ncripted/DAMIEN/outputs/rover/Omni_UGV_Rev_E_power_layout/mechanics/README.md

# Rev E mechanical status

Rev_E_Bare_PCB.step is freshly exported from the saved Rev E board. The 100 mm outline and motor/mounting geometry are unchanged. This is a bare-board reference, not a complete robot assembly.

provisional_supports.scad remains editable preliminary fit geometry. It has not been qualified against measured motors, couplings, wheel rollers, battery or camera flex. Check clearance around new backside Q12/Q13 and the four-terminal R36 before using it. No final printable support set is released in this electrical-layout revision. Earlier board STEP exports are under history/.
