ncripted/DAMIEN/outputs/rover/Omni_UGV_Rev_D_power_audit/engineering/scripts/Rev_D_power/README.md

Native CAD is authoritative. These scripts record incremental editing/audit operations in the original workspace; many are non-idempotent and expect its work/outputs directories. Do not run them over the delivered design. Use root validate.ps1 to repeat native rule checks. calculate.py is the temperature nodal-model source; copy it to a scratch workspace before running. No transient simulation or physical bench results are included.
