ncripted/DAMIEN/outputs/rover/Omni_UGV_Rev_B_protection/.pcba-workflow/circuit-review.md

# Circuit review gate

BLOCKED for fabrication release. Step 1 is complete: presentation equivalence, ERC, DRC and parity passed.

The Rev B protection circuit exists in the native schematic/PCB; electrical, thermal and fault-response qualification is still open. See engineering/AUDIT.md and engineering/UNRESOLVED.md. No firmware temperature cutoff or hardware testing is claimed.
