ncripted/DAMIEN/outputs/rover/Omni_UGV_Rev_C_flex_camera/.pcba-workflow/circuit-review.md

# Circuit review — Rev C

Status: BLOCKED for fabrication. Native camera changes and configured checks are documented in engineering/CAMERA_REV_C.md. Exact supplied module/flex and mechanical geometry, camera sequencing/rail/thermal/timing qualification, prior power/protection issues and physical testing remain open.
