ncripted/DAMIEN/outputs/rover/Omni_UGV_Rev_C_flex_camera/engineering/CAMERA_REV_C.md

# Flex camera revision — 2026-11-06

Selected design target: **Arducam M0031, OV2640 Mini CCM, 24-pin parallel DVP flex interface**. No camera or parts were ordered. Do not substitute another 24-pin OV2640 module without checking every pin and supply.

## Electrical implementation

J3 is now a Hirose FH12-24S-0.5SH(55), 24-position, 0.5 mm pitch bottom-contact locking FPC connector. Cable contact orientation, stiffener thickness and the delivered M0031 revision must be checked against the connector drawing and physical sample before assembly. This is a selected connector, not proof that any generic flex fits it.

Added U8 TLV75513PDBVR (1.3 V core) and U9 TLV75528PDBVR (2.8 V analog), each with 2.2 uF nominal input and output capacitors. I/O remains on 3.3 V. R44/R45 provide 4.7k SCCB pullups previously supplied by the Waveshare carrier. Existing reset RC remains, PWDN stays low, and the eight data bits still use sensor Y9..Y2. Sensor Y1/Y0 and STROBE are unused. The old 18-pin carrier board is no longer connected to Rev C.

DBV regulator physical pins: IN1, GND2, EN3, NC4, OUT5. EN follows 3.3 V; NC4 is explicitly unconnected. Regulator input/output capacitor effective capacitance, camera current, sequencing, SCCB levels and thermal behavior still require qualification. A 50 mA illustrative core load dissipates (3.3-1.3)*0.05 = 0.10 W in U8; this is a budget example, not measured consumption. Each added load also enters the shared 3.3 V regulator budget.

## Placement and mechanics

Camera interface and power support occupy the upper-right sector, below the existing antenna copper keepout. The FPC connector replaces a much larger through-hole header. J5 moves outward to make connector/latch access possible. Converter and motor-driver support circuits are kept together; scattered placement of bypass capacitors or switching loops would make electrical behavior worse even if the board looked more evenly populated.

Keep the ribbon short, keep its path away from motor wiring and the antenna region, and provide a smooth strain-relief path. A printed bracket must carry the camera head; the flex and ZIF connector must not support it. The motor slots and the user-requested solid ESP32 perimeter are retained. Green soldermask does not identify spare copper or available mechanical space.

Bracket design is provisional until lens barrel, camera-head dimensions, flex length/bend limits, contact orientation, intended viewing angle and chassis attachment are measured. Existing universal camera-bracket source is a fit study and is not an approved M0031 bracket. No printable bracket or physical fit is claimed by this revision.

## Primary evidence

- [Arducam M0031 product](https://www.arducam.com/arducam-ov2640-camera-module-2mp-mini-ccm-compact-camera-modules-compatible-with-arduino_m0031esp32-esp8266-development-board-with-dvp-24-pin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)
- [Arducam 24-pin OV2640 pin table and rail discussion](https://www.arducam.com/blog/ov2640-vs-ov7670-detailed-comparisons-and-resources/)
- [TI TLV755P pin table, capacitor and operating requirements](https://www.ti.com/lit/ds/symlink/tlv755p.pdf)
- [Hirose exact connector/drawing](https://www.hirose.com/product/p/CL0586-0521-0-55)
- [Espressif camera driver](https://github.com/espressif/esp32-camera)

Native files are authoritative. Validation reports state actual counts and outstanding qualification; this is an unbuilt prototype revision, not fabrication approval. Rev B remains preserved as the previous routed revision.
