ncripted/DAMIEN/outputs/rover/Omni_UGV_Rev_D_power_audit/engineering/UNRESOLVED.md

# Rev D unresolved qualification and next work

The file-based power audit is implemented. Production/fabrication gate remains **BLOCKED**. No physical tests have been performed.

1. **Exact cell/harness:** validate PHB1S100020CJST limits, actual envelope, connector/polarity, contacts, wiring and pulse-duration ratings. Accepted 1S/1Ah/20C and charge/temperature assumptions are provisional. 4A continuous / 5A transient are harness design targets, not an established board rating.
2. **Emergency undervoltage:** U10 now removes operating loads around 3.1V. U7 still disconnects at its factory 2.6V backstop. A strict 3.0V absolute cell minimum is not fully enforced during prolonged storage/faults; confirm cell compatibility or design a reviewed higher-threshold pack disconnect. Verify cutoff/recovery/USB wake and off-state current on a cell simulator.
3. **Temperature:** verify U12's modeled window against the actual NTC curve, passive tolerances, open/short/startup behavior and measured bonded-cell temperature. TH1 and TH2 must be insulated, independently wired and strain relieved. Firmware still must handle TH2 faults/temperature.
4. **Power layout/sourcing:** prove Kelvin pickup at R36, return gradients, driver/regulator/charger/FET thermal paths, current-path/via ratings, effective capacitance and exact package/land overlays. U10's exact part is active but direct TI stock was unavailable at review; qualify procurement before freeze. Passive MPNs are not fully locked. Review/move inherited M2_A on In1.Cu. No new In1 signal tracks were added. Retain visibility of the inherited J1-specific 0.19mm hole-clearance exception pending fabricator acceptance.
5. **Transient and regen:** scope VMOTOR/VBAT/SYS_RAW/3.3V during stall, coast, reverse, USB insertion and protection cutoff. The charger does not limit regenerative battery charging; U7's charge-overcurrent trip is above the assumed cell charge limit. Establish stop mode/ramps and any energy clamp from measurements. Drivers may reach UVLO before the cell supervisor under low-cell/high-load conditions; normal firmware must stop earlier.
6. **Mechanical/RF/camera:** measure motor terminals, shafts, hubs, wheels, cell, camera flex/head and brackets. Recheck printed-support and protection-cover clearance around new components. Validate camera rails/sequencing/timing and FPC orientation. The copper antenna keepout is preserved; added perimeter FR-4 still requires RF testing. Existing CAD remains provisional.
7. **Firmware and Vita:** implement default-off arming, command timeout, ramps/limits, battery/driver/TH2 monitoring and fault latching; GPIO42 now feeds U14 as DRIVE_REQ_RAW. Verify Vita networking/decoding before choosing the camera protocol. No working firmware is delivered by this power-audit step.

See POWER_AUDIT.md for calculations, sources and the staged bench procedure. Next work: focused PCB power/return/sourcing review, then an authorized prototype and measured bring-up. No board order or publication is authorized.
