ncripted/DAMIEN/outputs/rover/Omni_UGV_Rev_E_power_layout/engineering/SOURCES.md

# Rev E primary sources

Reviewed 2026-11-07.

- [WSK2512 manufacturer land pattern and ratings](https://www.vishay.com/docs/30108/wsk2512.pdf)
- [BQ2980/BQ2982 primary protector](https://www.ti.com/lit/ds/symlink/bq2980.pdf)
- [TPS3840 supervisor](https://www.ti.com/lit/ds/symlink/tps3840.pdf)
- [TPS63802 regulator](https://www.ti.com/lit/ds/symlink/tps63802.pdf)
- [DMP2008UFG PFET](https://www.diodes.com/datasheet/download/DMP2008UFG.pdf)
- [TDK capacitor production listing](https://product.tdk.com/en/search/capacitor/ceramic/mlcc/info?part_no=C2012X5R1A226M125AB)

The TDK K-tolerance variant is NRND; the selected M-tolerance variant is listed Production. The K-variant characterization graph is not a guaranteed bias specification for the selected M part. No such guarantee is claimed.
