ncripted/DAMIEN/outputs/rover/Omni_UGV_Rev_A/preview/board-current.png

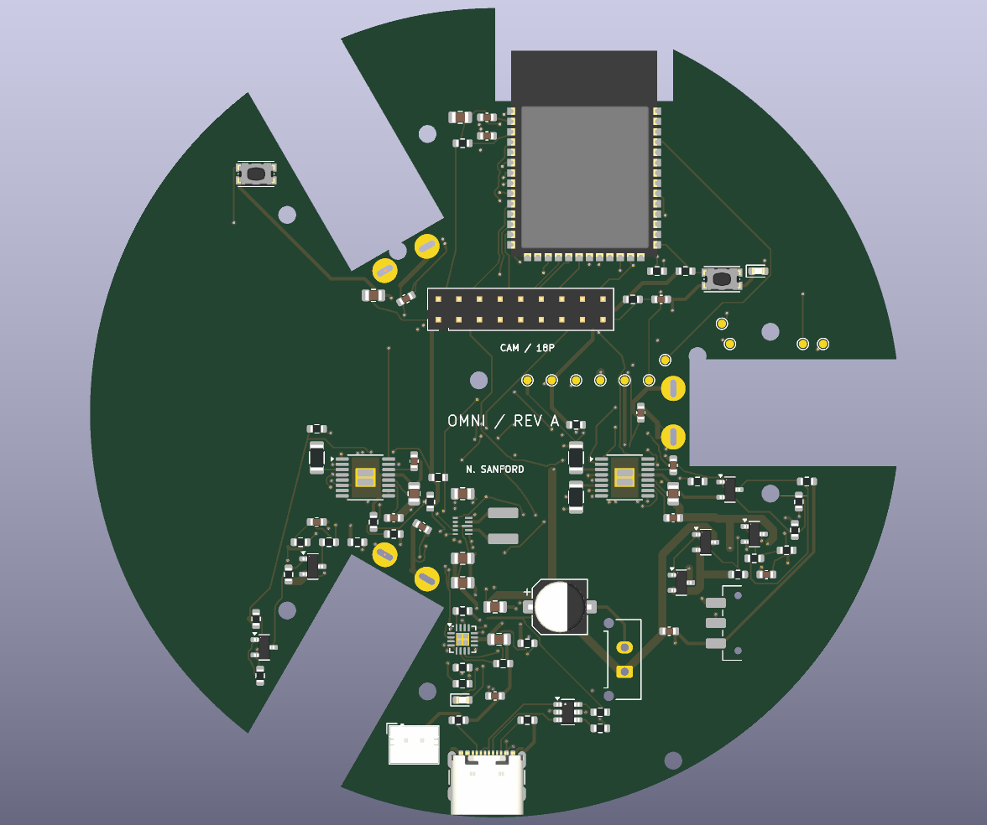
outputs/rover/Omni_UGV_Rev_A/preview/board-current.png
