ncripted/DAMIEN/outputs/rover/Omni_UGV_Rev_A/preview/mechanical-envelope-provisional.png

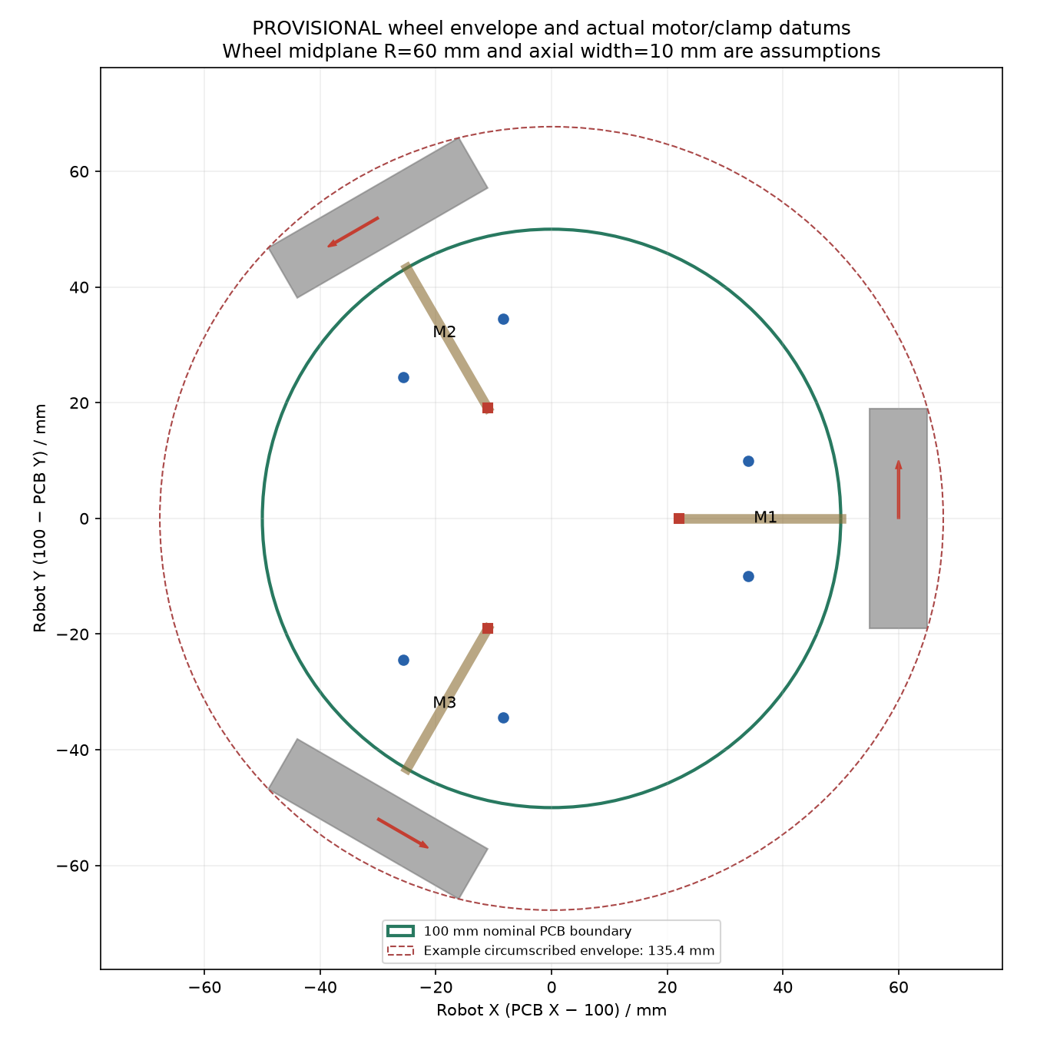
outputs/rover/Omni_UGV_Rev_A/preview/mechanical-envelope-provisional.png
