ncripted/DAMIEN/outputs/rover/Omni_UGV_Rev_A/preview/regulator-review.png

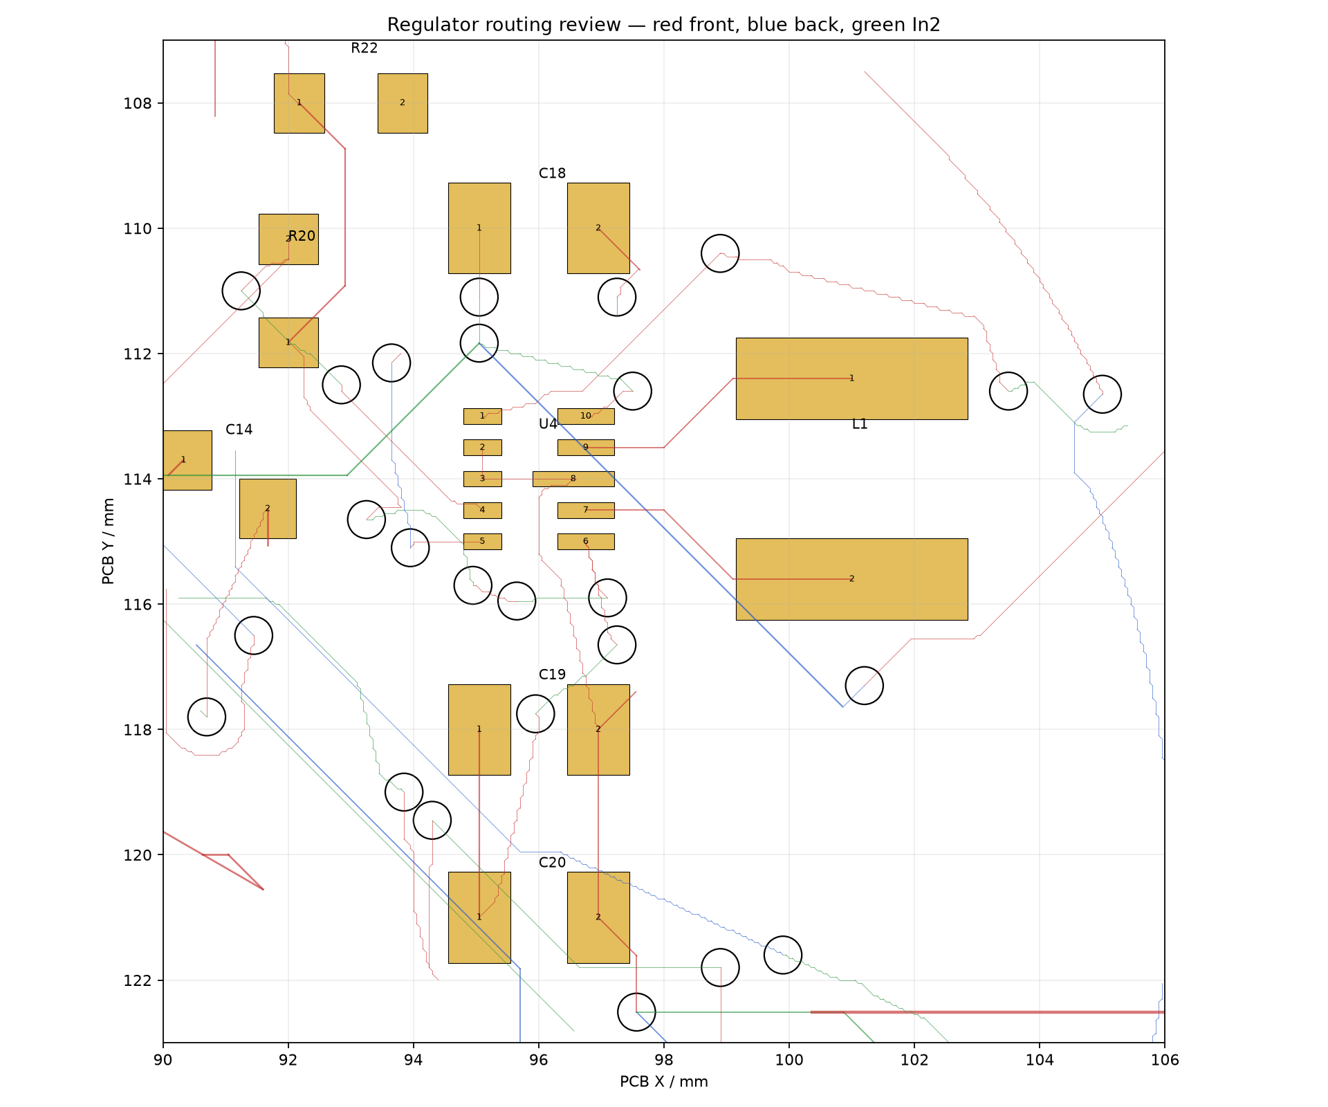
outputs/rover/Omni_UGV_Rev_A/preview/regulator-review.png
