ncripted/DAMIEN/outputs/rover/Omni_UGV_Rev_B_protection/preview/protection-bottom.png

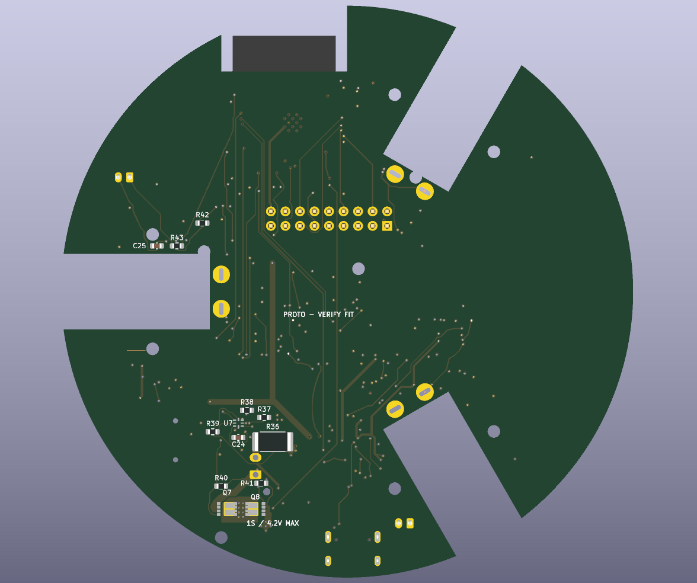
outputs/rover/Omni_UGV_Rev_B_protection/preview/protection-bottom.png
