ncripted/DAMIEN/outputs/rover/Omni_UGV_Rev_B_protection/preview/schematics/detail-drivers.png

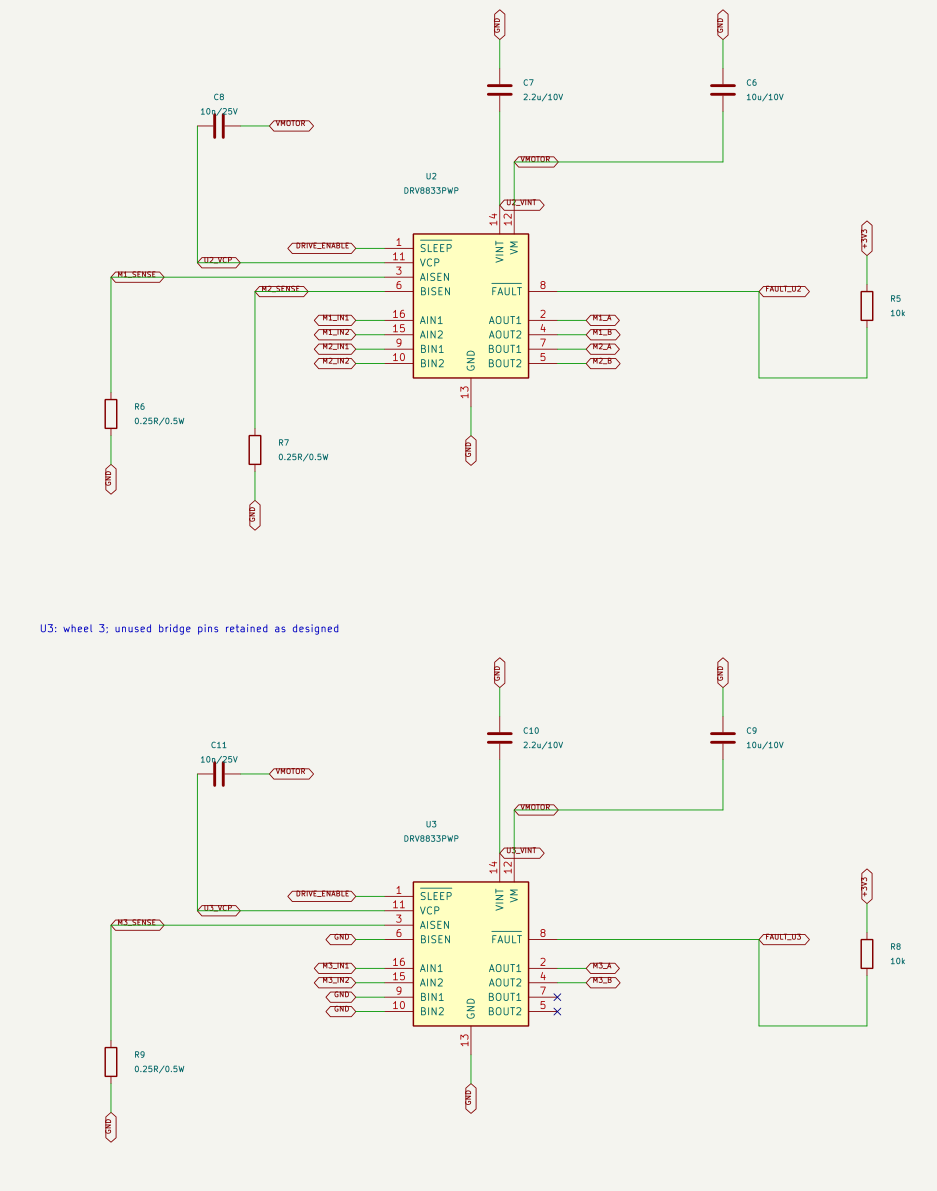
outputs/rover/Omni_UGV_Rev_B_protection/preview/schematics/detail-drivers.png
