ncripted/DAMIEN/outputs/rover/Omni_UGV_Rev_B_protection/preview/schematics/detail-interlock.png

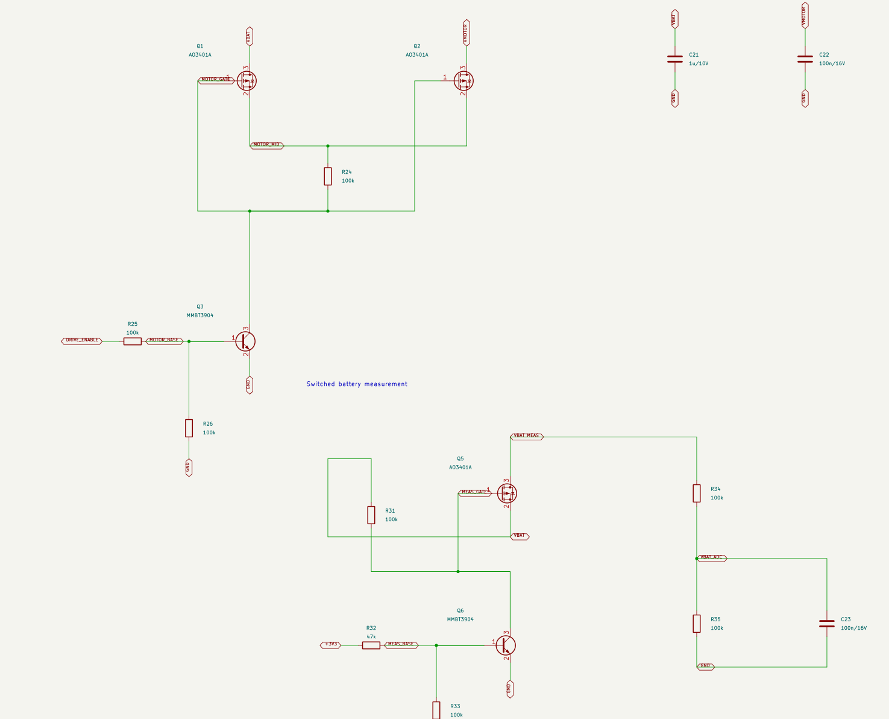
outputs/rover/Omni_UGV_Rev_B_protection/preview/schematics/detail-interlock.png
