ncripted/DAMIEN/outputs/rover/Omni_UGV_Rev_B_protection/preview/schematics/detail-usb-charge.png

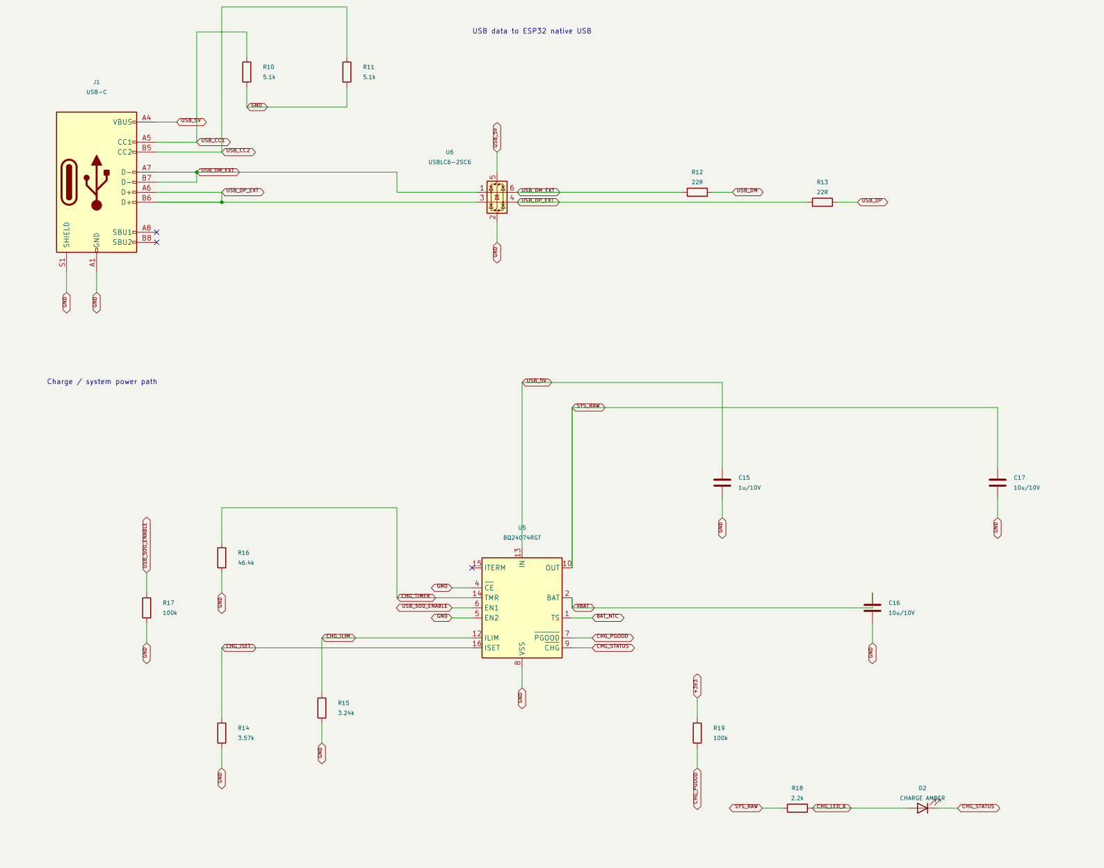
outputs/rover/Omni_UGV_Rev_B_protection/preview/schematics/detail-usb-charge.png
