ncripted/DAMIEN/outputs/rover/Omni_UGV_Rev_B_protection/preview/schematics/sheet-3.png

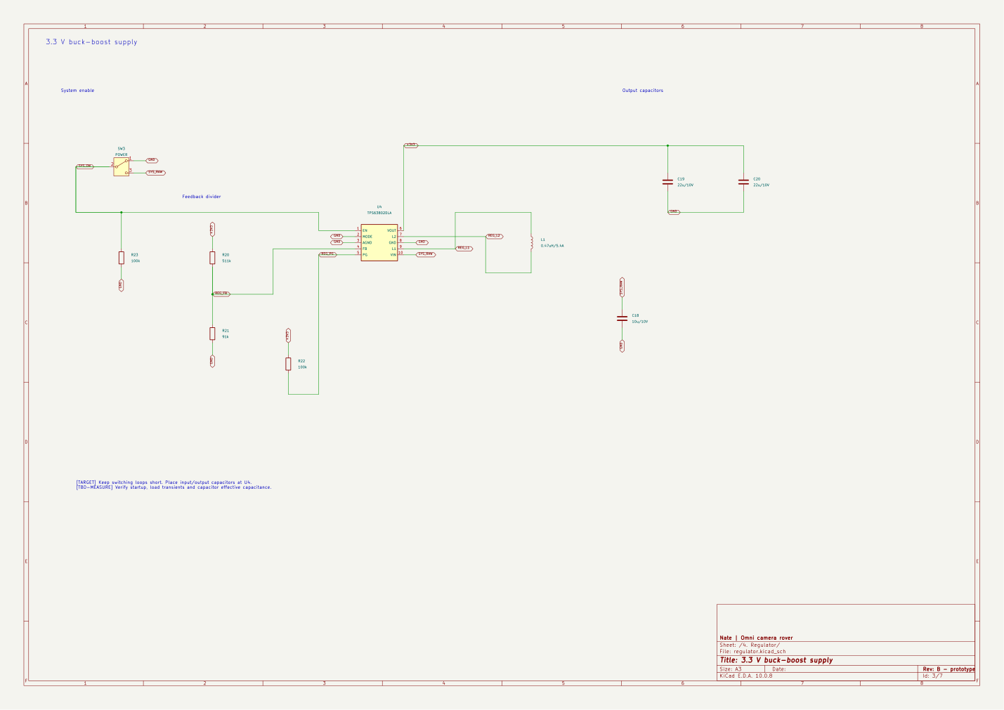
outputs/rover/Omni_UGV_Rev_B_protection/preview/schematics/sheet-3.png
