ncripted/DAMIEN/outputs/rover/Omni_UGV_Rev_B_protection/preview/solid-perimeter-top.png

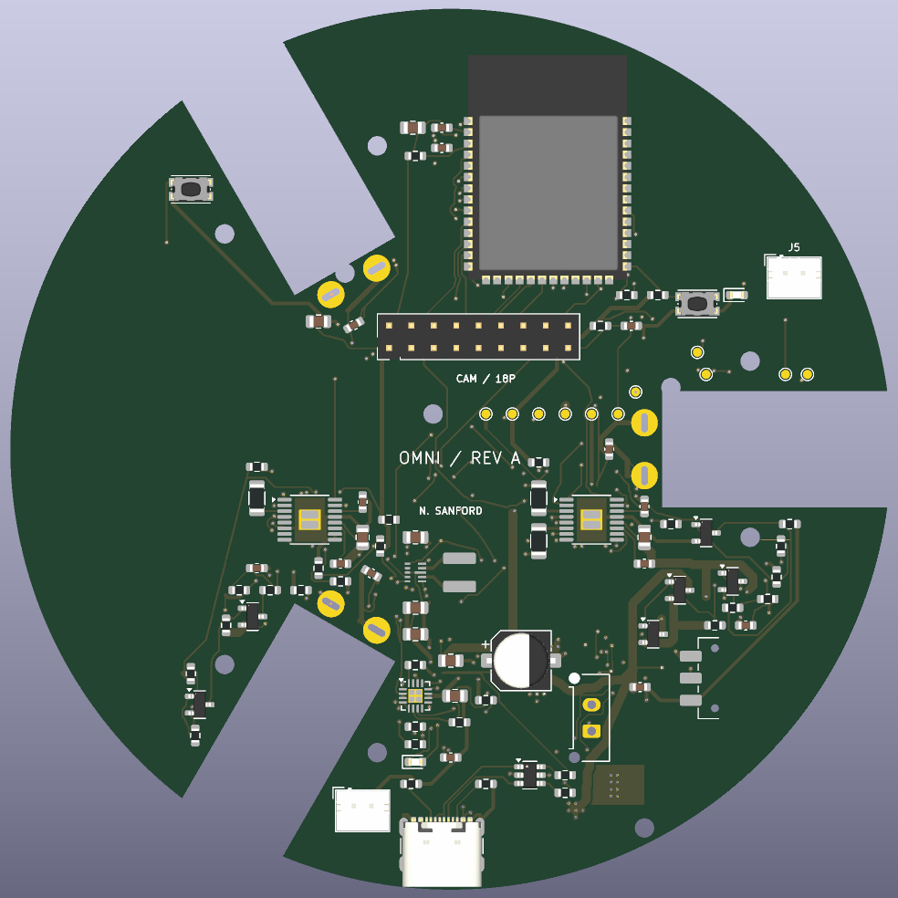
outputs/rover/Omni_UGV_Rev_B_protection/preview/solid-perimeter-top.png
