ncripted/DAMIEN/outputs/rover/Omni_UGV_Rev_C_flex_camera/preview/rev-c-bottom.png

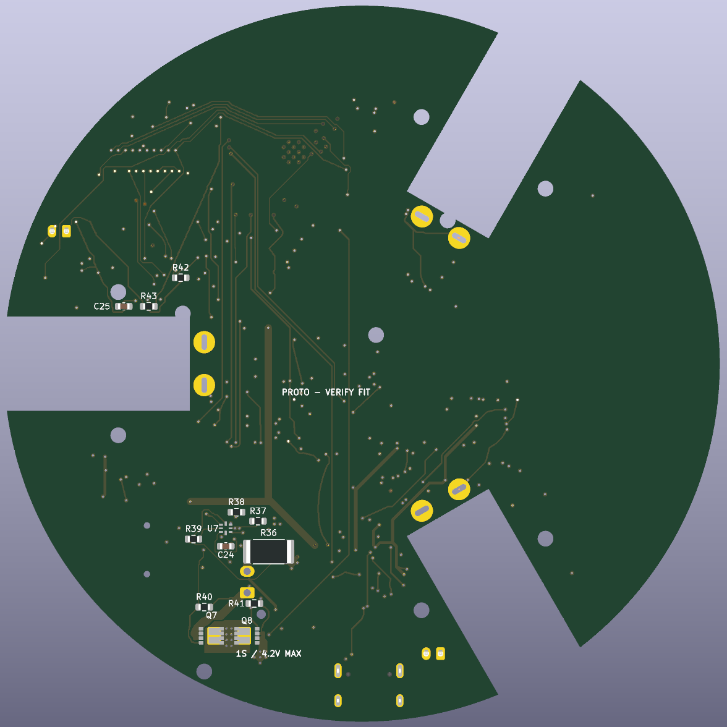
outputs/rover/Omni_UGV_Rev_C_flex_camera/preview/rev-c-bottom.png
