ncripted/DAMIEN/outputs/rover/Omni_UGV_Rev_C_flex_camera/preview/schematics/detail-camera-power.png

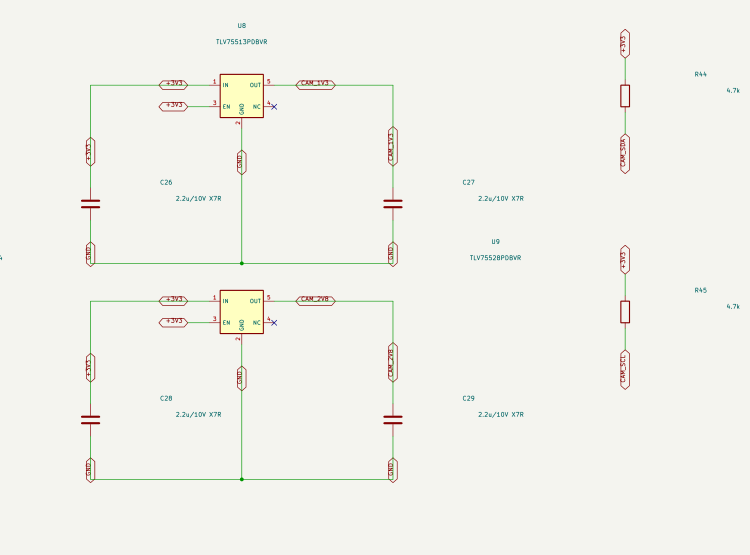
outputs/rover/Omni_UGV_Rev_C_flex_camera/preview/schematics/detail-camera-power.png
