ncripted/DAMIEN/outputs/rover/Omni_UGV_Rev_C_flex_camera/preview/schematics/sheet-2.png

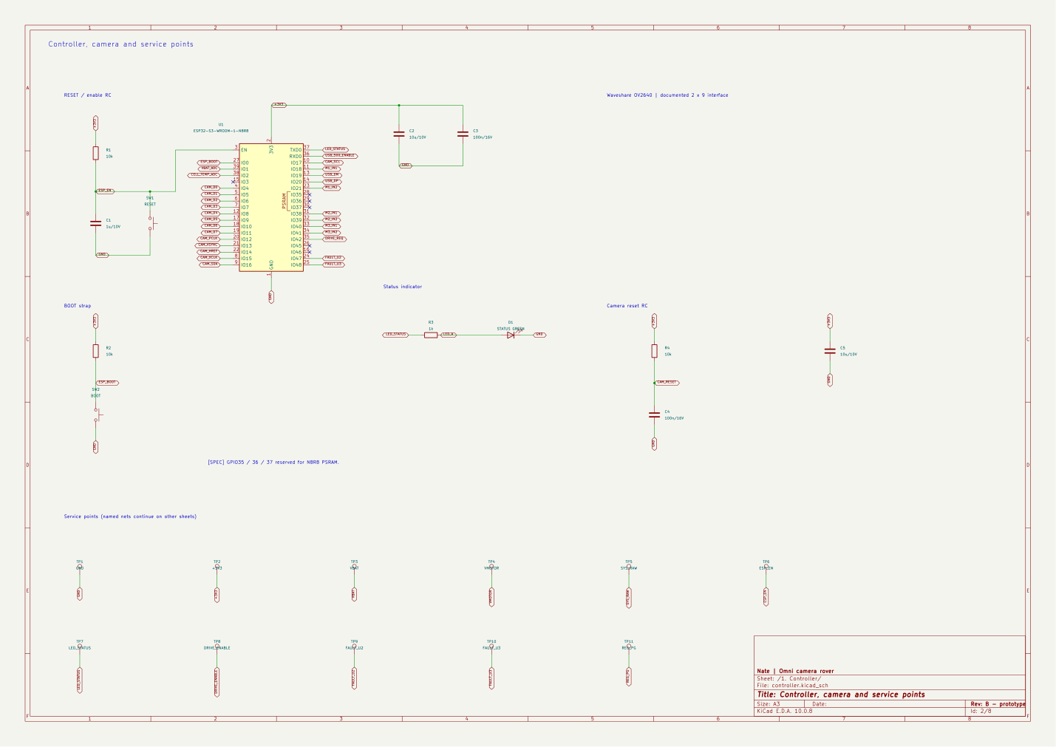
outputs/rover/Omni_UGV_Rev_C_flex_camera/preview/schematics/sheet-2.png
