ncripted/DAMIEN/outputs/rover/Omni_UGV_Rev_D_power_audit/preview/rev-d-top.png

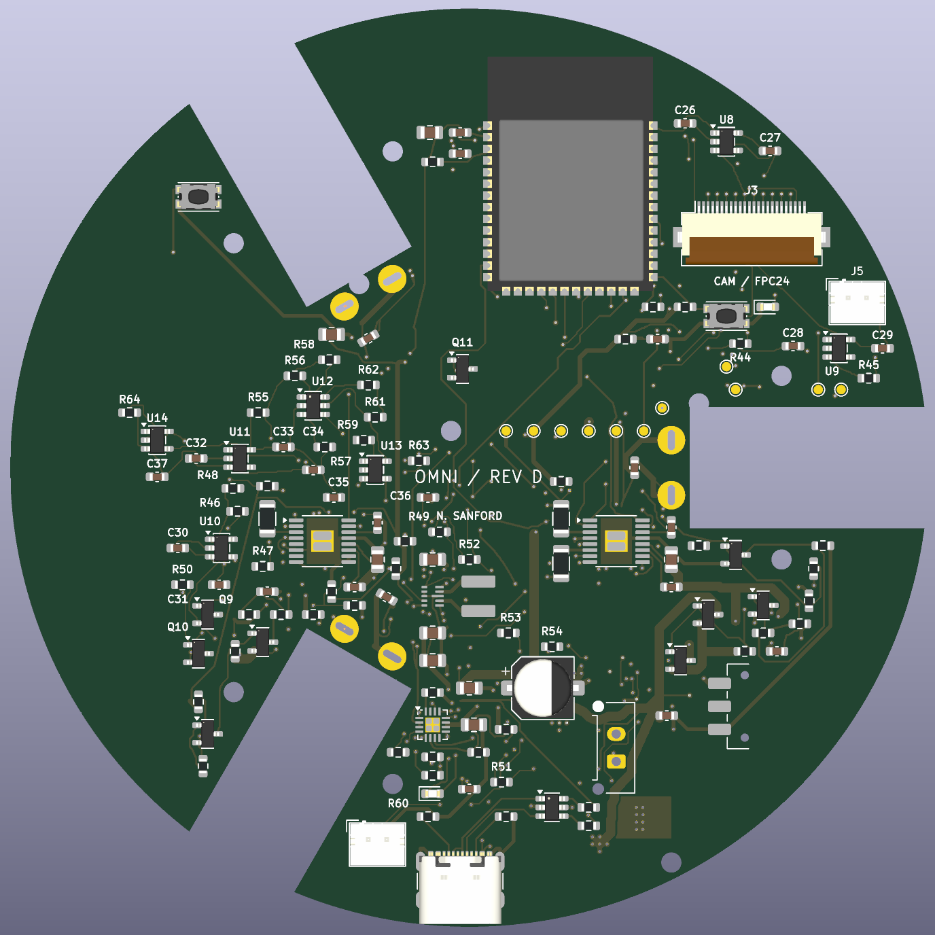
outputs/rover/Omni_UGV_Rev_D_power_audit/preview/rev-d-top.png
