ncripted/DAMIEN/outputs/rover/Omni_UGV_Rev_D_power_audit/preview/schematics/detail-charge-temperature.png

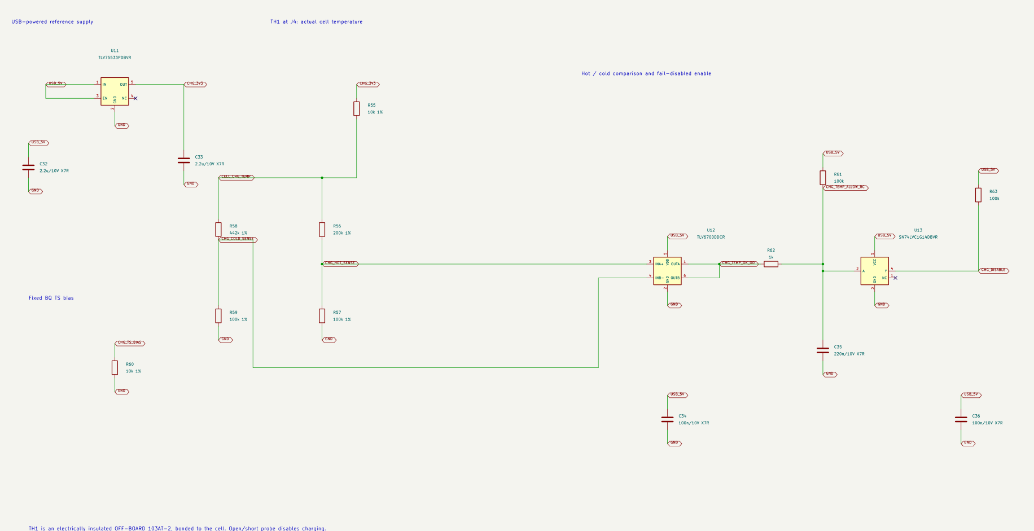
outputs/rover/Omni_UGV_Rev_D_power_audit/preview/schematics/detail-charge-temperature.png
