ncripted/DAMIEN/outputs/rover/Omni_UGV_Rev_D_power_audit/preview/schematics/detail-undervoltage.png

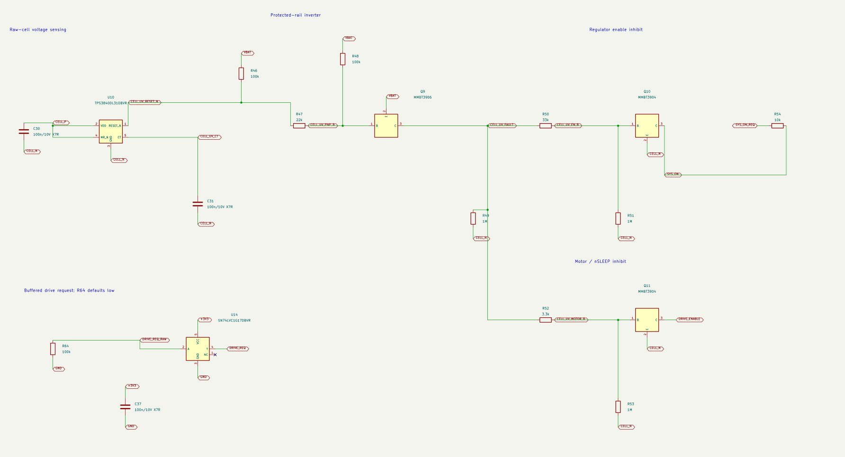
outputs/rover/Omni_UGV_Rev_D_power_audit/preview/schematics/detail-undervoltage.png
