ncripted/DAMIEN/outputs/rover/Omni_UGV_Rev_D_power_audit/preview/schematics/sheet-9.png

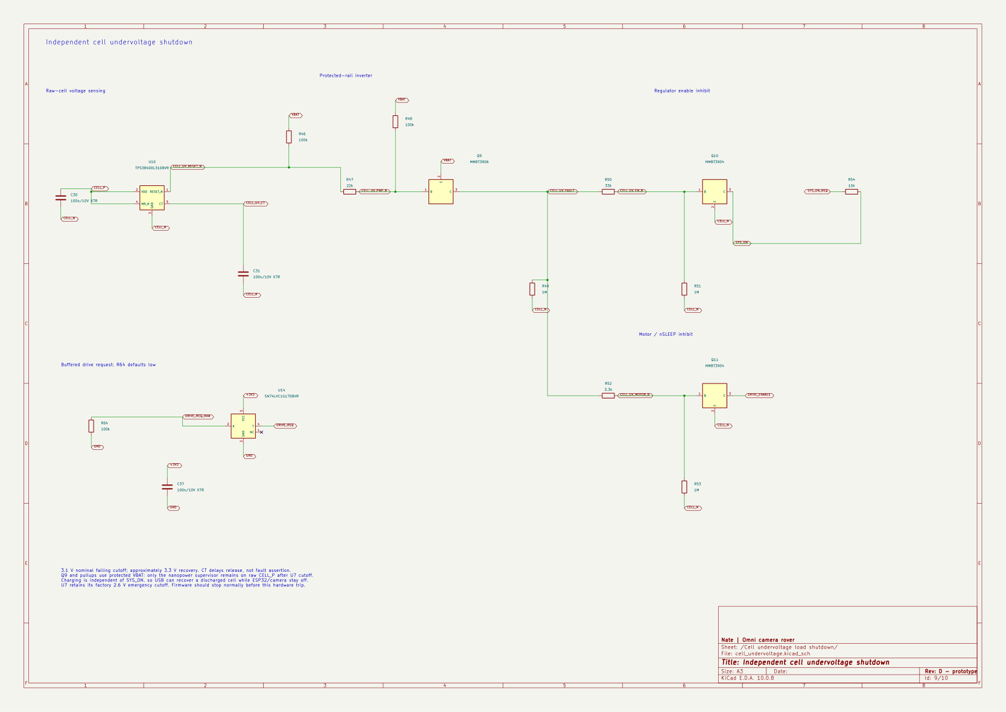
outputs/rover/Omni_UGV_Rev_D_power_audit/preview/schematics/sheet-9.png
