ncripted/DAMIEN/outputs/rover/Omni_UGV_Rev_E1_layout_candidate/board-bottom.png

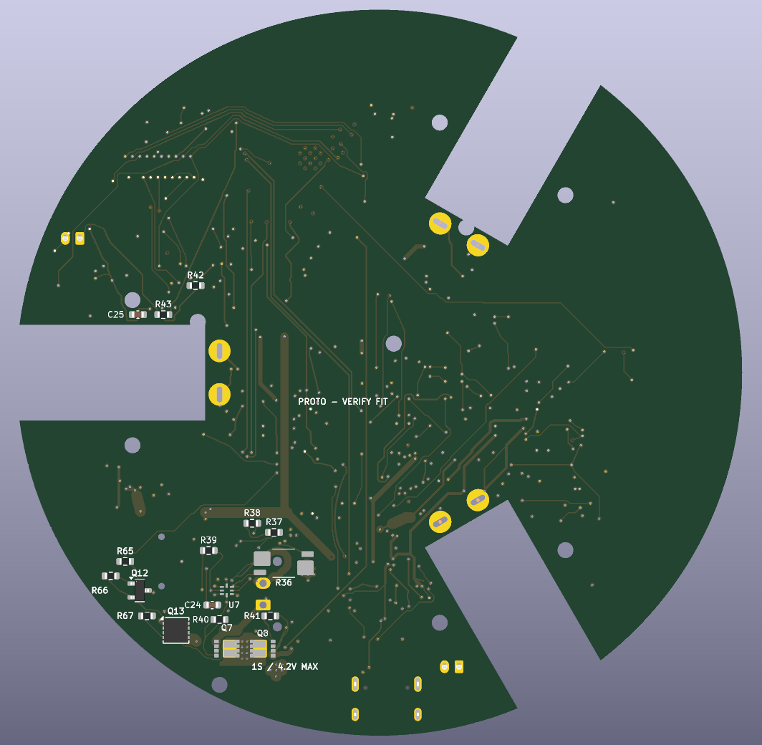
outputs/rover/Omni_UGV_Rev_E1_layout_candidate/board-bottom.png
