ncripted/DAMIEN/outputs/rover/Omni_UGV_Rev_E_power_layout/preview/board-bottom.png

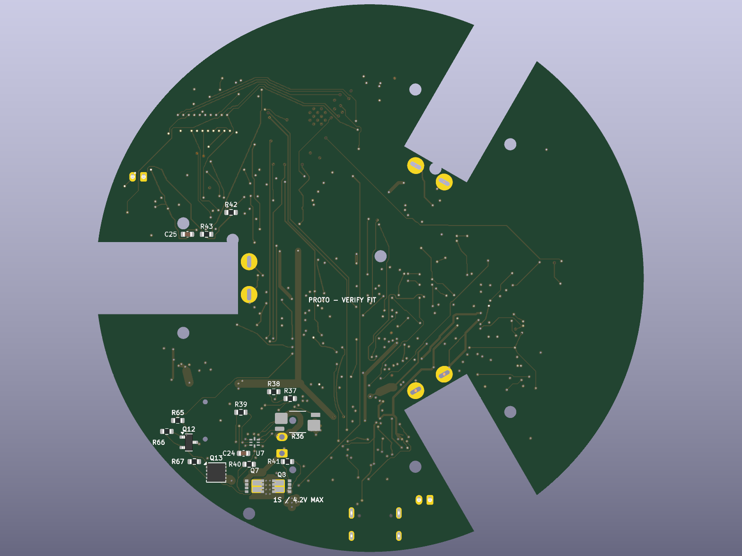
outputs/rover/Omni_UGV_Rev_E_power_layout/preview/board-bottom.png
