ncripted/DAMIEN/outputs/rover/Omni_UGV_Rev_E_power_layout/preview/copper-layer-overview.png

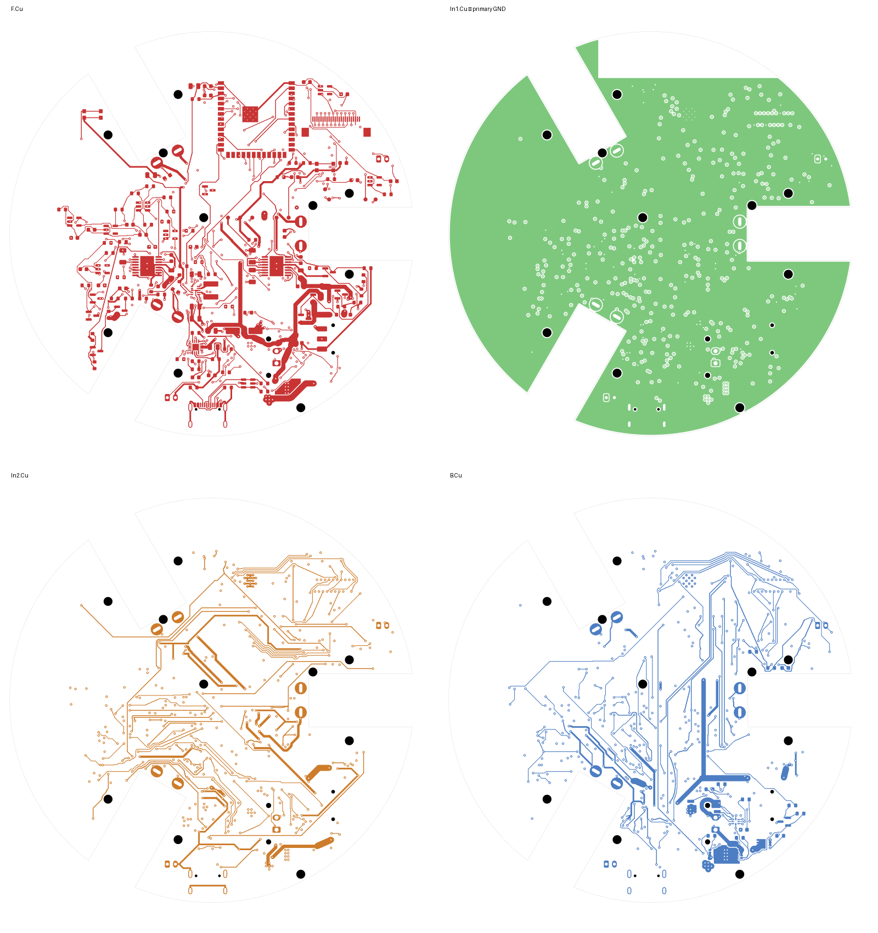
outputs/rover/Omni_UGV_Rev_E_power_layout/preview/copper-layer-overview.png
