ncripted/DAMIEN/outputs/rover/Omni_UGV_Rev_E_power_layout/preview/layers/copper-1.png

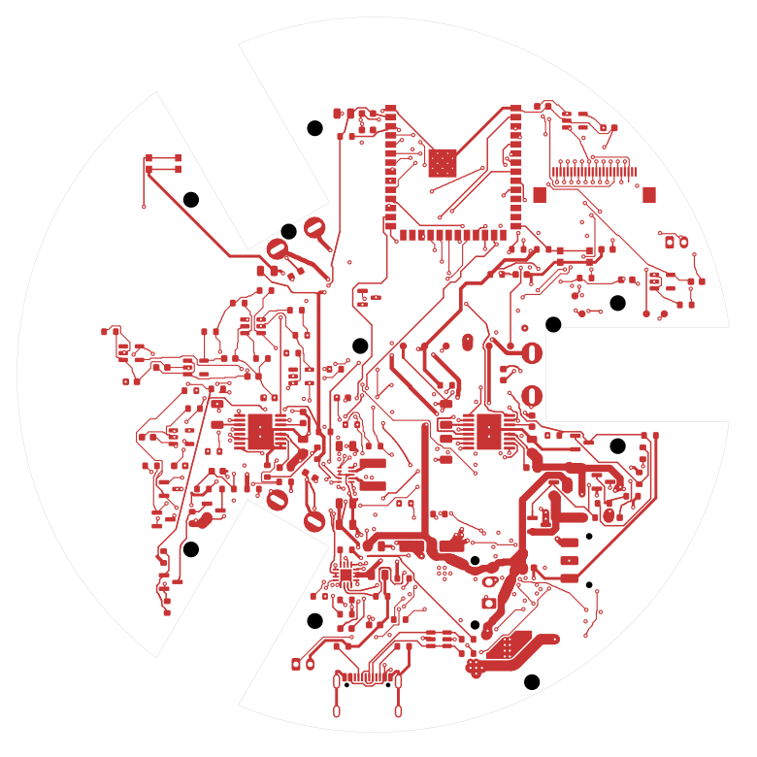
outputs/rover/Omni_UGV_Rev_E_power_layout/preview/layers/copper-1.png
