ncripted/DAMIEN/outputs/rover/Omni_UGV_Rev_E_power_layout/preview/layers/copper-3.png

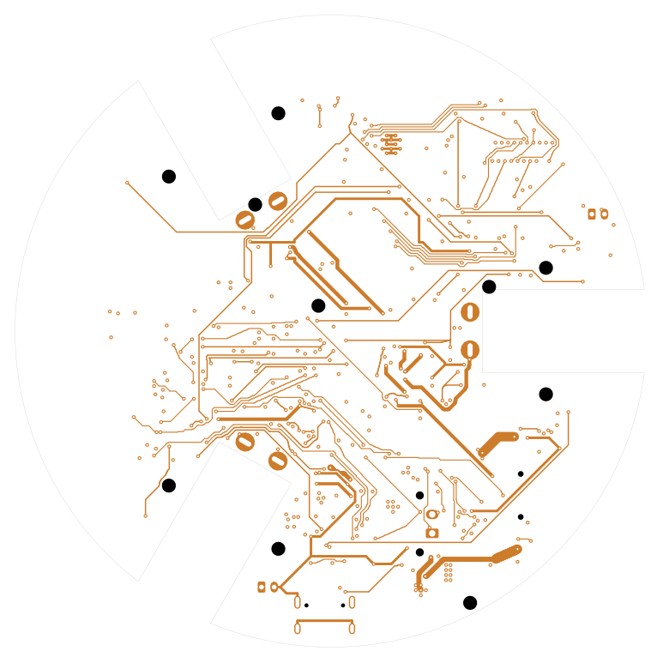
outputs/rover/Omni_UGV_Rev_E_power_layout/preview/layers/copper-3.png
