ncripted/DAMIEN/outputs/rover/Omni_UGV_Rev_E_power_layout/preview/schematics/sheet-10.png

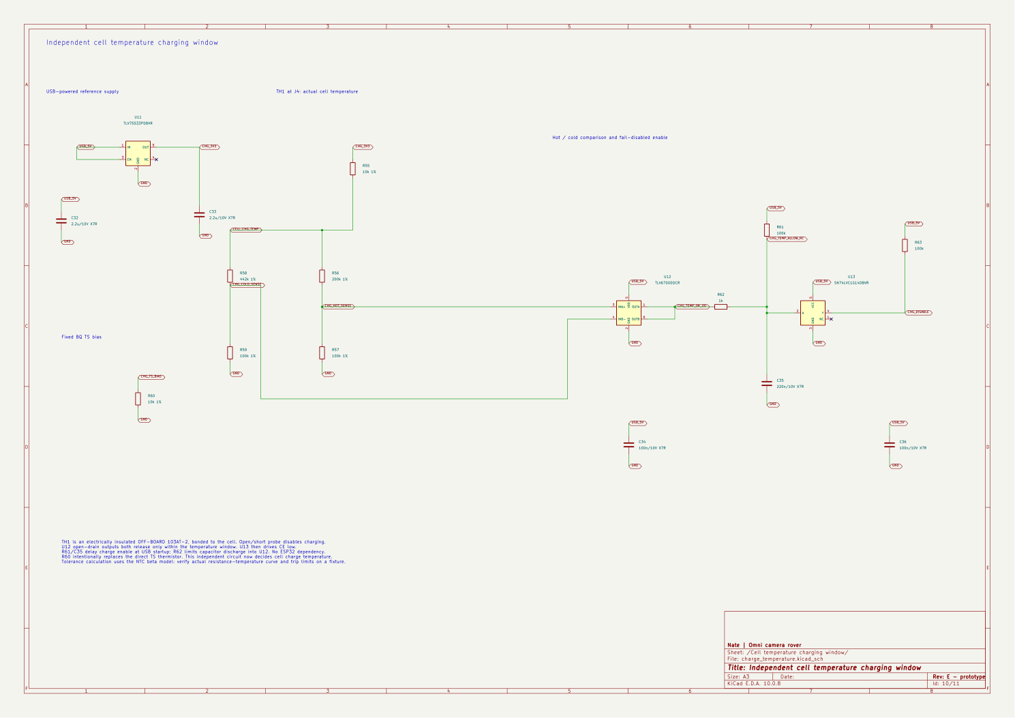
outputs/rover/Omni_UGV_Rev_E_power_layout/preview/schematics/sheet-10.png
