ncripted/DAMIEN/outputs/rover/Omni_UGV_Rev_E_power_layout/preview/schematics/sheet-11.png

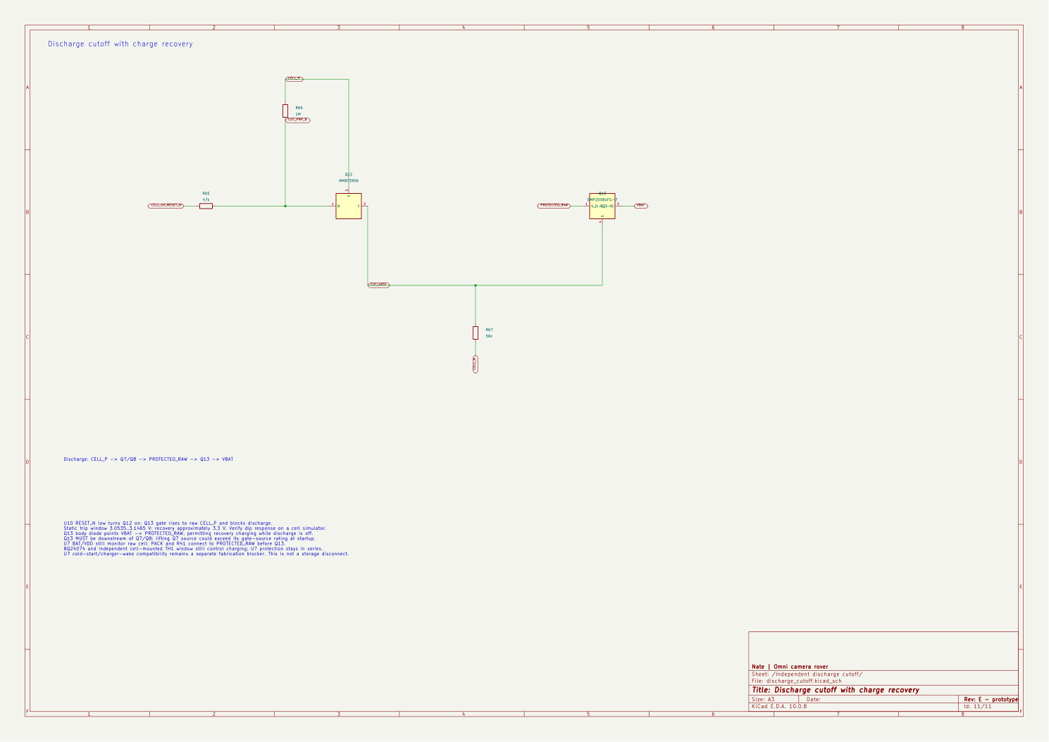
outputs/rover/Omni_UGV_Rev_E_power_layout/preview/schematics/sheet-11.png
