ncripted/DAMIEN/outputs/rover/Omni_UGV_Rev_F_integration/board-bottom.png

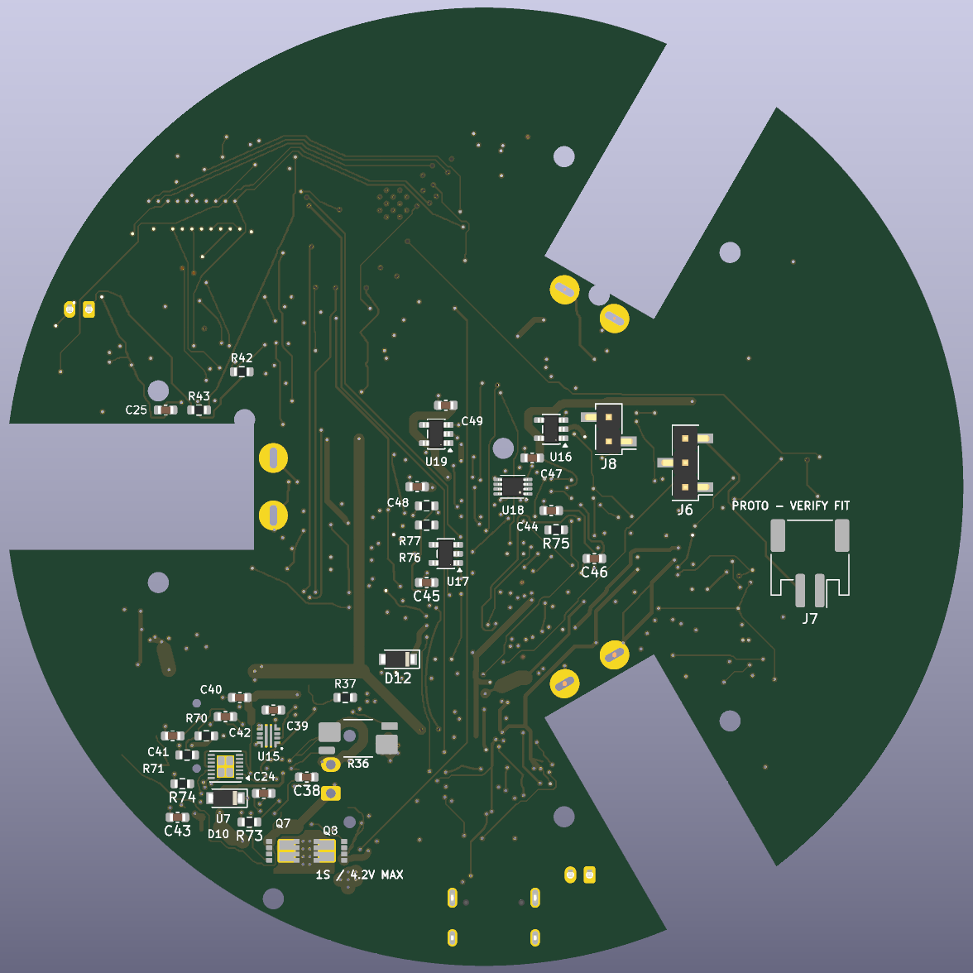
outputs/rover/Omni_UGV_Rev_F_integration/board-bottom.png
