ncripted/DAMIEN/outputs/rover/Omni_UGV_Rev_F_left_candidate/board-bottom.png

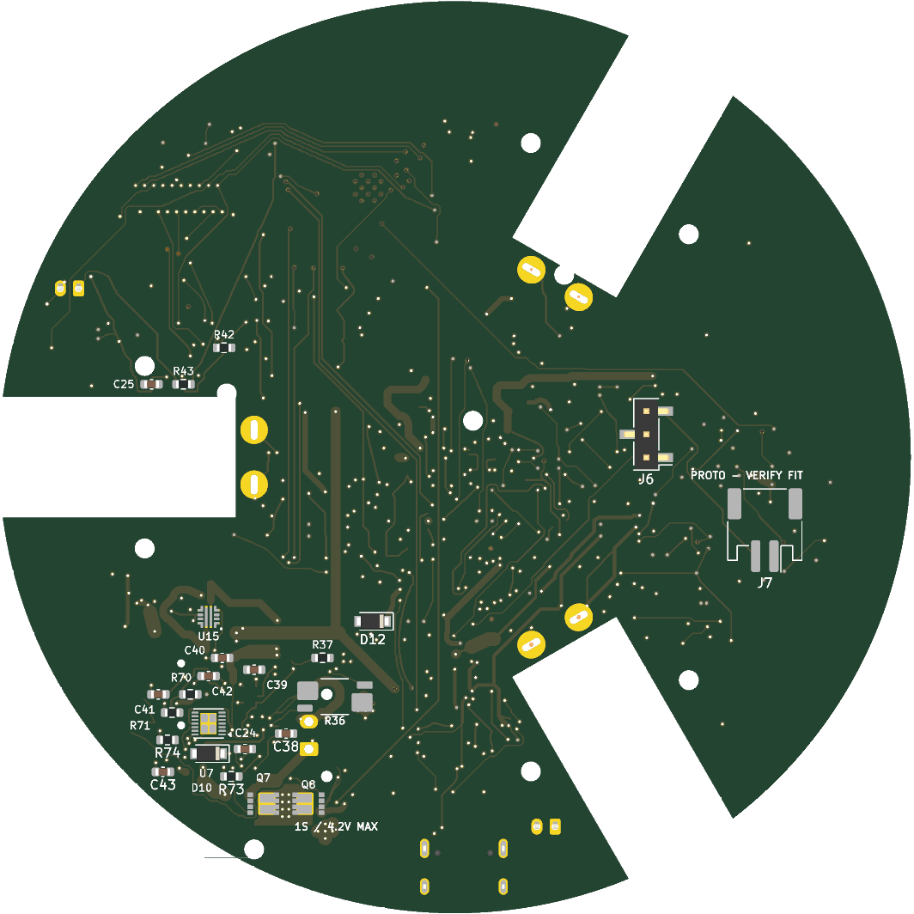
outputs/rover/Omni_UGV_Rev_F_left_candidate/board-bottom.png
