ncripted/DAMIEN/outputs/rover/Omni_UGV_Rev_F_left_candidate/board-top.png

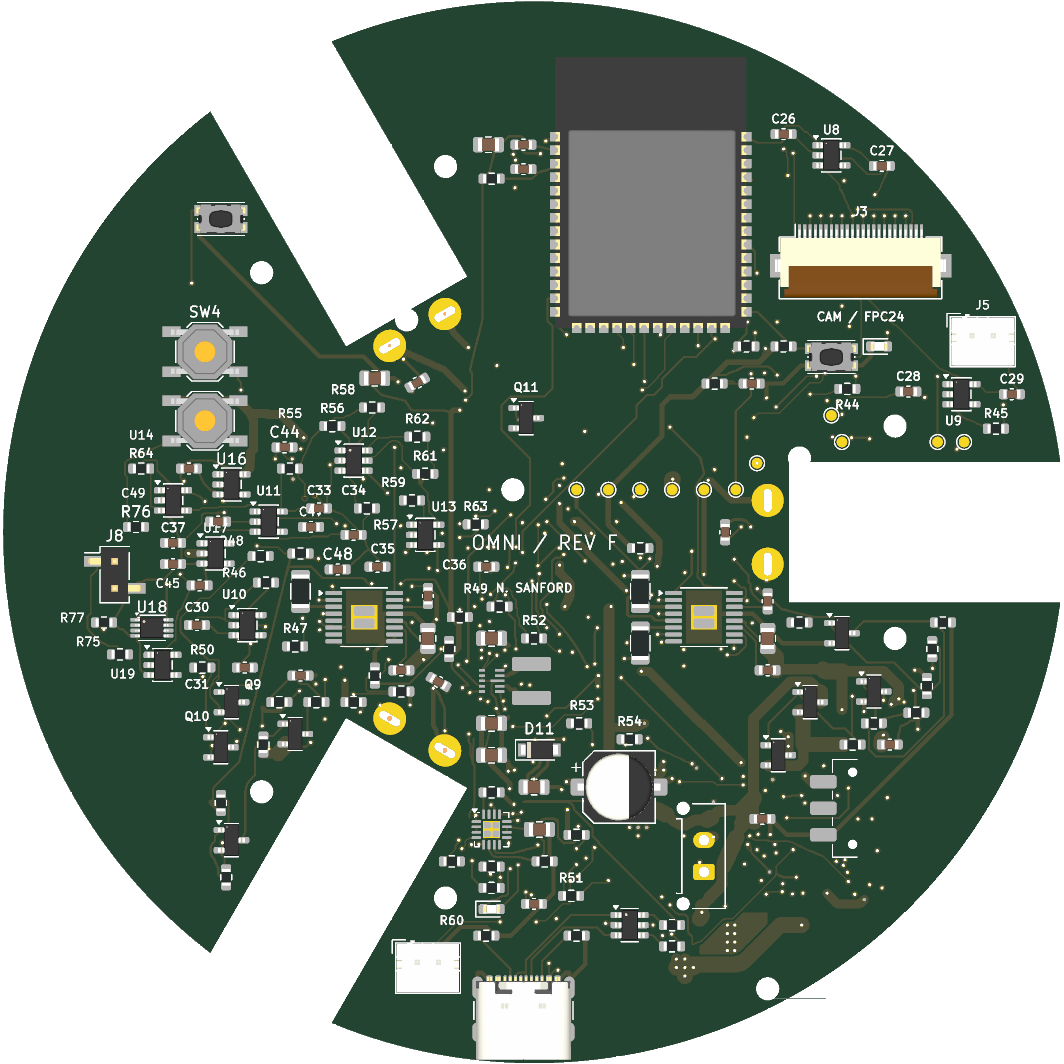
outputs/rover/Omni_UGV_Rev_F_left_candidate/board-top.png
