ncripted/DAMIEN/outputs/rover/Omni_UGV_Rev_F_protection_draft/Protection_Draft.png

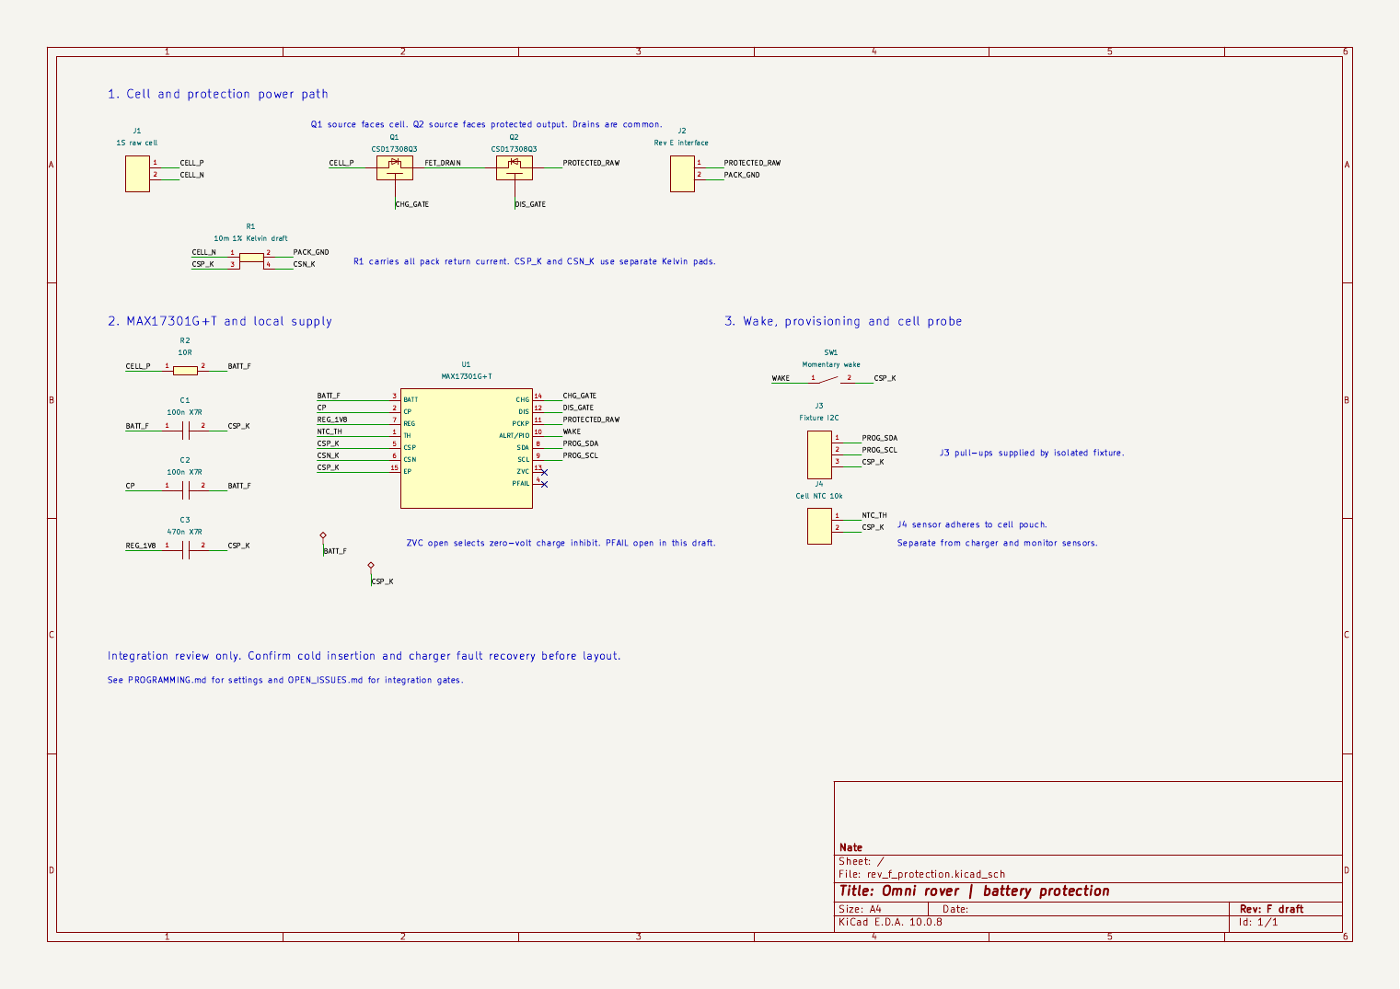
outputs/rover/Omni_UGV_Rev_F_protection_draft/Protection_Draft.png
