ncripted/DAMIEN/outputs/rover/Omni_UGV_Rev_F_protection_draft/USB_Power_Path.png

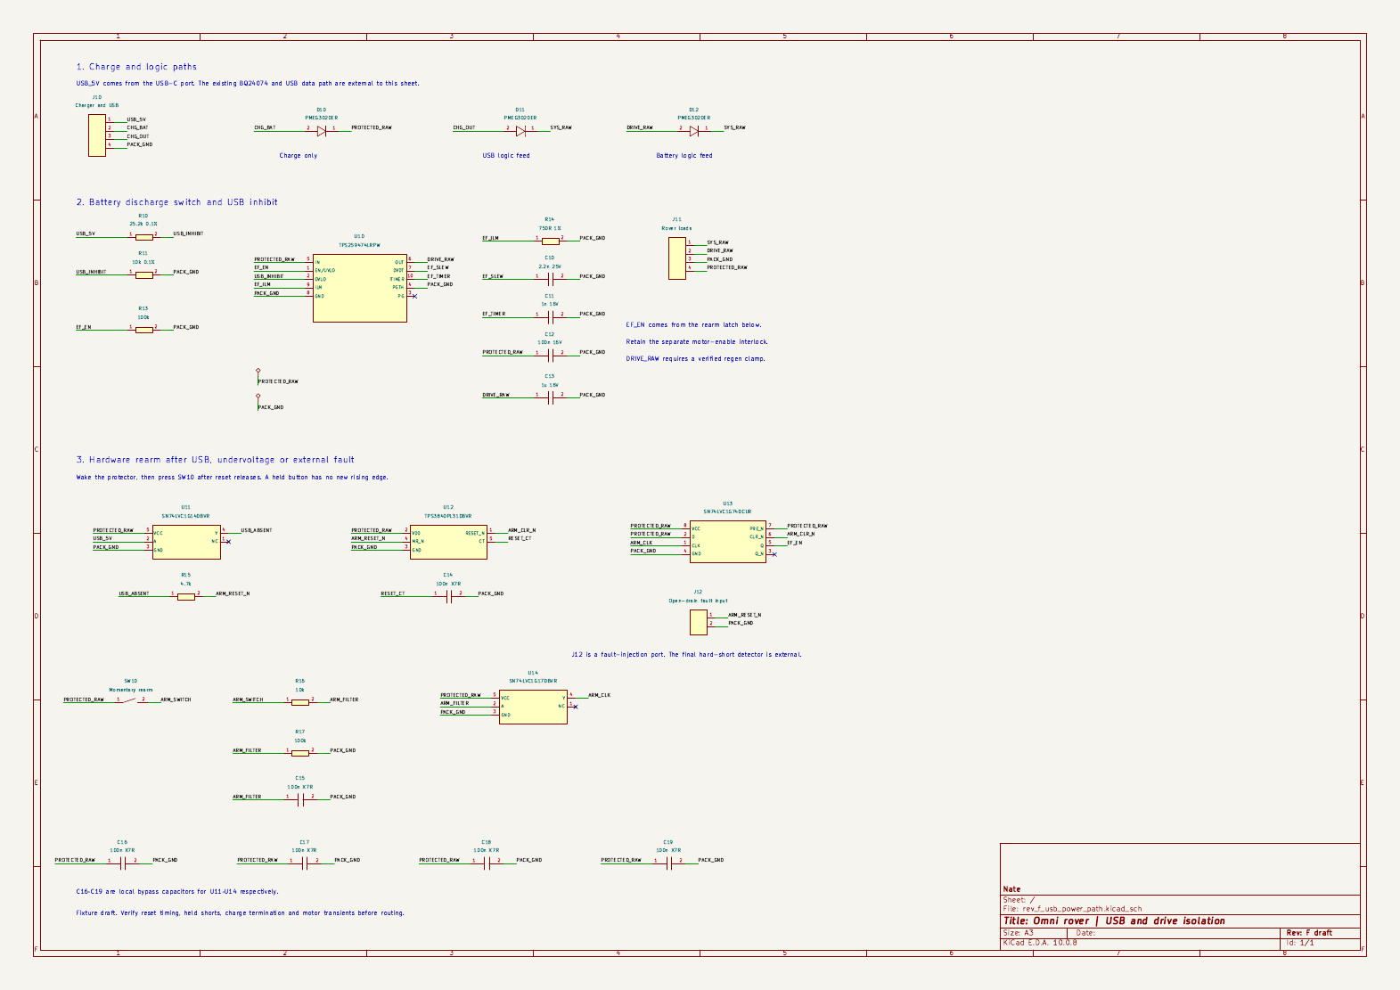
outputs/rover/Omni_UGV_Rev_F_protection_draft/USB_Power_Path.png
