ncripted/DAMIEN/work/humanize/new6.png

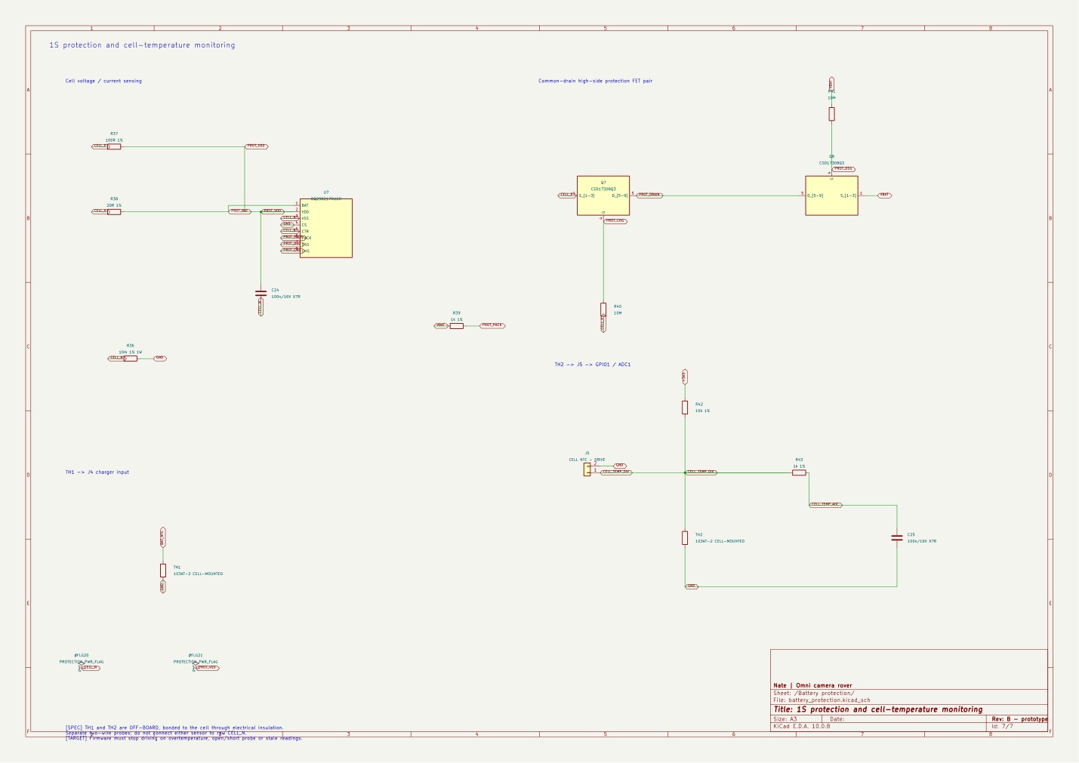
work/humanize/new6.png
