ncripted/DAMIEN/work/humanize/page0.png

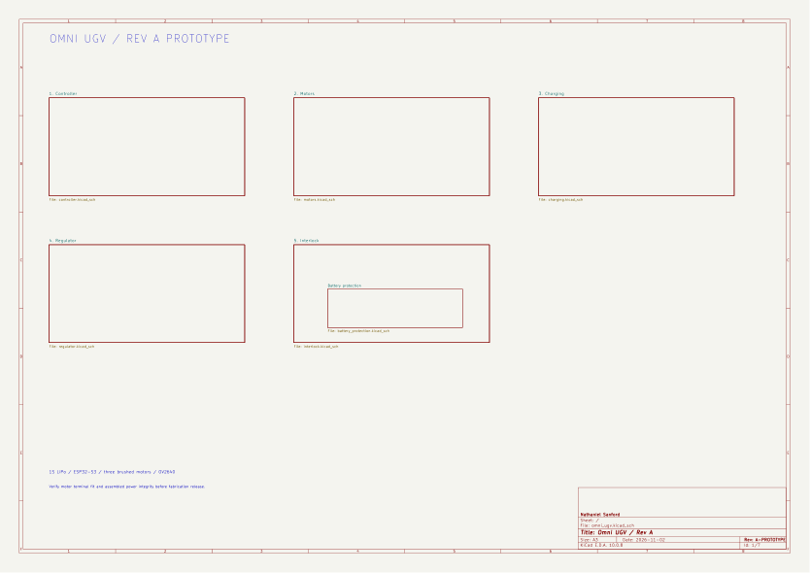
work/humanize/page0.png
