ncripted/DAMIEN/work/humanize/page1.png

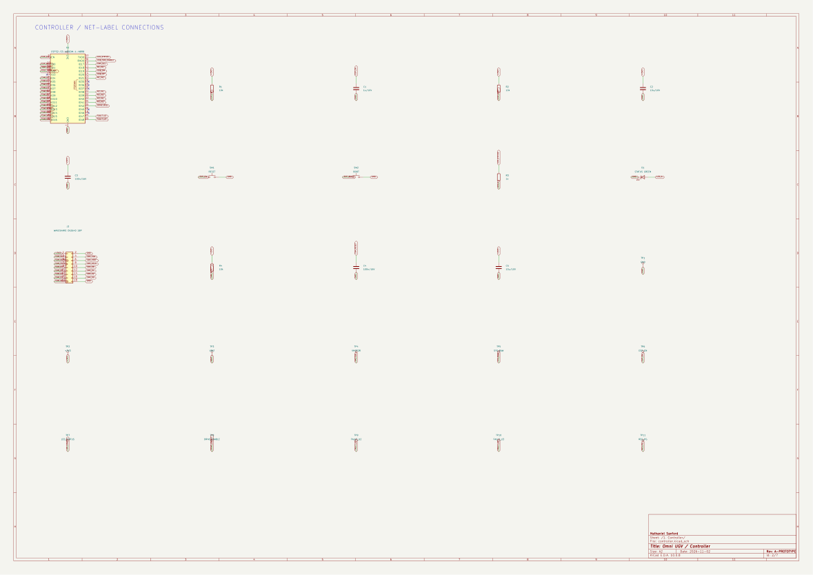
work/humanize/page1.png
