ncripted/DAMIEN/work/humanize/page2.png

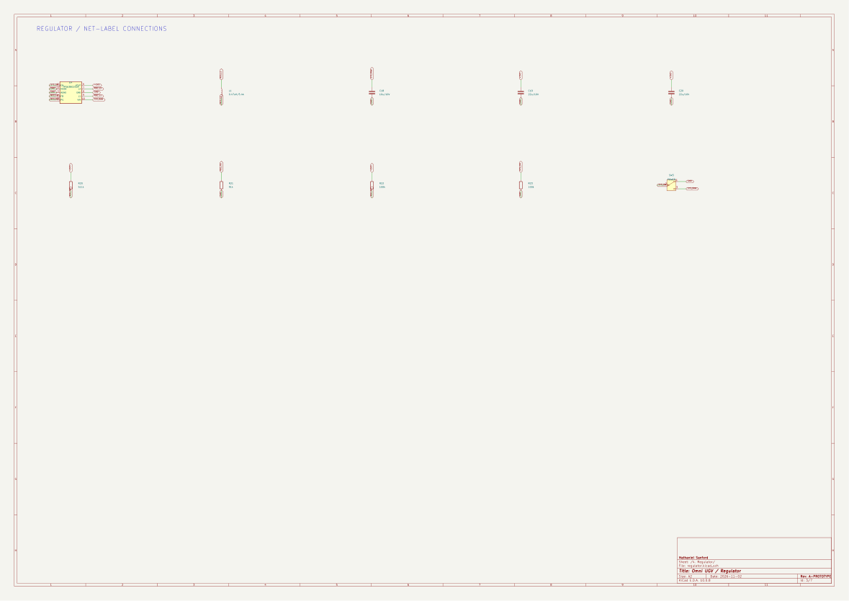
work/humanize/page2.png
