ncripted/DAMIEN/work/humanize/page3.png

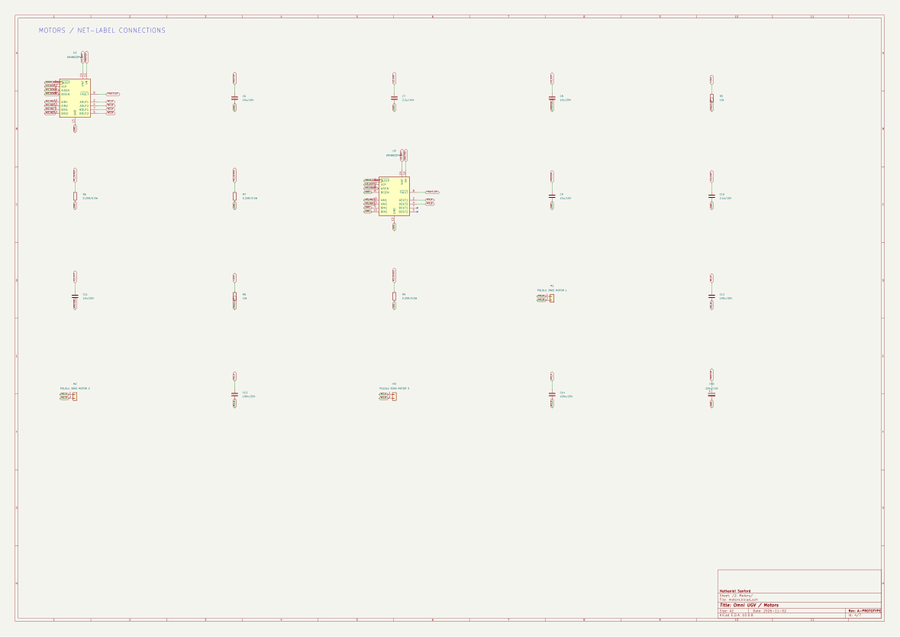
work/humanize/page3.png
