ncripted/DAMIEN/work/humanize/page4.png

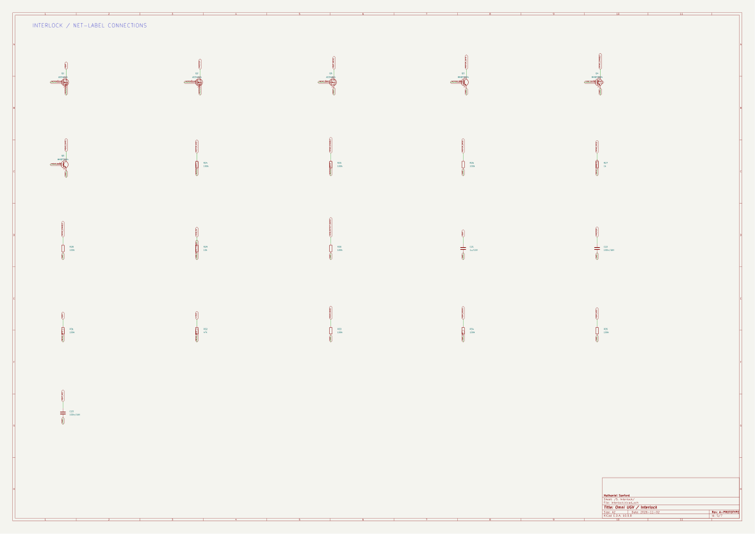
work/humanize/page4.png
