ncripted/DAMIEN/work/humanize/page5.png

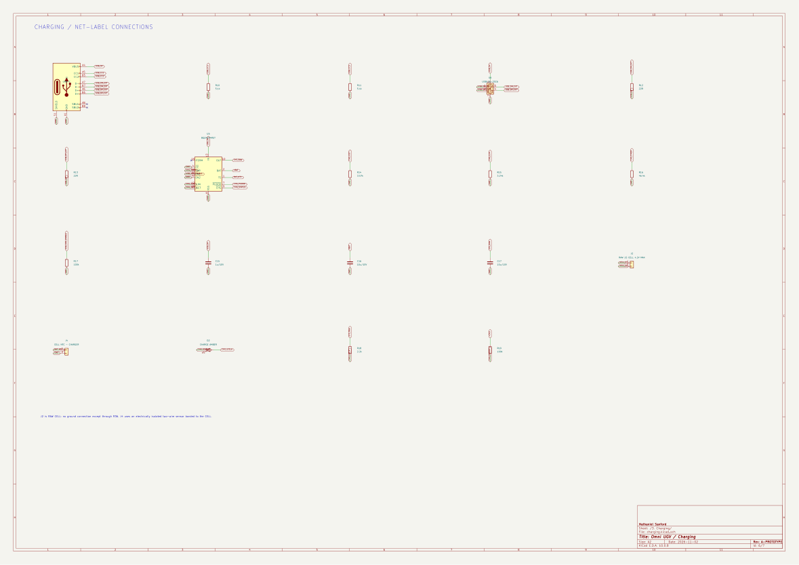
work/humanize/page5.png
