ncripted/DAMIEN/work/humanize/page6.png

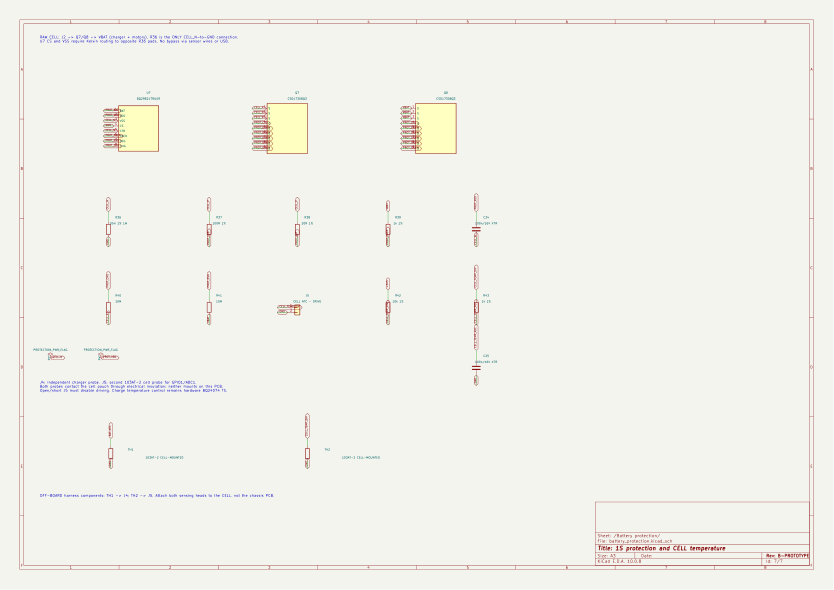
work/humanize/page6.png
