ncripted/DAMIEN/work/power-rev-d/page-8.png

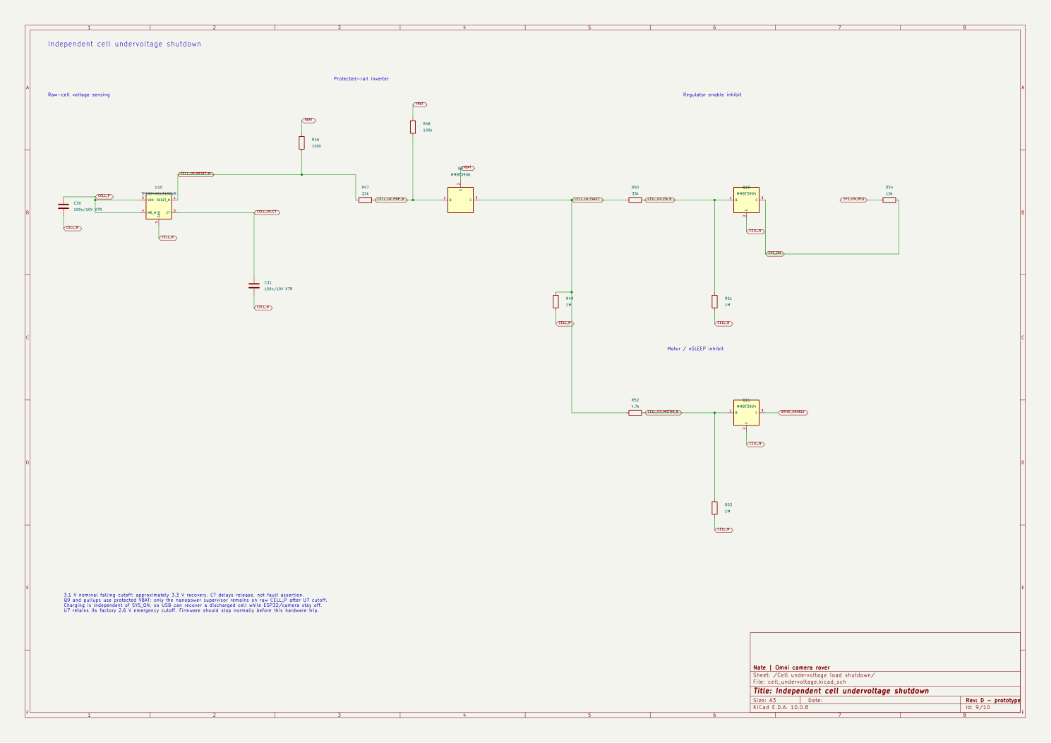
work/power-rev-d/page-8.png
