ncripted/DAMIEN/work/protection/ads33.png

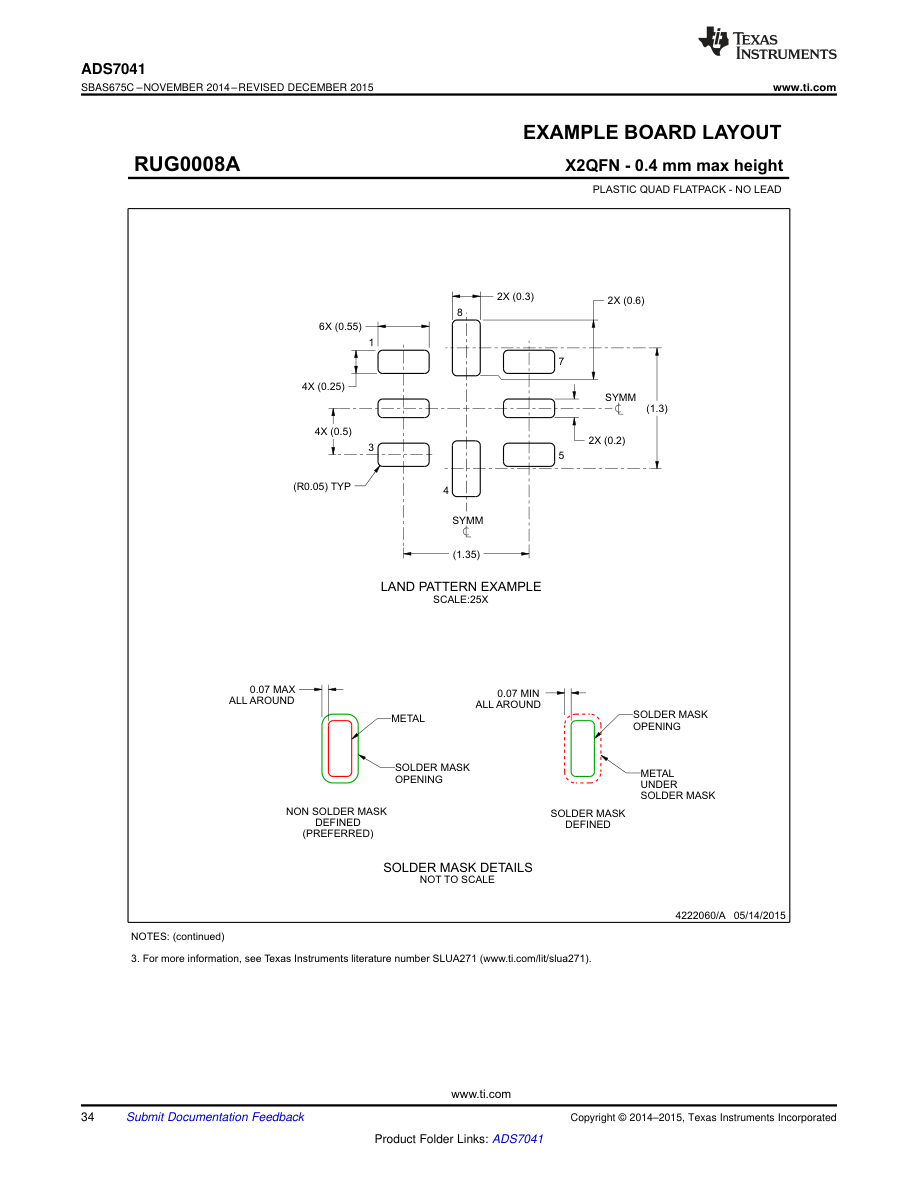
work/protection/ads33.png
