ncripted/DAMIEN/work/protection/ads40.png

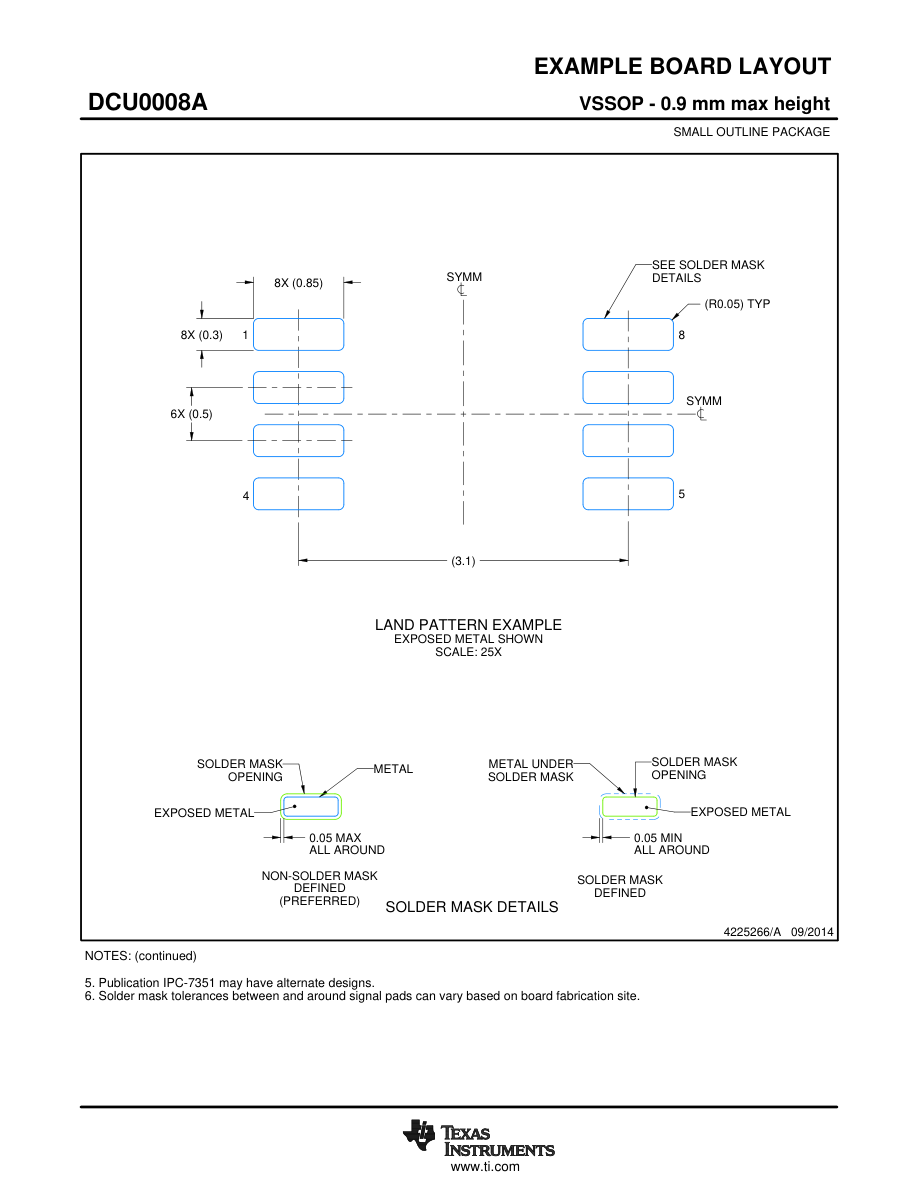
work/protection/ads40.png
