ncripted/DAMIEN/work/protection/bq2980.png

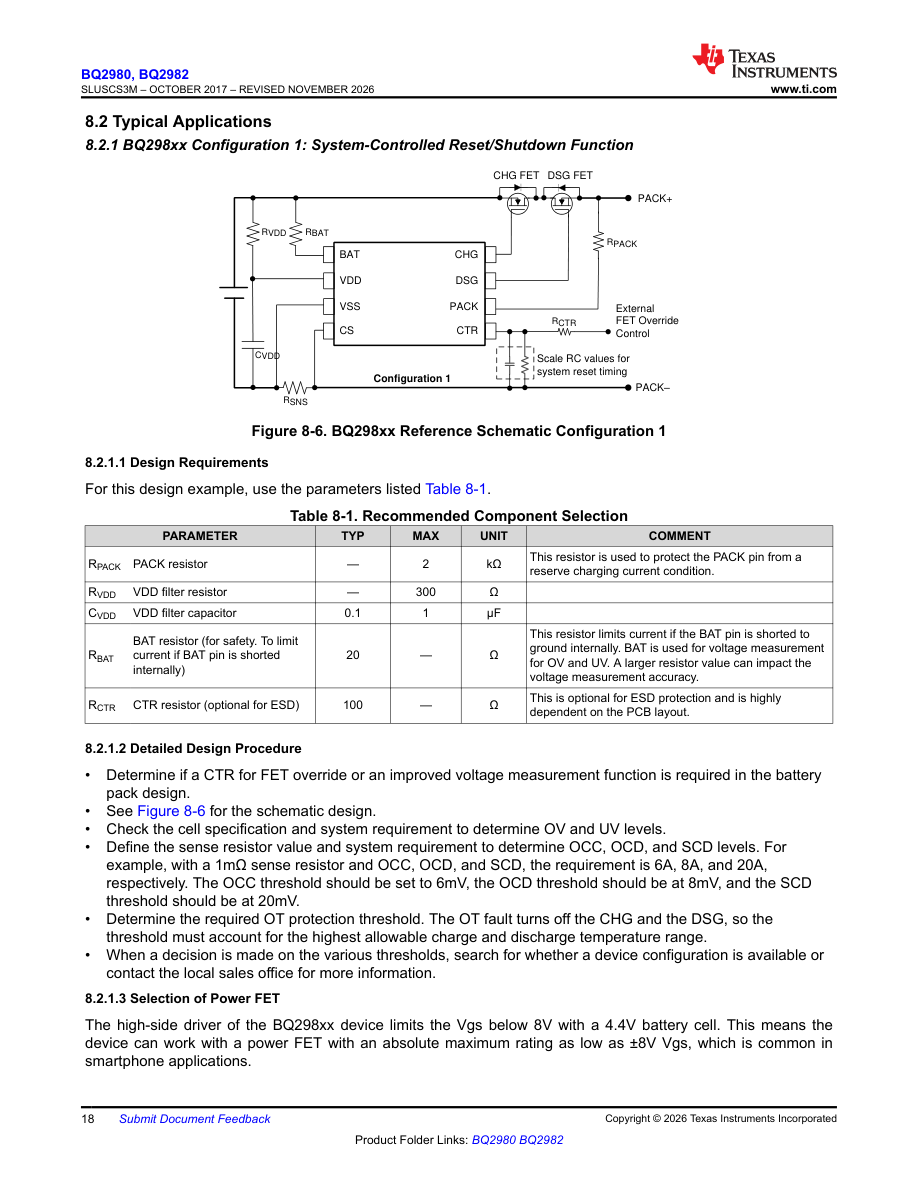
work/protection/bq2980.png
