ncripted/DAMIEN/work/protection/csd17577q3a.png

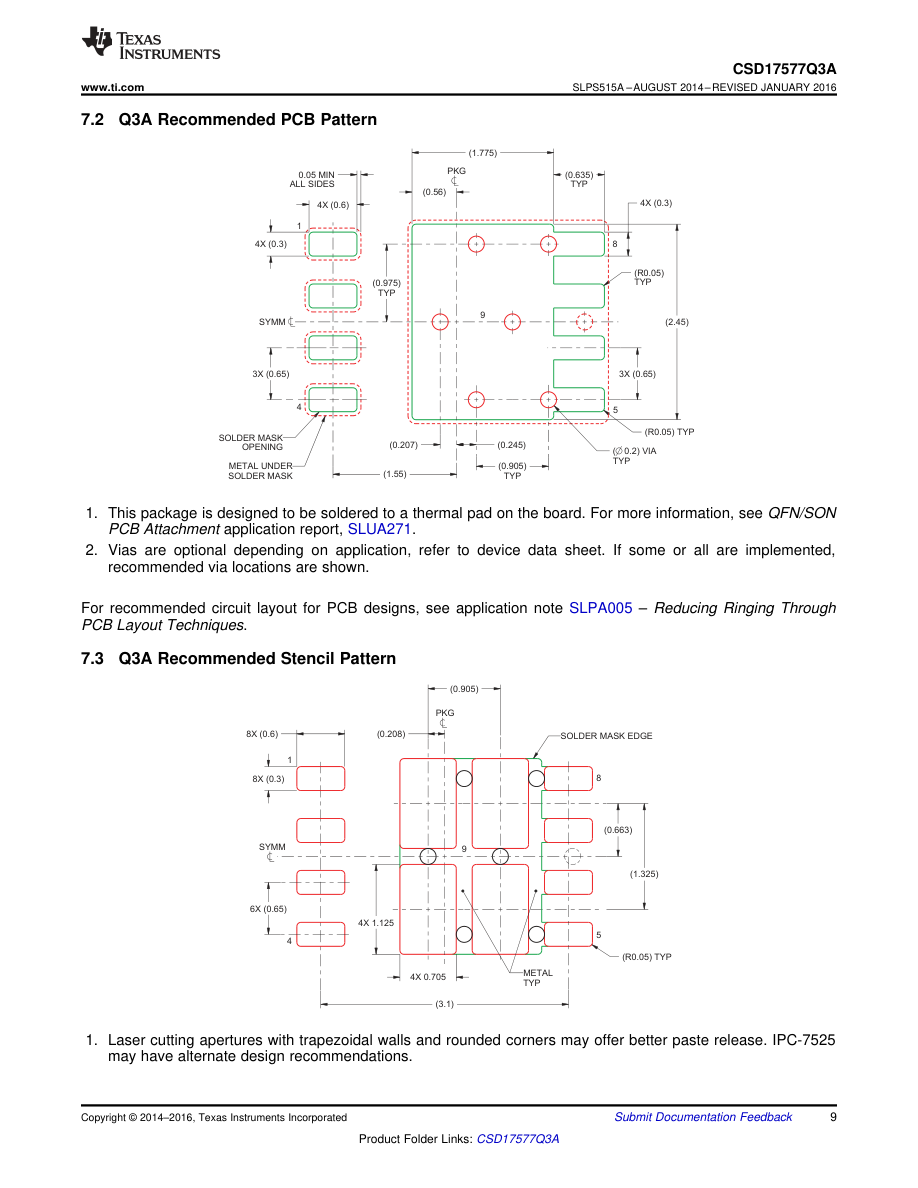
work/protection/csd17577q3a.png
