ncripted/DAMIEN/work/protection/fet-final-land.png

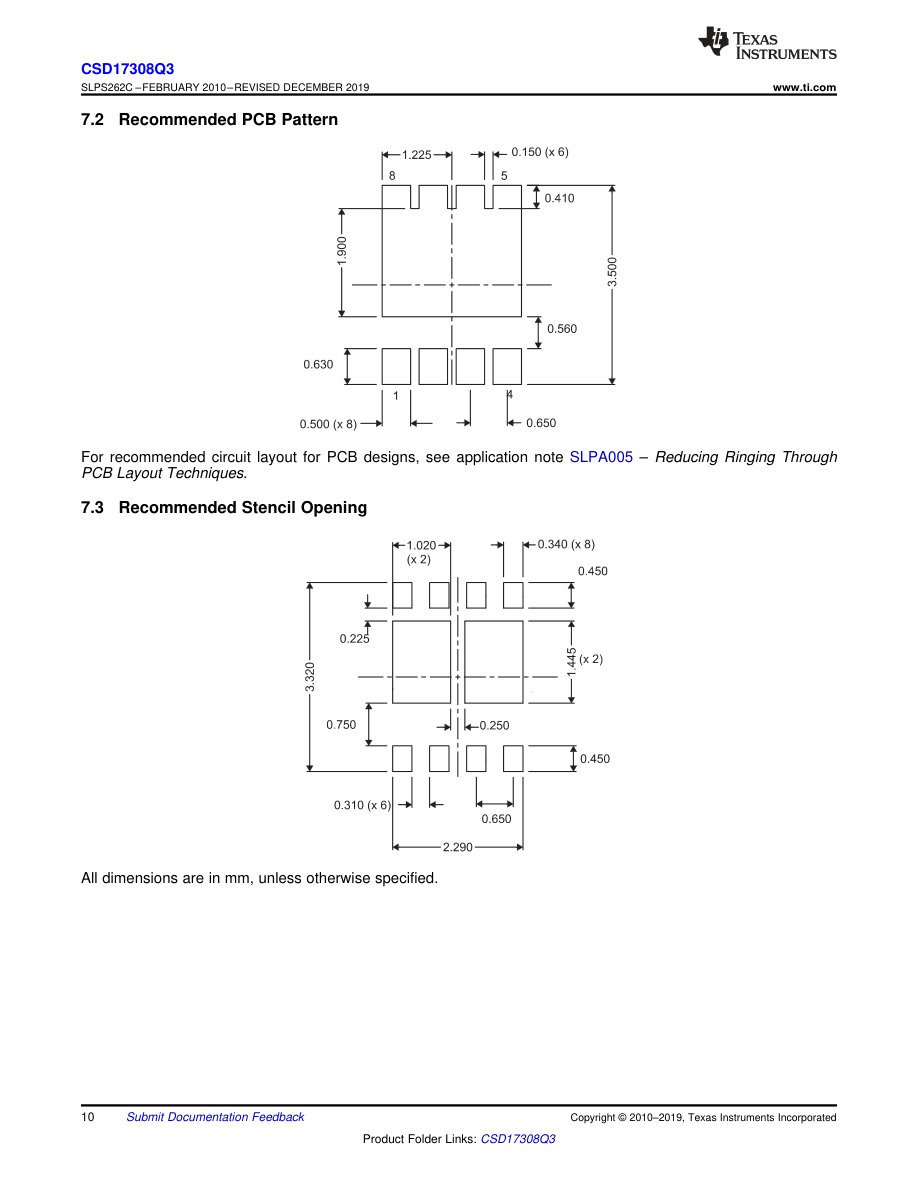
work/protection/fet-final-land.png
