ncripted/DAMIEN/work/protection/fet-package.png

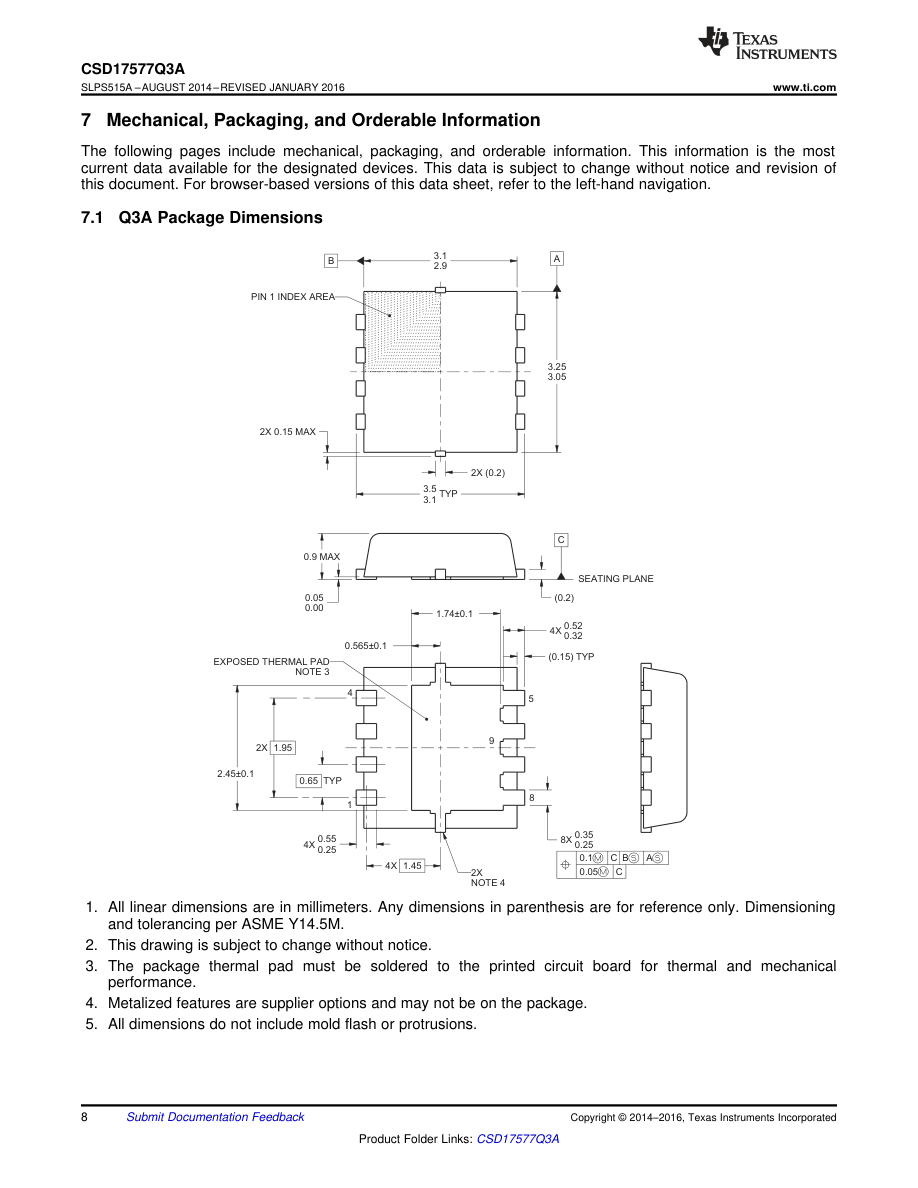
work/protection/fet-package.png
