ncripted/DAMIEN/work/protection/fet-top.png

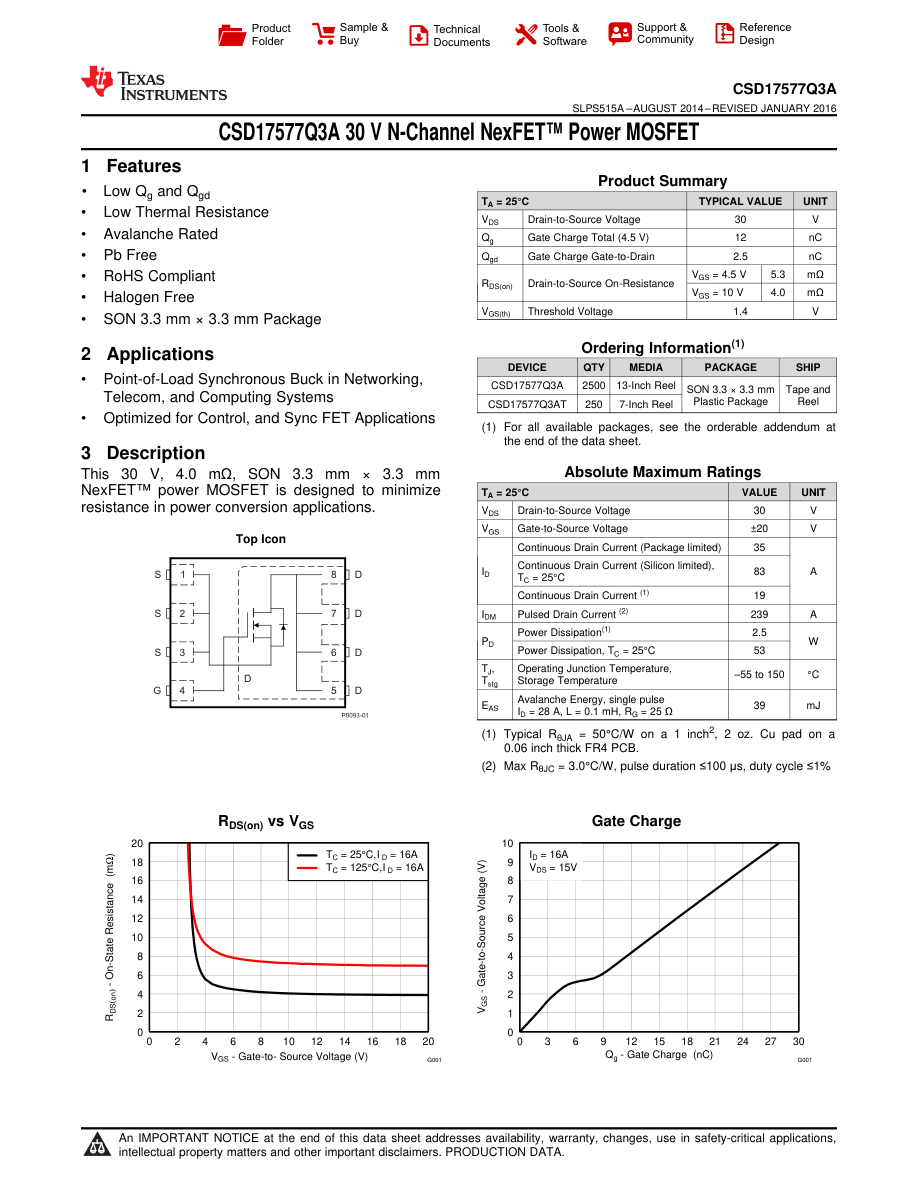
work/protection/fet-top.png
