ncripted/DAMIEN/work/protection/ground.png

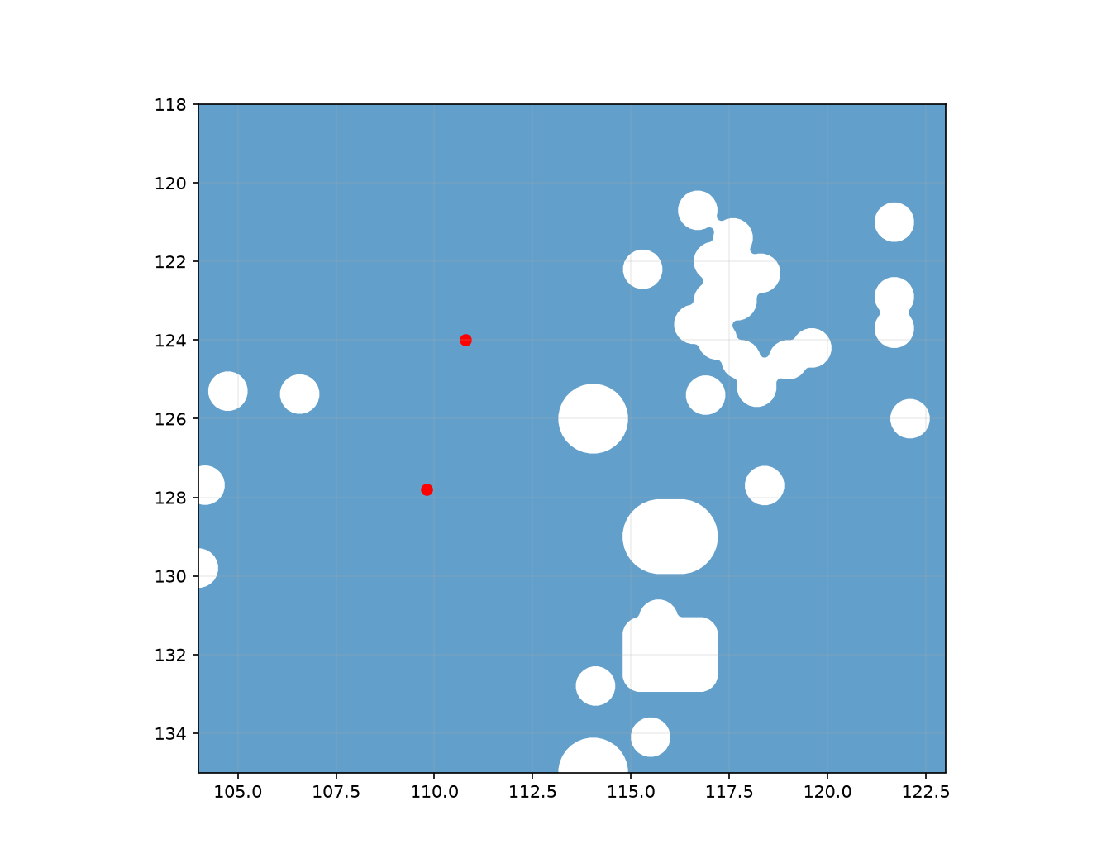
work/protection/ground.png
