ncripted/DAMIEN/work/protection/layout.png

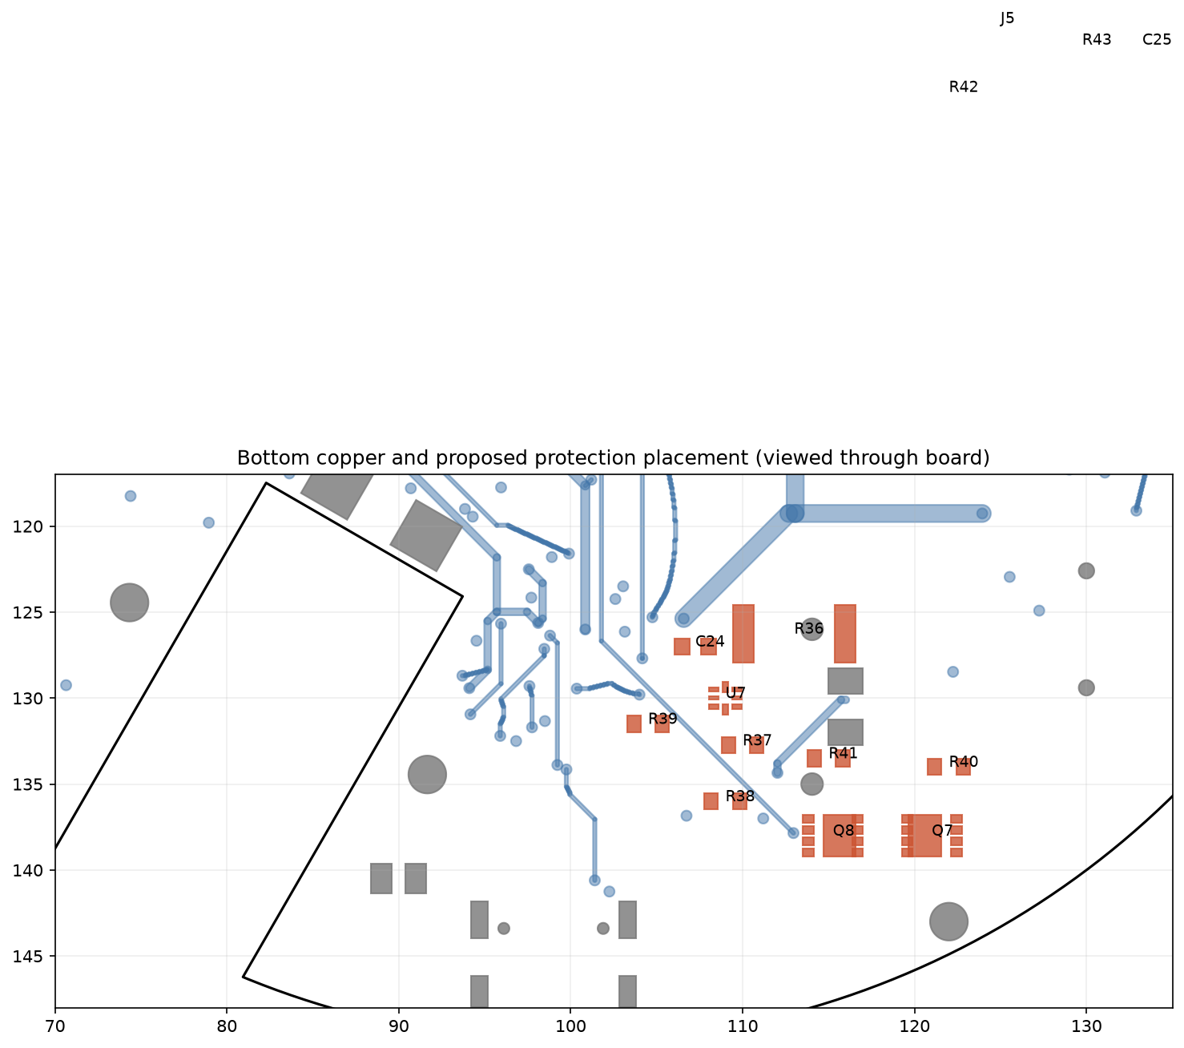
work/protection/layout.png
