ncripted/DAMIEN/work/protection/rug0.png

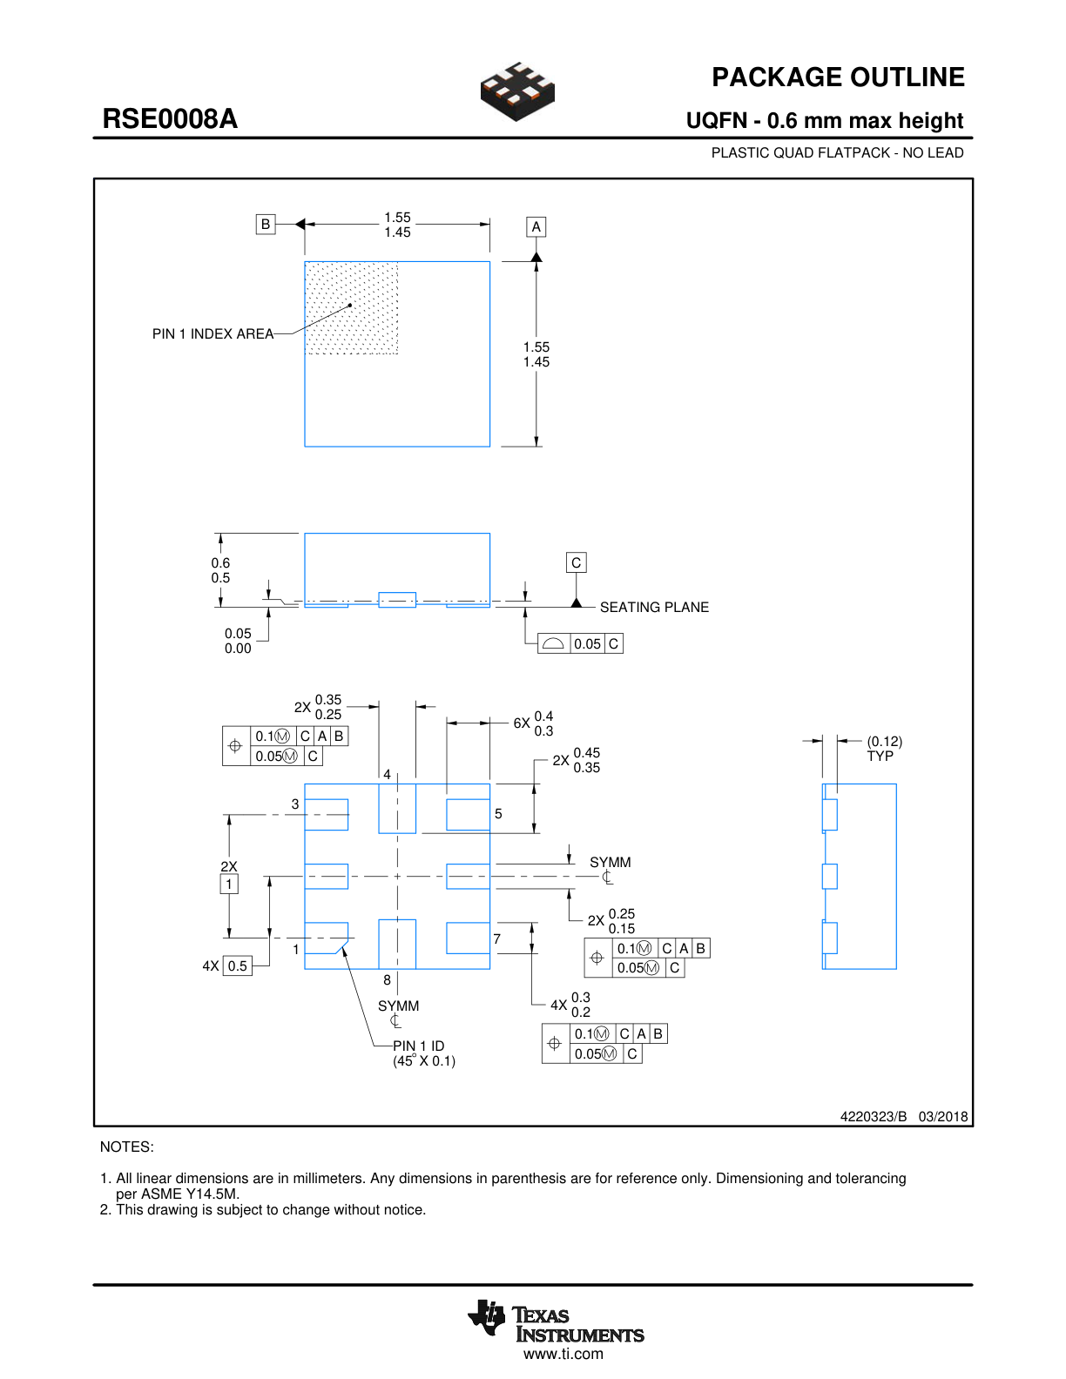
work/protection/rug0.png
