ncripted/DAMIEN/work/protection/rug1.png

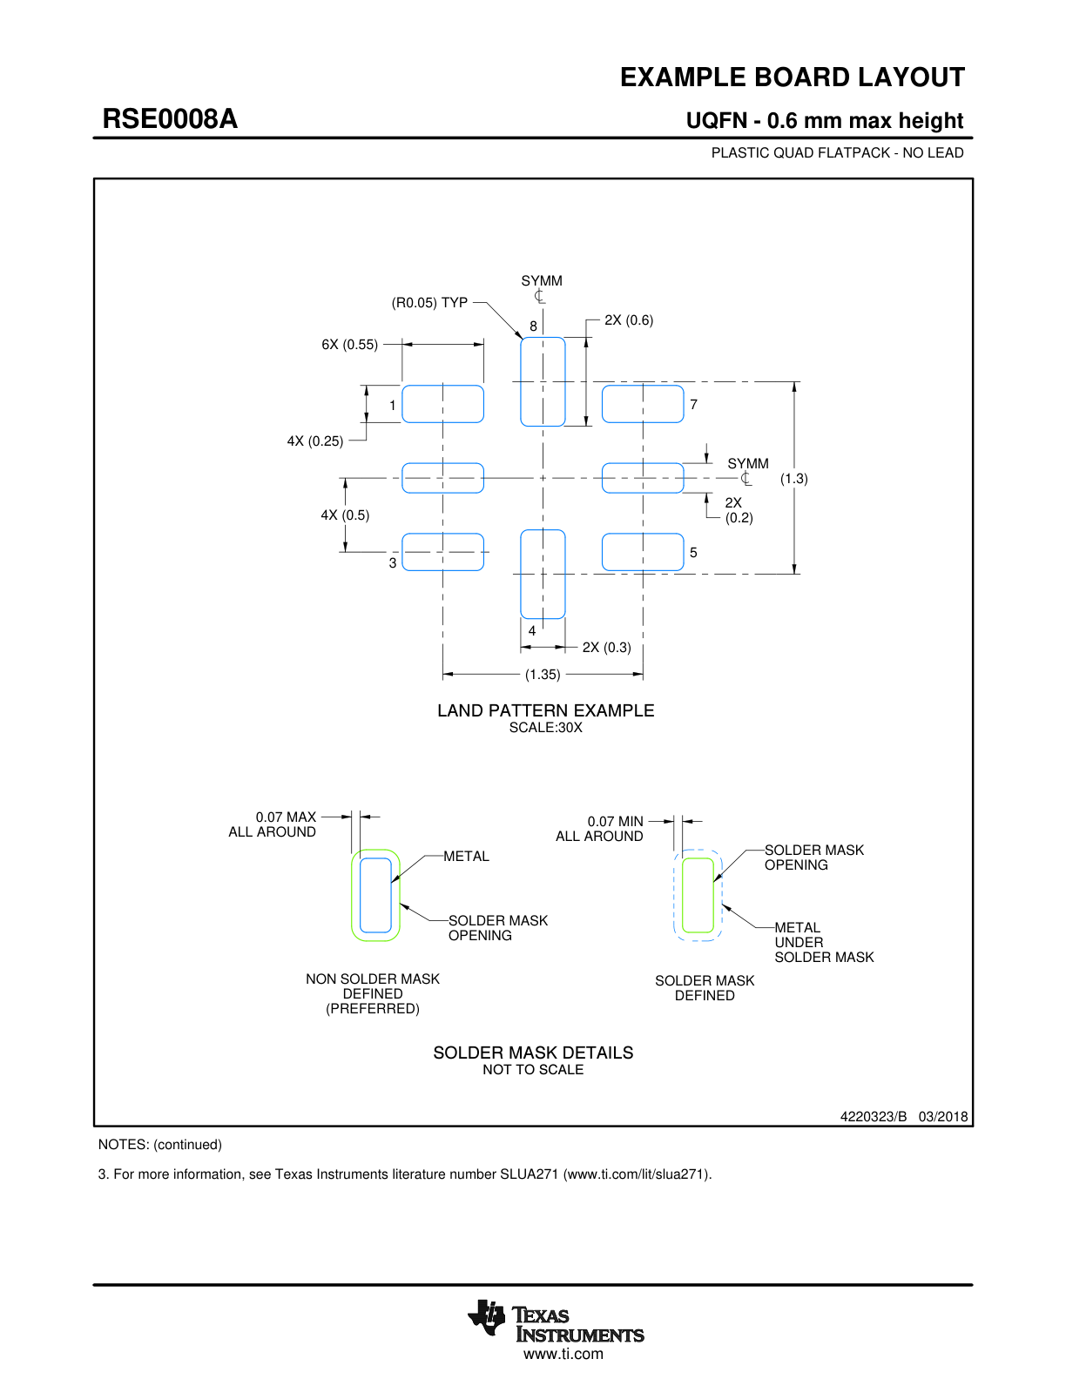
work/protection/rug1.png
