ncripted/DAMIEN/work/protection/rug2.png

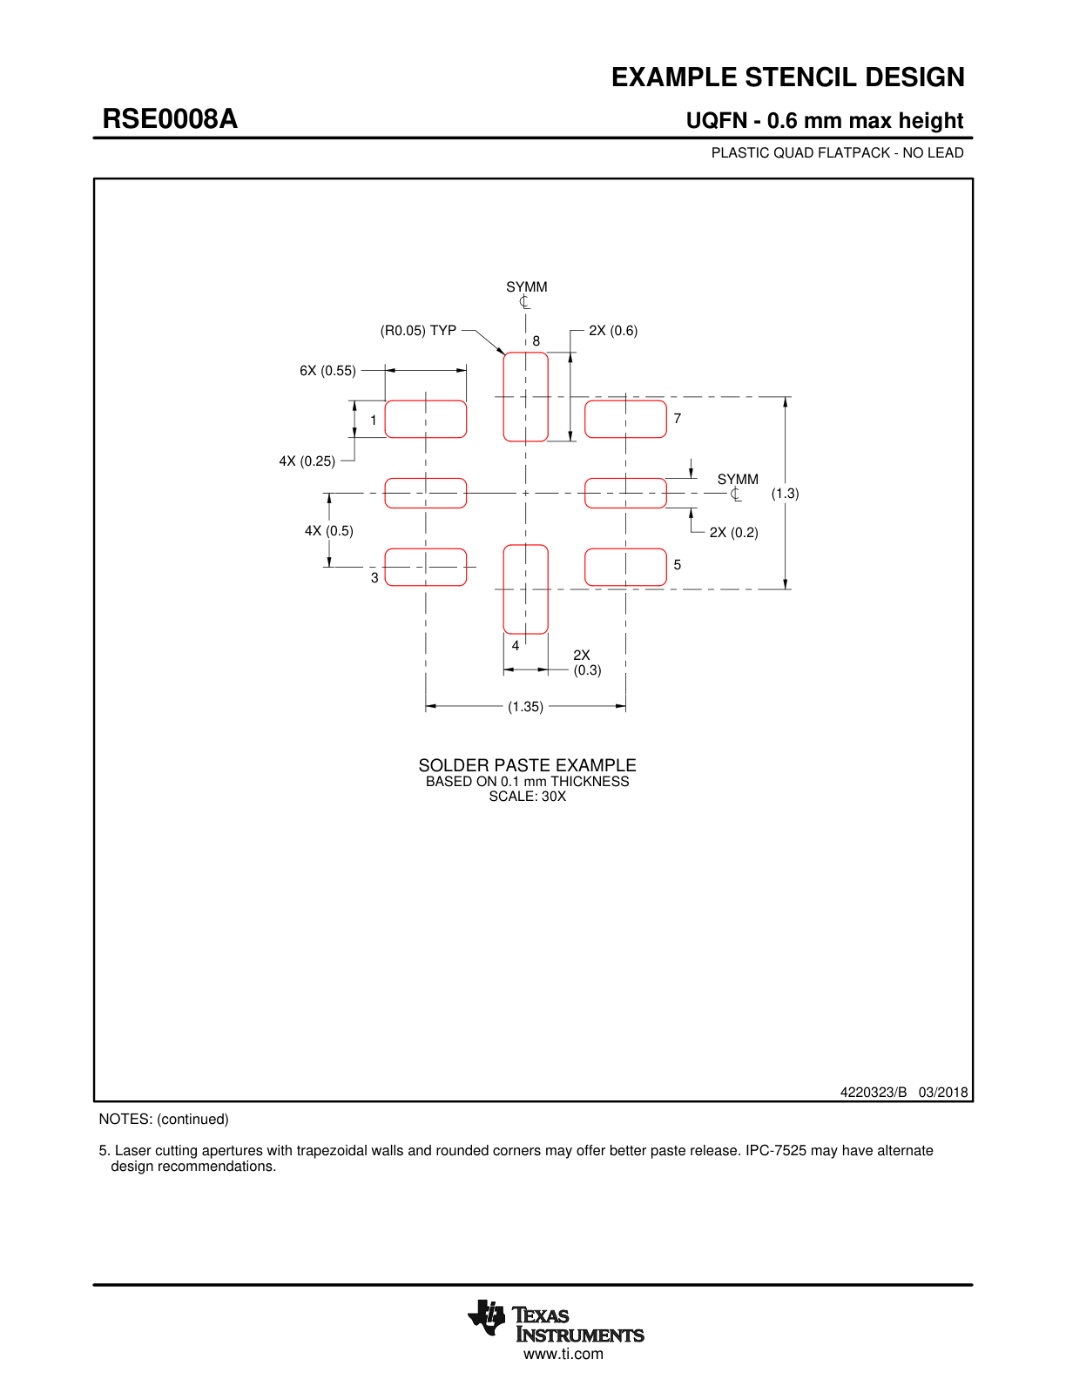
work/protection/rug2.png
