ncripted/DAMIEN/work/protection/rug3.png

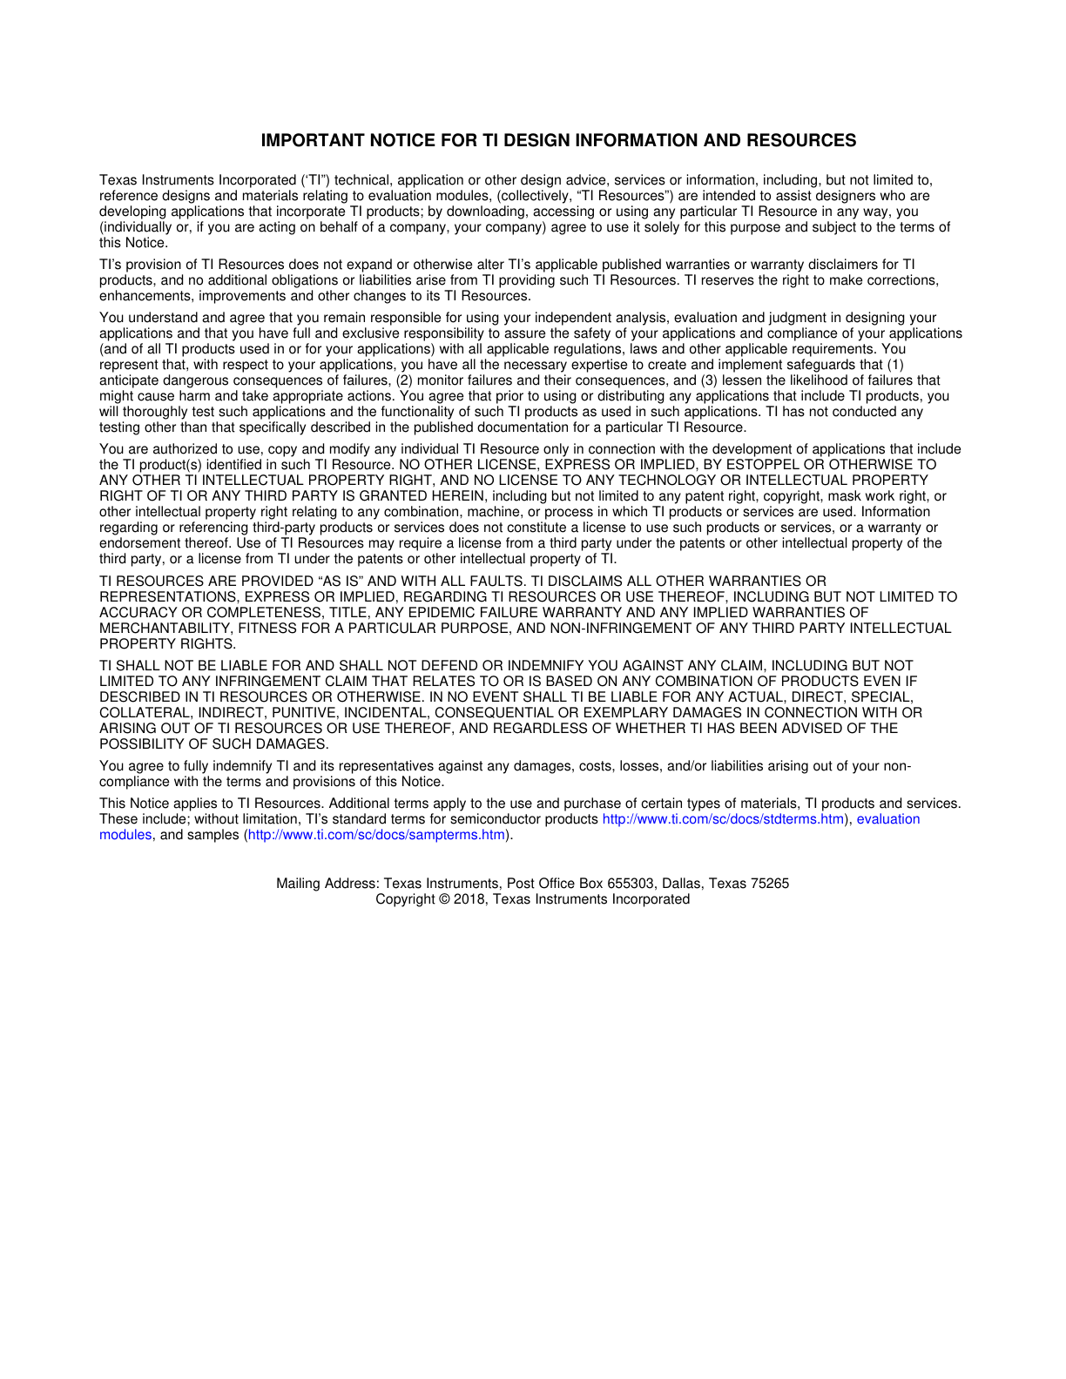
work/protection/rug3.png
