ncripted/DAMIEN/work/protection/rug-land.png

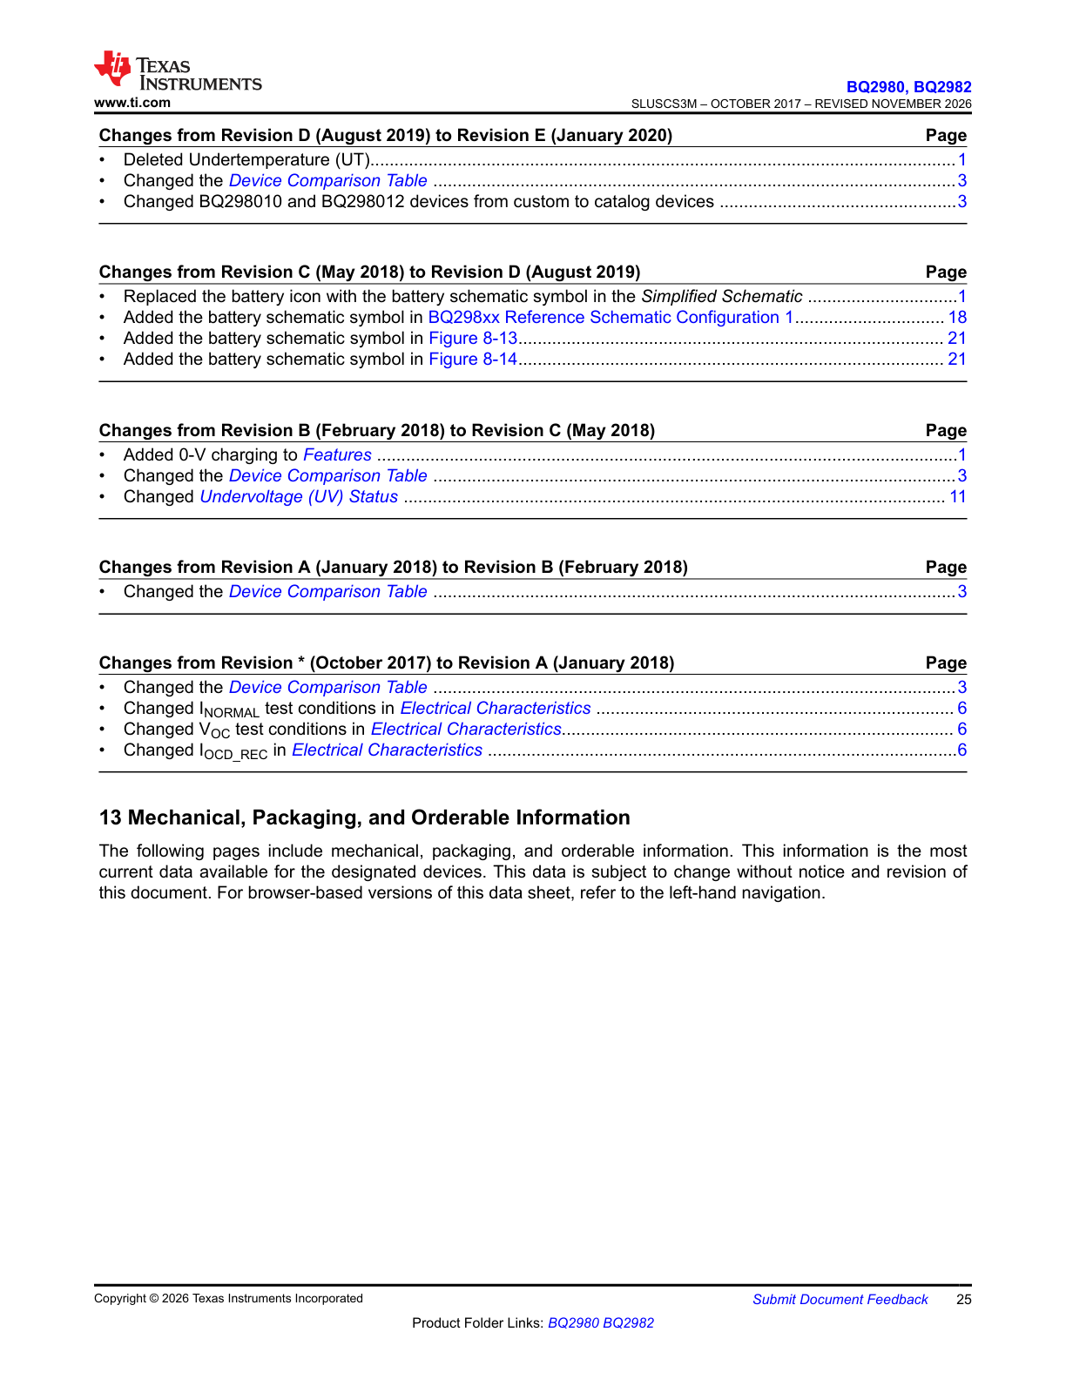
work/protection/rug-land.png
