ncripted/DAMIEN/work/protection/rug.png

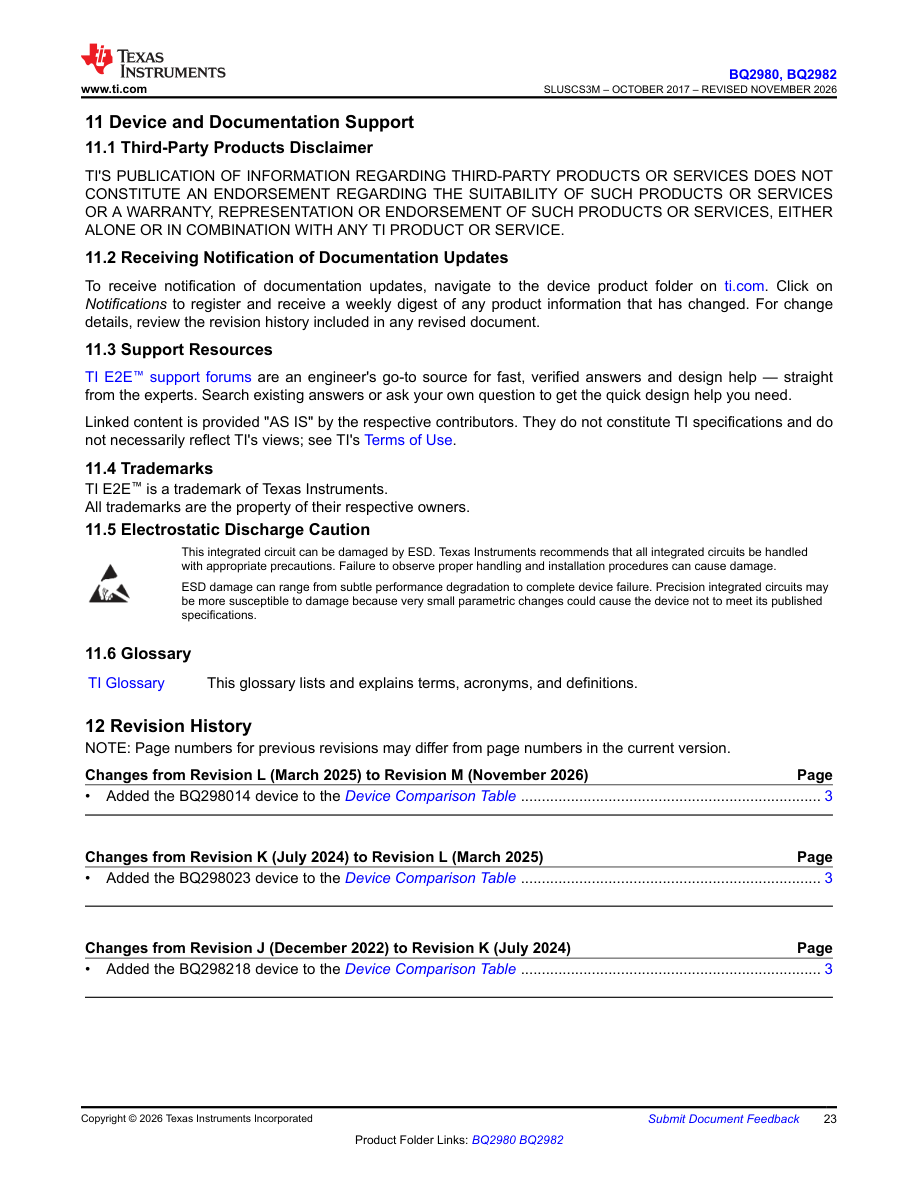
work/protection/rug.png
