ncripted/DAMIEN/work/protection/schematic.png

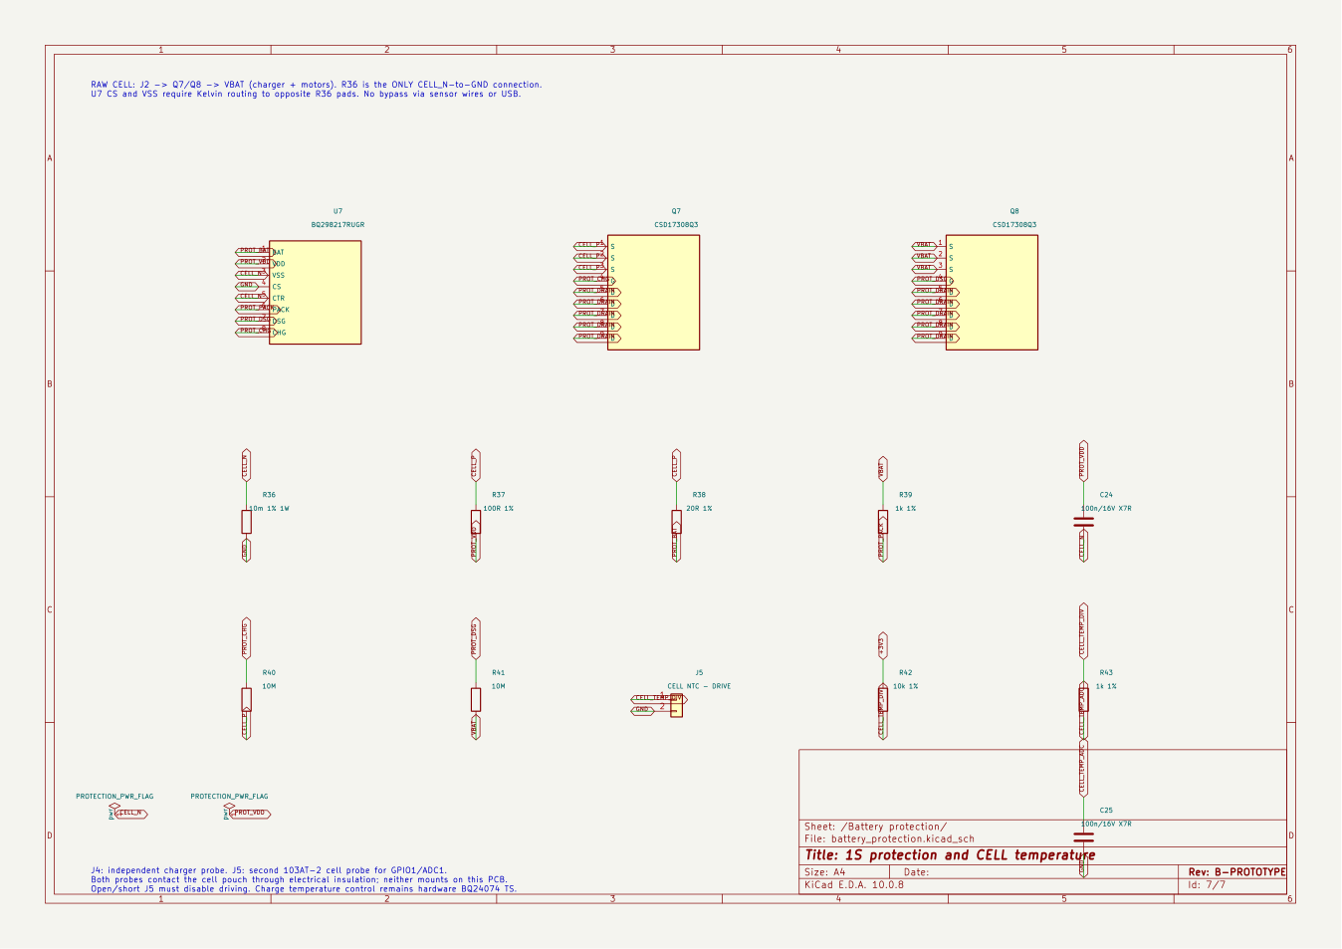
work/protection/schematic.png
