ncripted/DAMIEN/work/rev-e/copper-0.png

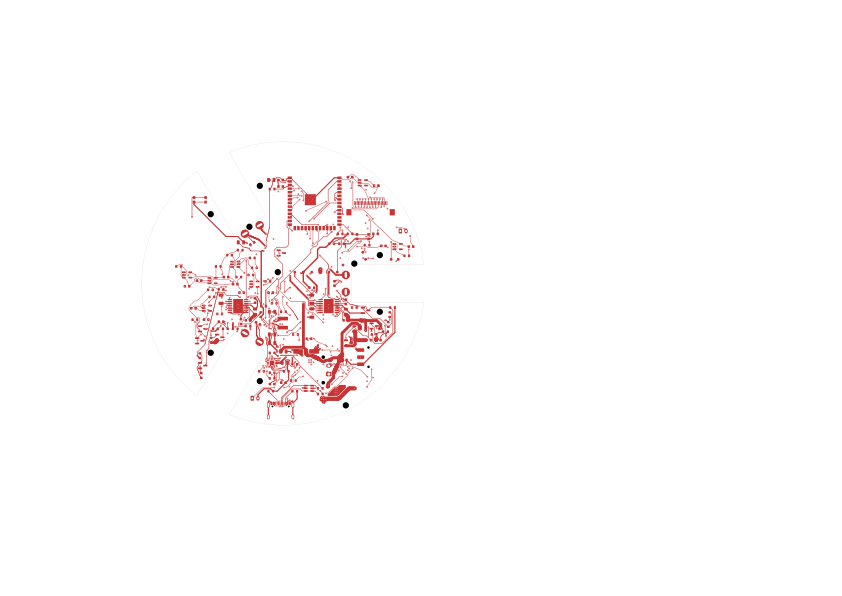
work/rev-e/copper-0.png
