ncripted/DAMIEN/work/rev-e/gate-fanout.png

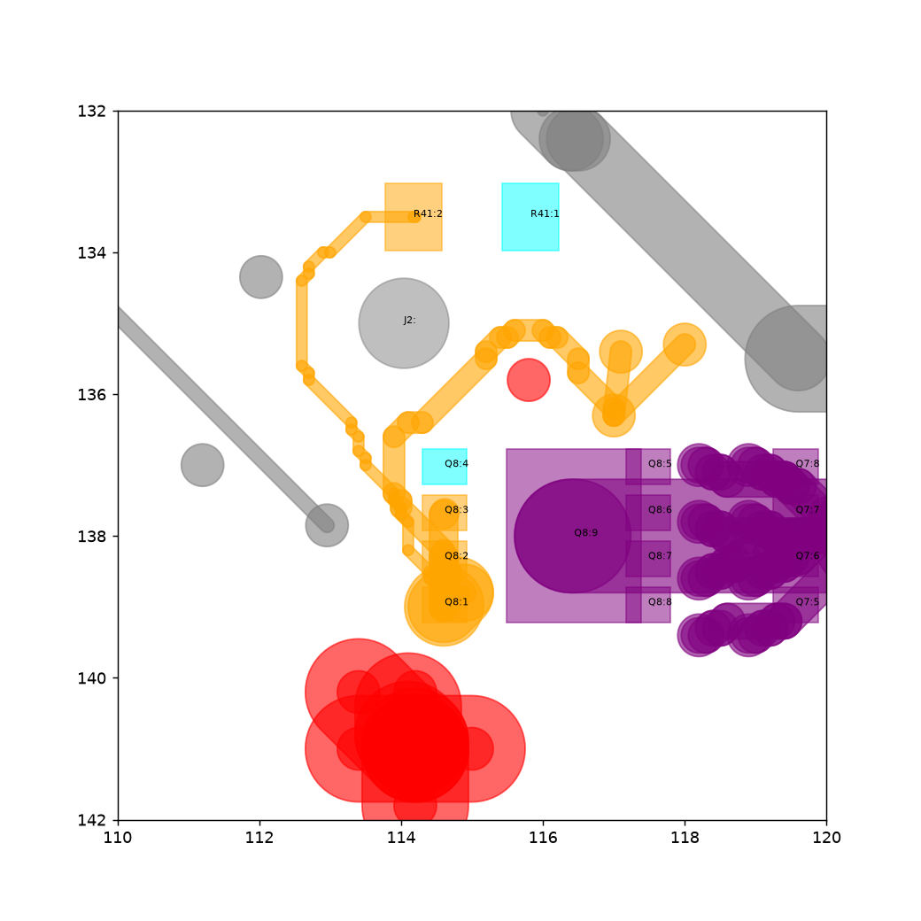
work/rev-e/gate-fanout.png
