ncripted/DAMIEN/work/rev-e/local.png

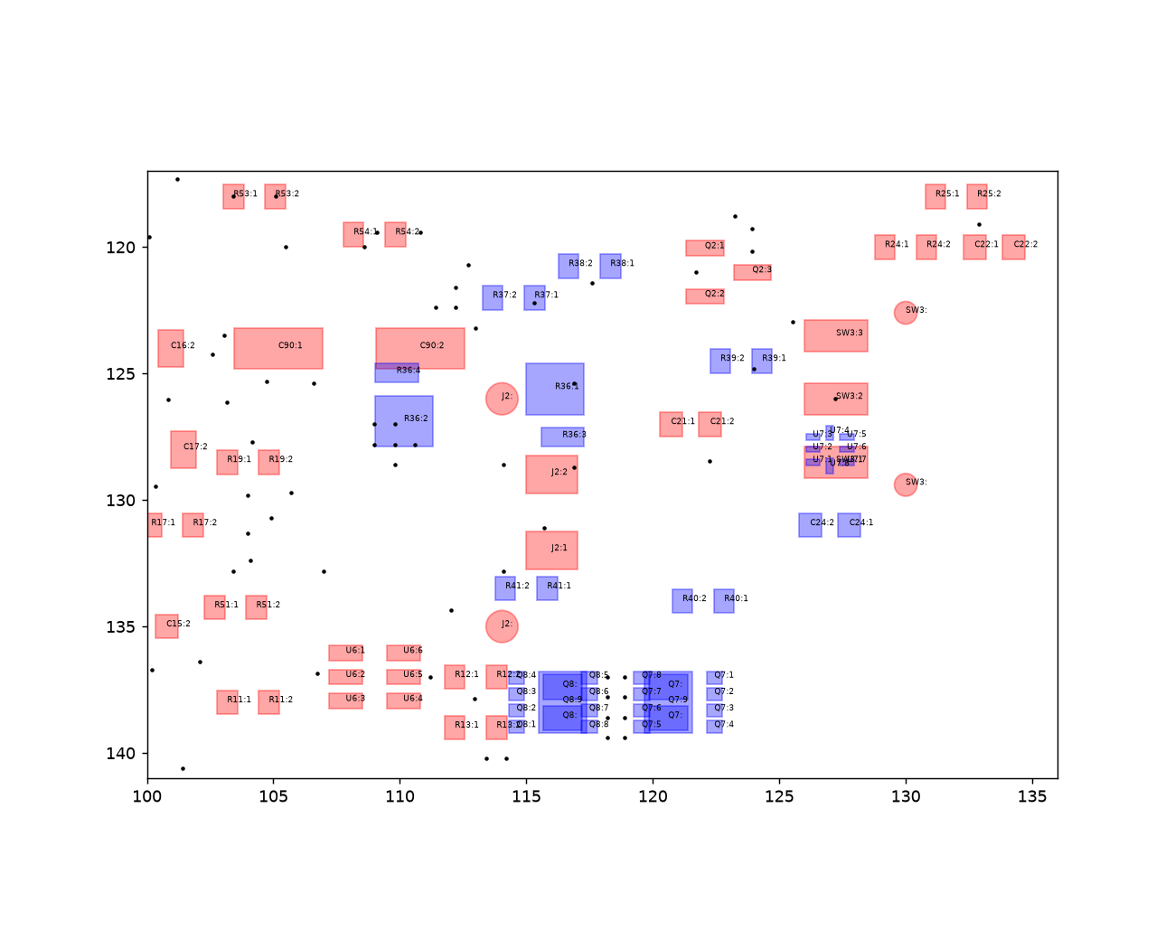
work/rev-e/local.png
