ncripted/DAMIEN/work/rev-e/sch-page-0.png

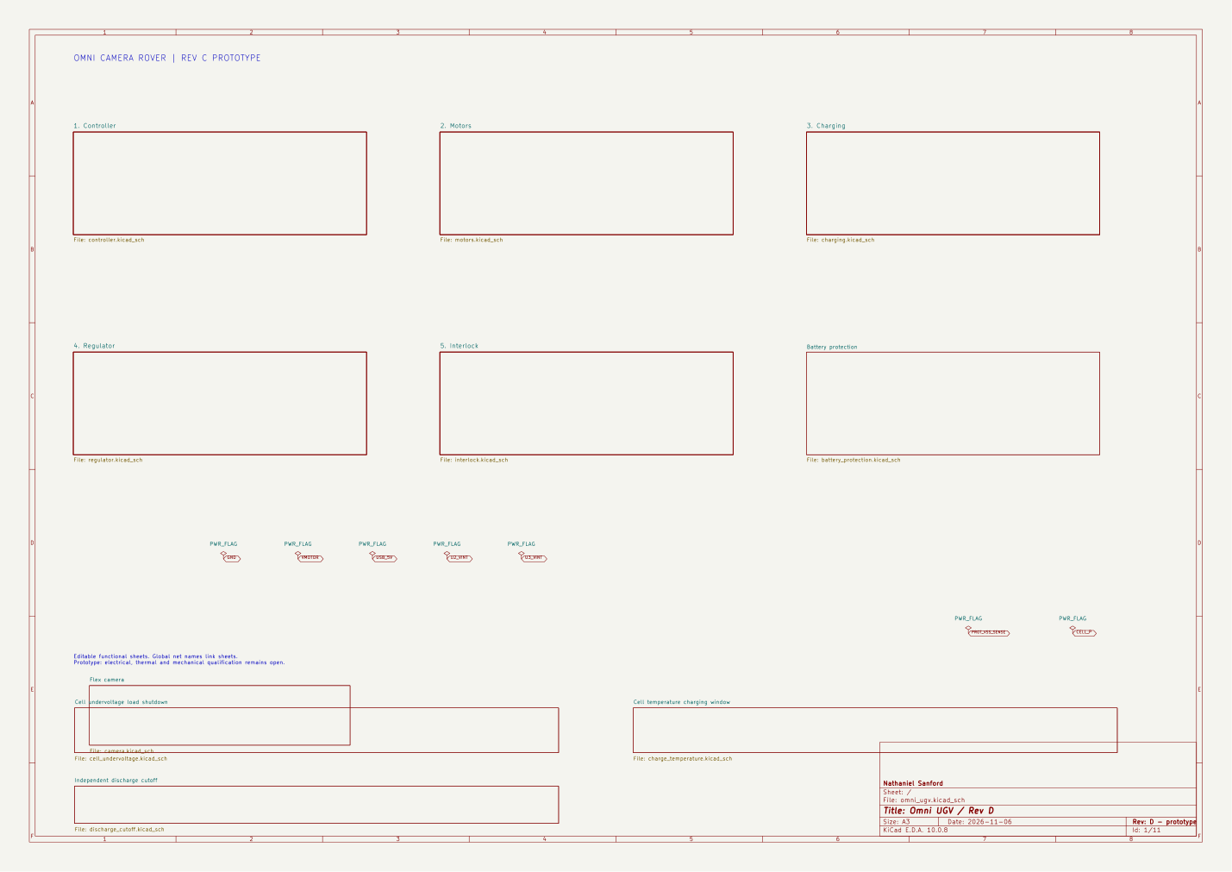
work/rev-e/sch-page-0.png
