ncripted/DAMIEN/work/rev-e/sources/wsk2512-dimensions.png

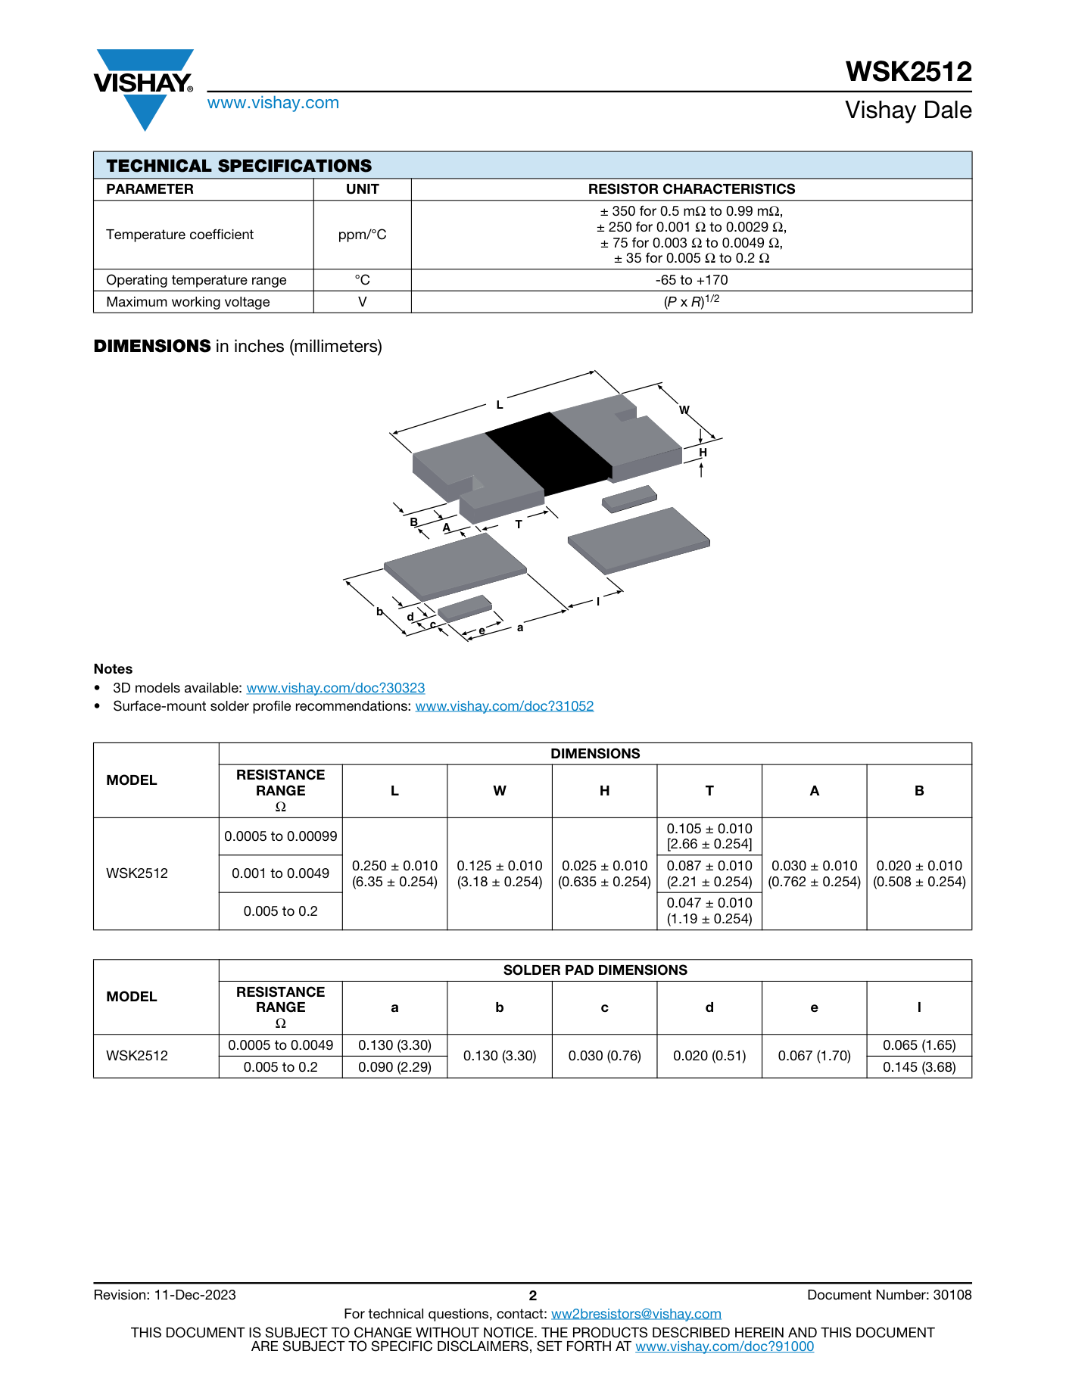
work/rev-e/sources/wsk2512-dimensions.png
