ncripted/DAMIEN/work/battery-assumptions/BOM.csv

Reference | Value | MPN | Footprint | Notes
U1 | ESP32-S3-WROOM-1-N8R8 | ESP32-S3-WROOM-1-N8R8 | UGV:RF_Module__ESP32-S3-WROOM-1
R1 | 10k |  | UGV:Resistor_SMD__R_0603_1608Metric
C1 | 1u/10V |  | UGV:Capacitor_SMD__C_0603_1608Metric
R2 | 10k |  | UGV:Resistor_SMD__R_0603_1608Metric
C2 | 10u/10V |  | UGV:Capacitor_SMD__C_0805_2012Metric
C3 | 100n/16V |  | UGV:Capacitor_SMD__C_0603_1608Metric
SW1 | RESET | KMR221GLFS | UGV:Button_Switch_SMD__SW_Push_1P1T_NO_CK_KMR2
SW2 | BOOT | KMR221GLFS | UGV:Button_Switch_SMD__SW_Push_1P1T_NO_CK_KMR2
R3 | 1k |  | UGV:Resistor_SMD__R_0603_1608Metric
D1 | STATUS GREEN | 0603 green LED | UGV:LED_SMD__LED_0603_1608Metric
J3 | WAVESHARE OV2640 18P | 2x9 2.54mm male header | UGV:Connector_PinHeader_2.54mm__PinHeader_2x09_P2.54mm_Vertical | Use short cable to camera; pins 17 RESET high, 18 PWDN low; Waveshare board includes regulators and SCCB pullups
R4 | 10k |  | UGV:Resistor_SMD__R_0603_1608Metric
C4 | 100n/16V |  | UGV:Capacitor_SMD__C_0603_1608Metric
C5 | 10u/10V |  | UGV:Capacitor_SMD__C_0805_2012Metric
U2 | DRV8833PWP | DRV8833PWPR | UGV:Package_SO__HTSSOP-16-1EP_4.4x5mm_P0.65mm_EP3.4x5mm_Mask2.46x2.31mm
C6 | 10u/10V |  | UGV:Capacitor_SMD__C_0805_2012Metric
C7 | 2.2u/10V |  | UGV:Capacitor_SMD__C_0603_1608Metric
C8 | 10n/25V |  | UGV:Capacitor_SMD__C_0603_1608Metric
R5 | 10k |  | UGV:Resistor_SMD__R_0603_1608Metric
R6 | 0.25R/0.5W |  | UGV:Resistor_SMD__R_1206_3216Metric
R7 | 0.25R/0.5W |  | UGV:Resistor_SMD__R_1206_3216Metric
U3 | DRV8833PWP | DRV8833PWPR | UGV:Package_SO__HTSSOP-16-1EP_4.4x5mm_P0.65mm_EP3.4x5mm_Mask2.46x2.31mm
C9 | 10u/10V |  | UGV:Capacitor_SMD__C_0805_2012Metric
C10 | 2.2u/10V |  | UGV:Capacitor_SMD__C_0603_1608Metric
C11 | 10n/25V |  | UGV:Capacitor_SMD__C_0603_1608Metric
R8 | 10k |  | UGV:Resistor_SMD__R_0603_1608Metric
R9 | 0.25R/0.5W |  | UGV:Resistor_SMD__R_1206_3216Metric
M1 | POLOLU 3065 MOTOR 1 | Pololu 3065 | UGV:Pololu_HPCB_Solder | Terminal slots require physical fit check; use separate printed clamps
C12 | 100n/25V |  | UGV:Capacitor_SMD__C_0603_1608Metric
M2 | POLOLU 3065 MOTOR 2 | Pololu 3065 | UGV:Pololu_HPCB_Solder | Terminal slots require physical fit check; use separate printed clamps
C13 | 100n/25V |  | UGV:Capacitor_SMD__C_0603_1608Metric
M3 | POLOLU 3065 MOTOR 3 | Pololu 3065 | UGV:Pololu_HPCB_Solder | Terminal slots require physical fit check; use separate printed clamps
C14 | 100n/25V |  | UGV:Capacitor_SMD__C_0603_1608Metric
C90 | 220u/10V | Panasonic EEEFT1A221AP | UGV:CP_Elec_6.3x5.8_HandAssembly | 6.3mm diameter, 5.8mm high; oversized hand-assembly lands; approved 220-470uF bulk range; check actual PWM ripple
J1 | USB-C | GCT USB4105-GF-A | UGV:Connector_USB__USB_C_Receptacle_GCT_USB4105-xx-A_16P_TopMnt_Horizontal
R10 | 5.1k |  | UGV:Resistor_SMD__R_0603_1608Metric
R11 | 5.1k |  | UGV:Resistor_SMD__R_0603_1608Metric
U6 | USBLC6-2SC6 | USBLC6-2SC6 | UGV:Package_TO_SOT_SMD__SOT-23-6
R12 | 22R |  | UGV:Resistor_SMD__R_0603_1608Metric
R13 | 22R |  | UGV:Resistor_SMD__R_0603_1608Metric
U5 | BQ24074RGT | BQ24074RGTR | UGV:Package_DFN_QFN__VQFN-16-1EP_3x3mm_P0.5mm_EP1.6x1.6mm
R14 | 3.57k |  | UGV:Resistor_SMD__R_0603_1608Metric
R15 | 3.24k |  | UGV:Resistor_SMD__R_0603_1608Metric
R16 | 46.4k |  | UGV:Resistor_SMD__R_0603_1608Metric
R17 | 100k |  | UGV:Resistor_SMD__R_0603_1608Metric
C15 | 1u/10V |  | UGV:Capacitor_SMD__C_0603_1608Metric
C16 | 10u/10V |  | UGV:Capacitor_SMD__C_0805_2012Metric
C17 | 10u/10V |  | UGV:Capacitor_SMD__C_0805_2012Metric
J2 | RAW 1S CELL 4.2V MAX | Molex 43650-0215 | UGV:Connector_Molex__Molex_Micro-Fit_3.0_43650-0215_1x02_P3.00mm_Vertical | Raw cell input, pin1 positive; protection now onboard. Cell itself must support >=4A continuous / >=5A peak. No CELL_N-to-GND bypass.
J4 | CELL NTC - CHARGER | JST B2B-PH-K-S | UGV:Connector_JST__JST_PH_B2B-PH-K_1x02_P2.00mm_Vertical | Independent 103AT-2 probe bonded to cell; both leads isolated from cell terminals. Pin1 TS, pin2 system GND. Do not share with J5.
D2 | CHARGE AMBER |  | UGV:LED_SMD__LED_0603_1608Metric
R18 | 2.2k |  | UGV:Resistor_SMD__R_0603_1608Metric
R19 | 100k |  | UGV:Resistor_SMD__R_0603_1608Metric
U4 | TPS63802DLA | TPS63802DLAR | UGV:TPS63802_DLA0010A
L1 | 0.47uH/5.4A | Coilcraft XFL4015-471MEC | UGV:L_XFL4015
C18 | 10u/10V |  | UGV:Capacitor_SMD__C_0805_2012Metric
C19 | 22u/10V |  | UGV:Capacitor_SMD__C_0805_2012Metric
C20 | 22u/10V |  | UGV:Capacitor_SMD__C_0805_2012Metric
R20 | 511k |  | UGV:Resistor_SMD__R_0603_1608Metric
R21 | 91k |  | UGV:Resistor_SMD__R_0603_1608Metric
R22 | 100k |  | UGV:Resistor_SMD__R_0603_1608Metric
R23 | 100k |  | UGV:Resistor_SMD__R_0603_1608Metric
SW3 | POWER | C&K JS102011SAQN | UGV:Button_Switch_SMD__SW_SPDT_CK_JS102011SAQN
Q1 | AO3401A | AO3401A | UGV:Package_TO_SOT_SMD__SOT-23
Q2 | AO3401A | AO3401A | UGV:Package_TO_SOT_SMD__SOT-23
Q5 | AO3401A | AO3401A | UGV:Package_TO_SOT_SMD__SOT-23
Q3 | MMBT3904 | MMBT3904 | UGV:Package_TO_SOT_SMD__SOT-23
Q4 | MMBT3904 | MMBT3904 | UGV:Package_TO_SOT_SMD__SOT-23
Q6 | MMBT3904 | MMBT3904 | UGV:Package_TO_SOT_SMD__SOT-23
R24 | 100k |  | UGV:Resistor_SMD__R_0603_1608Metric
R25 | 100k |  | UGV:Resistor_SMD__R_0603_1608Metric
R26 | 100k |  | UGV:Resistor_SMD__R_0603_1608Metric
R27 | 1k |  | UGV:Resistor_SMD__R_0603_1608Metric
R28 | 100k |  | UGV:Resistor_SMD__R_0603_1608Metric
R29 | 10k |  | UGV:Resistor_SMD__R_0603_1608Metric
R30 | 100k |  | UGV:Resistor_SMD__R_0603_1608Metric
C21 | 1u/10V |  | UGV:Capacitor_SMD__C_0603_1608Metric
C22 | 100n/16V |  | UGV:Capacitor_SMD__C_0603_1608Metric
R31 | 100k |  | UGV:Resistor_SMD__R_0603_1608Metric
R32 | 47k |  | UGV:Resistor_SMD__R_0603_1608Metric
R33 | 100k |  | UGV:Resistor_SMD__R_0603_1608Metric
R34 | 100k |  | UGV:Resistor_SMD__R_0603_1608Metric
R35 | 100k |  | UGV:Resistor_SMD__R_0603_1608Metric
C23 | 100n/16V |  | UGV:Capacitor_SMD__C_0603_1608Metric
TP1 | GND |  | UGV:TestPoint__TestPoint_Pad_D1.0mm
TP2 | +3V3 |  | UGV:TestPoint__TestPoint_Pad_D1.0mm
TP3 | VBAT |  | UGV:TestPoint__TestPoint_Pad_D1.0mm
TP4 | VMOTOR |  | UGV:TestPoint__TestPoint_Pad_D1.0mm
TP5 | SYS_RAW |  | UGV:TestPoint__TestPoint_Pad_D1.0mm
TP6 | ESP_EN |  | UGV:TestPoint__TestPoint_Pad_D1.0mm
TP7 | LED_STATUS |  | UGV:TestPoint__TestPoint_Pad_D1.0mm | GPIO43 status LED test point; UART0 TX no longer exposed. Programming remains native USB.
TP8 | DRIVE_ENABLE |  | UGV:TestPoint__TestPoint_Pad_D1.0mm
TP9 | FAULT_U2 |  | UGV:TestPoint__TestPoint_Pad_D1.0mm
TP10 | FAULT_U3 |  | UGV:TestPoint__TestPoint_Pad_D1.0mm
TP11 | REG_PG |  | UGV:TestPoint__TestPoint_Pad_D1.0mm
U7 | BQ298217RUGR | BQ298217RUGR | UGV:BQ298217_RUG0008A | 4.25V OV / 2.6V UV / 60mV OCD; exact suffix required; zero-volt charging disabled
Q7 | CSD17308Q3 | CSD17308Q3 | UGV:CSD17308Q3_TI | 30V NFET; common-drain pair; source pins1-3 gate4 drain5-9
Q8 | CSD17308Q3 | CSD17308Q3 | UGV:CSD17308Q3_TI | 30V NFET; common-drain pair; source pins1-3 gate4 drain5-9
R36 | 10m 1% 1W | WSL2512R0100FEA | UGV:Resistor_SMD__R_2512_6332Metric | Current shunt, Kelvin sense endpoints. Nominal6A OCD; do not substitute resistance.
R37 | 100R 1% |  | UGV:Resistor_SMD__R_0603_1608Metric
R38 | 20R 1% |  | UGV:Resistor_SMD__R_0603_1608Metric
R39 | 1k 1% |  | UGV:Resistor_SMD__R_0603_1608Metric
C24 | 100n/16V X7R |  | UGV:Capacitor_SMD__C_0603_1608Metric
R40 | 10M |  | UGV:Resistor_SMD__R_0603_1608Metric | Gate discharge path; <1uA loading at normal gate drive
R41 | 10M |  | UGV:Resistor_SMD__R_0603_1608Metric
J5 | CELL NTC - DRIVE | B2B-PH-K-S | UGV:Connector_JST__JST_PH_B2B-PH-K_1x02_P2.00mm_Vertical | Second electrically isolated103AT-2 probe bonded to same cell; not shared with J4
R42 | 10k 1% |  | UGV:Resistor_SMD__R_0603_1608Metric
R43 | 1k 1% |  | UGV:Resistor_SMD__R_0603_1608Metric
C25 | 100n/16V X7R |  | UGV:Capacitor_SMD__C_0603_1608Metric
TH1 | 10k NTC 1% B25/85=3435K | 103AT-2 | OFFBOARD | Cell-bonded charger probe -> J4; separate insulated two-wire harness; strain relief; never attach to PCB as temperature proxy
TH2 | 10k NTC 1% B25/85=3435K | 103AT-2 | OFFBOARD | Cell-bonded drive monitoring probe -> J5; separate insulated two-wire harness; strain relief; never attach to PCB as temperature proxy
