ncripted/DAMIEN/outputs/rover/Omni_UGV_Rev_A/PCB_chassis_fit.step

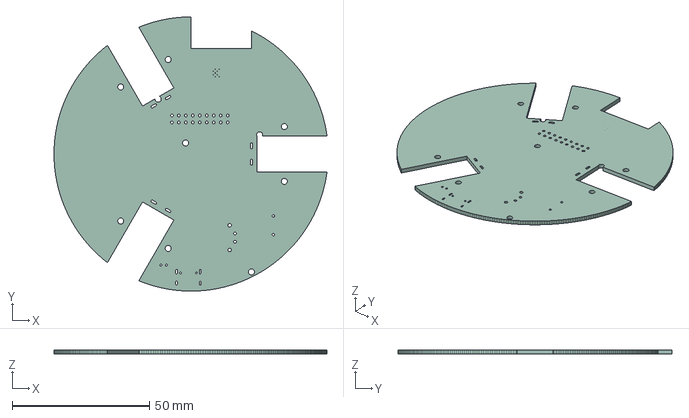
[picture p84: CAD file, 2026-11-09]
outputs/rover/Omni_UGV_Rev_A/PCB_chassis_fit.step
99.6 x 100.0 x 1.51 mm
