ncripted/DAMIEN/(list of files, cad)

Other CAD files:
outputs/rover/Omni_UGV_Rev_C_flex_camera/mechanics/Rev_C_board_only.step
outputs/rover/Omni_UGV_Rev_C_flex_camera_review/Omni_UGV_Rev_C_flex_camera/mechanics/Rev_C_board_only.step
outputs/rover/Omni_UGV_Rev_D_power_audit/mechanics/history/Rev_C_board_only.step
outputs/rover/Omni_UGV_Rev_D_power_audit/mechanics/Rev_D_board_only.step
outputs/rover/Omni_UGV_Rev_E_power_layout/mechanics/history/Rev_C_board_only.step
outputs/rover/Omni_UGV_Rev_E_power_layout/mechanics/history/Rev_D/Rev_D_board_only.step
outputs/rover/Omni_UGV_Rev_E_power_layout/mechanics/Rev_E_Bare_PCB.step
outputs/rover/Omni_UGV_Rev_B_protection/mechanics/provisional_supports.scad
outputs/rover/Omni_UGV_Rev_C_flex_camera/mechanics/provisional_supports.scad
outputs/rover/Omni_UGV_Rev_D_power_audit/mechanics/provisional_supports.scad
outputs/rover/Omni_UGV_Rev_E_power_layout/mechanics/provisional_supports.scad
outputs/rover/Omni_UGV_Rev_C_flex_camera_review/Omni_UGV_Rev_C_flex_camera/mechanics/provisional_supports.scad
