ncripted/DAMIEN/outputs/rover/Omni_UGV_Rev_F_power_rebuild/START_HERE.md

# Rev F power routing rebuild checkpoint

Open omni_ugv.kicad_pro. Fabrication remains on hold.

Cleared copper on nine selected eFuse control and battery protection nets. Seven of those nets had existing copper, totaling 221 removed route objects. Rebuilt both battery-protector FET gate connections and two BATT_F links. The BATT_F branch at U7 and the current-sense link remain open. The eFuse power-pad escapes were retained. A trial of nearby control component placement found no clear short connection in the tested positions.

KiCad reports 19 open connections, 7 dangling-track warnings, zero other board-rule errors, and zero schematic parity issues. The previous left-side candidate is retained separately. See drc.json for remaining endpoints. The next placement must reserve side exits for the eFuse controls and space for the protector sense and bypass routes before routing the rest of the power copper.
