ncripted/DAMIEN/outputs/rover/Omni_UGV_Rev_D_power_audit/engineering/STEP_1_REVIEW.md

# Current power audit

See POWER_AUDIT.md, POWER_CALCULATIONS.json and validation/current. The earlier schematic-organization step report is preserved at history/Rev_C/STEP_1_REVIEW.md. Current design-side changes are implemented; fabrication remains blocked by UNRESOLVED.md.
