ncripted/DAMIEN/work/protection/route-failure.png

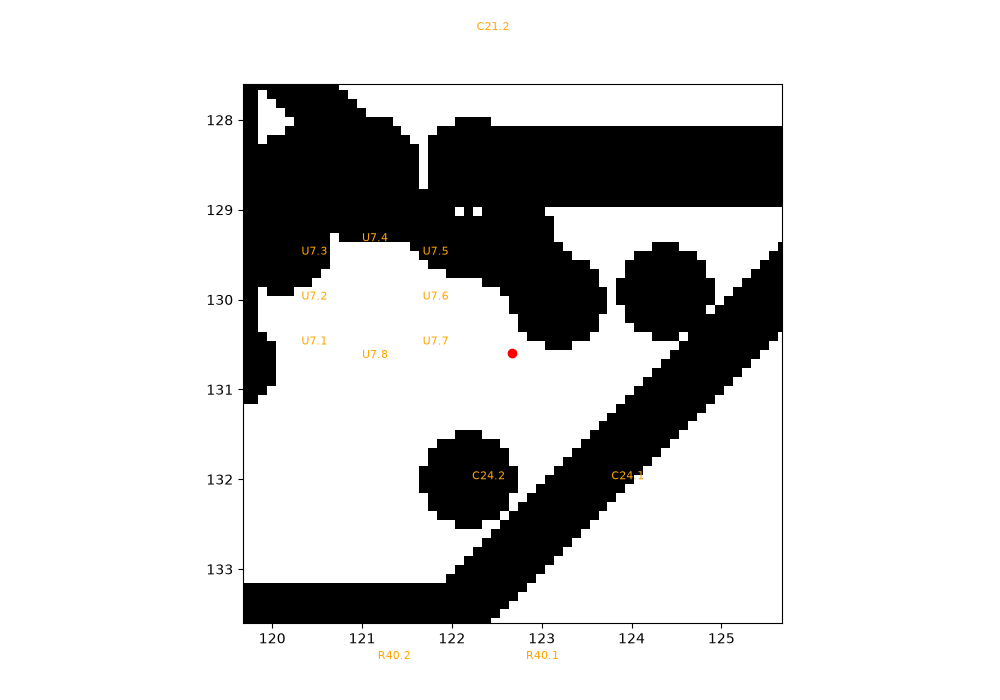
work/protection/route-failure.png
