ncripted/DAMIEN/work/humanize/label_test.pdf

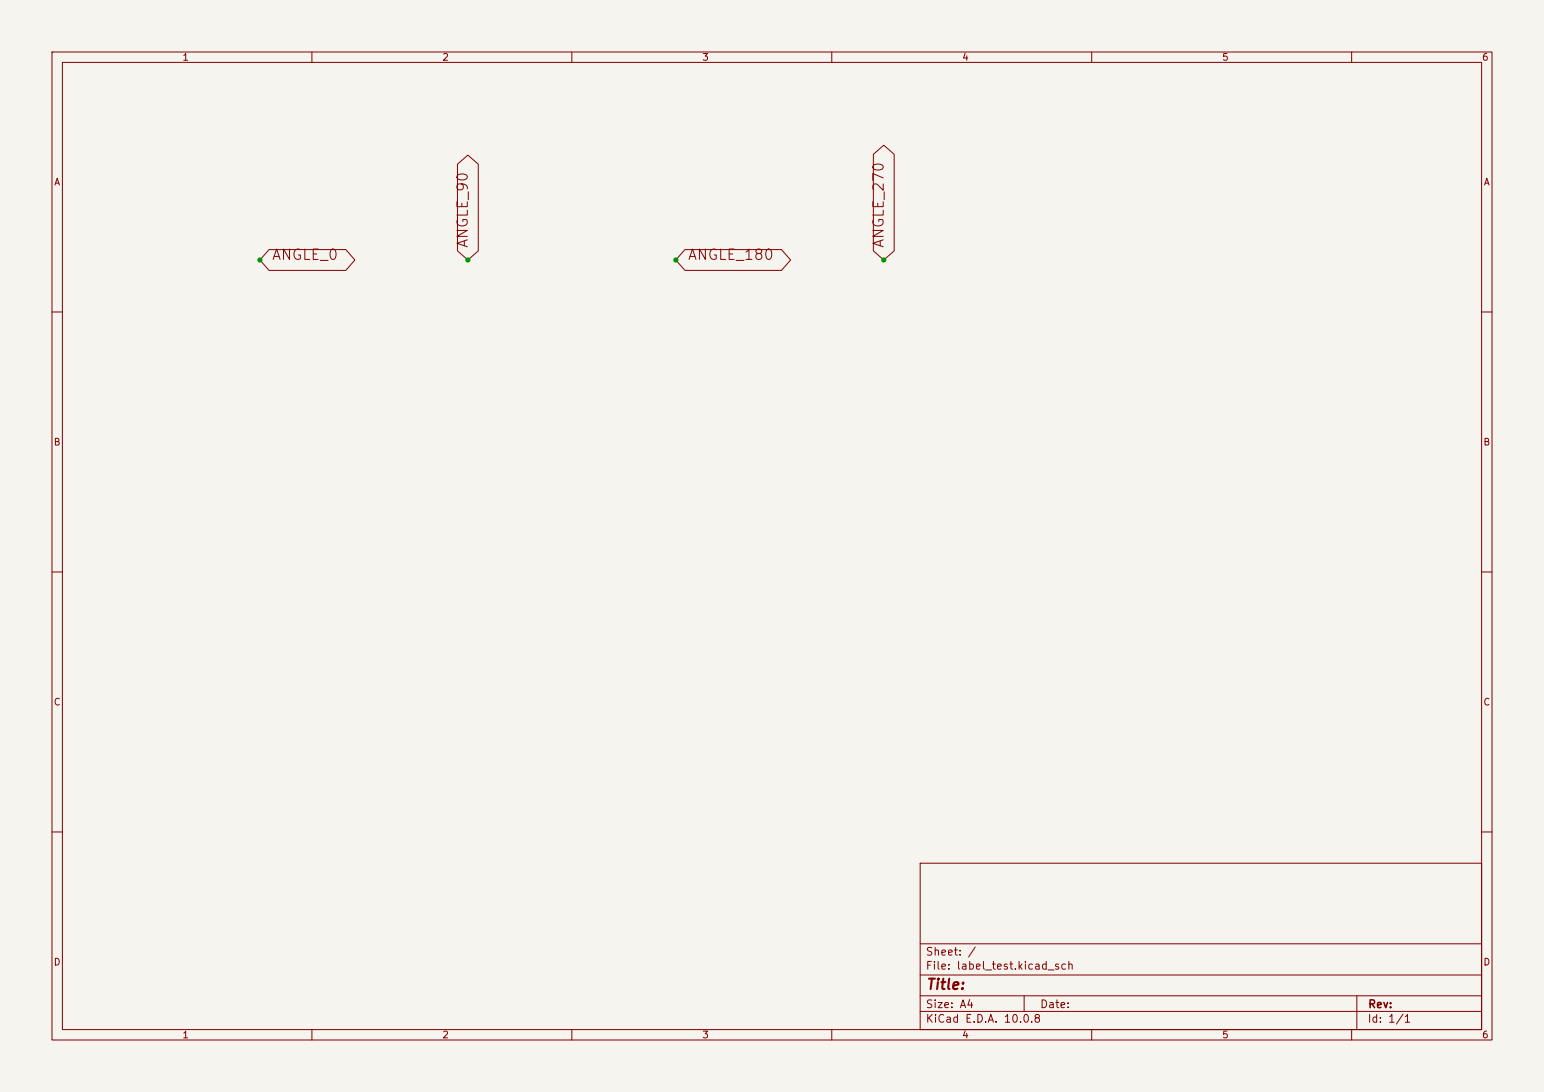
[picture p86: page 1]

Size: A4 | Rev:
KiCad E.D.A. 10.0.8 | Id: 1/1
