ncripted/DAMIEN/work/protection/schematic.pdf

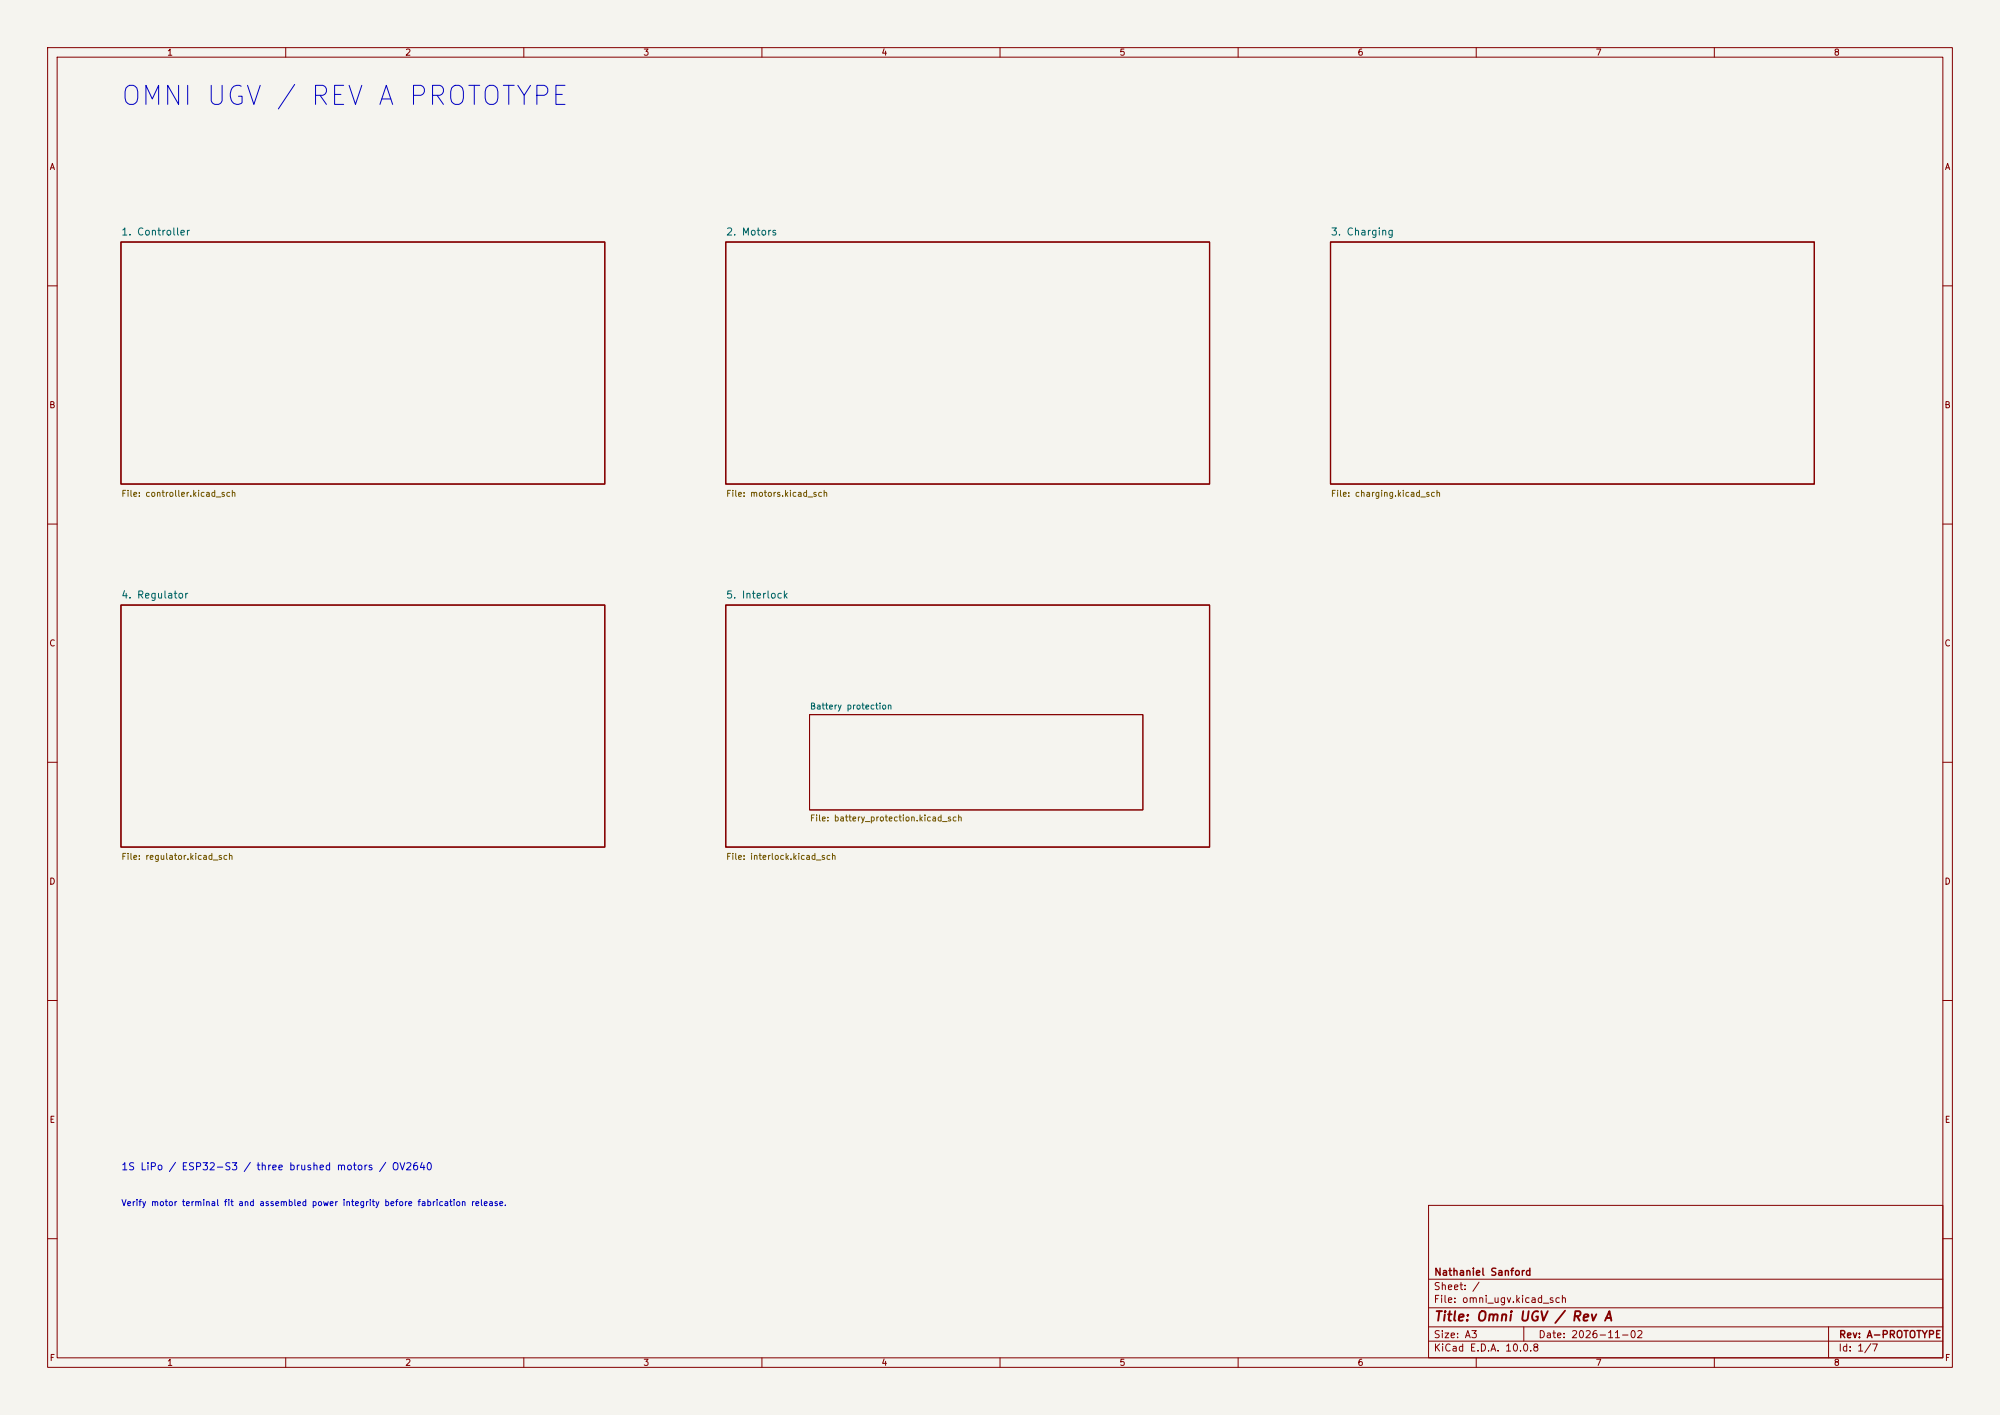
[picture p87: page 1]

Verify motor terminal fit and assembled power integrity before fabrication release. OMNI UGV / REV A PROTOTYPE

File: interlock.kicad_sch Battery protection

1S LiPo / ESP32-S3 / three brushed motors / OV2640

Nathaniel Sanford
Sheet: /
File: omni_ugv.kicad_sch
Title: Omni UGV / Rev A

Size: A3 | Rev: A-PROTOTYPE | F Date: 2026-11-02
KiCad E.D.A. 10.0.8 | Id: 1/7

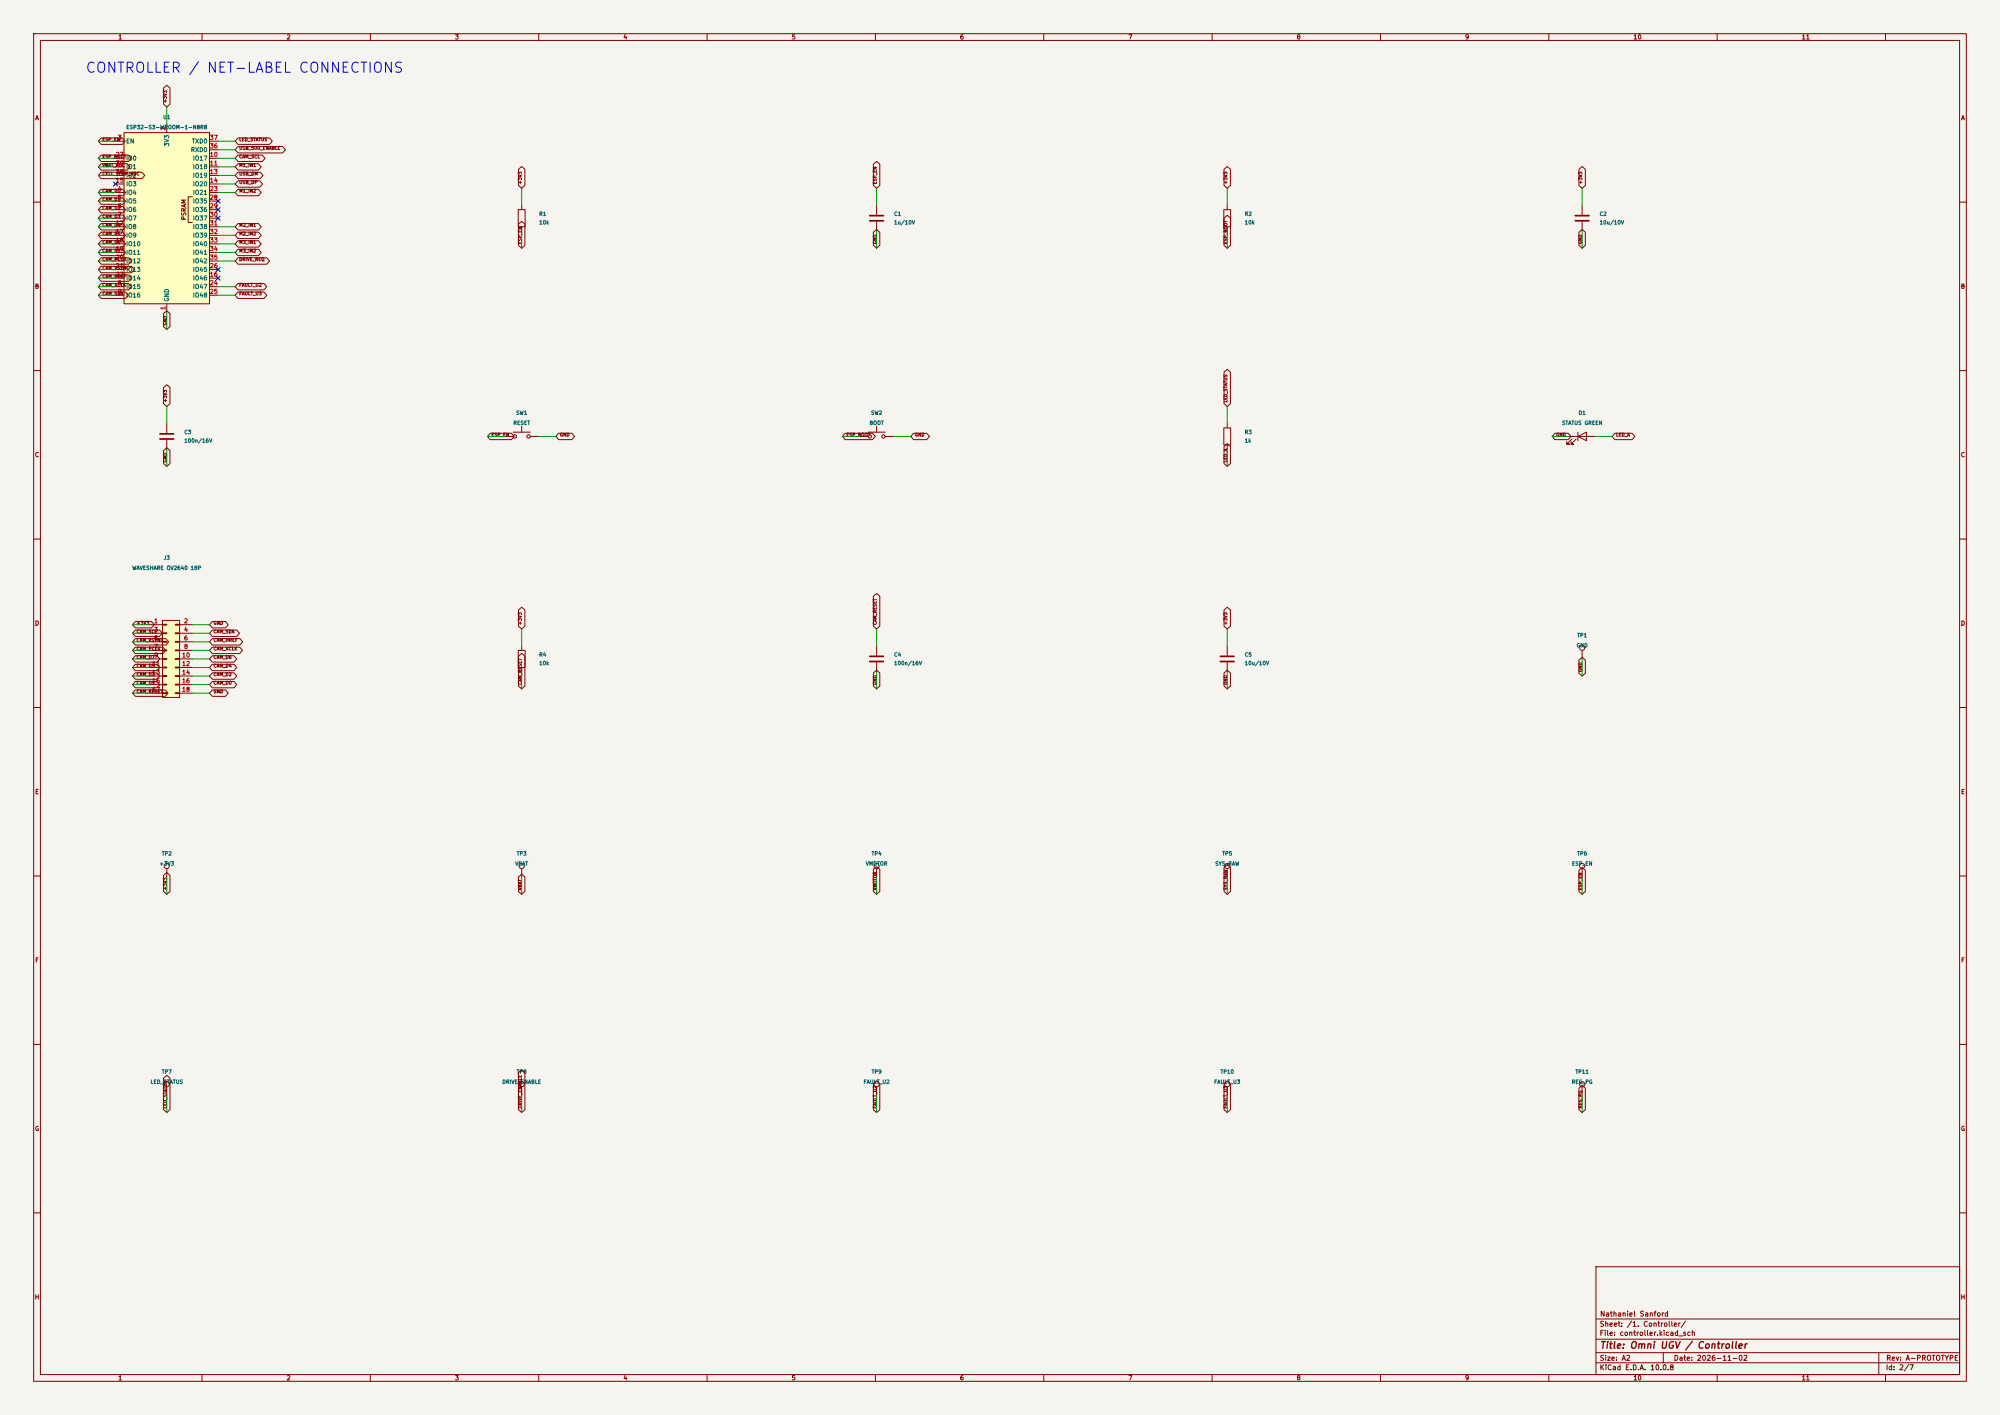
[picture p88: page 2]

CAM_SDA CAM_HREF CAM_PCLK +3V3 CONTROLLER / NET-LABEL CONNECTIONS

Nathaniel Sanford
Sheet: /1. Controller/
File: controller.kicad_sch
Title: Omni UGV / Controller

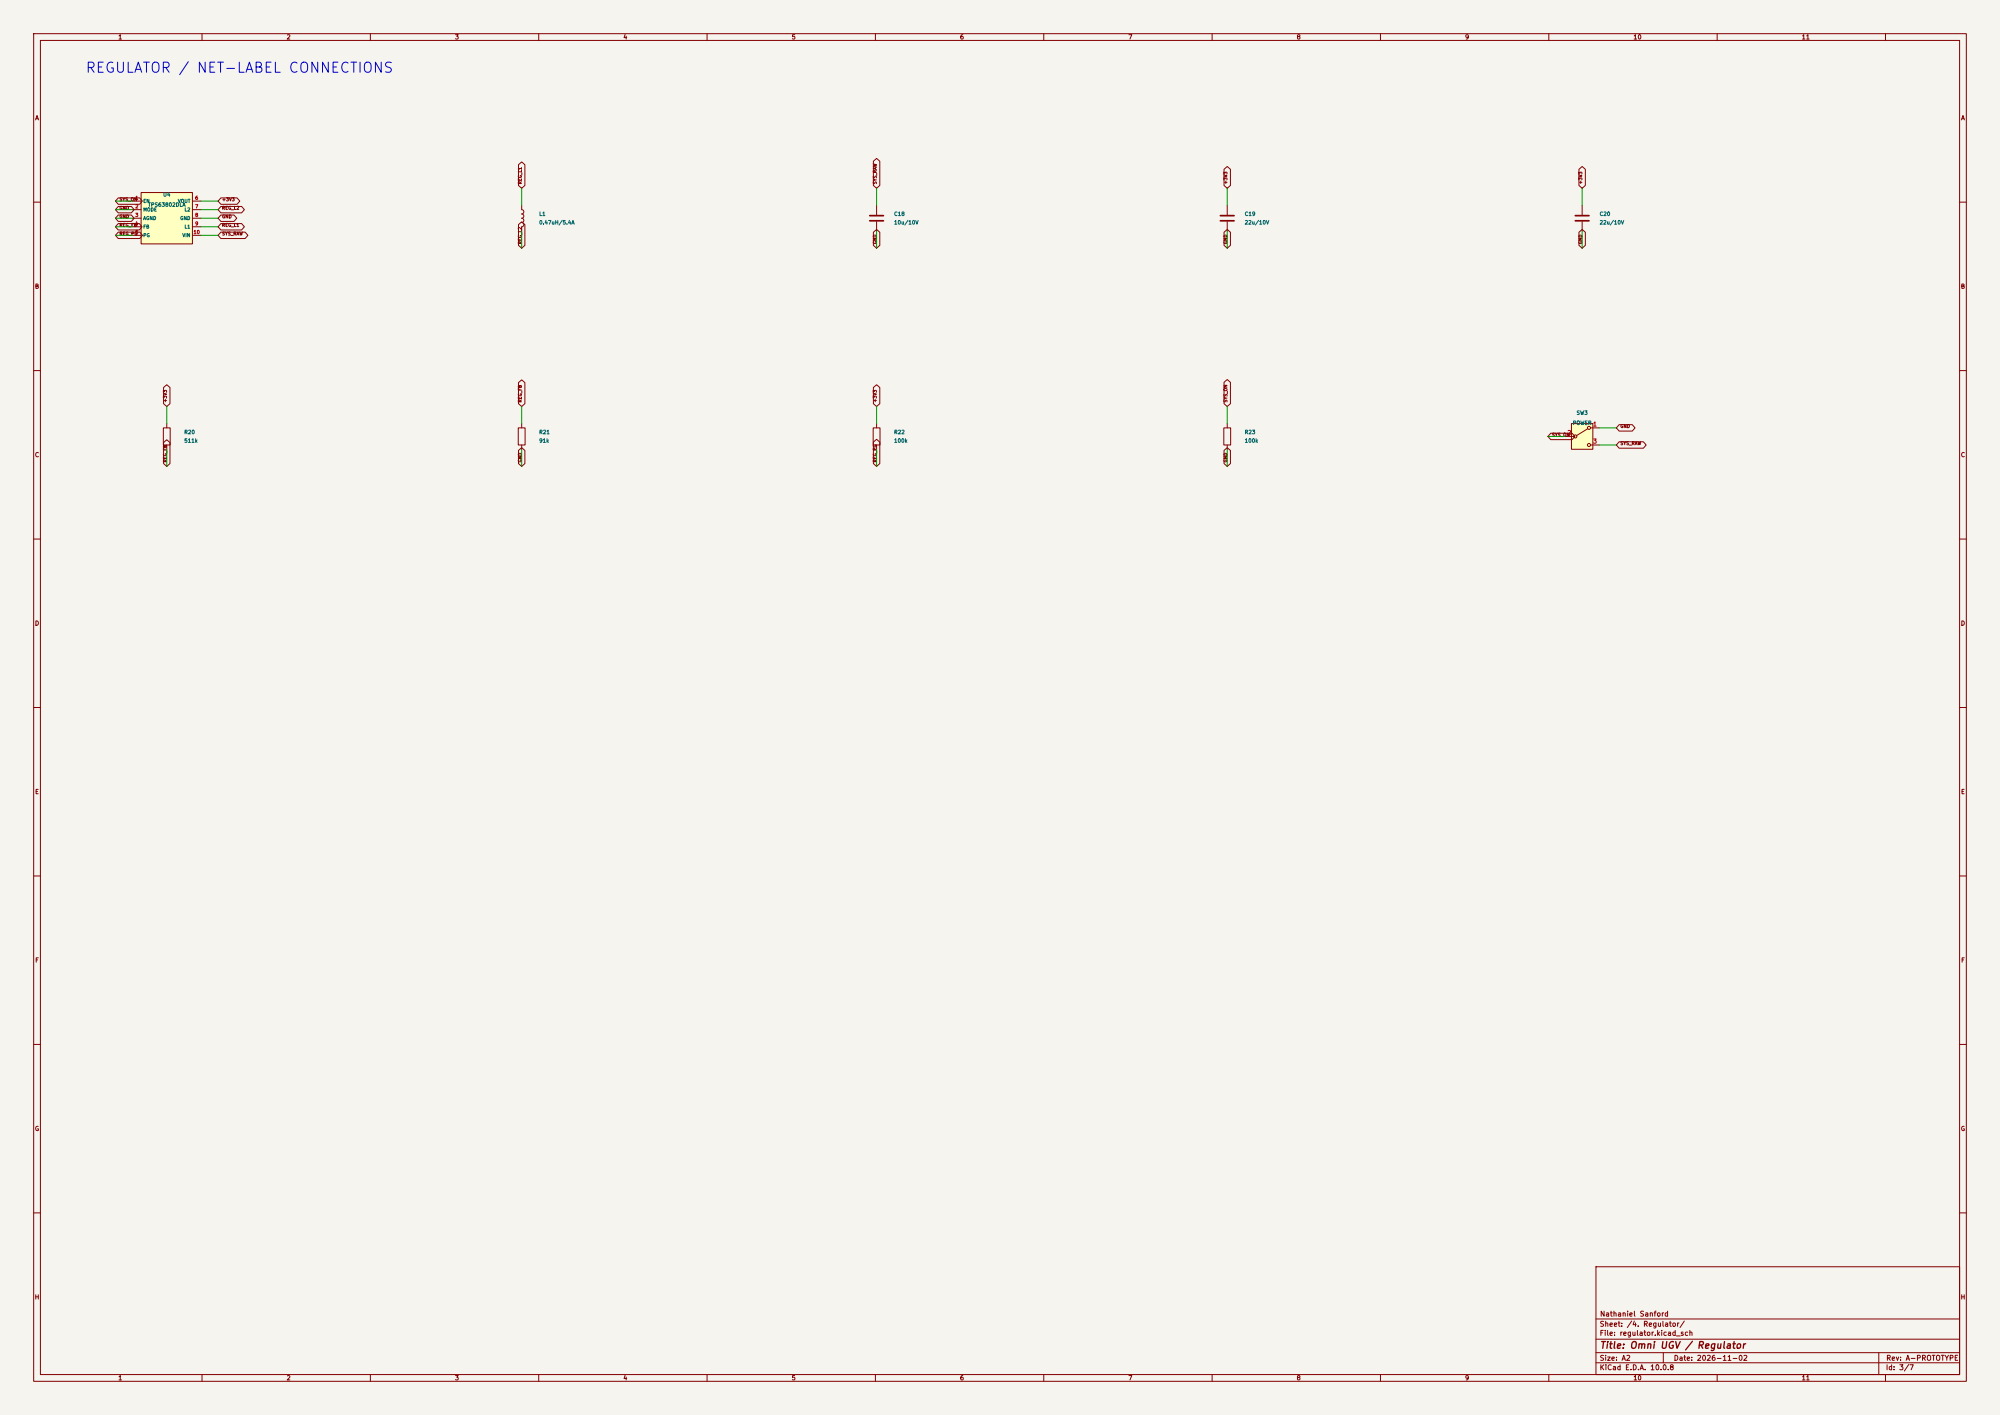
[picture p89: page 3]

REGULATOR / NET-LABEL CONNECTIONS

Sheet: /4. Regulator/
File: regulator.kicad_sch
Title: Omni UGV / Regulator

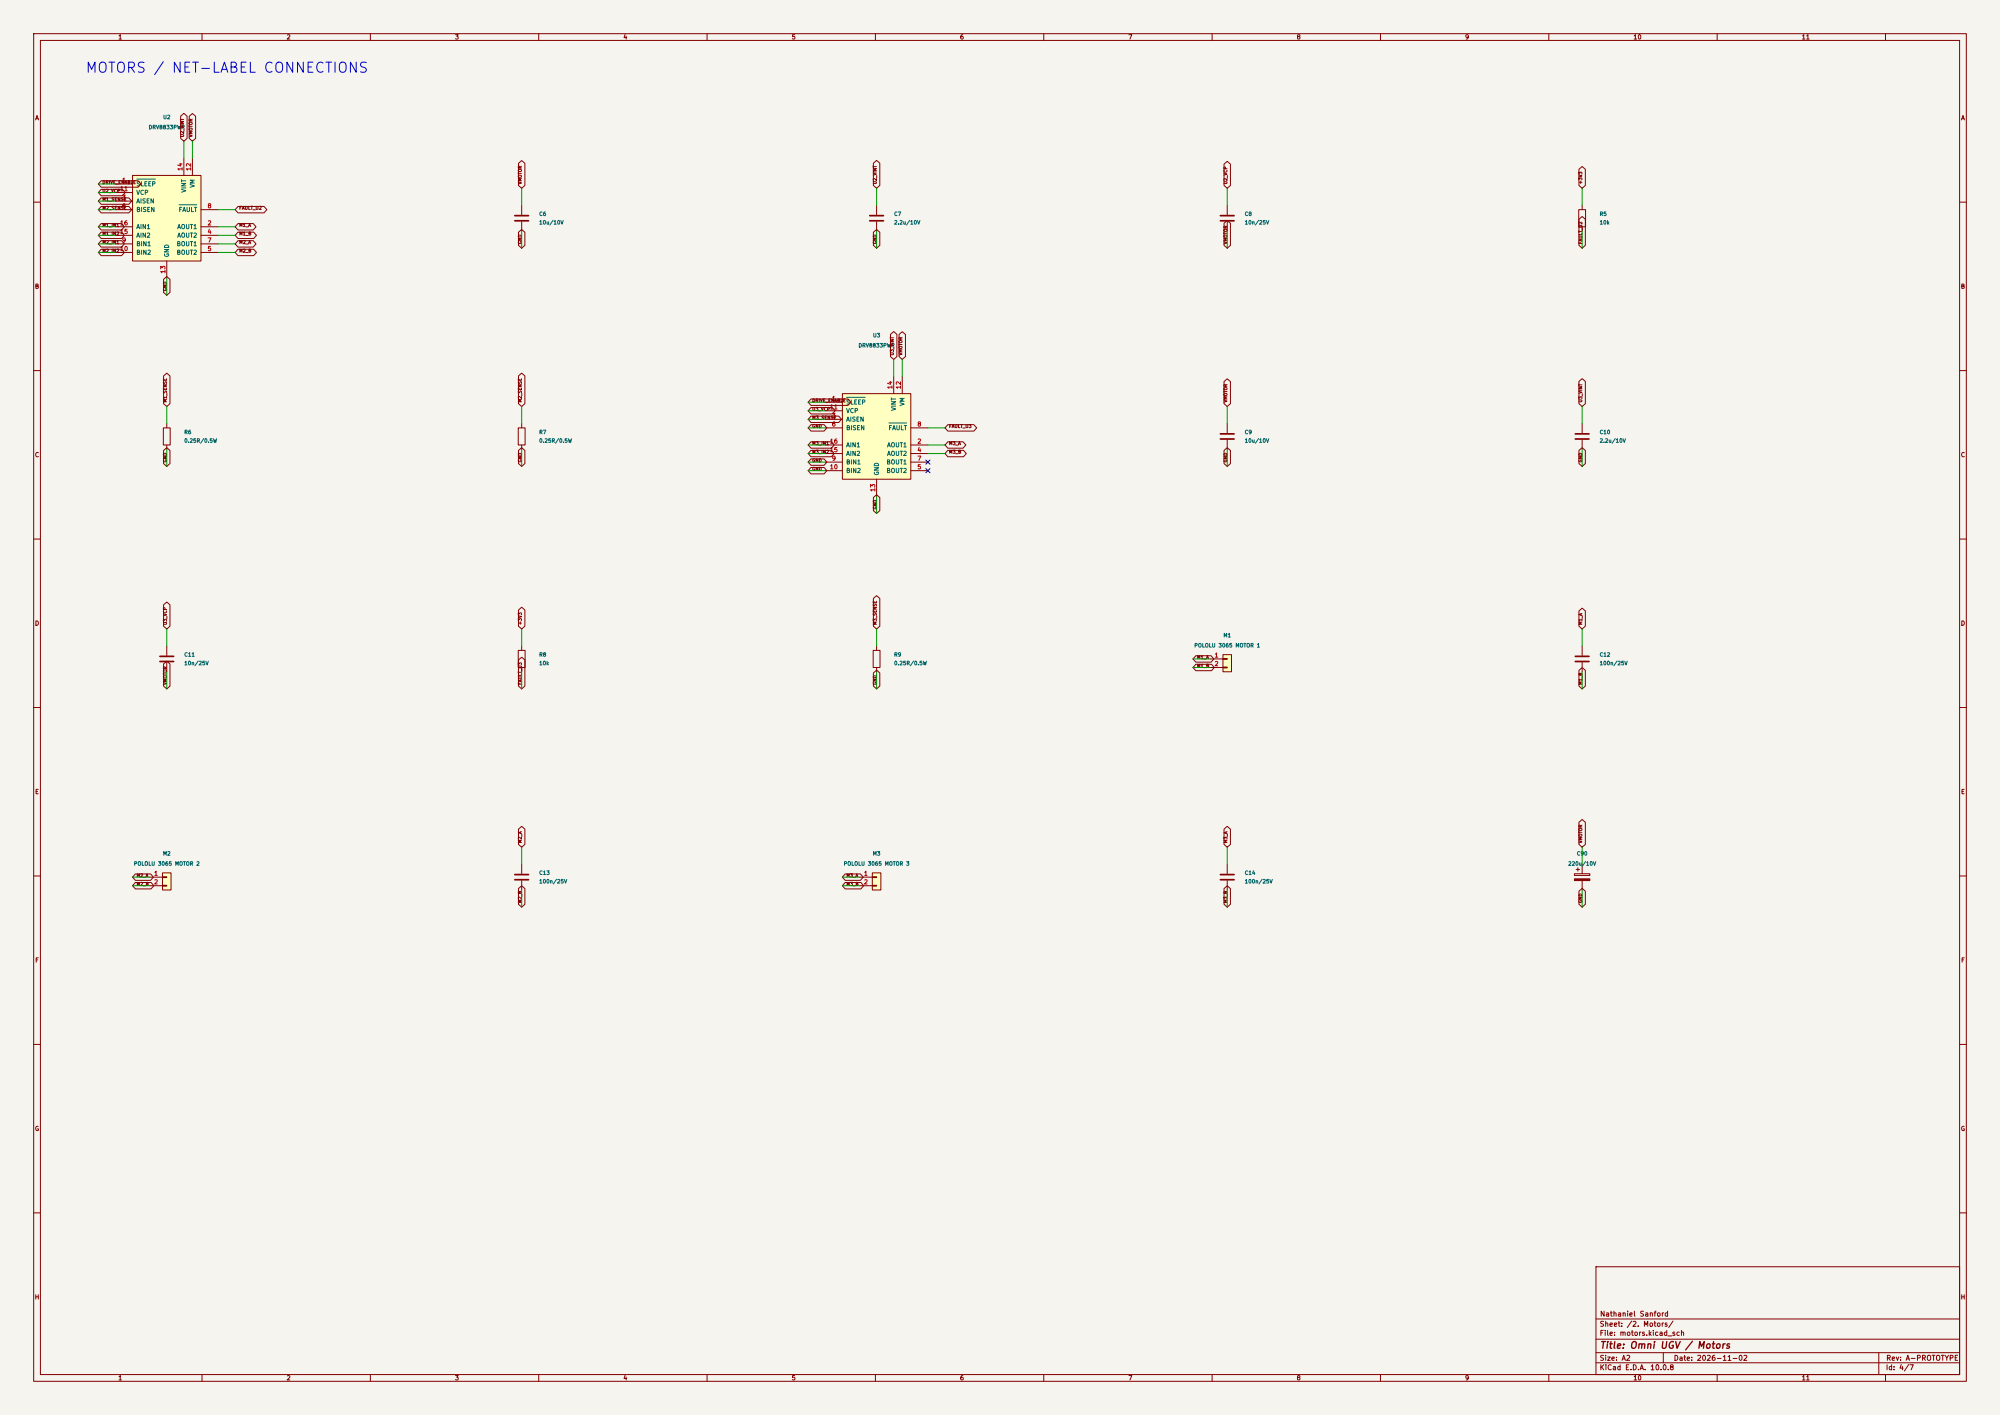
[picture p90: page 4]

MOTORS / NET-LABEL CONNECTIONS

Sheet: /2. Motors/
File: motors.kicad_sch
Title: Omni UGV / Motors

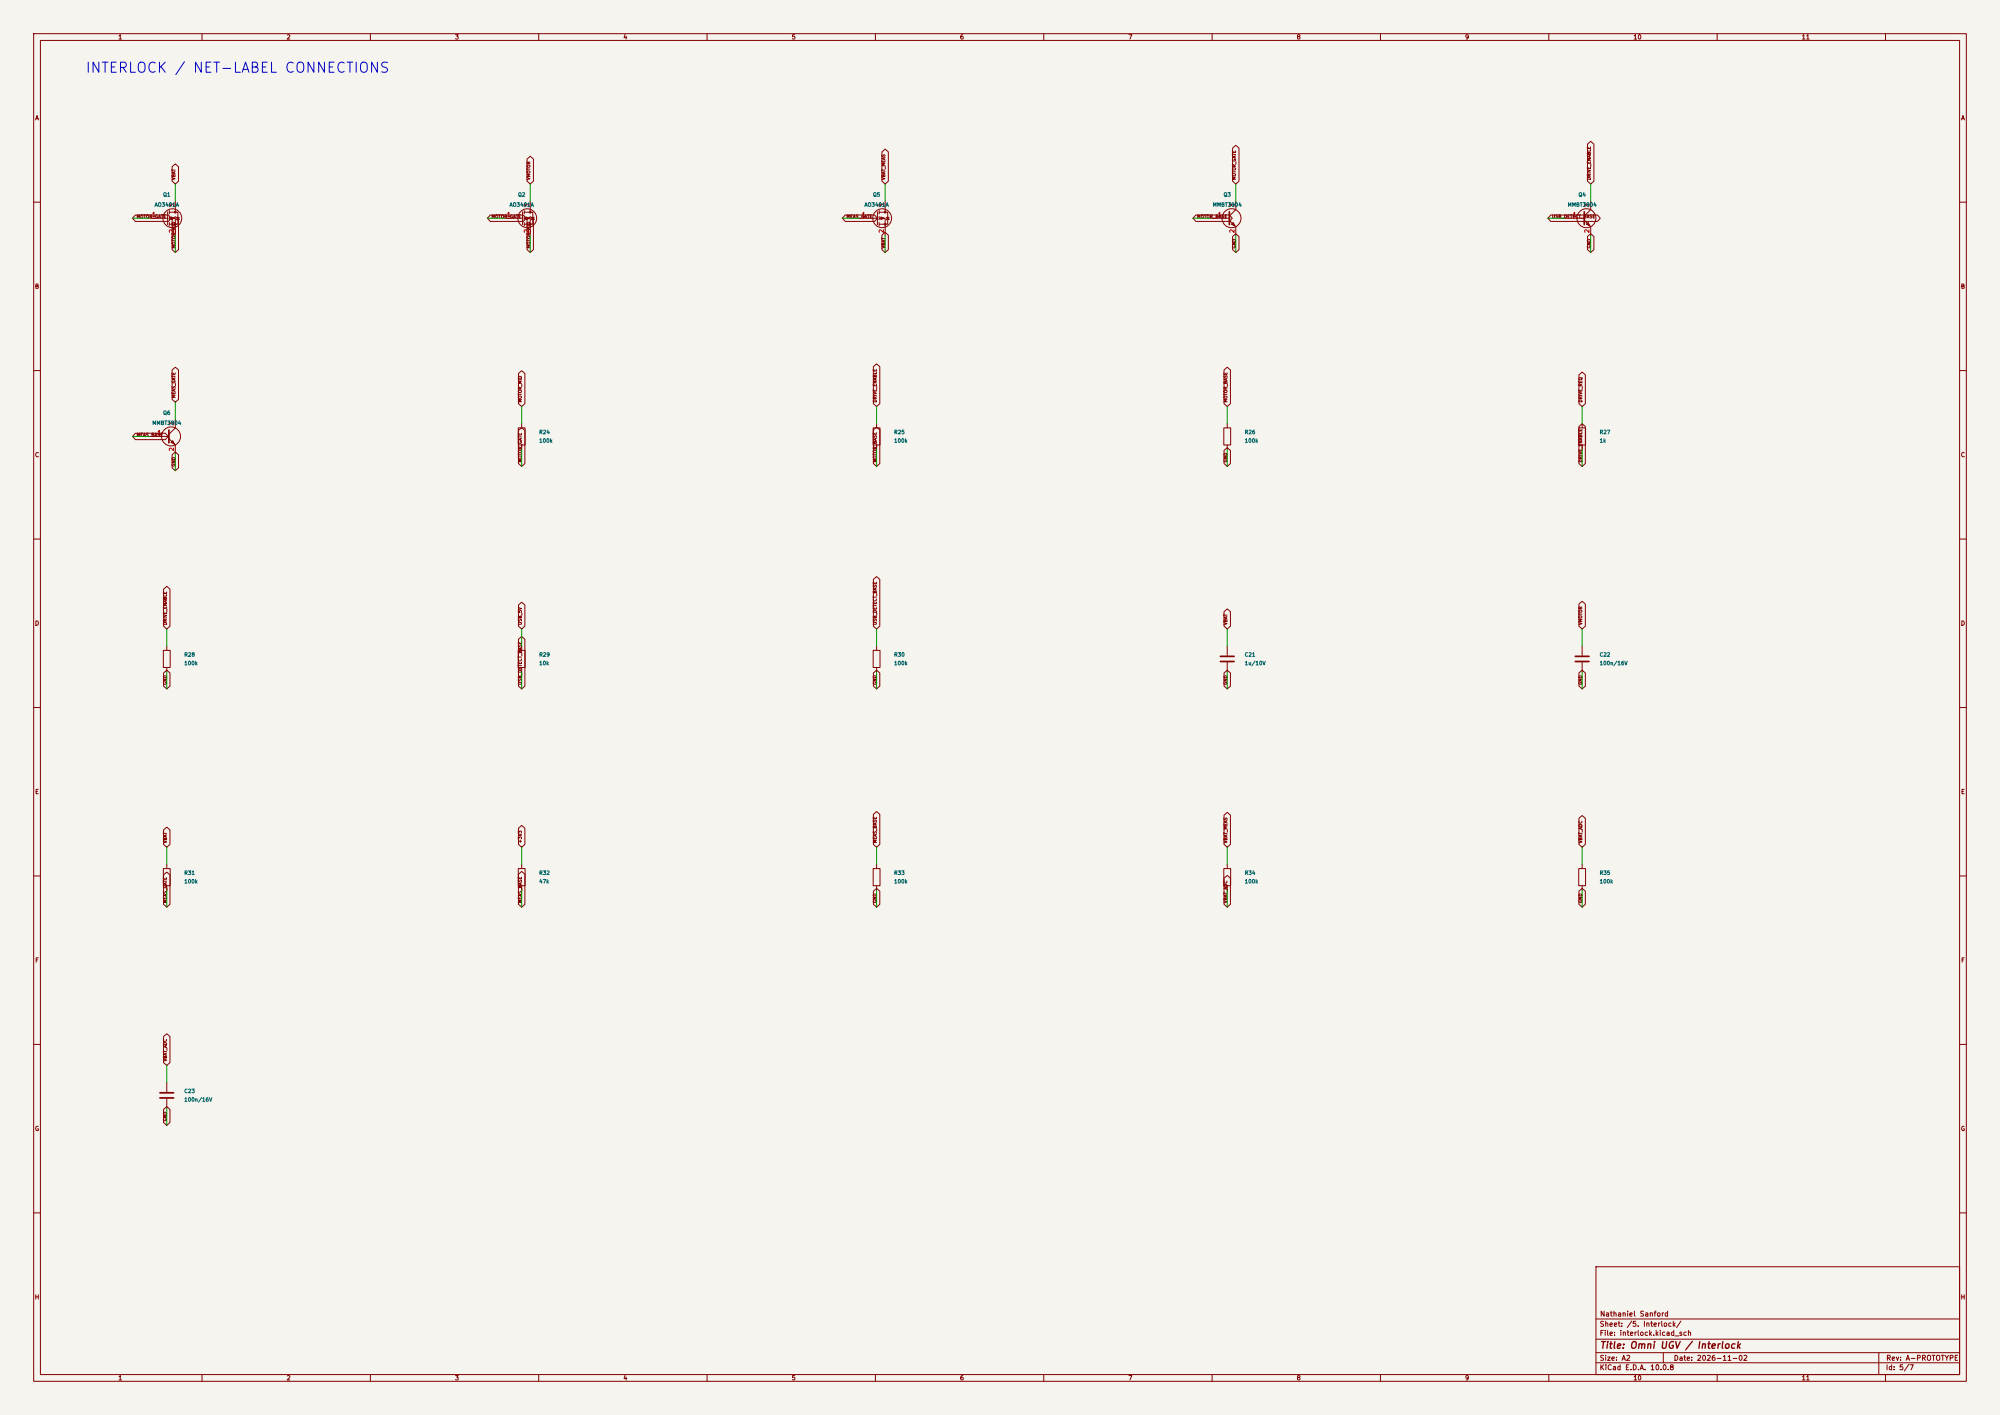
[picture p91: page 5]

INTERLOCK / NET-LABEL CONNECTIONS

Sheet: /5. Interlock/
File: interlock.kicad_sch
Title: Omni UGV / Interlock

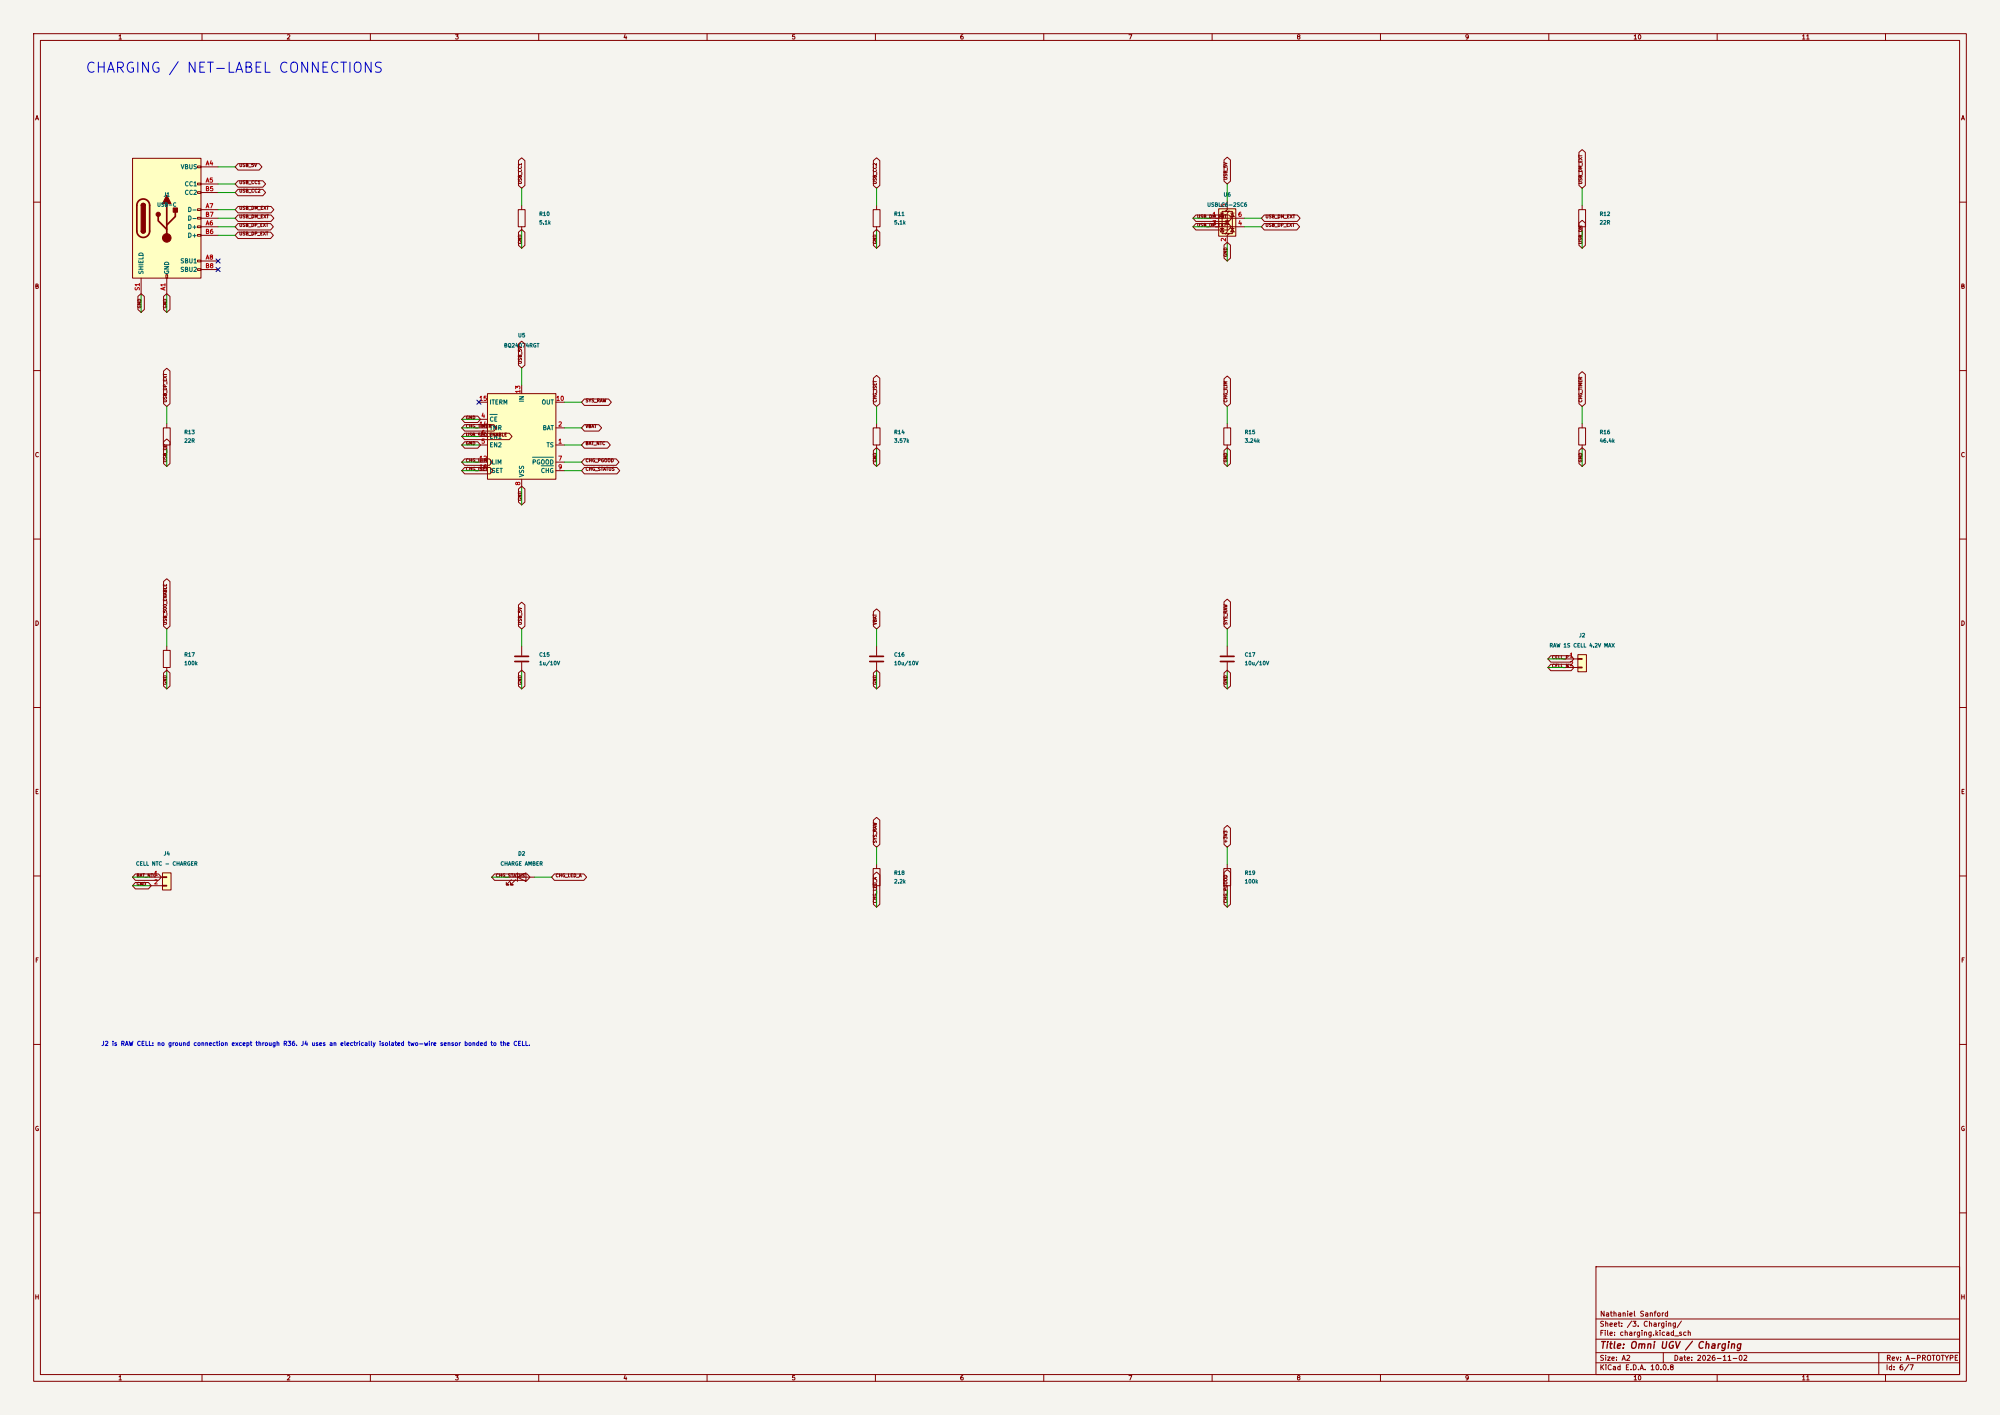
[picture p92: page 6]

CHARGING / NET-LABEL CONNECTIONS

J2 is RAW CELL: no ground connection except through R36. J4 uses an electrically isolated two-wire sensor bonded to the CELL.

Sheet: /3. Charging/
File: charging.kicad_sch
Title: Omni UGV / Charging

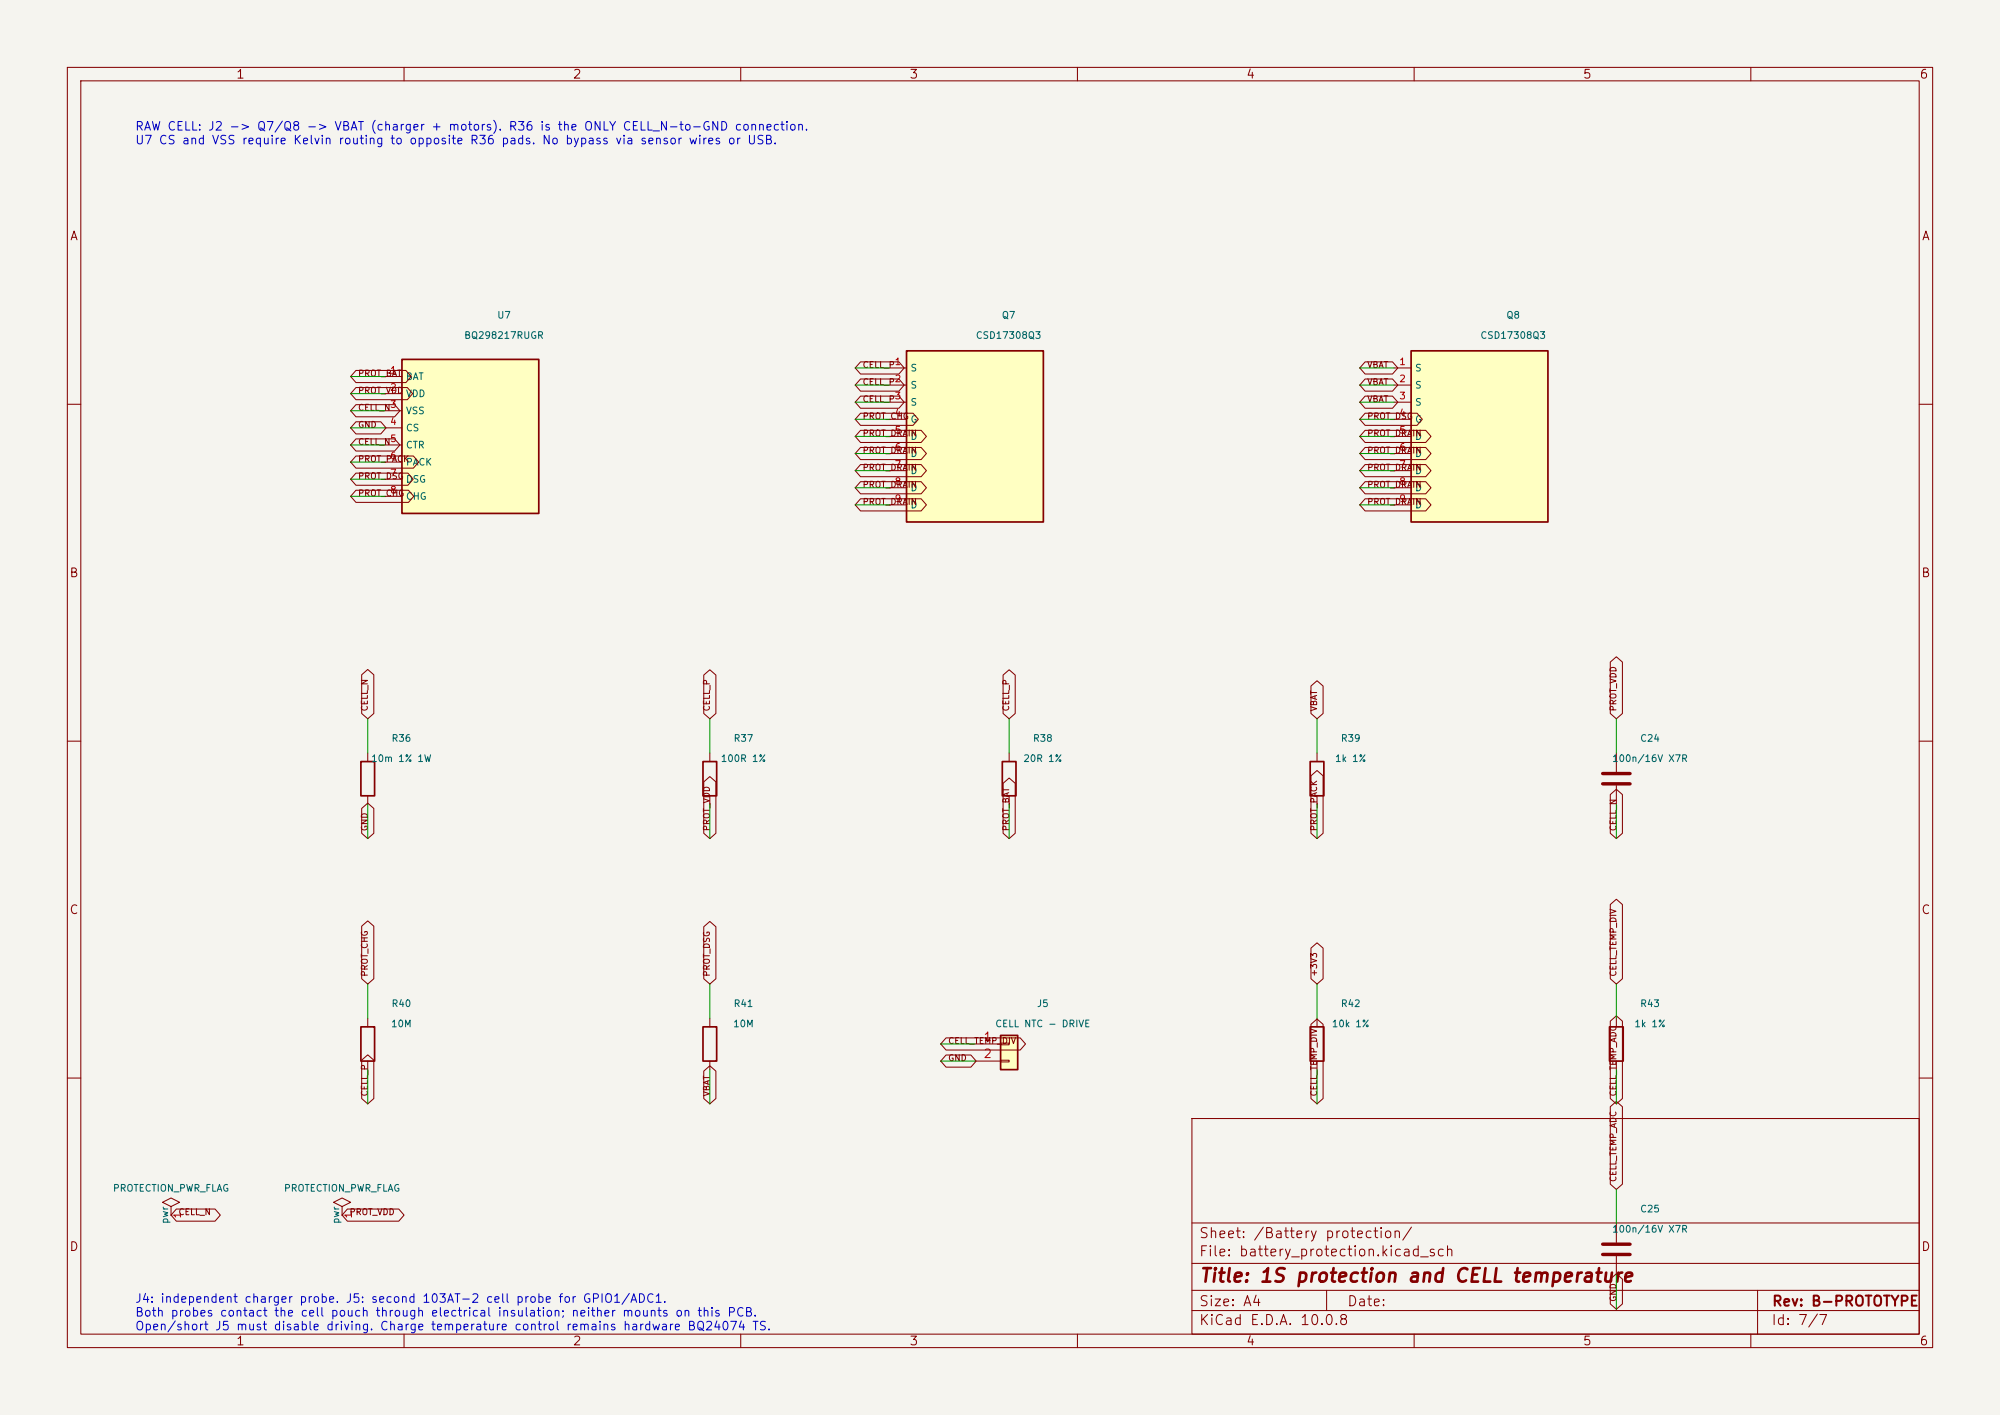
[picture p93: page 7]

RAW CELL: J2 -> Q7/Q8 -> VBAT (charger + motors). R36 is the ONLY CELL_N-to-GND connection. U7 CS and VSS require Kelvin routing to opposite R36 pads. No bypass via sensor wires or USB.

Title: 1S protection and CELL temperature

J4: independent charger probe. J5: second 103AT-2 cell probe for GPIO1/ADC1. Both probes contact the cell pouch through electrical insulation; neither mounts on this PCB. Open/short J5 must disable driving. Charge temperature control remains hardware BQ24074 TS.

Size: A4 | Rev: B-PROTOTYPE
