ncripted/DAMIEN/work/rev-e/check-schematic.pdf

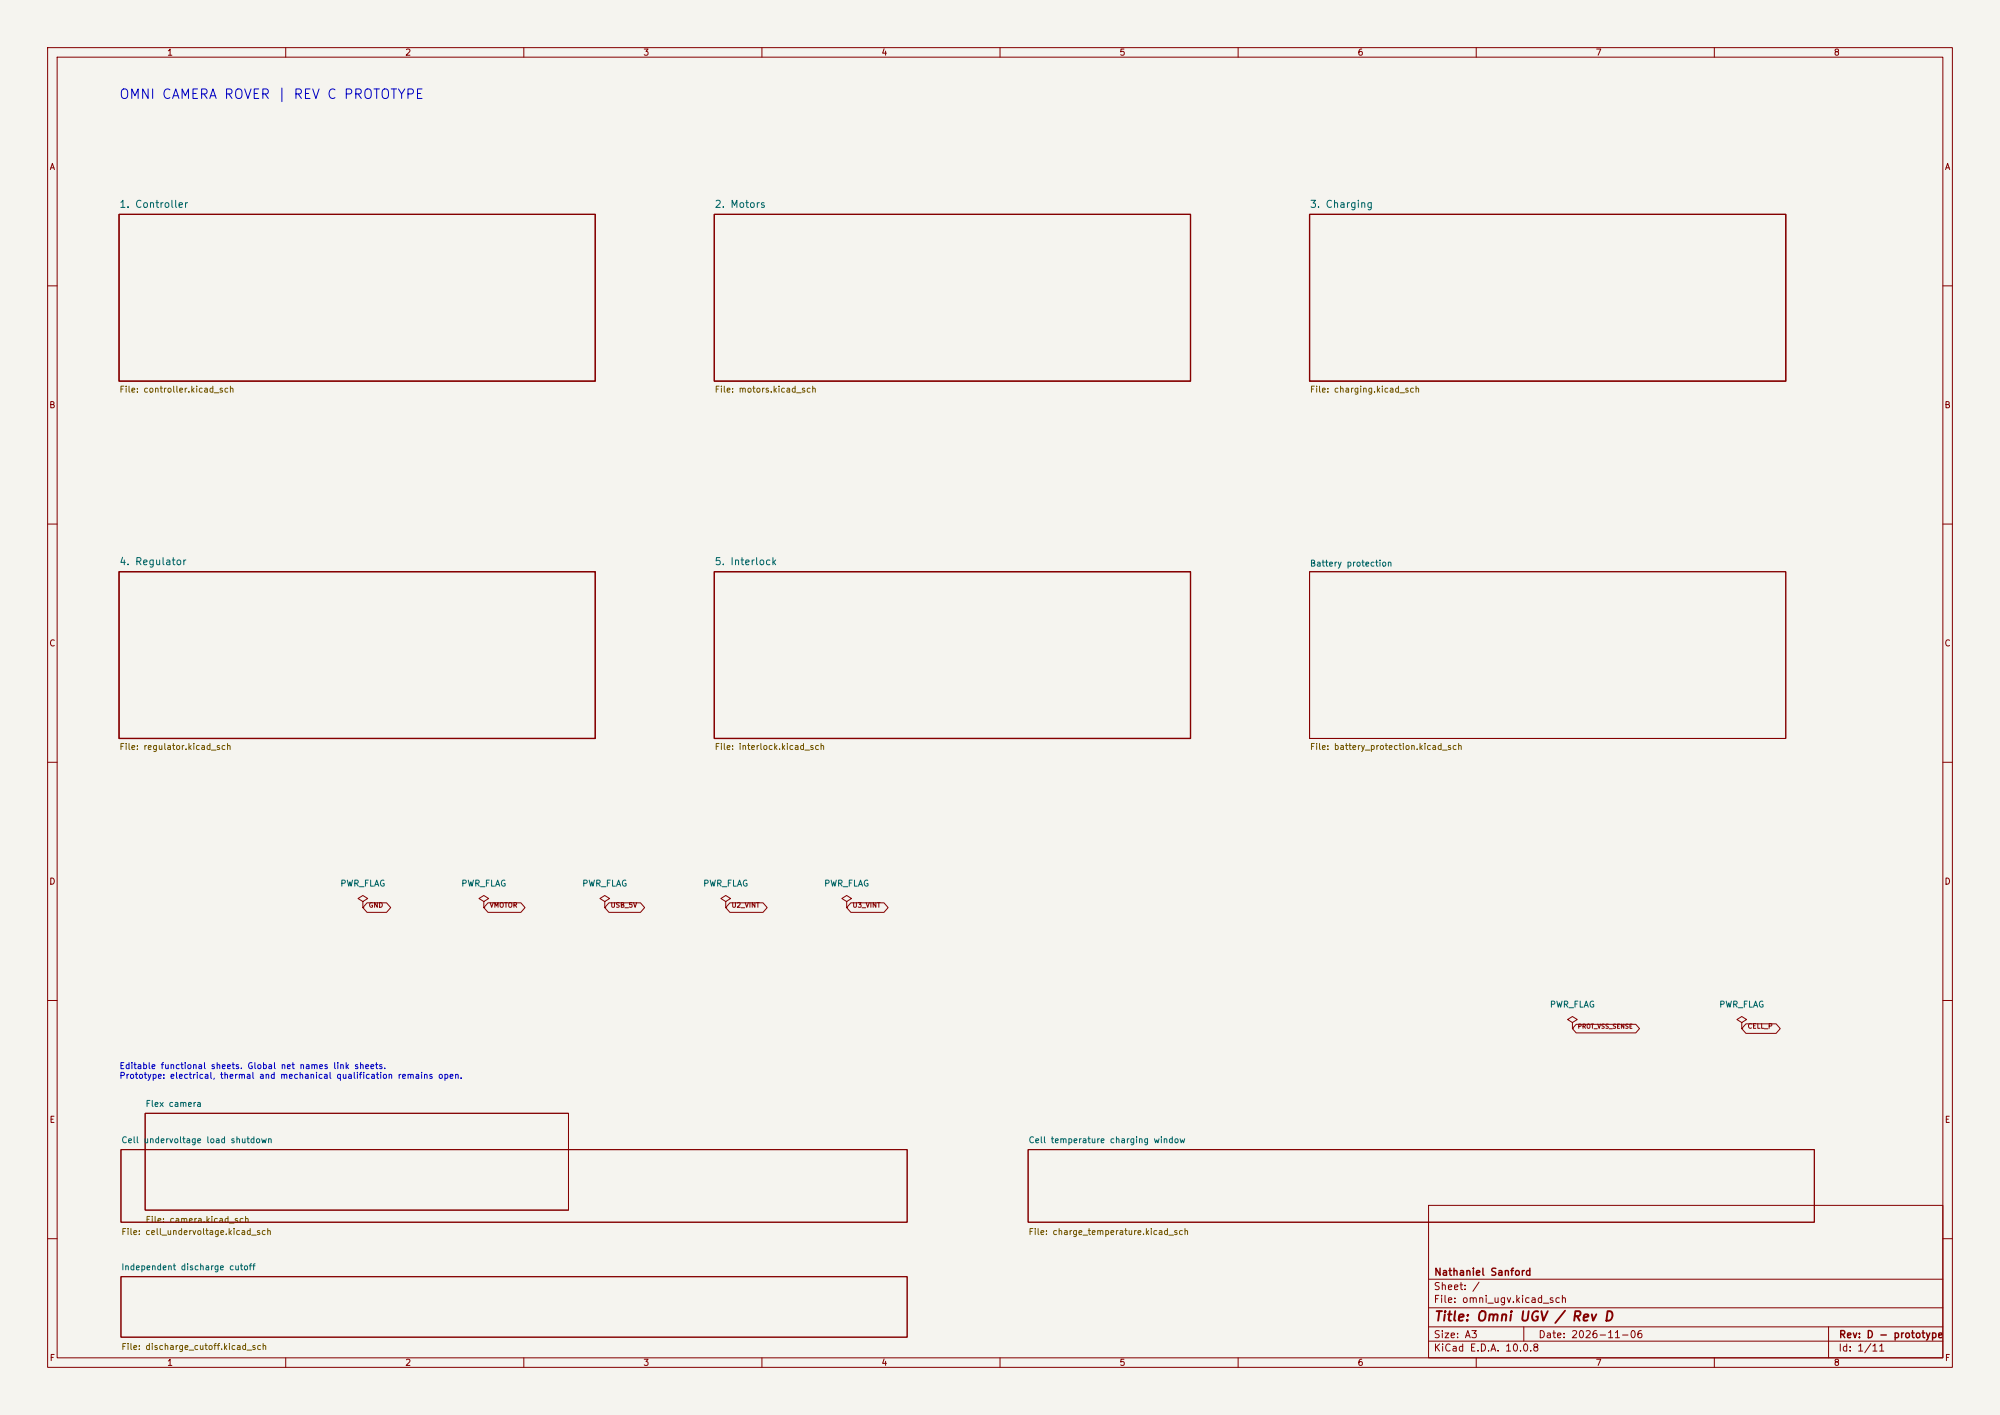
[picture p94: page 1]

OMNI CAMERA ROVER | REV C PROTOTYPE

File: battery_protection.kicad_sch Cell temperature charging window

Editable functional sheets. Global net names link sheets. Prototype: electrical, thermal and mechanical qualification remains open.

Independent discharge cutoff File: discharge_cutoff.kicad_sch

Nathaniel Sanford
Sheet: /
File: omni_ugv.kicad_sch
Title: Omni UGV / Rev D

Size: A3 | Rev: D - prototype | F Date: 2026-11-06
KiCad E.D.A. 10.0.8 | Id: 1/11

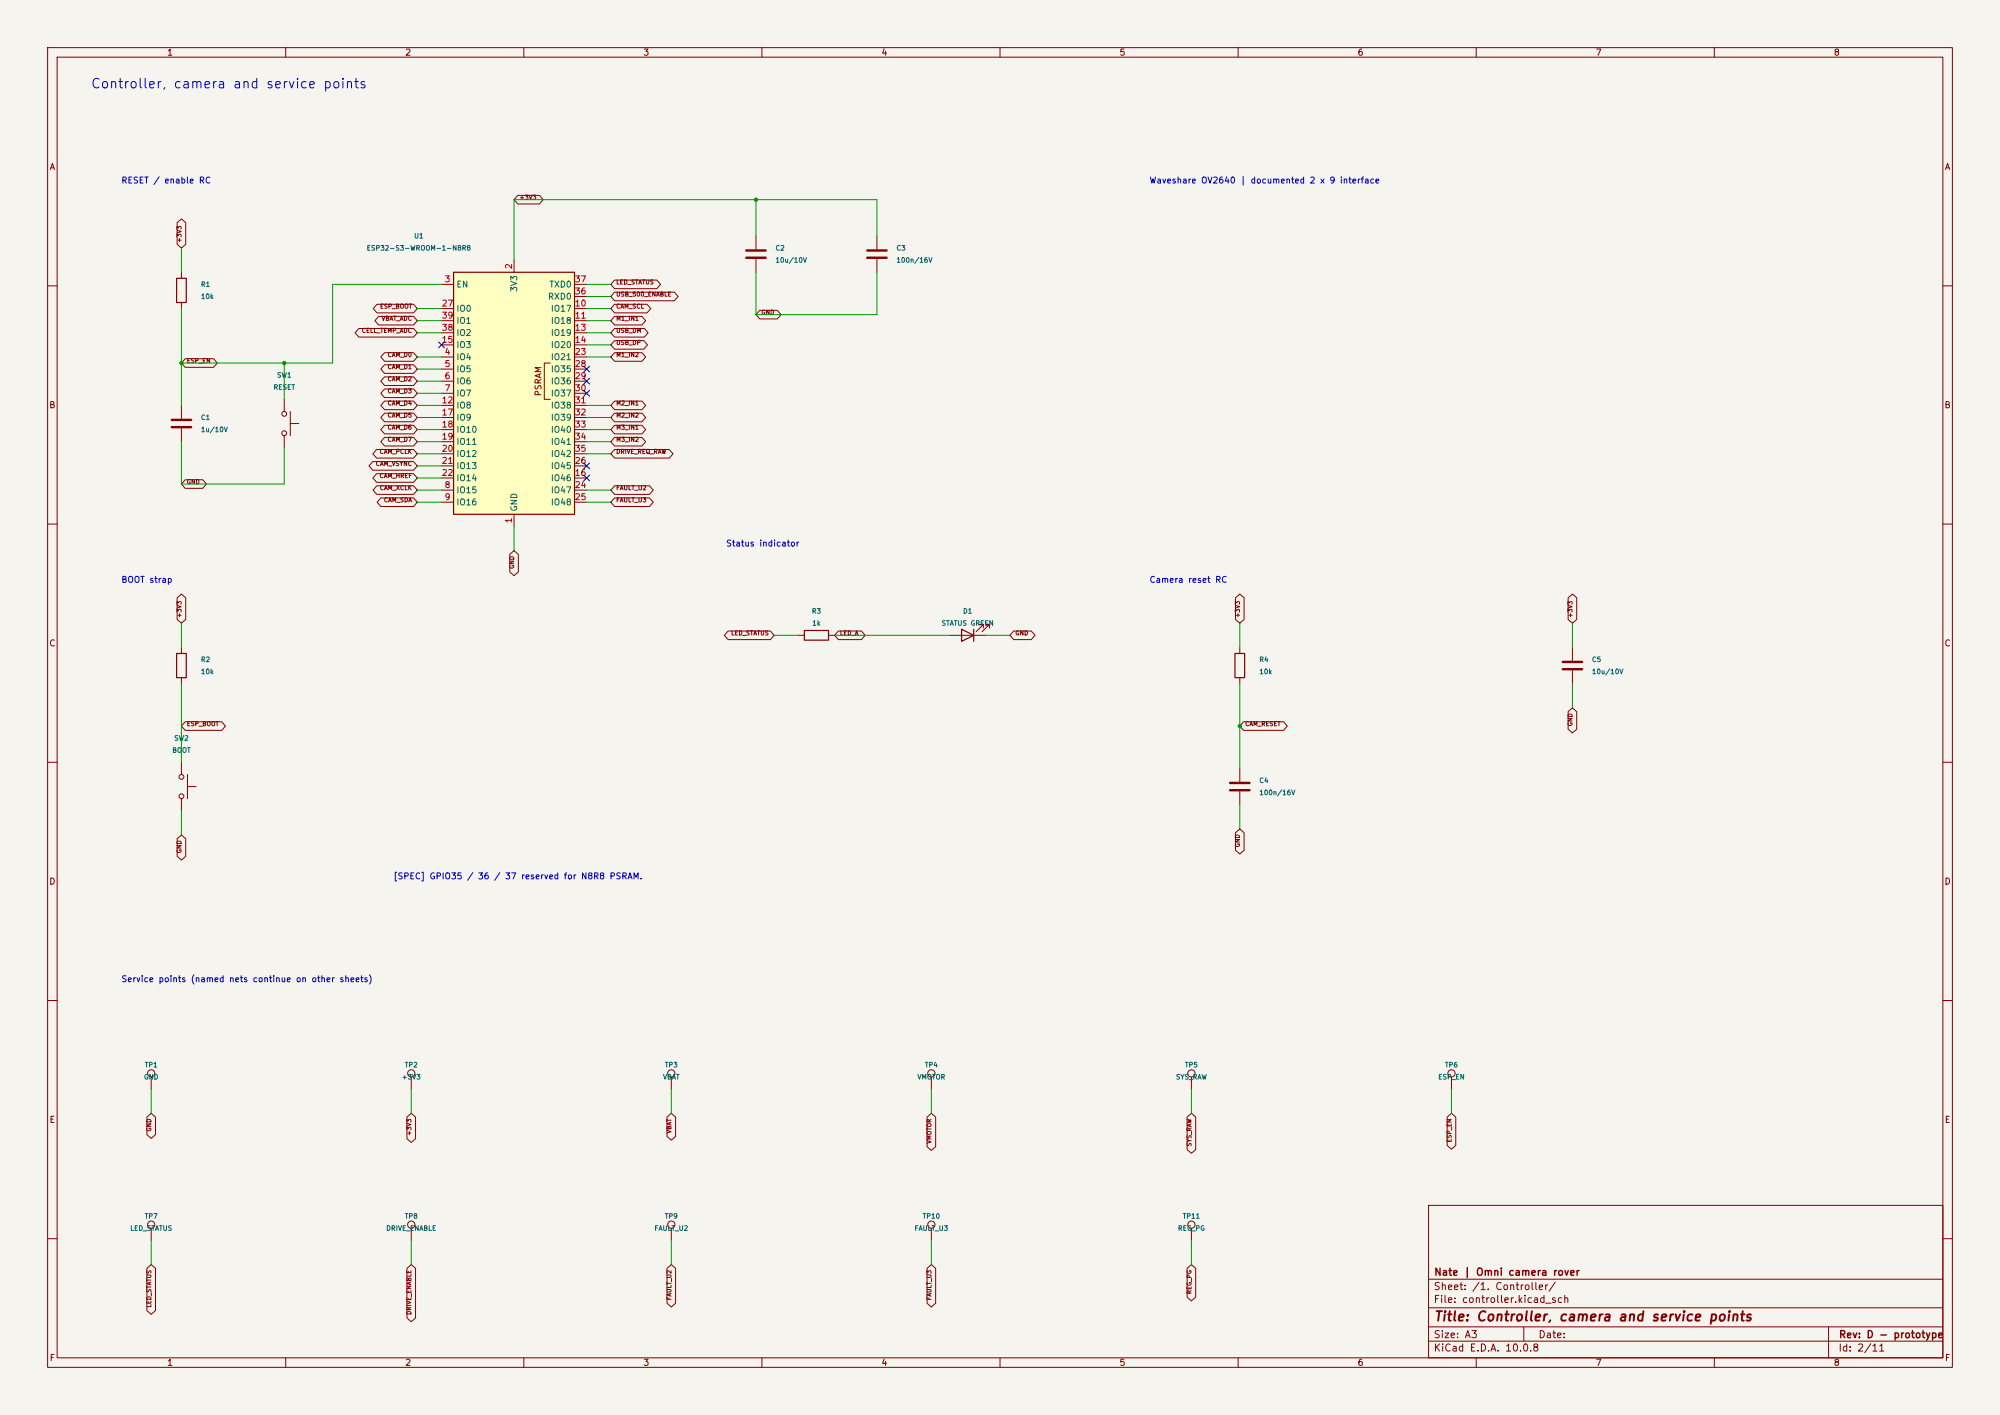
[picture p95: page 2]

[SPEC] GPIO35 / 36 / 37 reserved for N8R8 PSRAM.

Service points (named nets continue on other sheets)

Nate | Omni camera rover
Sheet: /1. Controller/
File: controller.kicad_sch
Title: Controller, camera and service points

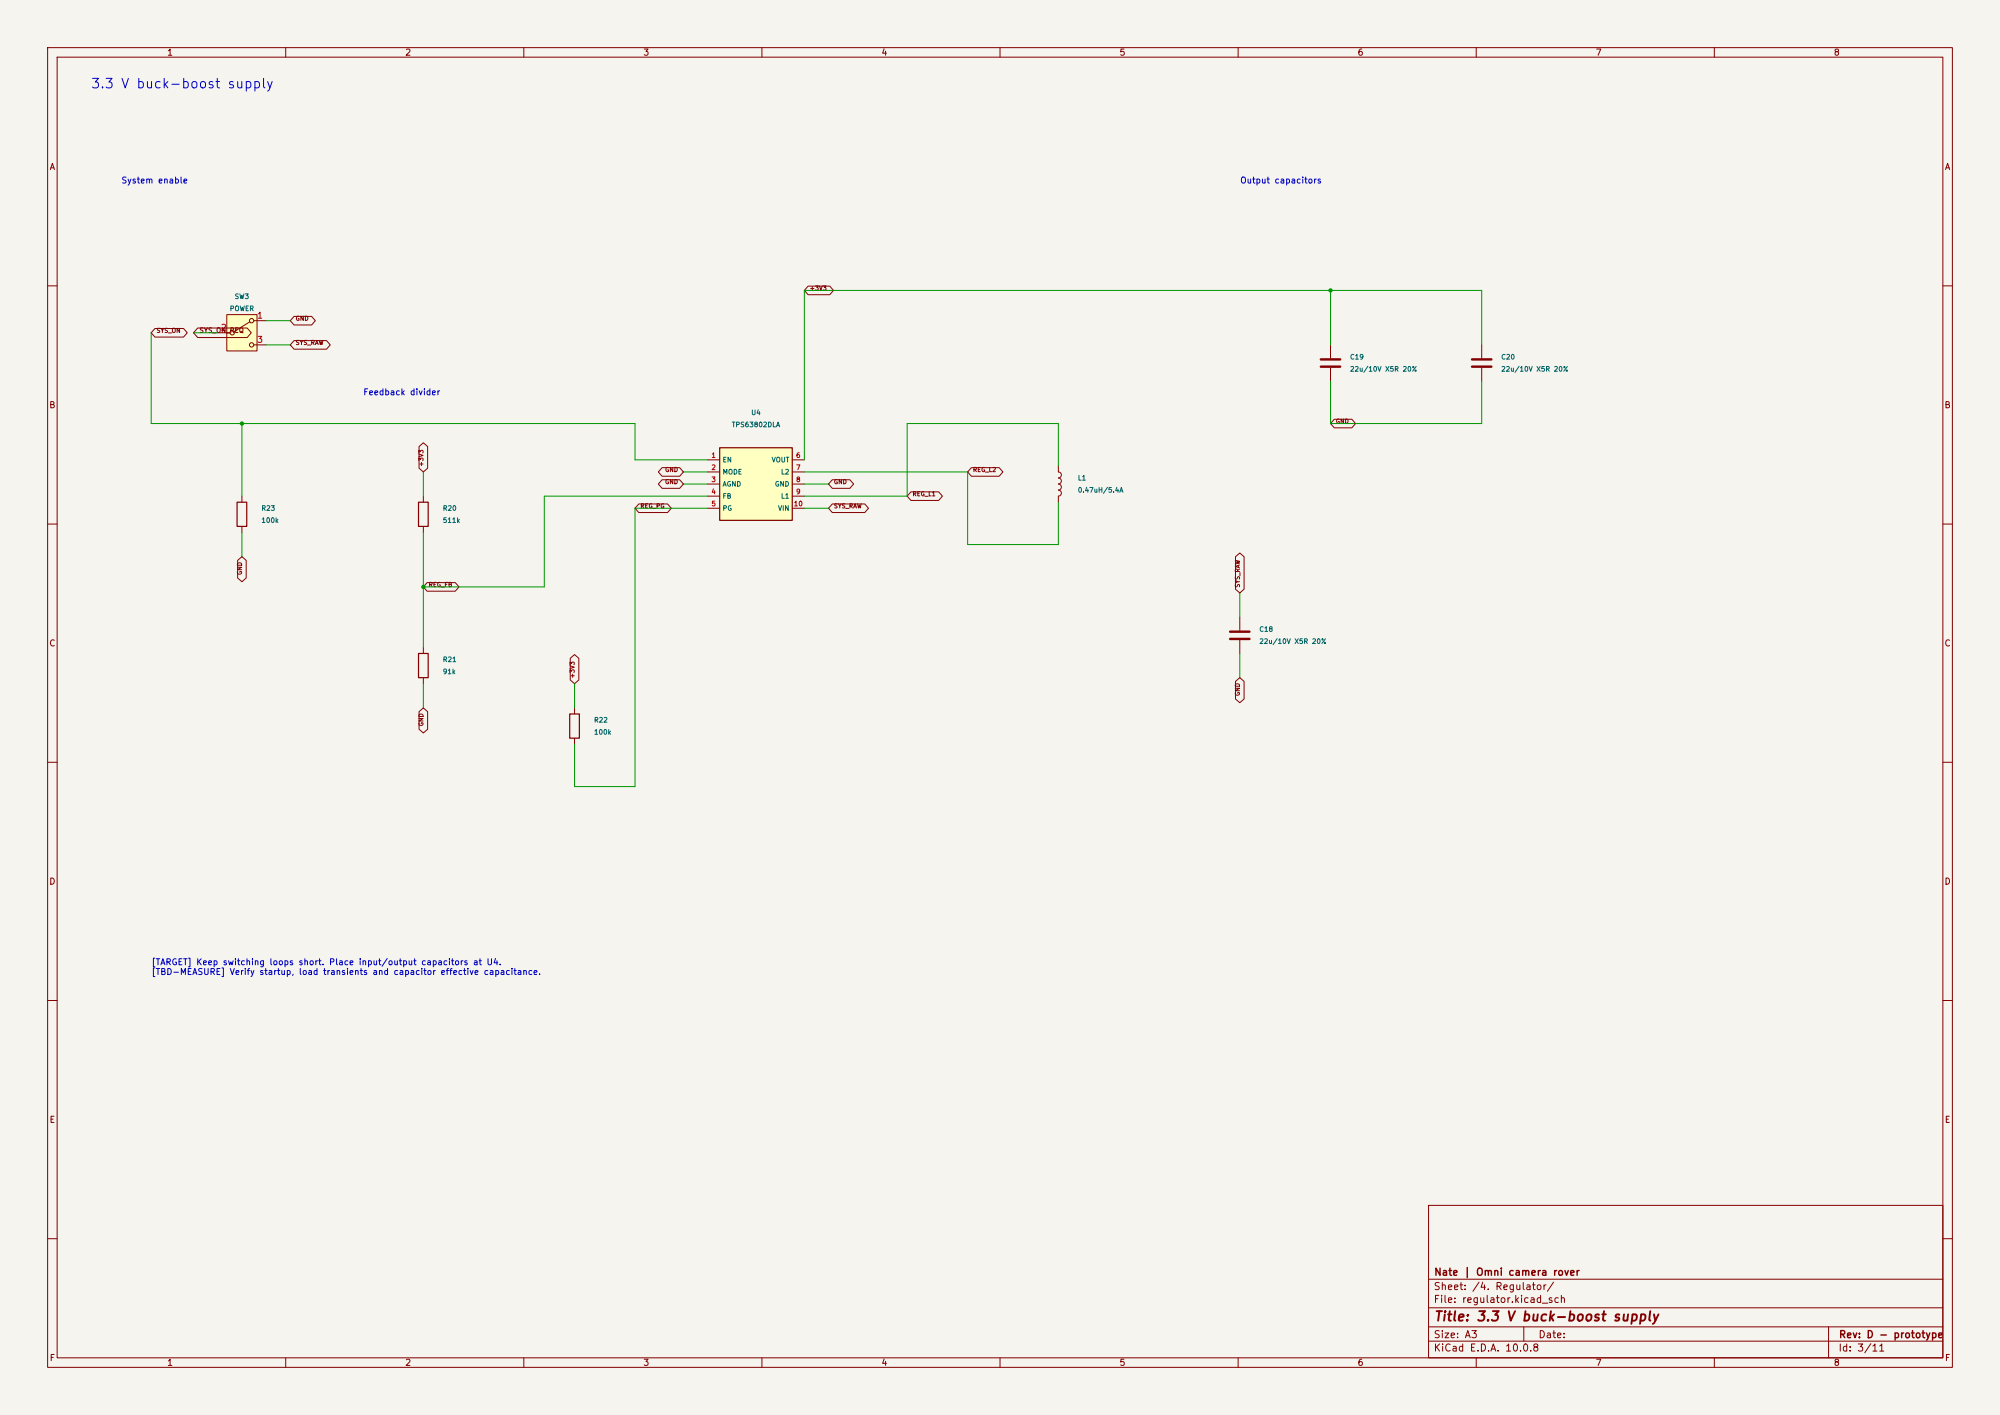
[picture p96: page 3]

[TARGET] Keep switching loops short. Place input/output capacitors at U4. [TBD-MEASURE] Verify startup, load transients and capacitor effective capacitance.

Nate | Omni camera rover
Sheet: /4. Regulator/
File: regulator.kicad_sch
Title: 3.3 V buck-boost supply

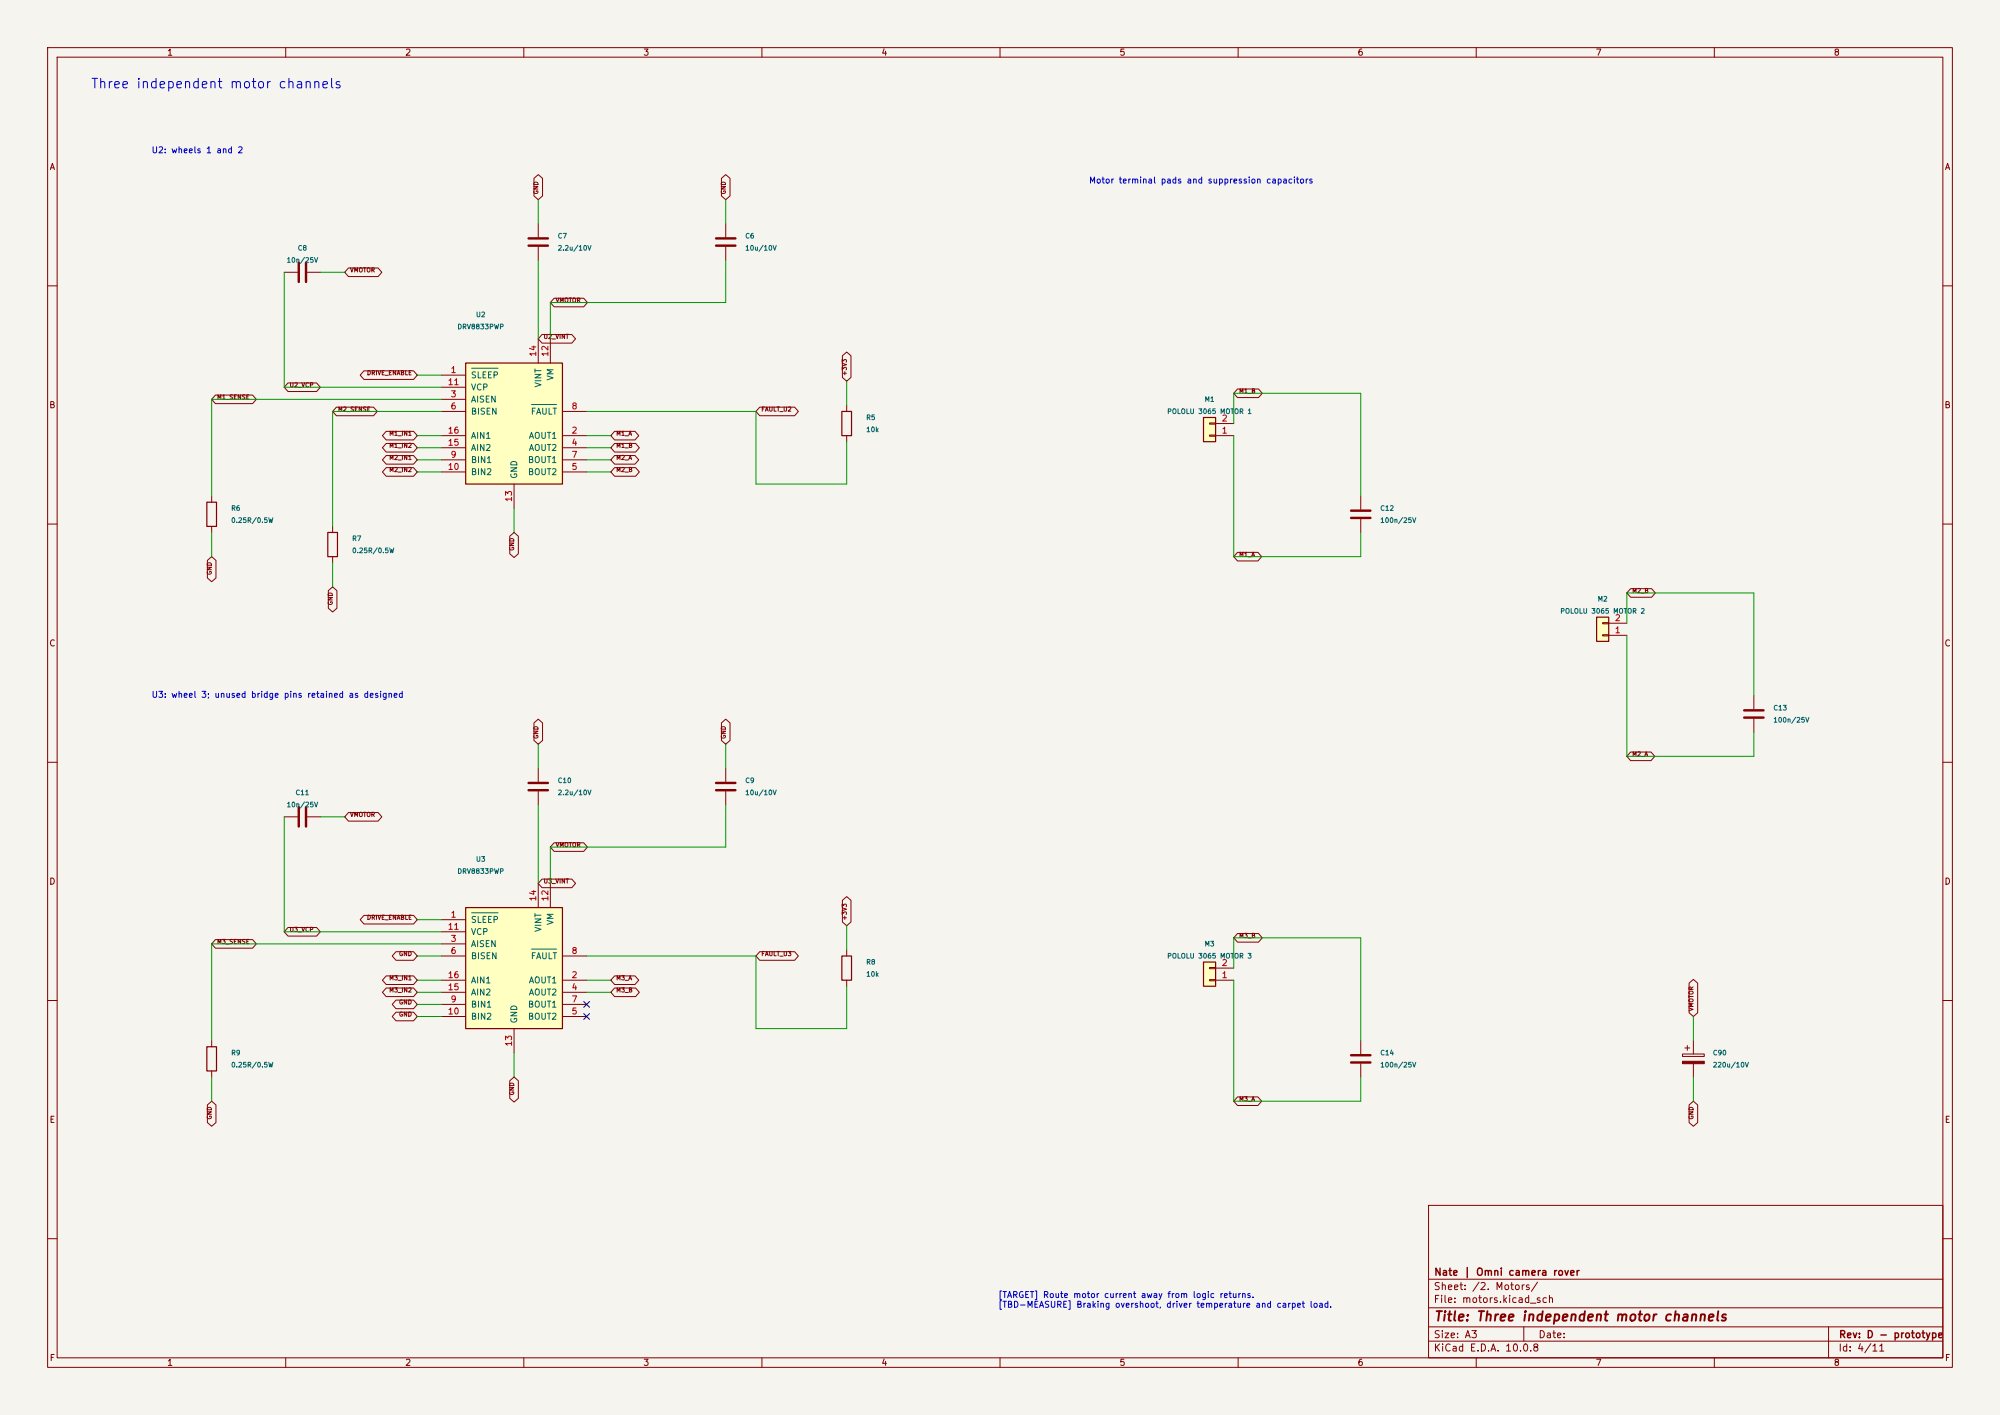
[picture p97: page 4]

Three independent motor channels
M2_IN1 M3_SENSE GND

Motor terminal pads and suppression capacitors U3: wheel 3; unused bridge pins retained as designed

Nate | Omni camera rover
Sheet: /2. Motors/
File: motors.kicad_sch
Title: Three independent motor channels

[TARGET] Route motor current away from logic returns. [TBD-MEASURE] Braking overshoot, driver temperature and carpet load.

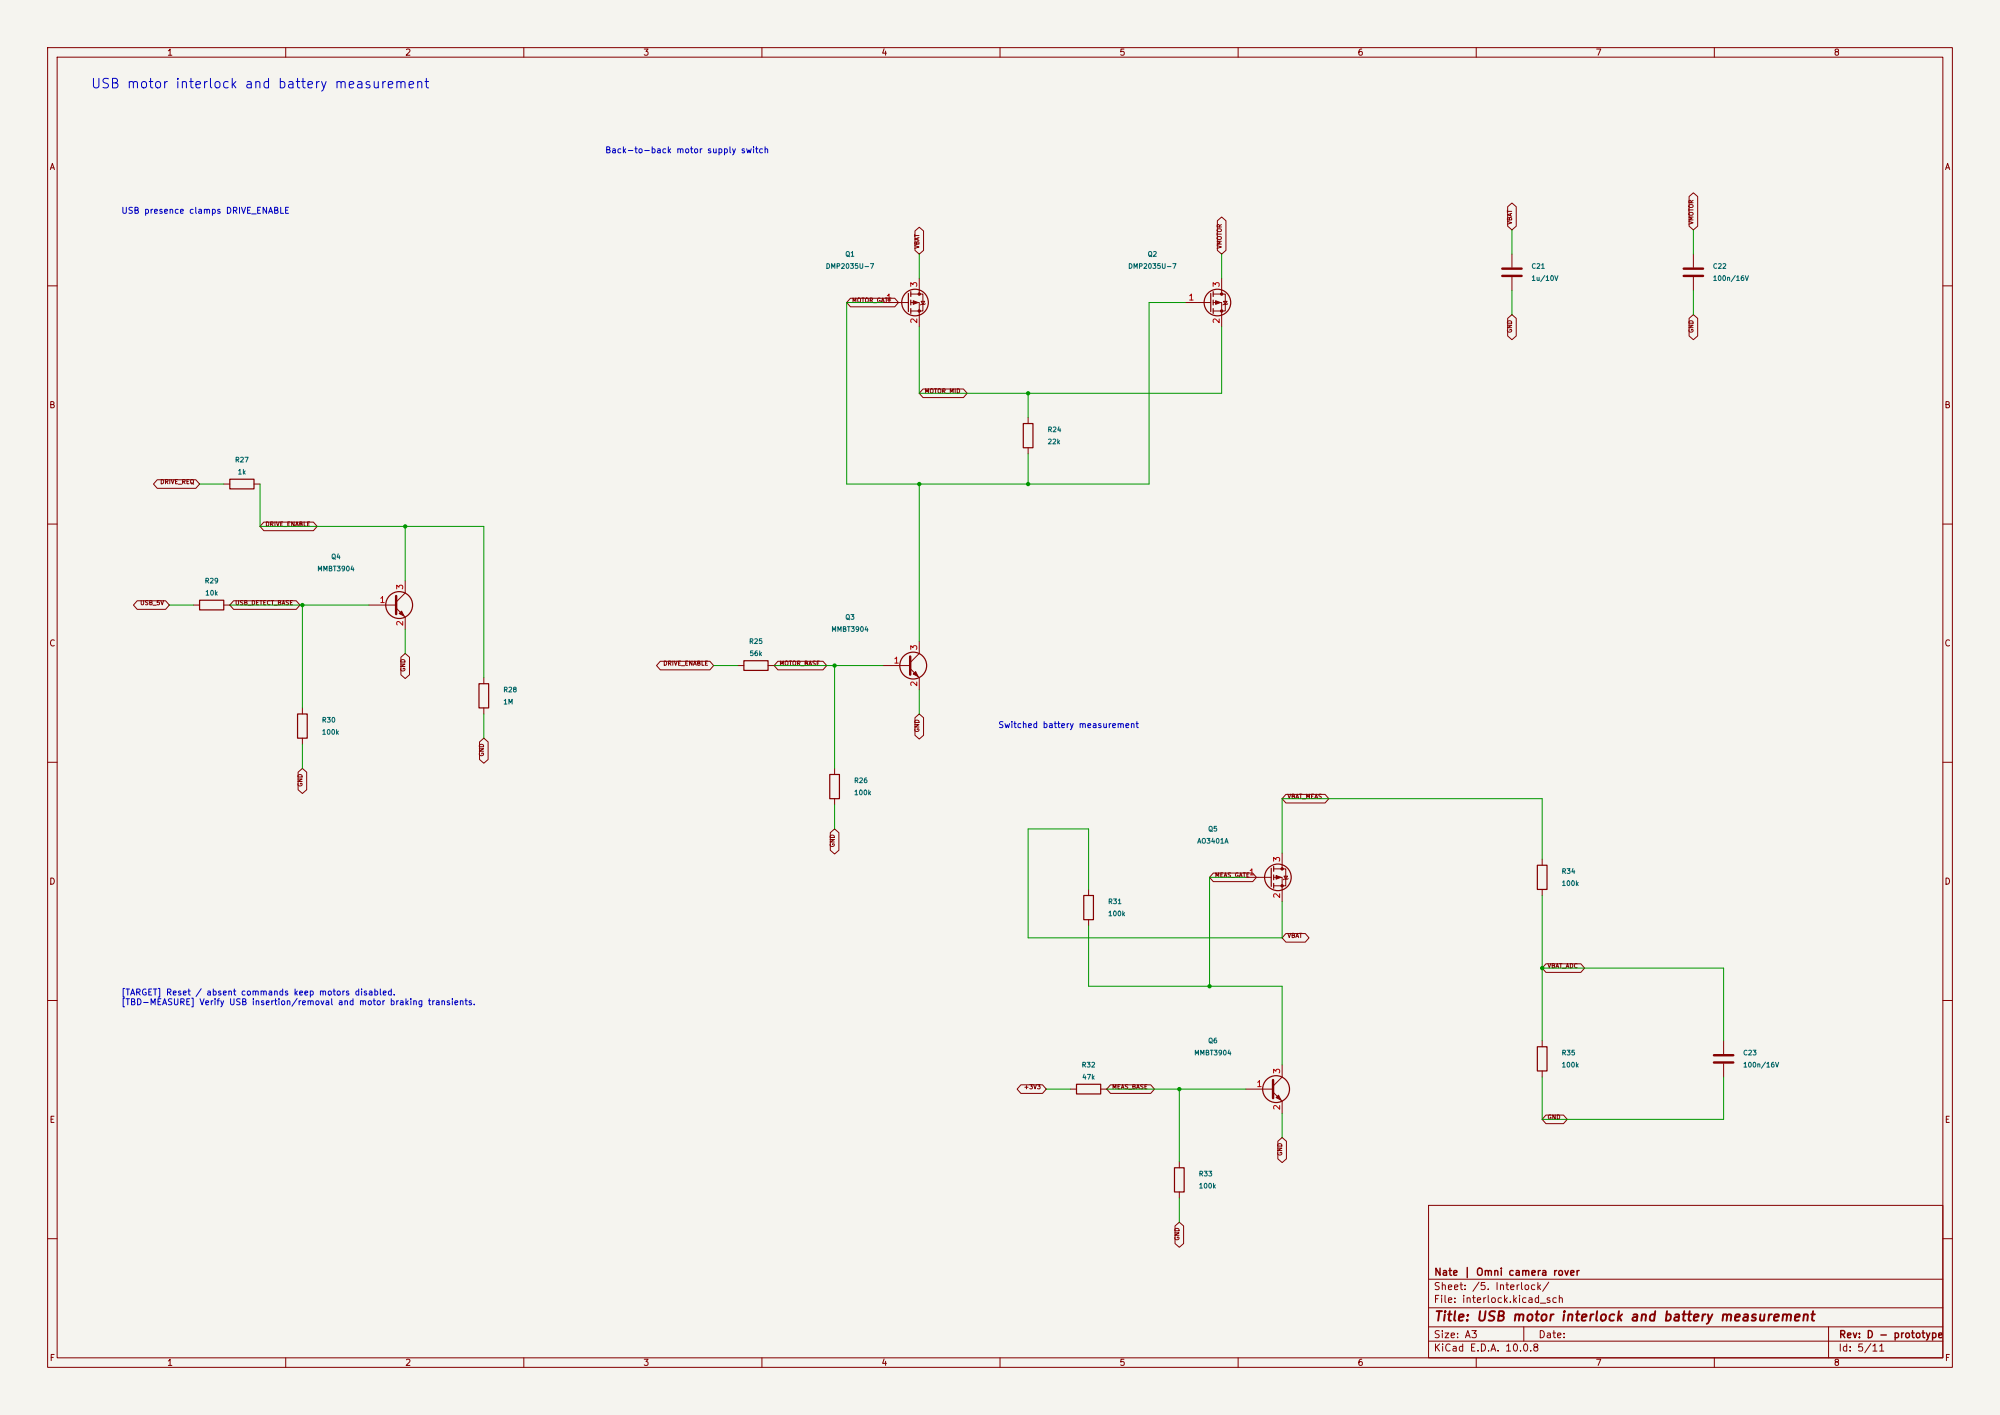
[picture p98: page 5]

[TARGET] Reset / absent commands keep motors disabled. [TBD-MEASURE] Verify USB insertion/removal and motor braking transients.

Nate | Omni camera rover
Sheet: /5. Interlock/
File: interlock.kicad_sch
Title: USB motor interlock and battery measurement

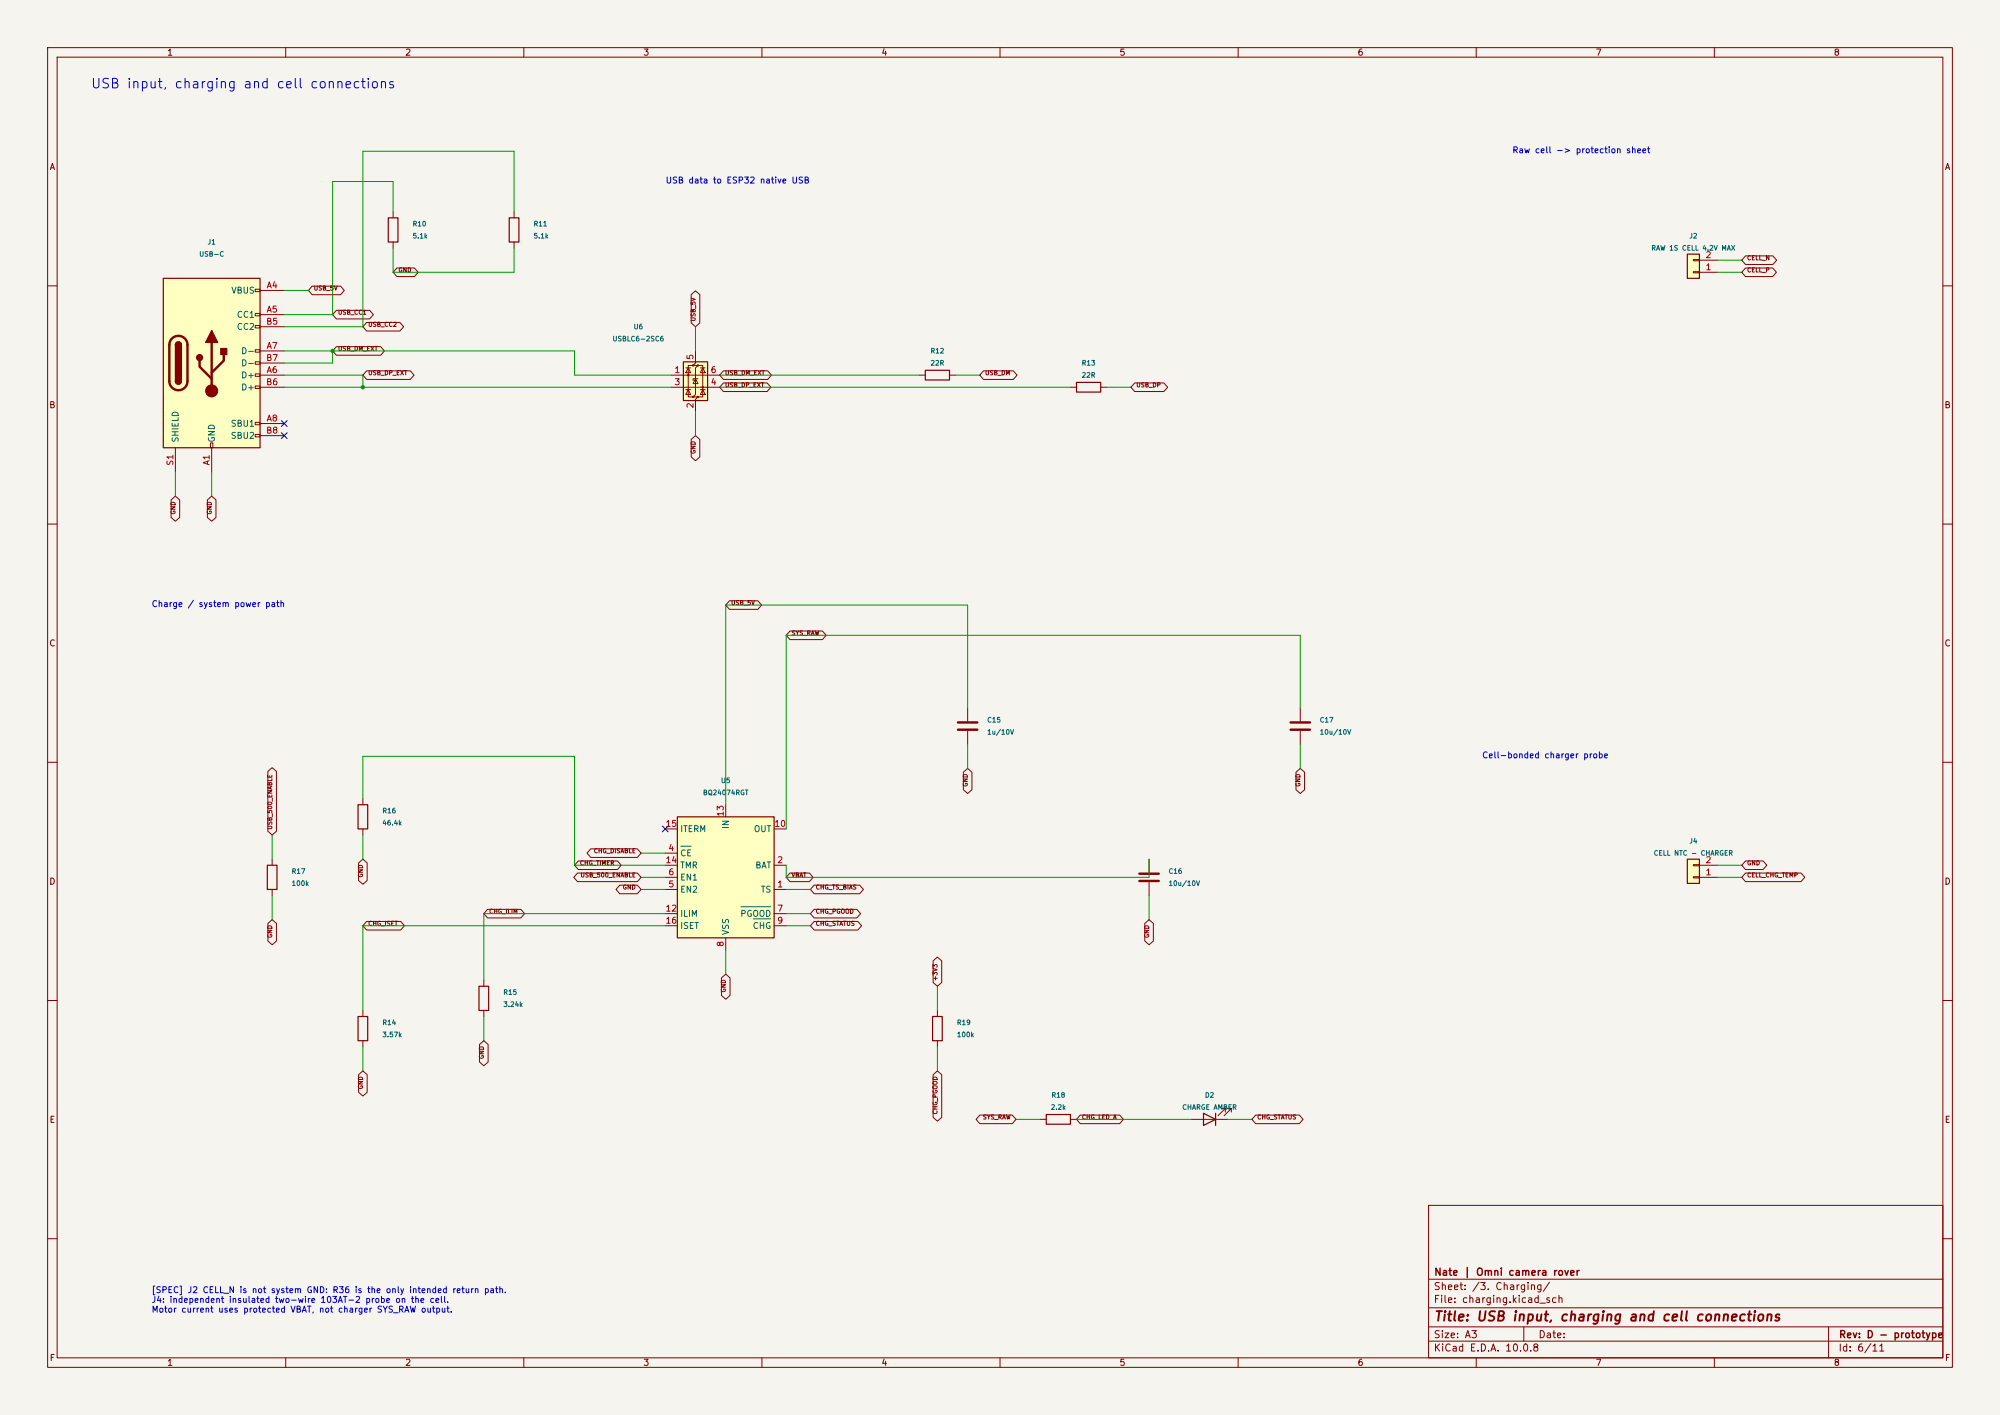
[picture p99: page 6]

USB_DM_EXT USB_DM_EXT USB input, charging and cell connections

Raw cell -> protection sheet Cell-bonded charger probe

USB data to ESP32 native USB

Charge / system power path

Nate | Omni camera rover R18

Sheet: /3. Charging/
File: charging.kicad_sch
Title: USB input, charging and cell connections

[SPEC] J2 CELL_N is not system GND: R36 is the only intended return path. J4: independent insulated two-wire 103AT-2 probe on the cell. Motor current uses protected VBAT, not charger SYS_RAW output.

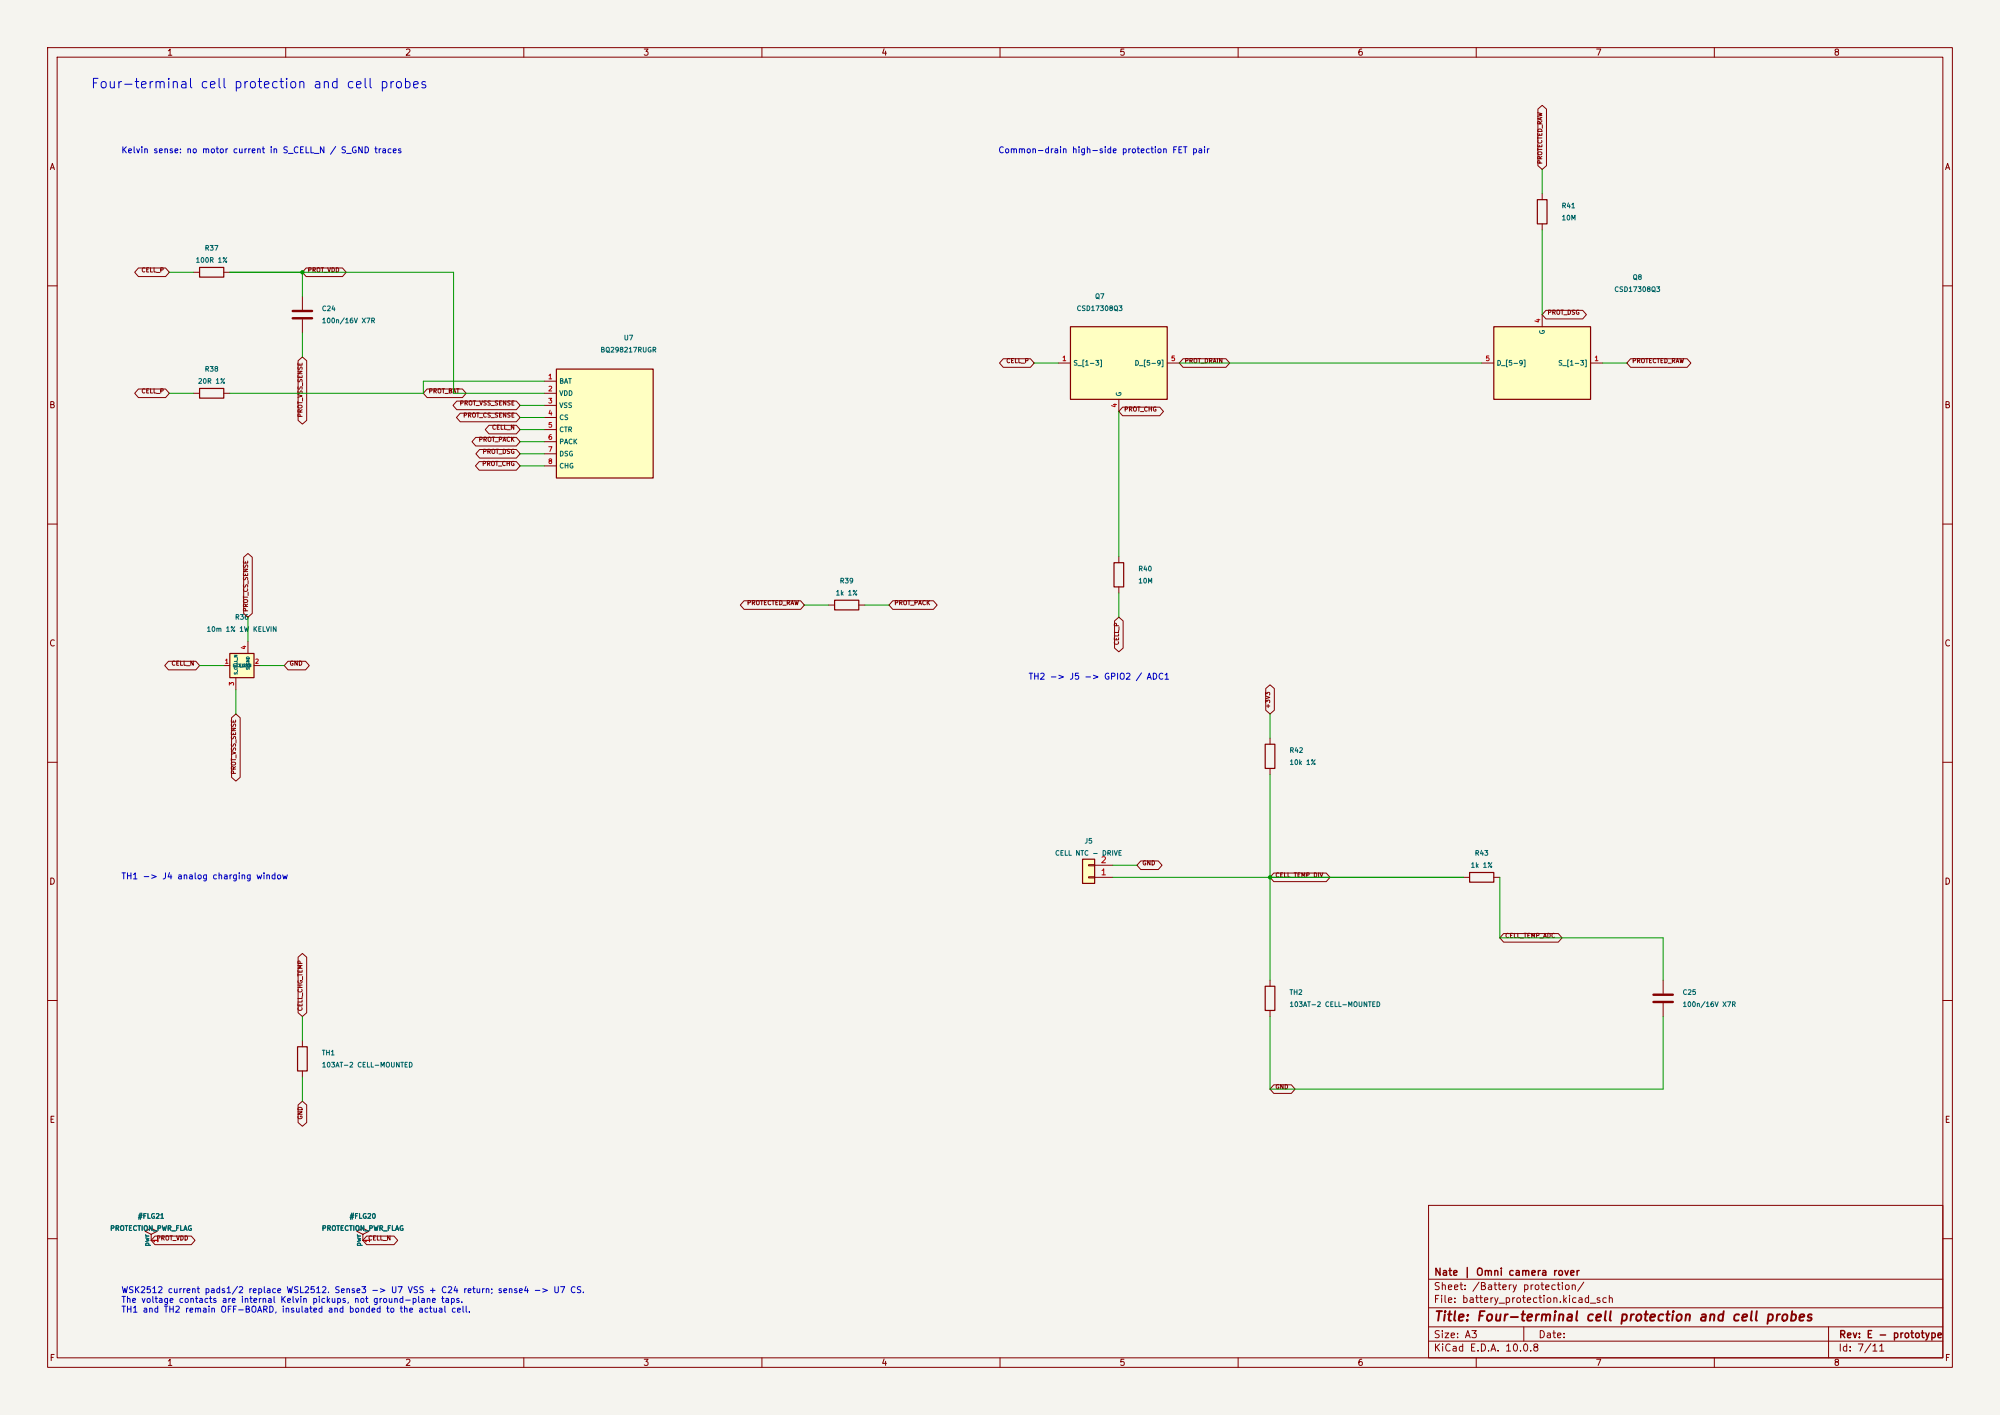
[picture p100: page 7]

Four-terminal cell protection and cell probes

Nate | Omni camera rover
Sheet: /Battery protection/
File: battery_protection.kicad_sch
Title: Four-terminal cell protection and cell probes

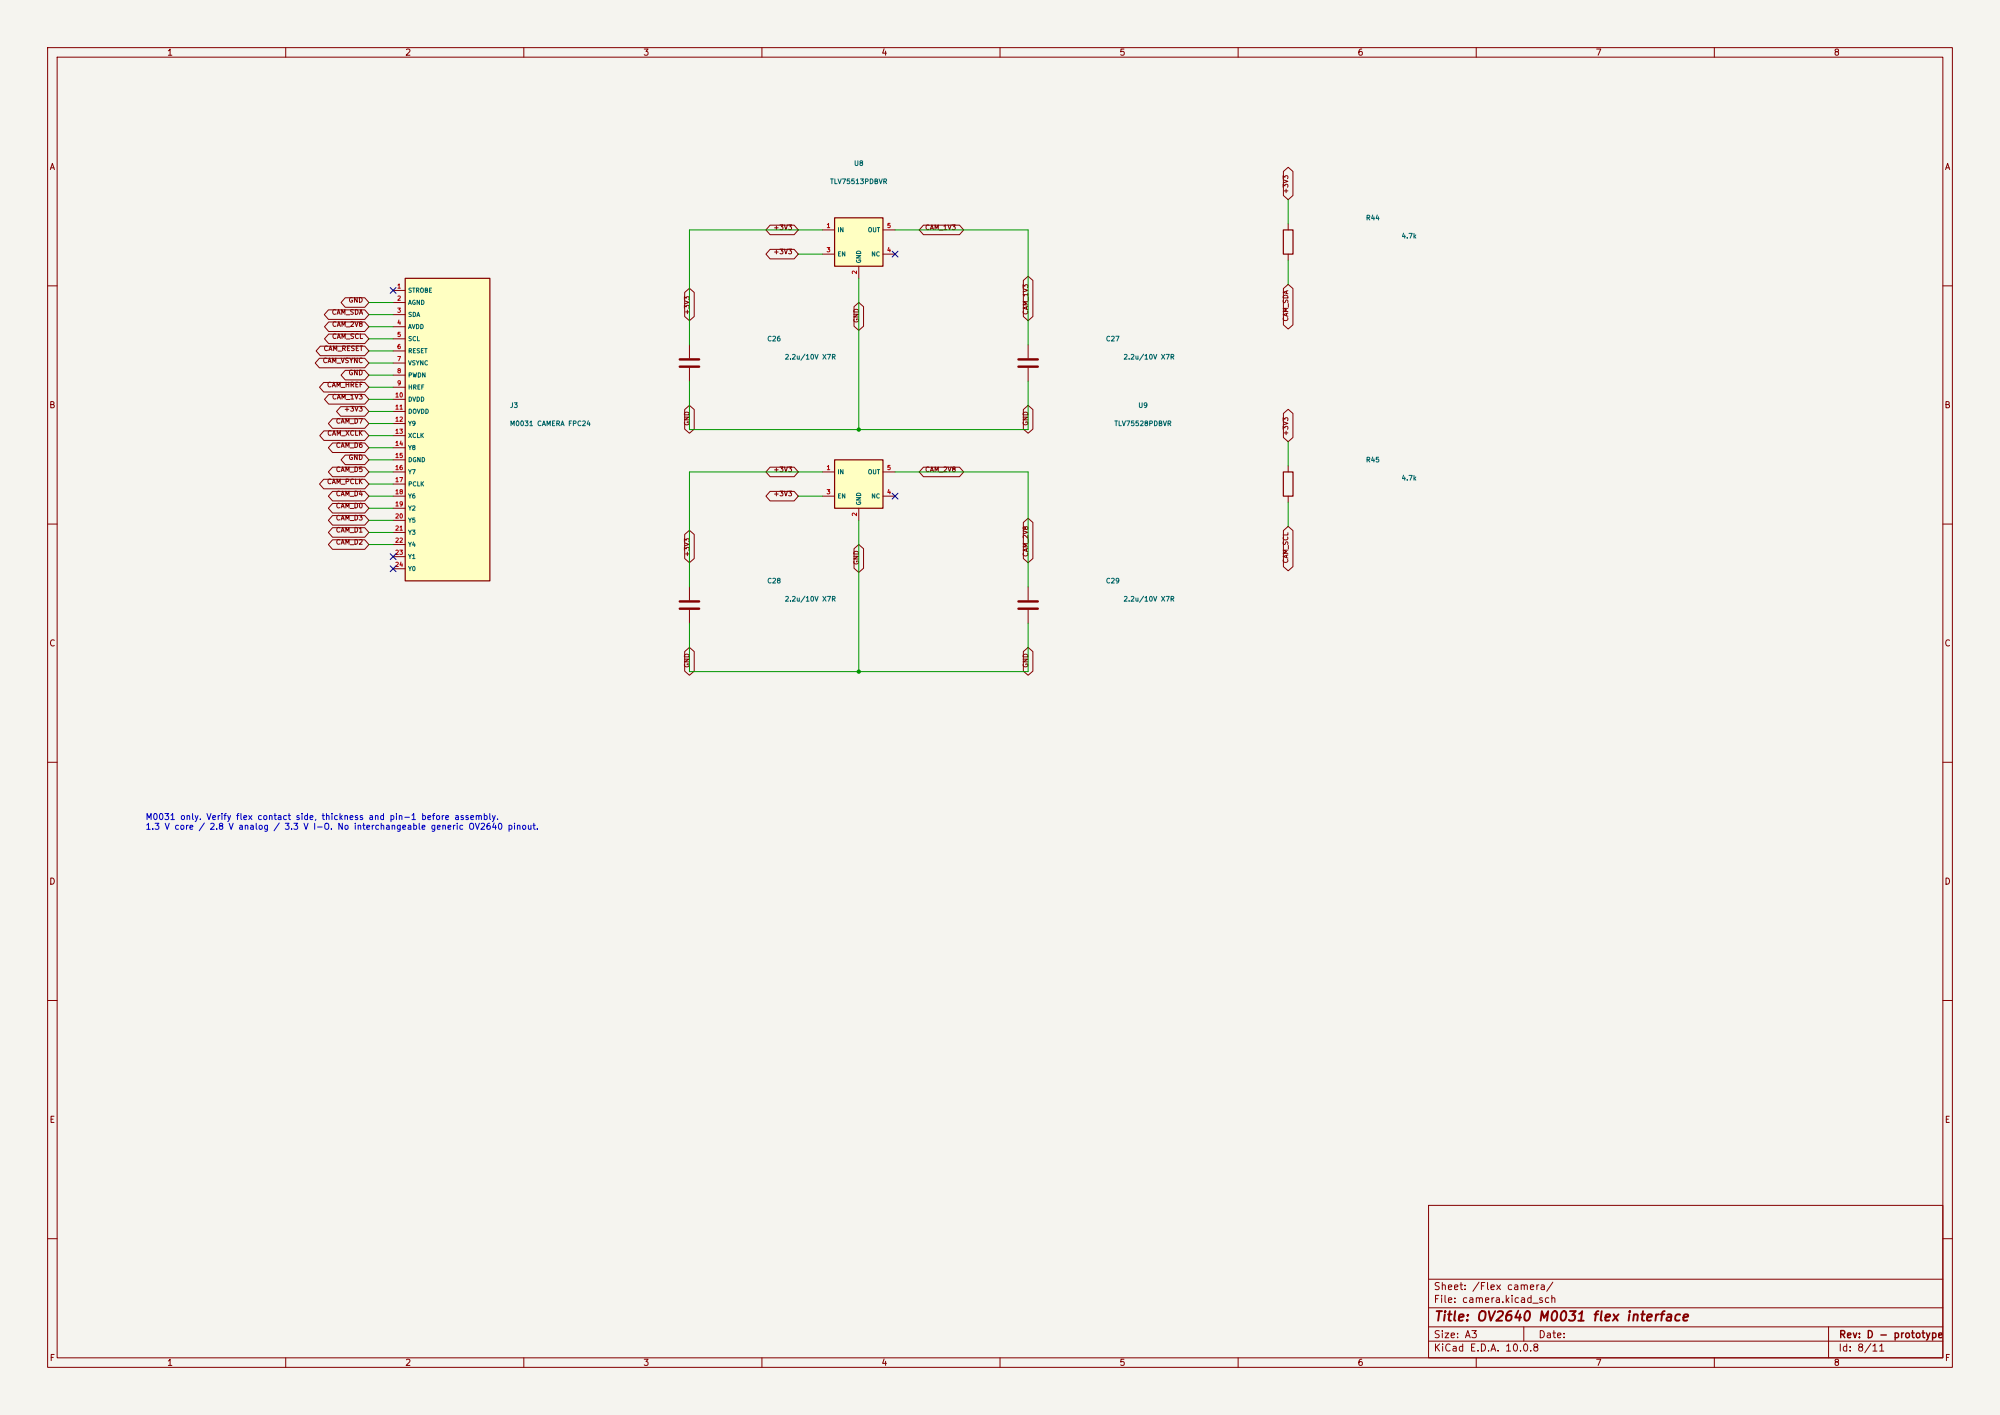
[picture p101: page 8]

CAM_HREF CAM_1V3 M0031 only. Verify flex contact side, thickness and pin-1 before assembly. 1.3 V core / 2.8 V analog / 3.3 V I-O. No interchangeable generic OV2640 pinout.

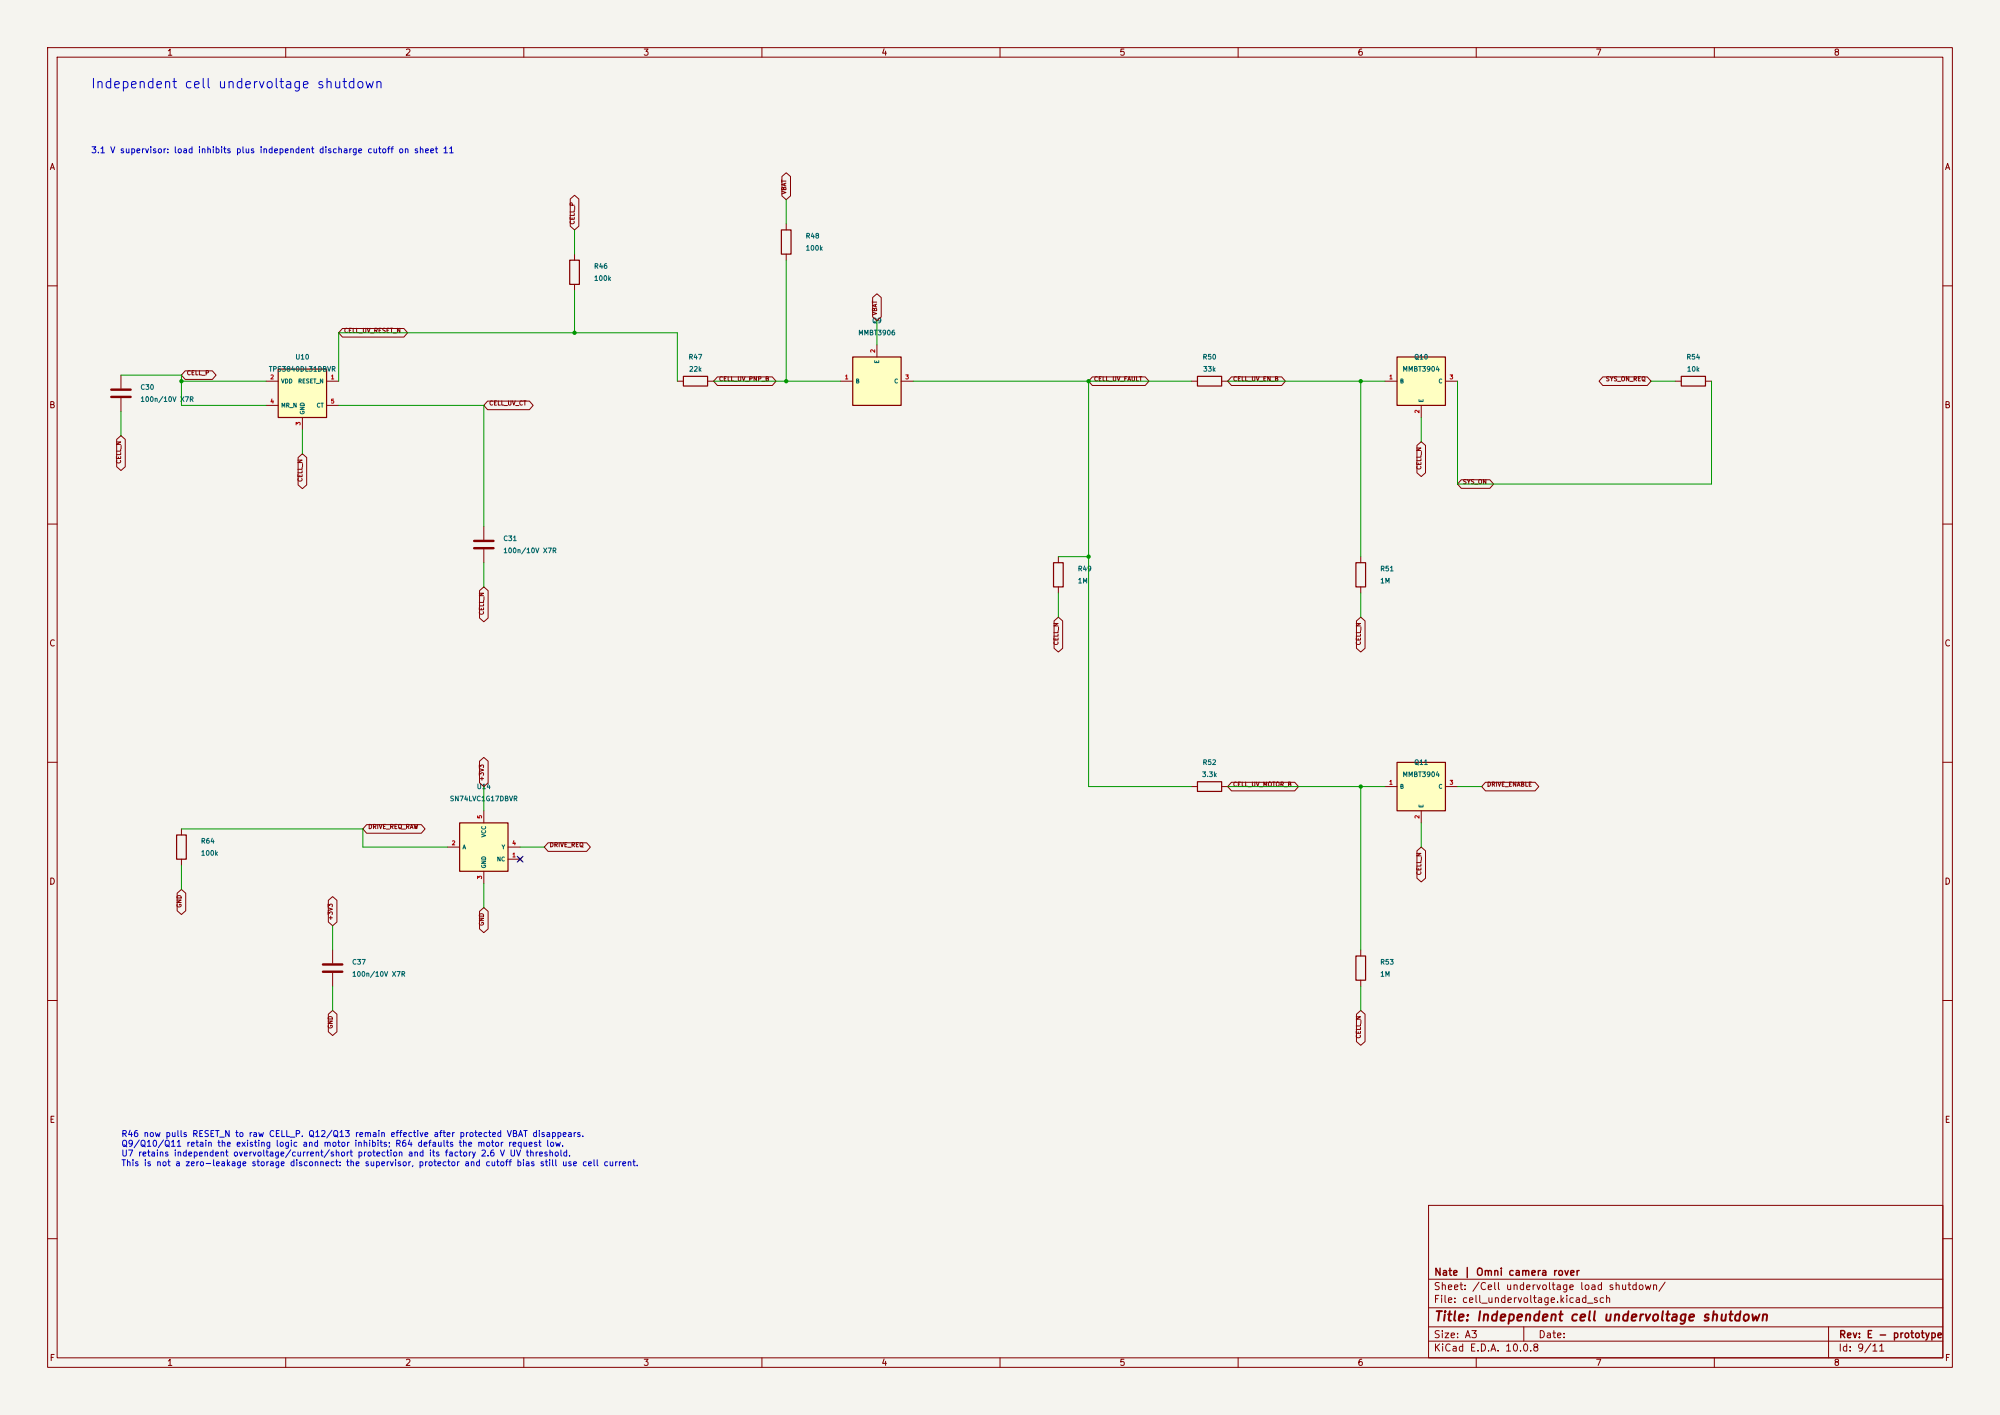
[picture p102: page 9]

Independent cell undervoltage shutdown

3.1 V supervisor: load inhibits plus independent discharge cutoff on sheet 11

R46 now pulls RESET_N to raw CELL_P. Q12/Q13 remain effective after protected VBAT disappears.
Q9/Q10/Q11 retain the existing logic and motor inhibits; R64 defaults the motor request low. U7 retains independent overvoltage/current/short protection and its factory 2.6 V UV threshold. This is not a zero-leakage storage disconnect: the supervisor, protector and cutoff bias still use cell current.

Nate | Omni camera rover
Sheet: /Cell undervoltage load shutdown/
File: cell_undervoltage.kicad_sch
Title: Independent cell undervoltage shutdown

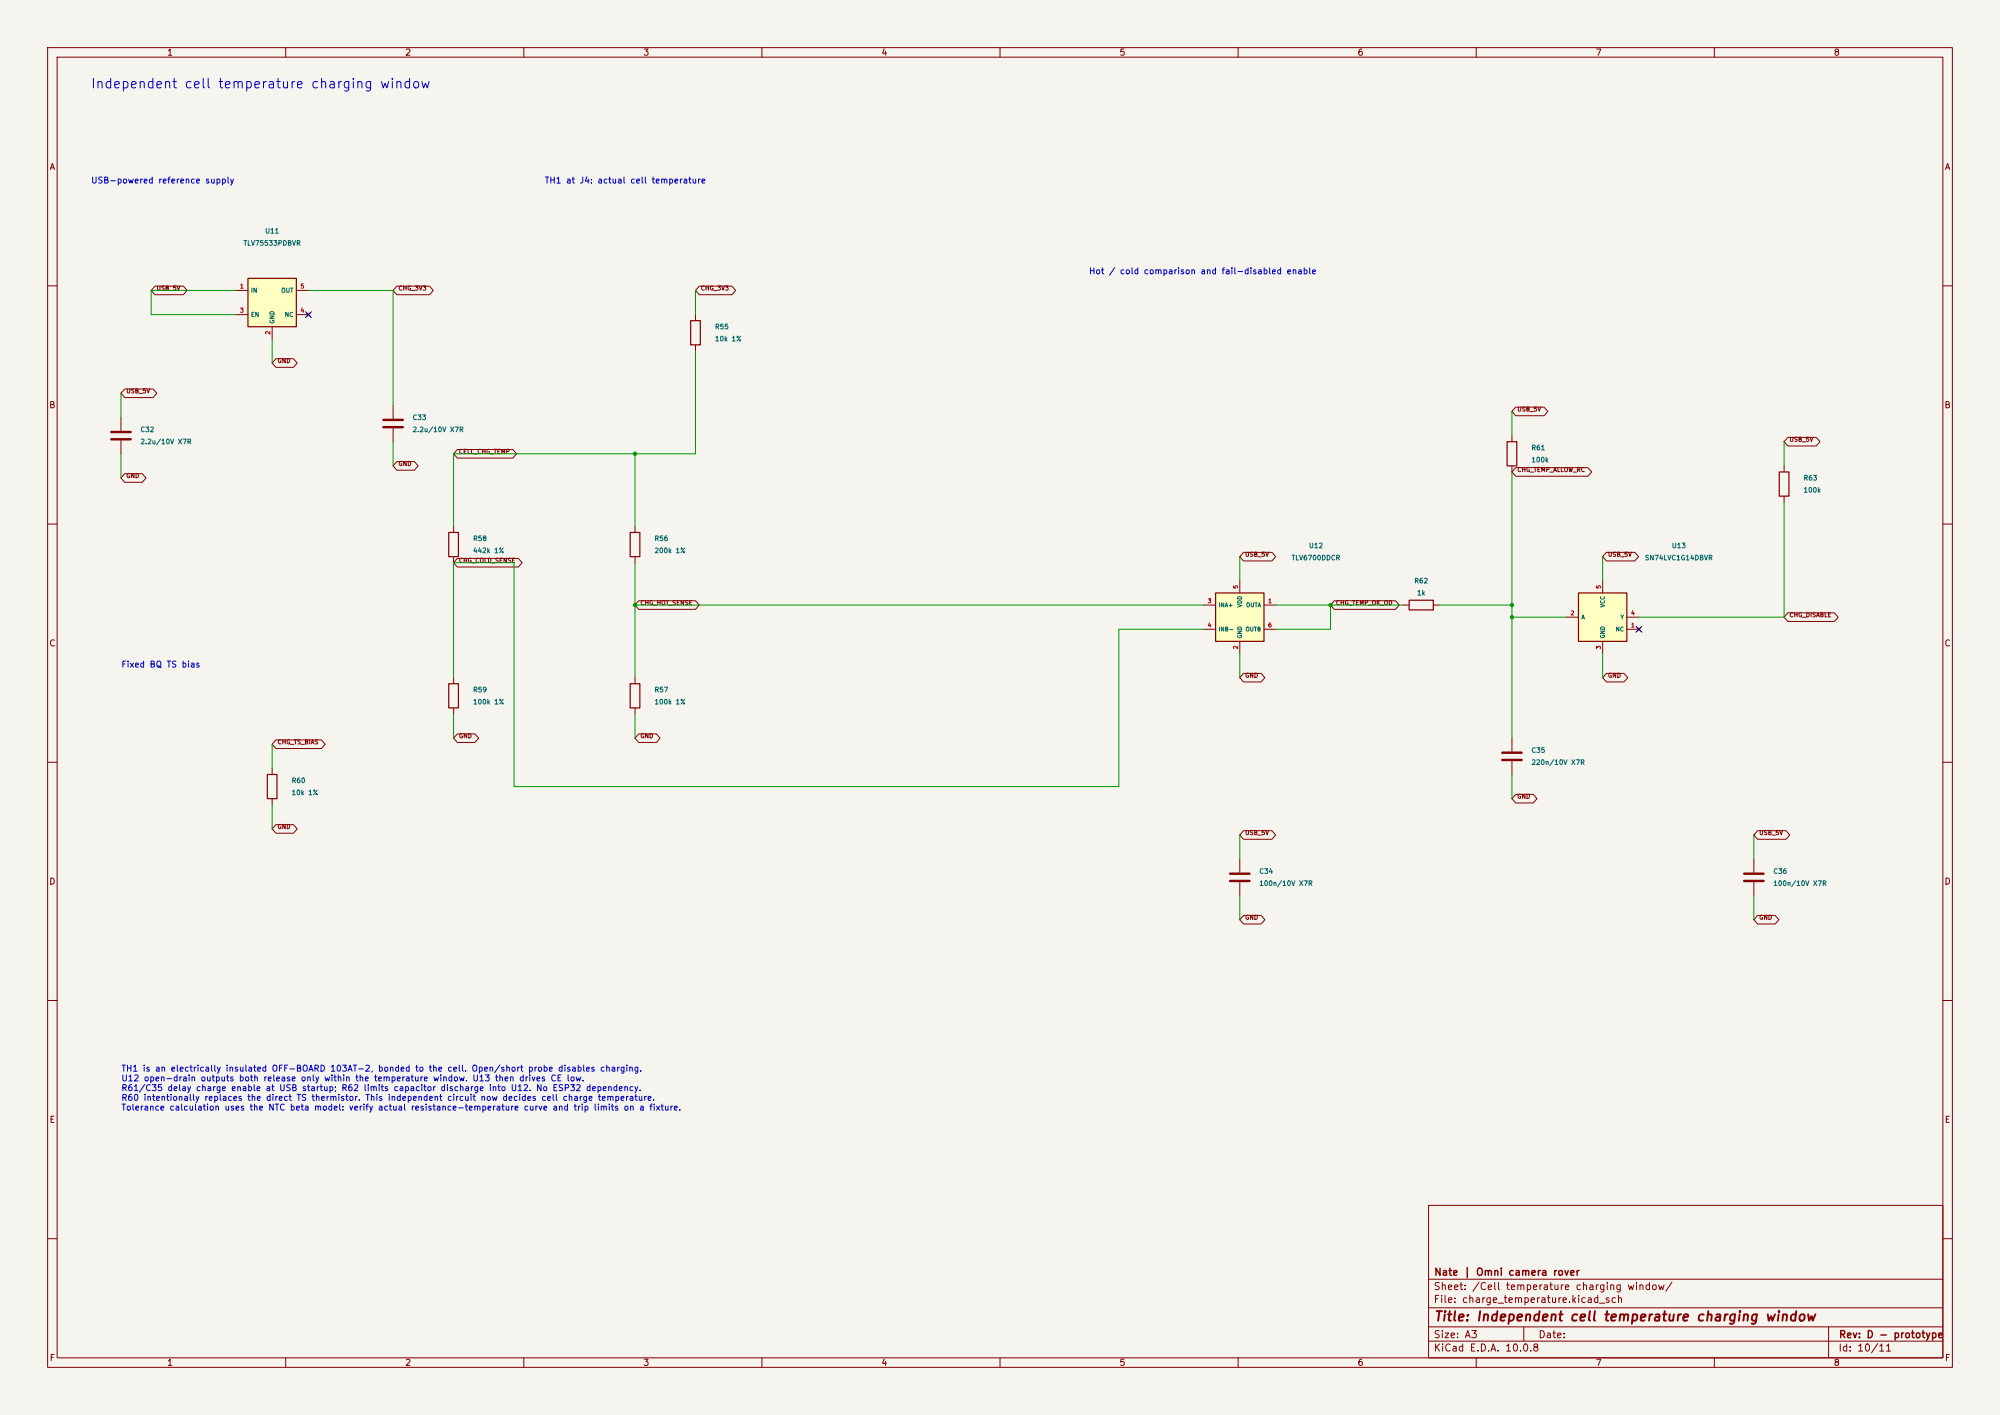
[picture p103: page 10]

Independent cell temperature charging window
USB-powered reference supply Fixed BQ TS bias

TH1 at J4: actual cell temperature

TH1 is an electrically insulated OFF-BOARD 103AT-2, bonded to the cell. Open/short probe disables charging. U12 open-drain outputs both release only within the temperature window. U13 then drives CE low. R61/C35 delay charge enable at USB startup; R62 limits capacitor discharge into U12. No ESP32 dependency. R60 intentionally replaces the direct TS thermistor. This independent circuit now decides cell charge temperature. Tolerance calculation uses the NTC beta model: verify actual resistance-temperature curve and trip limits on a fixture.

Nate | Omni camera rover
Sheet: /Cell temperature charging window/
File: charge_temperature.kicad_sch
Title: Independent cell temperature charging window

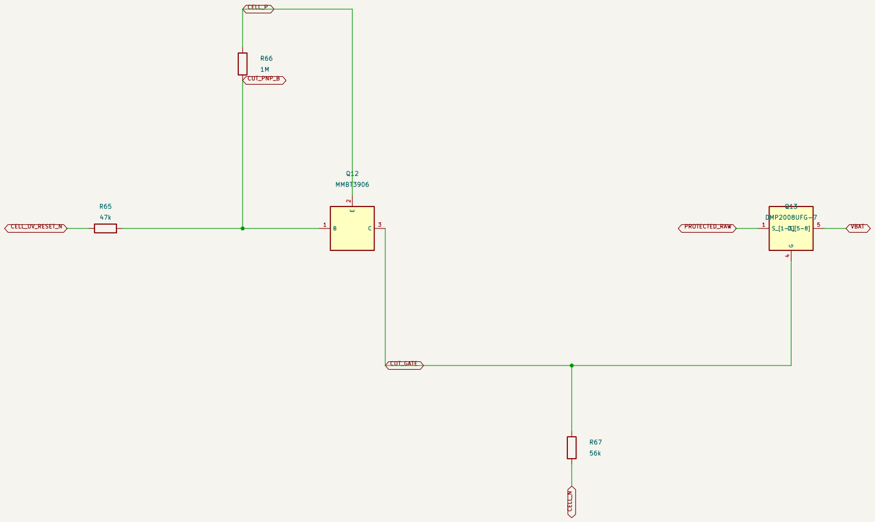
[picture p104: figure]
3 Q12 MMBT3906; 4 D_[5-8] 5 Q13 DMP2008UFG-7; PROTECTED_RAW CELL_N; CUT_PNP_B; CELL_P

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
Size: A3 | Rev: E - prototype

## Title: Discharge cutoff with charge recovery

### File: discharge_cutoff.kicad_sch

### Sheet: /Independent discharge cutoff/

### Nate | Omni camera rover

CUT_GATE CELL_UV_RESET_N | VBAT Discharge cutoff with charge recovery

Discharge: CELL_P -> Q7/Q8 -> PROTECTED_RAW -> Q13 -> VBAT U10 RESET_N low turns Q12 on; Q13 gate rises to raw CELL_P and blocks discharge. Static trip window 3.0535..3.1465 V; recovery approximately 3.3 V. Verify dip response on a cell simulator. Q13 body diode points VBAT -> PROTECTED_RAW, permitting recovery charging while discharge is off. Q13 MUST be downstream of Q7/Q8: lifting Q7 source could exceed its gate-source rating at startup. U7 BAT/VDD still monitor raw cell; PACK and R41 connect to PROTECTED_RAW before Q13. BQ24074 and independent cell-mounted TH1 window still control charging; U7 protection stays in series. U7 cold-start/charger-wake compatibility remains a separate fabrication blocker. This is not a storage disconnect.
