ncripted/DAMIEN/outputs/rover/Omni_UGV_Rev_A/Schematic.pdf

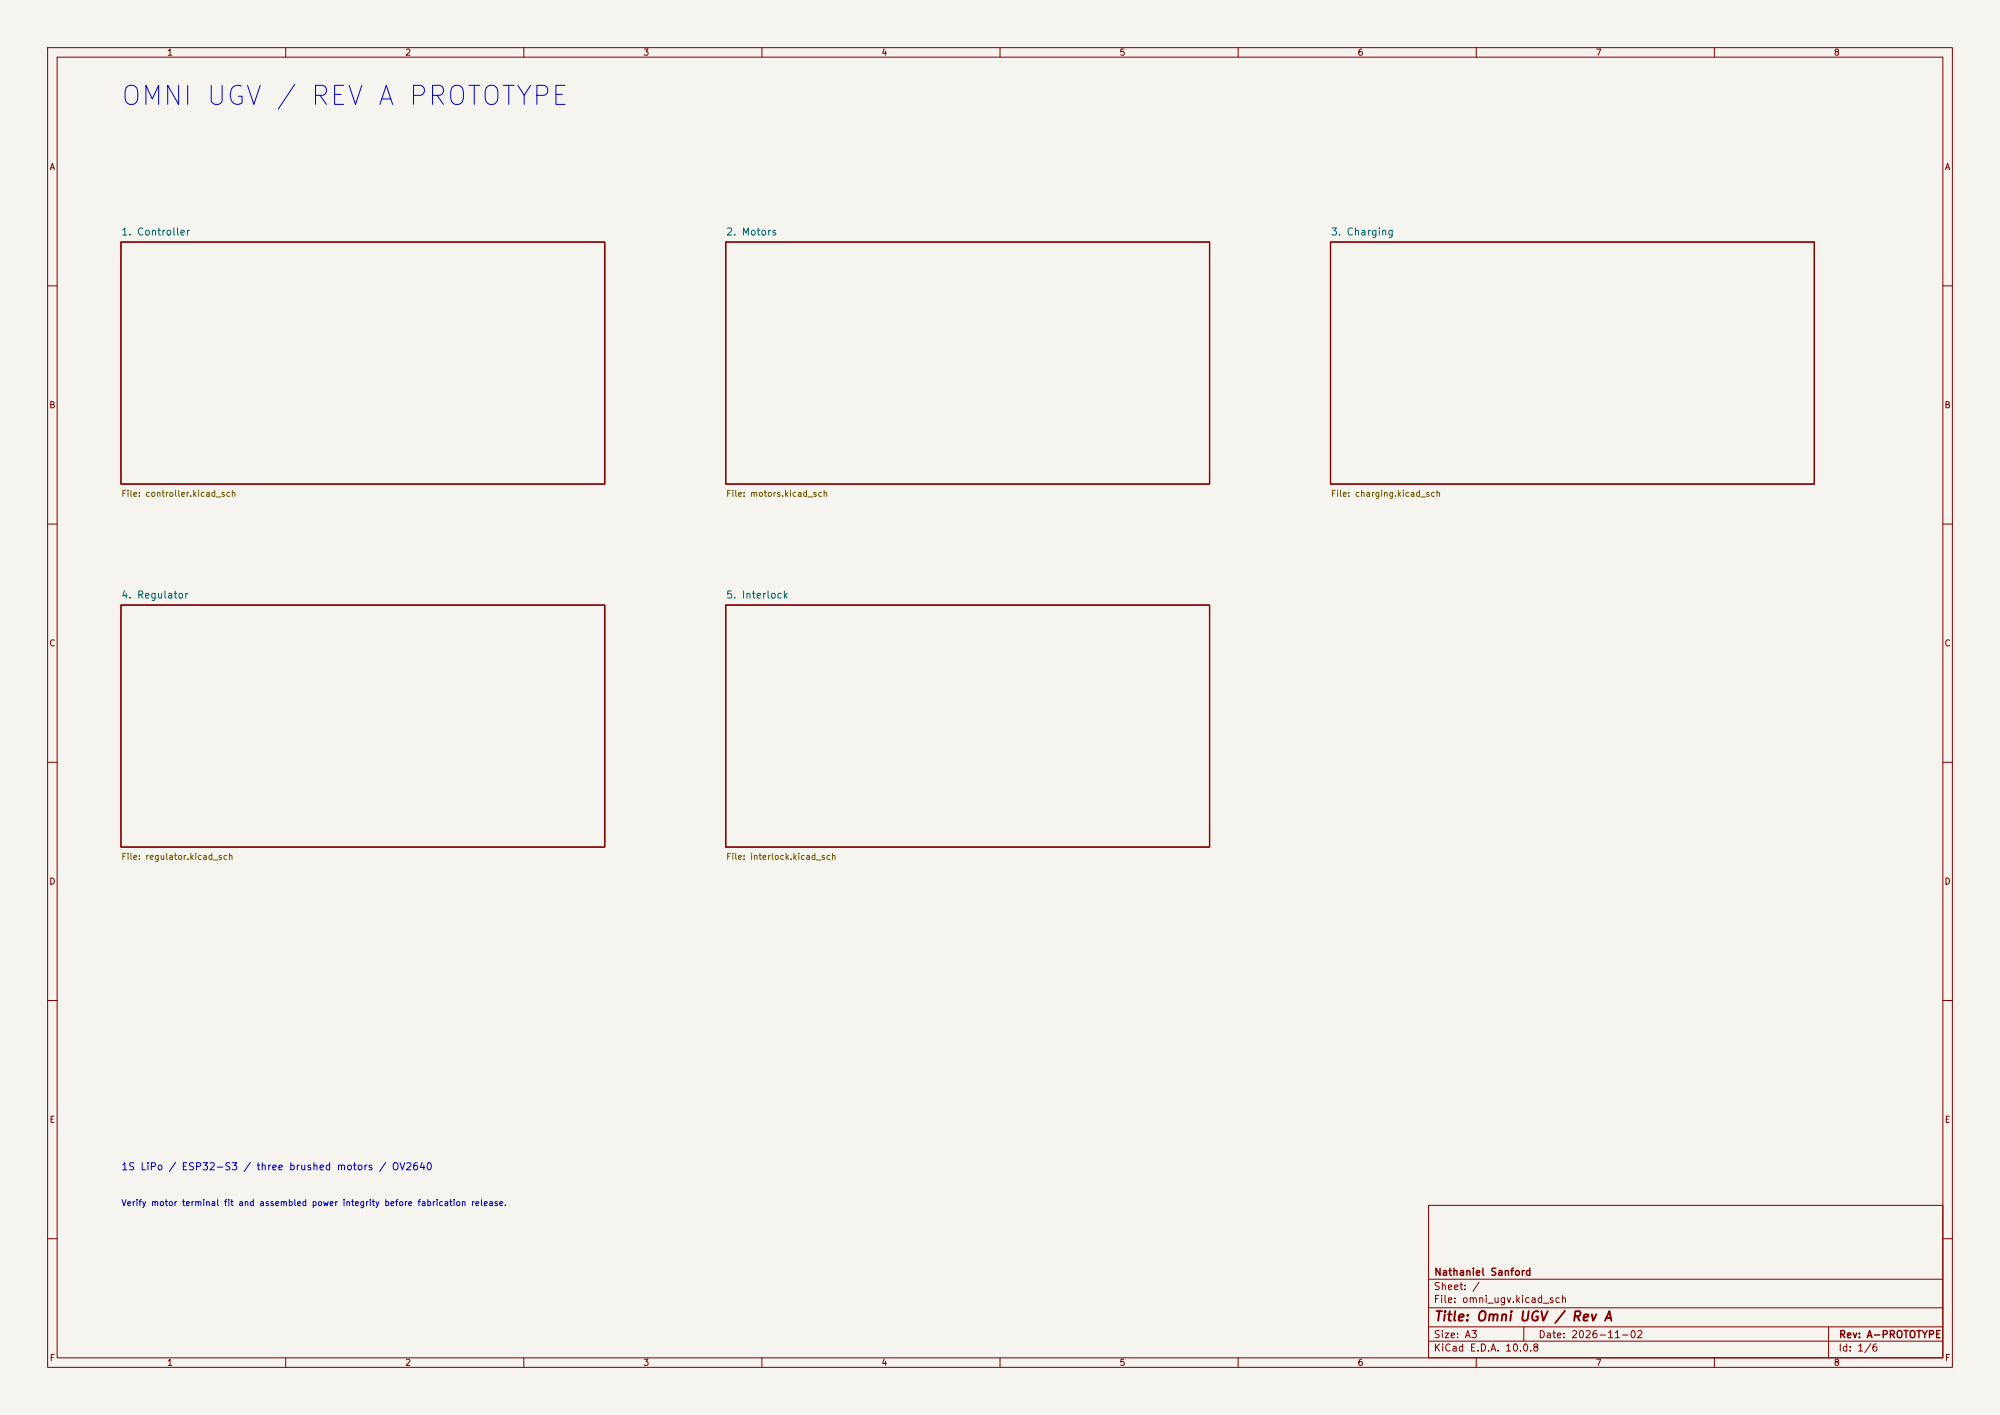
[picture p113: page 1]

Verify motor terminal fit and assembled power integrity before fabrication release. OMNI UGV / REV A PROTOTYPE

1S LiPo / ESP32-S3 / three brushed motors / OV2640

Nathaniel Sanford
Sheet: /
File: omni_ugv.kicad_sch
Title: Omni UGV / Rev A

Size: A3 | Rev: A-PROTOTYPE | F Date: 2026-11-02
KiCad E.D.A. 10.0.8 | Id: 1/6

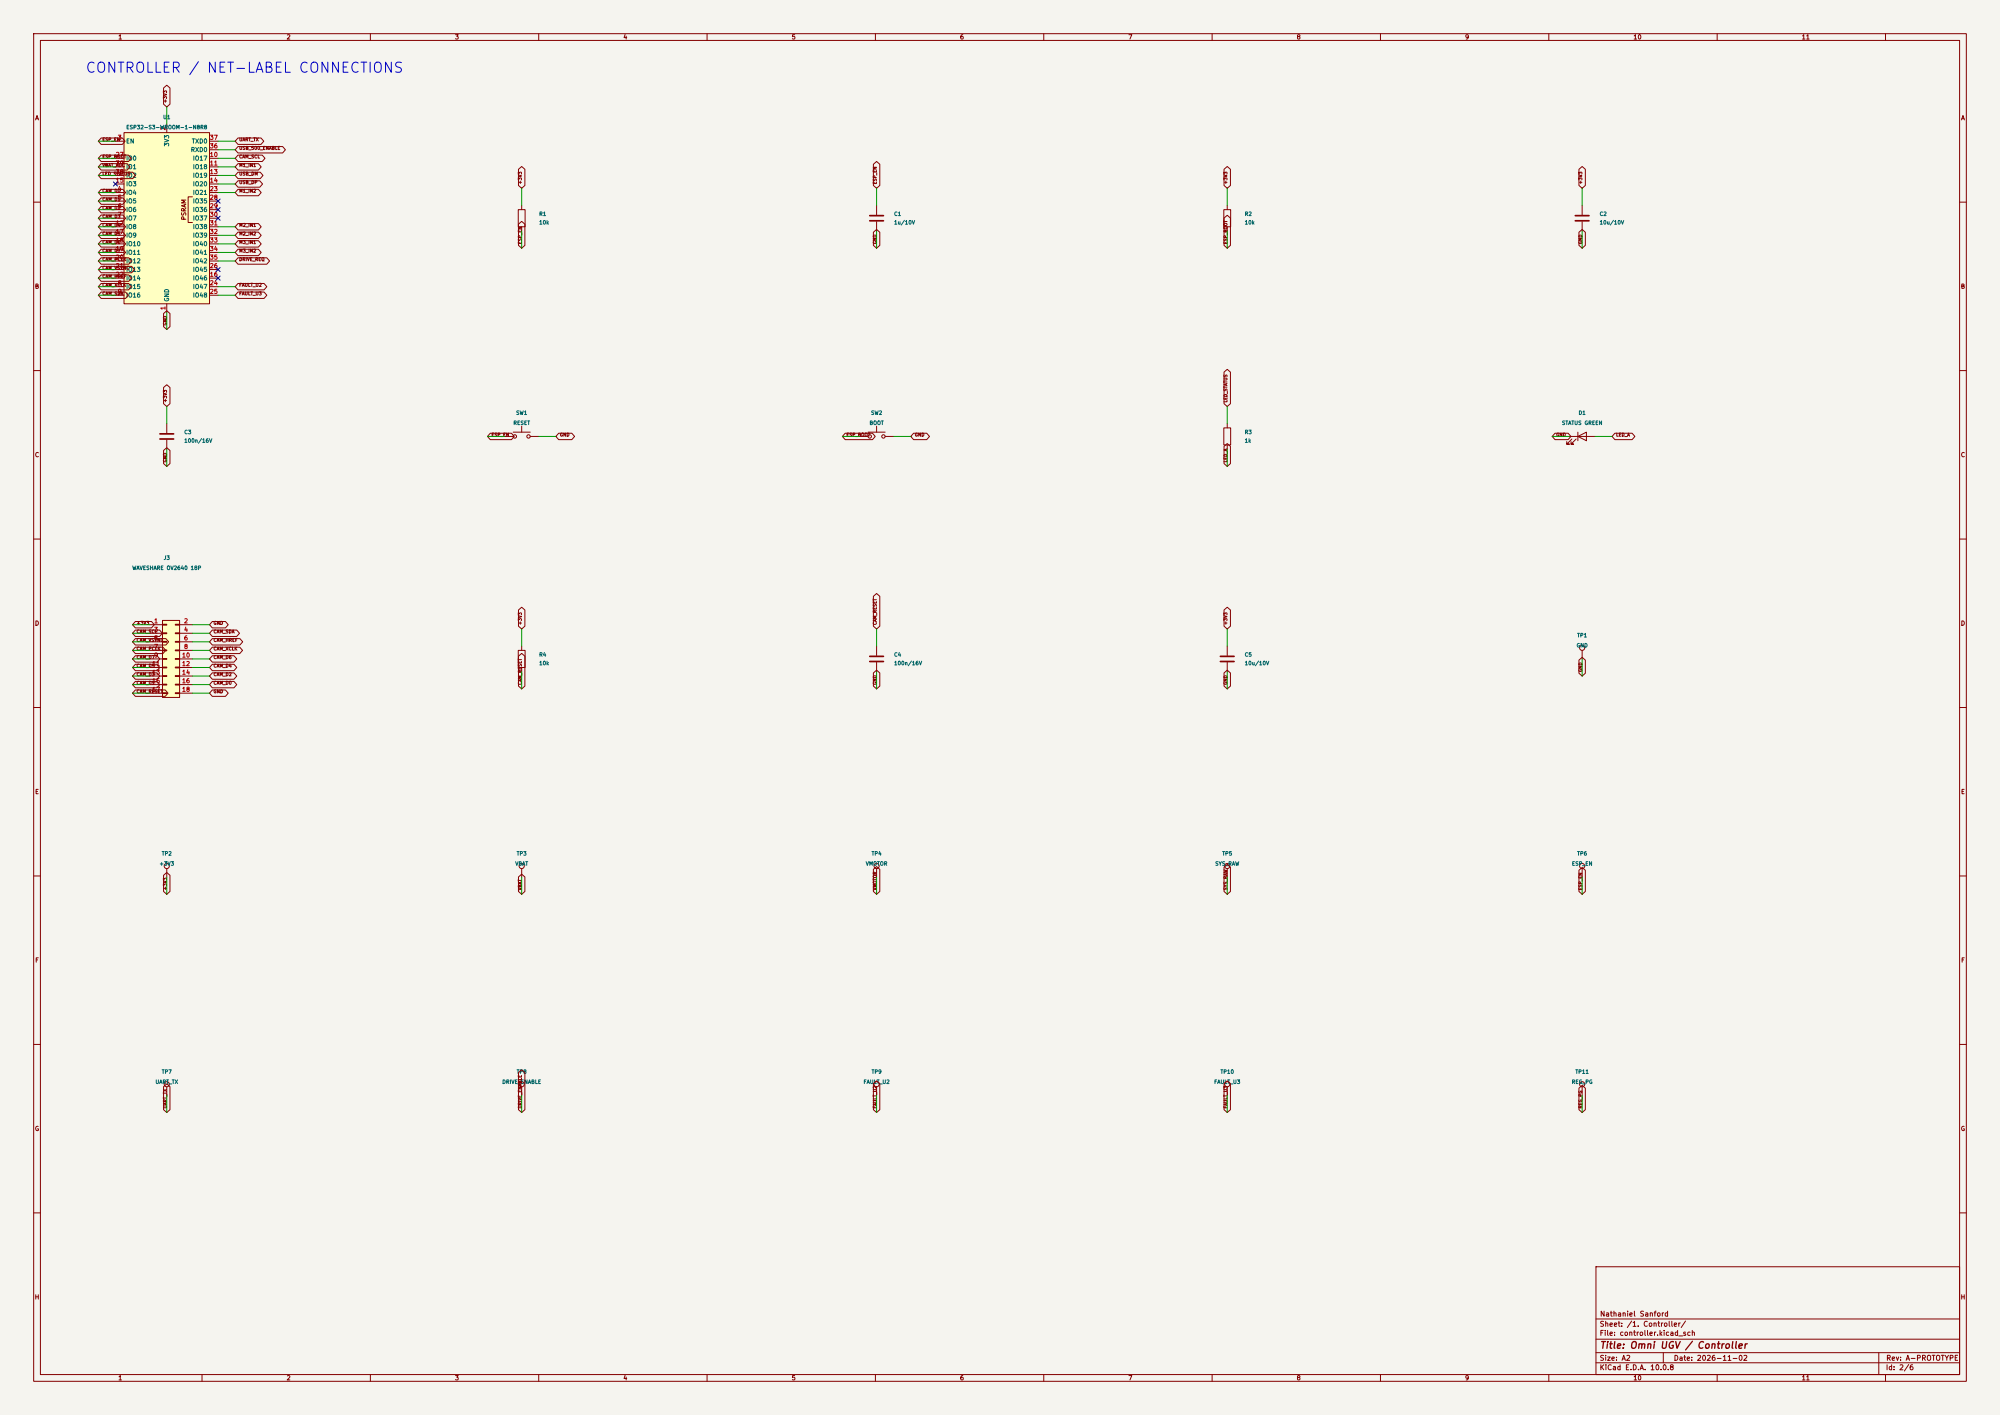
[picture p114: page 2]

CAM_SDA CAM_HREF CAM_PCLK +3V3 CONTROLLER / NET-LABEL CONNECTIONS

Nathaniel Sanford
Sheet: /1. Controller/
File: controller.kicad_sch
Title: Omni UGV / Controller

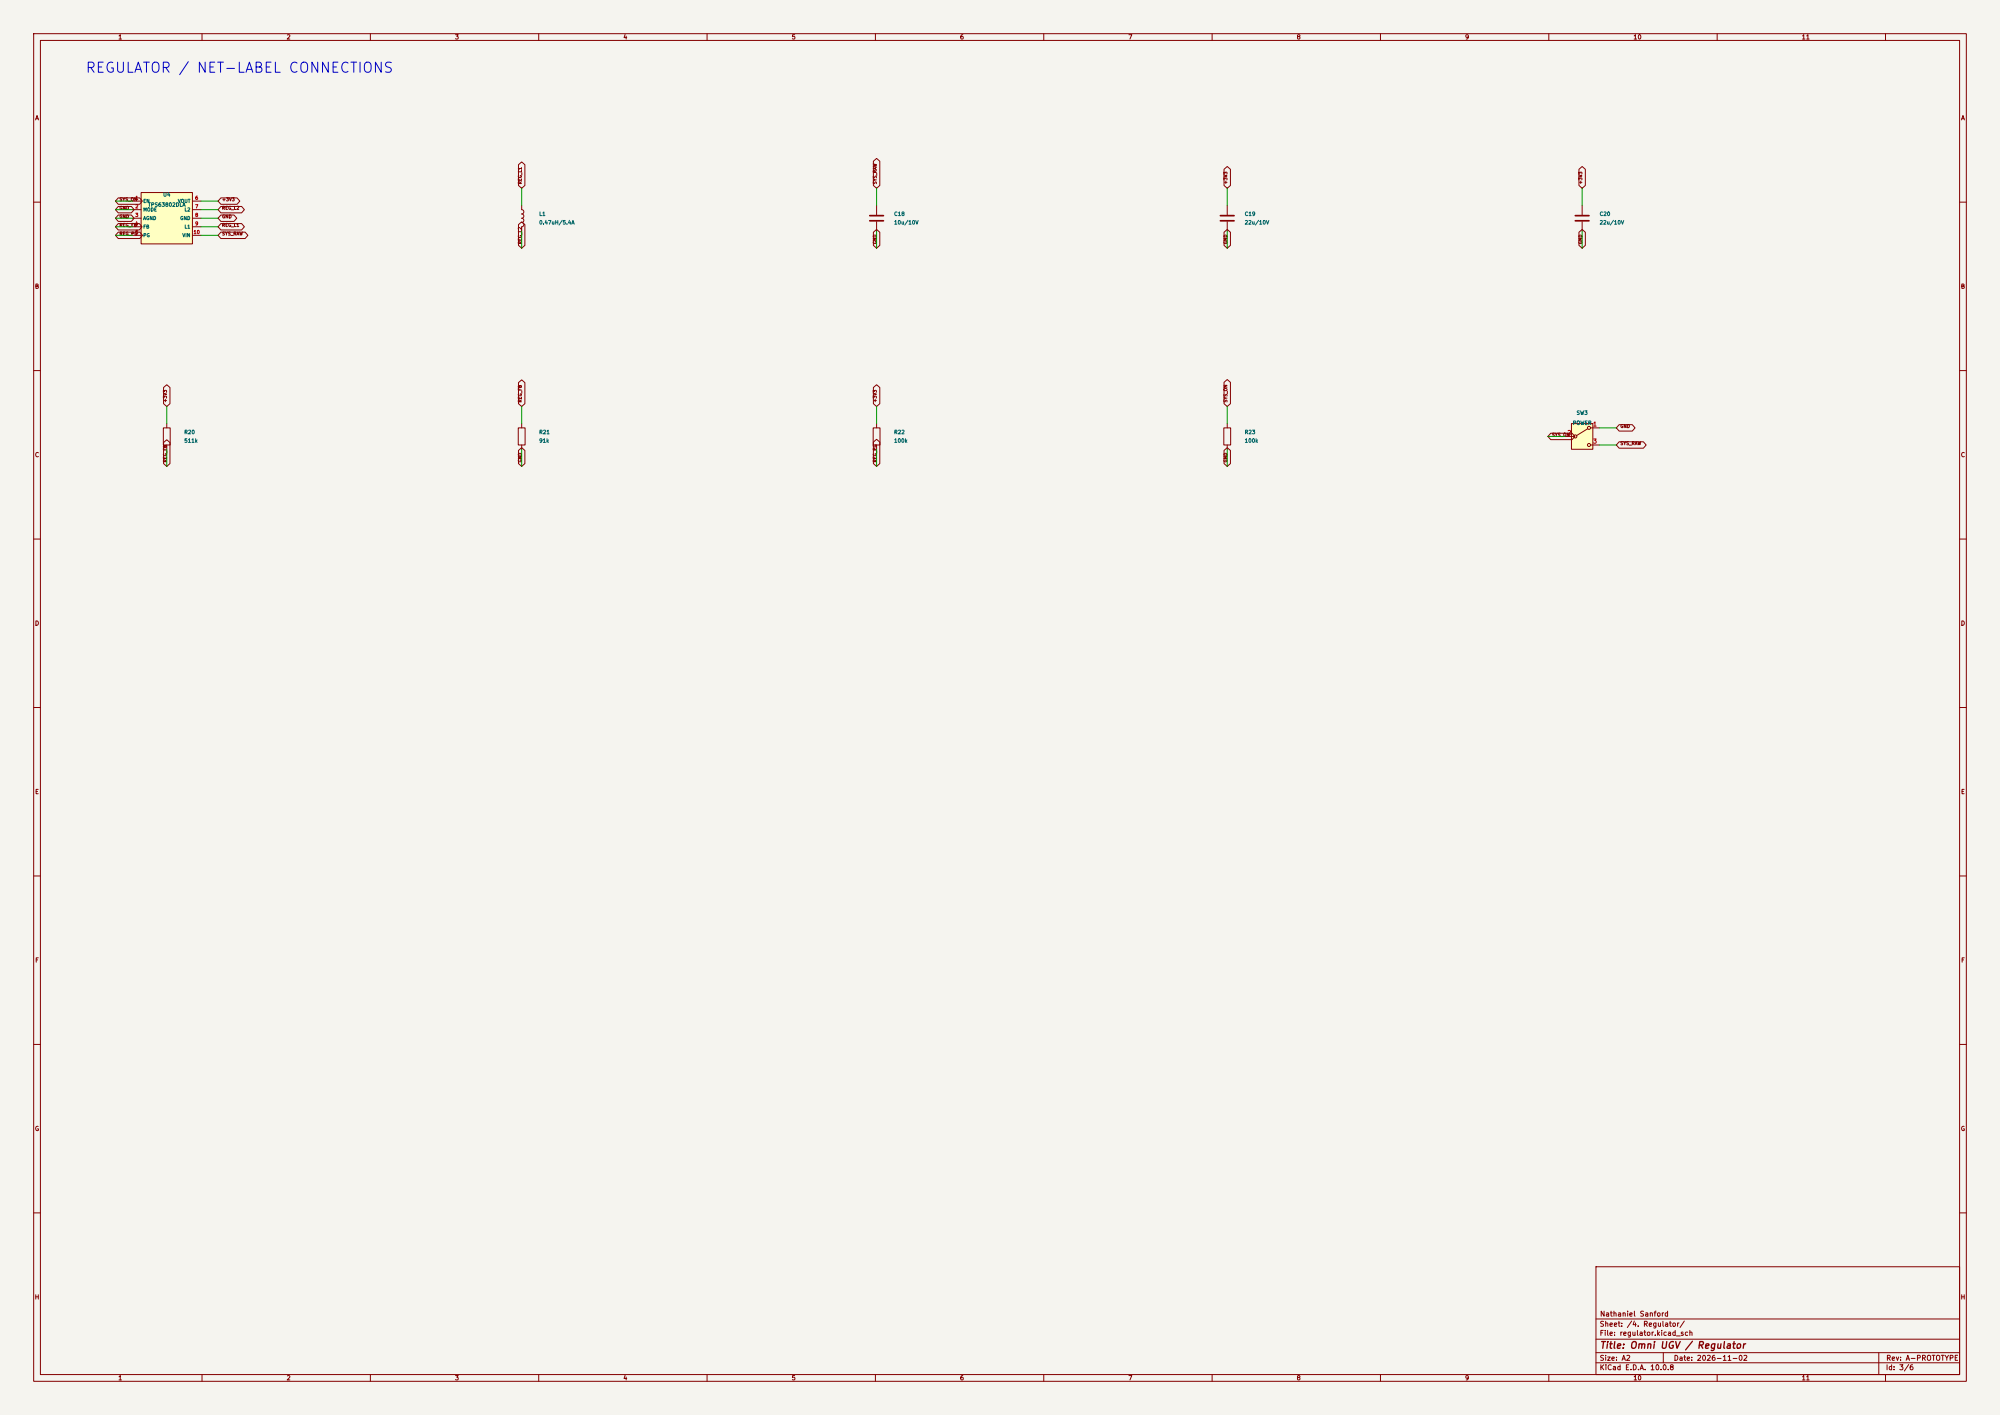
[picture p115: page 3]

REGULATOR / NET-LABEL CONNECTIONS

Sheet: /4. Regulator/
File: regulator.kicad_sch
Title: Omni UGV / Regulator

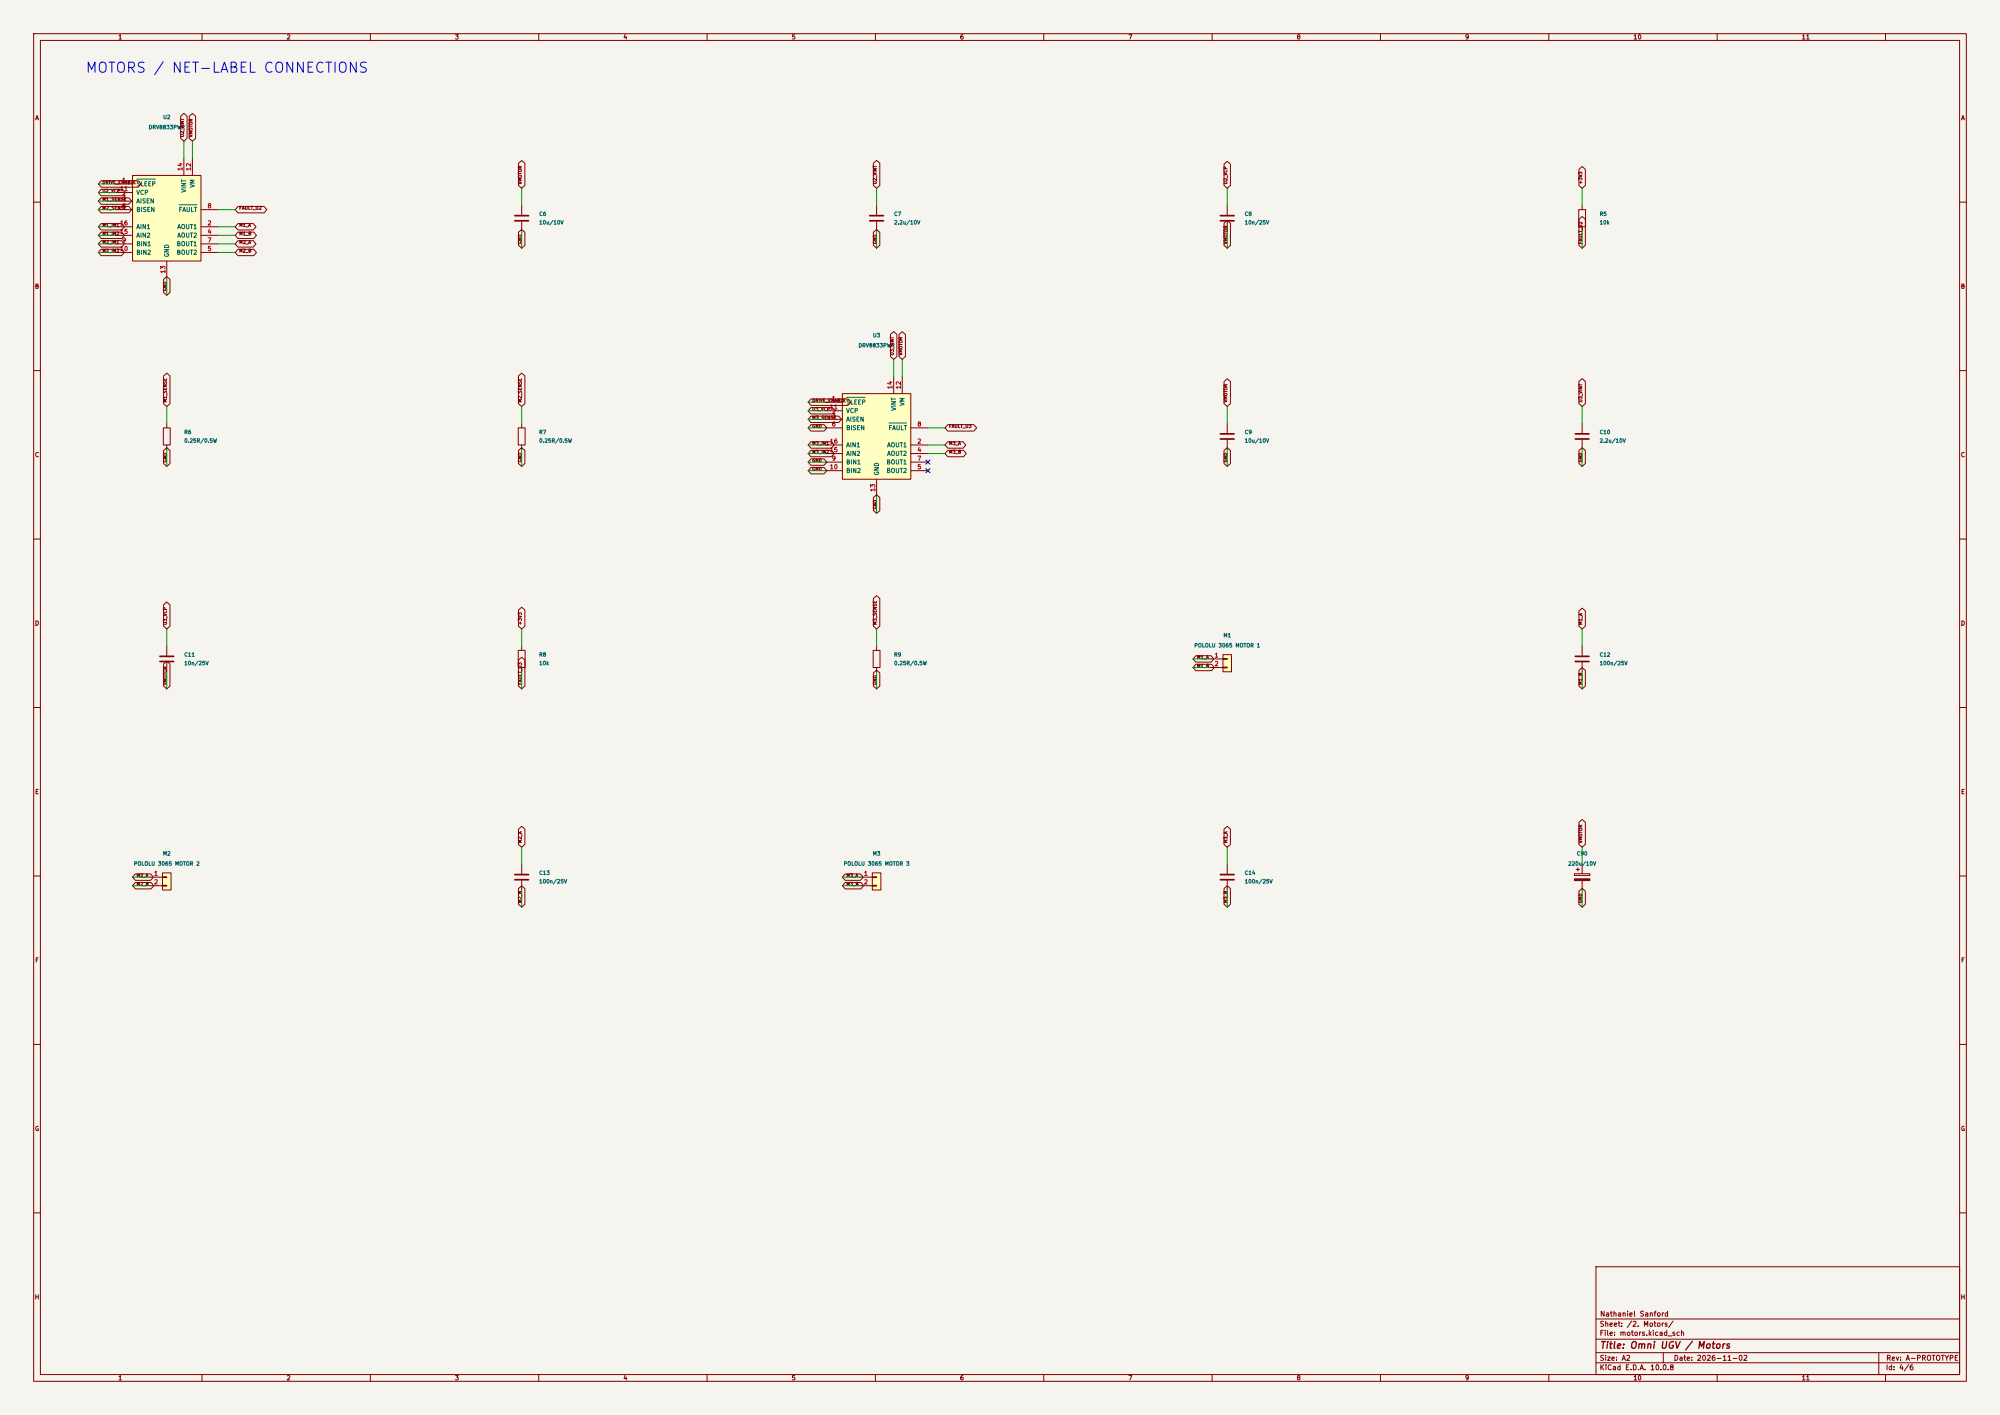
[picture p116: page 4]

MOTORS / NET-LABEL CONNECTIONS

Sheet: /2. Motors/
File: motors.kicad_sch
Title: Omni UGV / Motors

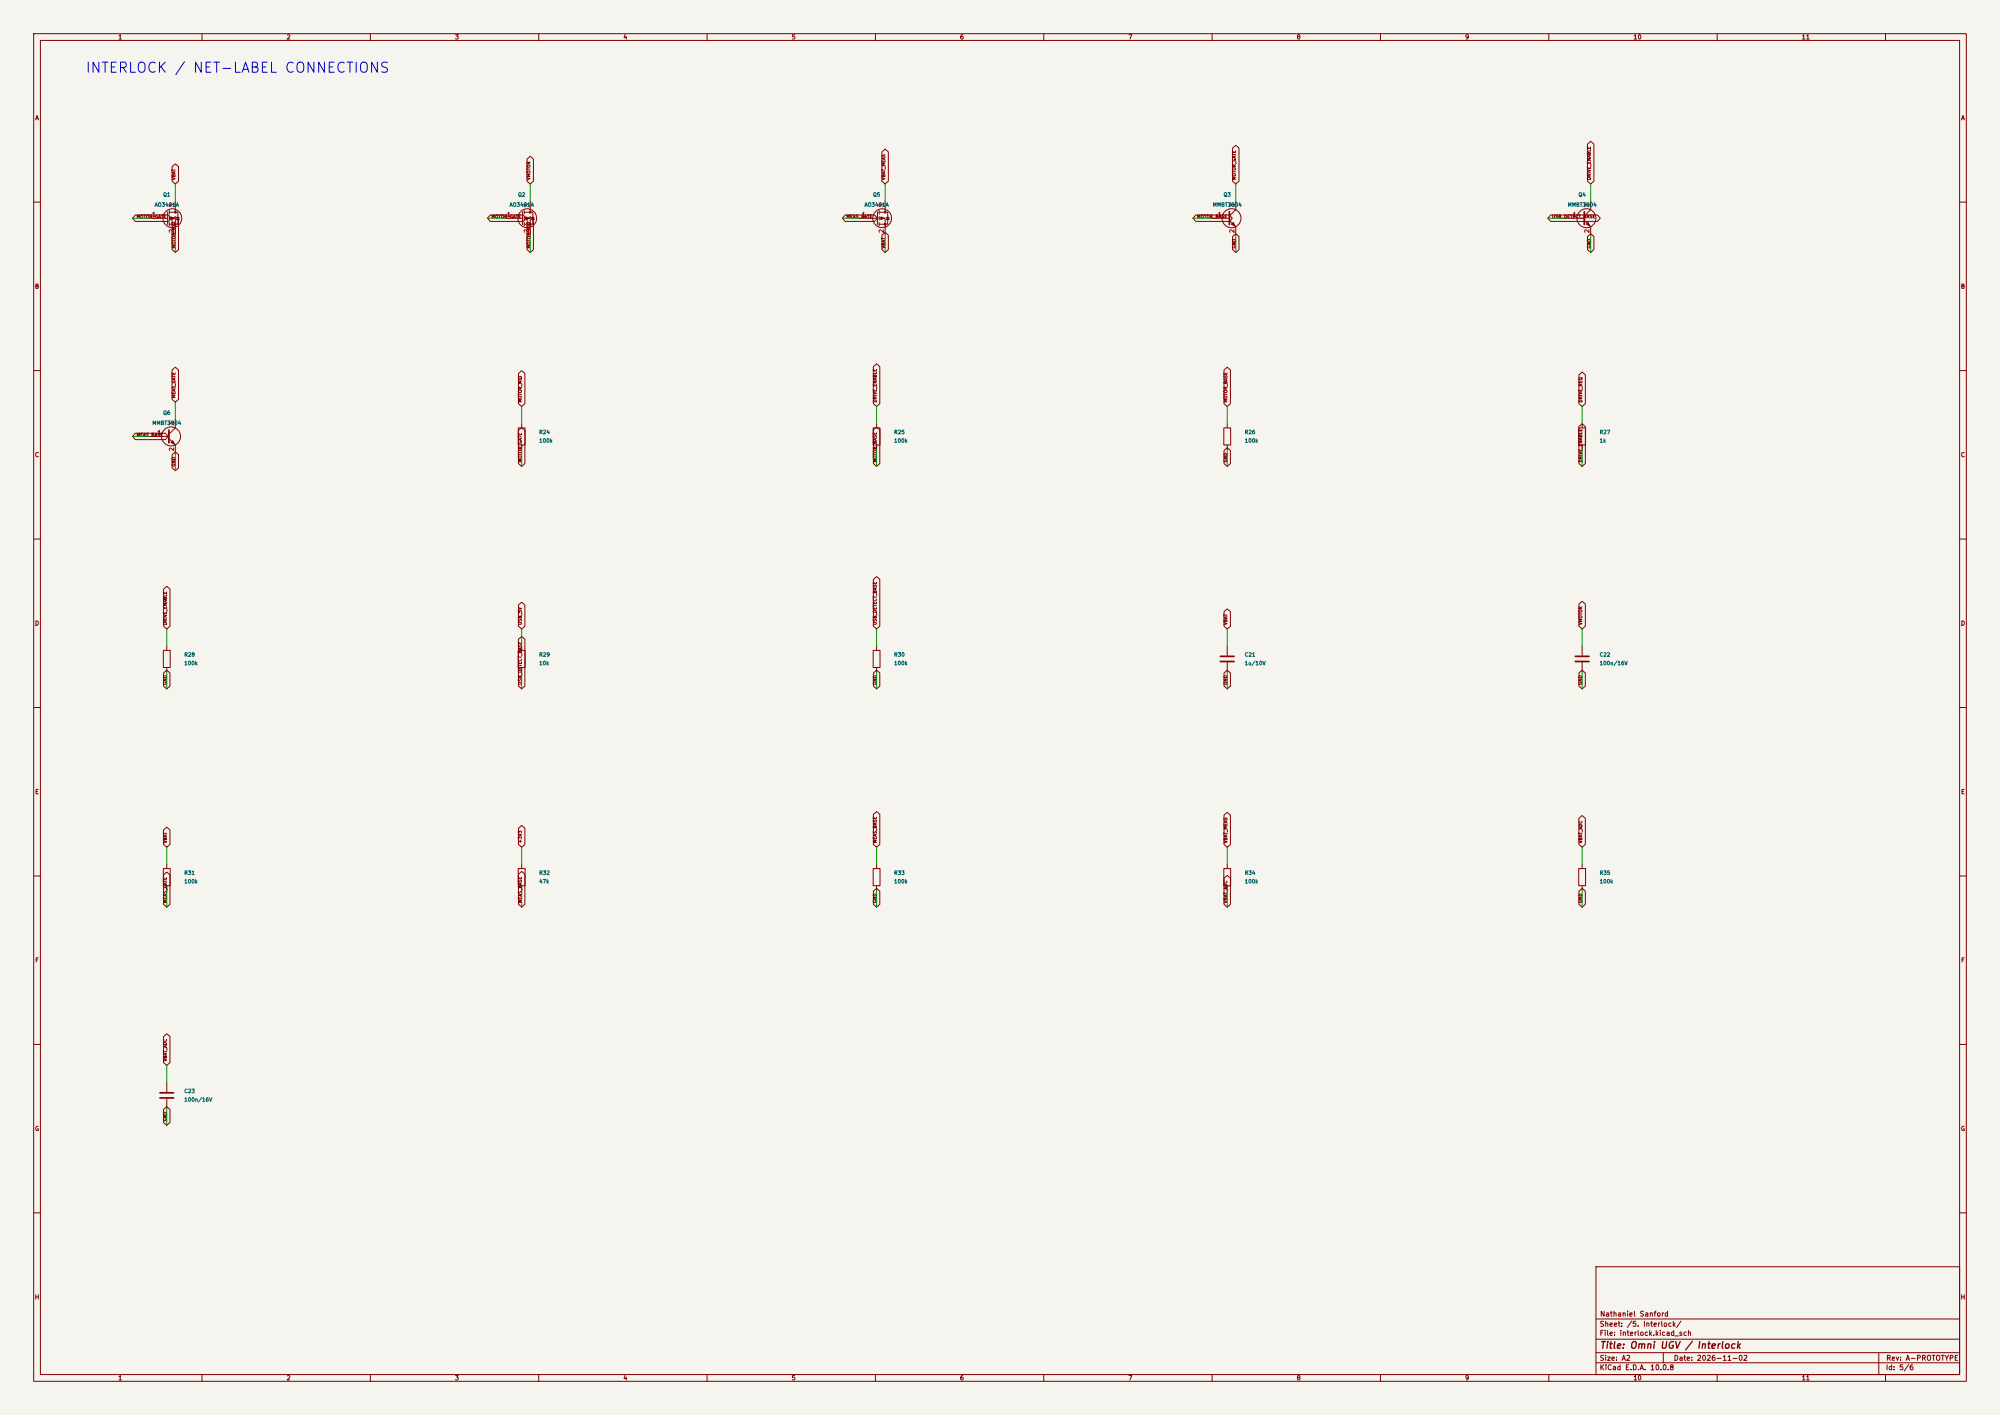
[picture p117: page 5]

INTERLOCK / NET-LABEL CONNECTIONS

Sheet: /5. Interlock/
File: interlock.kicad_sch
Title: Omni UGV / Interlock

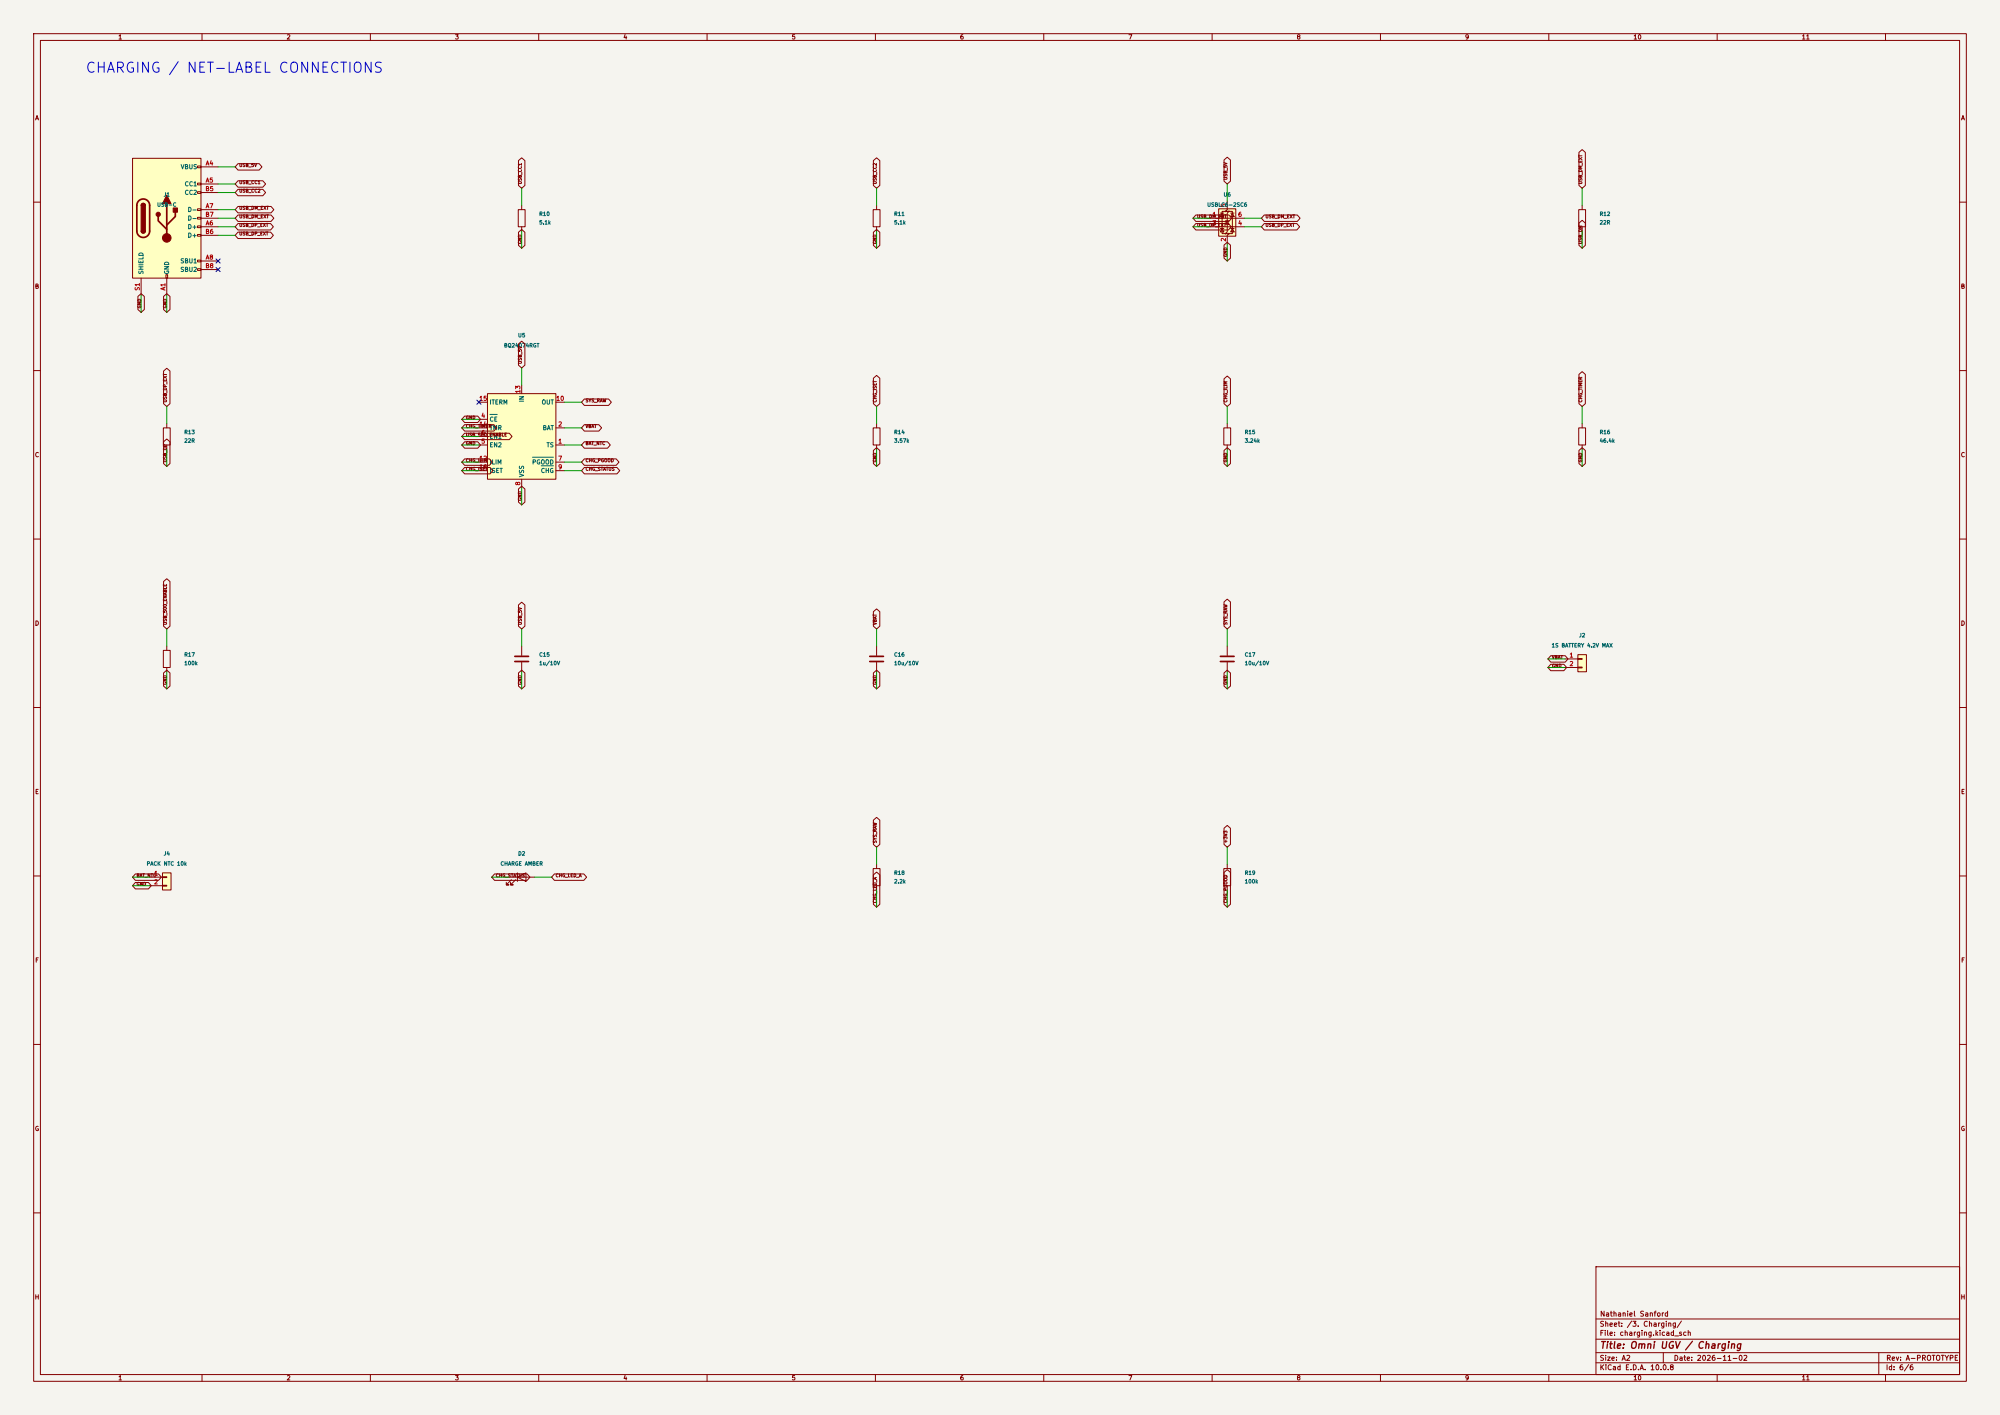
[picture p118: page 6]

CHG_PGOOD CHARGING / NET-LABEL CONNECTIONS

Sheet: /3. Charging/
File: charging.kicad_sch
Title: Omni UGV / Charging
