ncripted/DAMIEN/outputs/rover/Omni_UGV_Rev_B_protection/Schematic.pdf

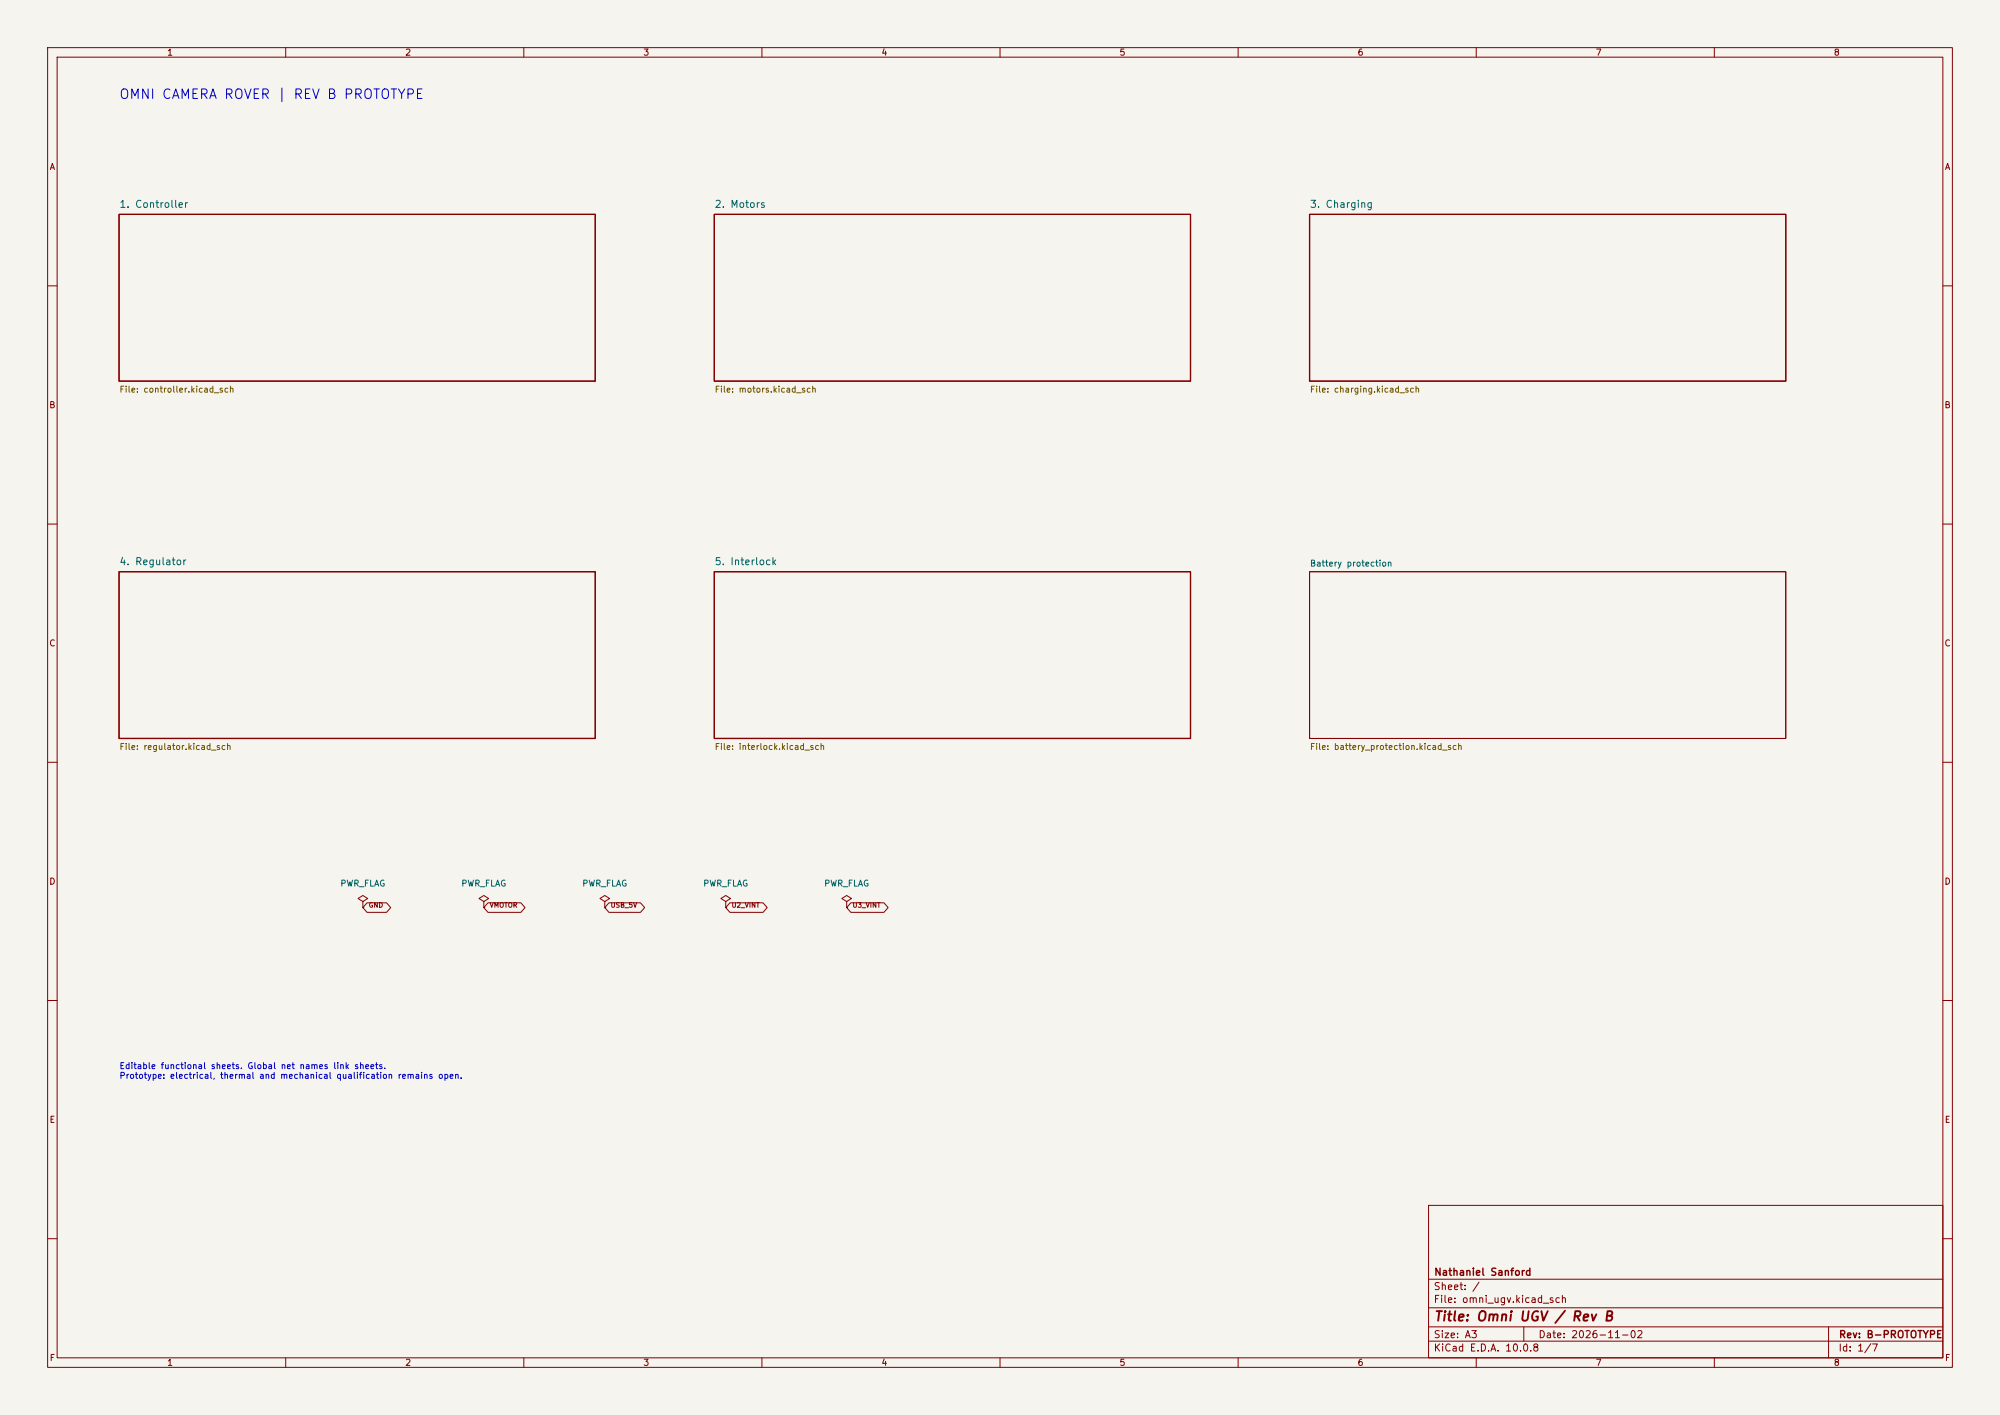
[picture p119: page 1]

OMNI CAMERA ROVER | REV B PROTOTYPE

Nathaniel Sanford
Sheet: /
File: omni_ugv.kicad_sch
Title: Omni UGV / Rev B

Size: A3 | Rev: B-PROTOTYPE | F Date: 2026-11-02
KiCad E.D.A. 10.0.8 | Id: 1/7

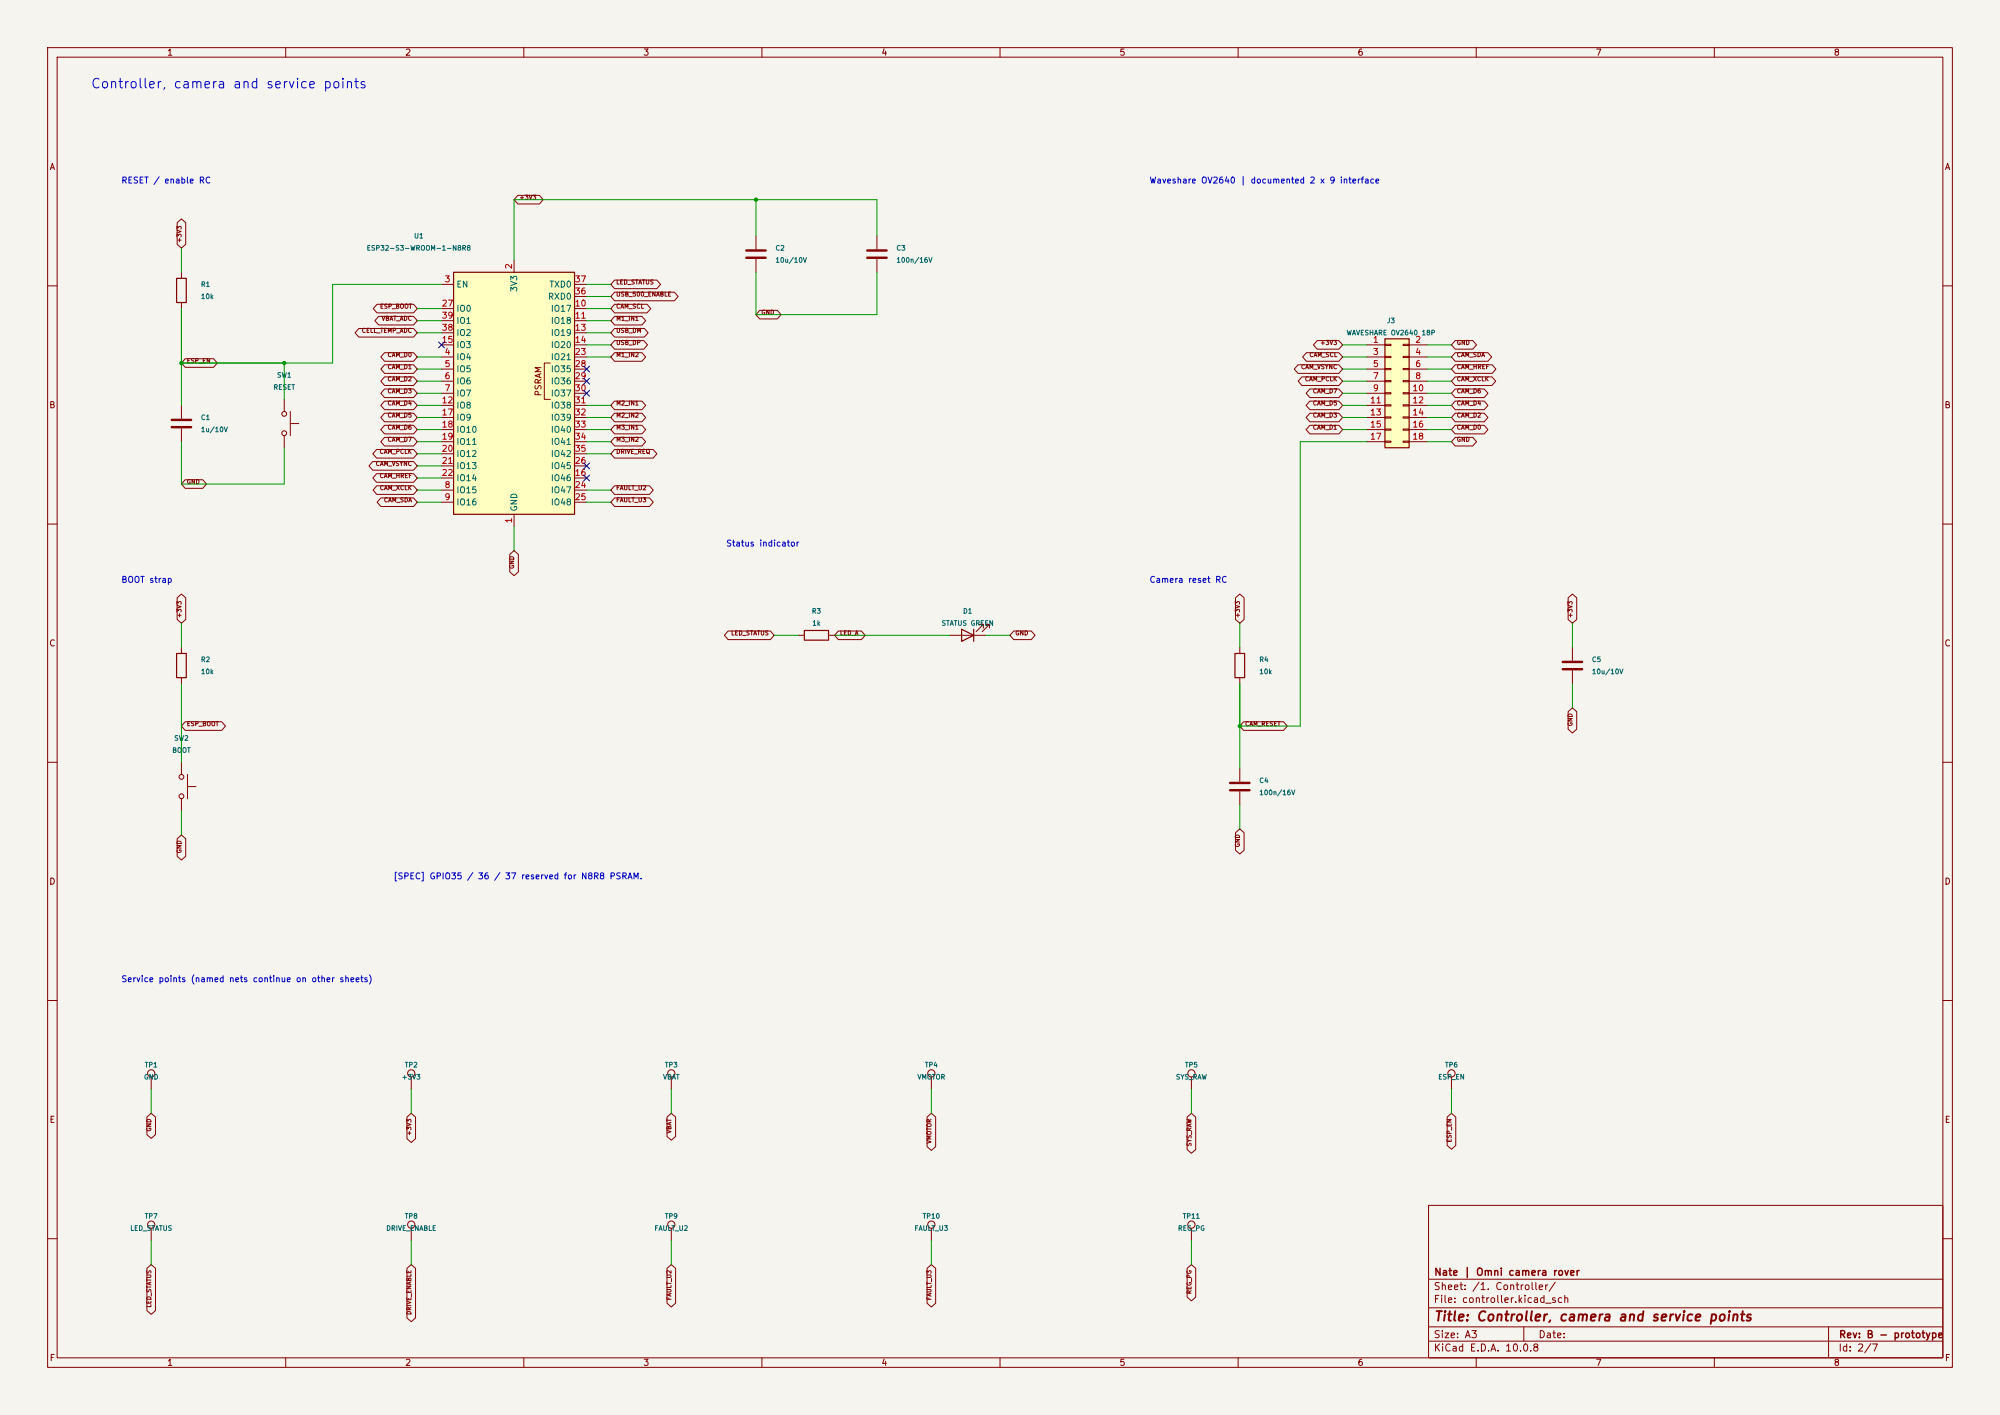
[picture p120: page 2]

Controller, camera and service points

[SPEC] GPIO35 / 36 / 37 reserved for N8R8 PSRAM.

Service points (named nets continue on other sheets)

Nate | Omni camera rover
Sheet: /1. Controller/
File: controller.kicad_sch
Title: Controller, camera and service points

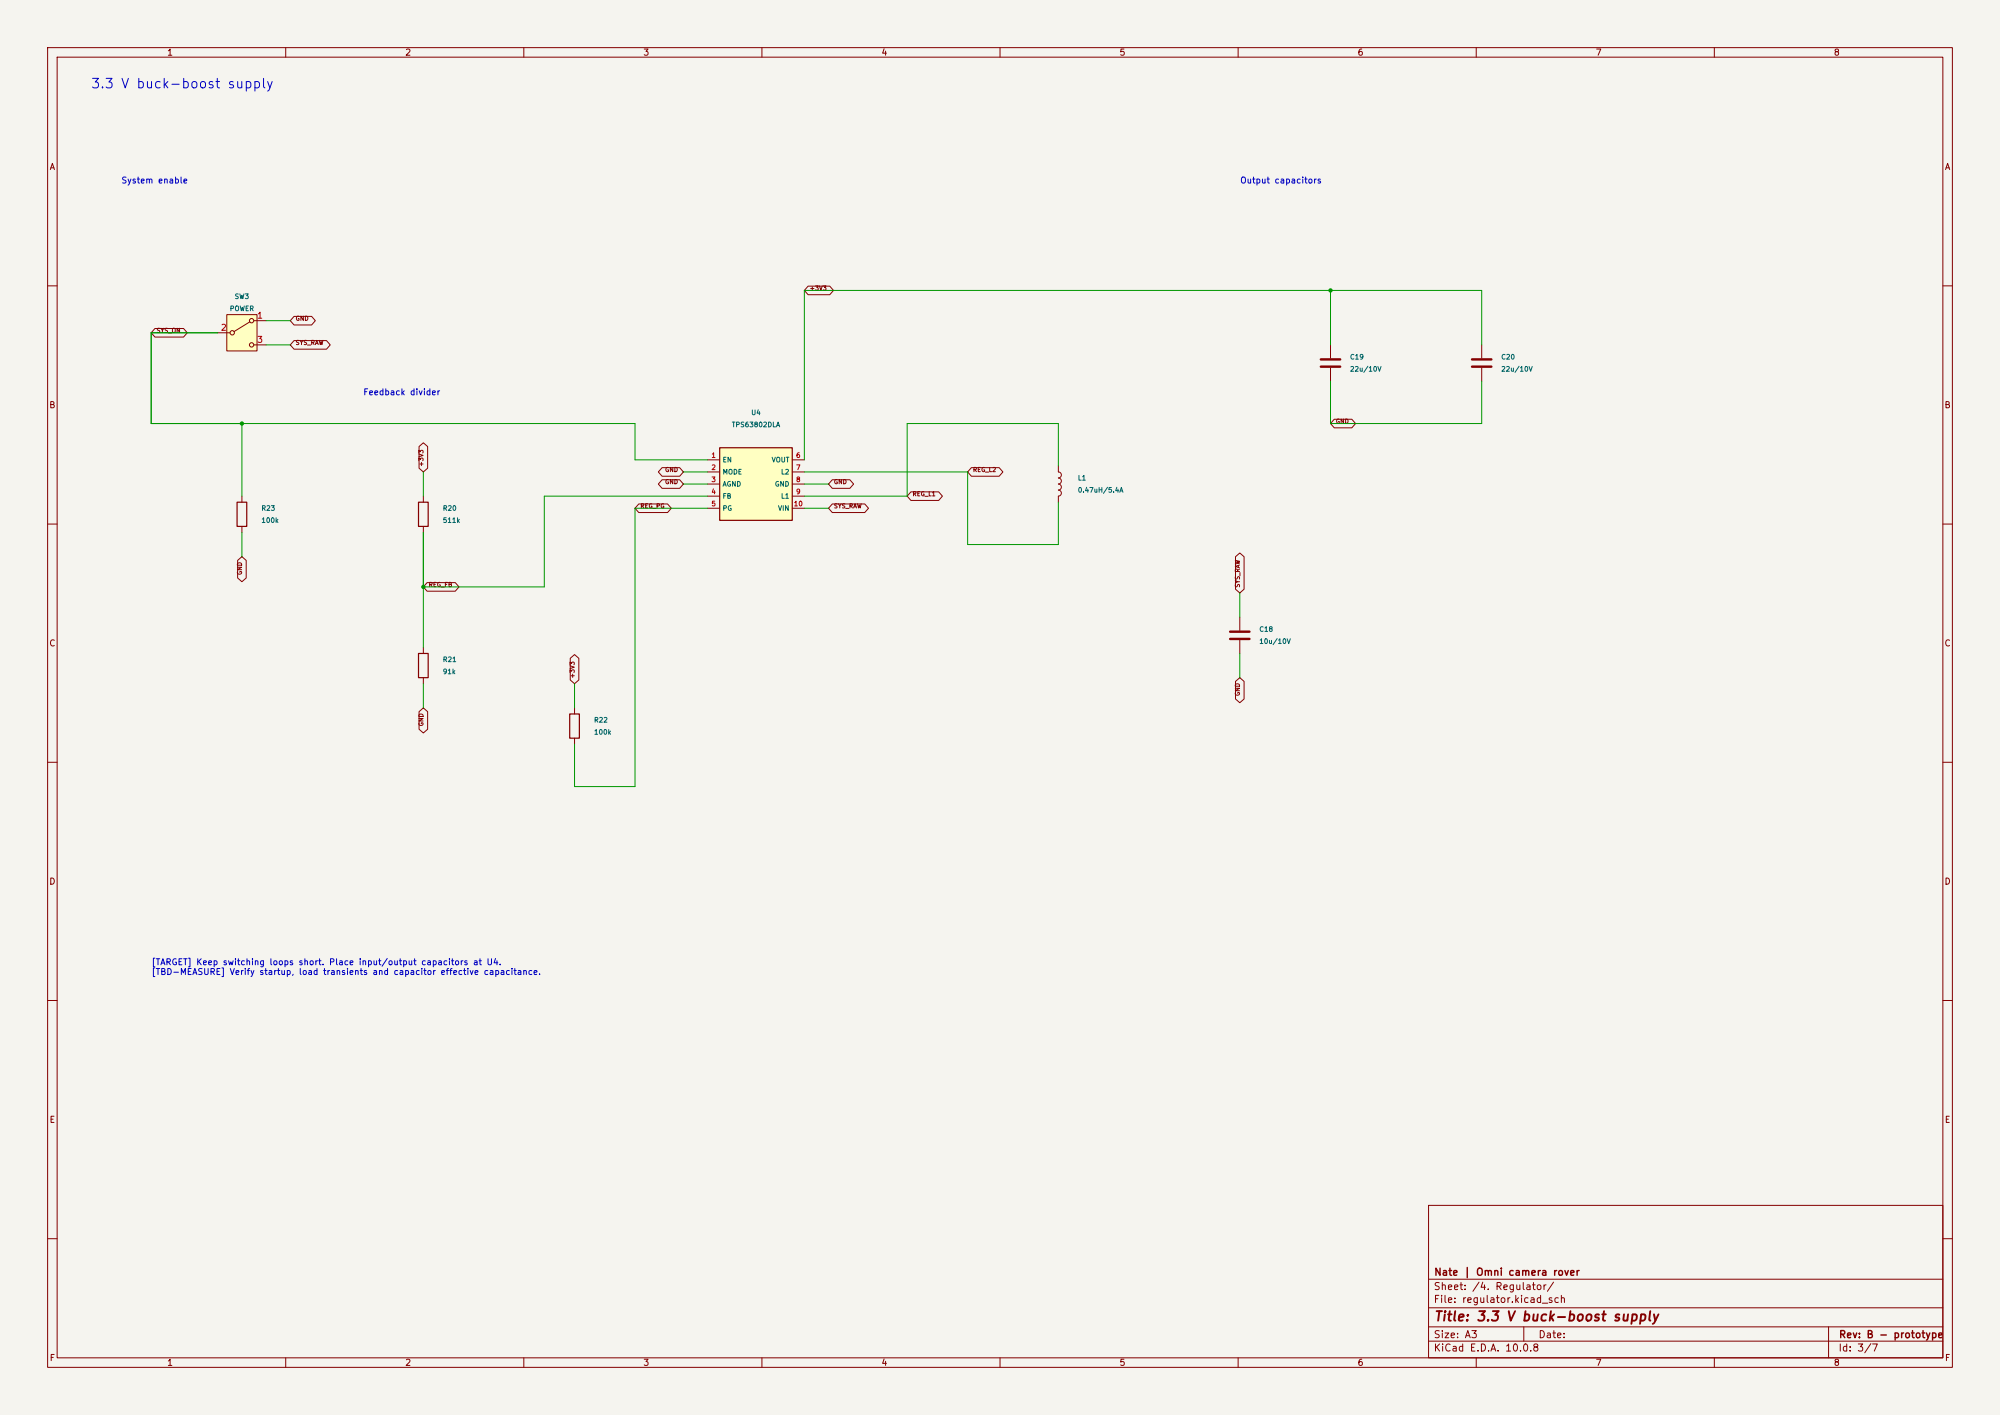
[picture p121: page 3]

[TARGET] Keep switching loops short. Place input/output capacitors at U4. [TBD-MEASURE] Verify startup, load transients and capacitor effective capacitance.

Nate | Omni camera rover
Sheet: /4. Regulator/
File: regulator.kicad_sch
Title: 3.3 V buck-boost supply

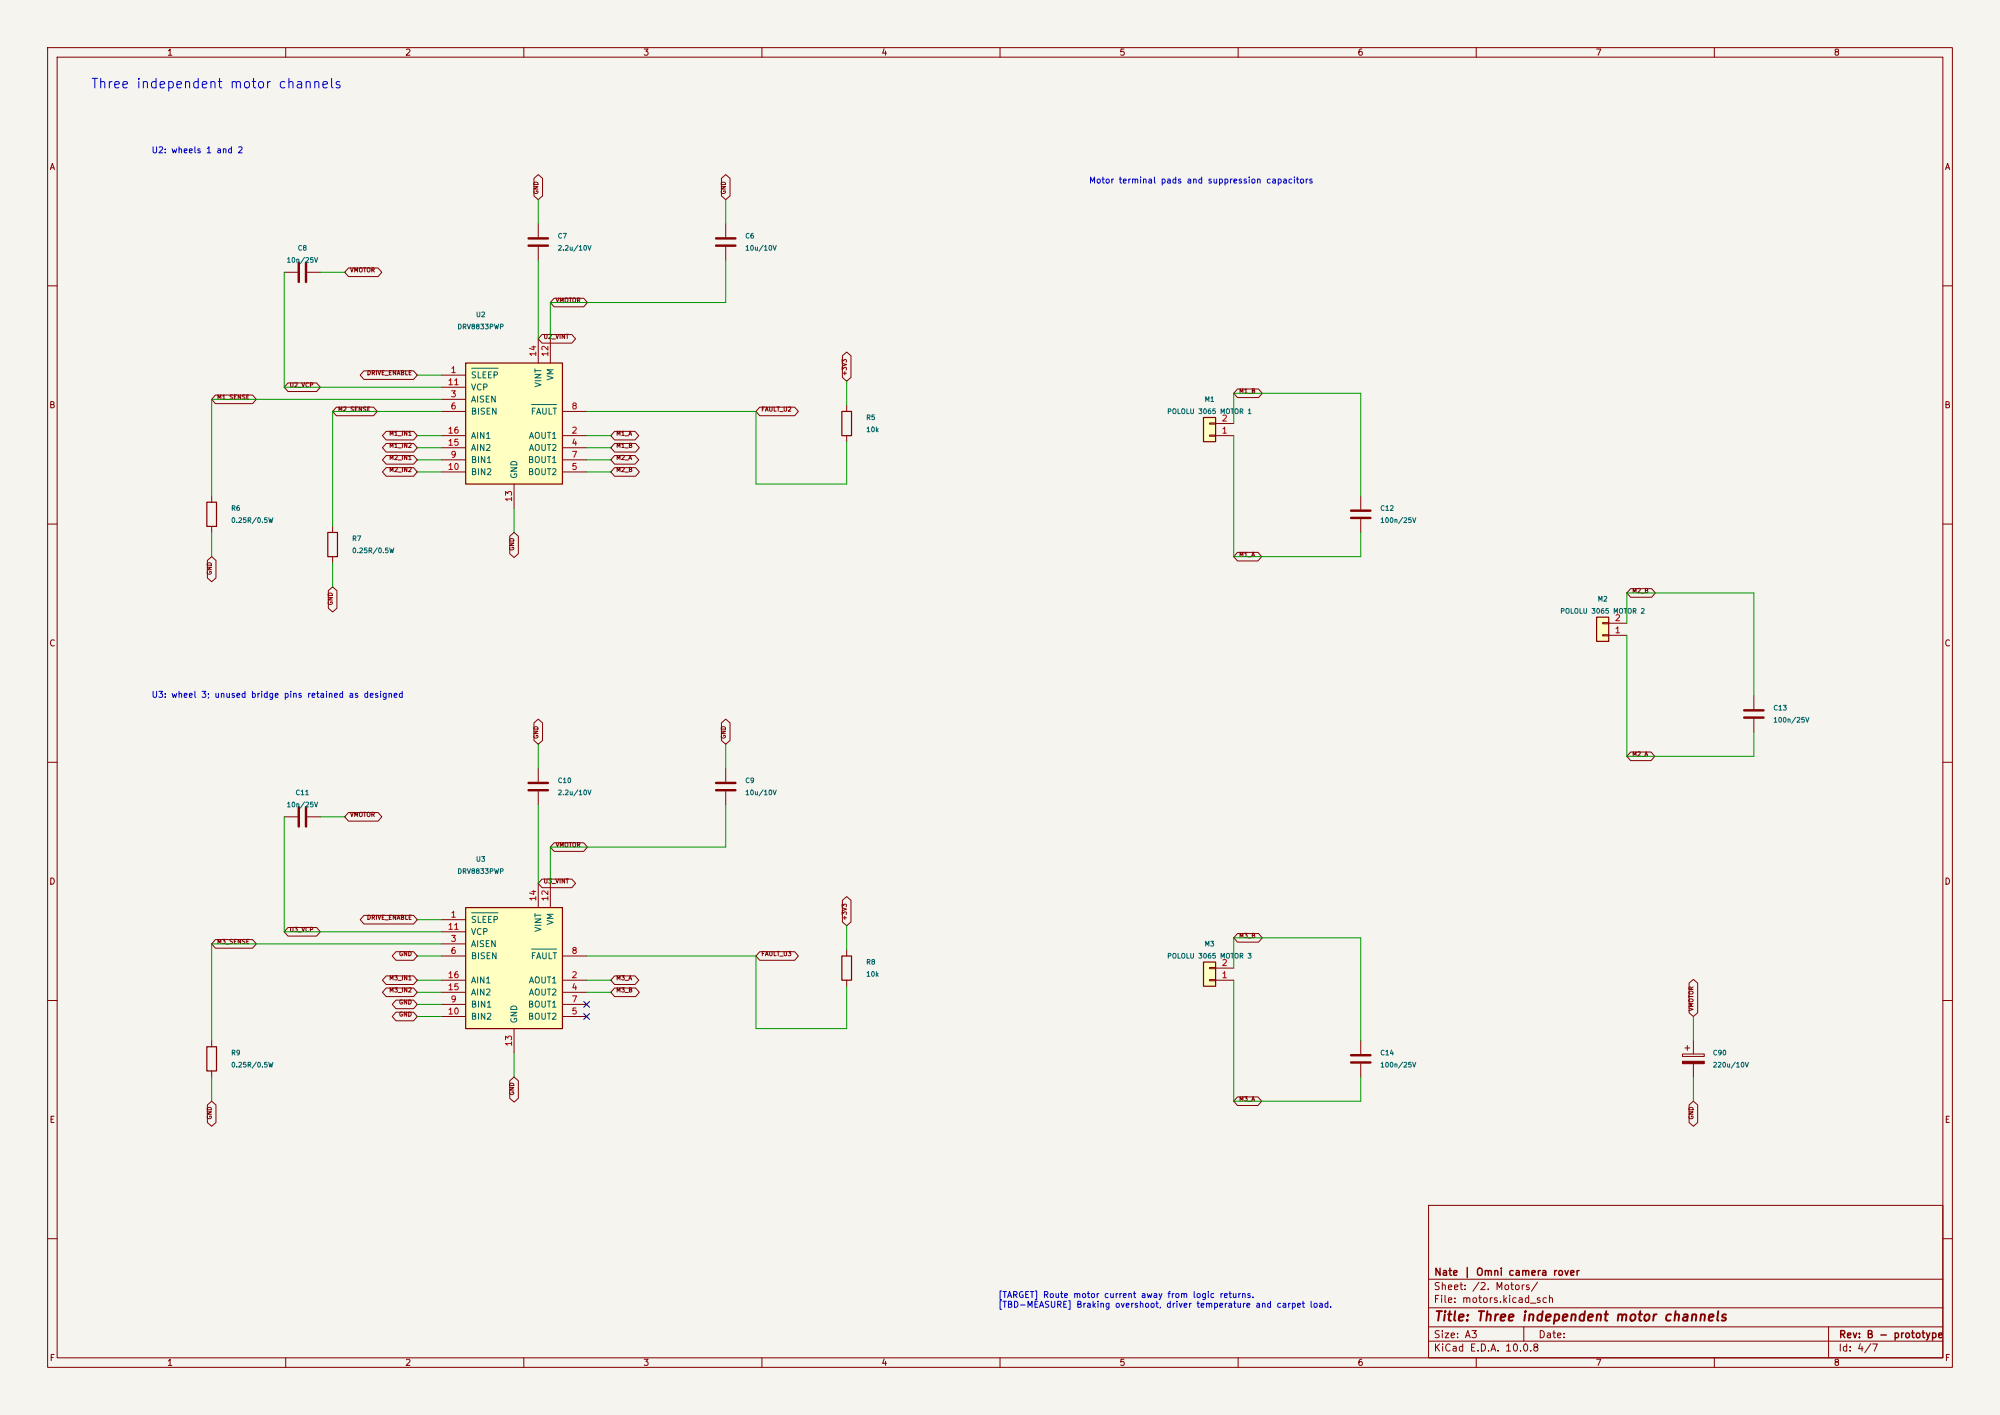
[picture p122: page 4]

Three independent motor channels
U2: wheels 1 and 2 U3: wheel 3; unused bridge pins retained as designed

Nate | Omni camera rover R8

Sheet: /2. Motors/
File: motors.kicad_sch
Title: Three independent motor channels

[TARGET] Route motor current away from logic returns. [TBD-MEASURE] Braking overshoot, driver temperature and carpet load.

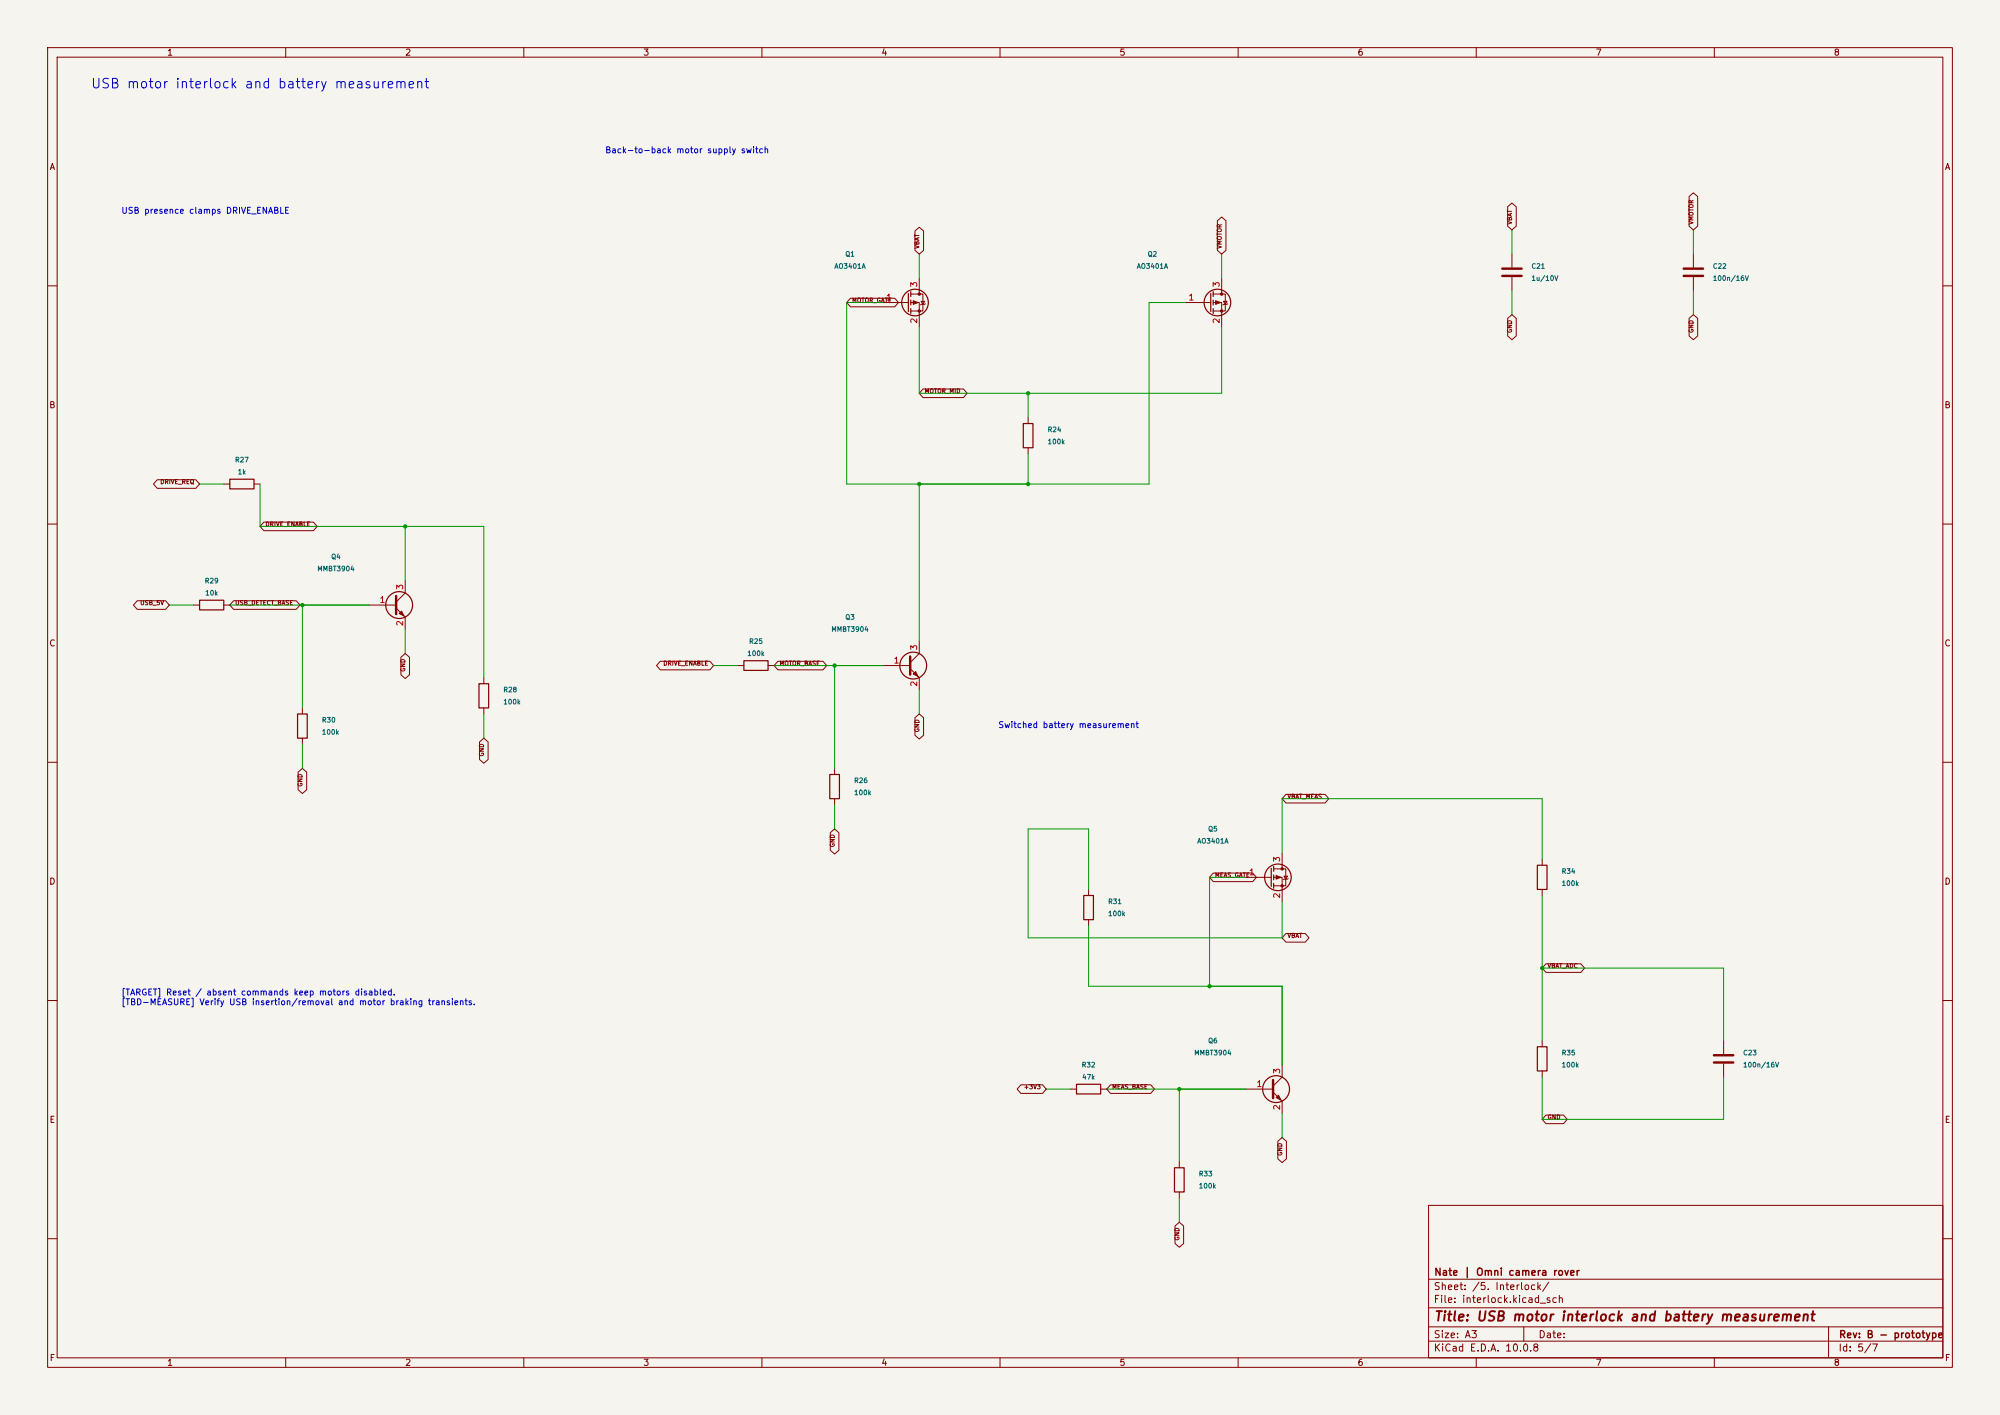
[picture p123: page 5]

Back-to-back motor supply switch
VBAT_ADC VMOTOR

[TARGET] Reset / absent commands keep motors disabled. [TBD-MEASURE] Verify USB insertion/removal and motor braking transients.

Nate | Omni camera rover R32

Sheet: /5. Interlock/
File: interlock.kicad_sch
Title: USB motor interlock and battery measurement

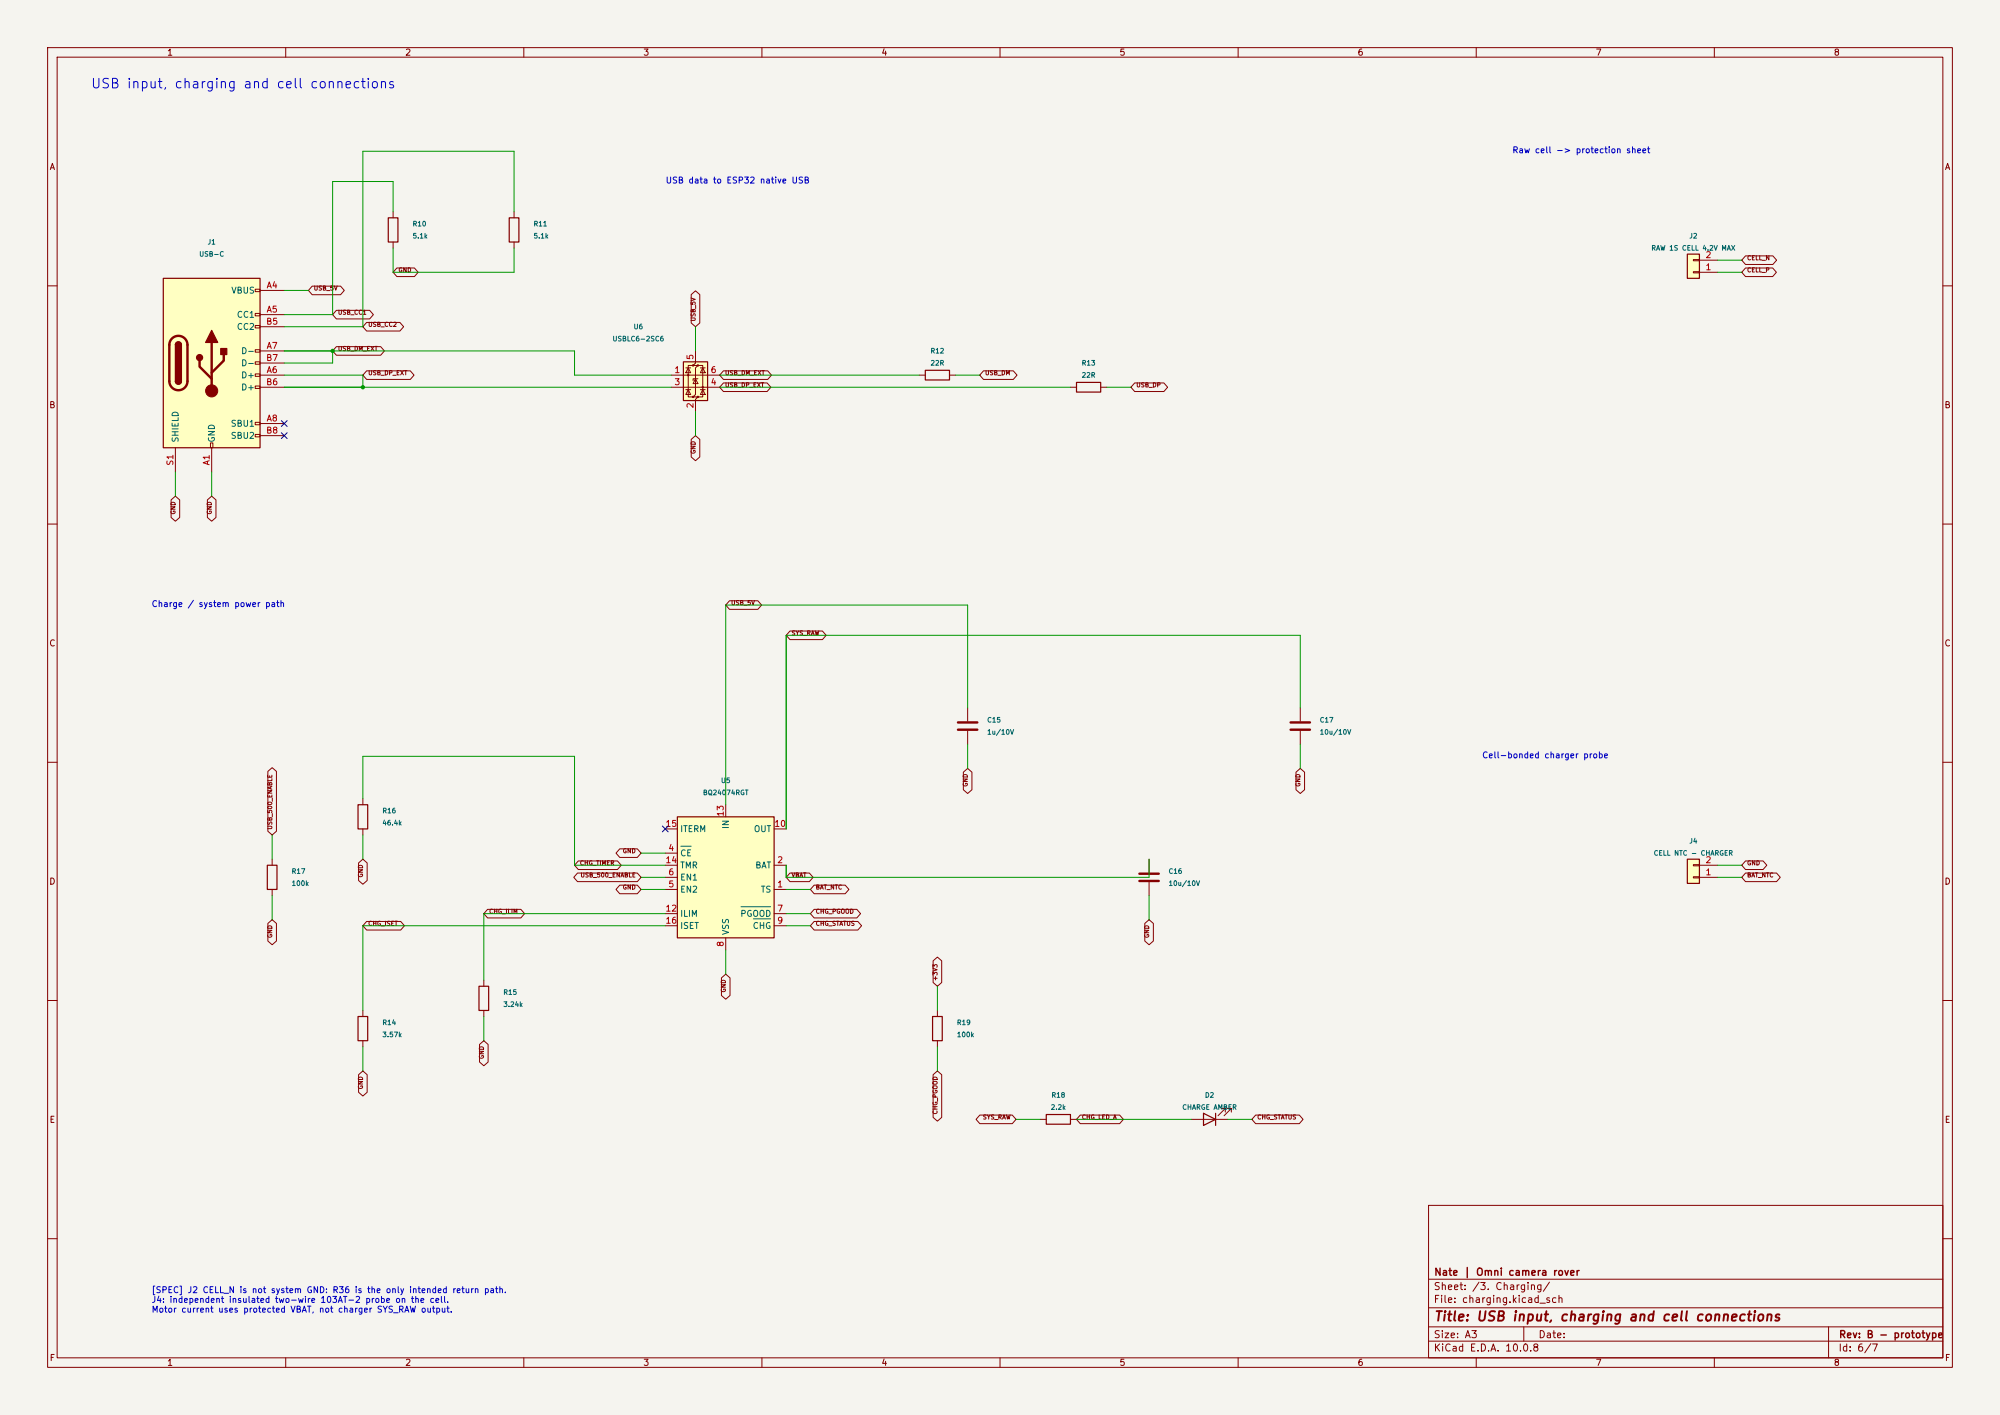
[picture p124: page 6]

Raw cell -> protection sheet USB input, charging and cell connections
GND
100k GND A1

USB data to ESP32 native USB

Charge / system power path

Cell-bonded charger probe

Nate | Omni camera rover
Sheet: /3. Charging/
File: charging.kicad_sch
Title: USB input, charging and cell connections

[SPEC] J2 CELL_N is not system GND: R36 is the only intended return path. J4: independent insulated two-wire 103AT-2 probe on the cell. Motor current uses protected VBAT, not charger SYS_RAW output.

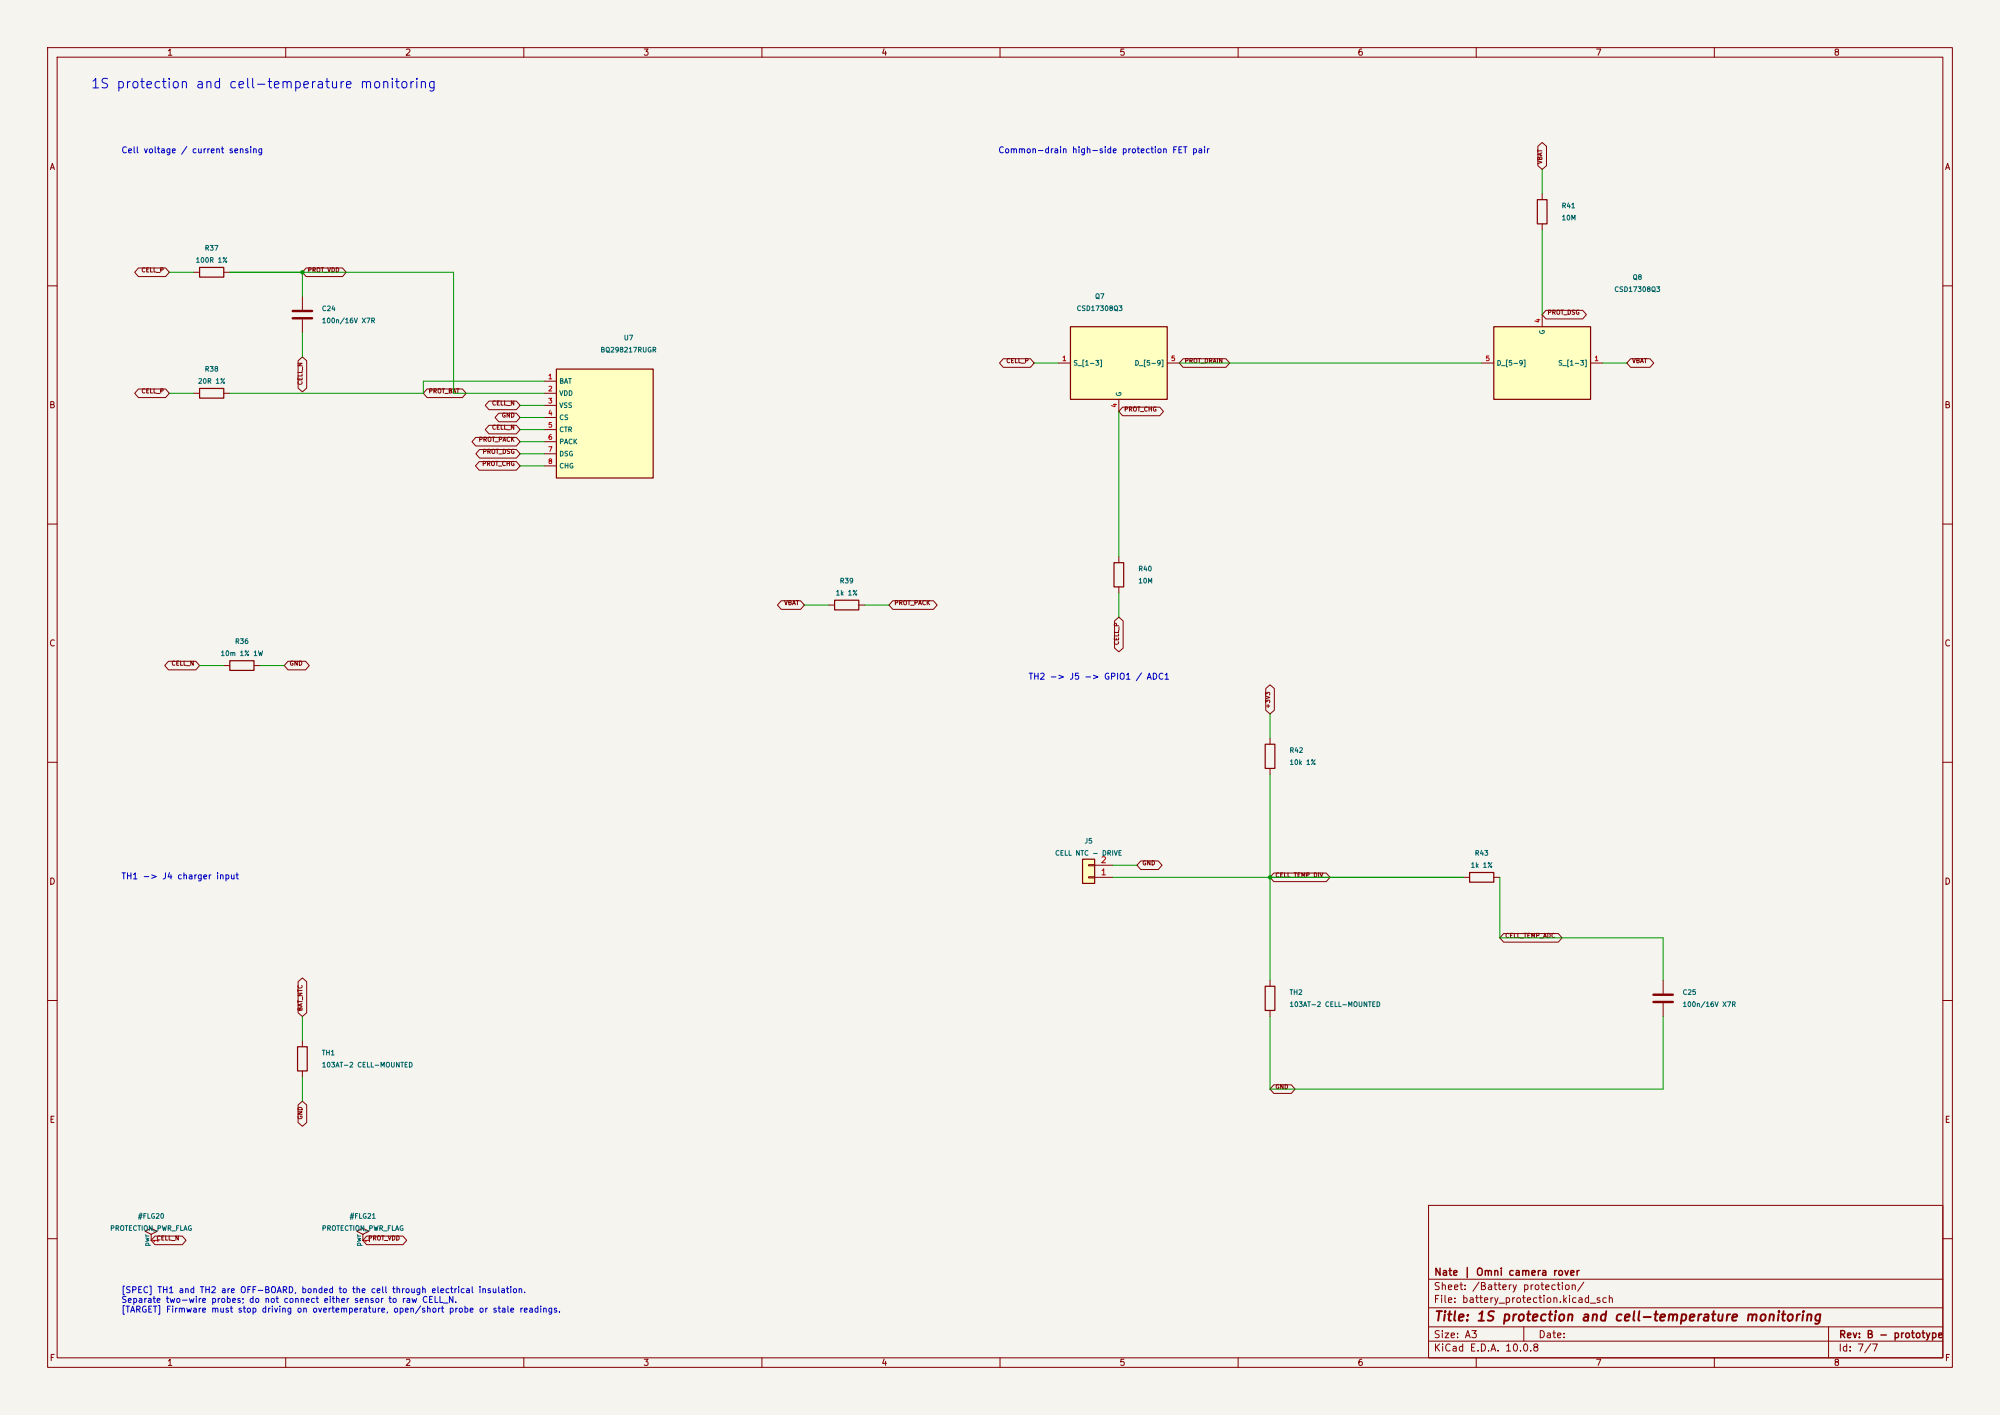
[picture p125: page 7]

CELL_N 1S protection and cell-temperature monitoring

Cell voltage / current sensing

Common-drain high-side protection FET pair

Sheet: /Battery protection/
File: battery_protection.kicad_sch
Title: 1S protection and cell-temperature monitoring

[SPEC] TH1 and TH2 are OFF-BOARD, bonded to the cell through electrical insulation. Separate two-wire probes; do not connect either sensor to raw CELL_N. [TARGET] Firmware must stop driving on overtemperature, open/short probe or stale readings.
