ncripted/DAMIEN/outputs/rover/Omni_UGV_Rev_C_flex_camera/Schematic.pdf

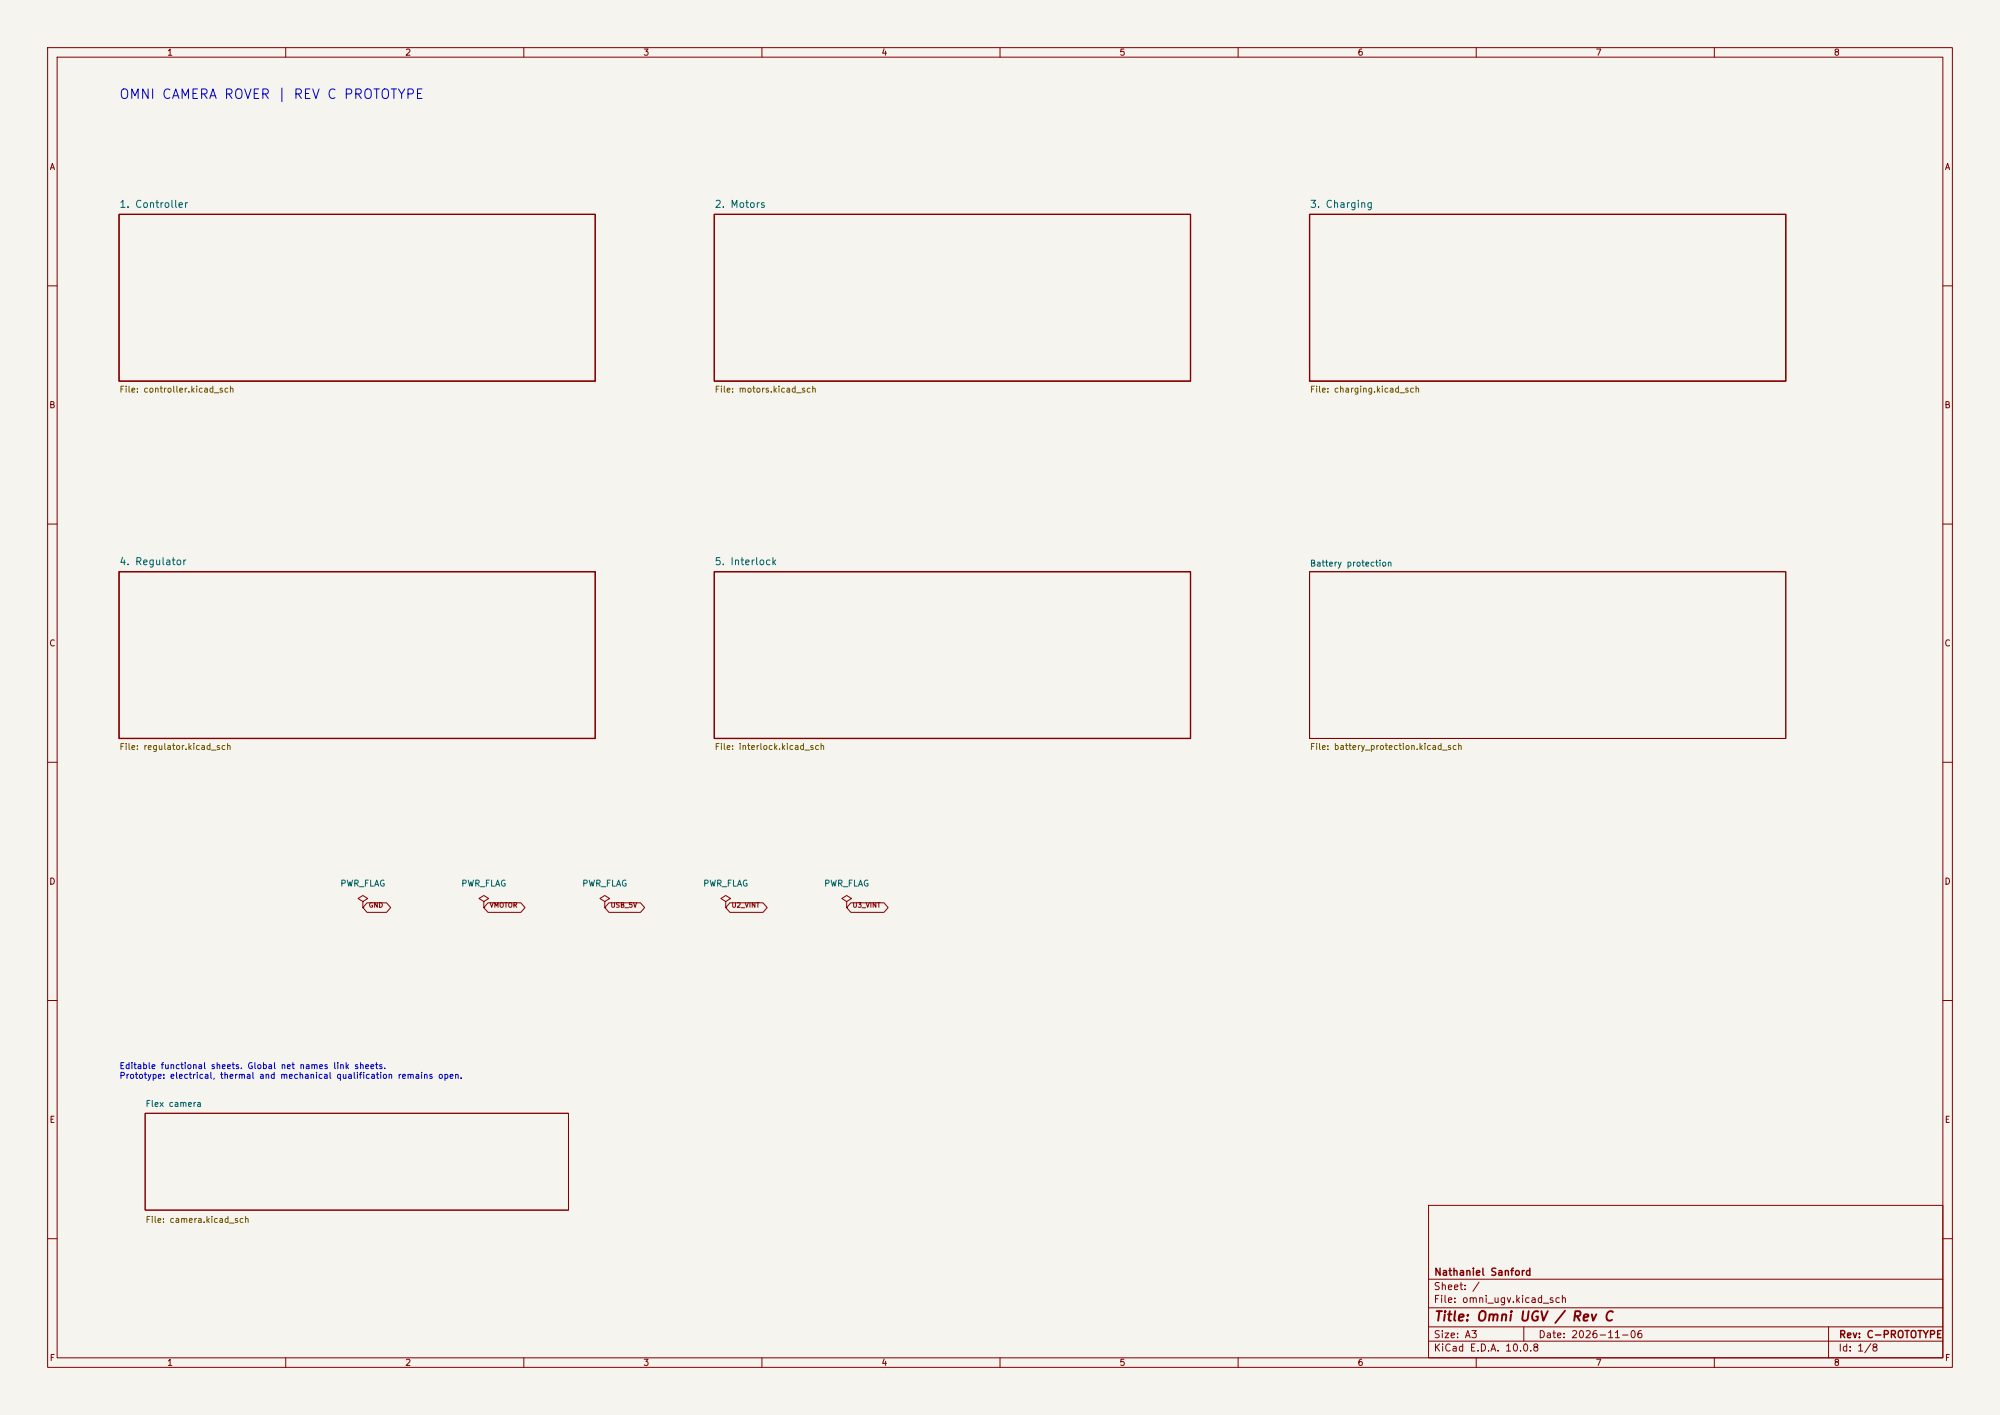
[picture p126: page 1]

OMNI CAMERA ROVER | REV C PROTOTYPE

Editable functional sheets. Global net names link sheets. Prototype: electrical, thermal and mechanical qualification remains open.

Nathaniel Sanford
Sheet: /
File: omni_ugv.kicad_sch
Title: Omni UGV / Rev C

Size: A3 | Rev: C-PROTOTYPE | F Date: 2026-11-06
KiCad E.D.A. 10.0.8 | Id: 1/8

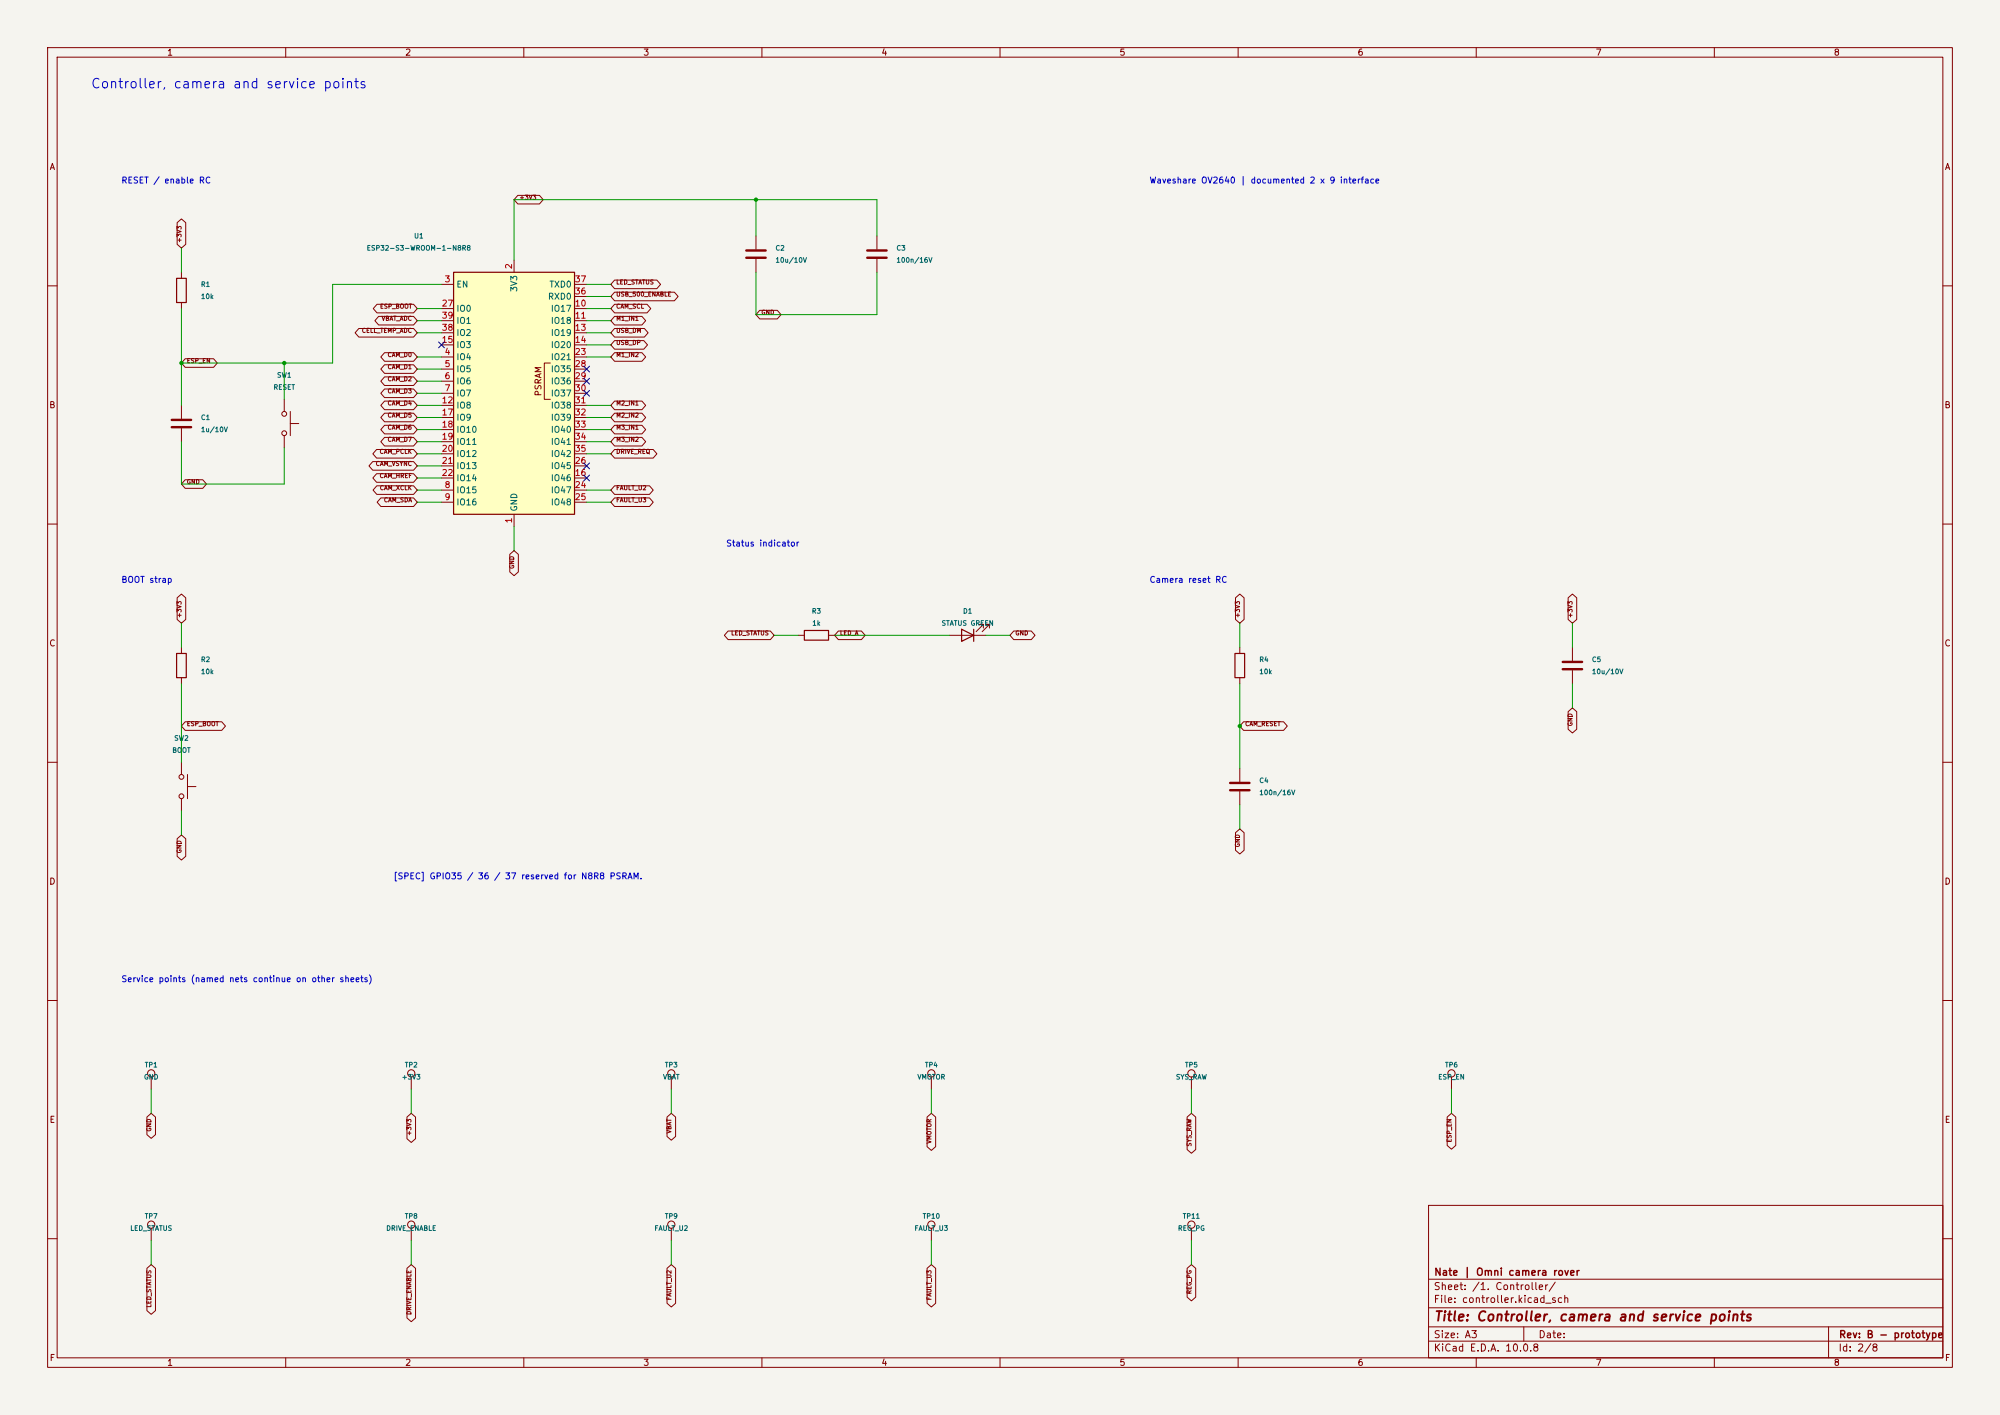
[picture p127: page 2]

[SPEC] GPIO35 / 36 / 37 reserved for N8R8 PSRAM.

Service points (named nets continue on other sheets)

Nate | Omni camera rover
Sheet: /1. Controller/
File: controller.kicad_sch
Title: Controller, camera and service points

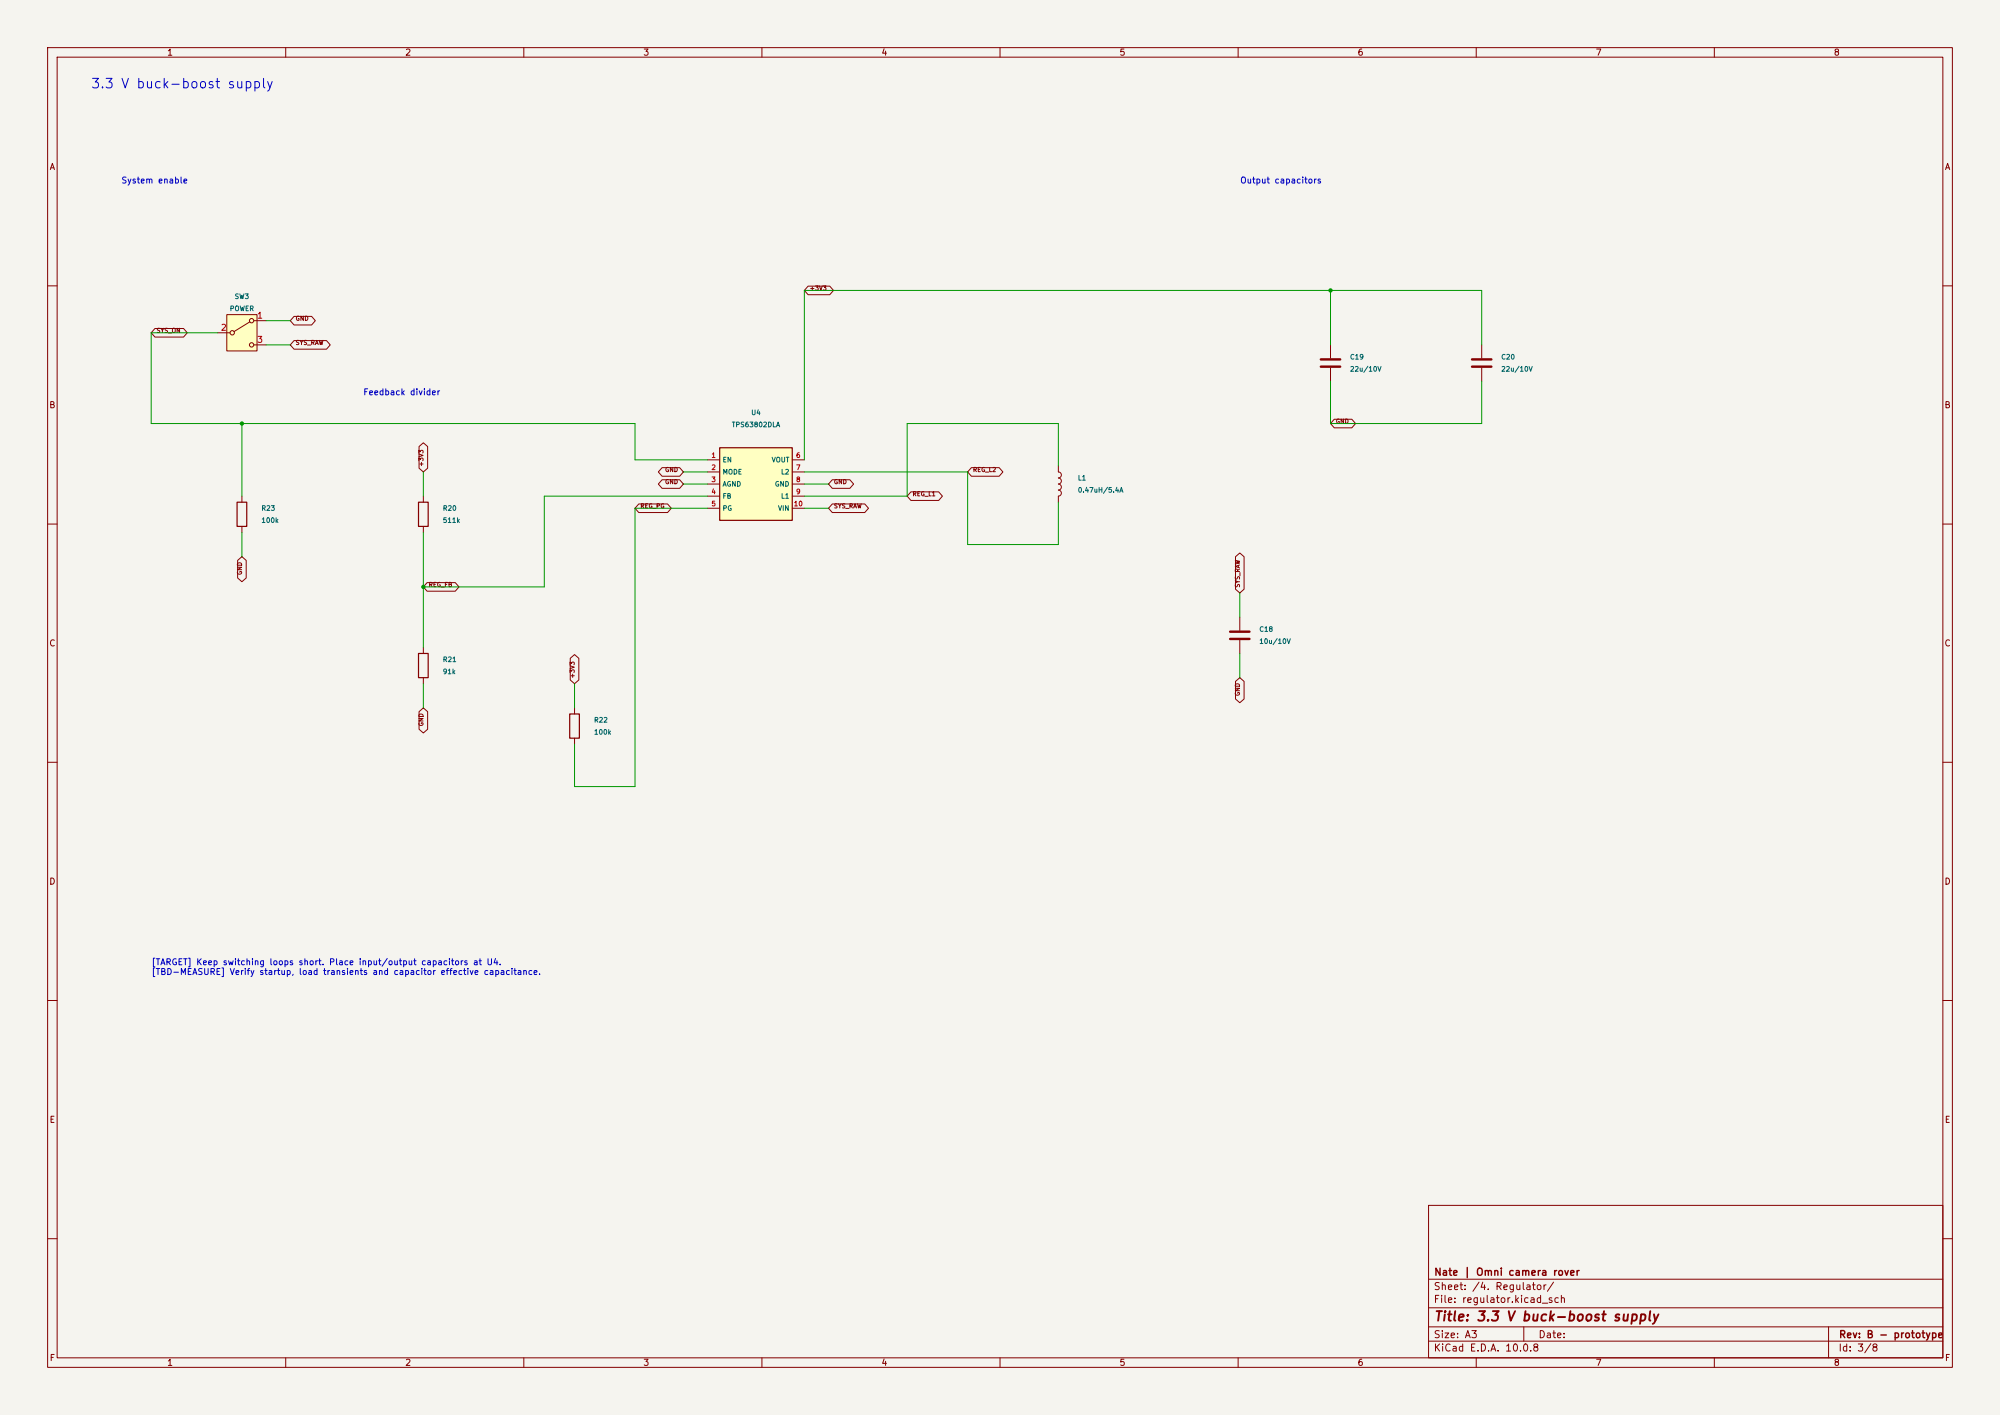
[picture p128: page 3]

[TARGET] Keep switching loops short. Place input/output capacitors at U4. [TBD-MEASURE] Verify startup, load transients and capacitor effective capacitance.

Nate | Omni camera rover
Sheet: /4. Regulator/
File: regulator.kicad_sch
Title: 3.3 V buck-boost supply

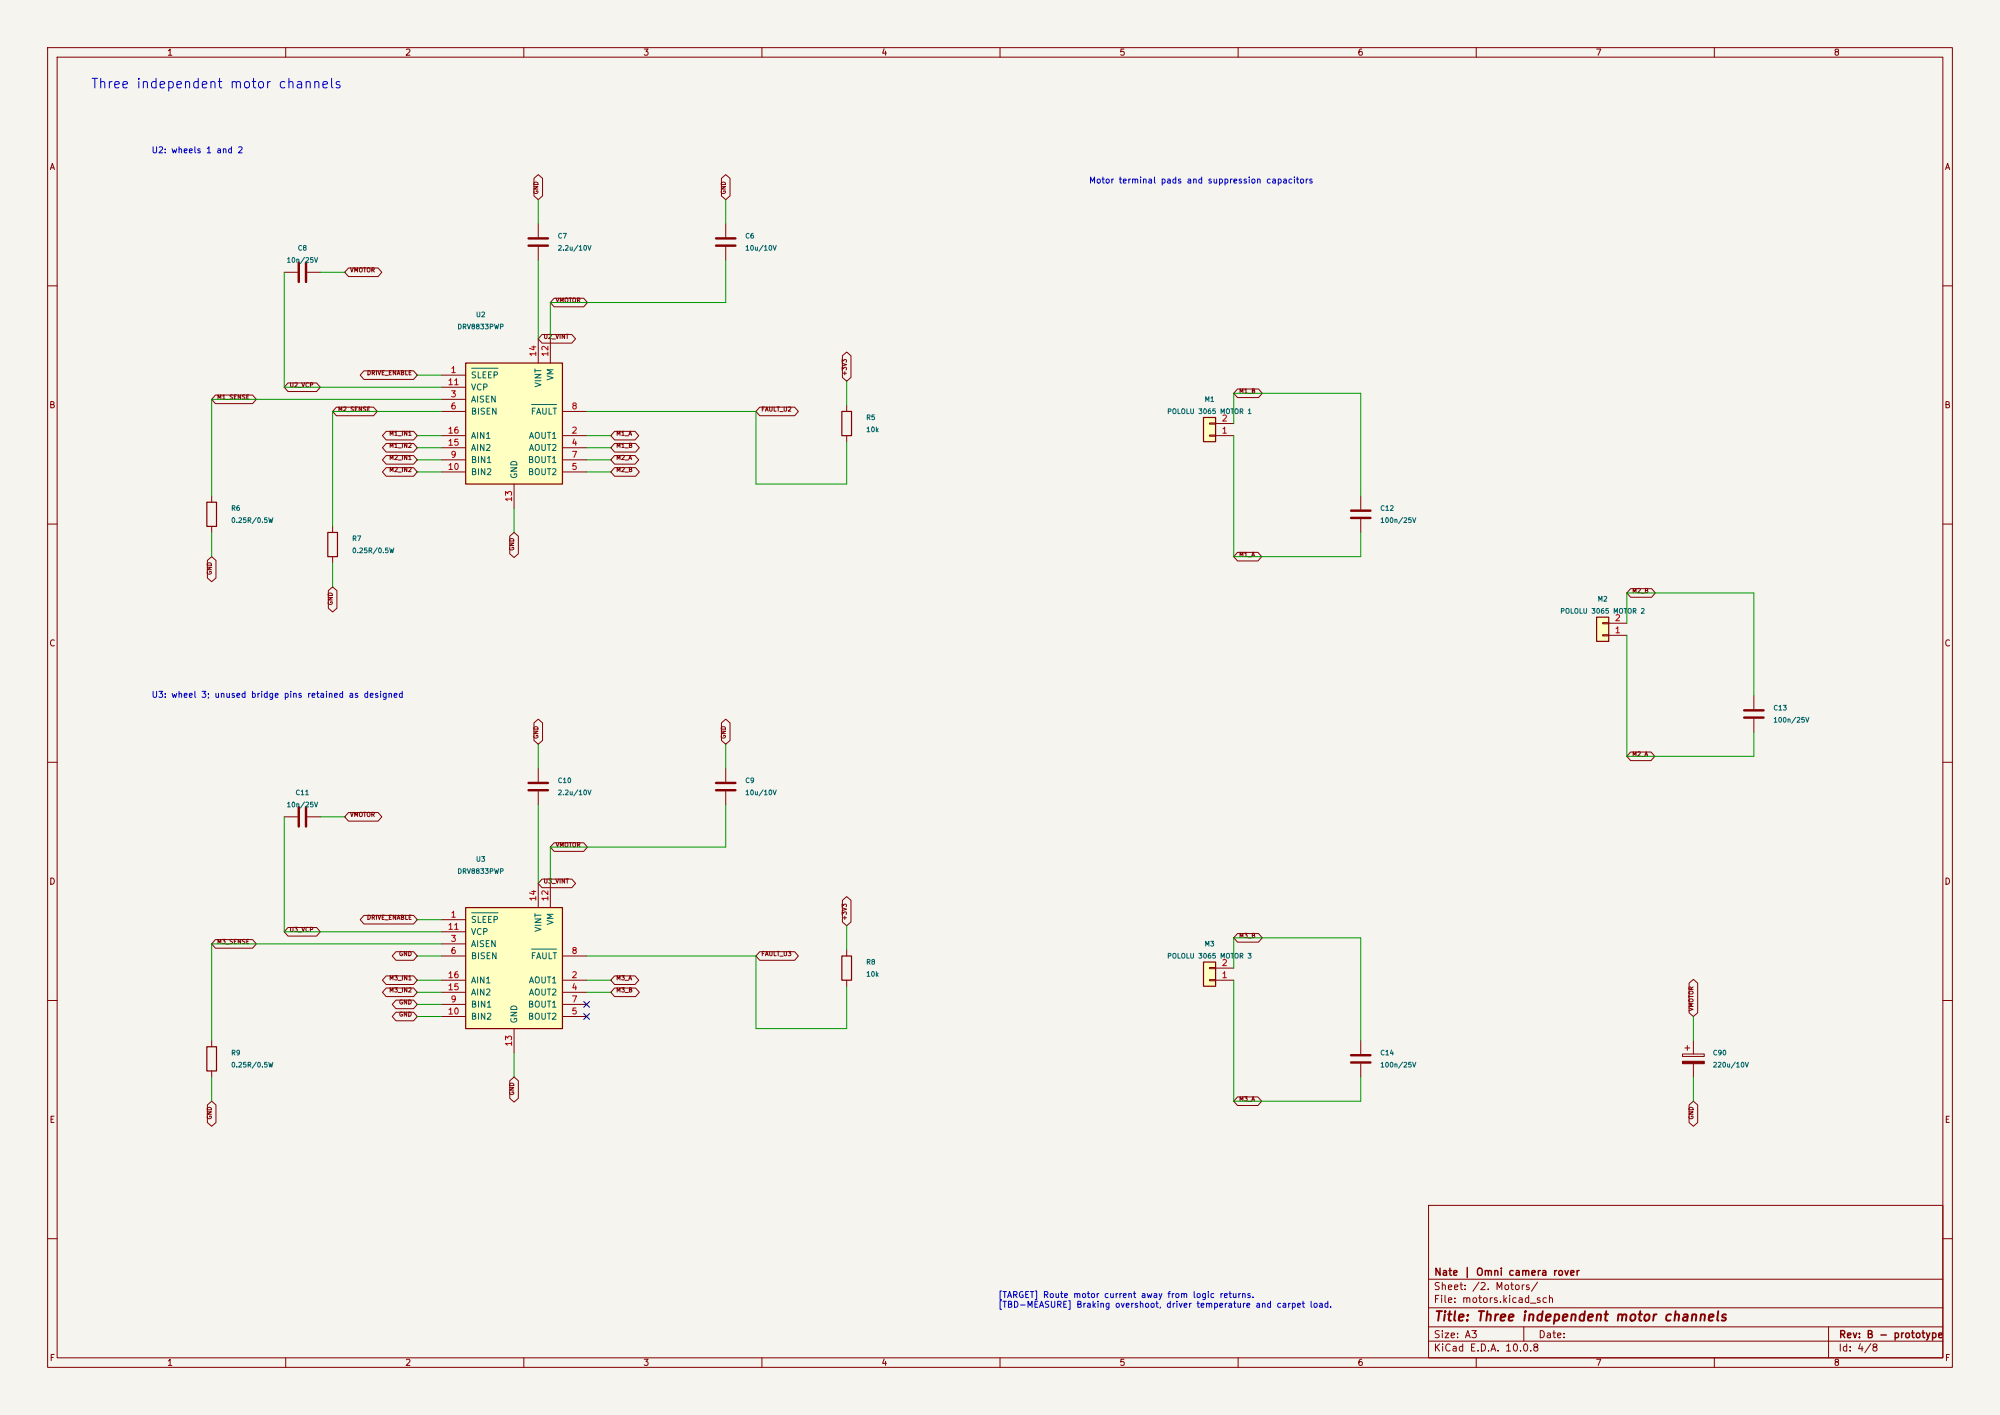
[picture p129: page 4]

Three independent motor channels
M2_IN1 M3_SENSE GND

Motor terminal pads and suppression capacitors U3: wheel 3; unused bridge pins retained as designed

Nate | Omni camera rover
Sheet: /2. Motors/
File: motors.kicad_sch
Title: Three independent motor channels

[TARGET] Route motor current away from logic returns. [TBD-MEASURE] Braking overshoot, driver temperature and carpet load.

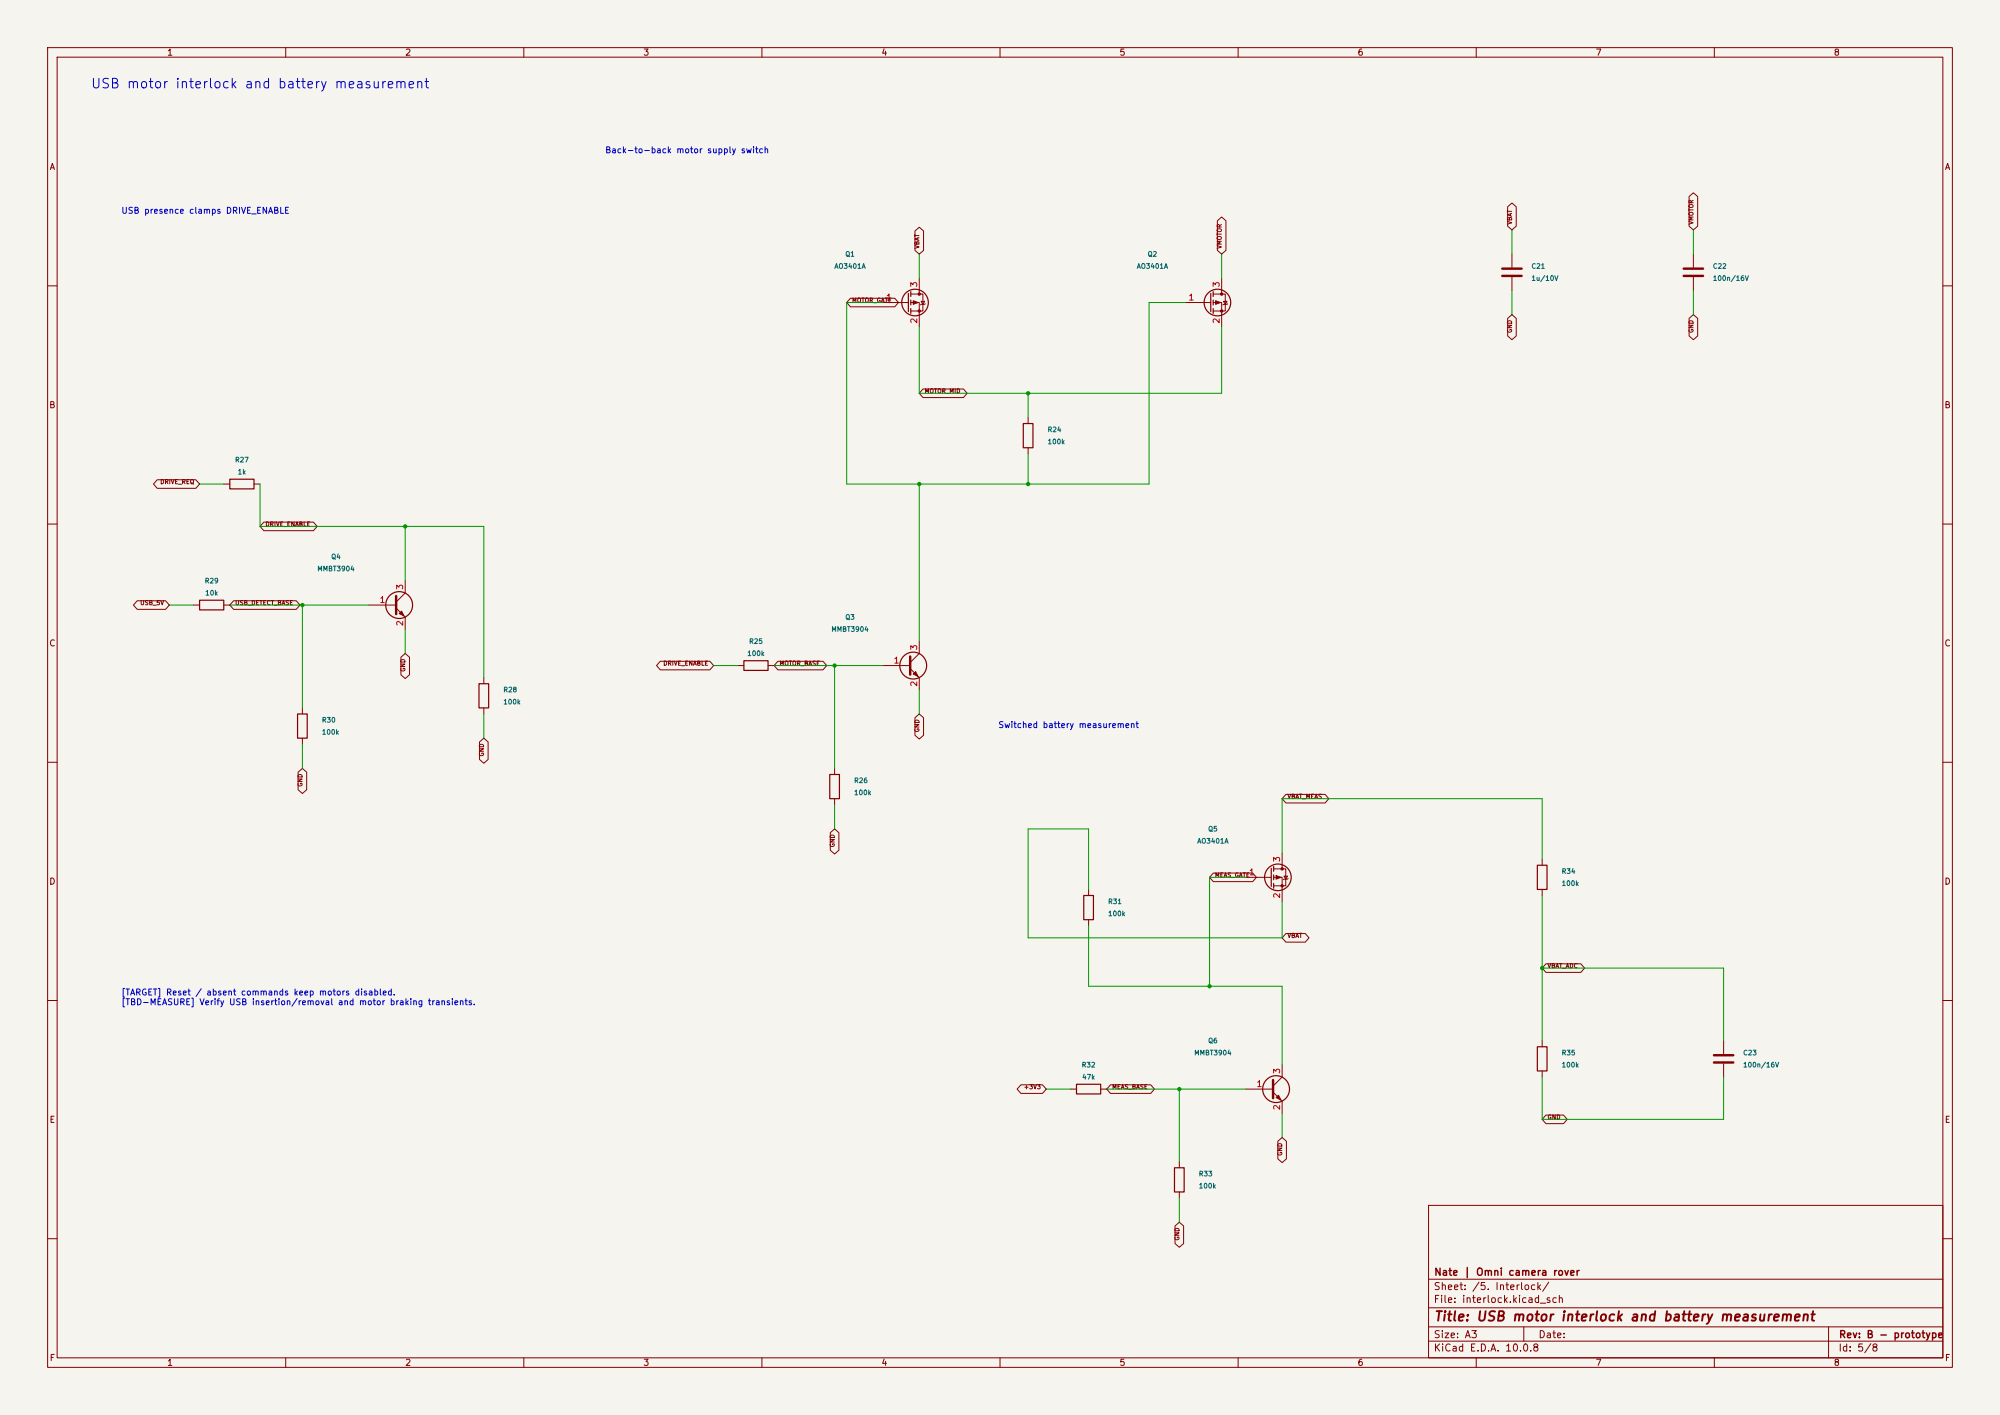
[picture p130: page 5]

[TARGET] Reset / absent commands keep motors disabled. [TBD-MEASURE] Verify USB insertion/removal and motor braking transients.

Nate | Omni camera rover
Sheet: /5. Interlock/
File: interlock.kicad_sch
Title: USB motor interlock and battery measurement

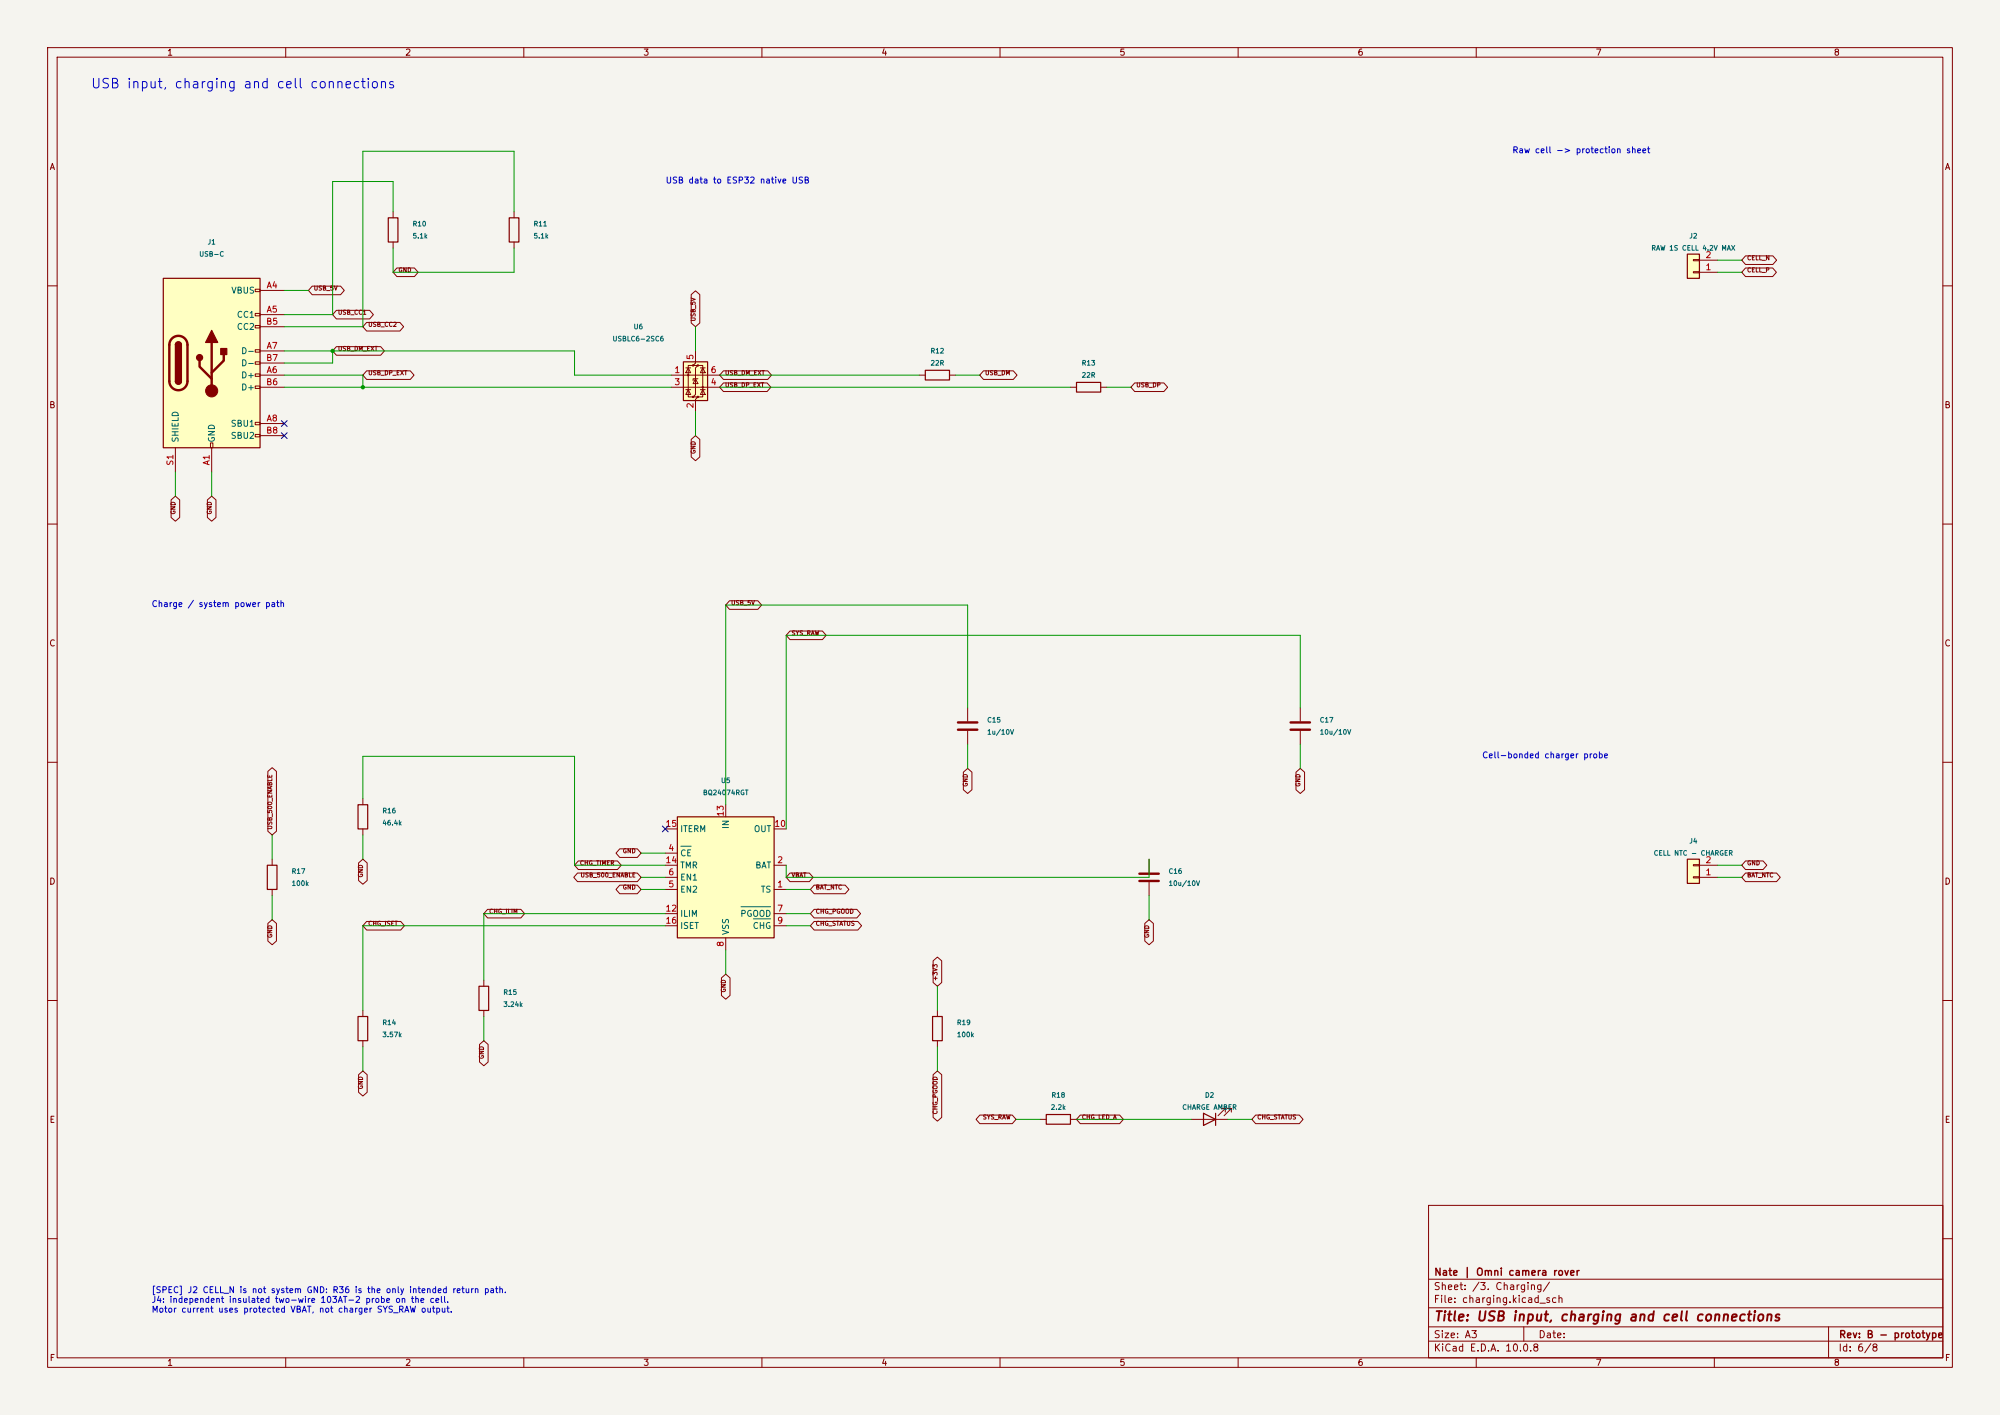
[picture p131: page 6]

USB_DM_EXT USB_DM_EXT USB input, charging and cell connections

Raw cell -> protection sheet Cell-bonded charger probe

USB data to ESP32 native USB

Charge / system power path

Nate | Omni camera rover R18

Sheet: /3. Charging/
File: charging.kicad_sch
Title: USB input, charging and cell connections

[SPEC] J2 CELL_N is not system GND: R36 is the only intended return path. J4: independent insulated two-wire 103AT-2 probe on the cell. Motor current uses protected VBAT, not charger SYS_RAW output.

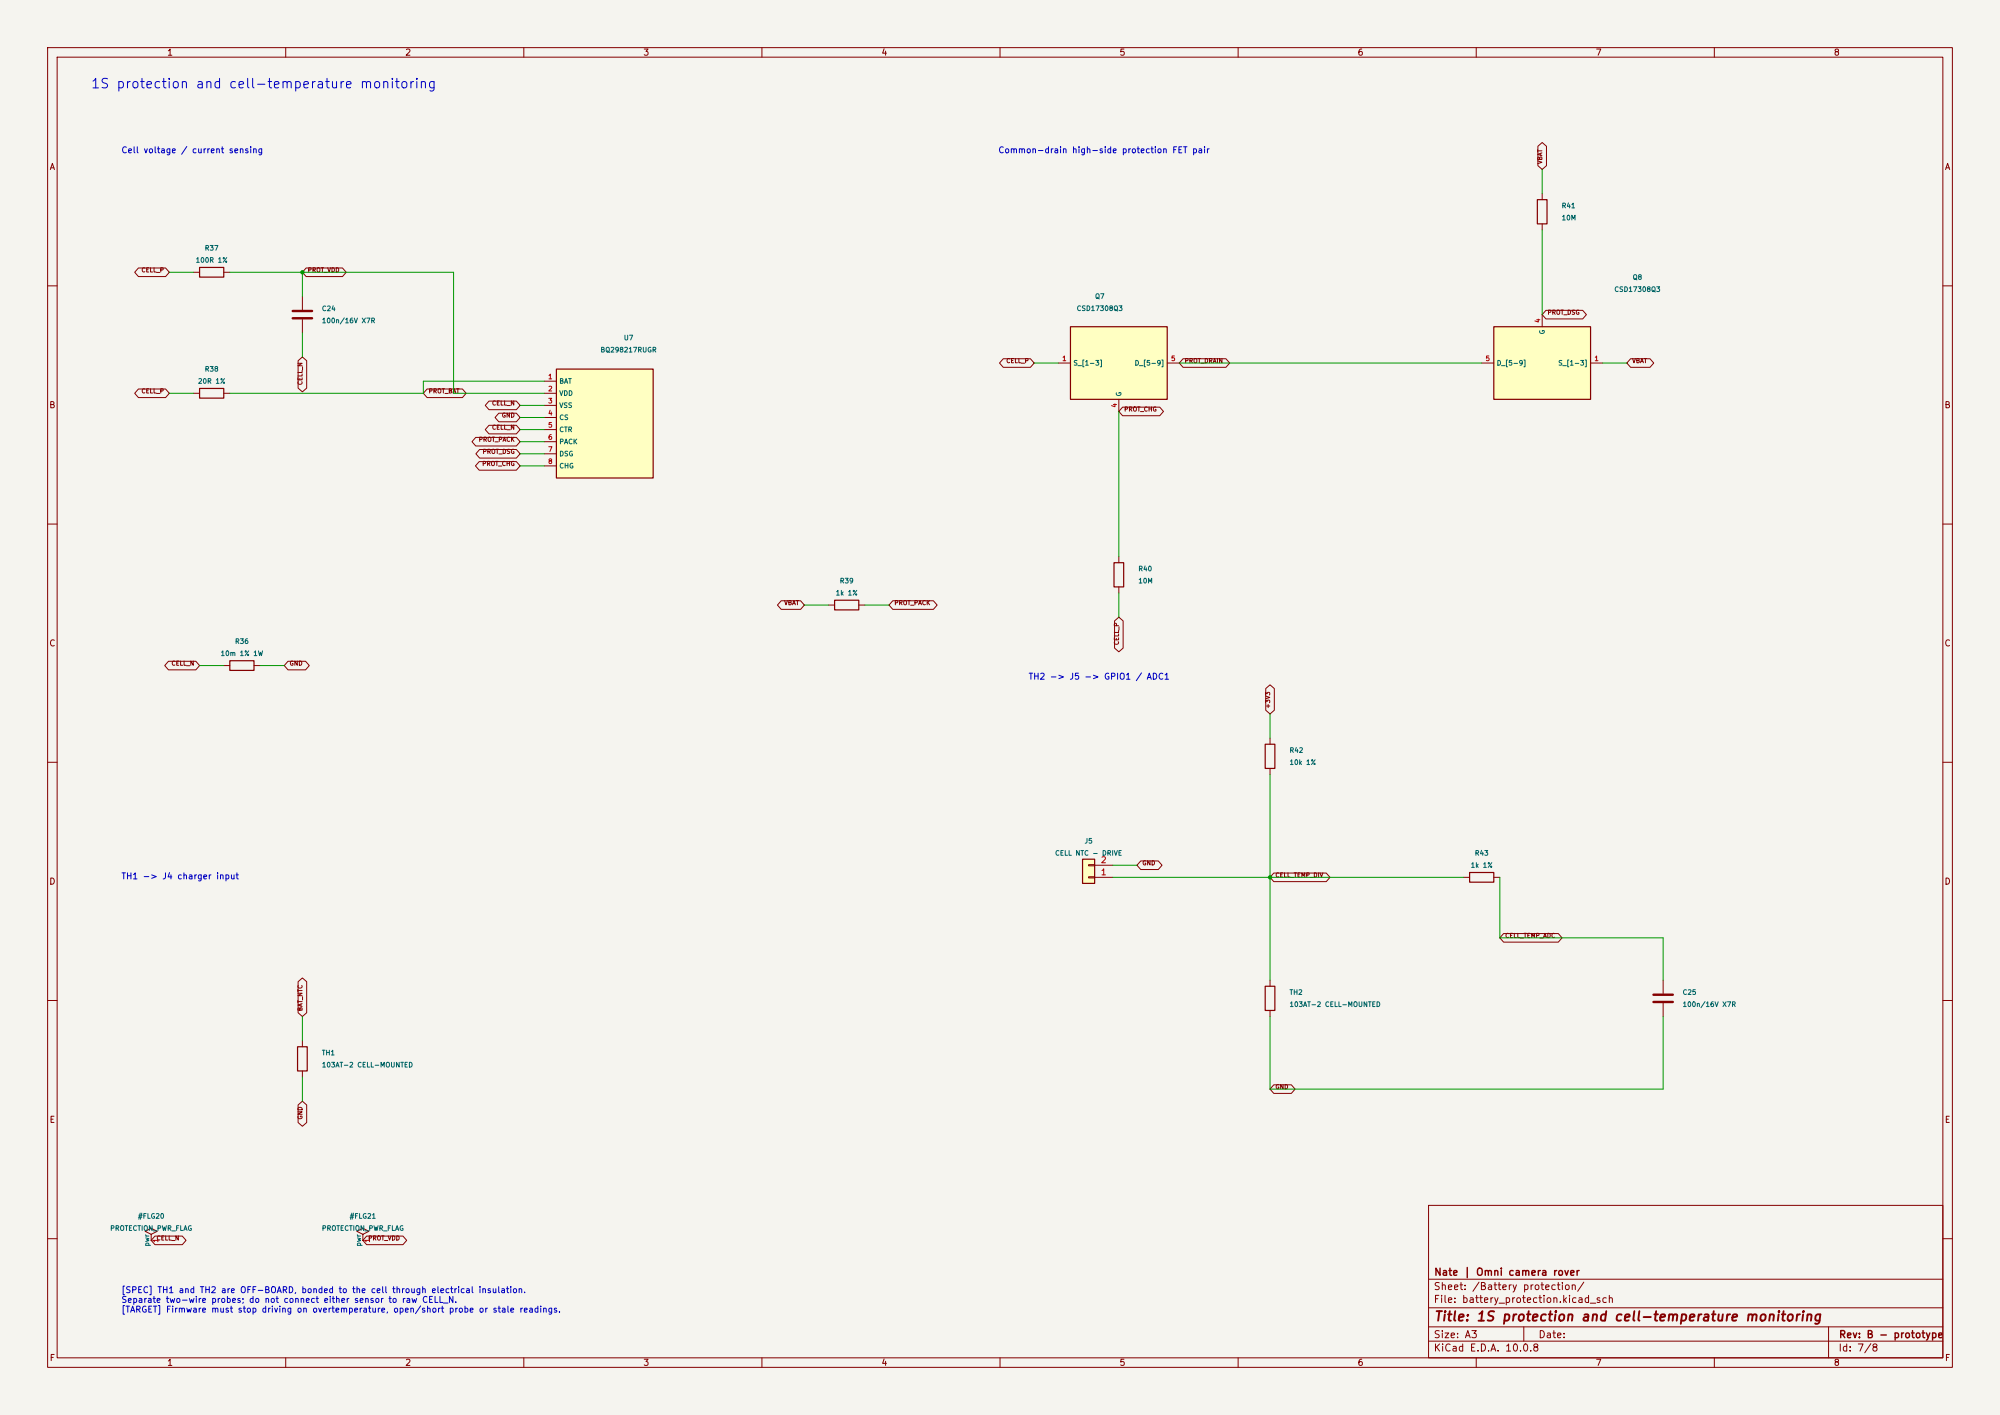
[picture p132: page 7]

1S protection and cell-temperature monitoring
PROT_DSG GND BAT_NTC

Nate | Omni camera rover
Sheet: /Battery protection/
File: battery_protection.kicad_sch
Title: 1S protection and cell-temperature monitoring

[SPEC] TH1 and TH2 are OFF-BOARD, bonded to the cell through electrical insulation. Separate two-wire probes; do not connect either sensor to raw CELL_N. [TARGET] Firmware must stop driving on overtemperature, open/short probe or stale readings.

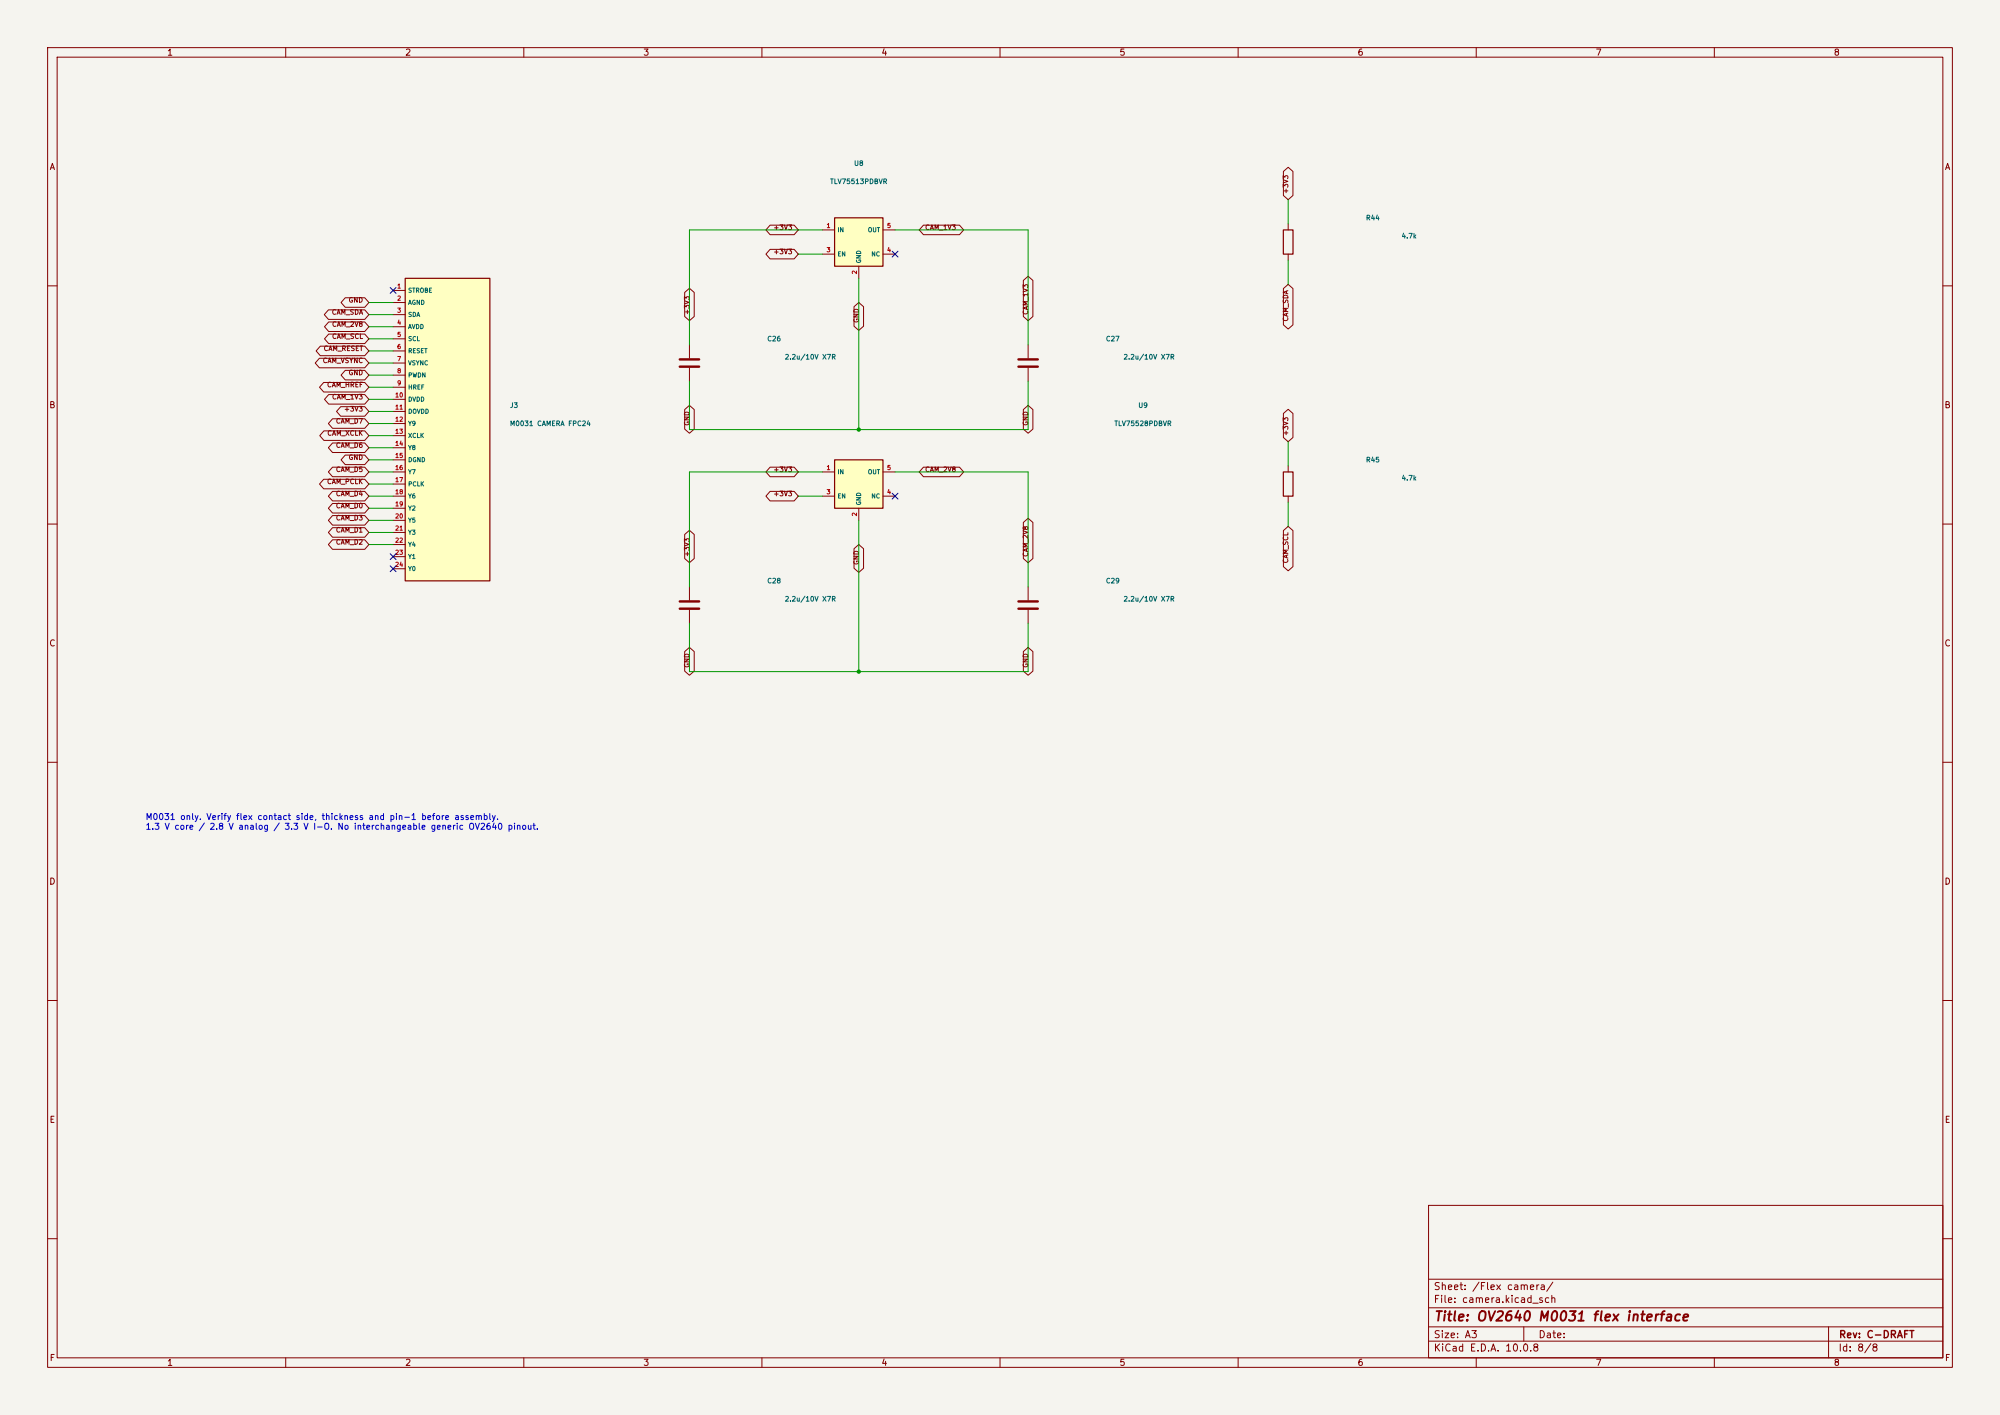
[picture p133: page 8]

CAM_HREF CAM_1V3 M0031 only. Verify flex contact side, thickness and pin-1 before assembly. 1.3 V core / 2.8 V analog / 3.3 V I-O. No interchangeable generic OV2640 pinout.
