ncripted/DAMIEN/outputs/rover/Omni_UGV_Rev_D_power_audit/Schematic.pdf

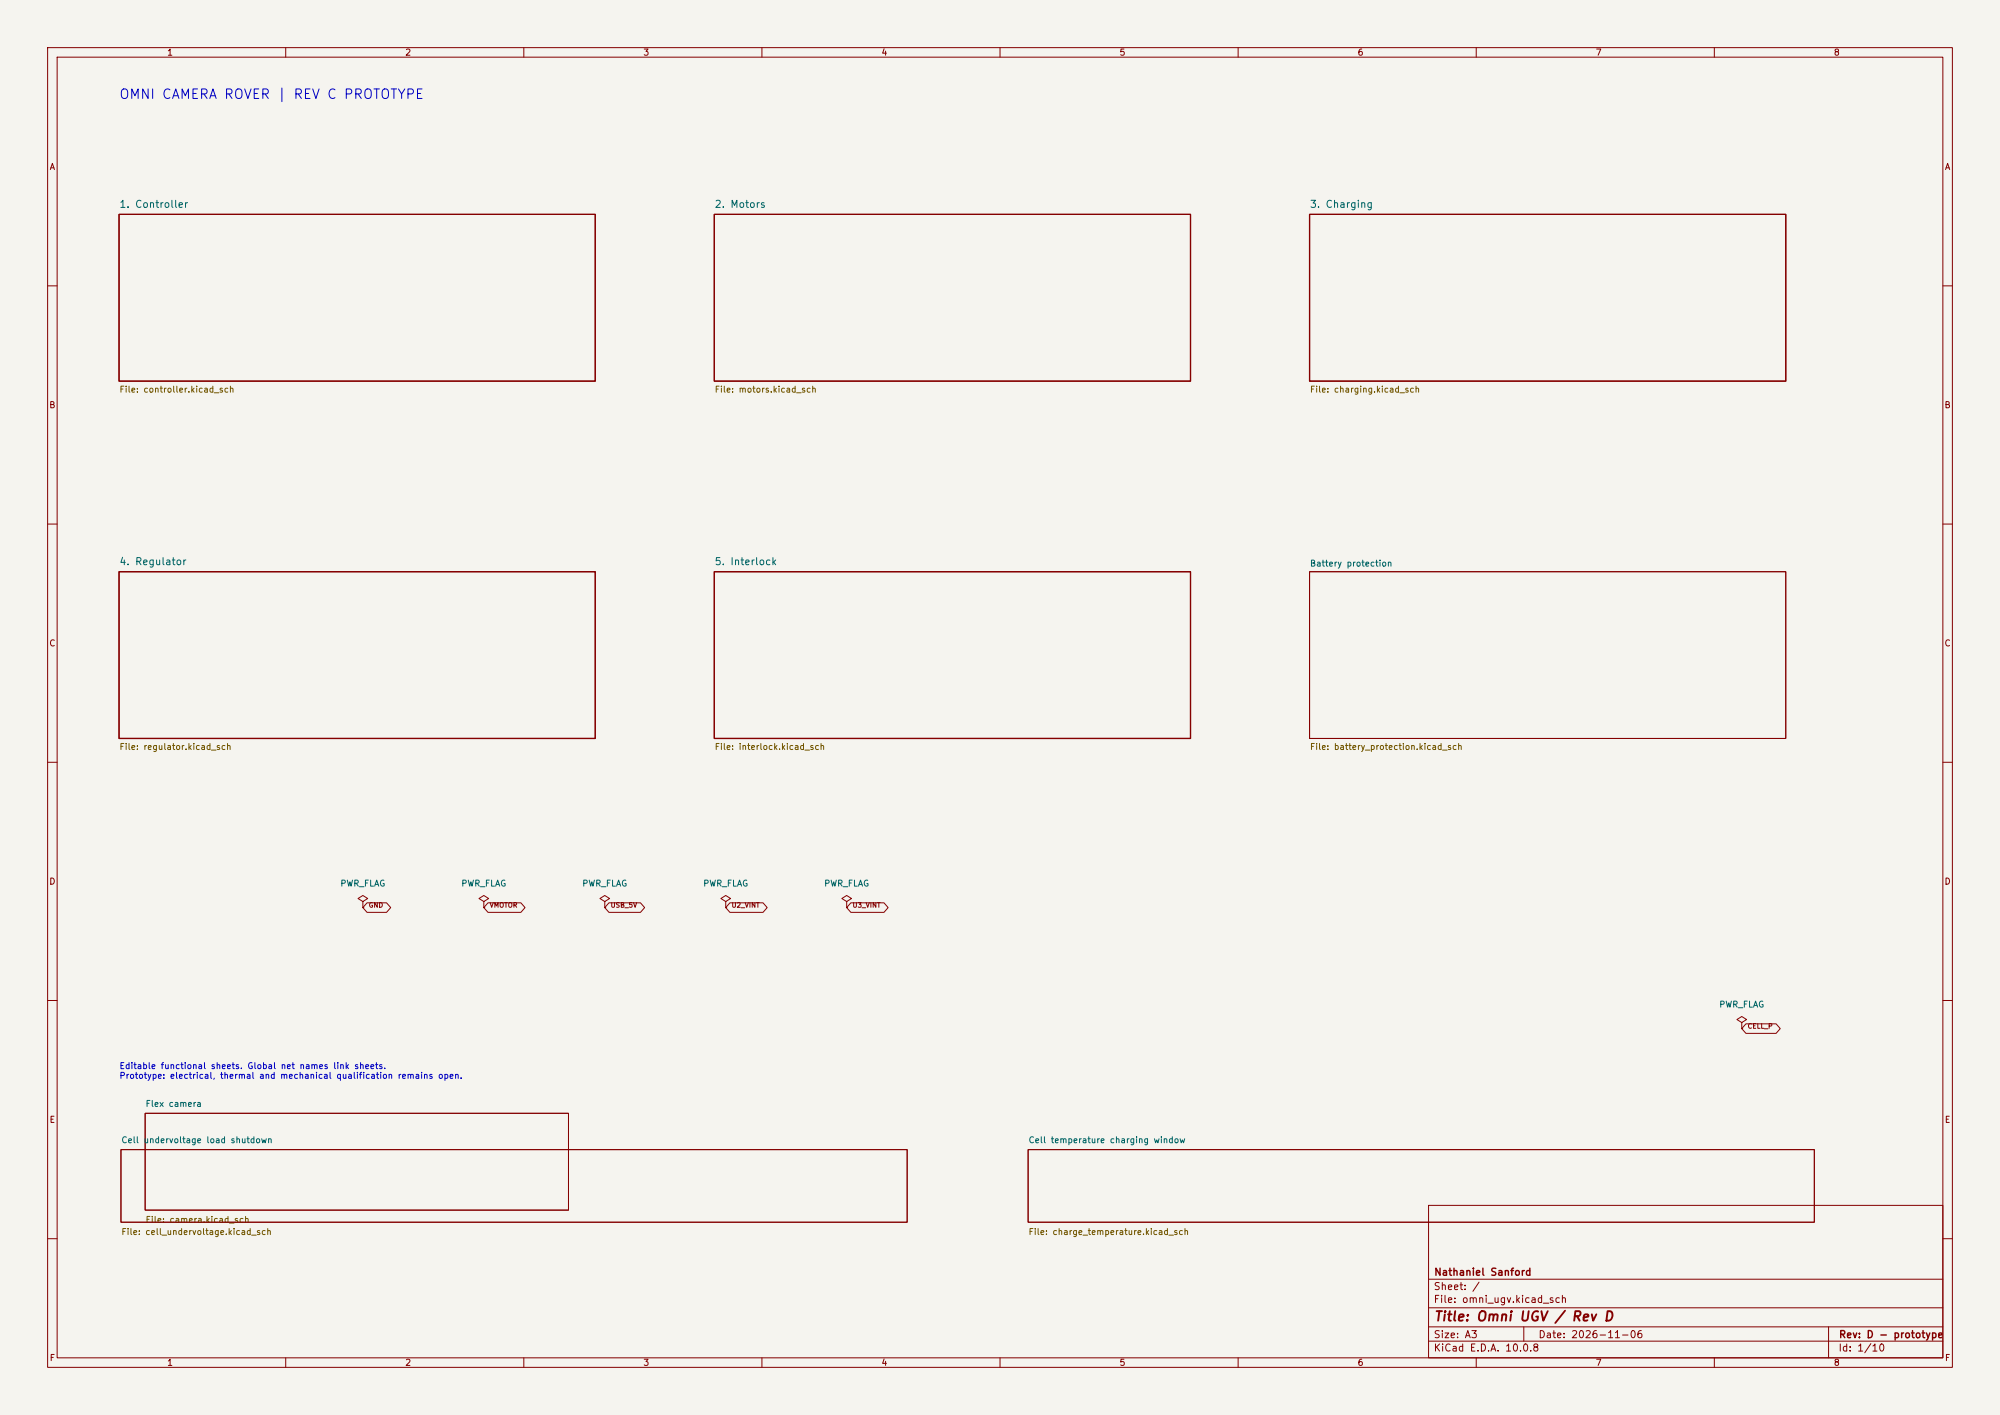
[picture p134: page 1]

OMNI CAMERA ROVER | REV C PROTOTYPE

File: battery_protection.kicad_sch Cell temperature charging window

Editable functional sheets. Global net names link sheets. Prototype: electrical, thermal and mechanical qualification remains open.

Nathaniel Sanford
Sheet: /
File: omni_ugv.kicad_sch
Title: Omni UGV / Rev D

Size: A3 | Rev: D - prototype | F Date: 2026-11-06
KiCad E.D.A. 10.0.8 | Id: 1/10

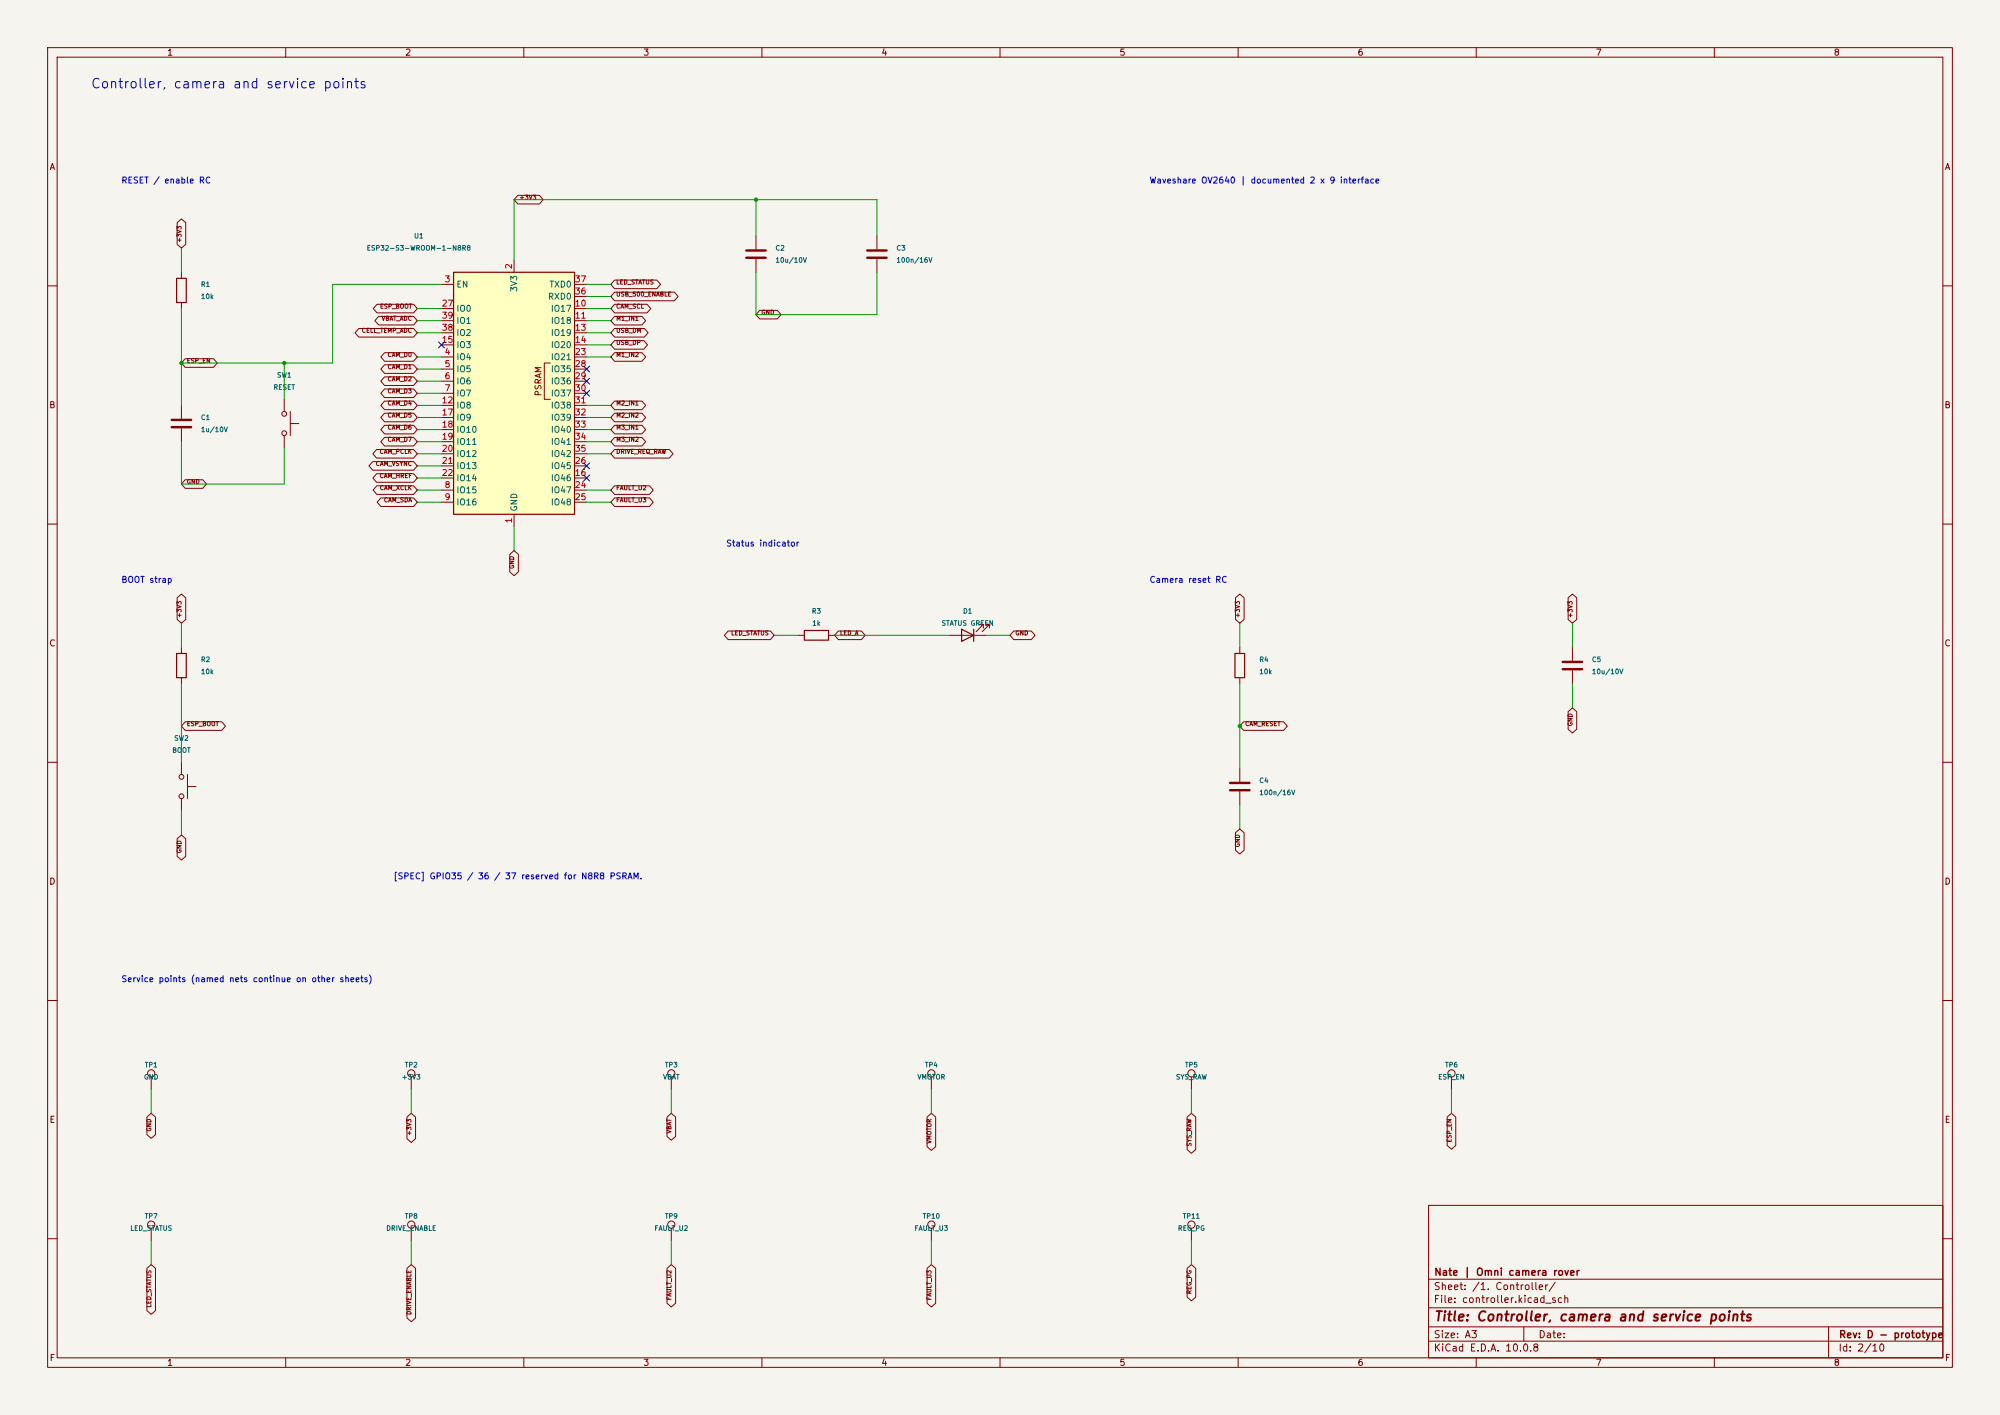
[picture p135: page 2]

[SPEC] GPIO35 / 36 / 37 reserved for N8R8 PSRAM.

Service points (named nets continue on other sheets)

Nate | Omni camera rover
Sheet: /1. Controller/
File: controller.kicad_sch
Title: Controller, camera and service points

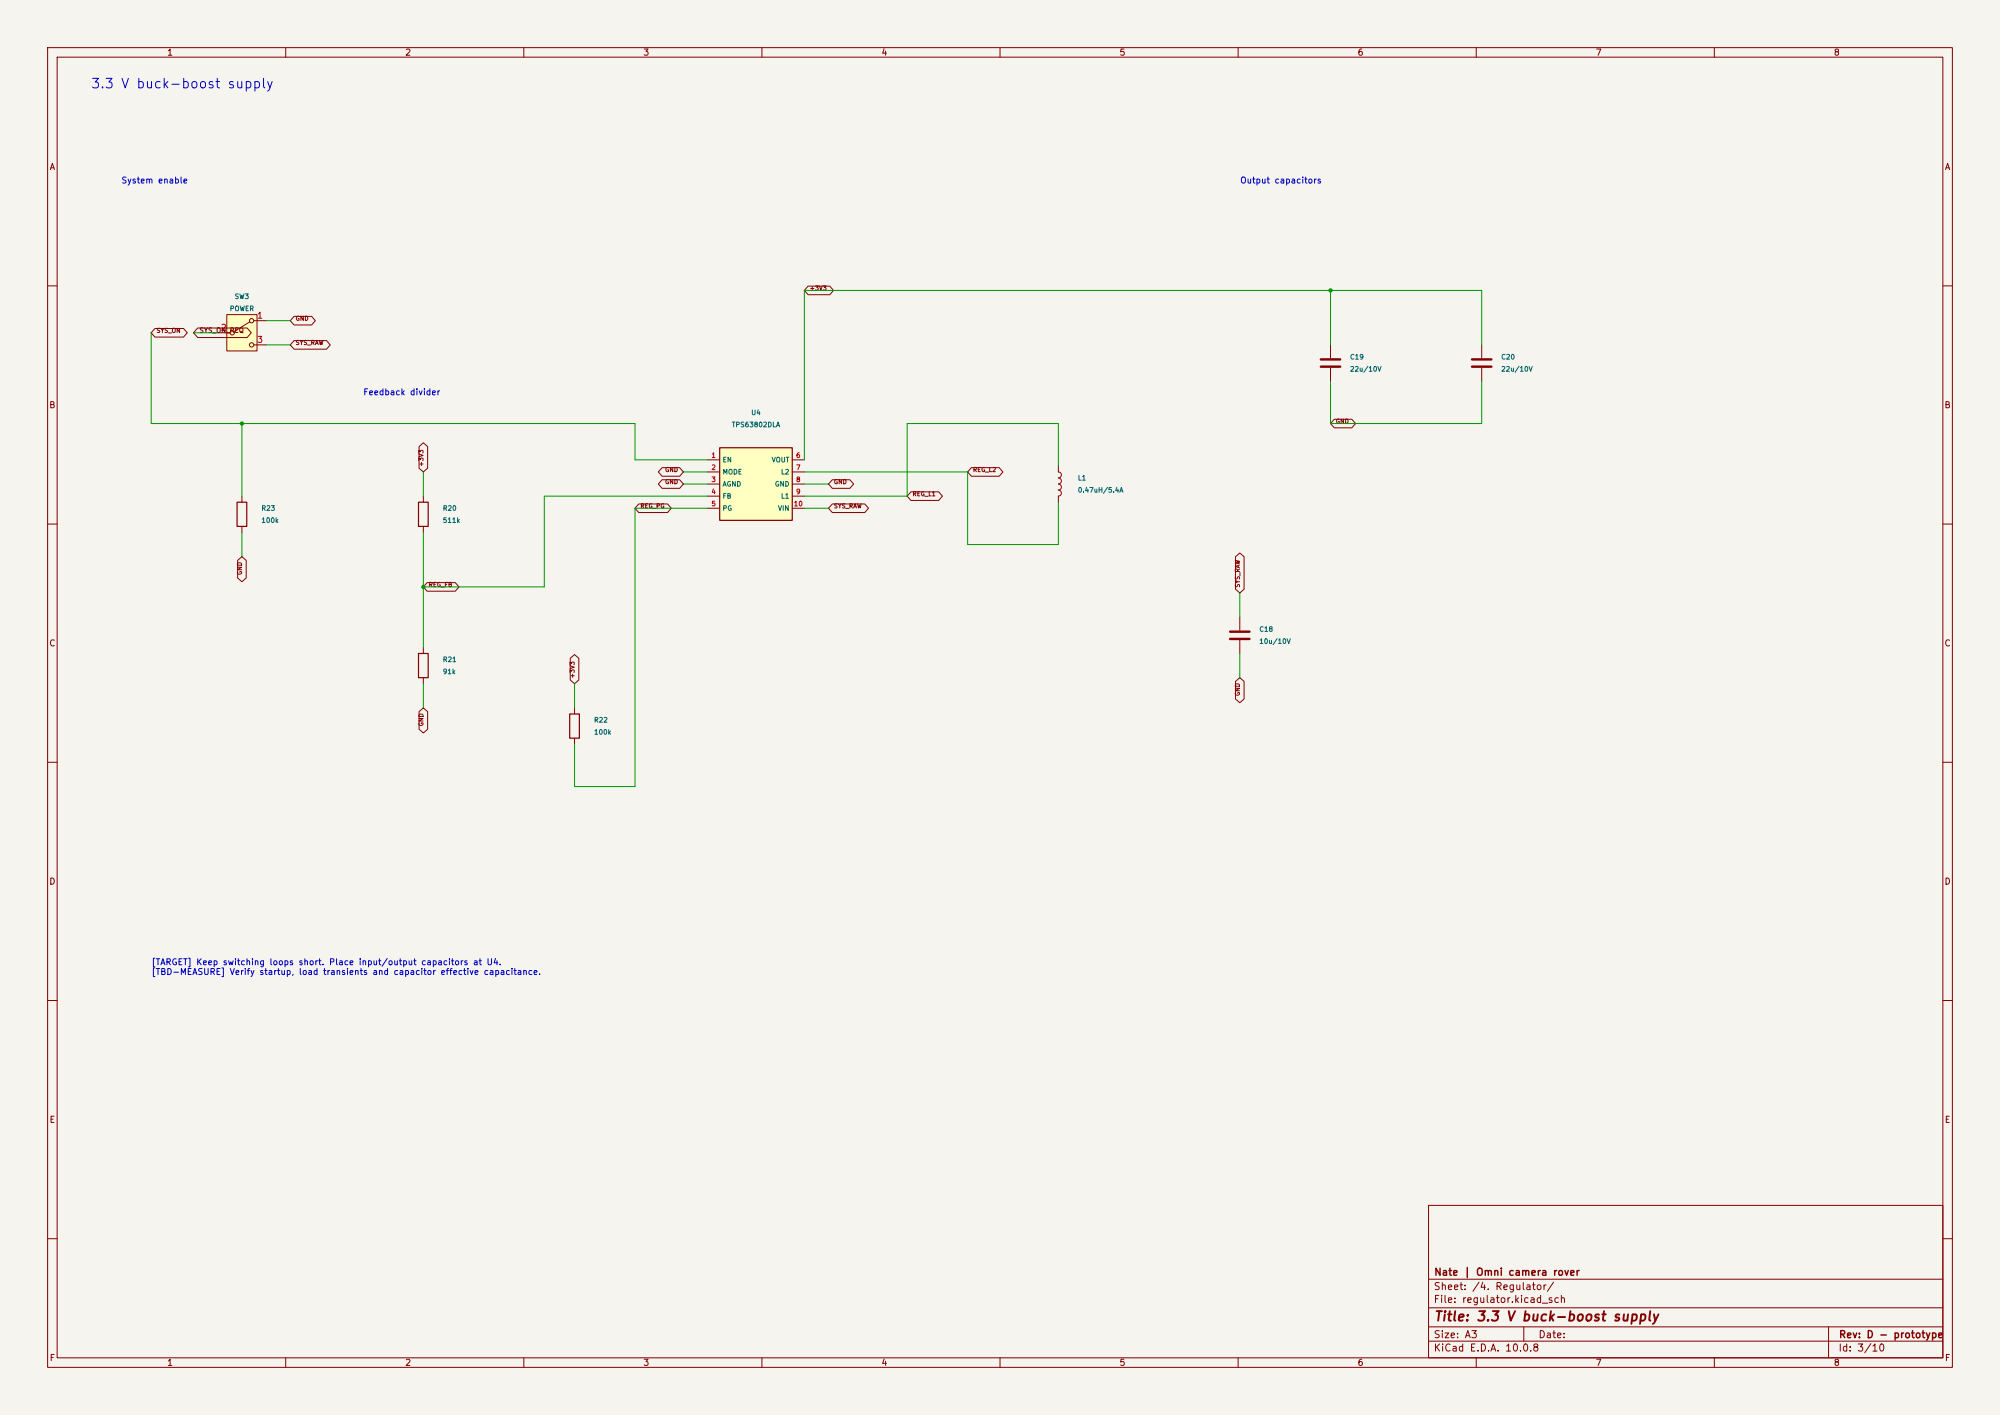
[picture p136: page 3]

[TARGET] Keep switching loops short. Place input/output capacitors at U4. [TBD-MEASURE] Verify startup, load transients and capacitor effective capacitance.

Nate | Omni camera rover
Sheet: /4. Regulator/
File: regulator.kicad_sch
Title: 3.3 V buck-boost supply

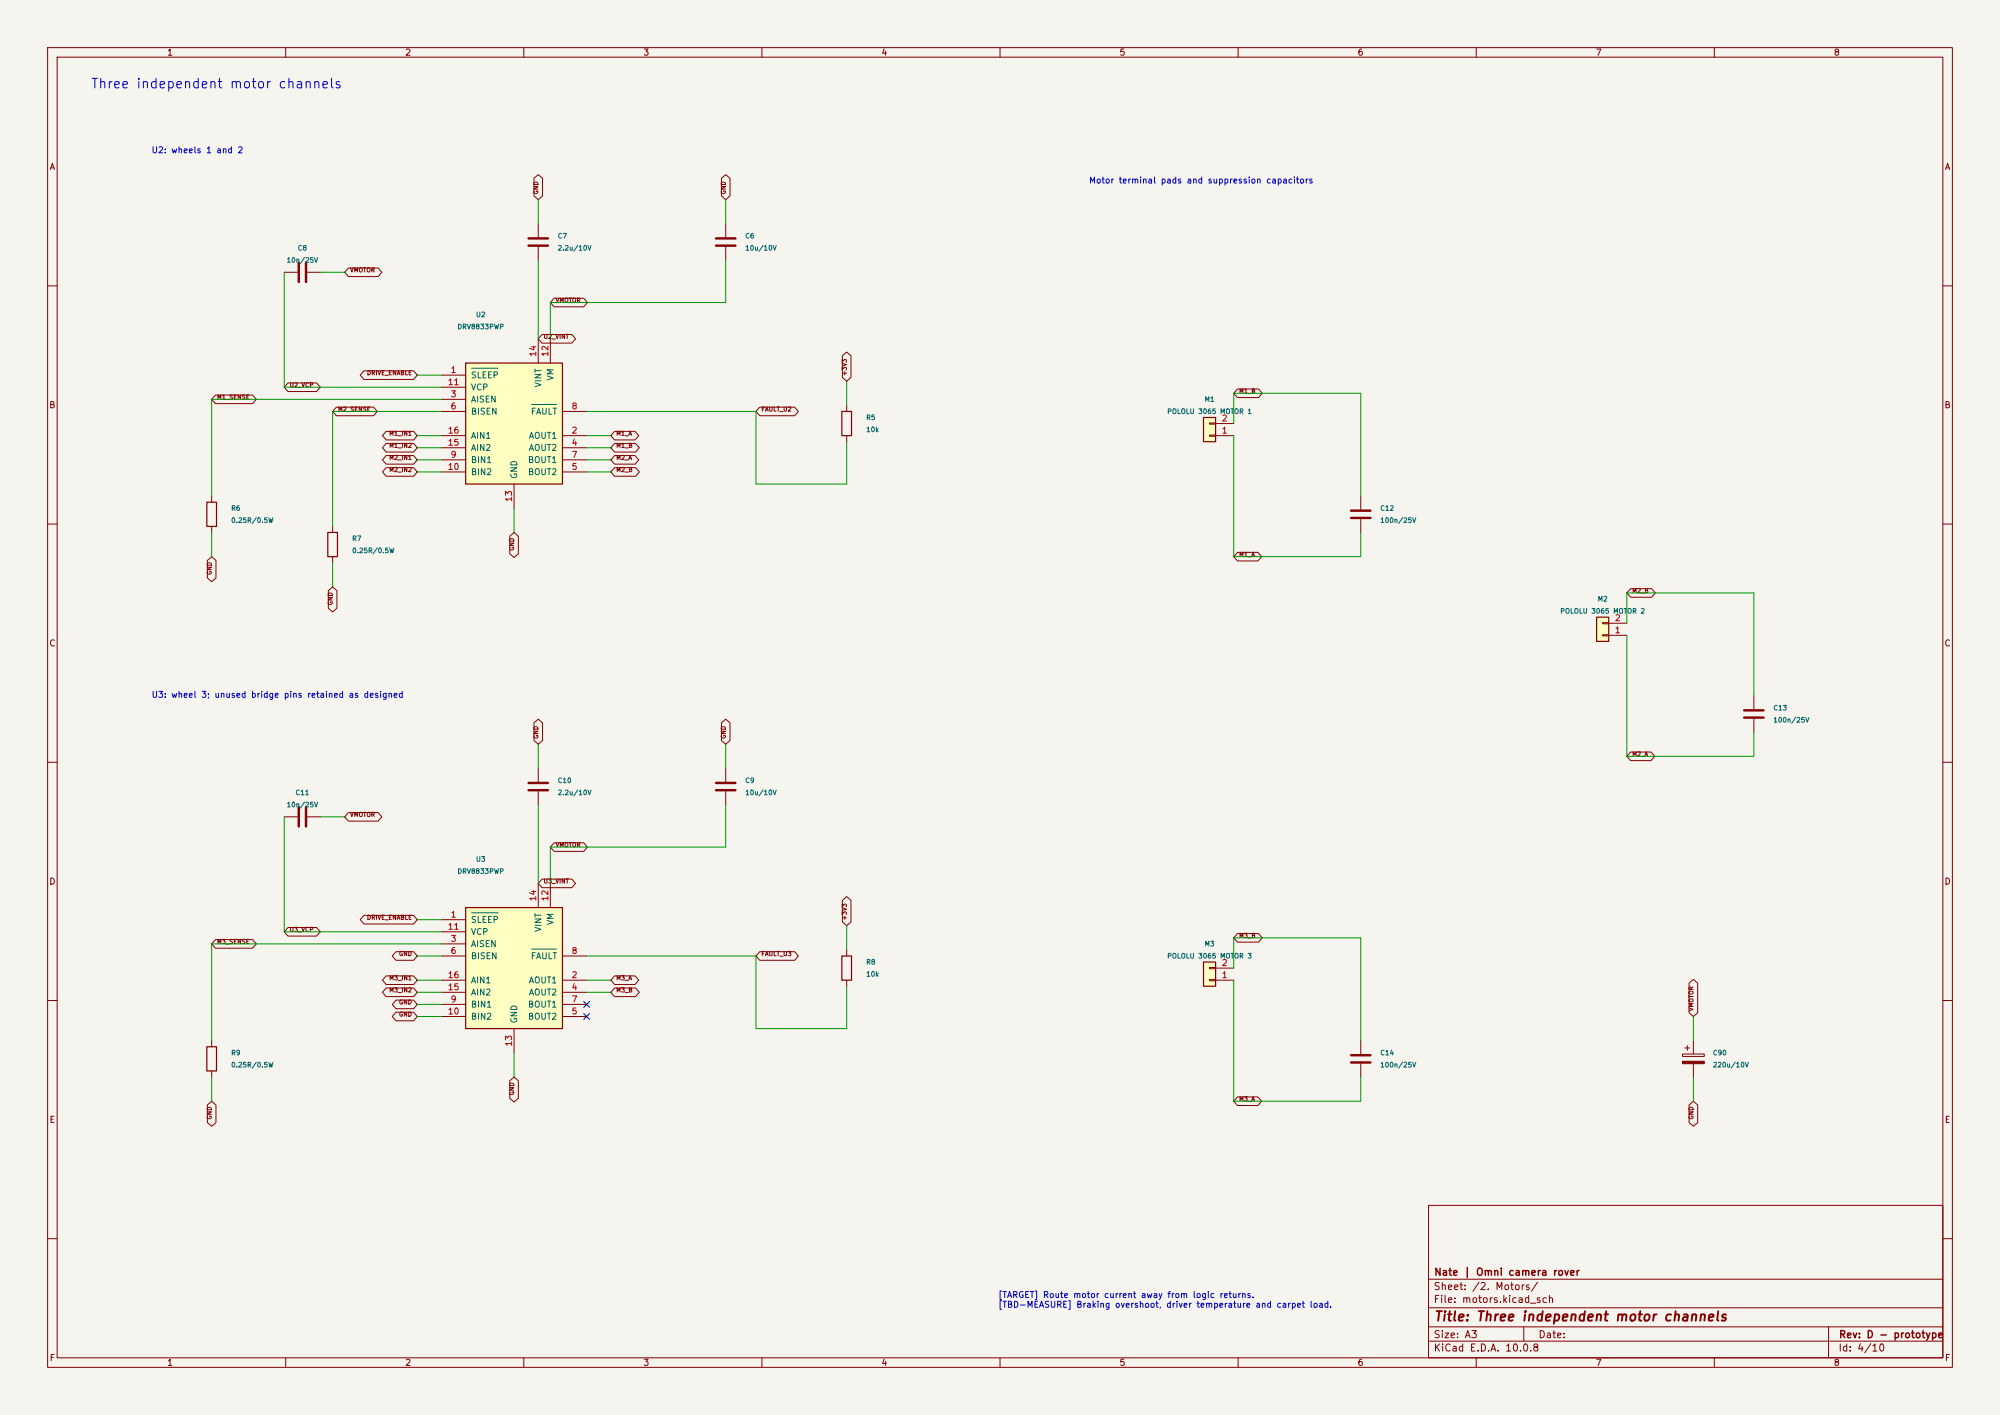
[picture p137: page 4]

Three independent motor channels
M2_IN1 M3_SENSE GND

Motor terminal pads and suppression capacitors U3: wheel 3; unused bridge pins retained as designed

Nate | Omni camera rover
Sheet: /2. Motors/
File: motors.kicad_sch
Title: Three independent motor channels

[TARGET] Route motor current away from logic returns. [TBD-MEASURE] Braking overshoot, driver temperature and carpet load.

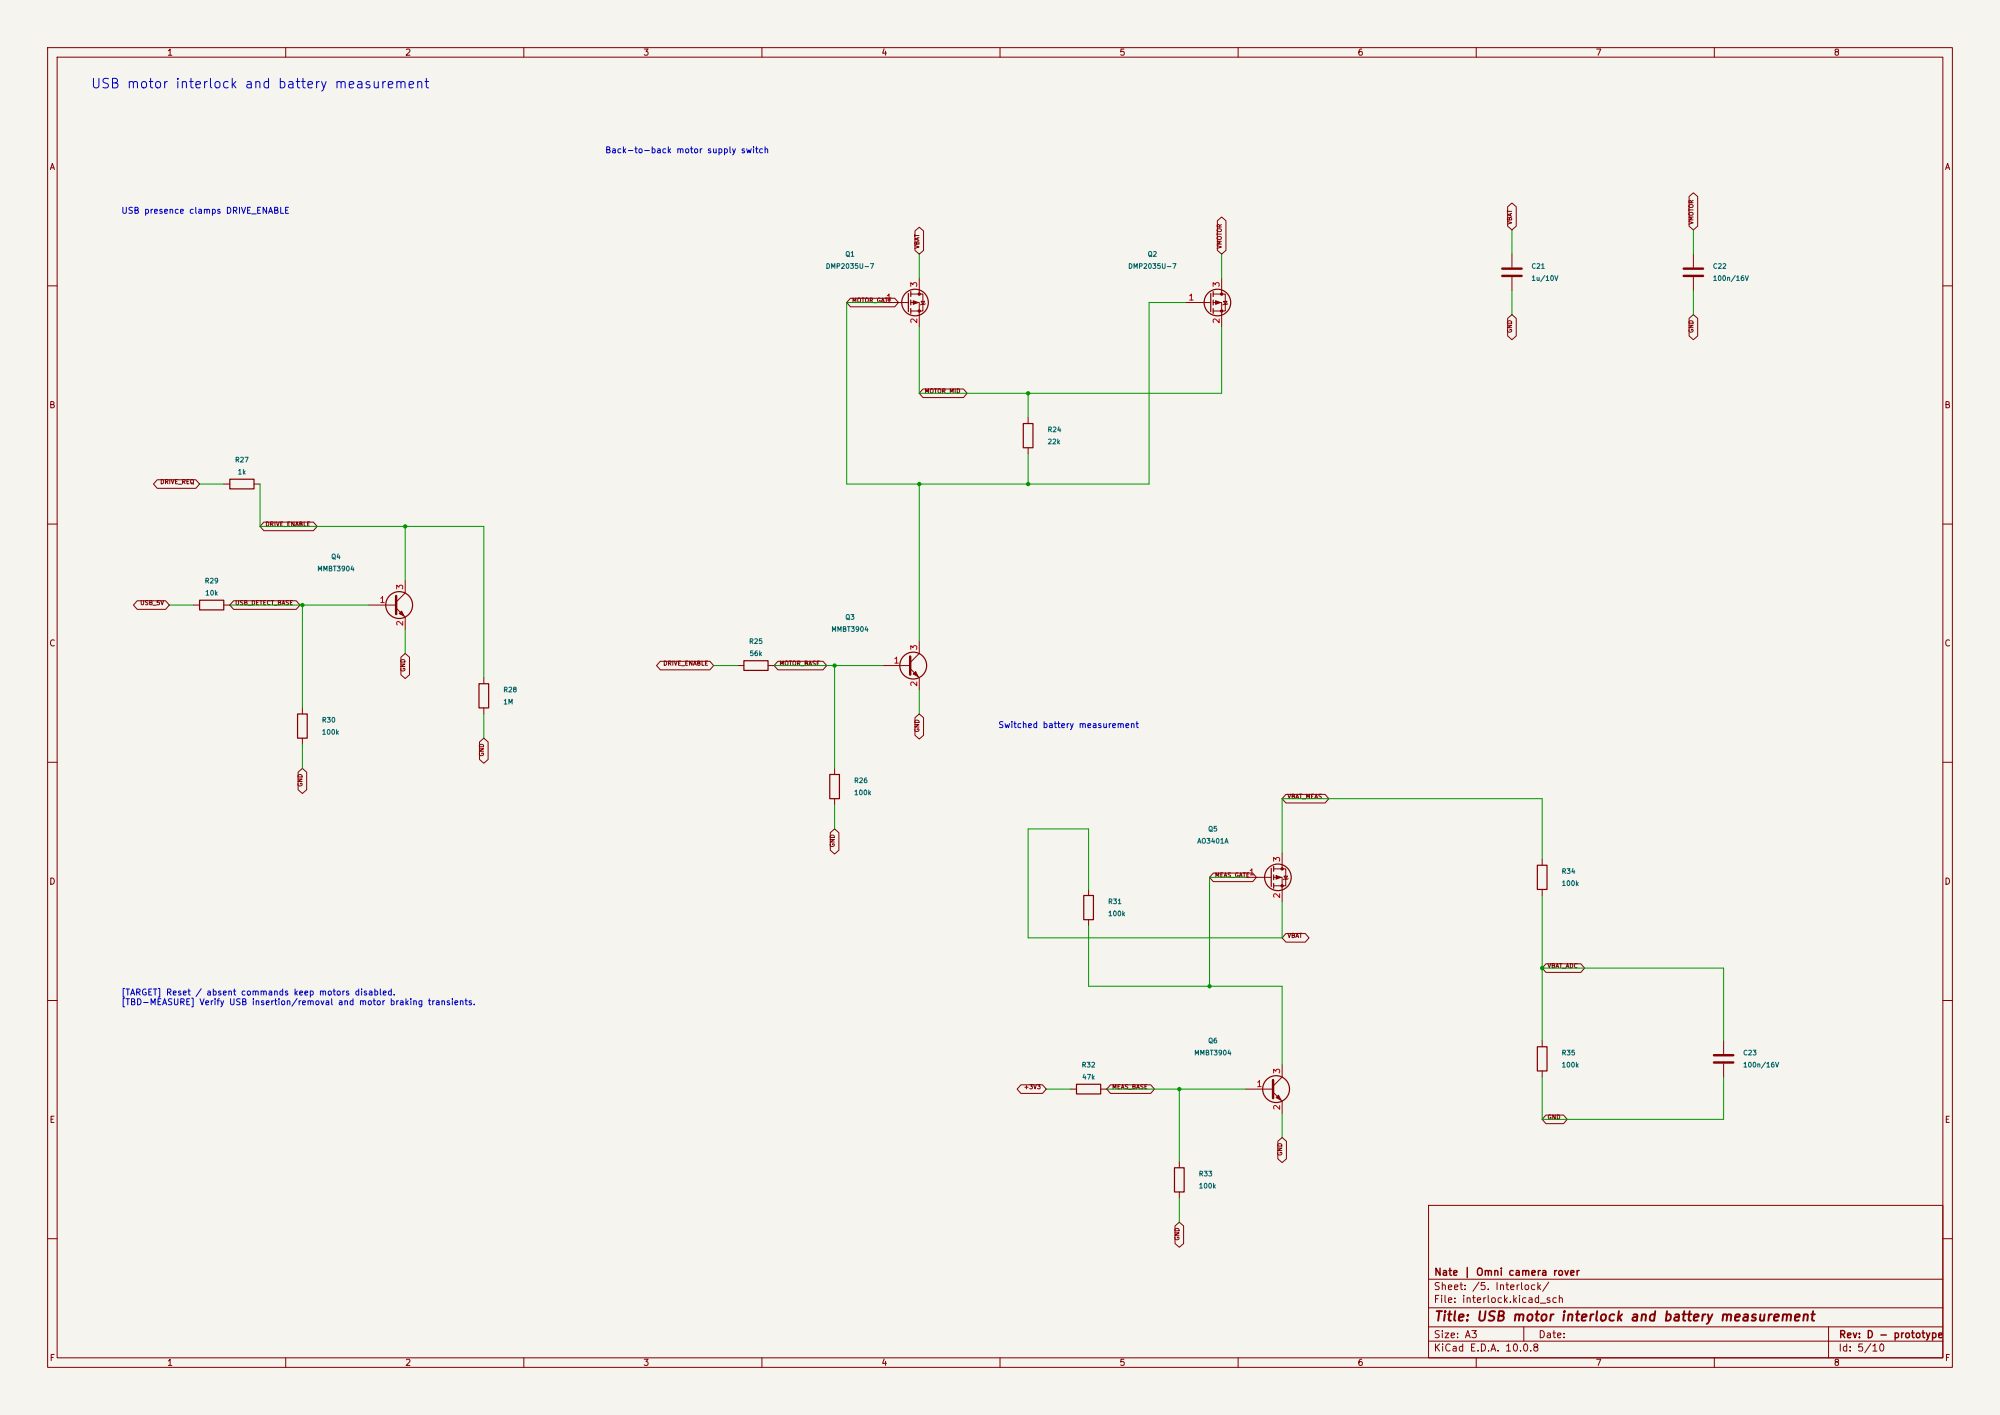
[picture p138: page 5]

[TARGET] Reset / absent commands keep motors disabled. [TBD-MEASURE] Verify USB insertion/removal and motor braking transients.

Nate | Omni camera rover
Sheet: /5. Interlock/
File: interlock.kicad_sch
Title: USB motor interlock and battery measurement

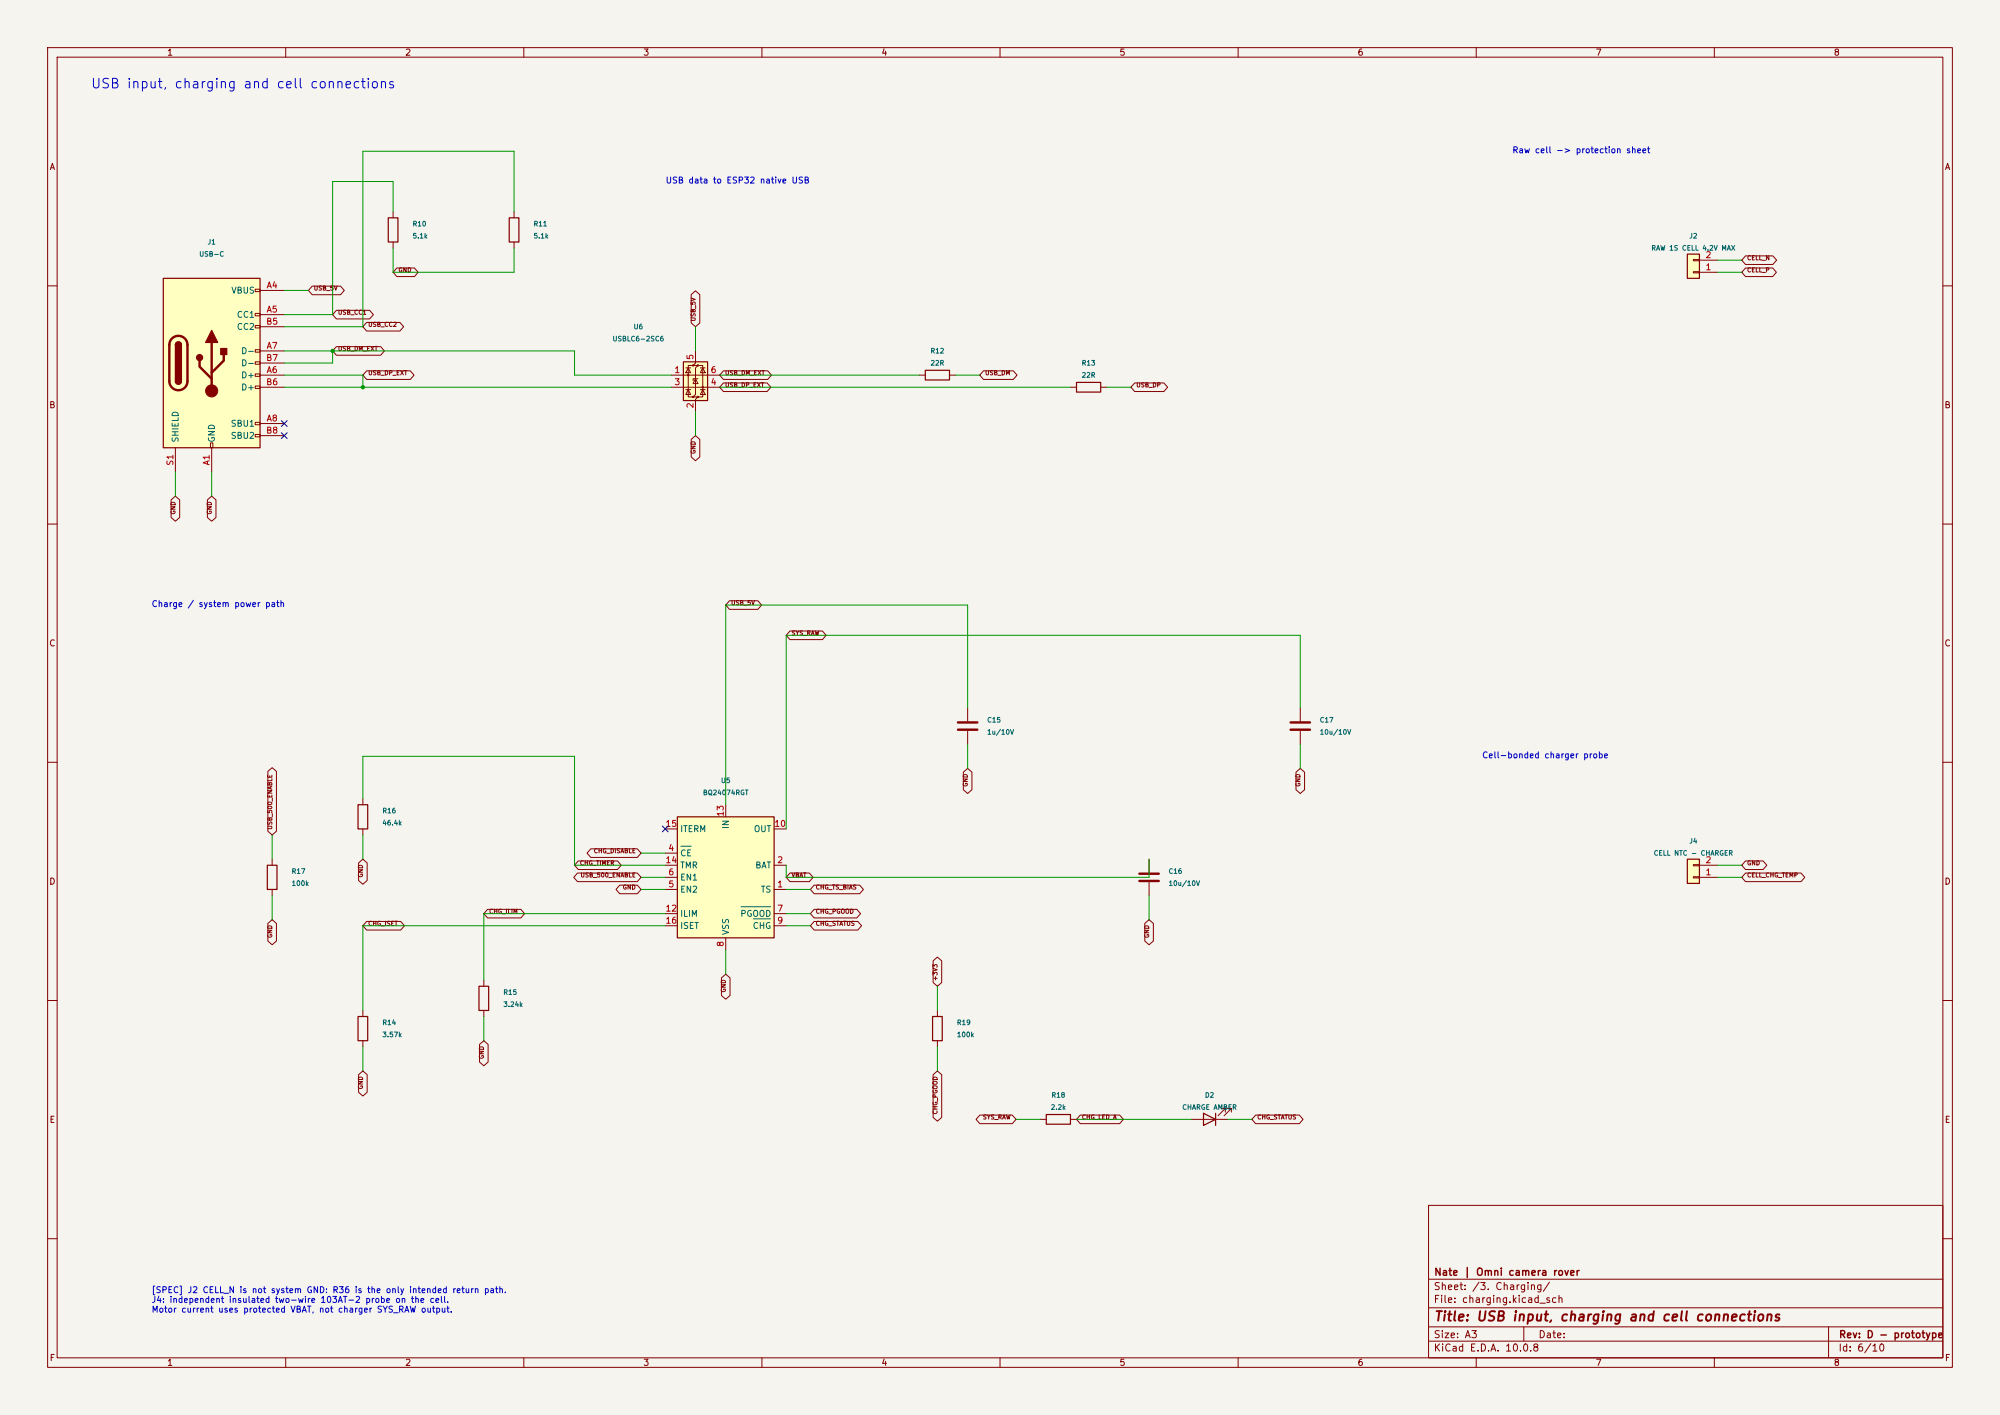
[picture p139: page 6]

USB_DM_EXT USB_DM_EXT USB input, charging and cell connections

Raw cell -> protection sheet Cell-bonded charger probe

USB data to ESP32 native USB

Charge / system power path

Nate | Omni camera rover R18

Sheet: /3. Charging/
File: charging.kicad_sch
Title: USB input, charging and cell connections

[SPEC] J2 CELL_N is not system GND: R36 is the only intended return path. J4: independent insulated two-wire 103AT-2 probe on the cell. Motor current uses protected VBAT, not charger SYS_RAW output.

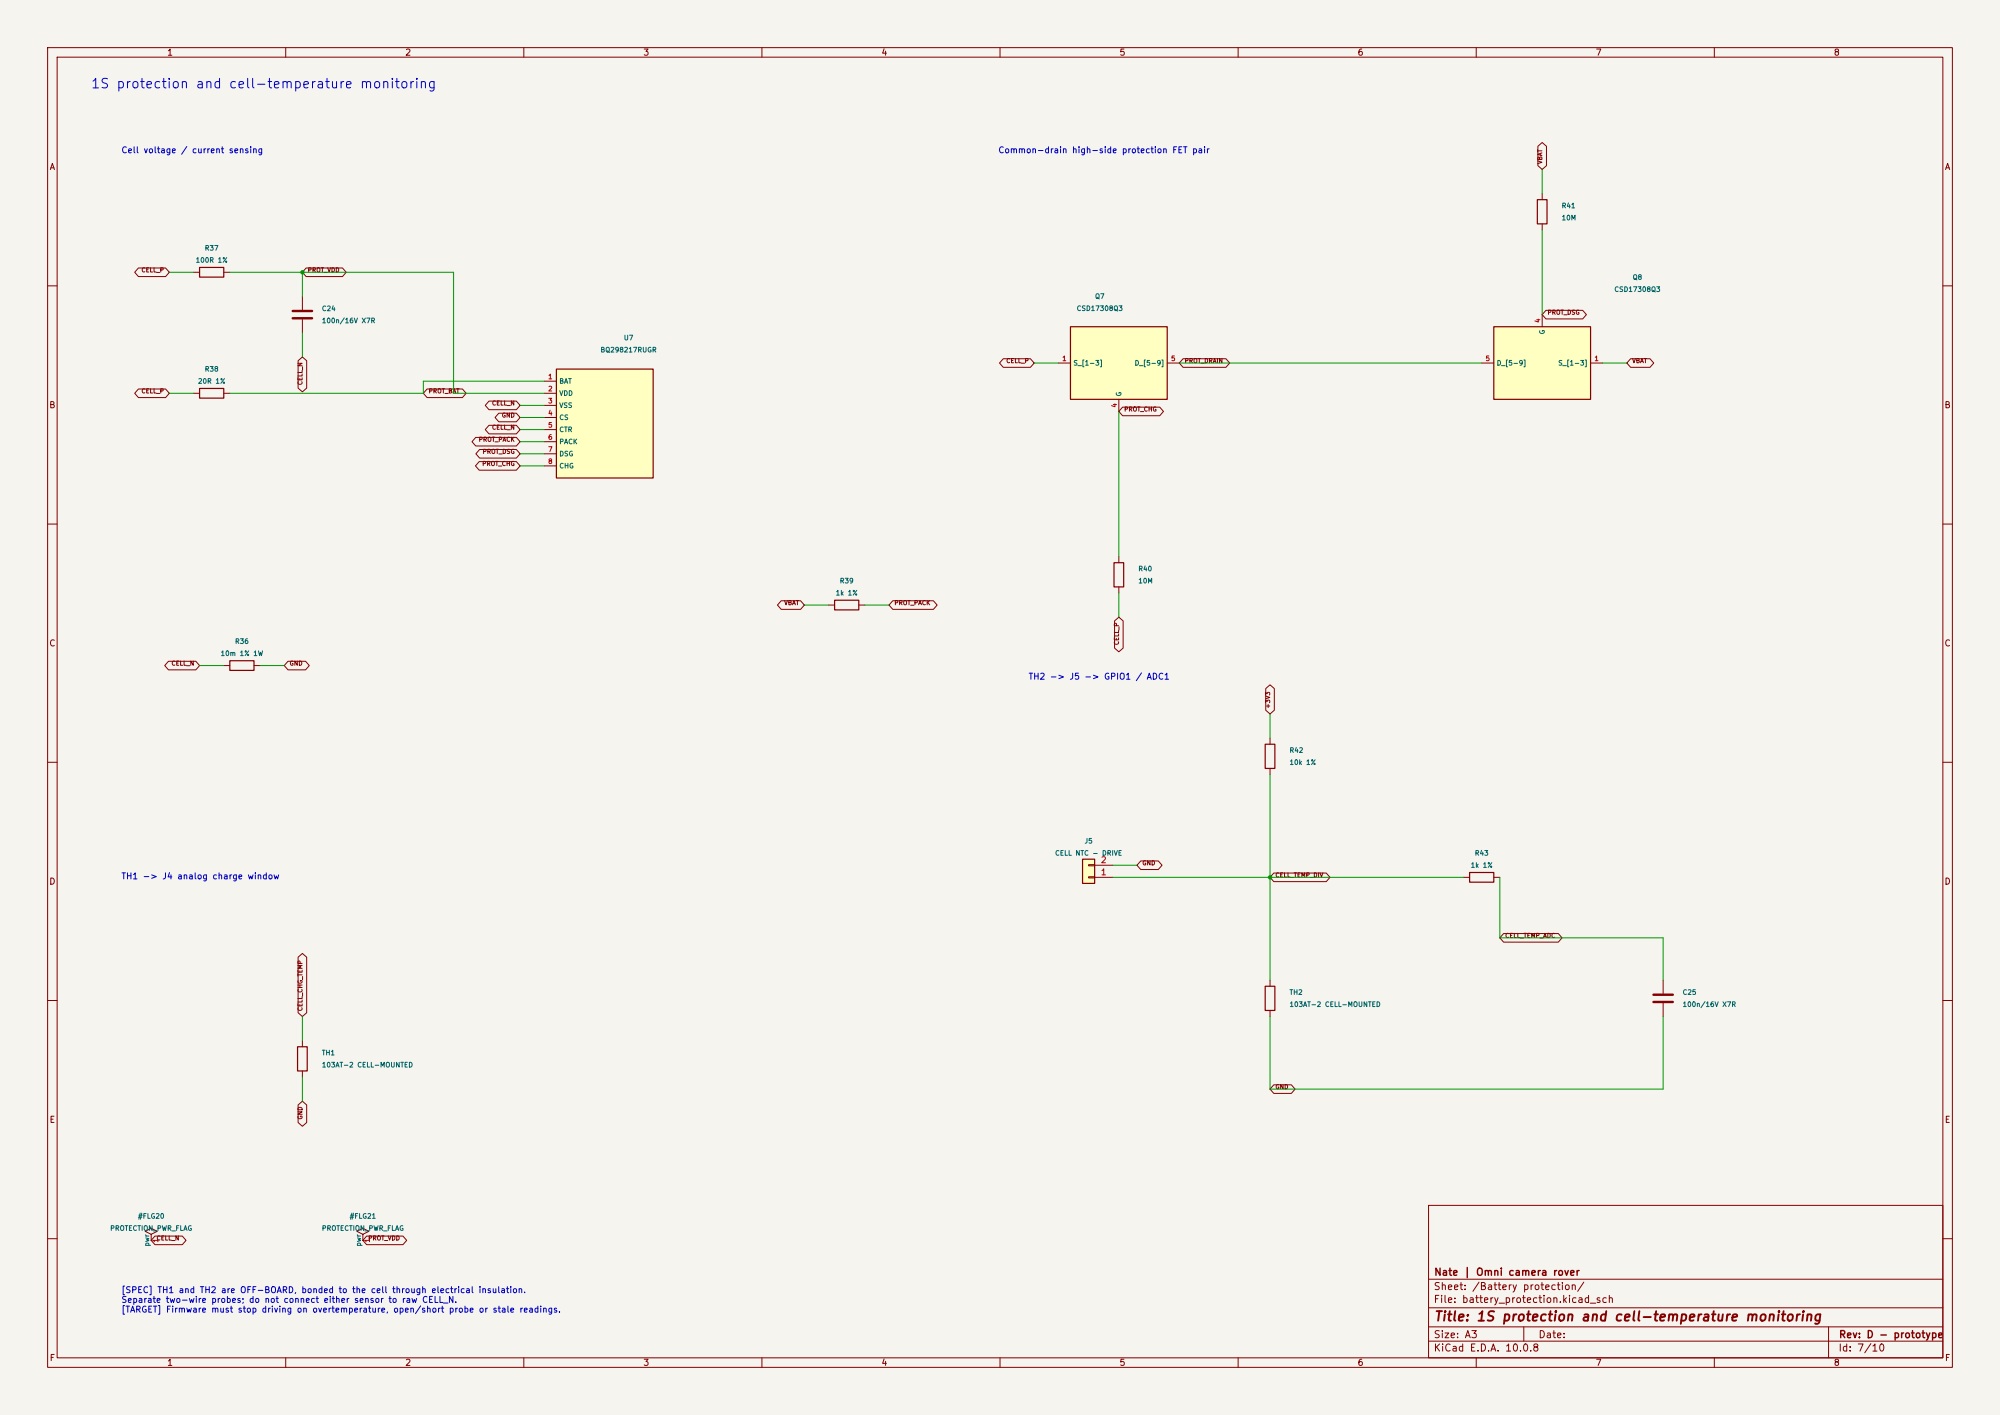
[picture p140: page 7]

1S protection and cell-temperature monitoring
PROT_DSG GND CELL_CHG_TEMP

GND TH1 -> J4 analog charge window

Nate | Omni camera rover
Sheet: /Battery protection/
File: battery_protection.kicad_sch
Title: 1S protection and cell-temperature monitoring

[SPEC] TH1 and TH2 are OFF-BOARD, bonded to the cell through electrical insulation. Separate two-wire probes; do not connect either sensor to raw CELL_N. [TARGET] Firmware must stop driving on overtemperature, open/short probe or stale readings.

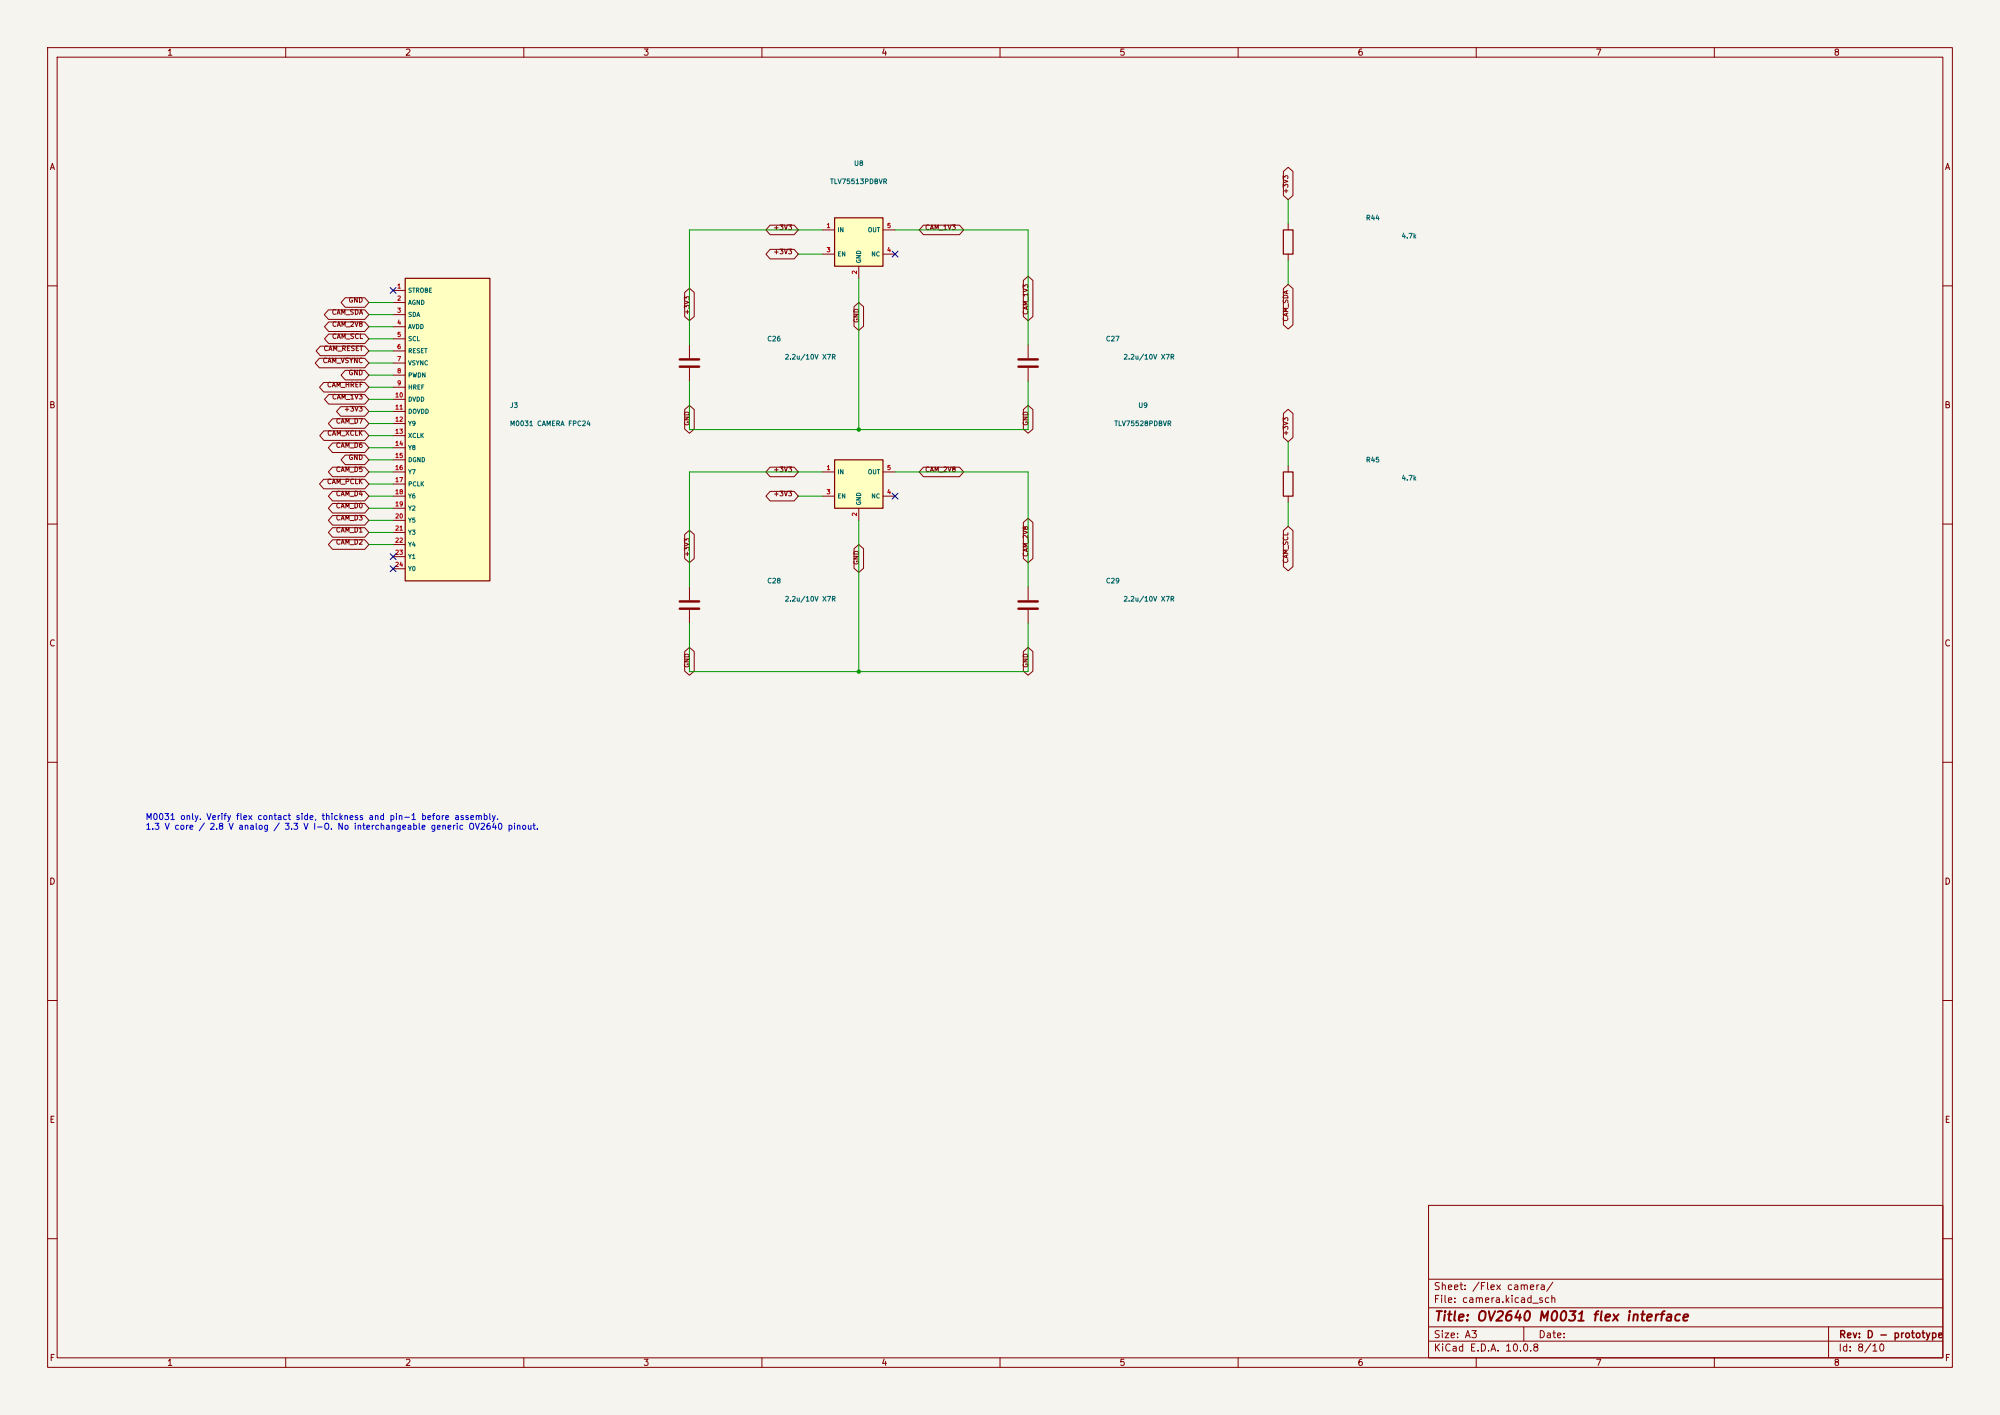
[picture p141: page 8]

CAM_HREF CAM_1V3 M0031 only. Verify flex contact side, thickness and pin-1 before assembly. 1.3 V core / 2.8 V analog / 3.3 V I-O. No interchangeable generic OV2640 pinout.

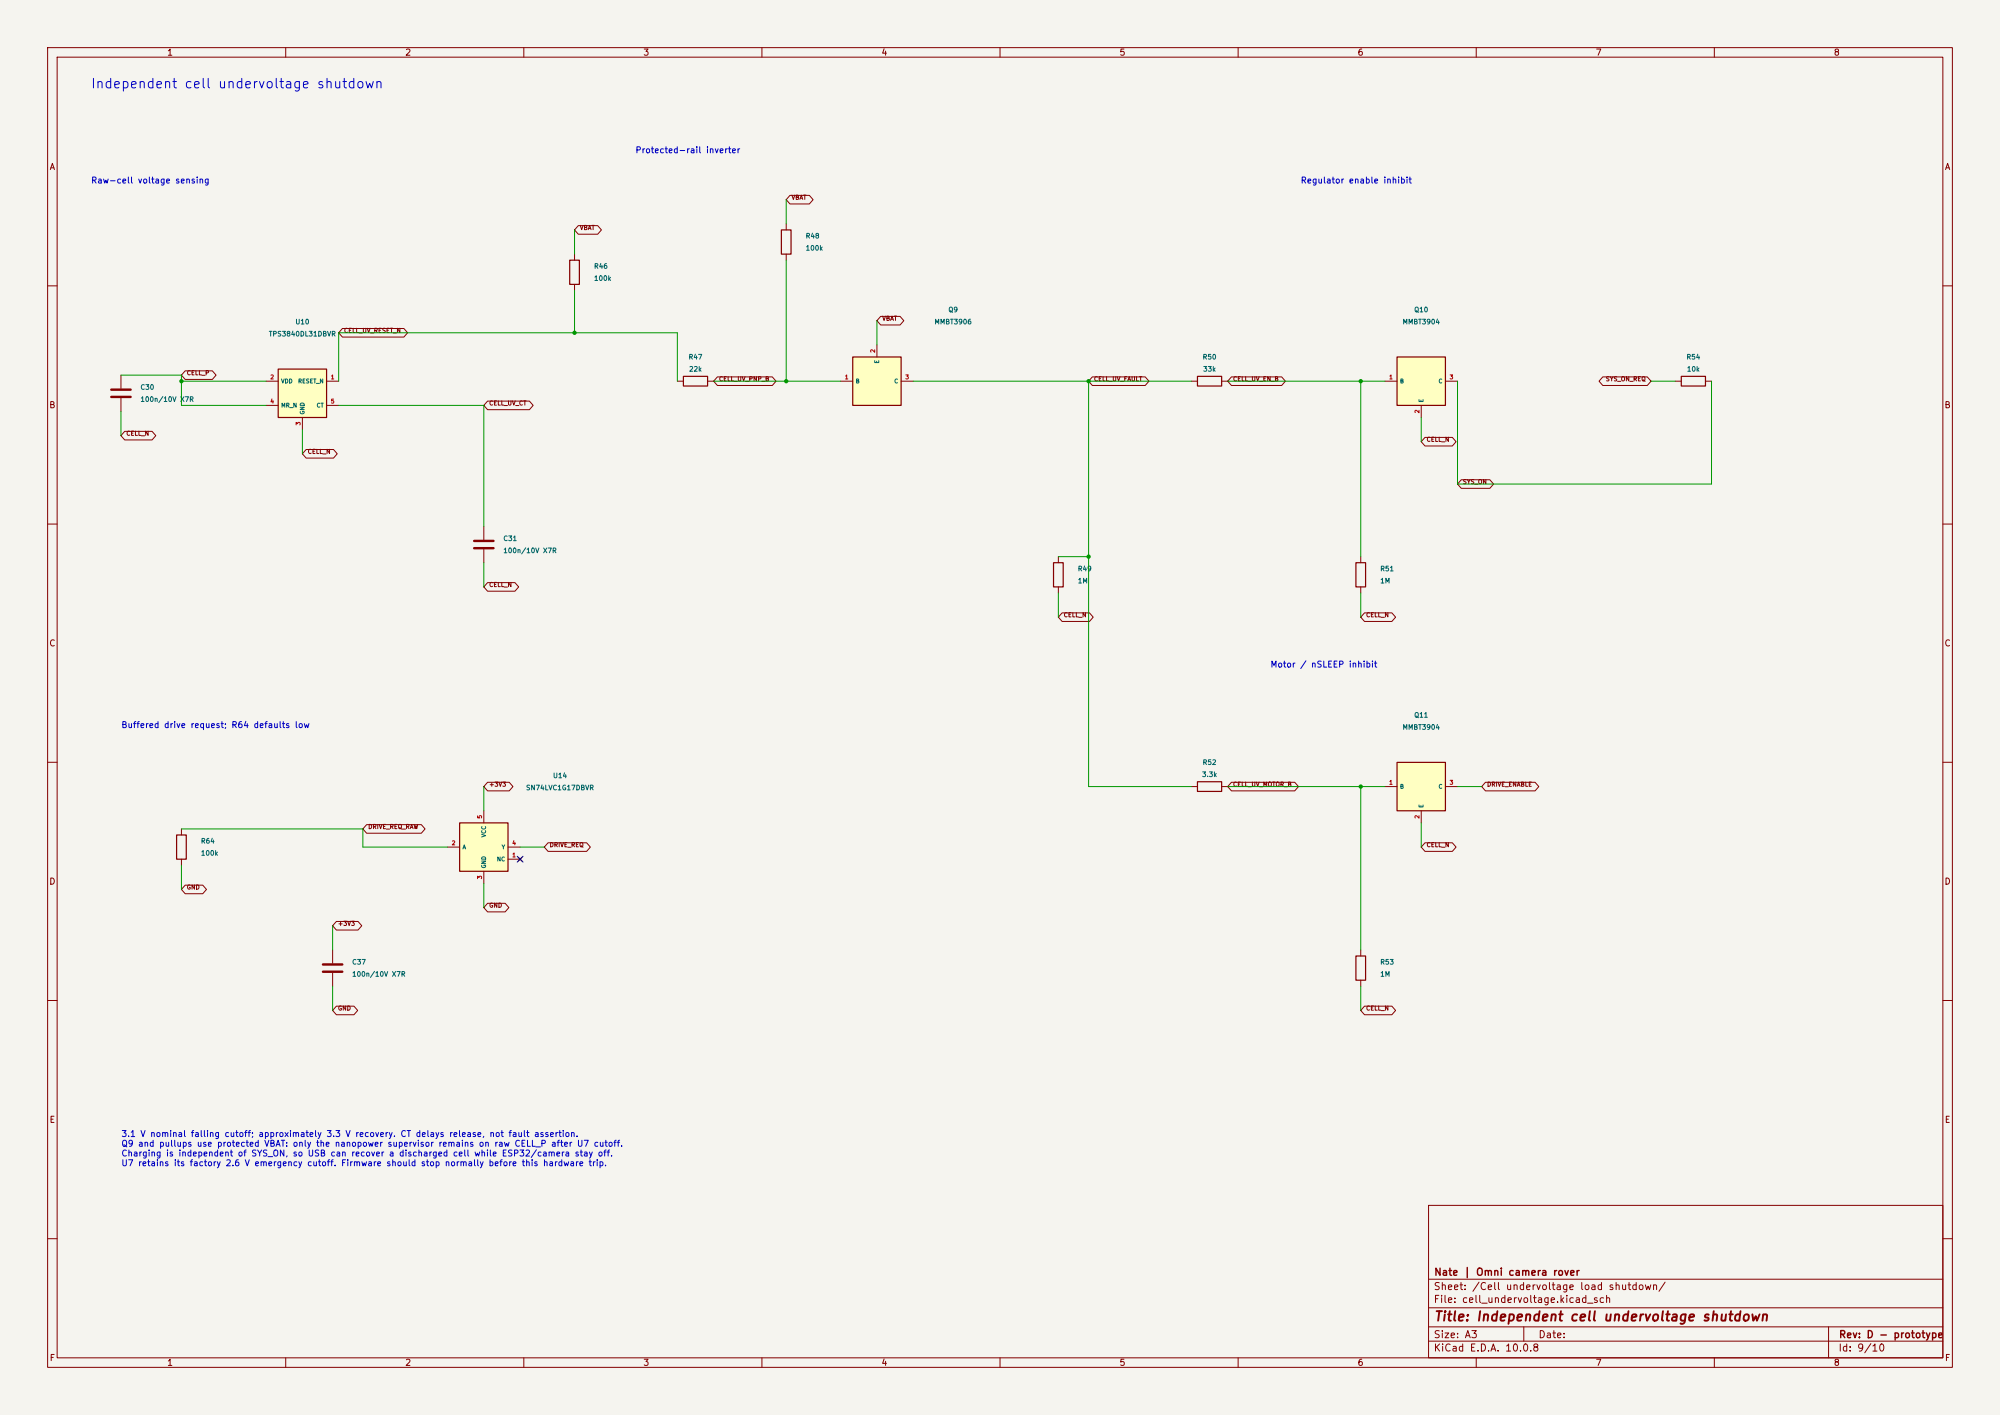
[picture p142: page 9]

Independent cell undervoltage shutdown
Raw-cell voltage sensing Buffered drive request; R64 defaults low

Regulator enable inhibit Motor / nSLEEP inhibit

3.1 V nominal falling cutoff; approximately 3.3 V recovery. CT delays release, not fault assertion. Q9 and pullups use protected VBAT: only the nanopower supervisor remains on raw CELL_P after U7 cutoff. Charging is independent of SYS_ON, so USB can recover a discharged cell while ESP32/camera stay off. U7 retains its factory 2.6 V emergency cutoff. Firmware should stop normally before this hardware trip.

Nate | Omni camera rover
Sheet: /Cell undervoltage load shutdown/
File: cell_undervoltage.kicad_sch
Title: Independent cell undervoltage shutdown

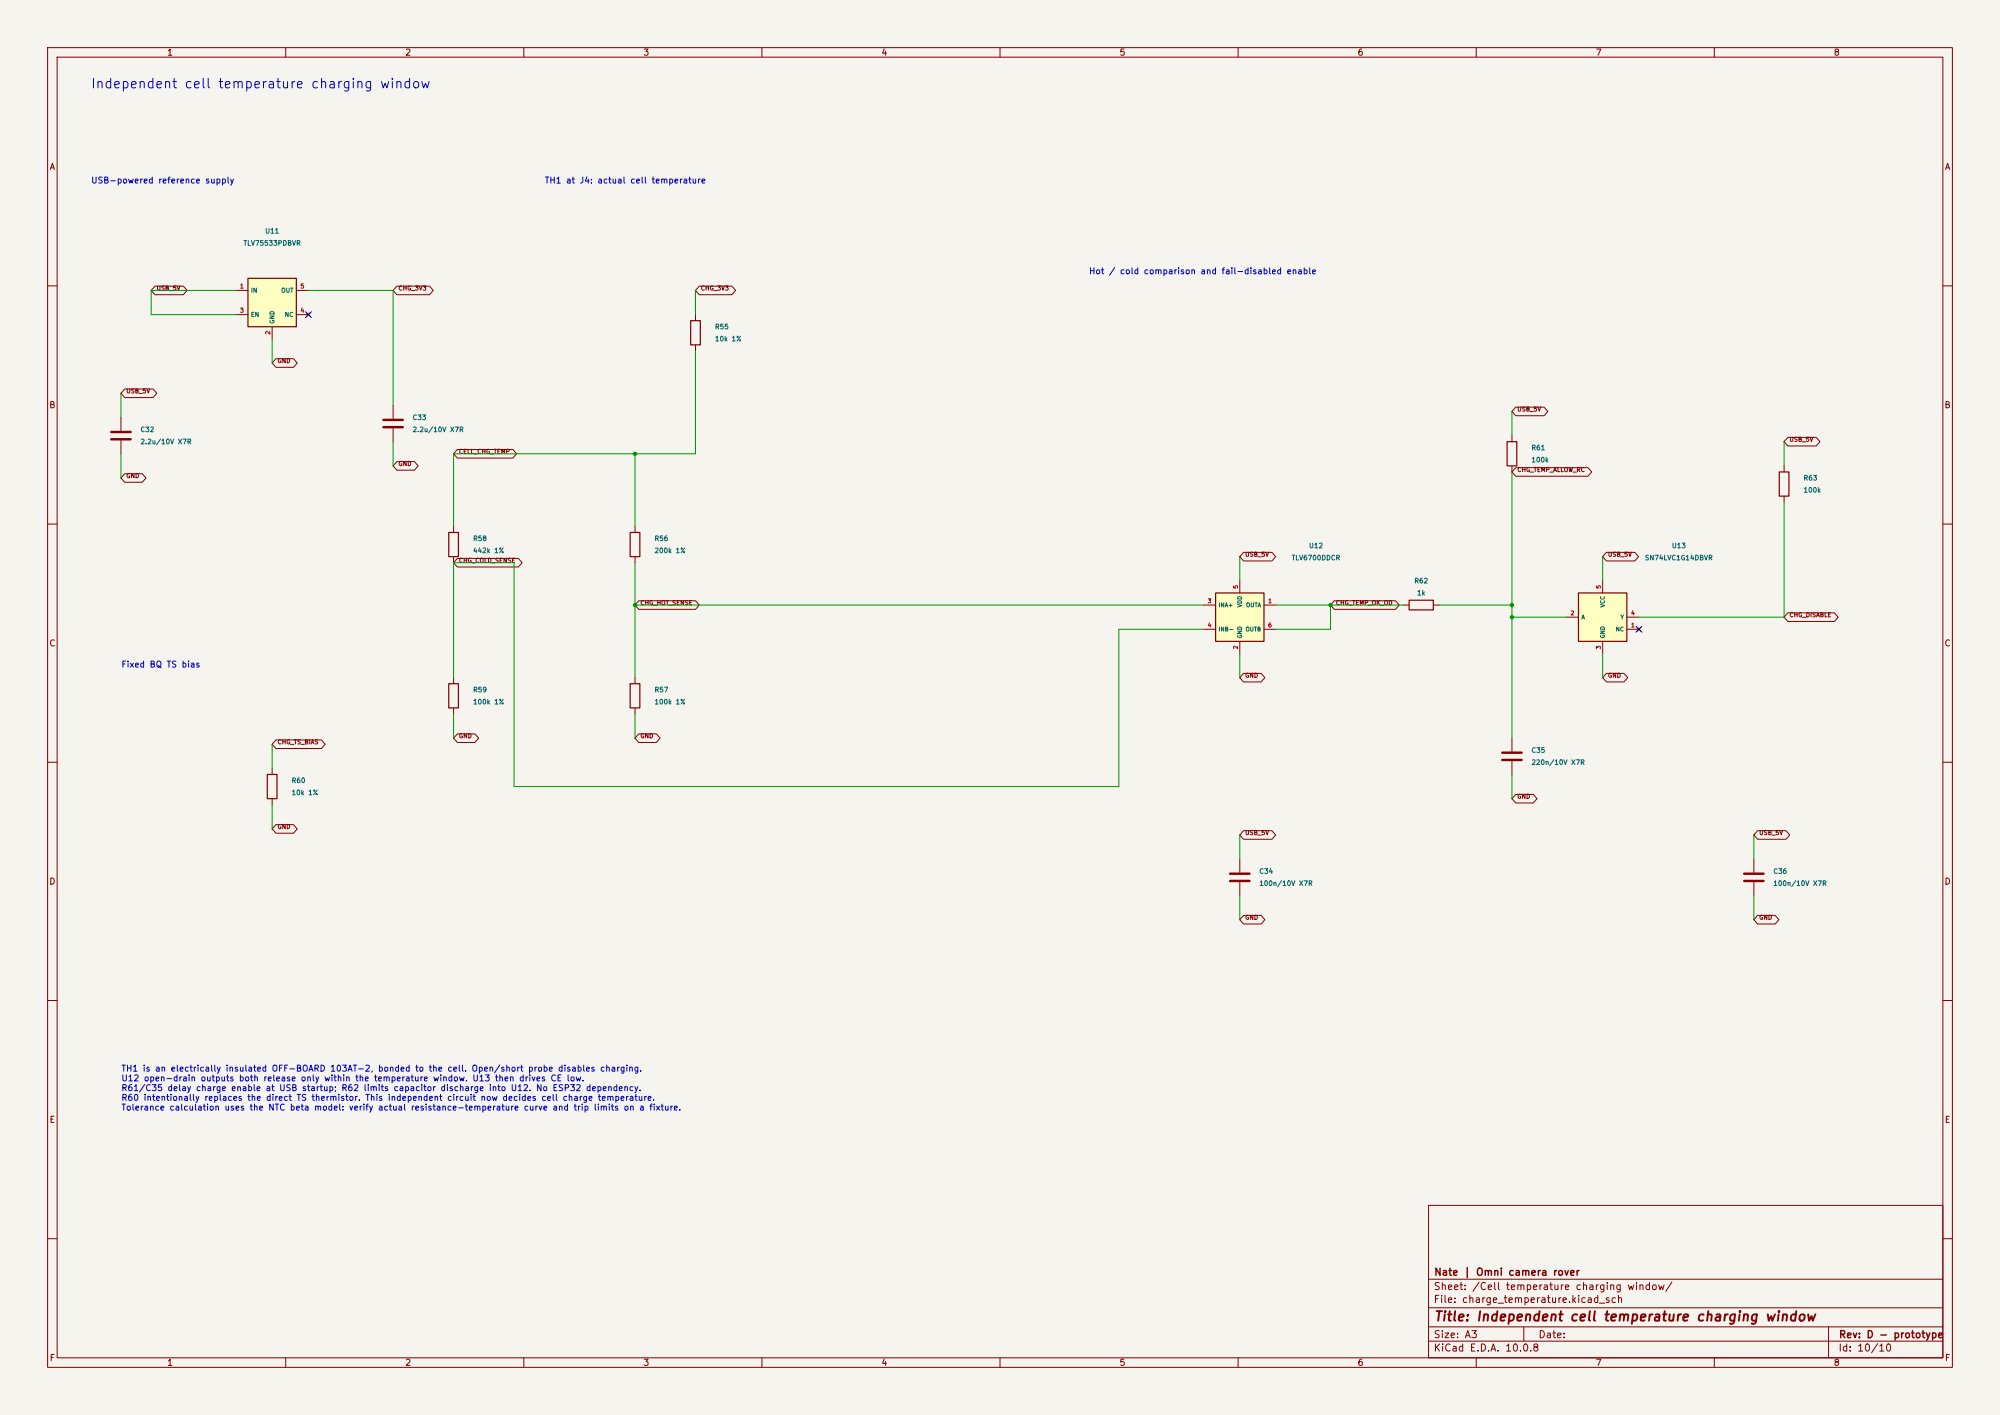
[picture p143: page 10]

Independent cell temperature charging window
USB-powered reference supply Fixed BQ TS bias

TH1 at J4: actual cell temperature

TH1 is an electrically insulated OFF-BOARD 103AT-2, bonded to the cell. Open/short probe disables charging. U12 open-drain outputs both release only within the temperature window. U13 then drives CE low. R61/C35 delay charge enable at USB startup; R62 limits capacitor discharge into U12. No ESP32 dependency. R60 intentionally replaces the direct TS thermistor. This independent circuit now decides cell charge temperature. Tolerance calculation uses the NTC beta model: verify actual resistance-temperature curve and trip limits on a fixture.

Nate | Omni camera rover
Sheet: /Cell temperature charging window/
File: charge_temperature.kicad_sch
Title: Independent cell temperature charging window
