ncripted/DAMIEN/outputs/rover/Omni_UGV_Rev_F_integration/Schematic.pdf

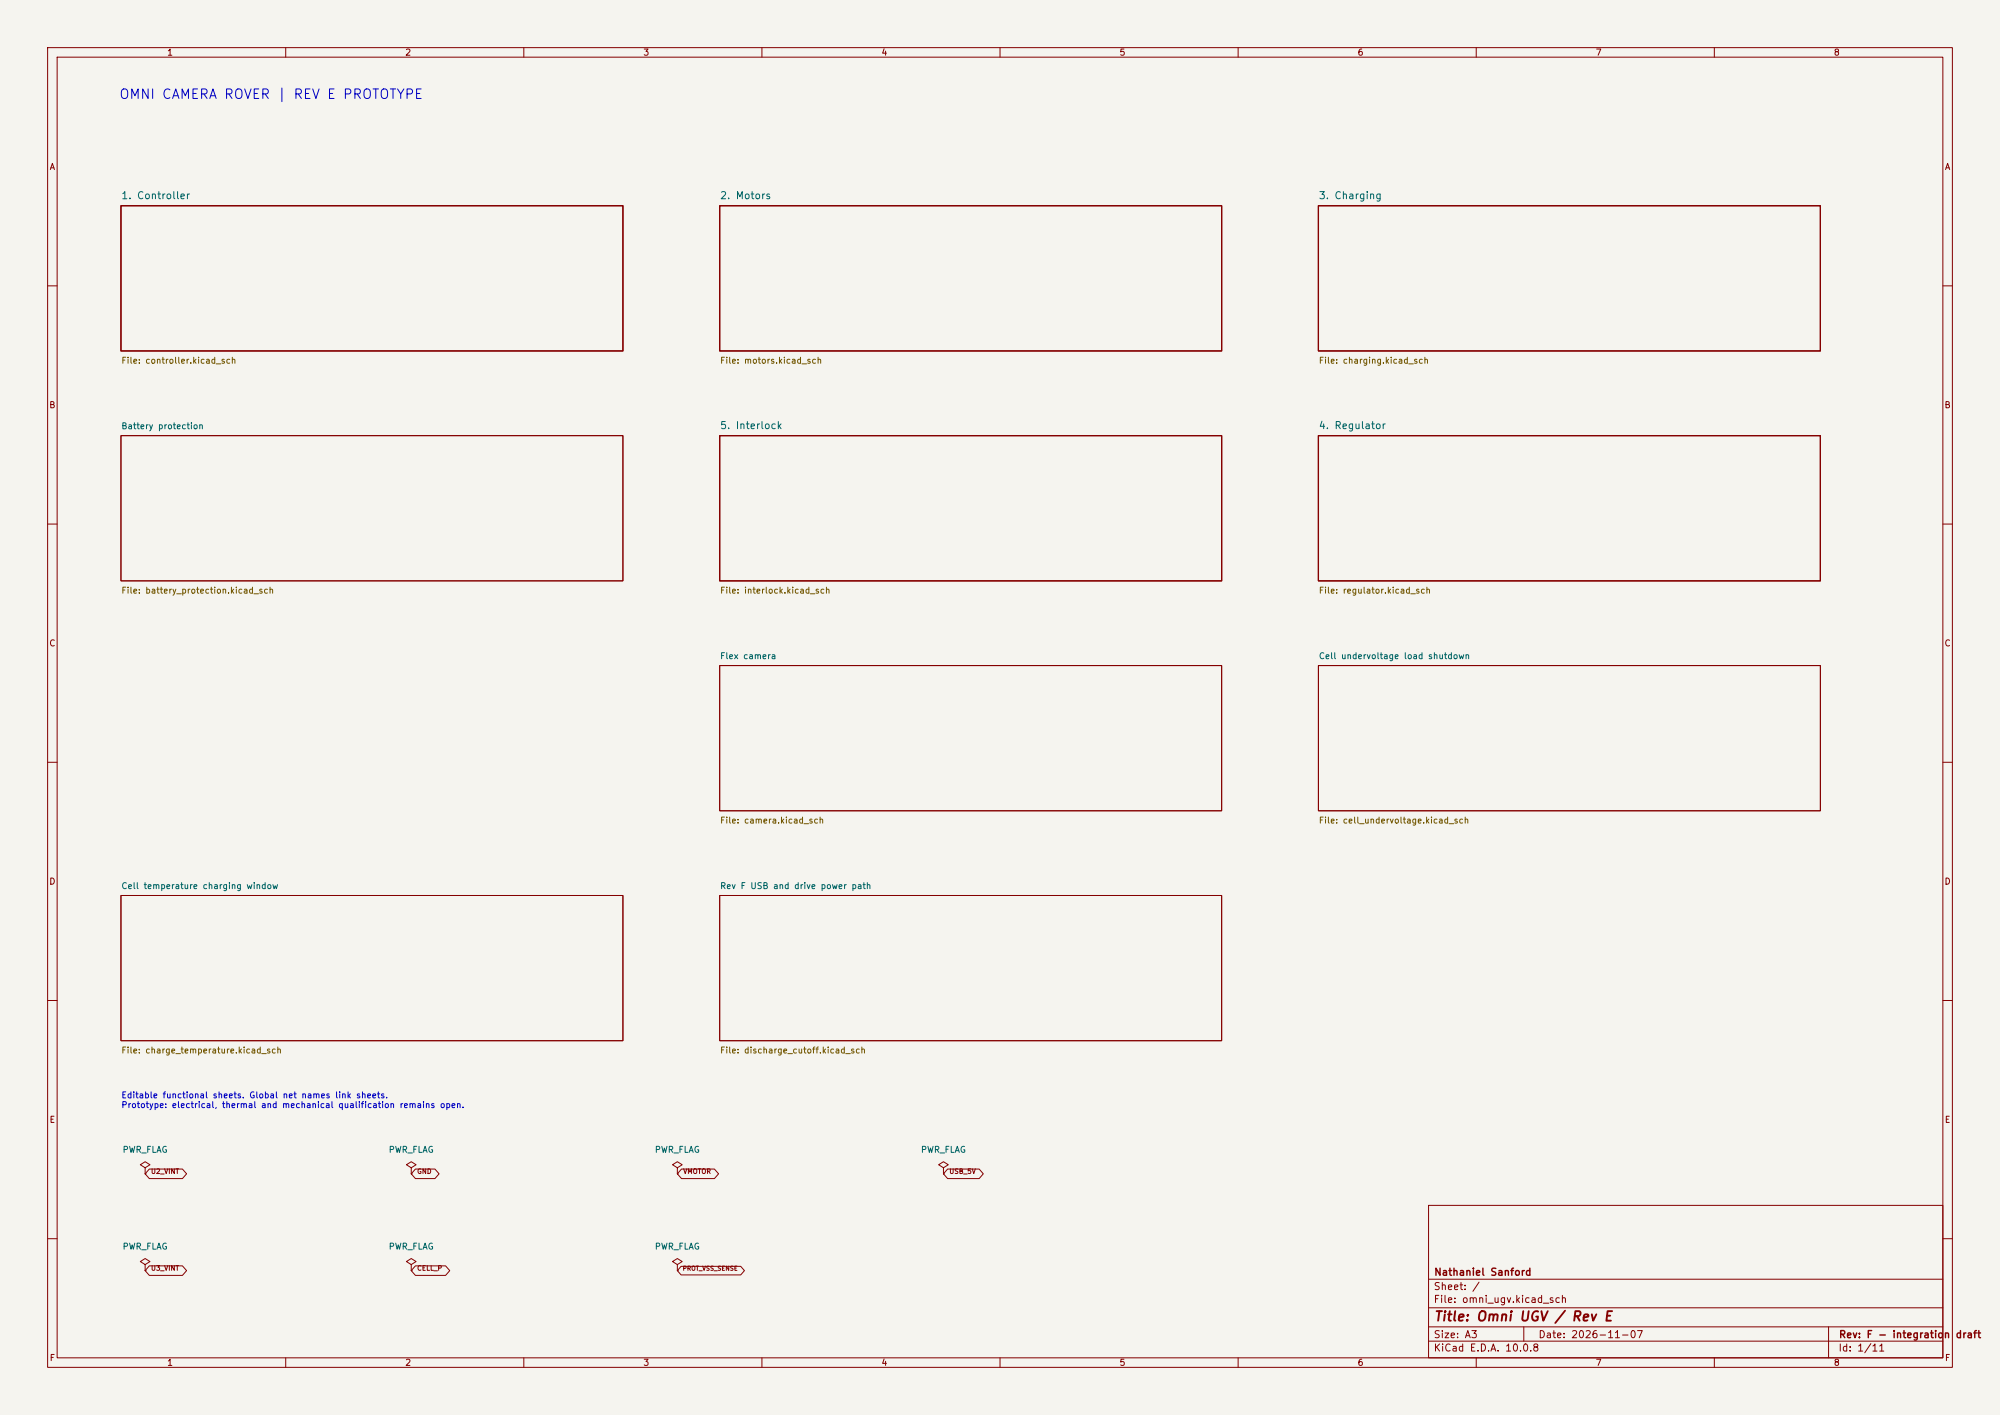
[picture p144: page 1]

1. Controller File: controller.kicad_sch Battery protection

OMNI CAMERA ROVER | REV E PROTOTYPE

Cell temperature charging window

Nathaniel Sanford
Sheet: /
File: omni_ugv.kicad_sch
Title: Omni UGV / Rev E

F Date: 2026-11-07

KiCad E.D.A. 10.0.8 | Id: 1/11


[SPEC] GPIO35 / 36 / 37 reserved for N8R8 PSRAM.

Service points (named nets continue on other sheets)

Nate | Omni camera rover
Sheet: /1. Controller/
File: controller.kicad_sch
Title: Controller, camera and service points


[TARGET] Keep switching loops short. Place input/output capacitors at U4. [TBD-MEASURE] Verify startup, load transients and capacitor effective capacitance.

Nate | Omni camera rover
Sheet: /4. Regulator/
File: regulator.kicad_sch
Title: 3.3 V buck-boost supply


Three independent motor channels
M2_IN1 M3_SENSE GND

Motor terminal pads and suppression capacitors U3: wheel 3; unused bridge pins retained as designed

Nate | Omni camera rover
Sheet: /2. Motors/
File: motors.kicad_sch
Title: Three independent motor channels

[TARGET] Route motor current away from logic returns. [TBD-MEASURE] Braking overshoot, driver temperature and carpet load.


[TARGET] Reset / absent commands keep motors disabled. [TBD-MEASURE] Verify USB insertion/removal and motor braking transients.

Nate | Omni camera rover
Sheet: /5. Interlock/
File: interlock.kicad_sch
Title: USB motor interlock and battery measurement

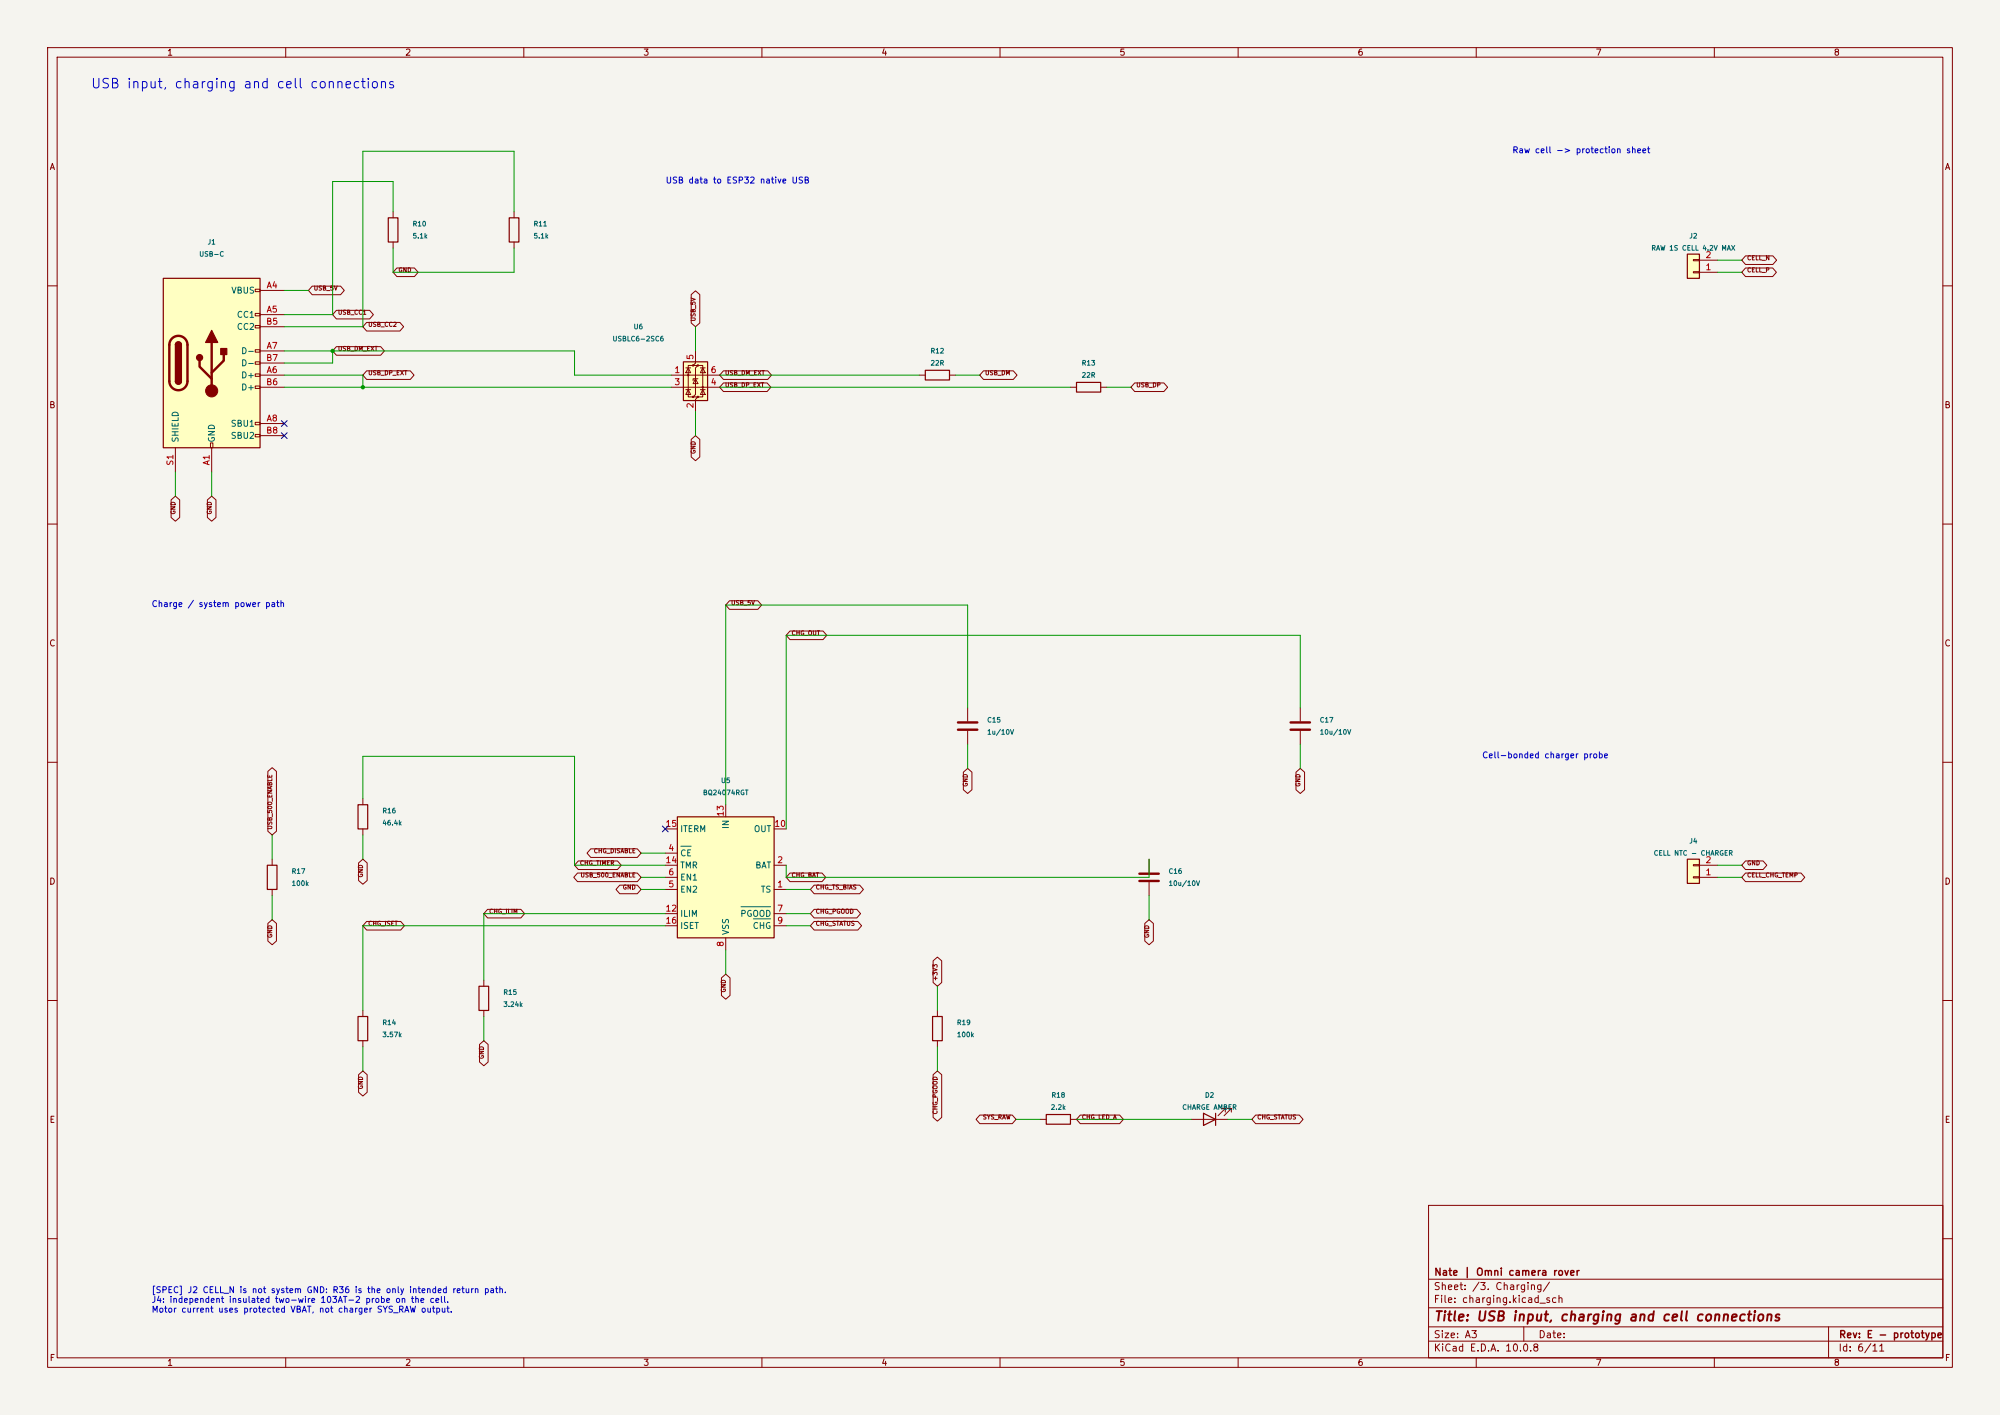
[picture p145: page 6]

USB_DM_EXT USB_DM_EXT USB input, charging and cell connections

Raw cell -> protection sheet Cell-bonded charger probe

USB data to ESP32 native USB

Charge / system power path

Nate | Omni camera rover R18

Sheet: /3. Charging/
File: charging.kicad_sch
Title: USB input, charging and cell connections

[SPEC] J2 CELL_N is not system GND: R36 is the only intended return path. J4: independent insulated two-wire 103AT-2 probe on the cell. Motor current uses protected VBAT, not charger SYS_RAW output.

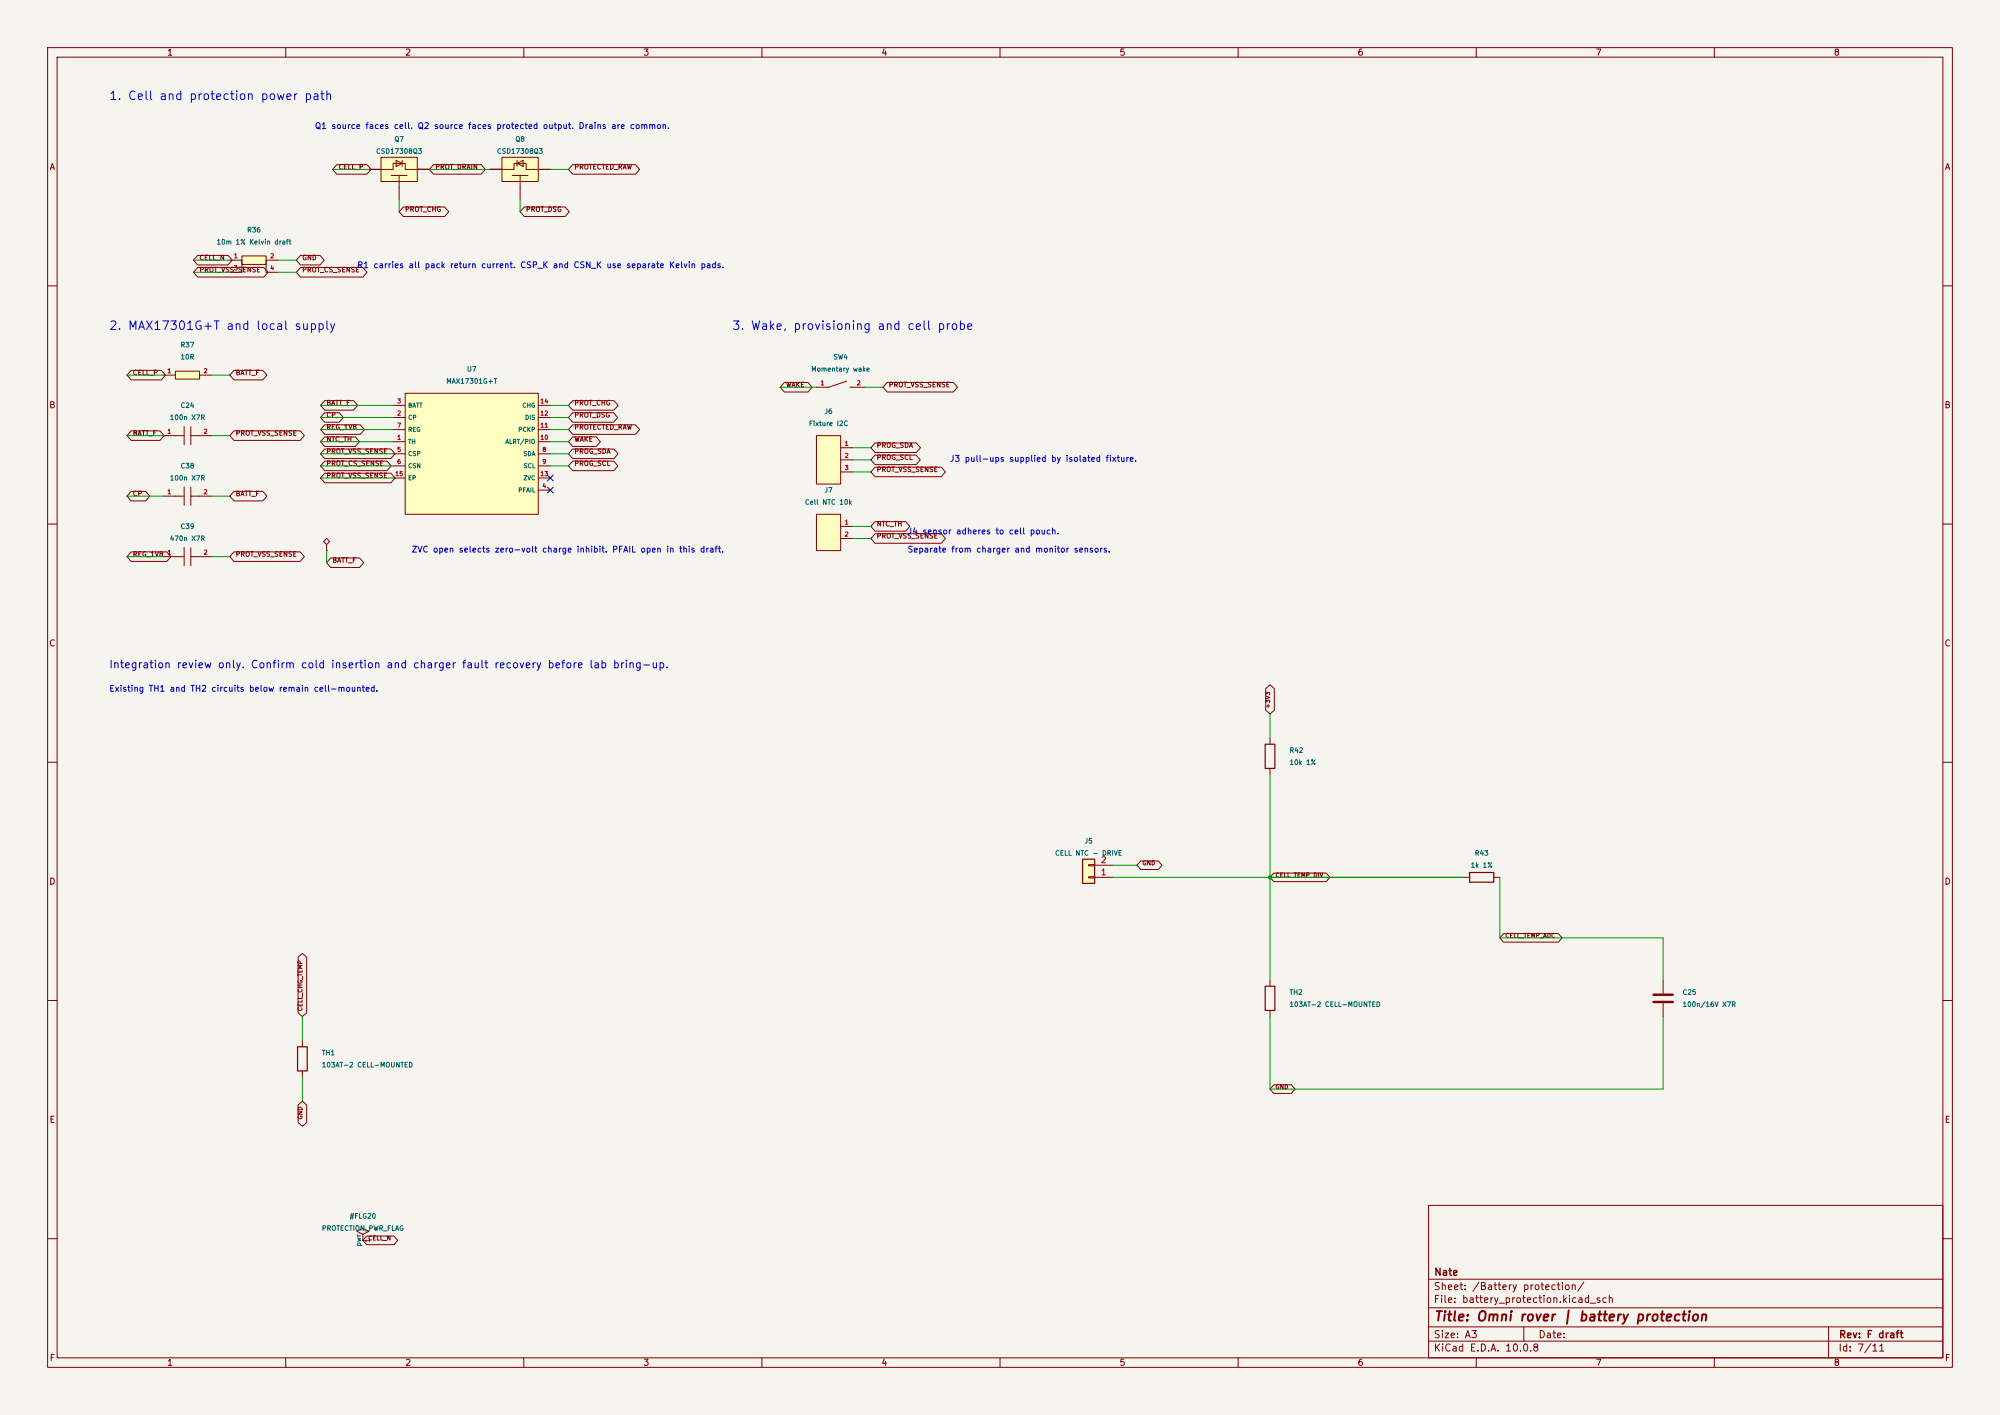
[picture p146: page 7]

1. Cell and protection power path
Fixture I2C Q8 CSD17308Q3 pwr 1 #FLG20 PROTECTION_PWR_FLAG

R1 carries all pack return current. CSP_K and CSN_K use separate Kelvin pads.

J4 sensor adheres to cell pouch. J3 pull-ups supplied by isolated fixture. 3. Wake, provisioning and cell probe

Integration review only. Confirm cold insertion and charger fault recovery before lab bring-up.

Existing TH1 and TH2 circuits below remain cell-mounted.

Nate
Sheet: /Battery protection/
File: battery_protection.kicad_sch
Title: Omni rover | battery protection


CAM_HREF CAM_1V3 M0031 only. Verify flex contact side, thickness and pin-1 before assembly. 1.3 V core / 2.8 V analog / 3.3 V I-O. No interchangeable generic OV2640 pinout.


Independent cell undervoltage shutdown

3.1 V supervisor: load inhibits plus independent discharge cutoff on sheet 11

R46 now pulls RESET_N to raw CELL_P. Q12/Q13 remain effective after protected VBAT disappears.
Q9/Q10/Q11 retain the existing logic and motor inhibits; R64 defaults the motor request low. U7 retains independent overvoltage/current/short protection and its factory 2.6 V UV threshold. This is not a zero-leakage storage disconnect: the supervisor, protector and cutoff bias still use cell current.

Nate | Omni camera rover
Sheet: /Cell undervoltage load shutdown/
File: cell_undervoltage.kicad_sch
Title: Independent cell undervoltage shutdown


Independent cell temperature charging window
USB-powered reference supply Fixed BQ TS bias

TH1 at J4: actual cell temperature

TH1 is an electrically insulated OFF-BOARD 103AT-2, bonded to the cell. Open/short probe disables charging. U12 open-drain outputs both release only within the temperature window. U13 then drives CE low. R61/C35 delay charge enable at USB startup; R62 limits capacitor discharge into U12. No ESP32 dependency. R60 intentionally replaces the direct TS thermistor. This independent circuit now decides cell charge temperature. Tolerance calculation uses the NTC beta model: verify actual resistance-temperature curve and trip limits on a fixture.

Nate | Omni camera rover
Sheet: /Cell temperature charging window/
File: charge_temperature.kicad_sch
Title: Independent cell temperature charging window

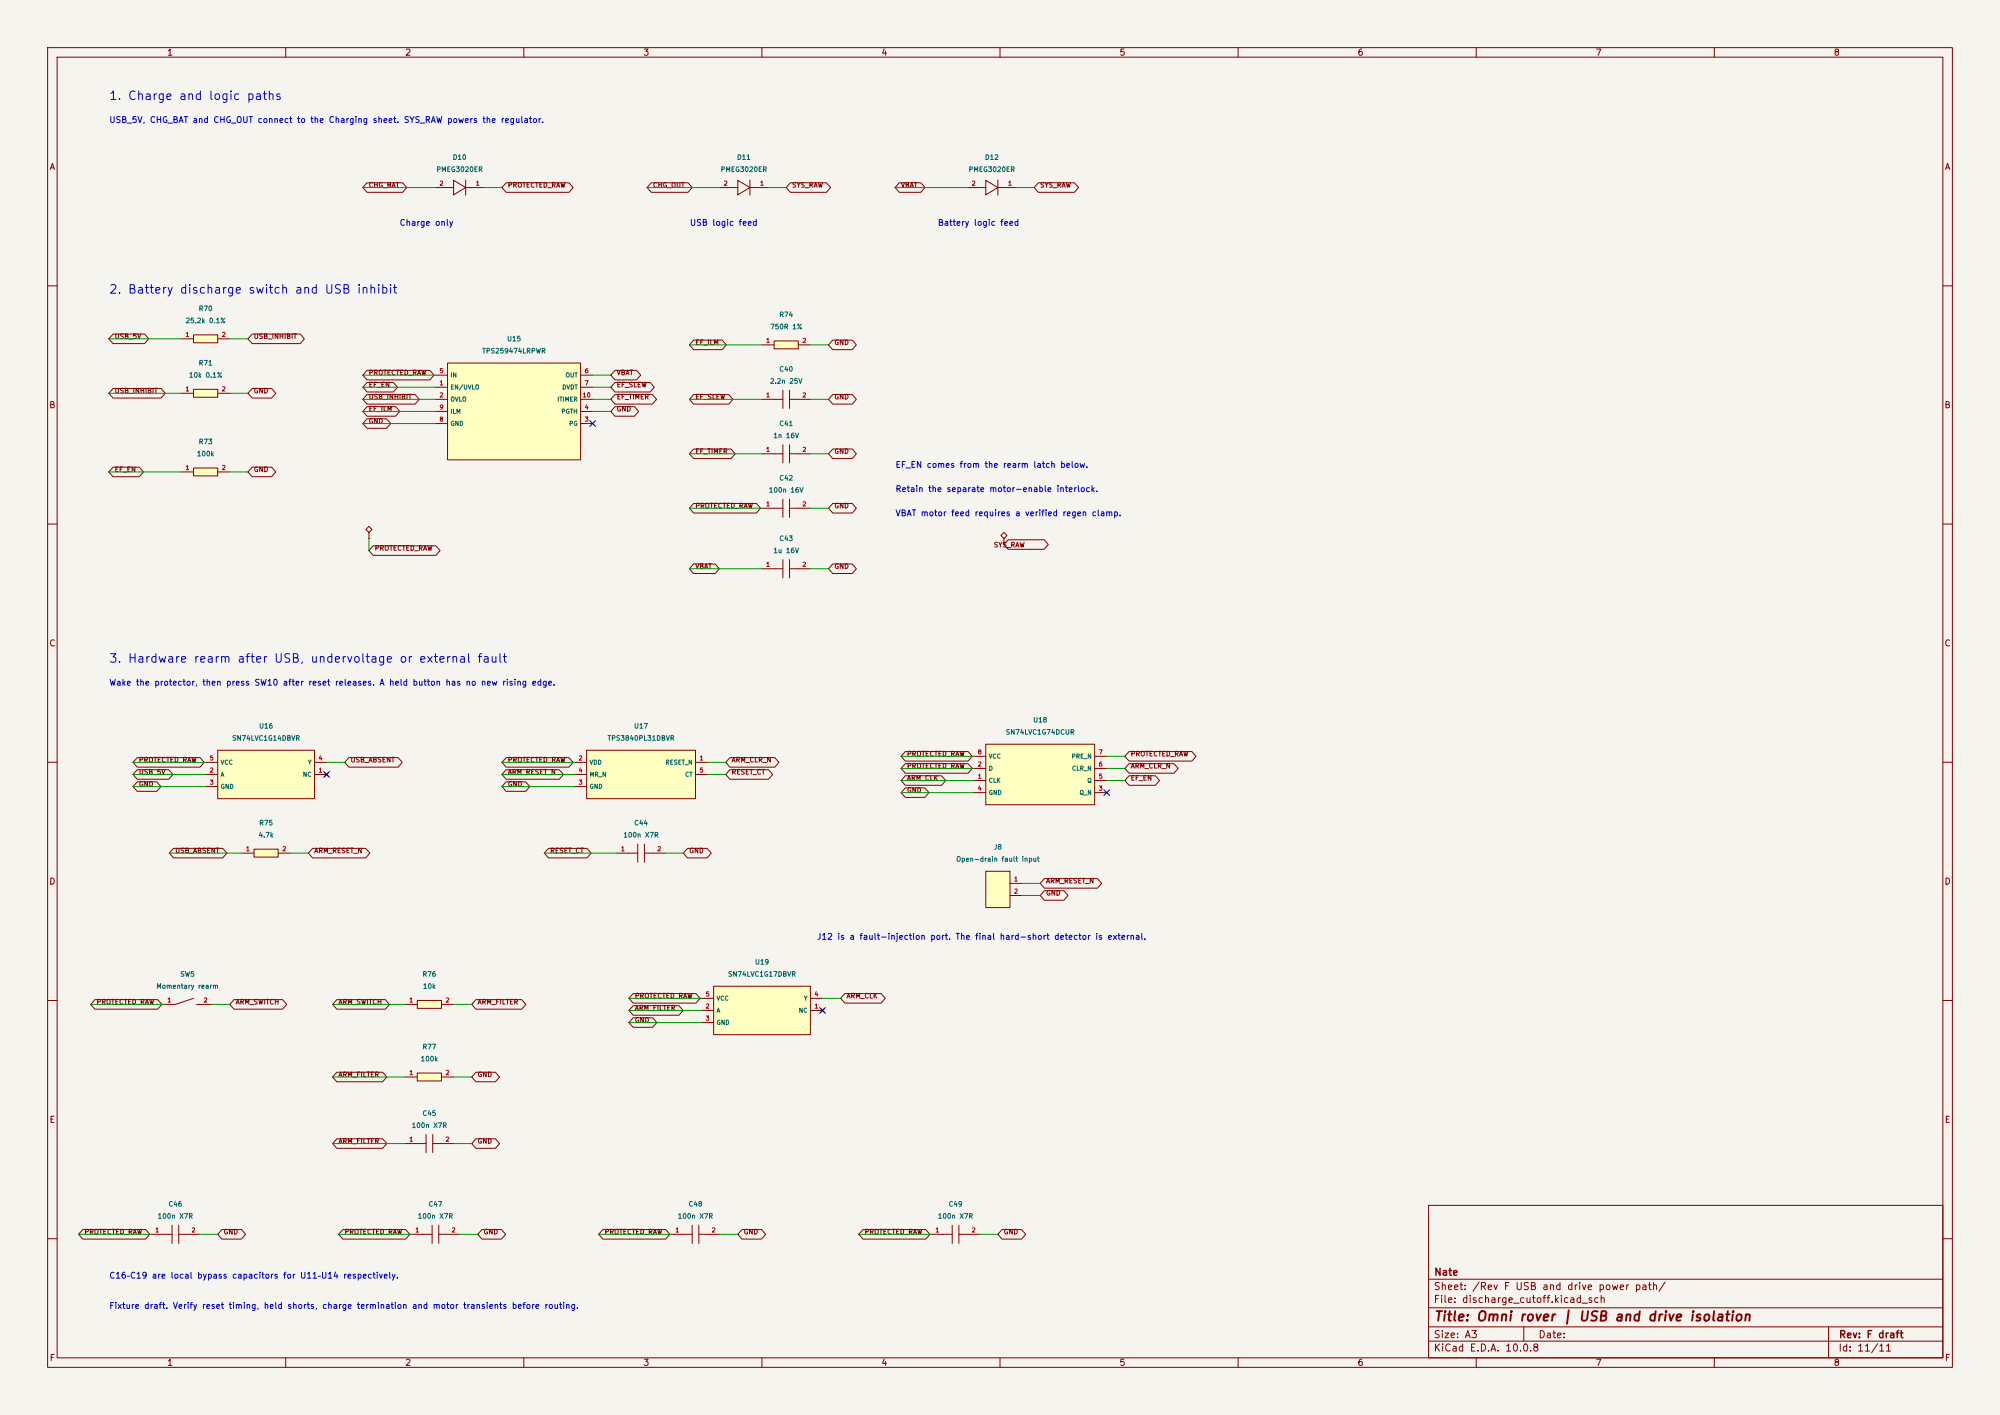
[picture p147: page 11]

EF_EN comes from the rearm latch below. 1. Charge and logic paths

VBAT motor feed requires a verified regen clamp.

3. Hardware rearm after USB, undervoltage or external fault

J8 Open-drain fault input

J12 is a fault-injection port. The final hard-short detector is external.

Nate
Sheet: /Rev F USB and drive power path/
File: discharge_cutoff.kicad_sch
Title: Omni rover | USB and drive isolation

C16–C19 are local bypass capacitors for U11–U14 respectively.

Fixture draft. Verify reset timing, held shorts, charge termination and motor transients before routing.
