ncripted/DAMIEN/outputs/rover/Omni_UGV_Rev_D_power_audit/preview/schematic-contact-sheets.pdf

# File: interlock.kicad_sch 2. Motors

# IO42 35 RXD0 36 TXD0 37

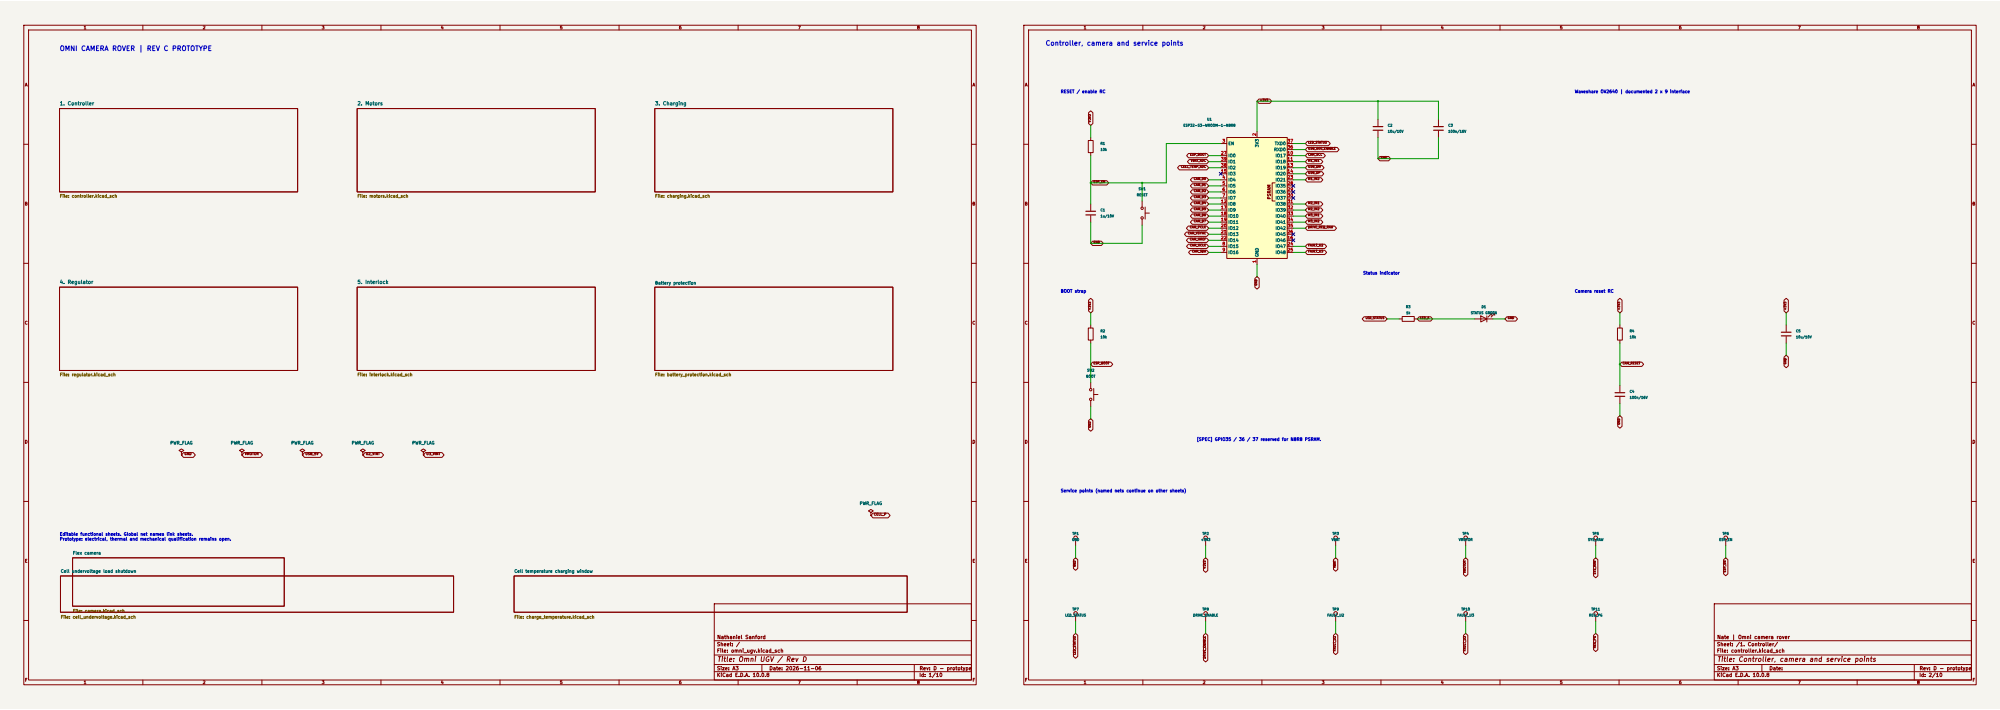
[picture p148: page 1]

File: battery_protection.kicad_sch Cell temperature charging window

[SPEC] GPIO35 / 36 / 37 reserved for N8R8 PSRAM.

Service points (named nets continue on other sheets)

Editable functional sheets. Global net names link sheets. Prototype: electrical, thermal and mechanical qualification remains open.

File: camera.kicad_sch Cell undervoltage load shutdown

Nate | Omni camera rover
Sheet: /1. Controller/
File: controller.kicad_sch
Title: Controller, camera and service points

100k 1

## 3.3 V buck-boost supply

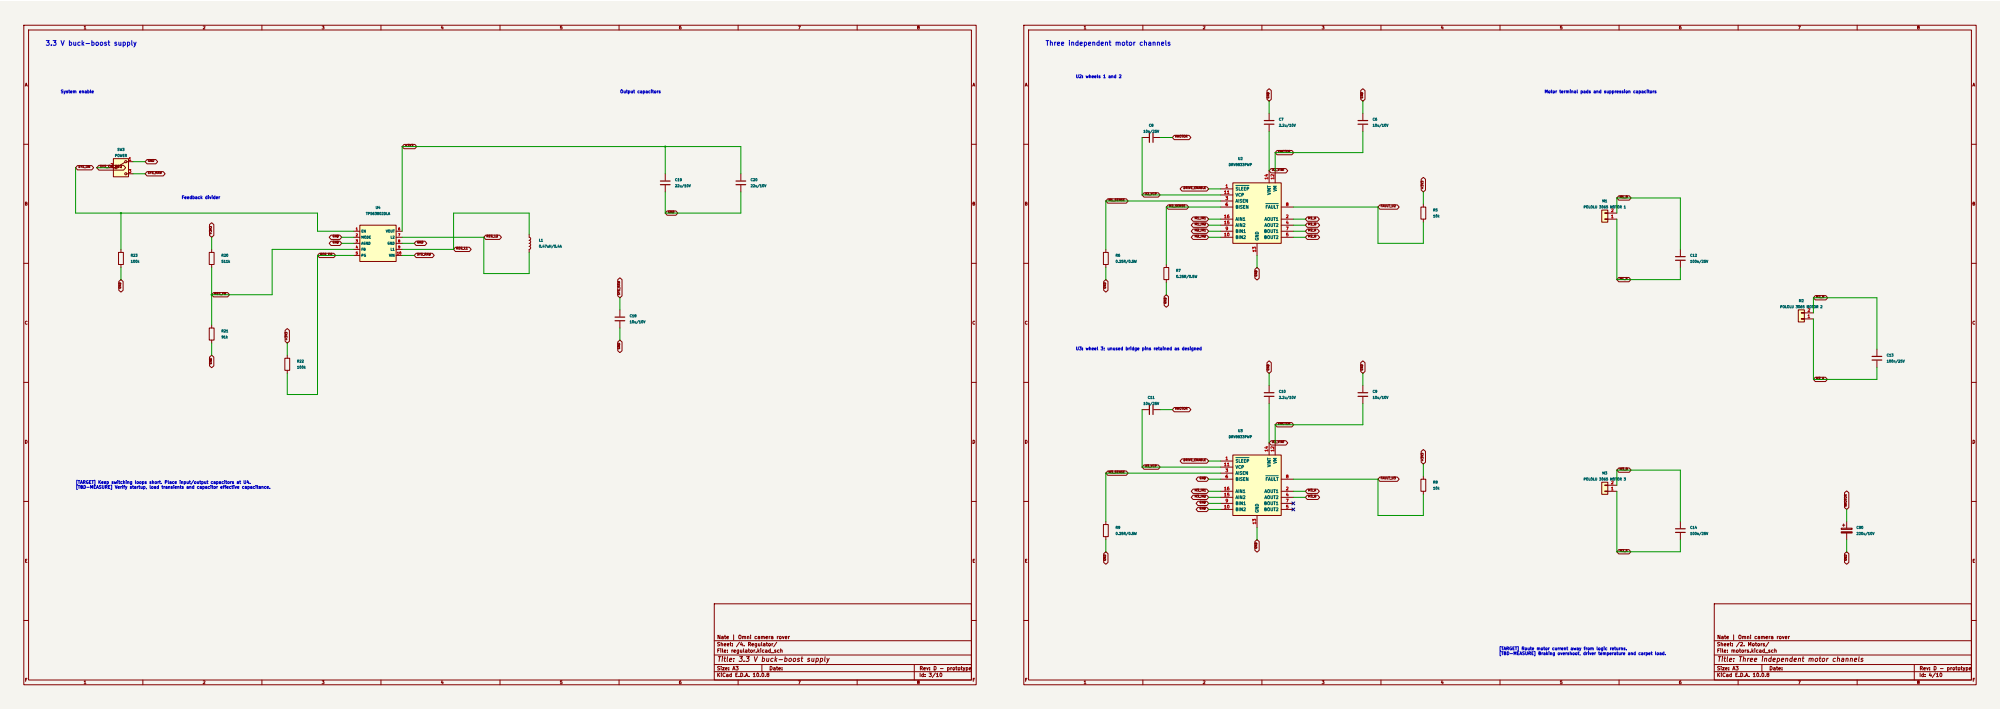
[picture p149: page 2]

Three independent motor channels

Nate | Omni camera rover R21

[TARGET] Keep switching loops short. Place input/output capacitors at U4. [TBD-MEASURE] Verify startup, load transients and capacitor effective capacitance.

Sheet: /4. Regulator/
File: regulator.kicad_sch
Title: 3.3 V buck-boost supply

[TARGET] Route motor current away from logic returns. [TBD-MEASURE] Braking overshoot, driver temperature and carpet load.

Sheet: /2. Motors/
File: motors.kicad_sch
Title: Three independent motor channels

100k 1

1u/10V 1

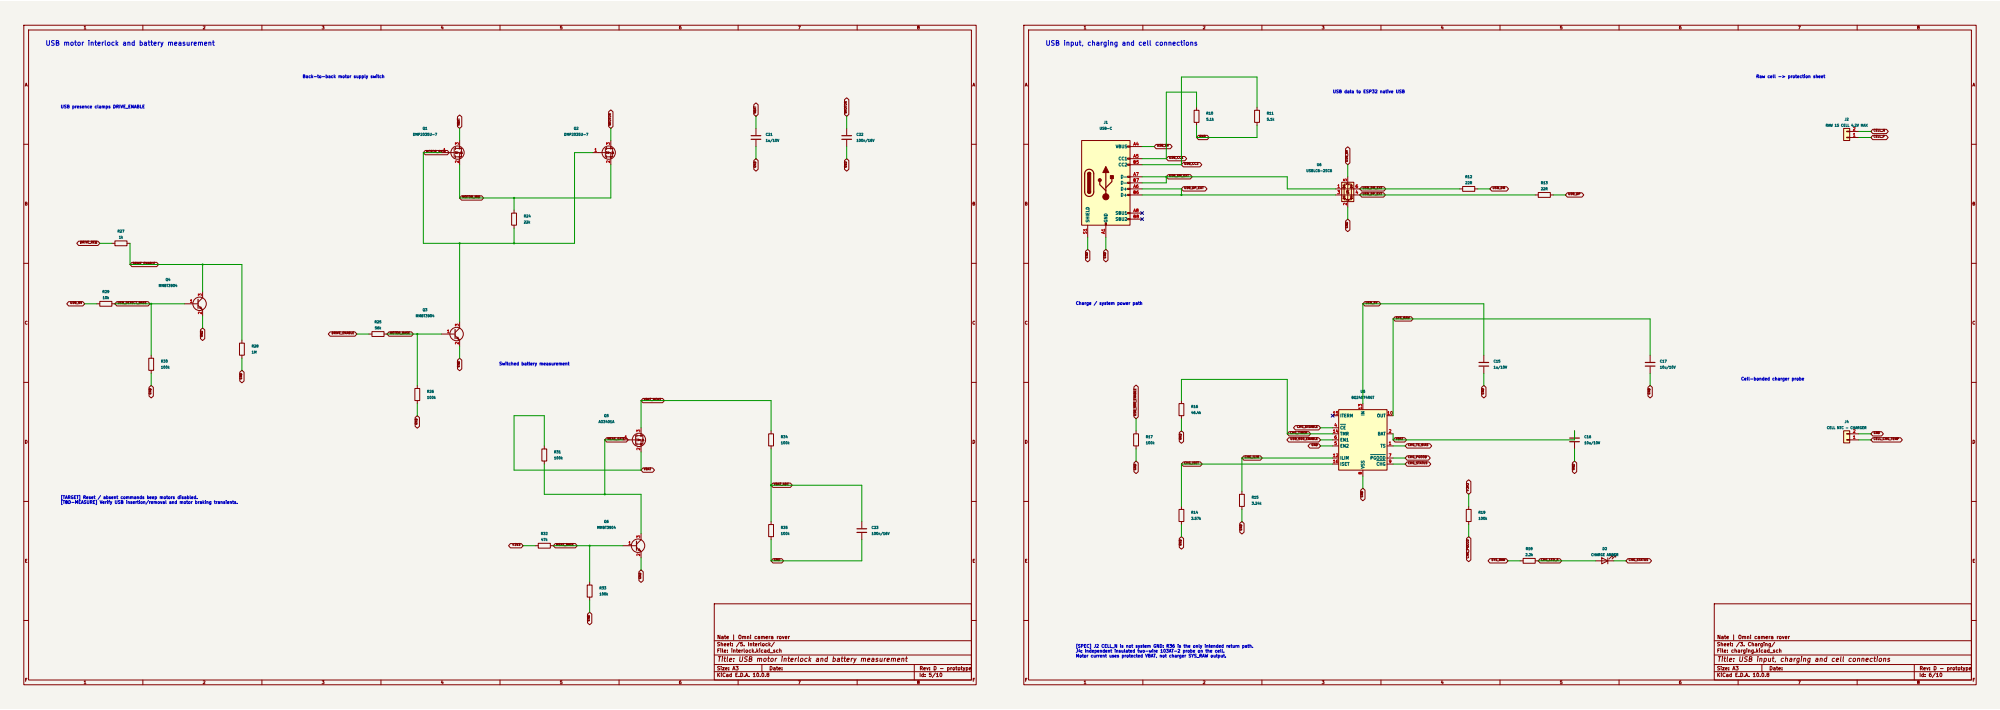
[picture p150: page 3]

VBAT_MEAS
Nate | Omni camera rover R34

Nate | Omni camera rover R18

Sheet: /5. Interlock/
File: interlock.kicad_sch
Title: USB motor interlock and battery measurement

[SPEC] J2 CELL_N is not system GND: R36 is the only intended return path. J4: independent insulated two-wire 103AT-2 probe on the cell. Motor current uses protected VBAT, not charger SYS_RAW output.

Sheet: /3. Charging/
File: charging.kicad_sch
Title: USB input, charging and cell connections

## 1S protection and cell-temperature monitoring

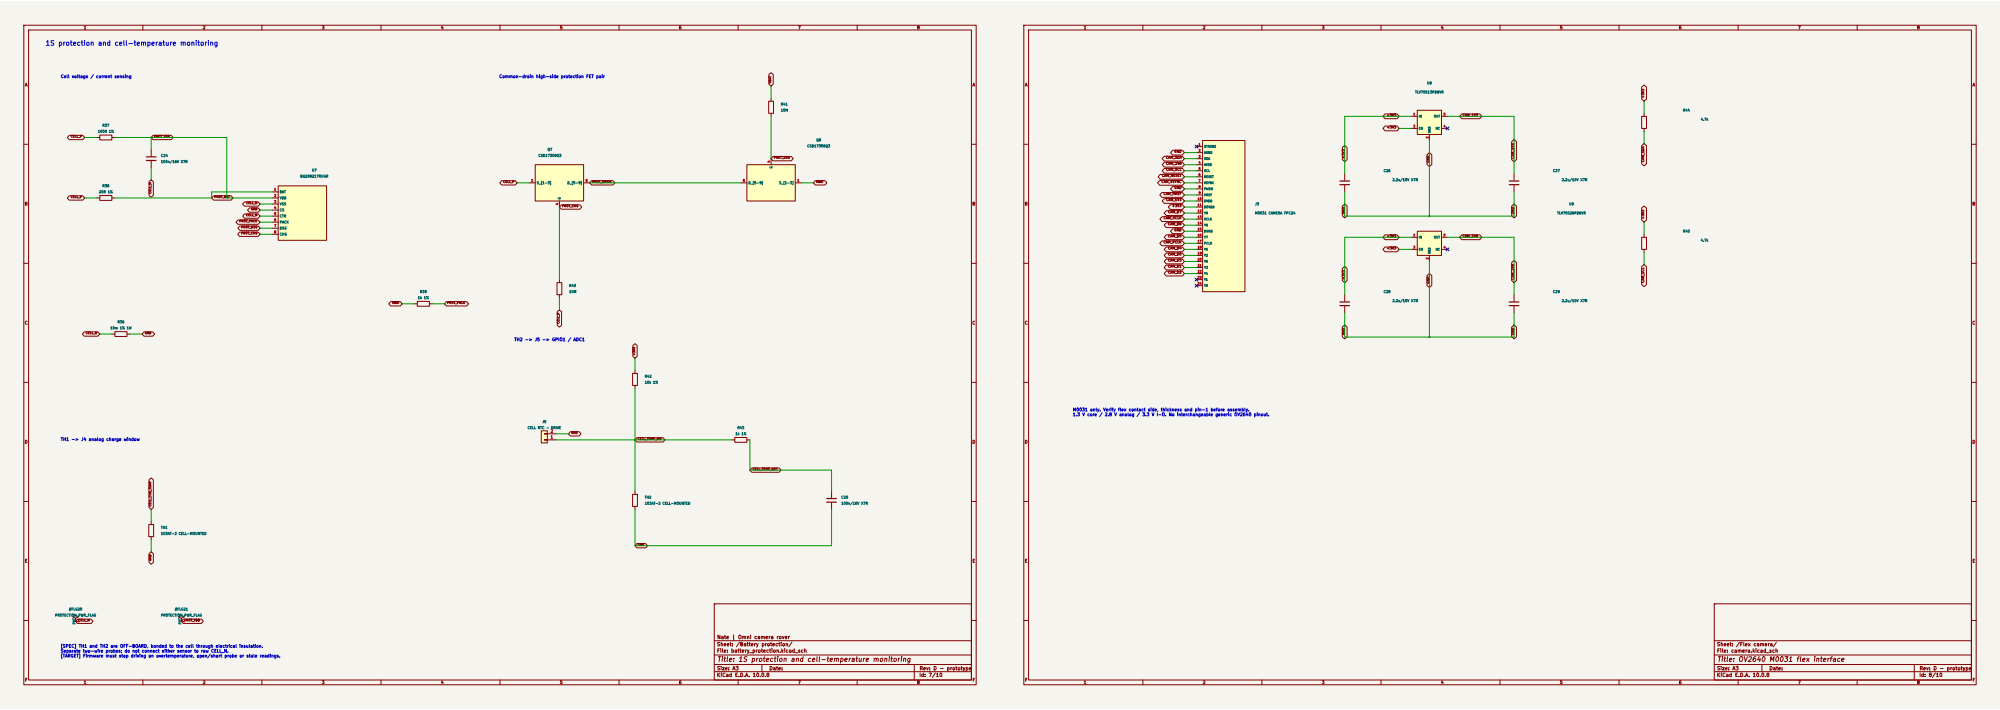
[picture p151: page 4]

VSYNC 7 PWDN 8 HREF 9 DVDD 10 DOVDD 11
CAM_D1 +3V3 CAM_D7 CAM_XCLK

CAM_HREF CAM_1V3 M0031 only. Verify flex contact side, thickness and pin-1 before assembly. 1.3 V core / 2.8 V analog / 3.3 V I-O. No interchangeable generic OV2640 pinout.

Nate | Omni camera rover R36

GND TH1 -> J4 analog charge window

Sheet: /Battery protection/
File: battery_protection.kicad_sch
Title: 1S protection and cell-temperature monitoring

## CELL_UV_MOTOR_B Independent cell undervoltage shutdown

# Raw-cell voltage sensing Buffered drive request; R64 defaults low

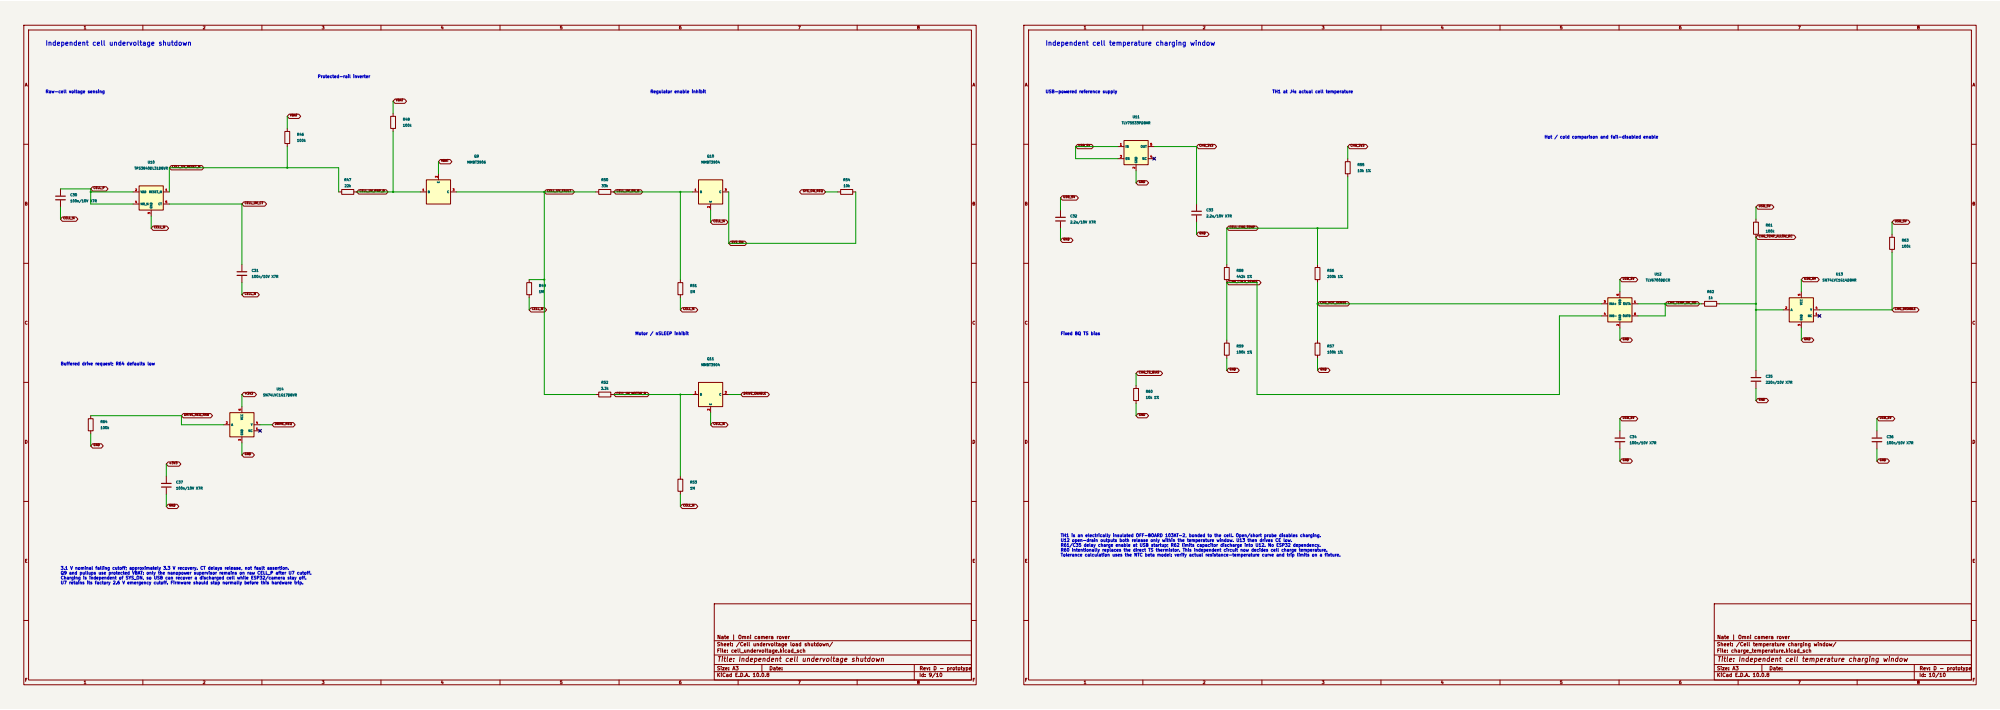
[picture p152: page 5]

Independent cell temperature charging window

Protected-rail inverter 3.1 V nominal falling cutoff; approximately 3.3 V recovery. CT delays release, not fault assertion. Q9 and pullups use protected VBAT: only the nanopower supervisor remains on raw CELL_P after U7 cutoff. Charging is independent of SYS_ON, so USB can recover a discharged cell while ESP32/camera stay off. U7 retains its factory 2.6 V emergency cutoff. Firmware should stop normally before this hardware trip.

TH1 is an electrically insulated OFF-BOARD 103AT-2, bonded to the cell. Open/short probe disables charging. U12 open-drain outputs both release only within the temperature window. U13 then drives CE low. R61/C35 delay charge enable at USB startup; R62 limits capacitor discharge into U12. No ESP32 dependency. R60 intentionally replaces the direct TS thermistor. This independent circuit now decides cell charge temperature. Tolerance calculation uses the NTC beta model: verify actual resistance-temperature curve and trip limits on a fixture. USB-powered reference supply Fixed BQ TS bias

TH1 at J4: actual cell temperature

Nate | Omni camera rover C34

Nate | Omni camera rover
Sheet: /Cell undervoltage load shutdown/
File: cell_undervoltage.kicad_sch
Title: Independent cell undervoltage shutdown

Sheet: /Cell temperature charging window/
File: charge_temperature.kicad_sch
Title: Independent cell temperature charging window
