ncripted/DAMIEN/work/humanize/single.pdf

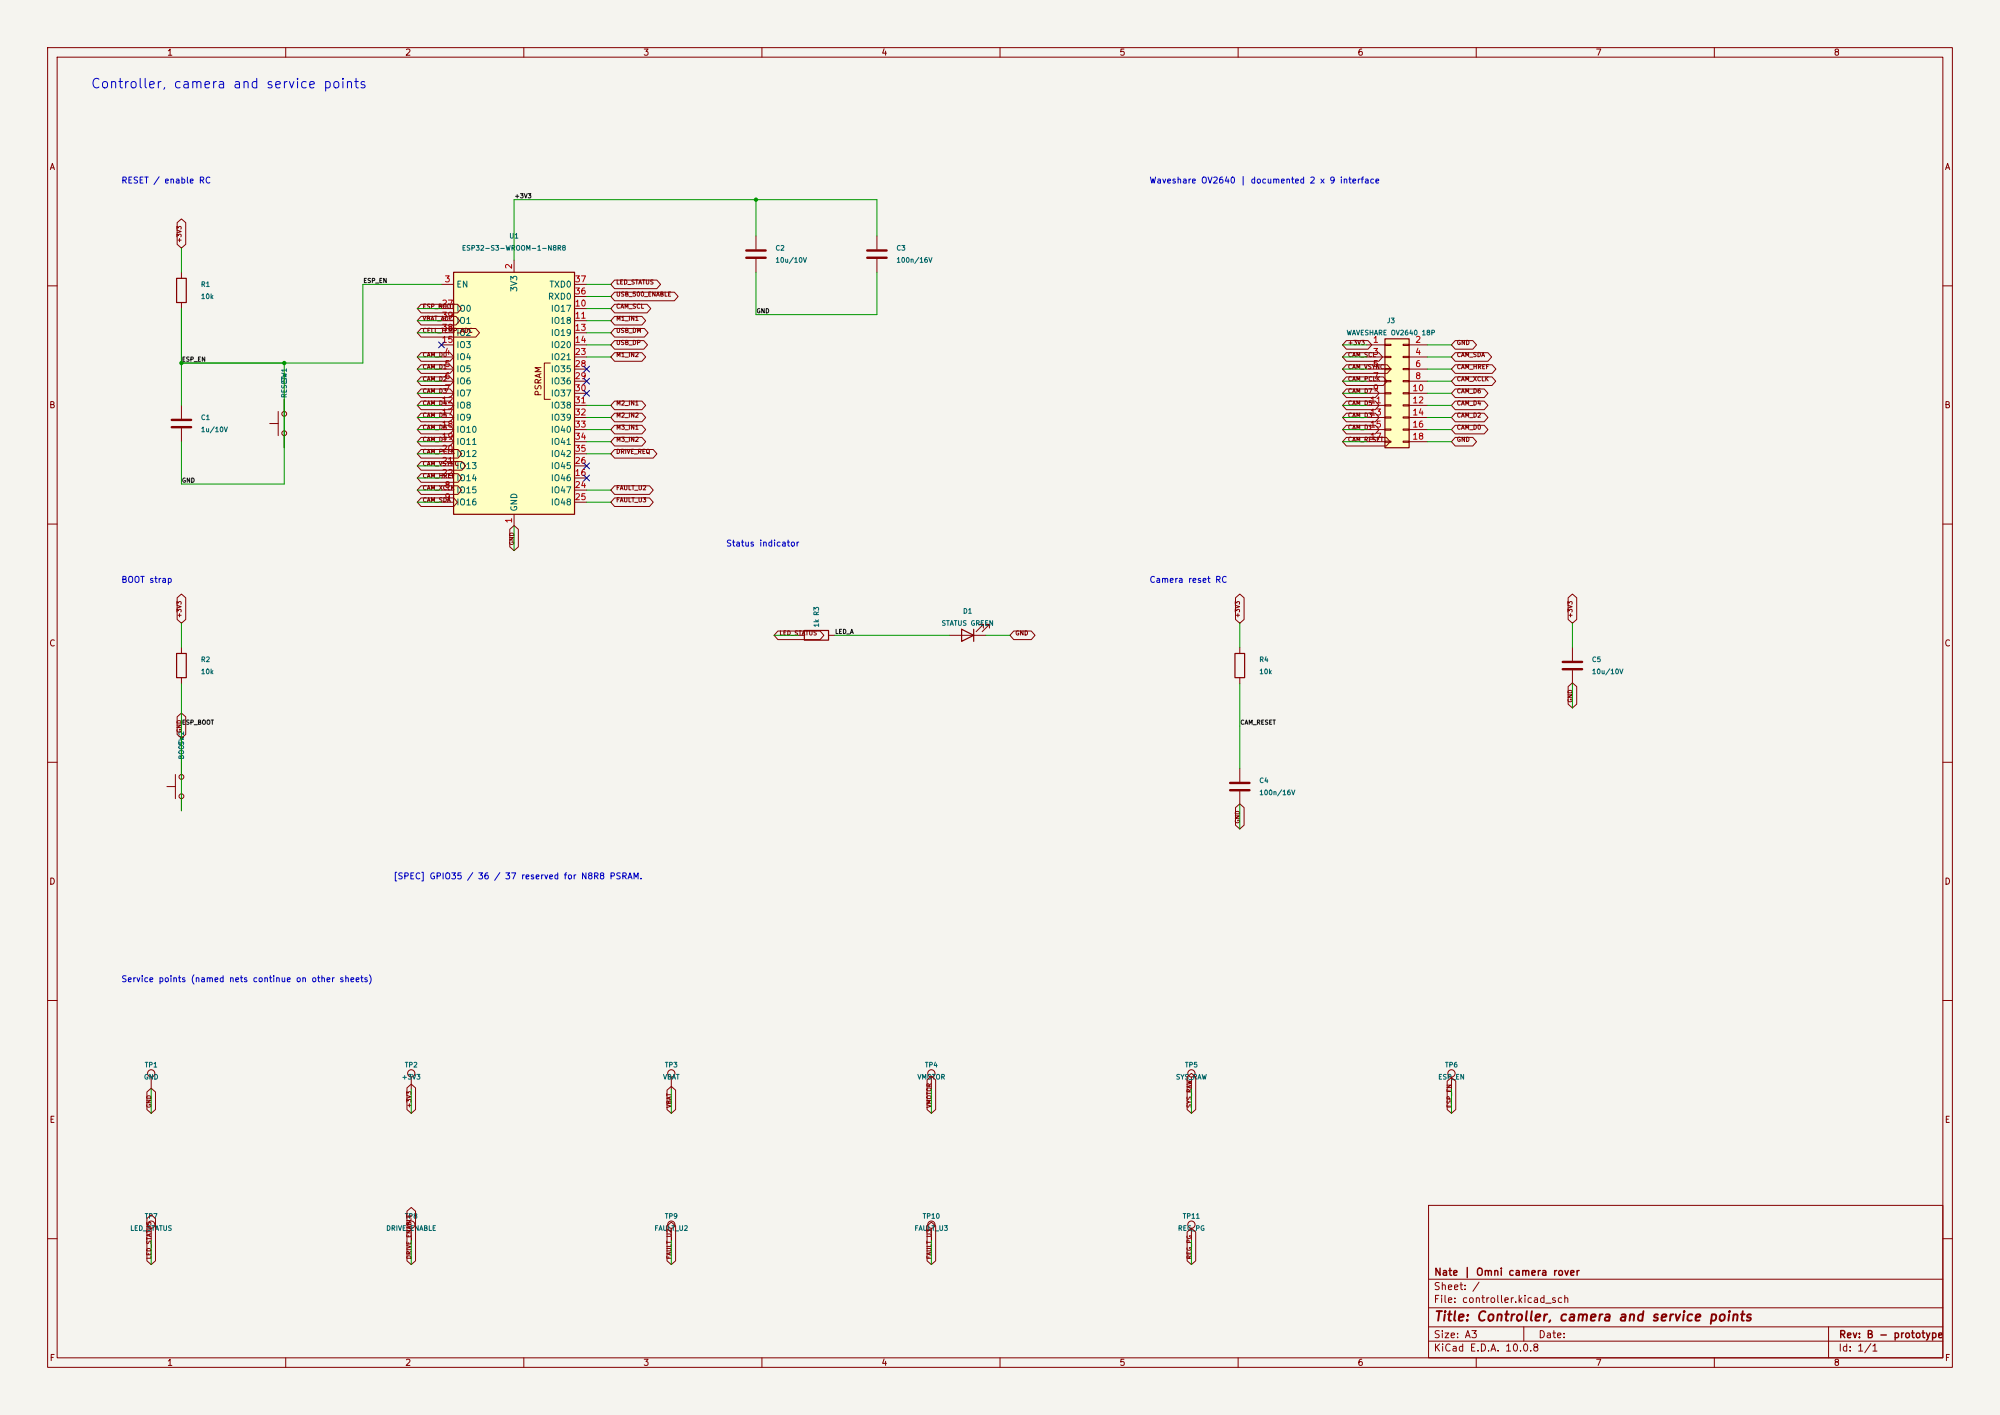
[picture p160: page 1]

Waveshare OV2640 | documented 2 x 9 interface Controller, camera and service points

Service points (named nets continue on other sheets)

Nate | Omni camera rover
Sheet: /
File: controller.kicad_sch
Title: Controller, camera and service points

Size: A3 | Rev: B - prototype | F Date:
KiCad E.D.A. 10.0.8 | Id: 1/1
