ncripted/DAMIEN/outputs/rover/Omni_UGV_Rev_F_protection_draft/Protection_Draft.pdf

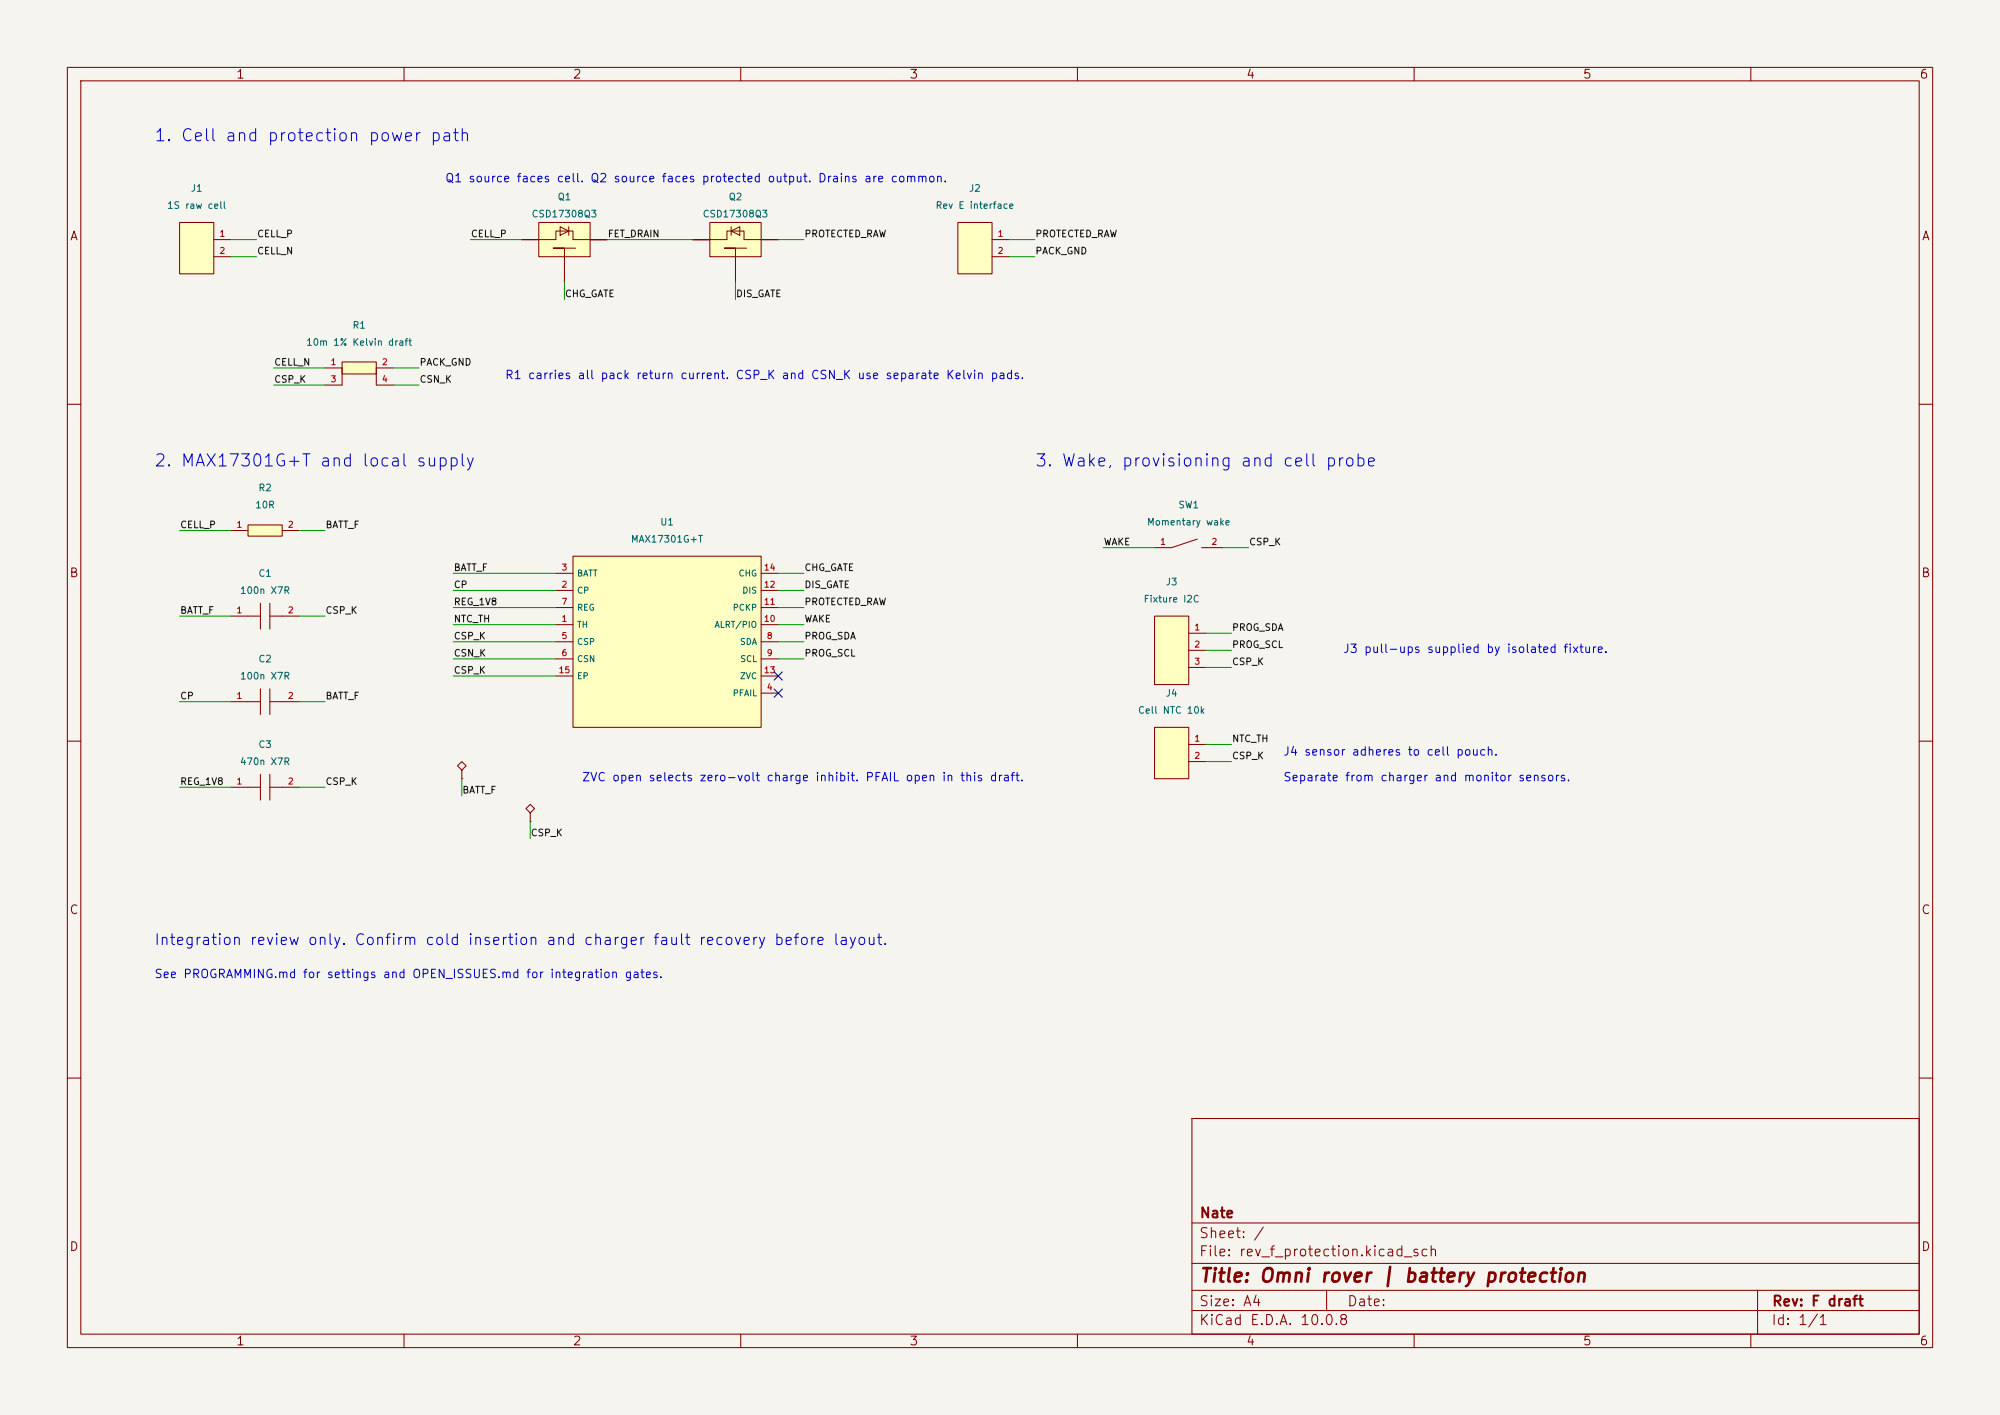
[picture p161: page 1]

1. Cell and protection power path

Separate from charger and monitor sensors. Q1 source faces cell. Q2 source faces protected output. Drains are common.

J4 sensor adheres to cell pouch. ZVC open selects zero-volt charge inhibit. PFAIL open in this draft. See PROGRAMMING.md for settings and OPEN_ISSUES.md for integration gates.

Nate
Sheet: /
File: rev_f_protection.kicad_sch
Title: Omni rover | battery protection

Size: A4 | Rev: F draft
KiCad E.D.A. 10.0.8 | Id: 1/1
