ncripted/DAMIEN/outputs/rover/Omni_UGV_Rev_F_protection_draft/USB_Power_Path.pdf

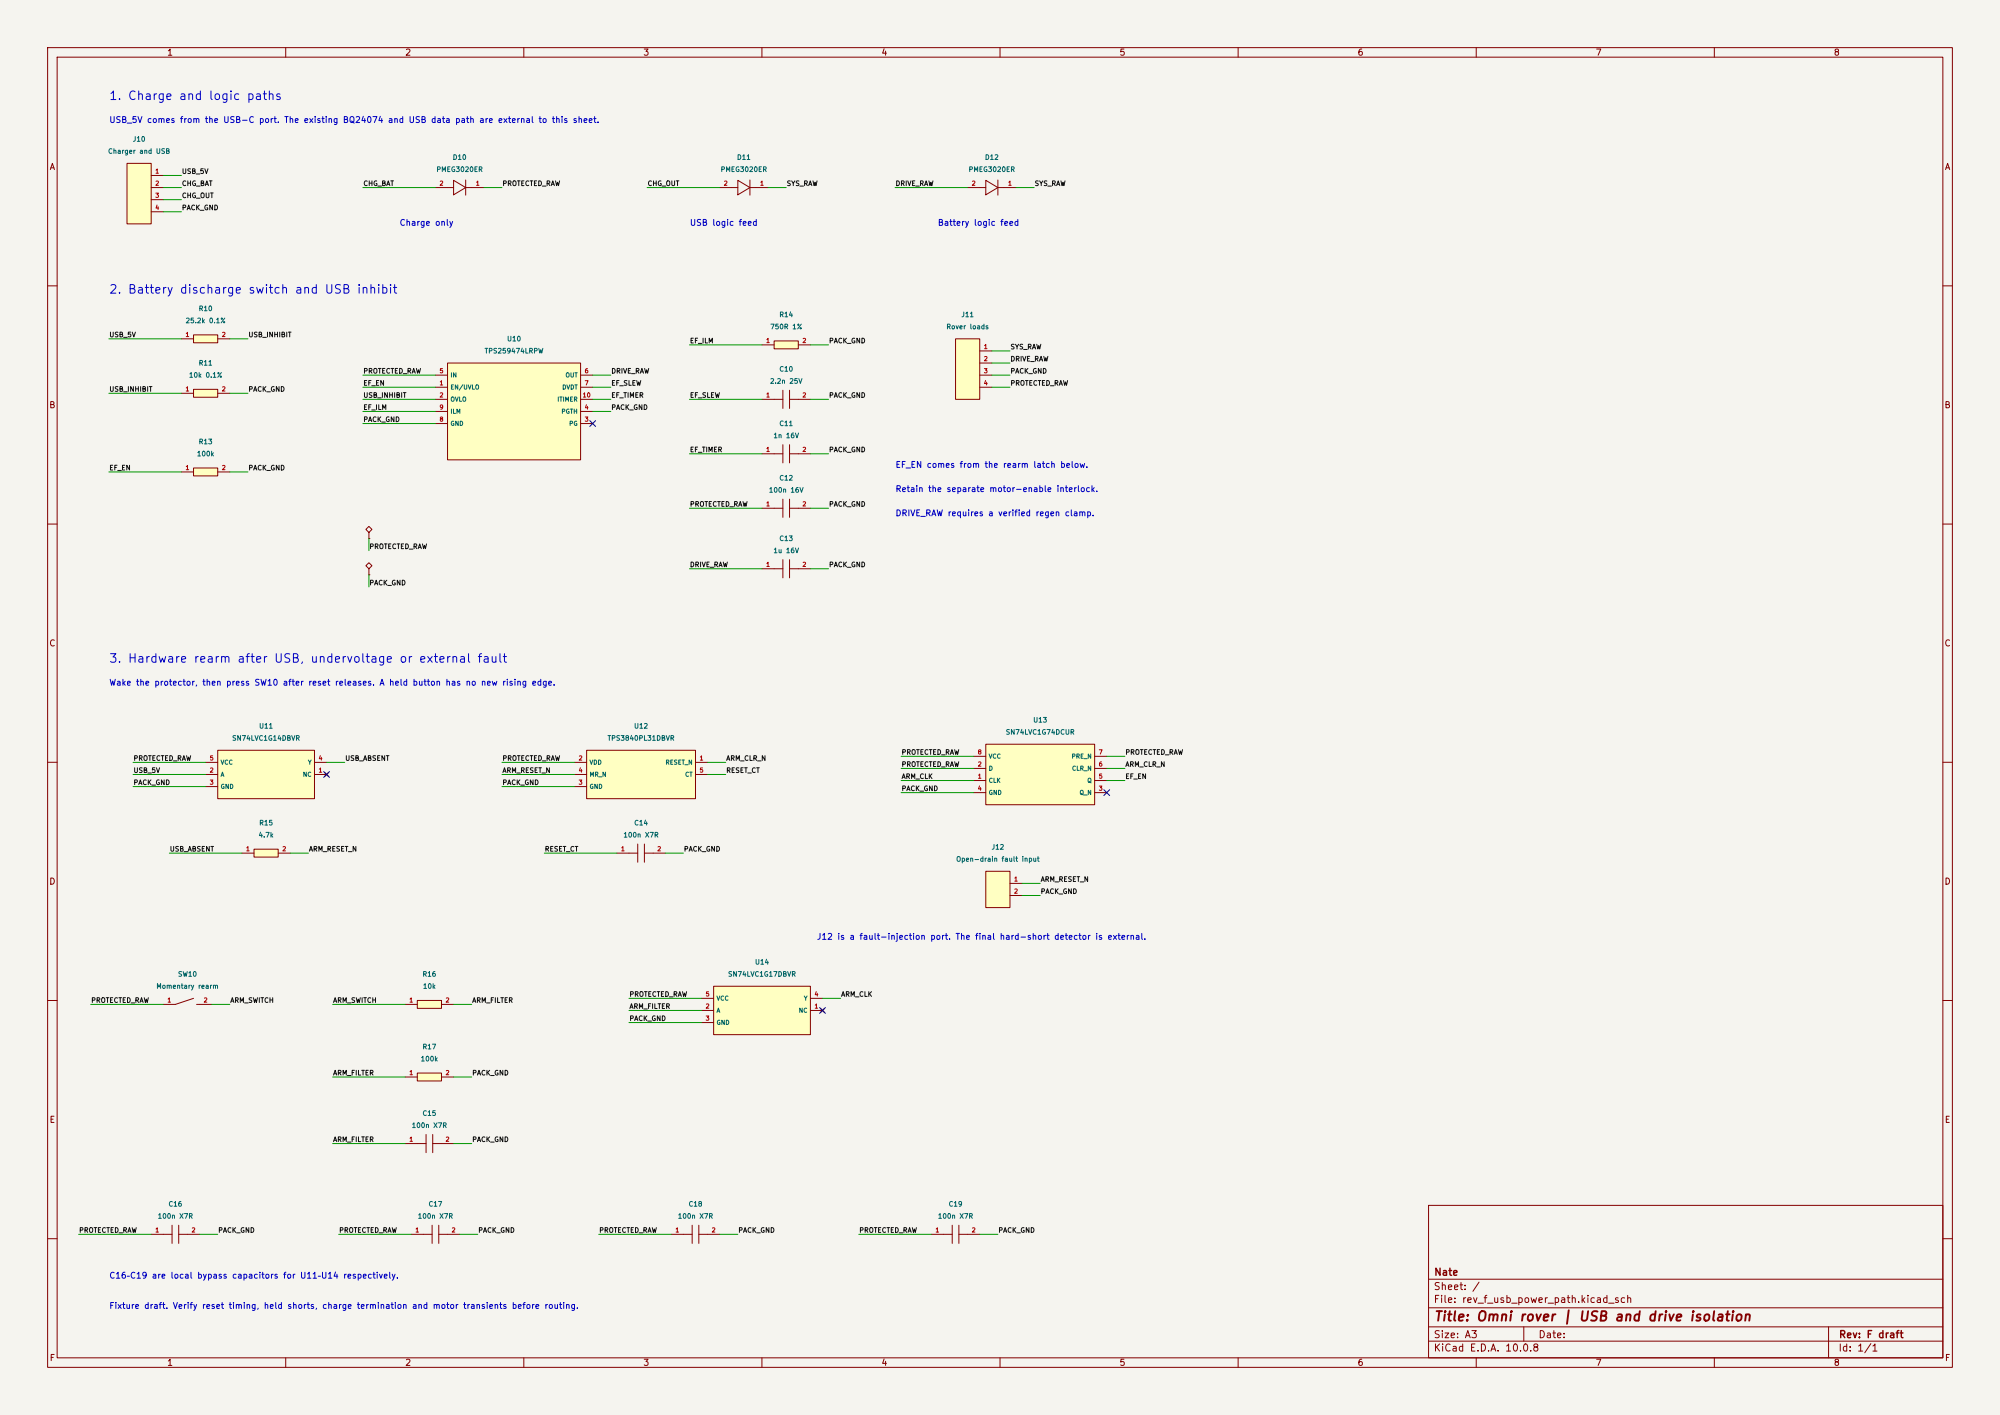
[picture p162: page 1]

1. Charge and logic paths

EF_EN 2. Battery discharge switch and USB inhibit

J12 Open-drain fault input ARM_SWITCH

Nate
Sheet: /
File: rev_f_usb_power_path.kicad_sch
Title: Omni rover | USB and drive isolation

Fixture draft. Verify reset timing, held shorts, charge termination and motor transients before routing. C16–C19 are local bypass capacitors for U11–U14 respectively.

Size: A3 | Rev: F draft | F Date:
KiCad E.D.A. 10.0.8 | Id: 1/1
