ncripted/DAMIEN/outputs/rover/Omni_UGV_Rev_E_power_layout/preview/layers/copper-layers.pdf

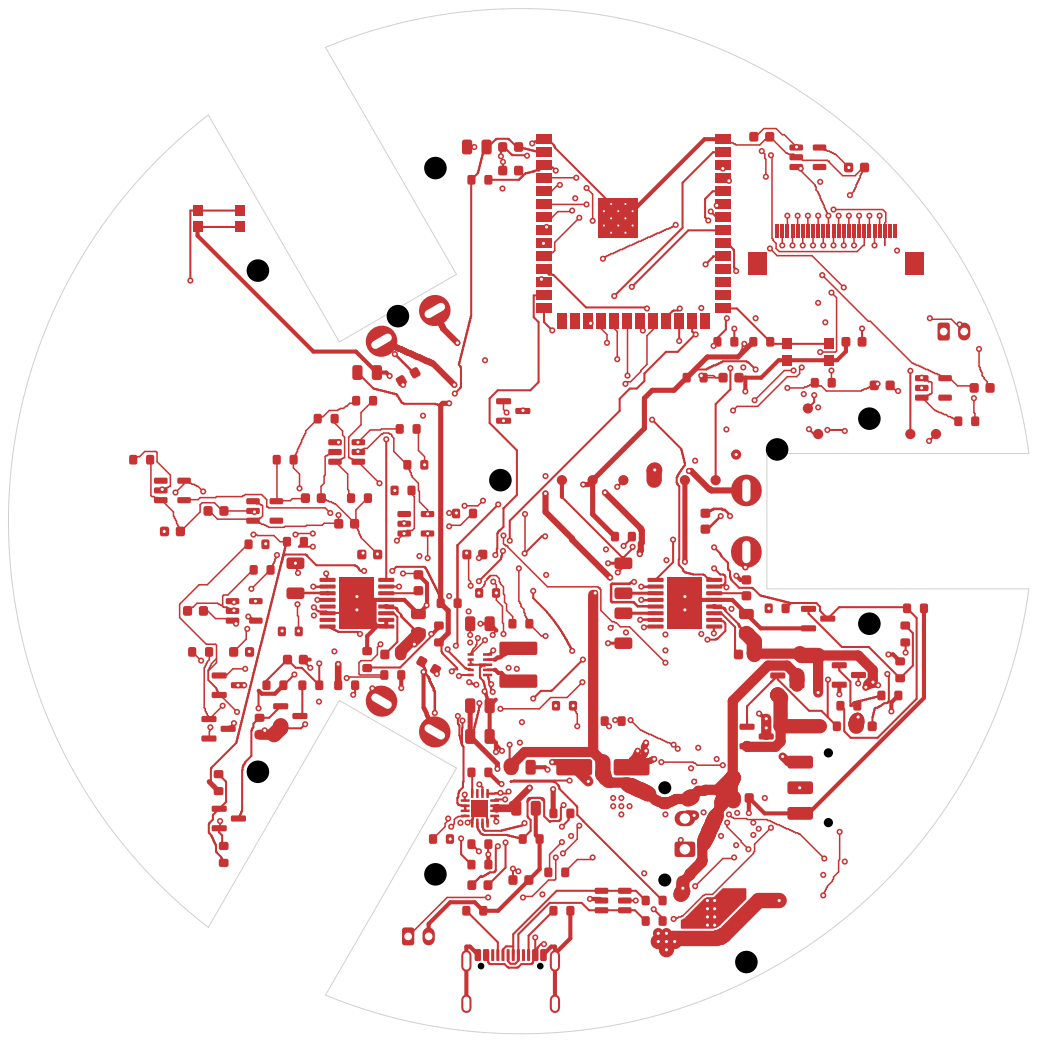
[picture p163: page 1]

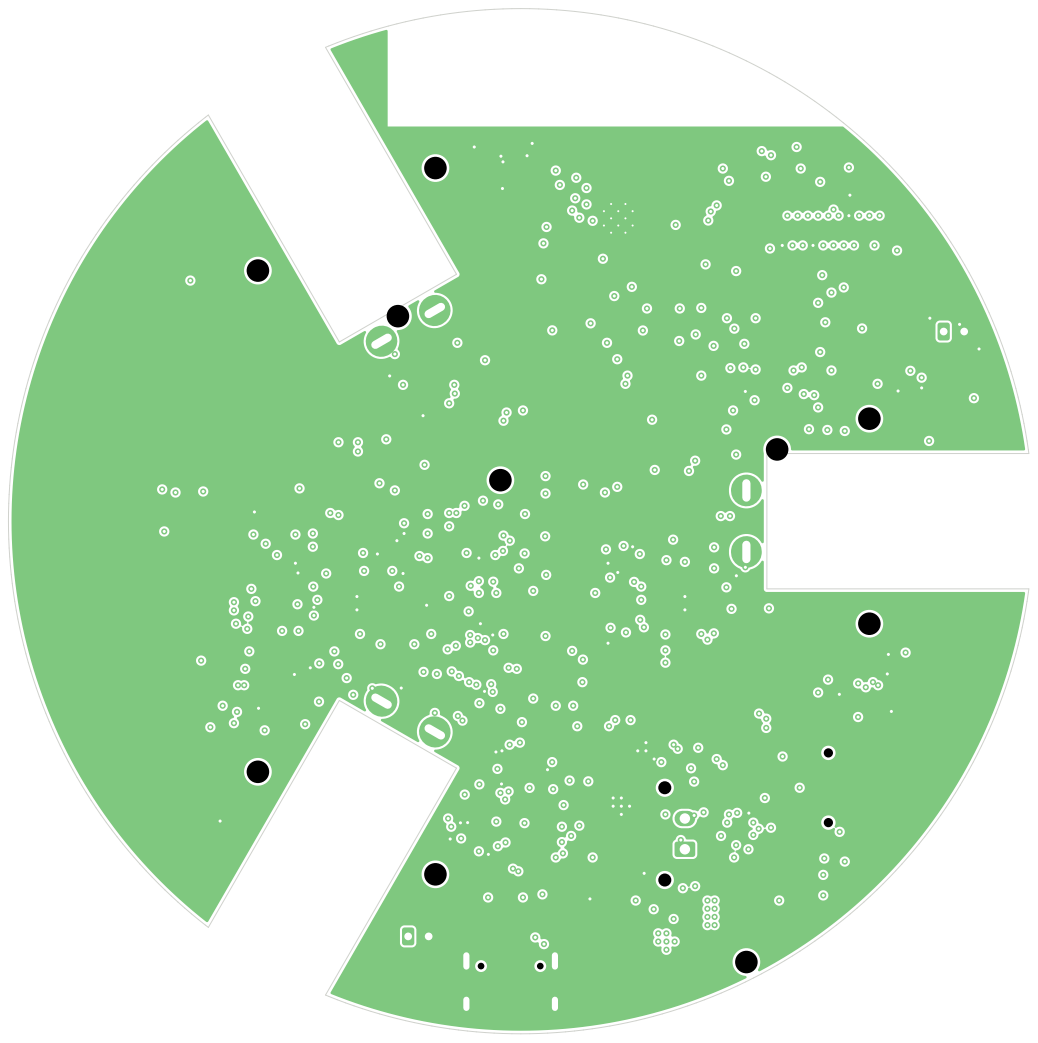
[picture p164: page 2]

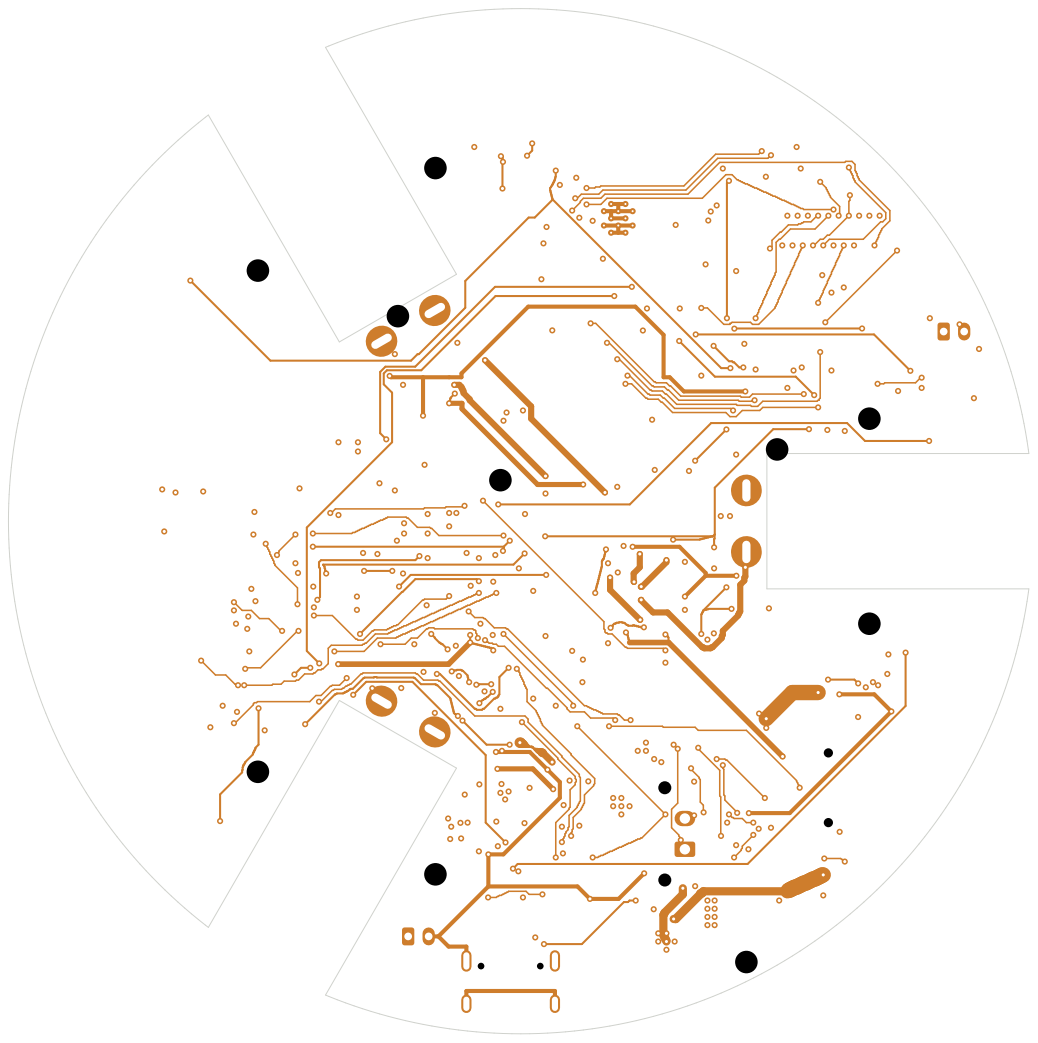
[picture p165: page 3]

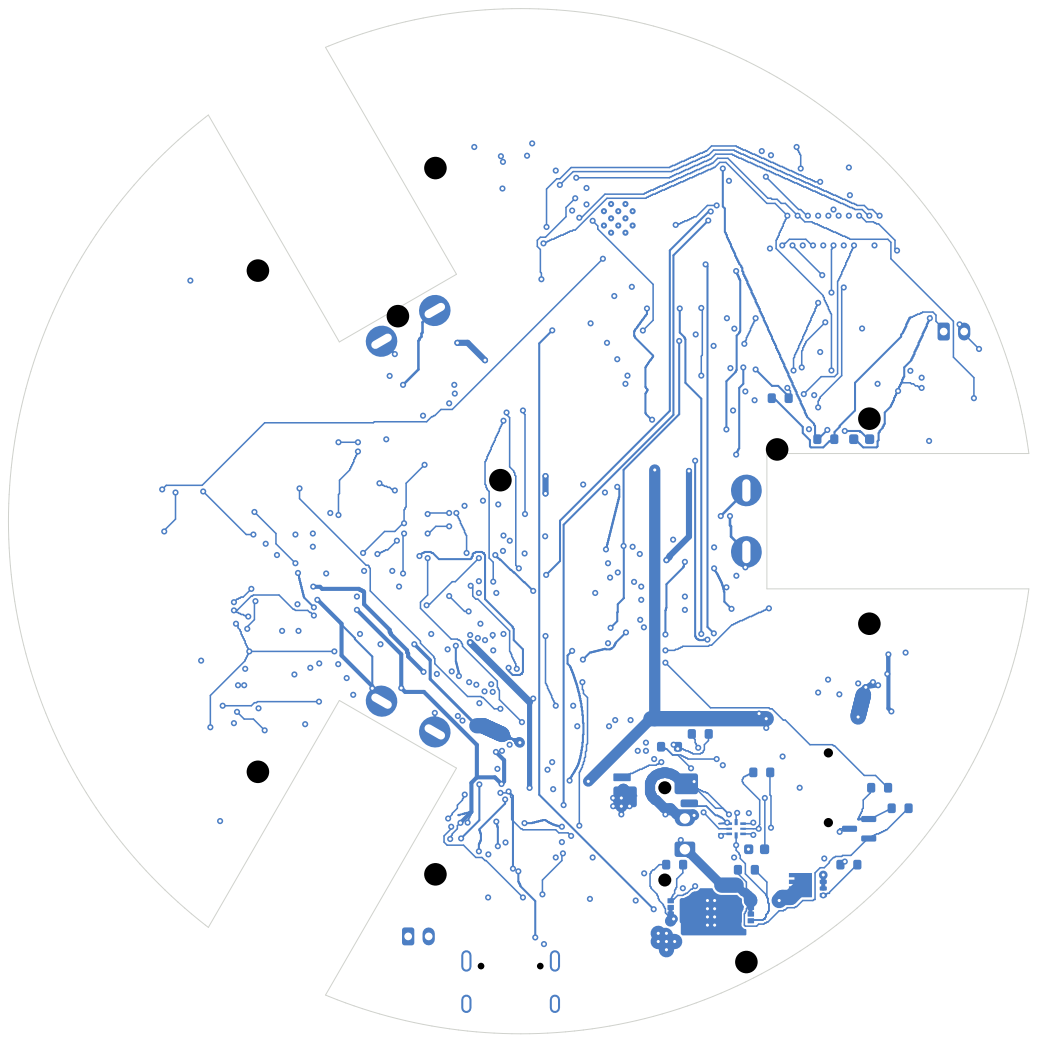
[picture p166: page 4]
