ncripted/DAMIEN/(list of files, drawings)

Other design files:
outputs/rover/Omni_UGV_Rev_B_protection/.pcba-workflow/schematic-visual-audit.json
outputs/rover/Omni_UGV_Rev_C_flex_camera/.pcba-workflow/schematic-visual-audit.json
outputs/rover/Omni_UGV_Rev_C_flex_camera_review/Omni_UGV_Rev_C_flex_camera/.pcba-workflow/schematic-visual-audit.json
outputs/rover/Omni_UGV_Rev_D_power_audit/.pcba-workflow/schematic-visual-audit.json
