ncripted/DAMIEN/outputs/rover/Omni_UGV_Rev_E1_layout_candidate/omni_ugv.kicad_pcb

## KiCad design outputs/rover/Omni_UGV_Rev_E1_layout_candidate/omni_ugv.kicad_pcb (2026-11-09)

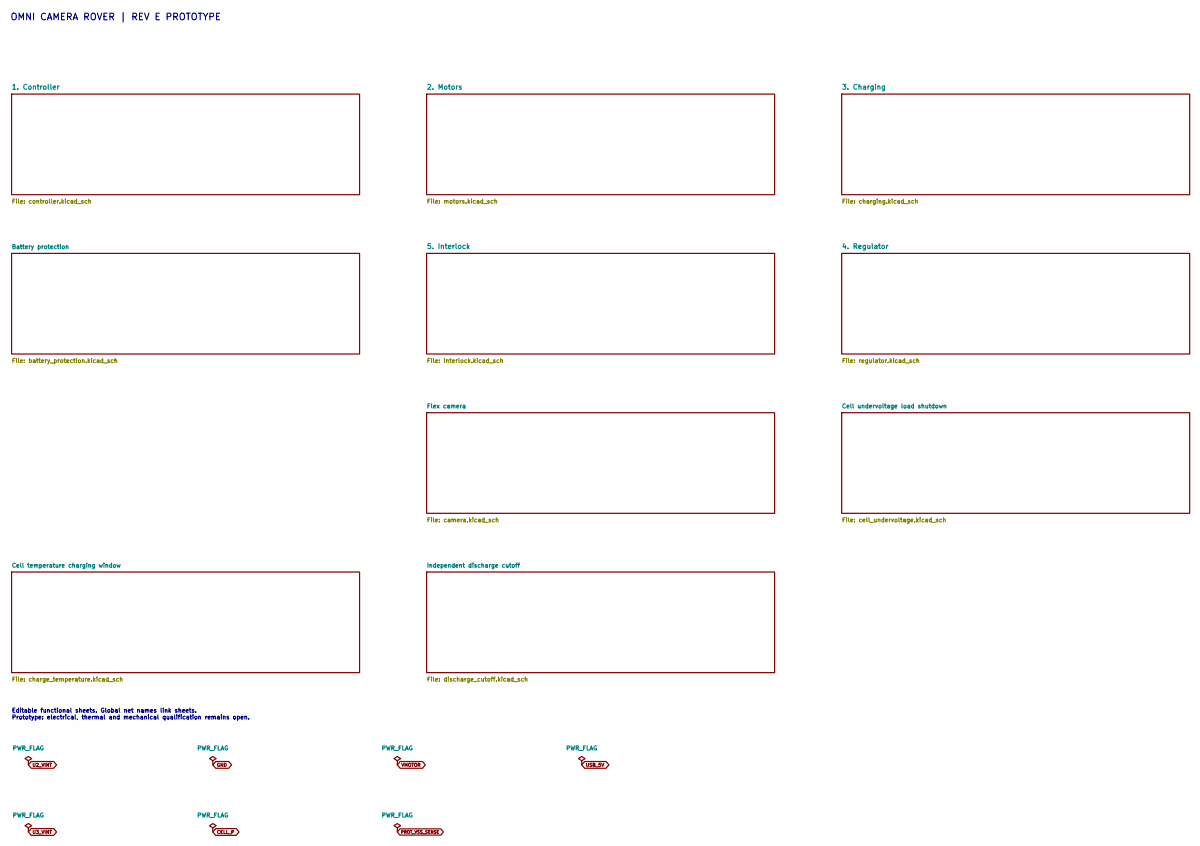
[picture p167: schematic omni_ugv.kicad_sch, Omni UGV / Rev E]

Notes on the sheet:
OMNI CAMERA ROVER | REV E PROTOTYPE
Editable functional sheets. Global net names link sheets. Prototype: electrical, thermal and mechanical qualification remains open.

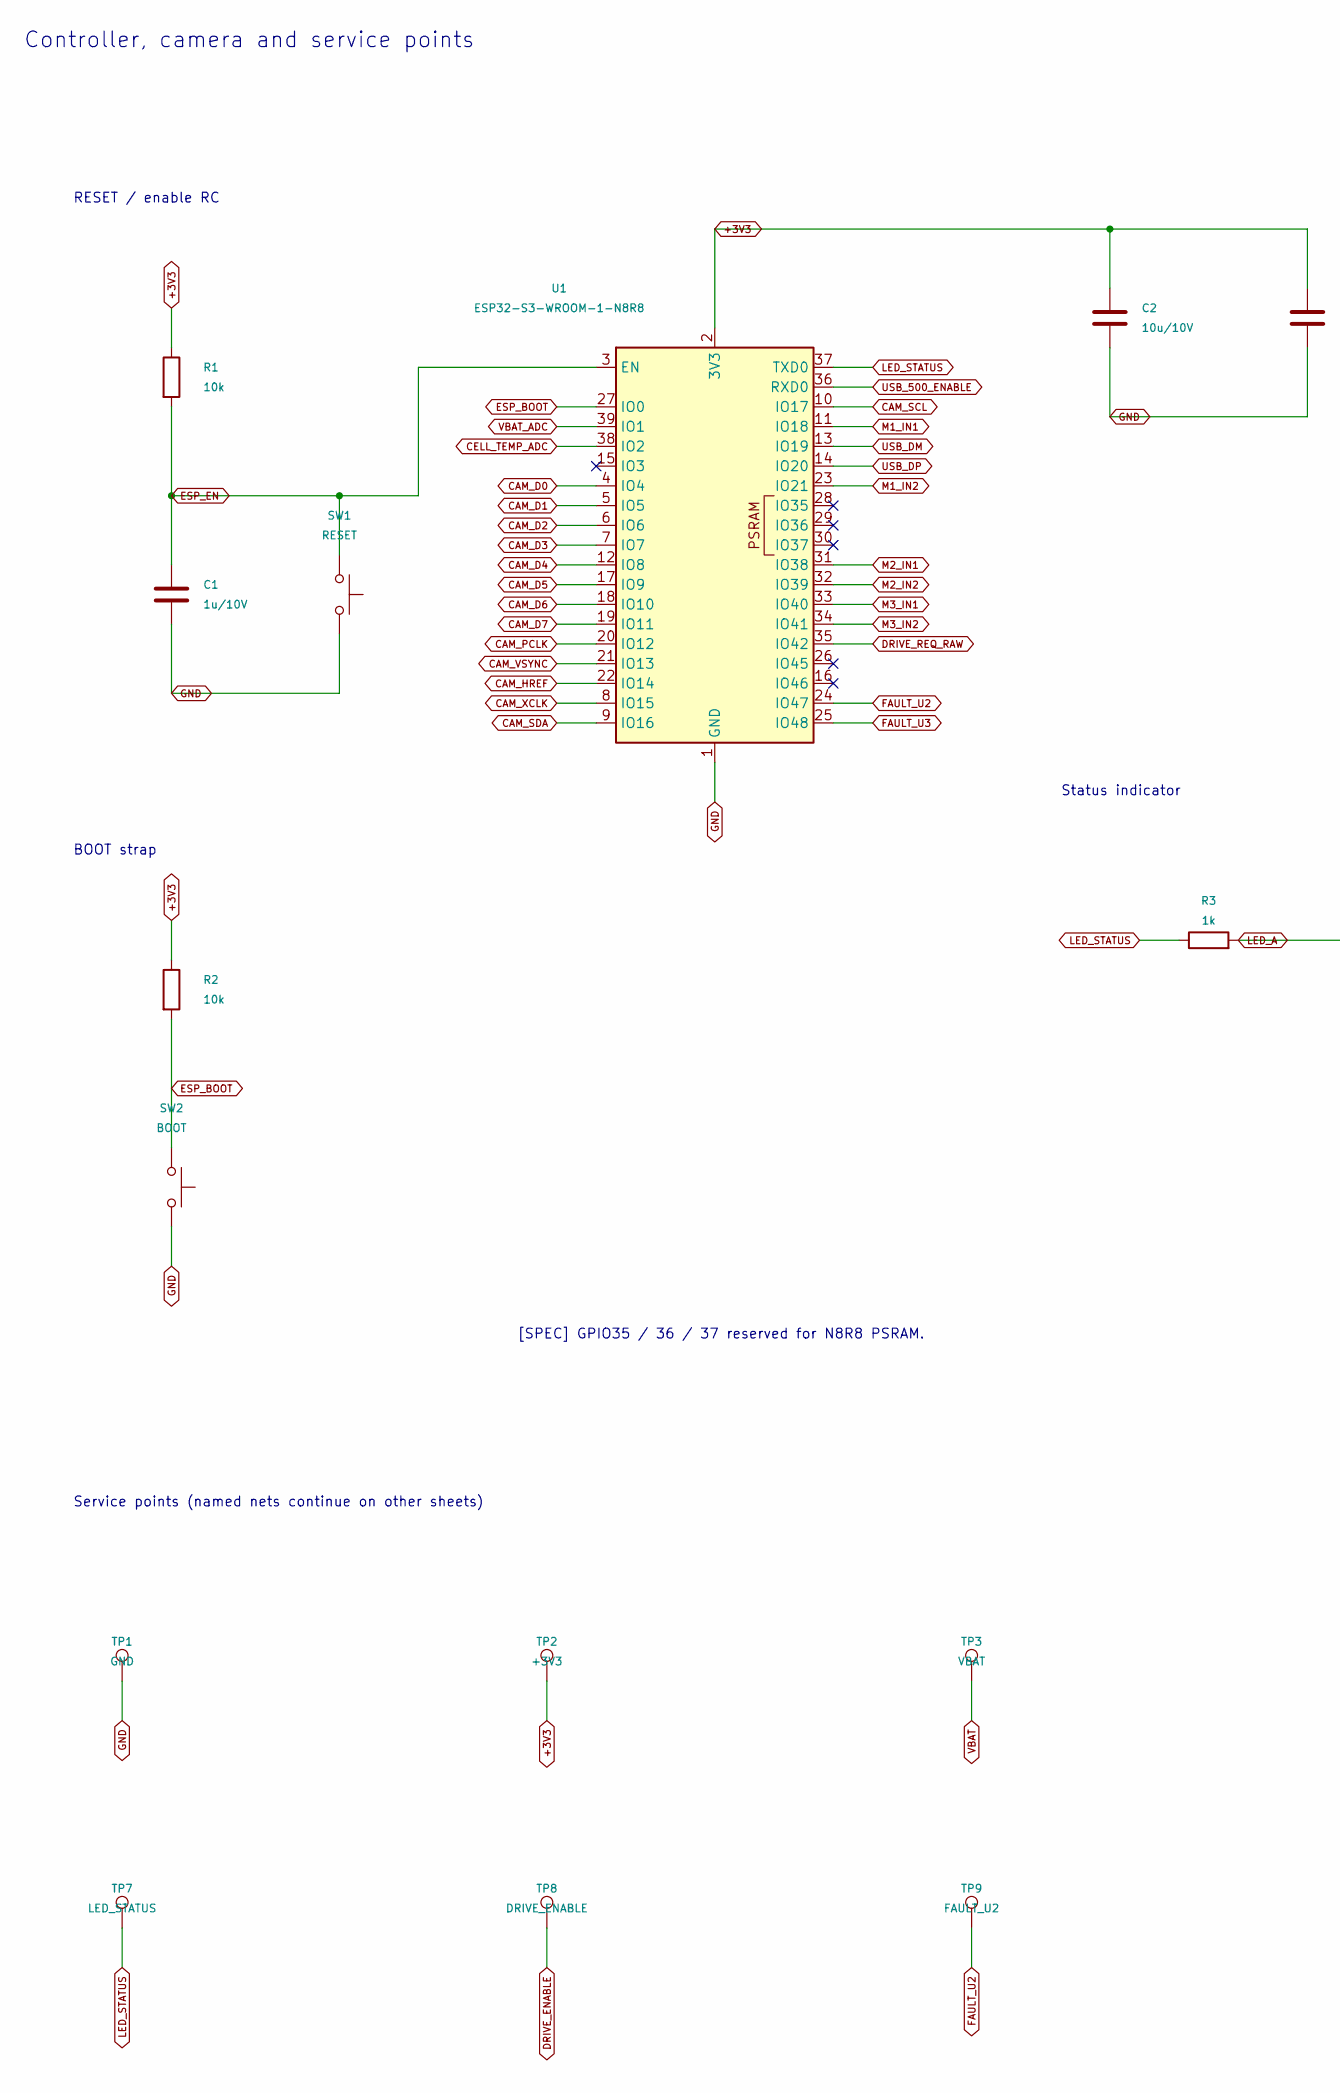
[picture p168: schematic controller.kicad_sch, Controller, camera and service points, part in row 1, column 1]

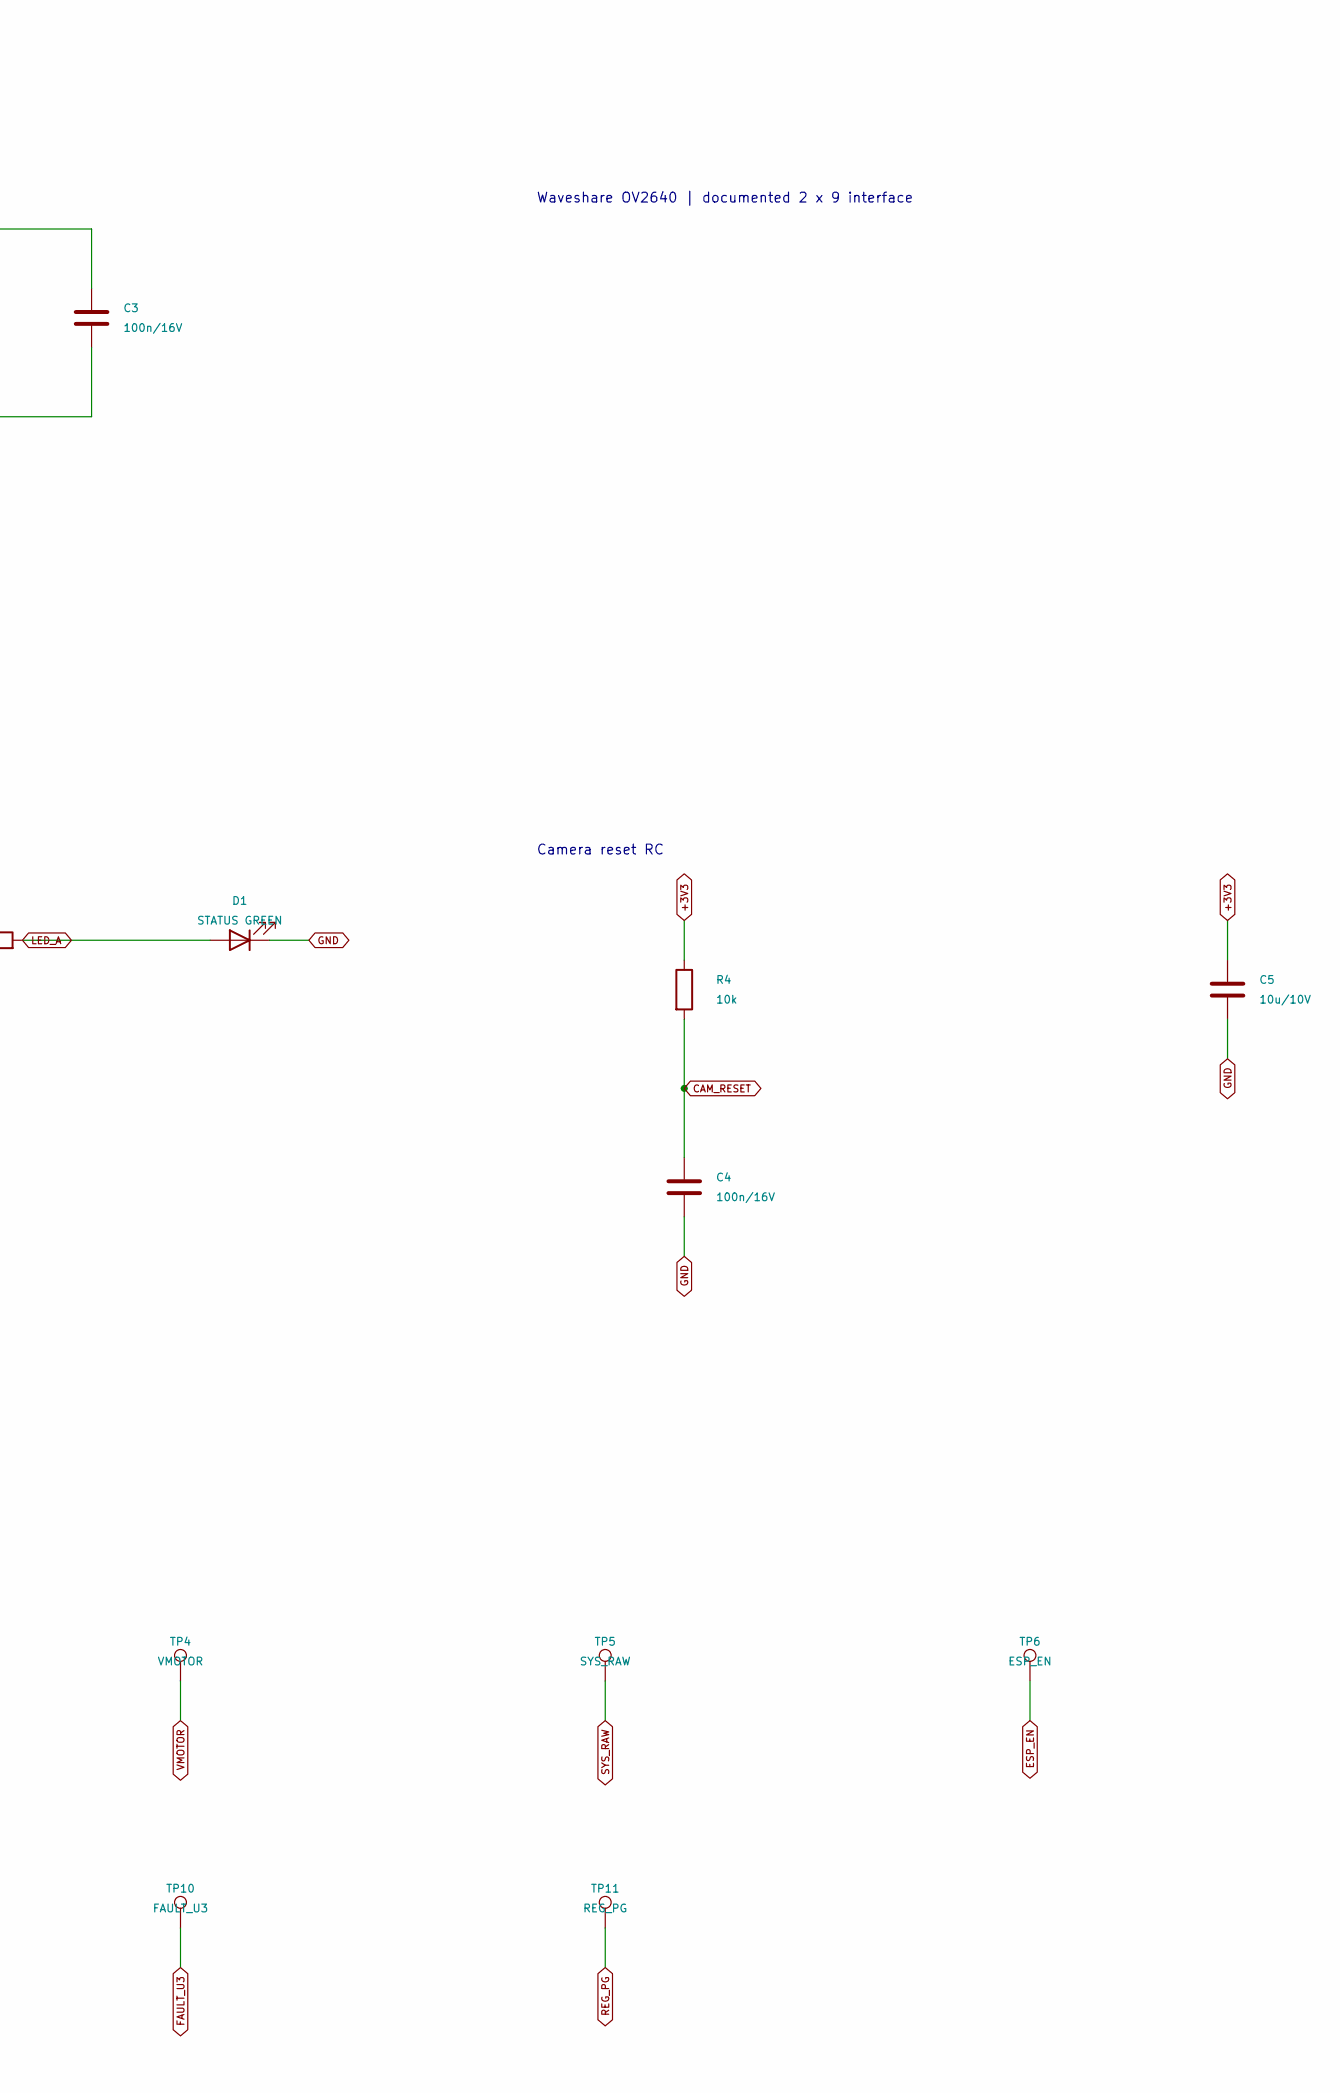
[picture p169: schematic controller.kicad_sch, Controller, camera and service points, part in row 1, column 2]

Parts:
C1: 1u/10V; Capacitor_SMD__C_0603_1608Metric
C2, C5: 10u/10V; Capacitor_SMD__C_0805_2012Metric
C3, C4: 100n/16V; Capacitor_SMD__C_0603_1608Metric
D1: STATUS GREEN; LED_SMD__LED_0603_1608Metric
R1, R2, R4: 10k; Resistor_SMD__R_0603_1608Metric
R3: 1k; Resistor_SMD__R_0603_1608Metric
SW1: RESET; Button_Switch_SMD__SW_Push_1P1T_NO_CK_KMR2
SW2: BOOT; Button_Switch_SMD__SW_Push_1P1T_NO_CK_KMR2
TP1: GND; TestPoint__TestPoint_Pad_D1.0mm
TP2: +3V3; TestPoint__TestPoint_Pad_D1.0mm
TP3: VBAT; TestPoint__TestPoint_Pad_D1.0mm
TP4: VMOTOR; TestPoint__TestPoint_Pad_D1.0mm
TP5: SYS_RAW; TestPoint__TestPoint_Pad_D1.0mm
TP6: ESP_EN; TestPoint__TestPoint_Pad_D1.0mm
TP7: LED_STATUS; TestPoint__TestPoint_Pad_D1.0mm
TP8: DRIVE_ENABLE; TestPoint__TestPoint_Pad_D1.0mm
TP9: FAULT_U2; TestPoint__TestPoint_Pad_D1.0mm
TP10: FAULT_U3; TestPoint__TestPoint_Pad_D1.0mm
TP11: REG_PG; TestPoint__TestPoint_Pad_D1.0mm
U1: ESP32-S3-WROOM-1-N8R8; RF_Module__ESP32-S3-WROOM-1

Connections:
+3V3: C2.1, C3.1, C5.1, R1.1, R2.1, R4.1, TP2.1, U1.2 (3V3); also elsewhere on the board
CAM_D0: U1.4 (IO4); also elsewhere on the board
CAM_D1: U1.5 (IO5); also elsewhere on the board
CAM_D2: U1.6 (IO6); also elsewhere on the board
CAM_D3: U1.7 (IO7); also elsewhere on the board
CAM_D4: U1.12 (IO8); also elsewhere on the board
CAM_D5: U1.17 (IO9); also elsewhere on the board
CAM_D6: U1.18 (IO10); also elsewhere on the board
CAM_D7: U1.19 (IO11); also elsewhere on the board
CAM_HREF: U1.22 (IO14); also elsewhere on the board
CAM_PCLK: U1.20 (IO12); also elsewhere on the board
CAM_RESET: C4.1, R4.2; also elsewhere on the board
CAM_SCL: U1.10 (IO17); also elsewhere on the board
CAM_SDA: U1.9 (IO16); also elsewhere on the board
CAM_VSYNC: U1.21 (IO13); also elsewhere on the board
CAM_XCLK: U1.8 (IO15); also elsewhere on the board
CELL_TEMP_ADC: U1.38 (IO2); also elsewhere on the board
DRIVE_ENABLE: TP8.1; also elsewhere on the board
DRIVE_REQ_RAW: U1.35 (IO42); also elsewhere on the board
ESP_BOOT: R2.2, SW2.1, U1.27 (IO0)
ESP_EN: C1.1, R1.2, SW1.1, TP6.1, U1.3 (EN)
FAULT_U2: TP9.1, U1.24 (IO47); also elsewhere on the board
FAULT_U3: TP10.1, U1.25 (IO48); also elsewhere on the board
GND: C1.2, C2.2, C3.2, C4.2, C5.2, D1.1 (K), SW1.2, SW2.2, TP1.1, U1.1 (GND), U1.40 (GND), U1.41 (GND); also elsewhere on the board
LED_A: D1.2 (A), R3.2
LED_STATUS: R3.1, TP7.1, U1.37 (TXD0)
M1_IN1: U1.11 (IO18); also elsewhere on the board
M1_IN2: U1.23 (IO21); also elsewhere on the board
M2_IN1: U1.31 (IO38); also elsewhere on the board
M2_IN2: U1.32 (IO39); also elsewhere on the board
M3_IN1: U1.33 (IO40); also elsewhere on the board
M3_IN2: U1.34 (IO41); also elsewhere on the board
REG_PG: TP11.1; also elsewhere on the board
SYS_RAW: TP5.1; also elsewhere on the board
USB_500_ENABLE: U1.36 (RXD0); also elsewhere on the board
USB_DM: U1.13 (IO19); also elsewhere on the board
USB_DP: U1.14 (IO20); also elsewhere on the board
VBAT: TP3.1; also elsewhere on the board
VBAT_ADC: U1.39 (IO1); also elsewhere on the board
VMOTOR: TP4.1; also elsewhere on the board

Notes on the sheet:
BOOT strap
Controller, camera and service points
Waveshare OV2640 | documented 2 x 9 interface
[SPEC] GPIO35 / 36 / 37 reserved for N8R8 PSRAM.
Status indicator
Camera reset RC
Service points (named nets continue on other sheets)
RESET / enable RC

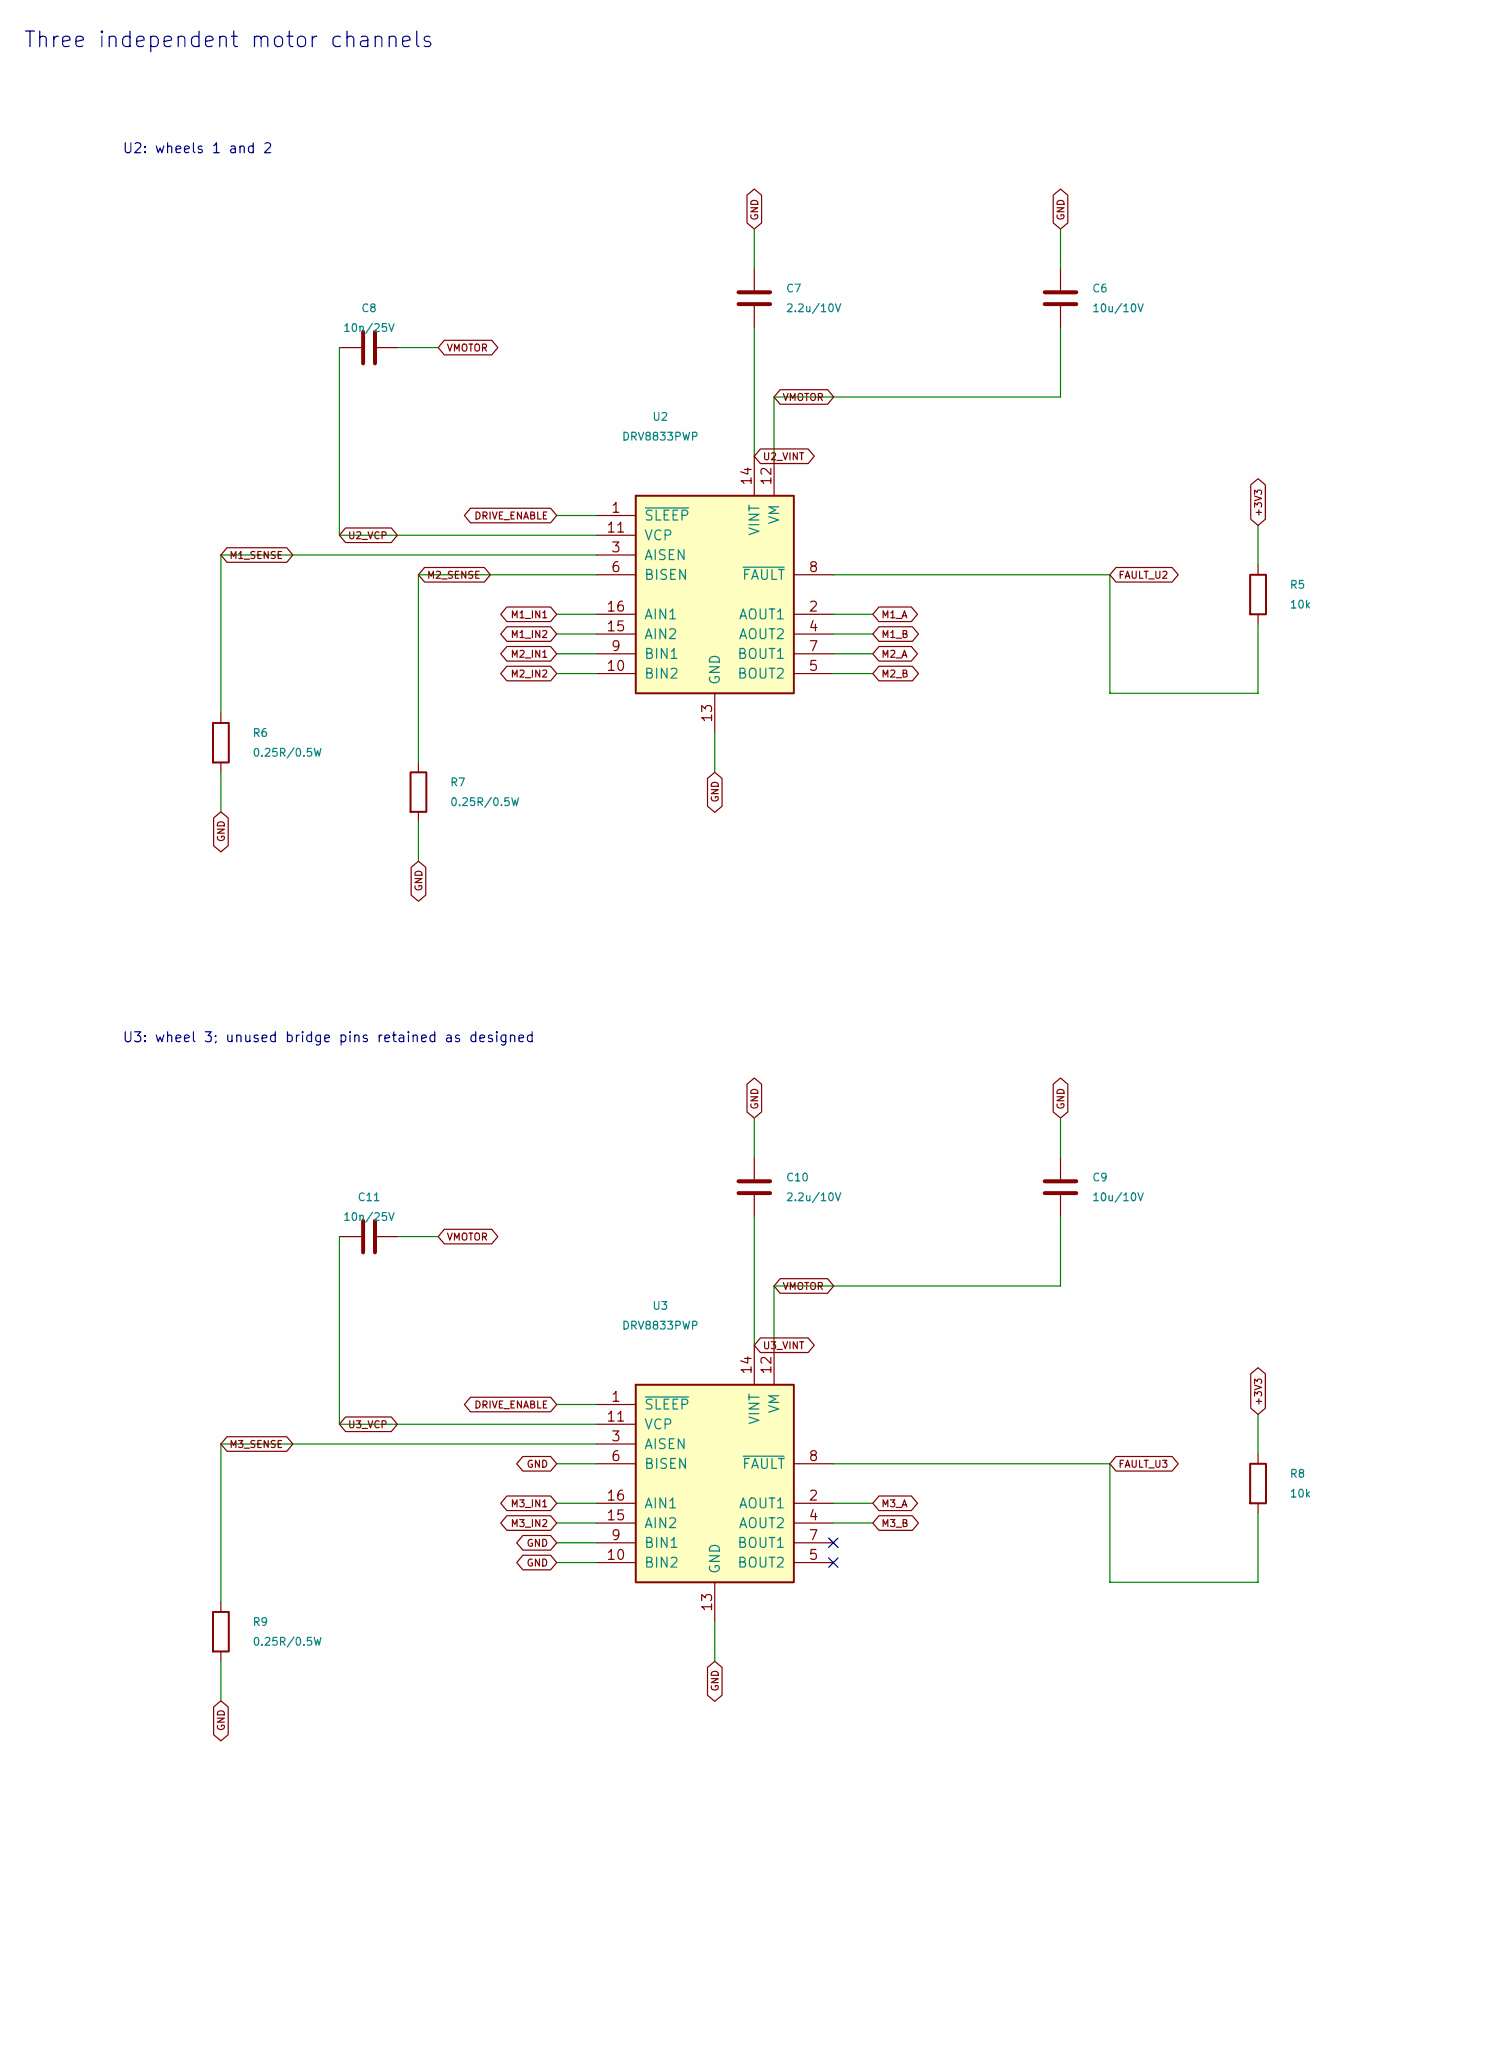
[picture p170: schematic motors.kicad_sch, Three independent motor channels, part in row 1, column 1]

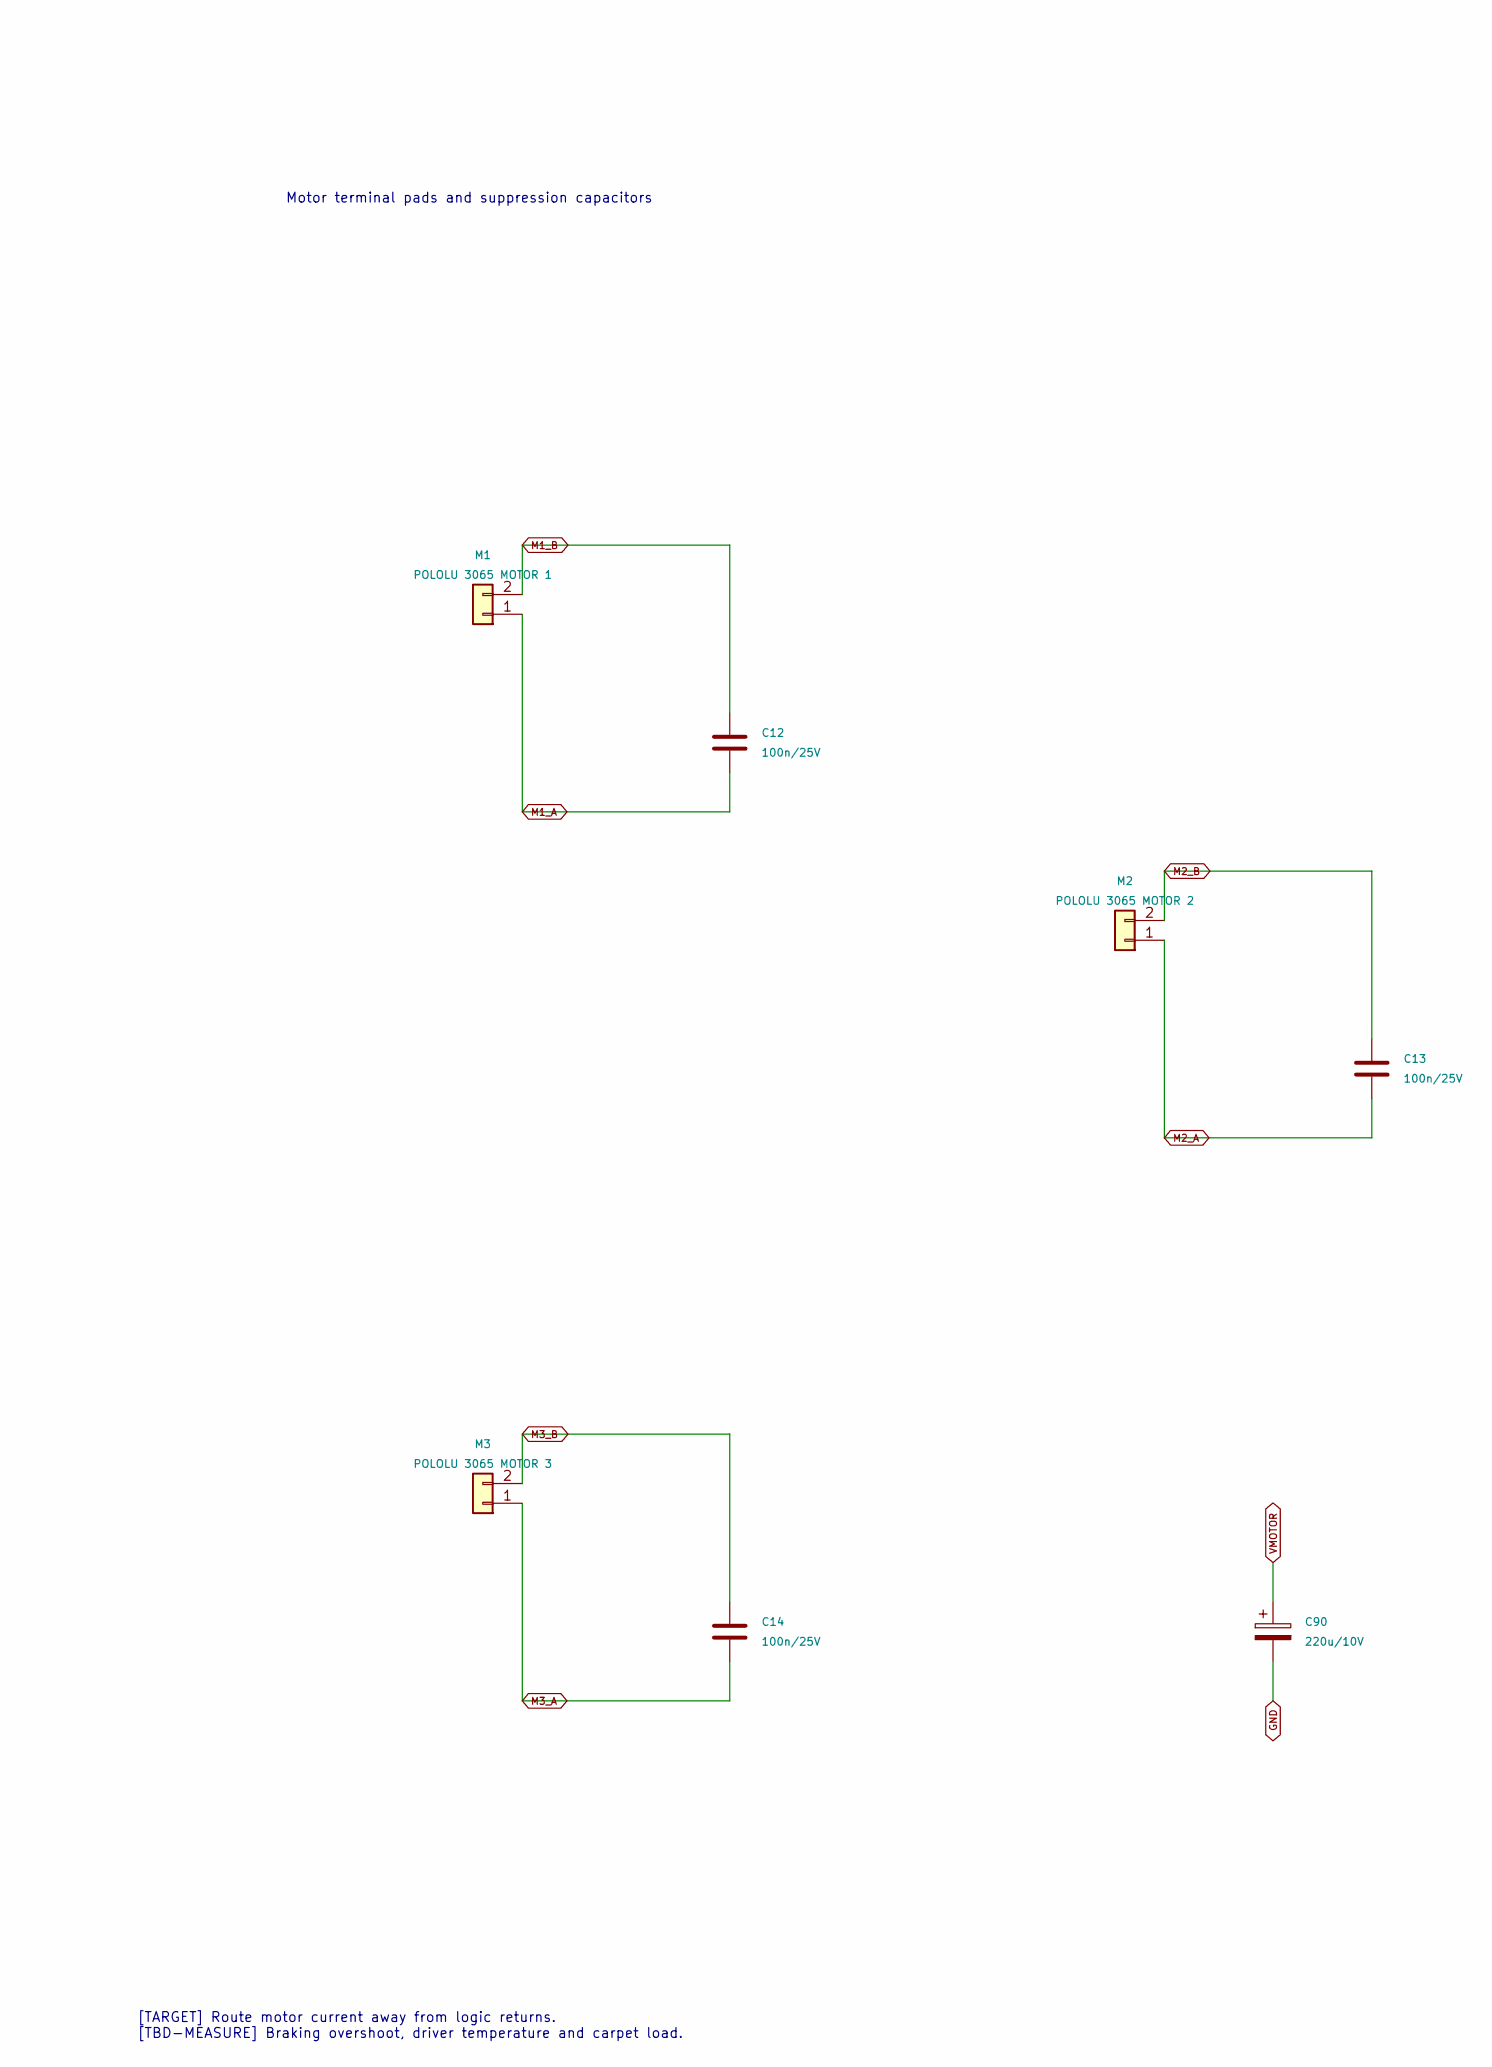
[picture p171: schematic motors.kicad_sch, Three independent motor channels, part in row 1, column 2]

Parts:
C6, C9: 10u/10V; Capacitor_SMD__C_0805_2012Metric
C7, C10: 2.2u/10V; Capacitor_SMD__C_0603_1608Metric
C8, C11: 10n/25V; Capacitor_SMD__C_0603_1608Metric
C12, C13, C14: 100n/25V; Capacitor_SMD__C_0603_1608Metric
C90: 220u/10V; CP_Elec_6.3x5.8_HandAssembly
M1: POLOLU 3065 MOTOR 1; Pololu_HPCB_Solder
M2: POLOLU 3065 MOTOR 2; Pololu_HPCB_Solder
M3: POLOLU 3065 MOTOR 3; Pololu_HPCB_Solder
R5, R8: 10k; Resistor_SMD__R_0603_1608Metric
R6, R7, R9: 0.25R/0.5W; Resistor_SMD__R_1206_3216Metric
U2, U3: DRV8833PWP; Package_SO__HTSSOP-16-1EP_4.4x5mm_P0.65mm_EP3.4x5mm_Mask2.4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

Connections:
+3V3: R5.1, R8.1; also elsewhere on the board
DRIVE_ENABLE: U2.1 (~SLEEP), U3.1 (~SLEEP); also elsewhere on the board
FAULT_U2: R5.2, U2.8 (~FAULT); also elsewhere on the board
FAULT_U3: R8.2, U3.8 (~FAULT); also elsewhere on the board
GND: C6.2, C7.2, C9.2, C10.2, C90.2, R6.2, R7.2, R9.2, U2.13 (GND), U2.17 (GND), U3.6 (BISEN), U3.9 (BIN1), U3.10 (BIN2), U3.13 (GND), U3.17 (GND); also elsewhere on the board
M1_A: C12.1, M1.1, U2.2 (AOUT1)
M1_B: C12.2, M1.2, U2.4 (AOUT2)
M1_IN1: U2.16 (AIN1); also elsewhere on the board
M1_IN2: U2.15 (AIN2); also elsewhere on the board
M1_SENSE: R6.1, U2.3 (AISEN)
M2_A: C13.1, M2.1, U2.7 (BOUT1)
M2_B: C13.2, M2.2, U2.5 (BOUT2)
M2_IN1: U2.9 (BIN1); also elsewhere on the board
M2_IN2: U2.10 (BIN2); also elsewhere on the board
M2_SENSE: R7.1, U2.6 (BISEN)
M3_A: C14.1, M3.1, U3.2 (AOUT1)
M3_B: C14.2, M3.2, U3.4 (AOUT2)
M3_IN1: U3.16 (AIN1); also elsewhere on the board
M3_IN2: U3.15 (AIN2); also elsewhere on the board
M3_SENSE: R9.1, U3.3 (AISEN)
U2_VCP: C8.1, U2.11 (VCP)
U2_VINT: C7.1, U2.14 (VINT)
U3_VCP: C11.1, U3.11 (VCP)
U3_VINT: C10.1, U3.14 (VINT)
VMOTOR: C6.1, C8.2, C9.1, C11.2, C90.1, U2.12 (VM), U3.12 (VM); also elsewhere on the board

Notes on the sheet:
U2: wheels 1 and 2
[TARGET] Route motor current away from logic returns. [TBD-MEASURE] Braking overshoot, driver temperature and carpet load.
U3: wheel 3; unused bridge pins retained as designed
Motor terminal pads and suppression capacitors
Three independent motor channels
