ncripted/DAMIEN/outputs/rover/Omni_UGV_Rev_E1_layout_candidate/omni_ugv.kicad_pcb

## KiCad design outputs/rover/Omni_UGV_Rev_E1_layout_candidate/omni_ugv.kicad_pcb (continued)

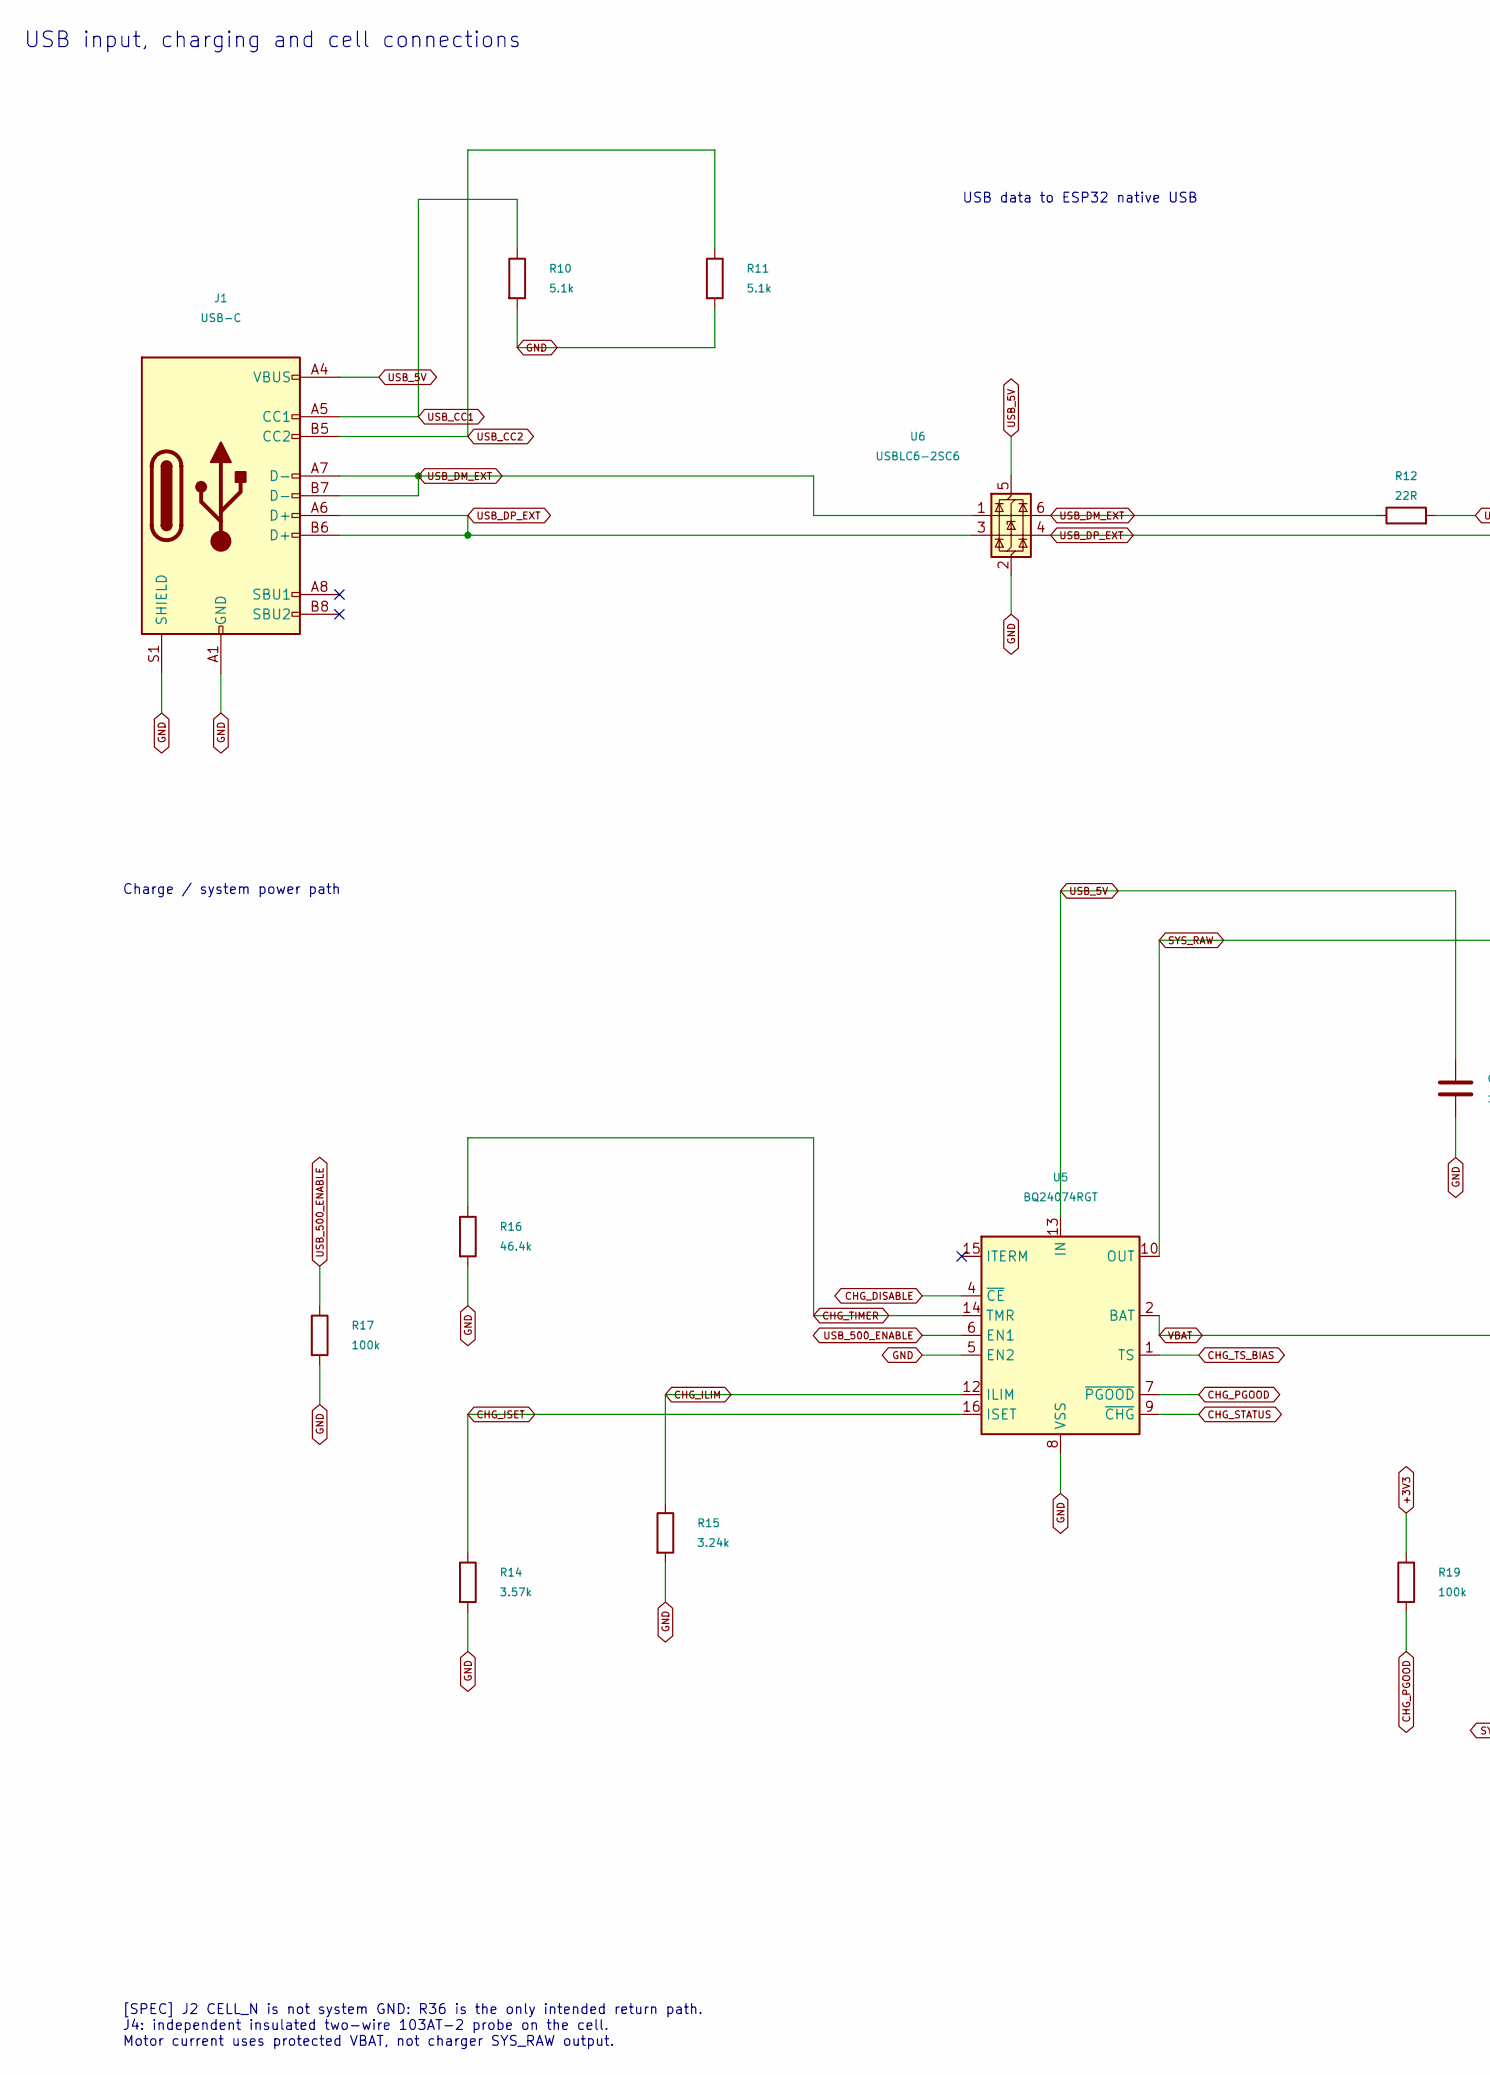
[picture p172: schematic charging.kicad_sch, USB input, charging and cell connections, part in row 1, column 1]

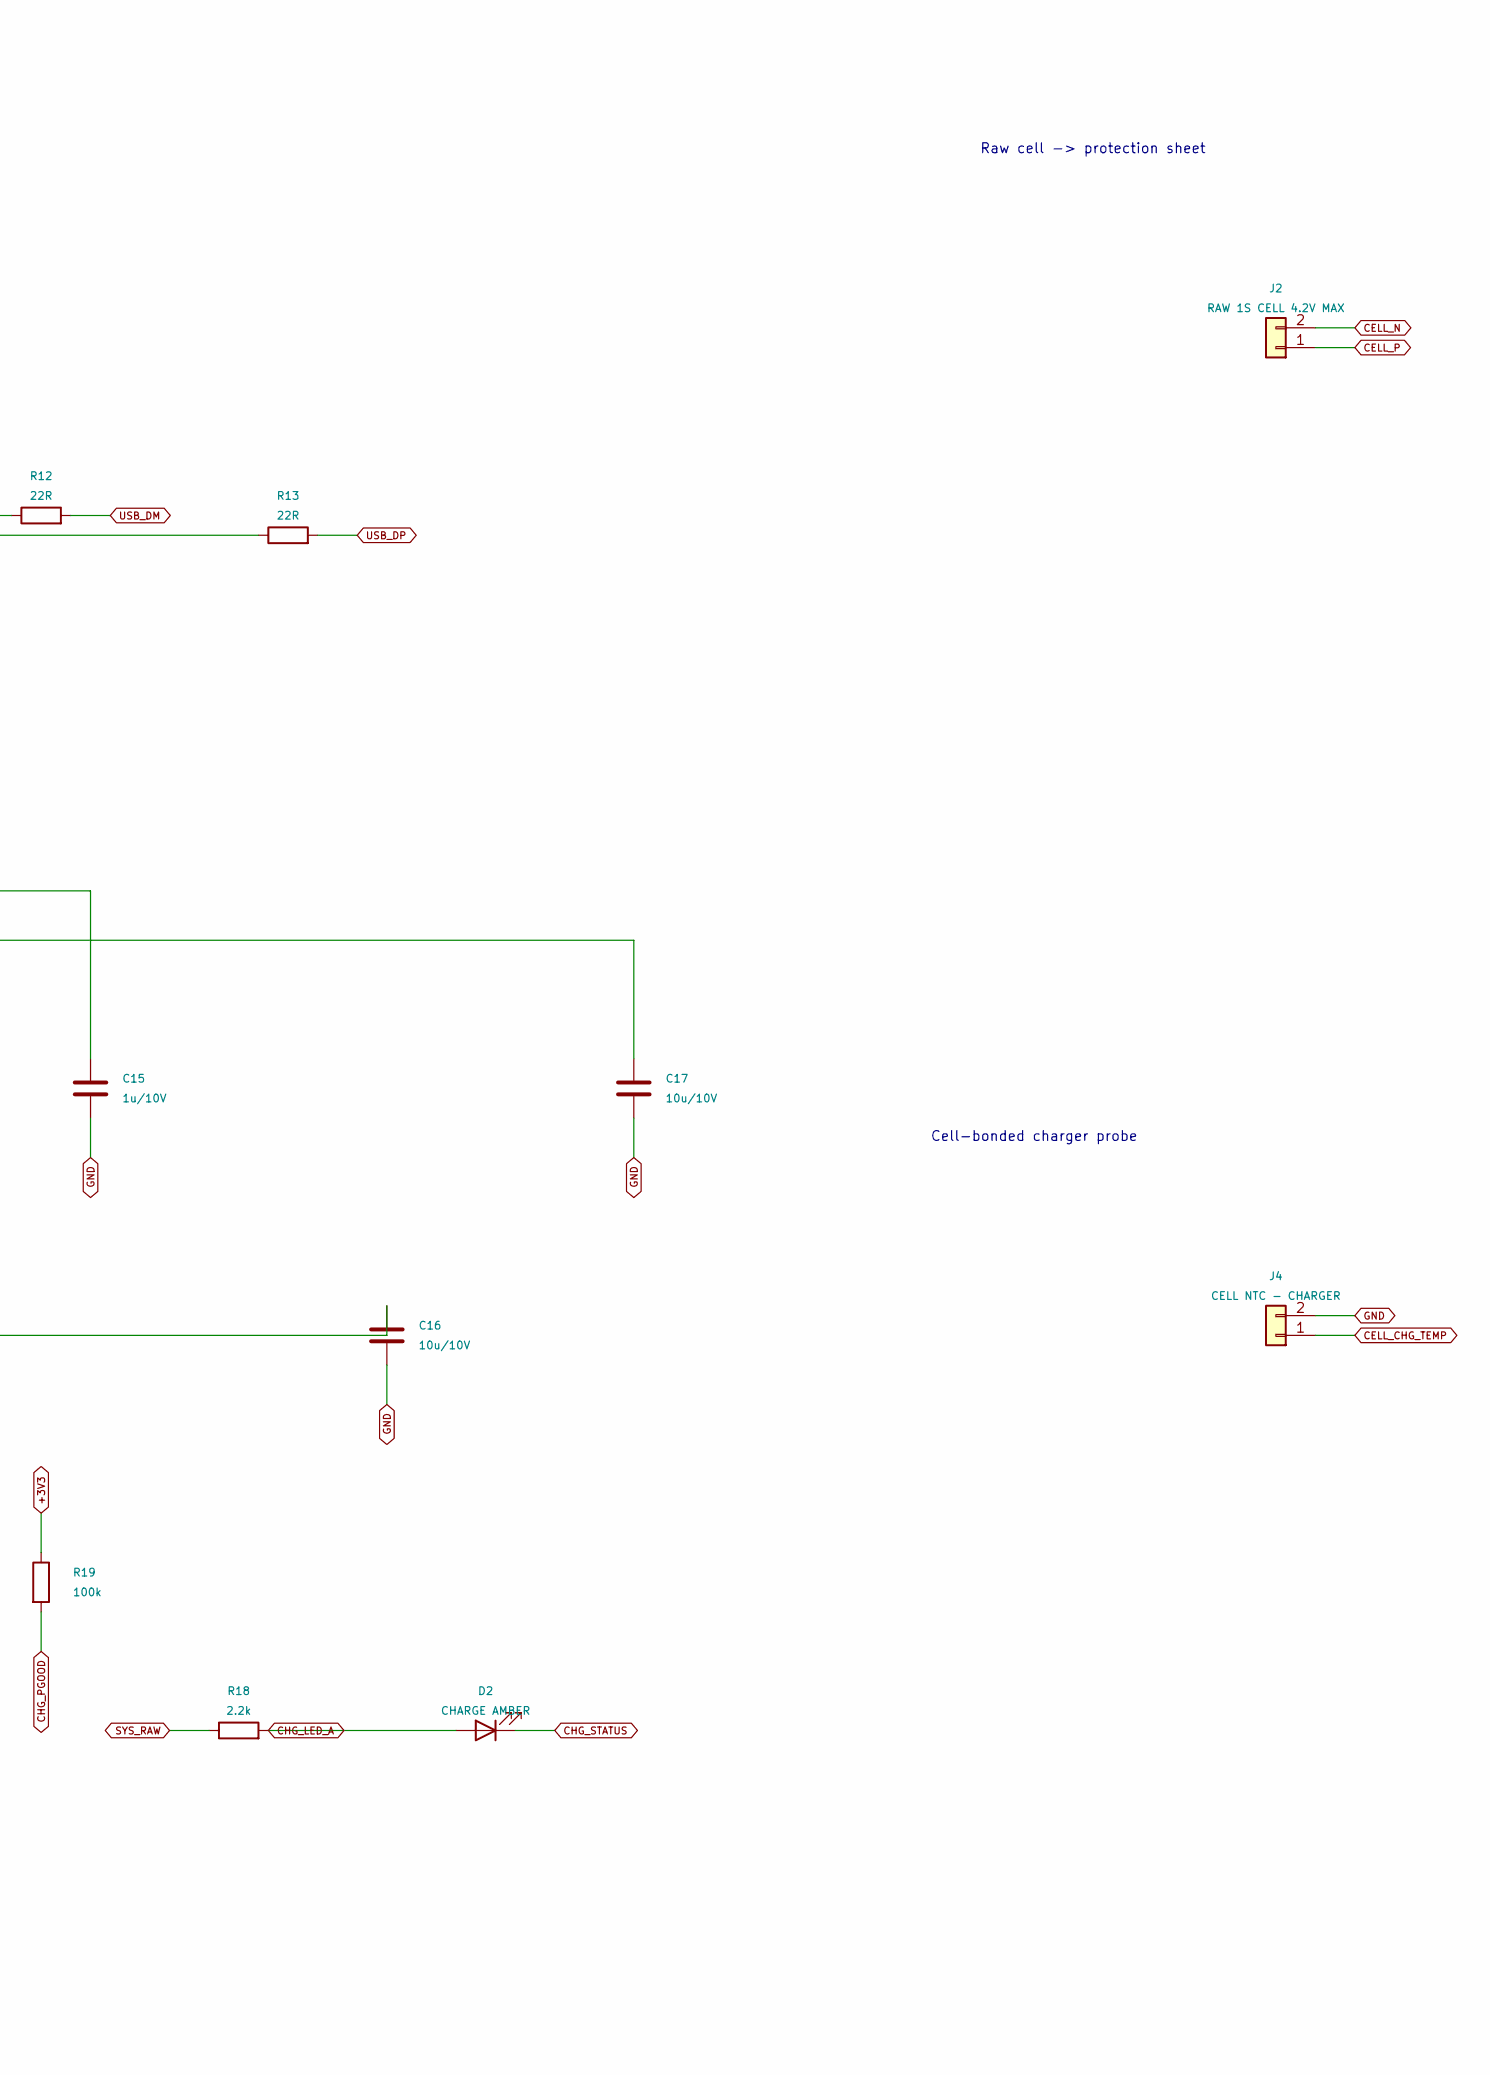
[picture p173: schematic charging.kicad_sch, USB input, charging and cell connections, part in row 1, column 2]

Parts:
C15: 1u/10V; Capacitor_SMD__C_0603_1608Metric
C16, C17: 10u/10V; Capacitor_SMD__C_0805_2012Metric
D2: CHARGE AMBER; LED_SMD__LED_0603_1608Metric
J1: USB-C; Connector_USB__USB_C_Receptacle_GCT_USB4105-xx-A_16P_TopMnt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
J2: RAW 1S CELL 4.2V MAX; Connector_Molex__Molex_Micro-Fit_3.0_43650-0215_1x02_P3.00m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
J4: CELL NTC - CHARGER; Connector_JST__JST_PH_B2B-PH-K_1x02_P2.00mm_Vertical
R10, R11: 5.1k; Resistor_SMD__R_0603_1608Metric
R12, R13: 22R; Resistor_SMD__R_0603_1608Metric
R14: 3.57k; Resistor_SMD__R_0603_1608Metric
R15: 3.24k; Resistor_SMD__R_0603_1608Metric
R16: 46.4k; Resistor_SMD__R_0603_1608Metric
R17, R19: 100k; Resistor_SMD__R_0603_1608Metric
R18: 2.2k; Resistor_SMD__R_0603_1608Metric
U5: BQ24074RGT; Package_DFN_QFN__VQFN-16-1EP_3x3mm_P0.5mm_EP1.6x1.6mm
U6: USBLC6-2SC6; Package_TO_SOT_SMD__SOT-23-6

Connections:
+3V3: R19.1; also elsewhere on the board
CELL_CHG_TEMP: J4.1; also elsewhere on the board
CELL_N: J2.2; also elsewhere on the board
CELL_P: J2.1; also elsewhere on the board
CHG_DISABLE: U5.4 (~CE); also elsewhere on the board
CHG_ILIM: R15.1, U5.12 (ILIM)
CHG_ISET: R14.1, U5.16 (ISET)
CHG_LED_A: D2.2 (A), R18.2
CHG_PGOOD: R19.2, U5.7 (~PGOOD)
CHG_STATUS: D2.1 (K), U5.9 (~CHG)
CHG_TIMER: R16.1, U5.14 (TMR)
CHG_TS_BIAS: U5.1 (TS); also elsewhere on the board
GND: C15.2, C16.2, C17.2, J1.A1 (GND), J1.A12 (GND), J1.B1 (GND), J1.B12 (GND), J1.S1 (SHIELD), J4.2, R10.2, R11.2, R14.2, R15.2, R16.2, R17.2, U5.5 (EN2), U5.8 (VSS), U5.17 (VSS), U6.2 (GND); also elsewhere on the board
SYS_RAW: C17.1, R18.1, U5.10 (OUT), U5.11 (OUT); also elsewhere on the board
USB_5V: C15.1, J1.A4 (VBUS), J1.A9 (VBUS), J1.B4 (VBUS), J1.B9 (VBUS), U5.13 (IN), U6.5 (VBUS); also elsewhere on the board
USB_500_ENABLE: R17.1, U5.6 (EN1); also elsewhere on the board
USB_CC1: J1.A5 (CC1), R10.1
USB_CC2: J1.B5 (CC2), R11.1
USB_DM: R12.2; also elsewhere on the board
USB_DM_EXT: J1.A7 (D-), J1.B7 (D-), R12.1, U6.1 (I/O1), U6.6 (I/O1)
USB_DP: R13.2; also elsewhere on the board
USB_DP_EXT: J1.A6 (D+), J1.B6 (D+), R13.1, U6.3 (I/O2), U6.4 (I/O2)
VBAT: C16.1, U5.2 (BAT), U5.3 (BAT); also elsewhere on the board

Notes on the sheet:
Cell-bonded charger probe
Raw cell -> protection sheet
USB data to ESP32 native USB
USB input, charging and cell connections
Charge / system power path
[SPEC] J2 CELL_N is not system GND: R36 is the only intended return path. J4: independent insulated two-wire 103AT-2 probe on the cell. Motor current uses protected VBAT, not charger SYS_RAW output.

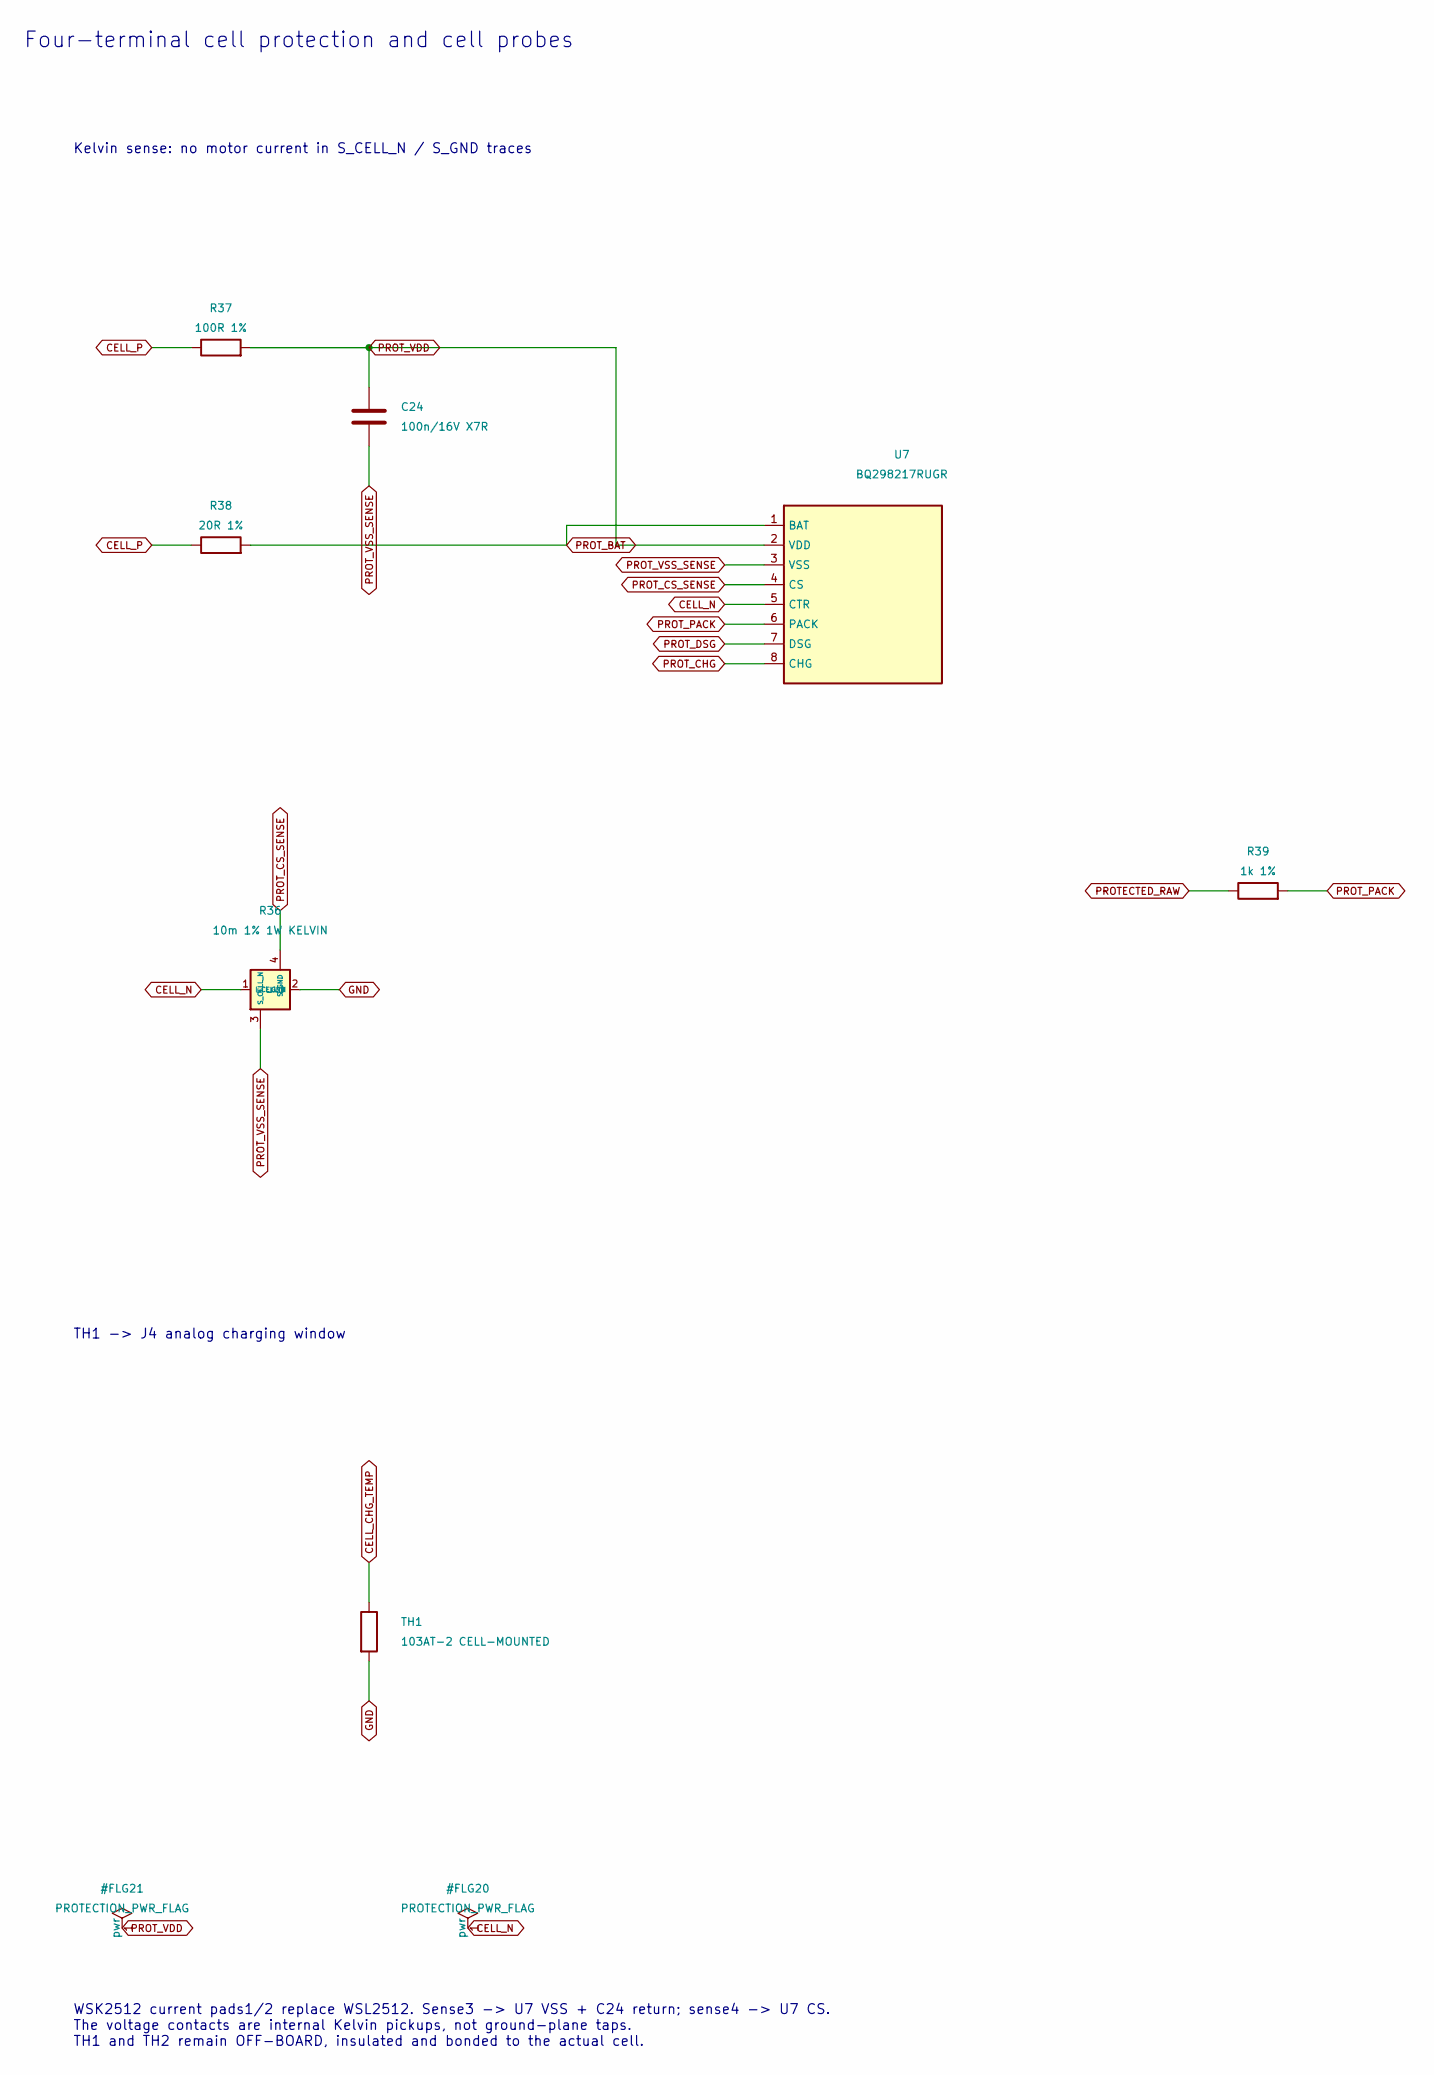
[picture p174: schematic battery_protection.kicad_sch, Four-terminal cell protection and cell probes, part in row 1, column 1]

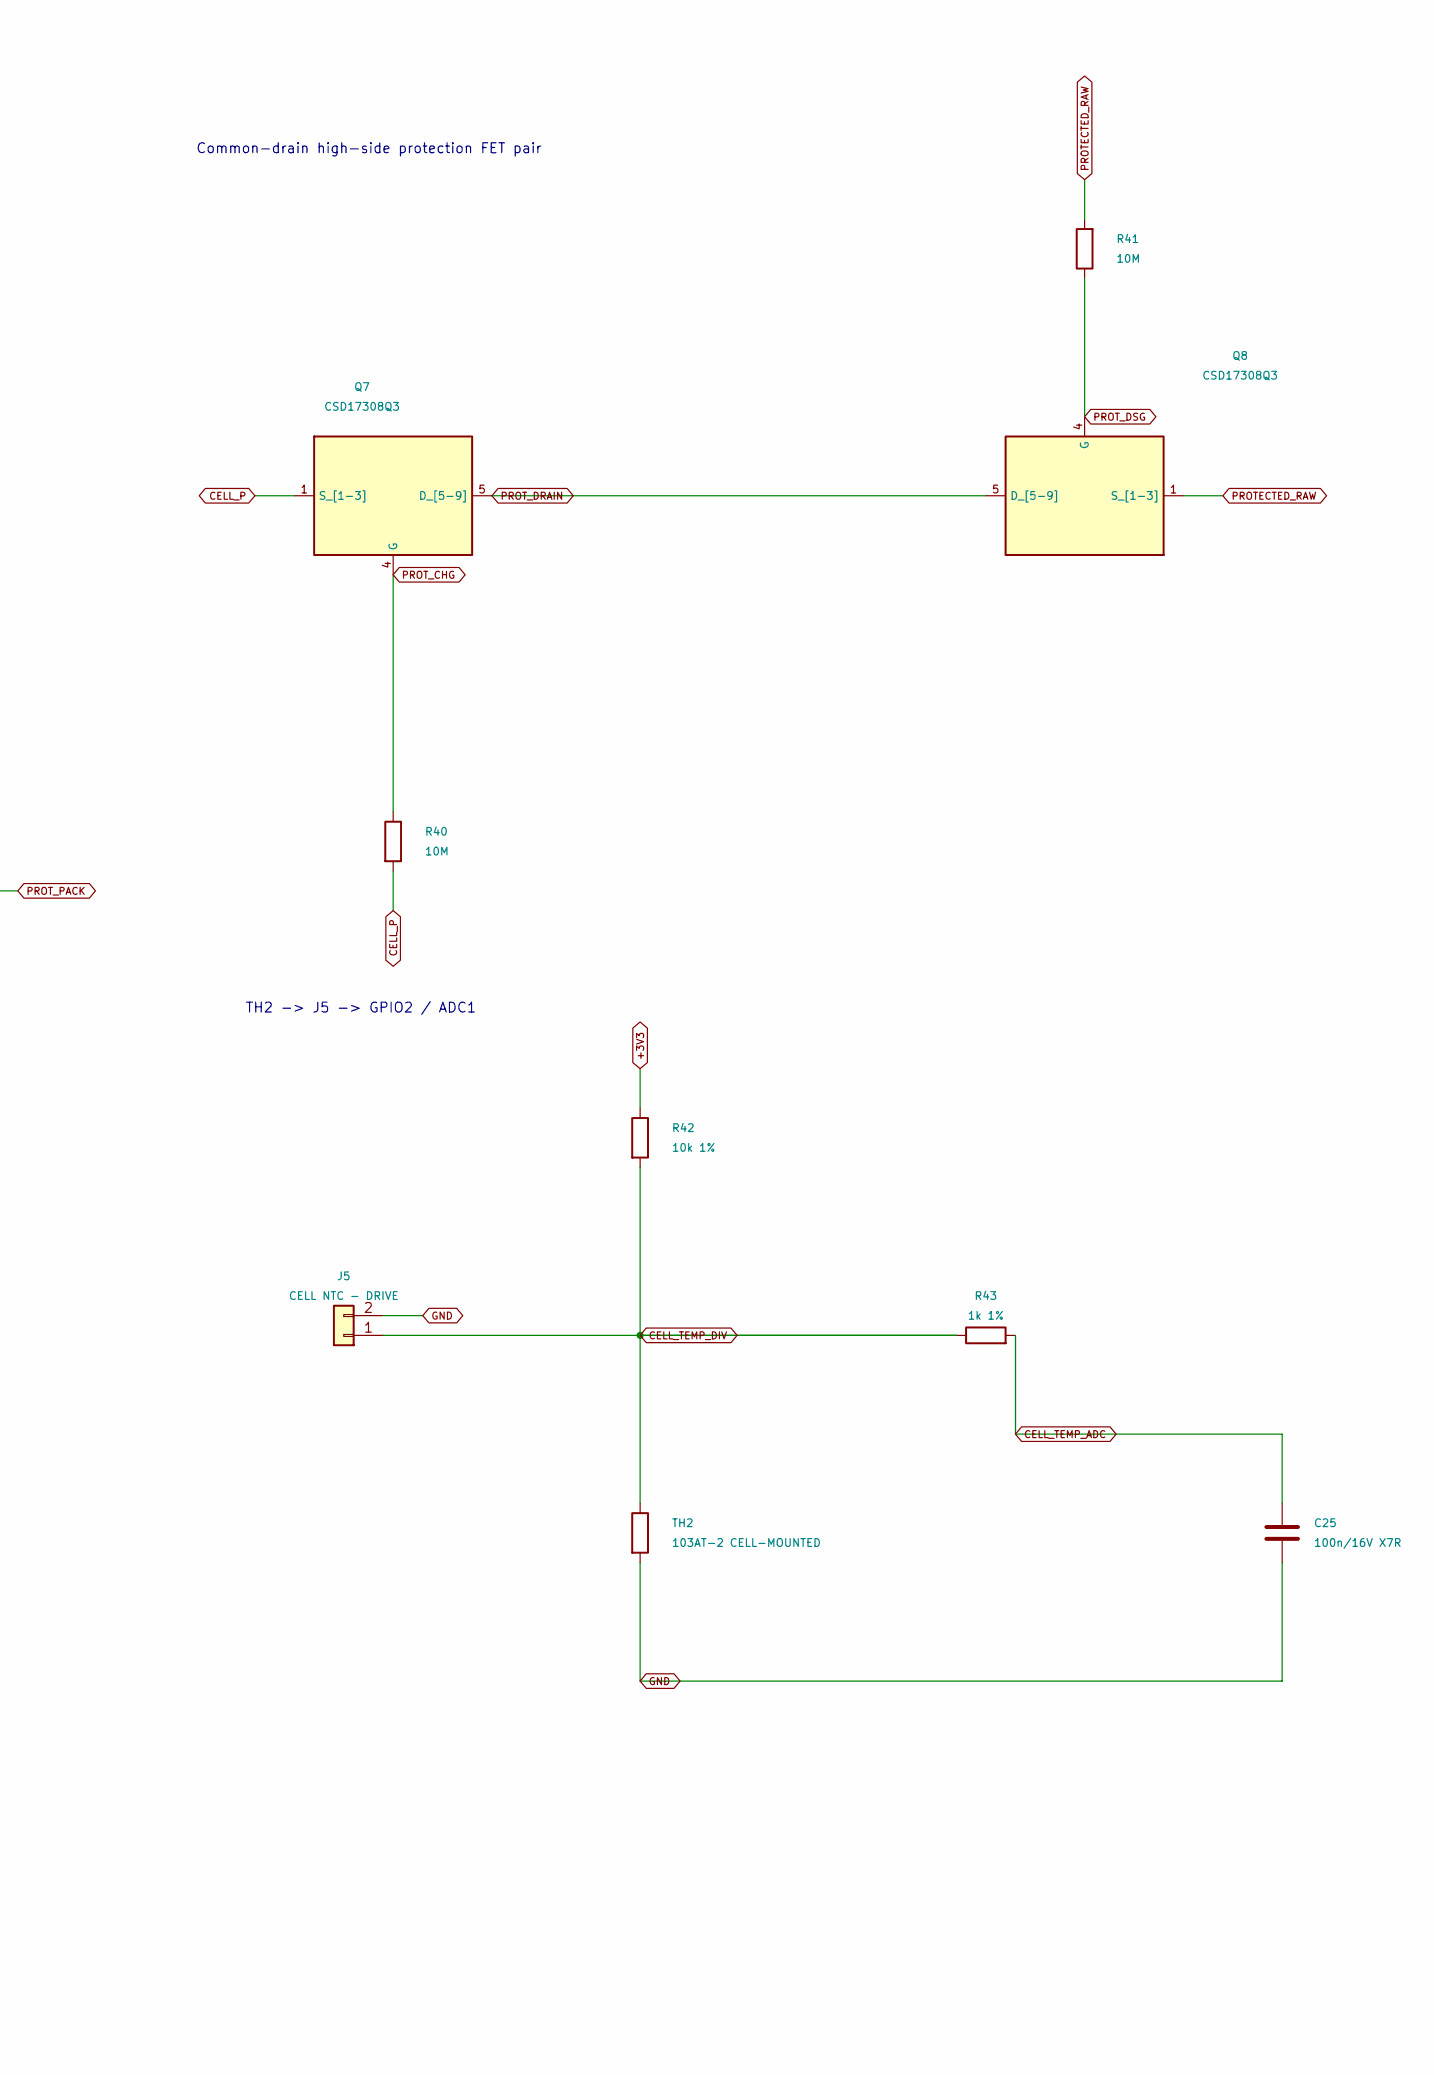
[picture p175: schematic battery_protection.kicad_sch, Four-terminal cell protection and cell probes, part in row 1, column 2]

Parts:
C24, C25: 100n/16V X7R; Capacitor_SMD__C_0603_1608Metric
J5: CELL NTC - DRIVE; Connector_JST__JST_PH_B2B-PH-K_1x02_P2.00mm_Vertical
Q7, Q8: CSD17308Q3; CSD17308Q3_TI
R36: 10m 1% 1W KELVIN; WSK2512_T1p19_Kelvin
R37: 100R 1%; Resistor_SMD__R_0603_1608Metric
R38: 20R 1%; Resistor_SMD__R_0603_1608Metric
R39, R43: 1k 1%; Resistor_SMD__R_0603_1608Metric
R40, R41: 10M; Resistor_SMD__R_0603_1608Metric
R42: 10k 1%; Resistor_SMD__R_0603_1608Metric
TH1, TH2: 103AT-2 CELL-MOUNTED
U7: BQ298217RUGR; BQ298217_RUG0008A

Connections:
+3V3: R42.1; also elsewhere on the board
CELL_N: R36.1 (I_CELL_N), U7.5 (CTR); also elsewhere on the board
CELL_P: Q7.1 (S_[1-3]), Q7.2 (S), Q7.3 (S), R37.1, R38.1, R40.2; also elsewhere on the board
CELL_TEMP_ADC: C25.1, R43.2; also elsewhere on the board
CELL_TEMP_DIV: J5.1, R42.2, R43.1, TH2.1
GND: C25.2, J5.2, R36.2 (I_GND), TH1.2, TH2.2; also elsewhere on the board
PROTECTED_RAW: Q8.1 (S_[1-3]), Q8.2 (S), Q8.3 (S), R39.1, R41.2; also elsewhere on the board
PROT_BAT: R38.2, U7.1 (BAT)
PROT_CHG: Q7.4 (G), R40.1, U7.8 (CHG)
PROT_CS_SENSE: R36.4 (S_GND), U7.4 (CS)
PROT_DRAIN: Q7.5 (D_[5-9]), Q7.6 (D), Q7.7 (D), Q7.8 (D), Q7.9 (D), Q8.5 (D_[5-9]), Q8.6 (D), Q8.7 (D), Q8.8 (D), Q8.9 (D)
PROT_DSG: Q8.4 (G), R41.1, U7.7 (DSG)
PROT_PACK: R39.2, U7.6 (PACK)
PROT_VDD: C24.1, R37.2, U7.2 (VDD)
PROT_VSS_SENSE: C24.2, R36.3 (S_CELL_N), U7.3 (VSS)

Notes on the sheet:
Kelvin sense: no motor current in S_CELL_N / S_GND traces
Common-drain high-side protection FET pair
TH1 -> J4 analog charging window
TH2 -> J5 -> GPIO2 / ADC1
WSK2512 current pads1/2 replace WSL2512. Sense3 -> U7 VSS + C24 return; sense4 -> U7 CS. The voltage contacts are internal Kelvin pickups, not ground-plane taps. TH1 and TH2 remain OFF-BOARD, insulated and bonded to the actual cell.
Four-terminal cell protection and cell probes

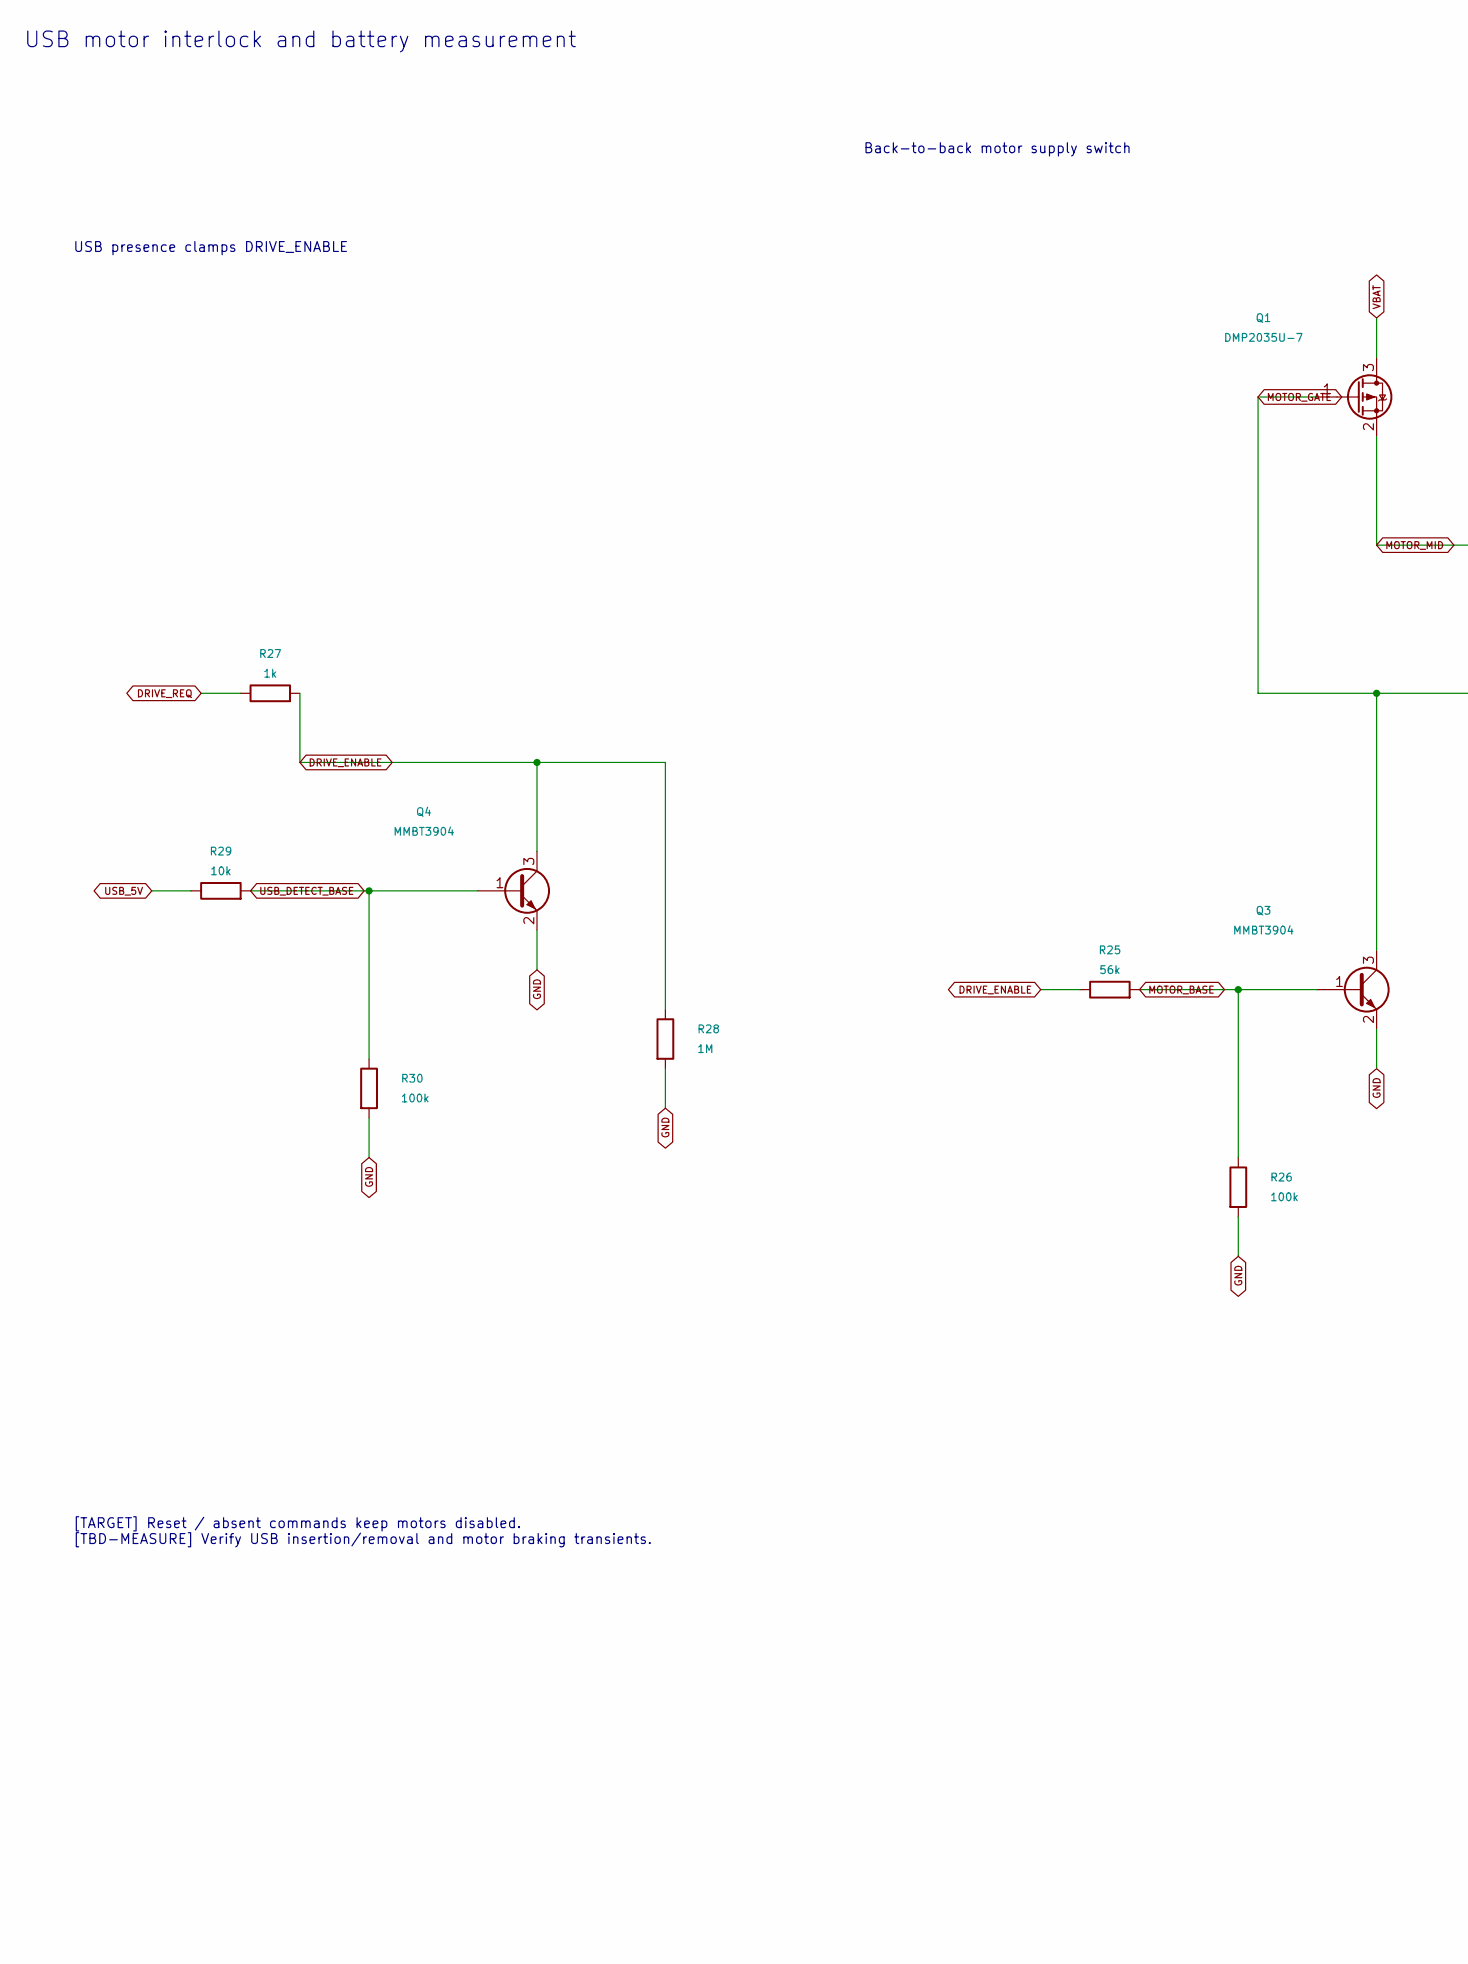
[picture p176: schematic interlock.kicad_sch, USB motor interlock and battery measurement, part in row 1, column 1]

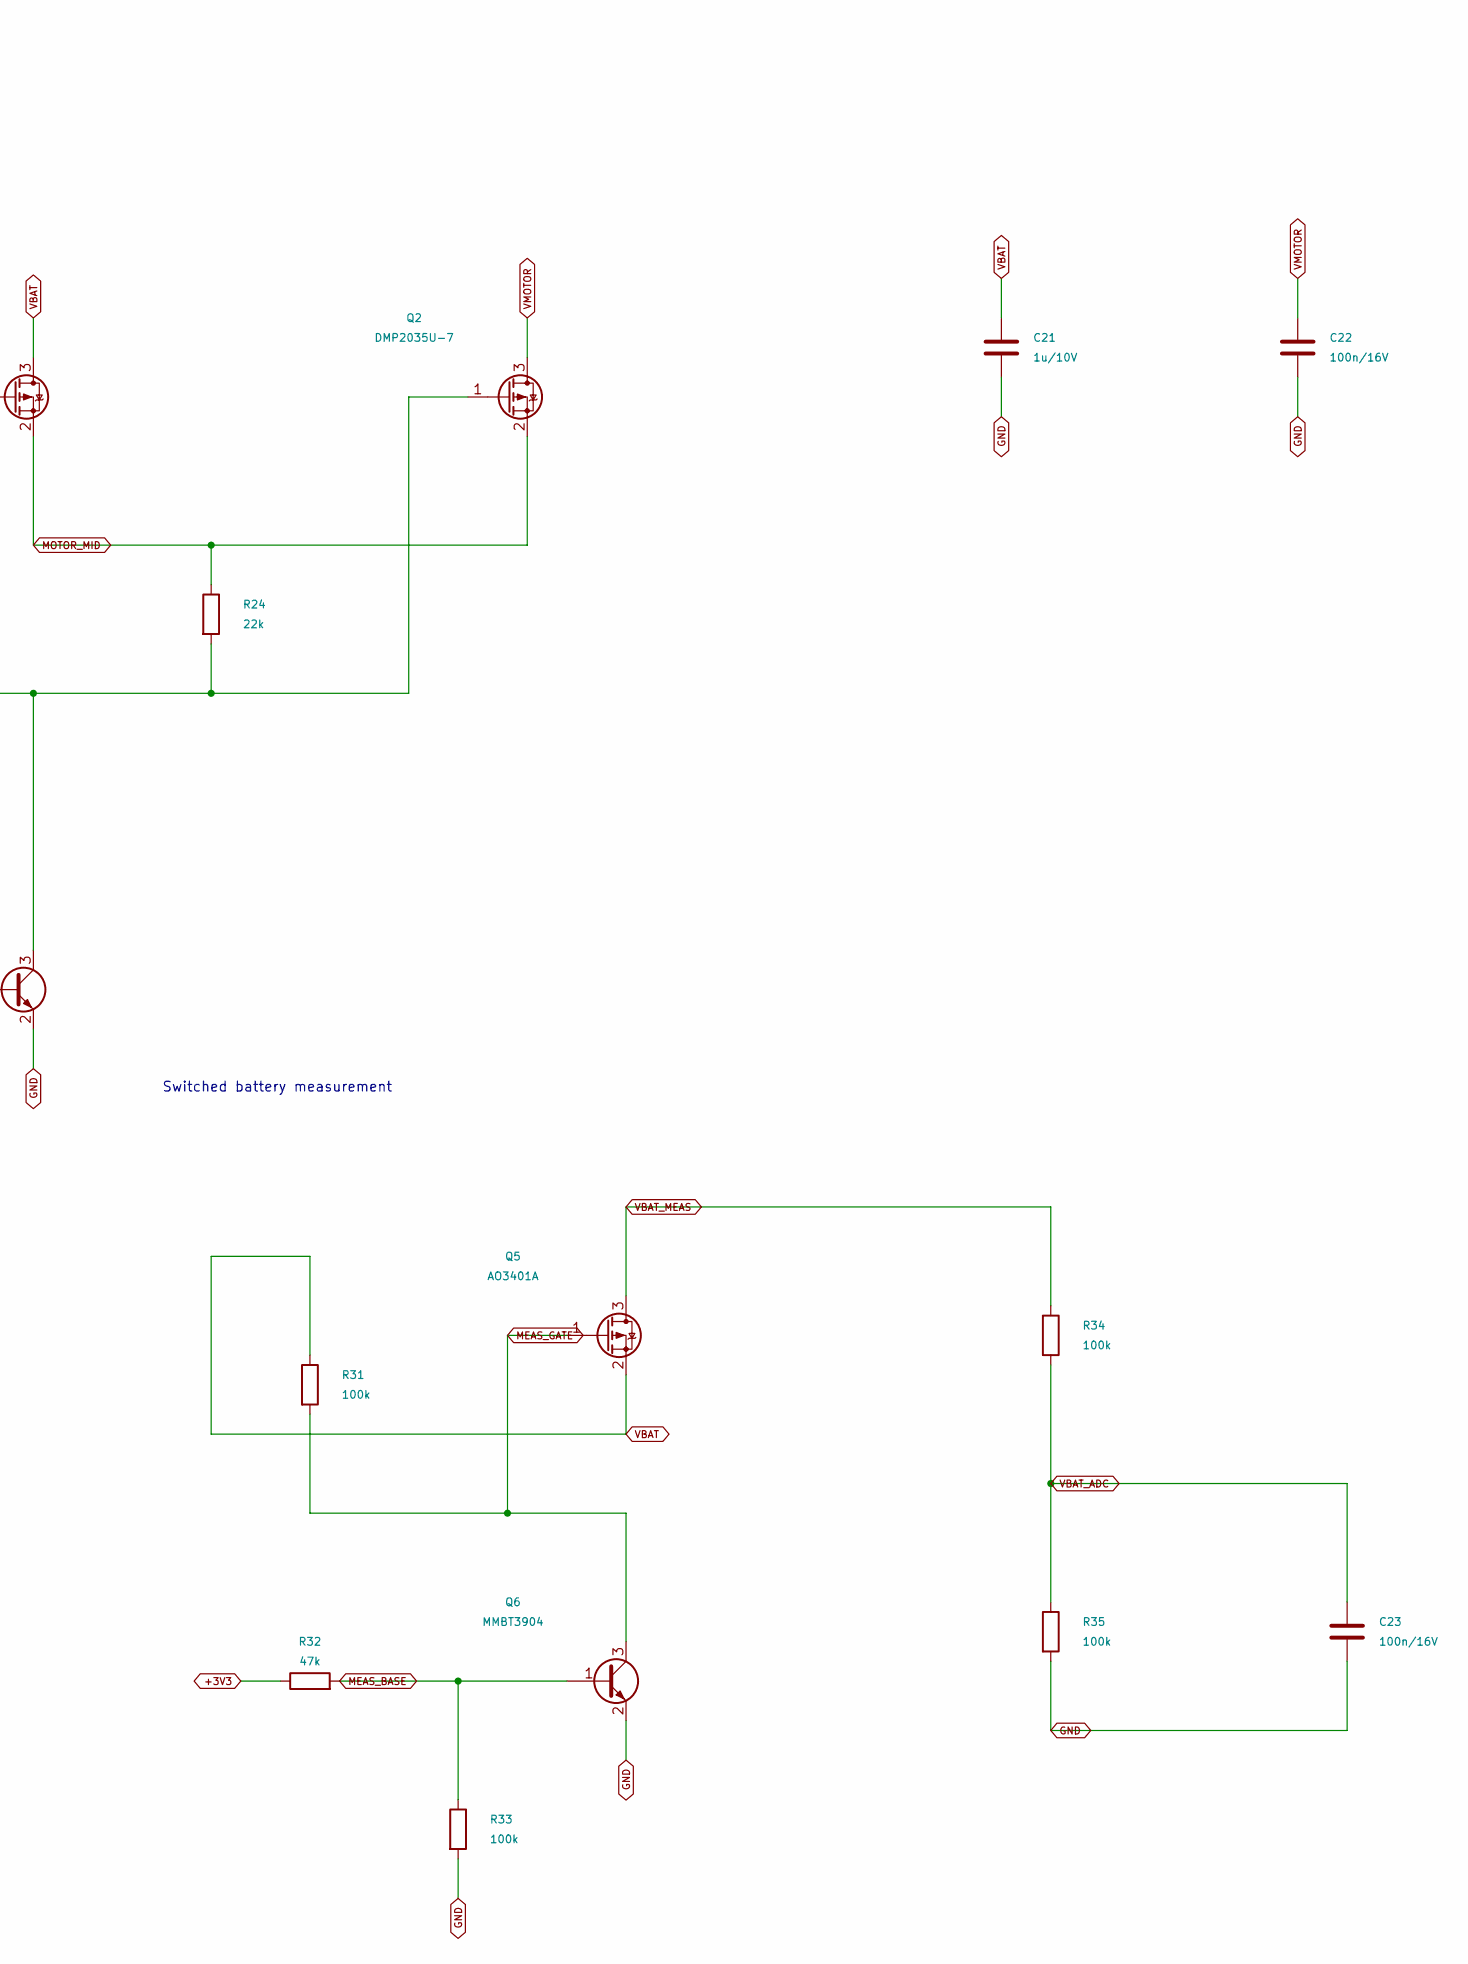
[picture p177: schematic interlock.kicad_sch, USB motor interlock and battery measurement, part in row 1, column 2]

Parts:
C21: 1u/10V; Capacitor_SMD__C_0603_1608Metric
C22, C23: 100n/16V; Capacitor_SMD__C_0603_1608Metric
Q1, Q2: DMP2035U-7; Package_TO_SOT_SMD__SOT-23
Q3, Q4, Q6: MMBT3904; Package_TO_SOT_SMD__SOT-23
Q5: AO3401A; Package_TO_SOT_SMD__SOT-23
R24: 22k; Resistor_SMD__R_0603_1608Metric
R25: 56k; Resistor_SMD__R_0603_1608Metric
R26, R30, R31, R33, R34, R35: 100k; Resistor_SMD__R_0603_1608Metric
R27: 1k; Resistor_SMD__R_0603_1608Metric
R28: 1M; Resistor_SMD__R_0603_1608Metric
R29: 10k; Resistor_SMD__R_0603_1608Metric
R32: 47k; Resistor_SMD__R_0603_1608Metric

Connections:
+3V3: R32.1; also elsewhere on the board
DRIVE_ENABLE: Q4.3 (C), R25.1, R27.2, R28.1; also elsewhere on the board
DRIVE_REQ: R27.1; also elsewhere on the board
GND: C21.2, C22.2, C23.2, Q3.2 (E), Q4.2 (E), Q6.2 (E), R26.2, R28.2, R30.2, R33.2, R35.2; also elsewhere on the board
MEAS_BASE: Q6.1 (B), R32.2, R33.1
MEAS_GATE: Q5.1 (G), Q6.3 (C), R31.2
MOTOR_BASE: Q3.1 (B), R25.2, R26.1
MOTOR_GATE: Q1.1 (G), Q2.1 (G), Q3.3 (C), R24.2
MOTOR_MID: Q1.2 (S), Q2.2 (S), R24.1
USB_5V: R29.1; also elsewhere on the board
USB_DETECT_BASE: Q4.1 (B), R29.2, R30.1
VBAT: C21.1, Q1.3 (D), Q5.2 (S), R31.1; also elsewhere on the board
VBAT_ADC: C23.1, R34.2, R35.1; also elsewhere on the board
VBAT_MEAS: Q5.3 (D), R34.1
VMOTOR: C22.1, Q2.3 (D); also elsewhere on the board

Notes on the sheet:
USB presence clamps DRIVE_ENABLE
Back-to-back motor supply switch
Switched battery measurement
[TARGET] Reset / absent commands keep motors disabled. [TBD-MEASURE] Verify USB insertion/removal and motor braking transients.
USB motor interlock and battery measurement
