ncripted/DAMIEN/outputs/rover/Omni_UGV_Rev_E1_layout_candidate/omni_ugv.kicad_pcb

## KiCad design outputs/rover/Omni_UGV_Rev_E1_layout_candidate/omni_ugv.kicad_pcb (continued)

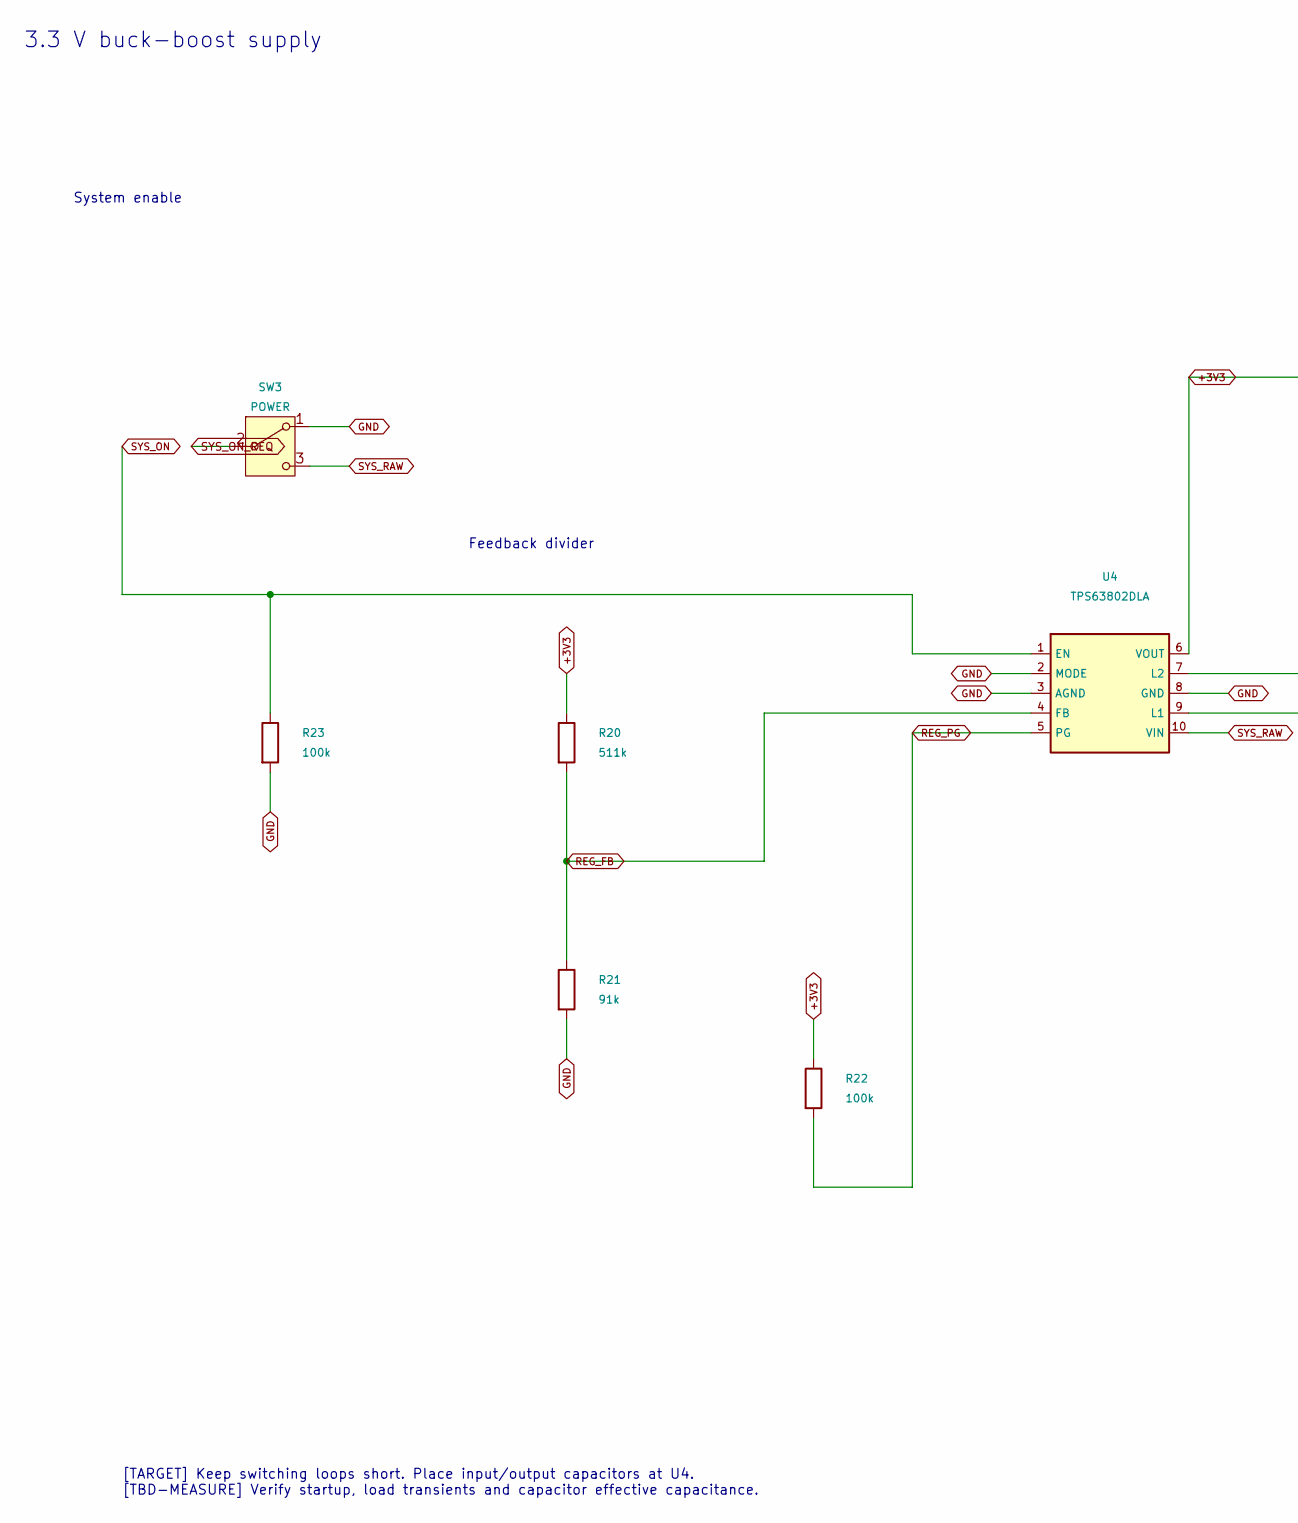
[picture p178: schematic regulator.kicad_sch, 3.3 V buck-boost supply, part in row 1, column 1]

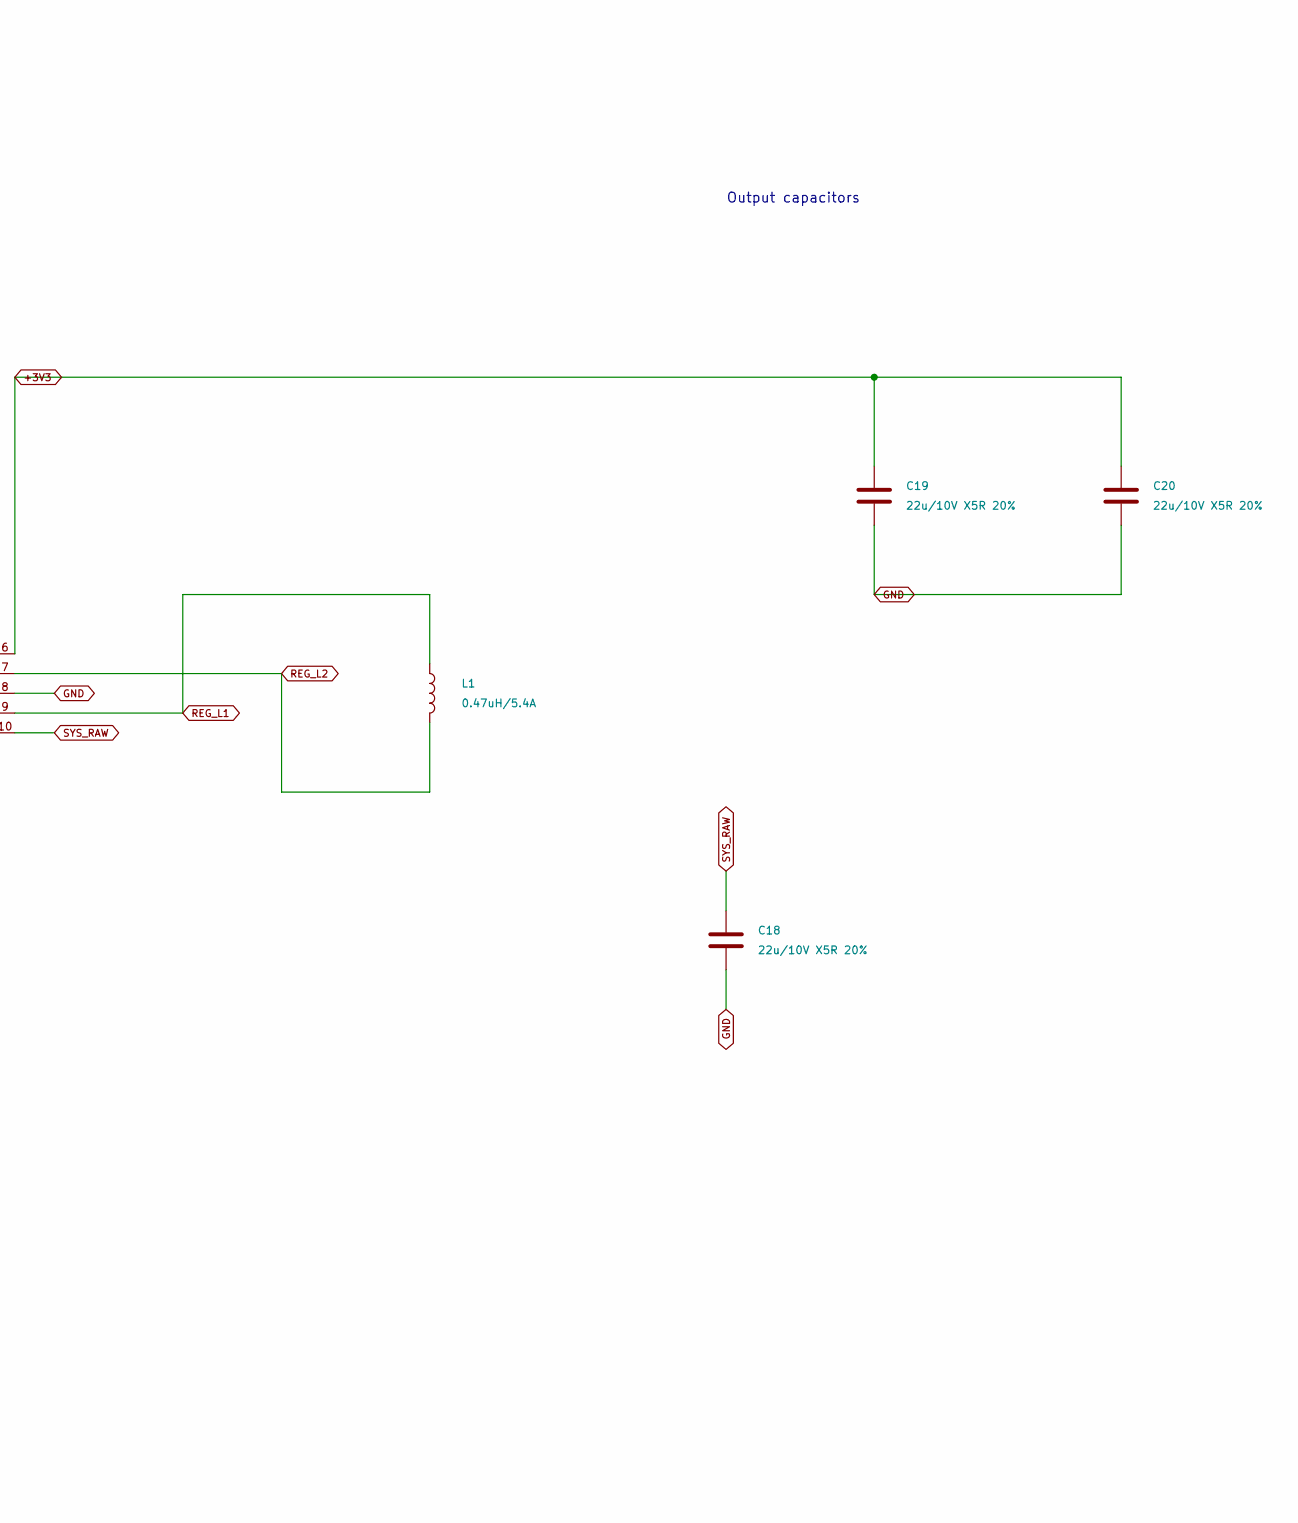
[picture p179: schematic regulator.kicad_sch, 3.3 V buck-boost supply, part in row 1, column 2]

Parts:
C18, C19, C20: 22u/10V X5R 20%; Capacitor_SMD__C_0805_2012Metric
L1: 0.47uH/5.4A; L_XFL4015
R20: 511k; Resistor_SMD__R_0603_1608Metric
R21: 91k; Resistor_SMD__R_0603_1608Metric
R22, R23: 100k; Resistor_SMD__R_0603_1608Metric
SW3: POWER; Button_Switch_SMD__SW_SPDT_CK_JS102011SAQN
U4: TPS63802DLA; TPS63802_DLA0010A

Connections:
+3V3: C19.1, C20.1, R20.1, R22.1, U4.6 (VOUT); also elsewhere on the board
GND: C18.2, C19.2, C20.2, R21.2, R23.2, SW3.1 (A), U4.2 (MODE), U4.3 (AGND), U4.8 (GND); also elsewhere on the board
REG_FB: R20.2, R21.1, U4.4 (FB)
REG_L1: L1.1, U4.9 (L1)
REG_L2: L1.2, U4.7 (L2)
REG_PG: R22.2, U4.5 (PG); also elsewhere on the board
SYS_ON: R23.1, U4.1 (EN); also elsewhere on the board
SYS_ON_REQ: SW3.2 (B); also elsewhere on the board
SYS_RAW: C18.1, SW3.3 (C), U4.10 (VIN); also elsewhere on the board

Notes on the sheet:
3.3 V buck-boost supply
[TARGET] Keep switching loops short. Place input/output capacitors at U4. [TBD-MEASURE] Verify startup, load transients and capacitor effective capacitance.
Feedback divider
System enable
Output capacitors

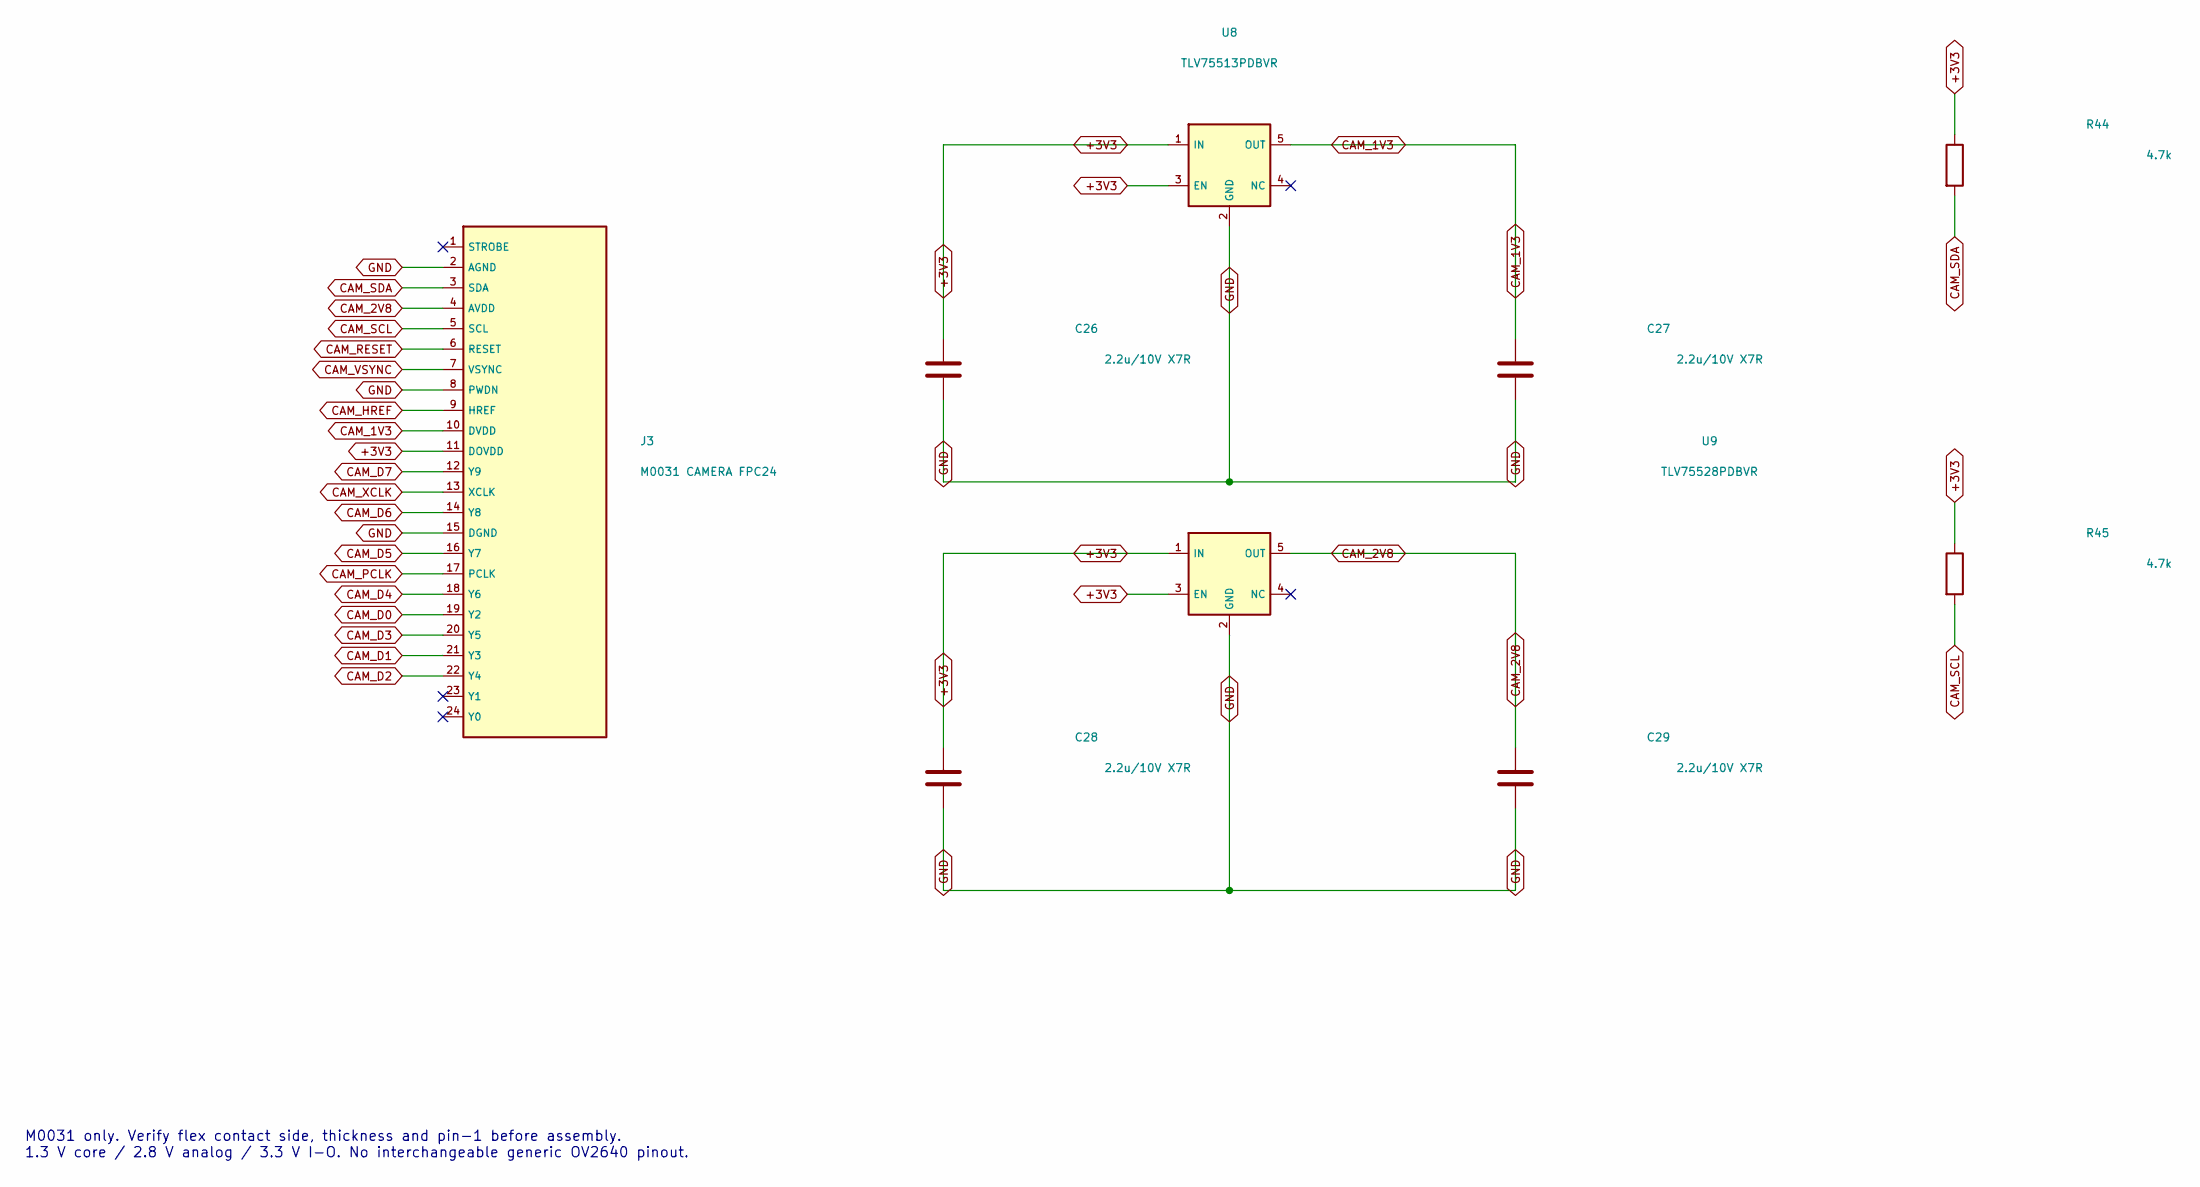
[picture p180: schematic camera.kicad_sch, OV2640 M0031 flex interface]

Parts:
C26, C27, C28, C29: 2.2u/10V X7R; Capacitor_SMD__C_0603_1608Metric
J3: M0031 CAMERA FPC24; Camera_FH12_24
R44, R45: 4.7k; Resistor_SMD__R_0603_1608Metric
U8: TLV75513PDBVR; Camera_SOT23_5
U9: TLV75528PDBVR; Camera_SOT23_5

Connections:
+3V3: C26.1, C28.1, J3.11 (DOVDD), R44.1, R45.1, U8.1 (IN), U8.3 (EN), U9.1 (IN), U9.3 (EN); also elsewhere on the board
CAM_1V3: C27.1, J3.10 (DVDD), U8.5 (OUT)
CAM_2V8: C29.1, J3.4 (AVDD), U9.5 (OUT)
CAM_D0: J3.19 (Y2); also elsewhere on the board
CAM_D1: J3.21 (Y3); also elsewhere on the board
CAM_D2: J3.22 (Y4); also elsewhere on the board
CAM_D3: J3.20 (Y5); also elsewhere on the board
CAM_D4: J3.18 (Y6); also elsewhere on the board
CAM_D5: J3.16 (Y7); also elsewhere on the board
CAM_D6: J3.14 (Y8); also elsewhere on the board
CAM_D7: J3.12 (Y9); also elsewhere on the board
CAM_HREF: J3.9 (HREF); also elsewhere on the board
CAM_PCLK: J3.17 (PCLK); also elsewhere on the board
CAM_RESET: J3.6 (RESET); also elsewhere on the board
CAM_SCL: J3.5 (SCL), R45.2; also elsewhere on the board
CAM_SDA: J3.3 (SDA), R44.2; also elsewhere on the board
CAM_VSYNC: J3.7 (VSYNC); also elsewhere on the board
CAM_XCLK: J3.13 (XCLK); also elsewhere on the board
GND: C26.2, C27.2, C28.2, C29.2, J3.2 (AGND), J3.8 (PWDN), J3.15 (DGND), U8.2 (GND), U9.2 (GND); also elsewhere on the board

Notes on the sheet:
M0031 only. Verify flex contact side, thickness and pin-1 before assembly. 1.3 V core / 2.8 V analog / 3.3 V I-O. No interchangeable generic OV2640 pinout.

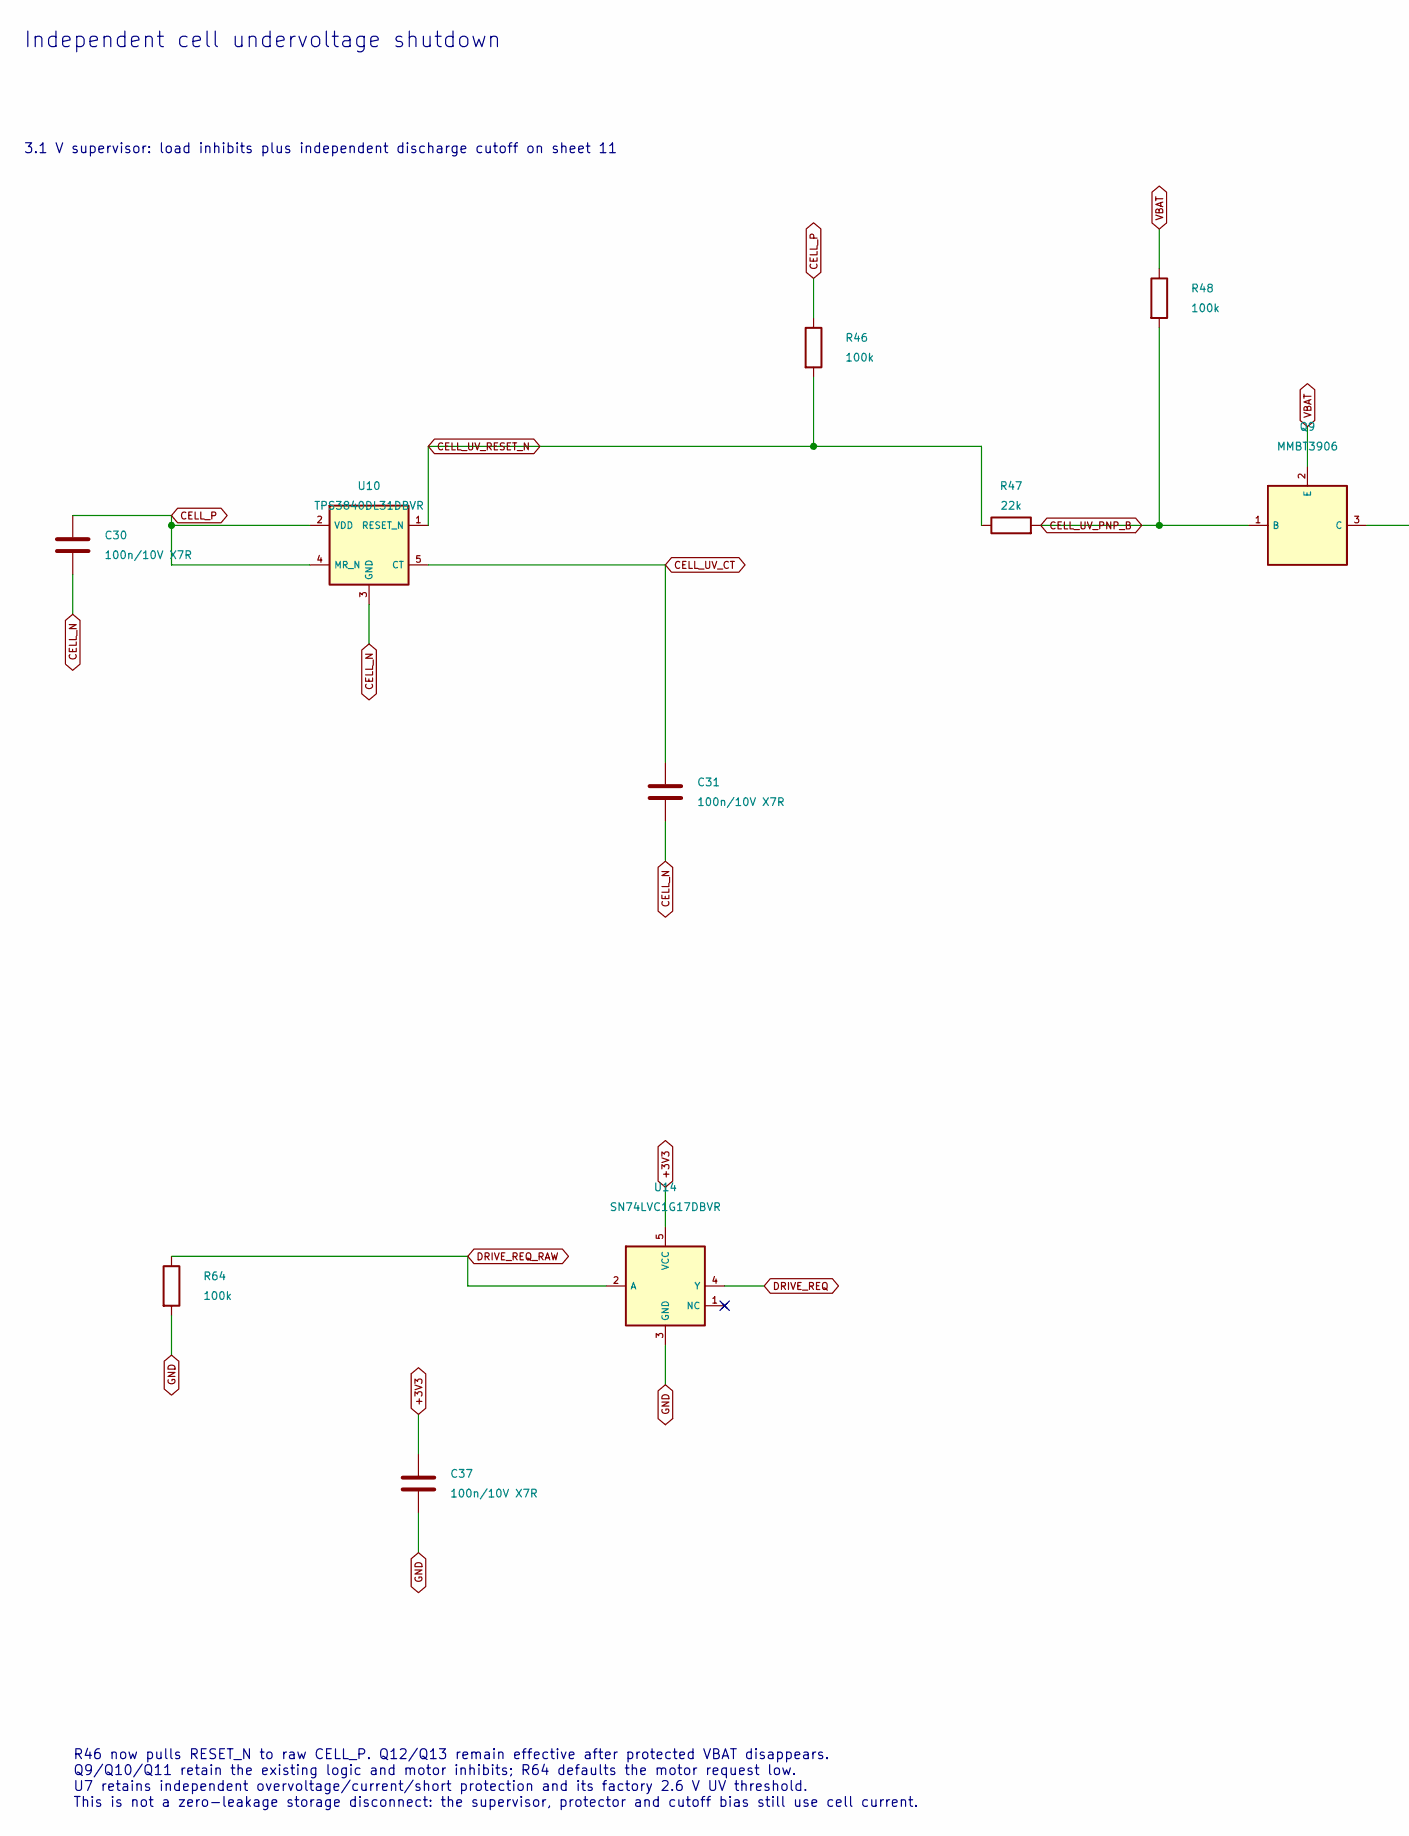
[picture p181: schematic cell_undervoltage.kicad_sch, Independent cell undervoltage shutdown, part in row 1, column 1]

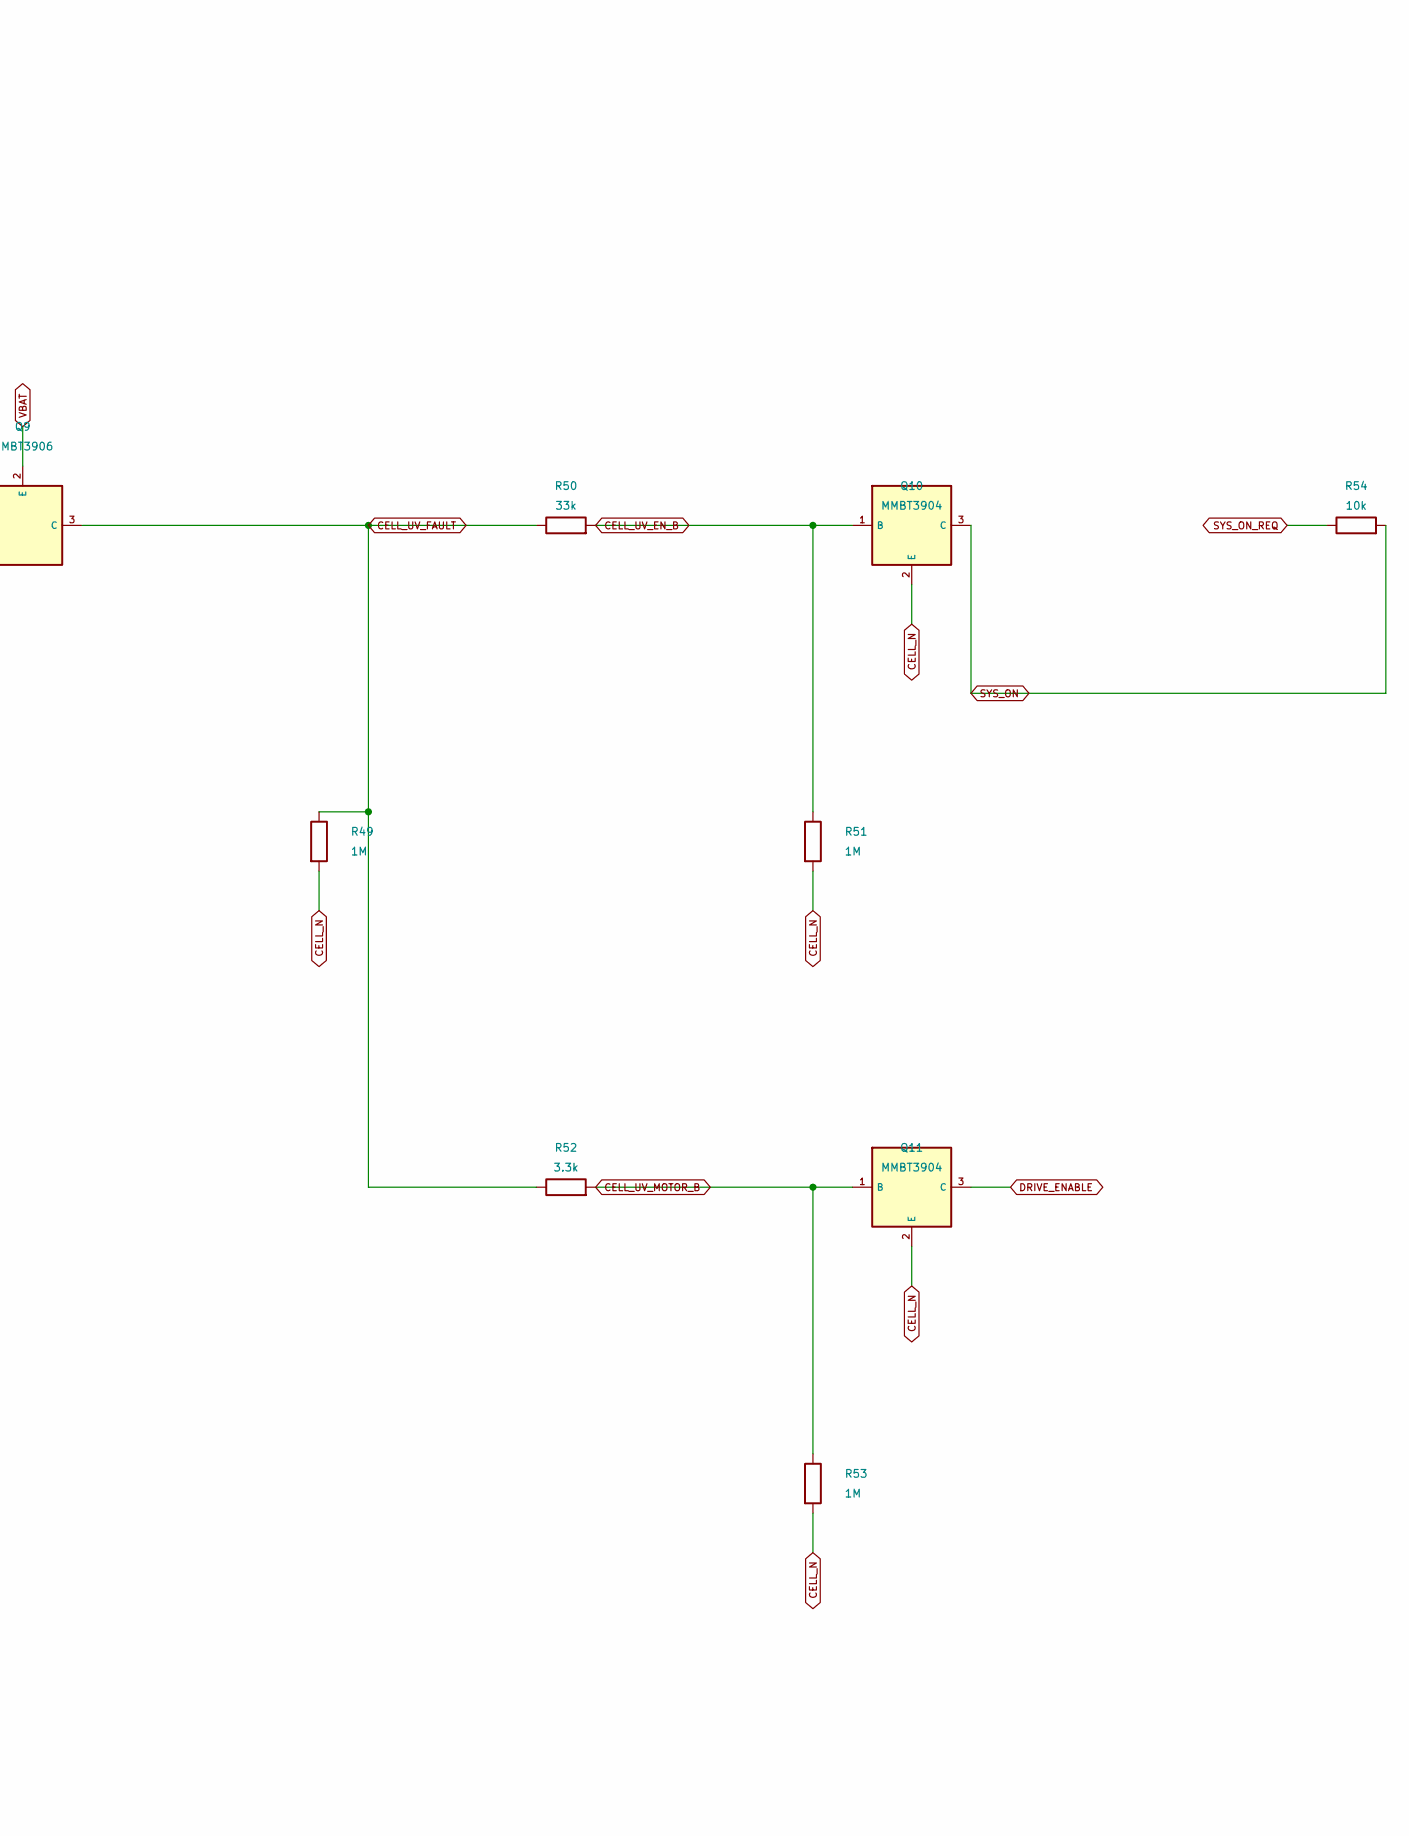
[picture p182: schematic cell_undervoltage.kicad_sch, Independent cell undervoltage shutdown, part in row 1, column 2]

Parts:
C30, C31, C37: 100n/10V X7R; Capacitor_SMD__C_0603_1608Metric
Q9: MMBT3906; Package_TO_SOT_SMD__SOT-23
Q10, Q11: MMBT3904; Package_TO_SOT_SMD__SOT-23
R46, R48, R64: 100k; Resistor_SMD__R_0603_1608Metric
R47: 22k; Resistor_SMD__R_0603_1608Metric
R49, R51, R53: 1M; Resistor_SMD__R_0603_1608Metric
R50: 33k; Resistor_SMD__R_0603_1608Metric
R52: 3.3k; Resistor_SMD__R_0603_1608Metric
R54: 10k; Resistor_SMD__R_0603_1608Metric
U10: TPS3840DL31DBVR; Camera_SOT23_5
U14: SN74LVC1G17DBVR; Camera_SOT23_5

Connections:
+3V3: C37.1, U14.5 (VCC); also elsewhere on the board
CELL_N: C30.2, C31.2, Q10.2 (E), Q11.2 (E), R49.2, R51.2, R53.2, U10.3 (GND); also elsewhere on the board
CELL_P: C30.1, R46.1, U10.2 (VDD), U10.4 (MR_N); also elsewhere on the board
CELL_UV_CT: C31.1, U10.5 (CT)
CELL_UV_EN_B: Q10.1 (B), R50.2, R51.1
CELL_UV_FAULT: Q9.3 (C), R49.1, R50.1, R52.1
CELL_UV_MOTOR_B: Q11.1 (B), R52.2, R53.1
CELL_UV_PNP_B: Q9.1 (B), R47.2, R48.2
CELL_UV_RESET_N: R46.2, R47.1, U10.1 (RESET_N); also elsewhere on the board
DRIVE_ENABLE: Q11.3 (C); also elsewhere on the board
DRIVE_REQ: U14.4 (Y); also elsewhere on the board
DRIVE_REQ_RAW: R64.1, U14.2 (A); also elsewhere on the board
GND: C37.2, R64.2, U14.3 (GND); also elsewhere on the board
SYS_ON: Q10.3 (C), R54.2; also elsewhere on the board
SYS_ON_REQ: R54.1; also elsewhere on the board
VBAT: Q9.2 (E), R48.1; also elsewhere on the board

Notes on the sheet:
3.1 V supervisor: load inhibits plus independent discharge cutoff on sheet 11
R46 now pulls RESET_N to raw CELL_P. Q12/Q13 remain effective after protected VBAT disappears. Q9/Q10/Q11 retain the existing logic and motor inhibits; R64 defaults the motor request low. U7 retains independent overvoltage/current/short protection and its factory 2.6 V UV threshold. This is not a z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
Independent cell undervoltage shutdown

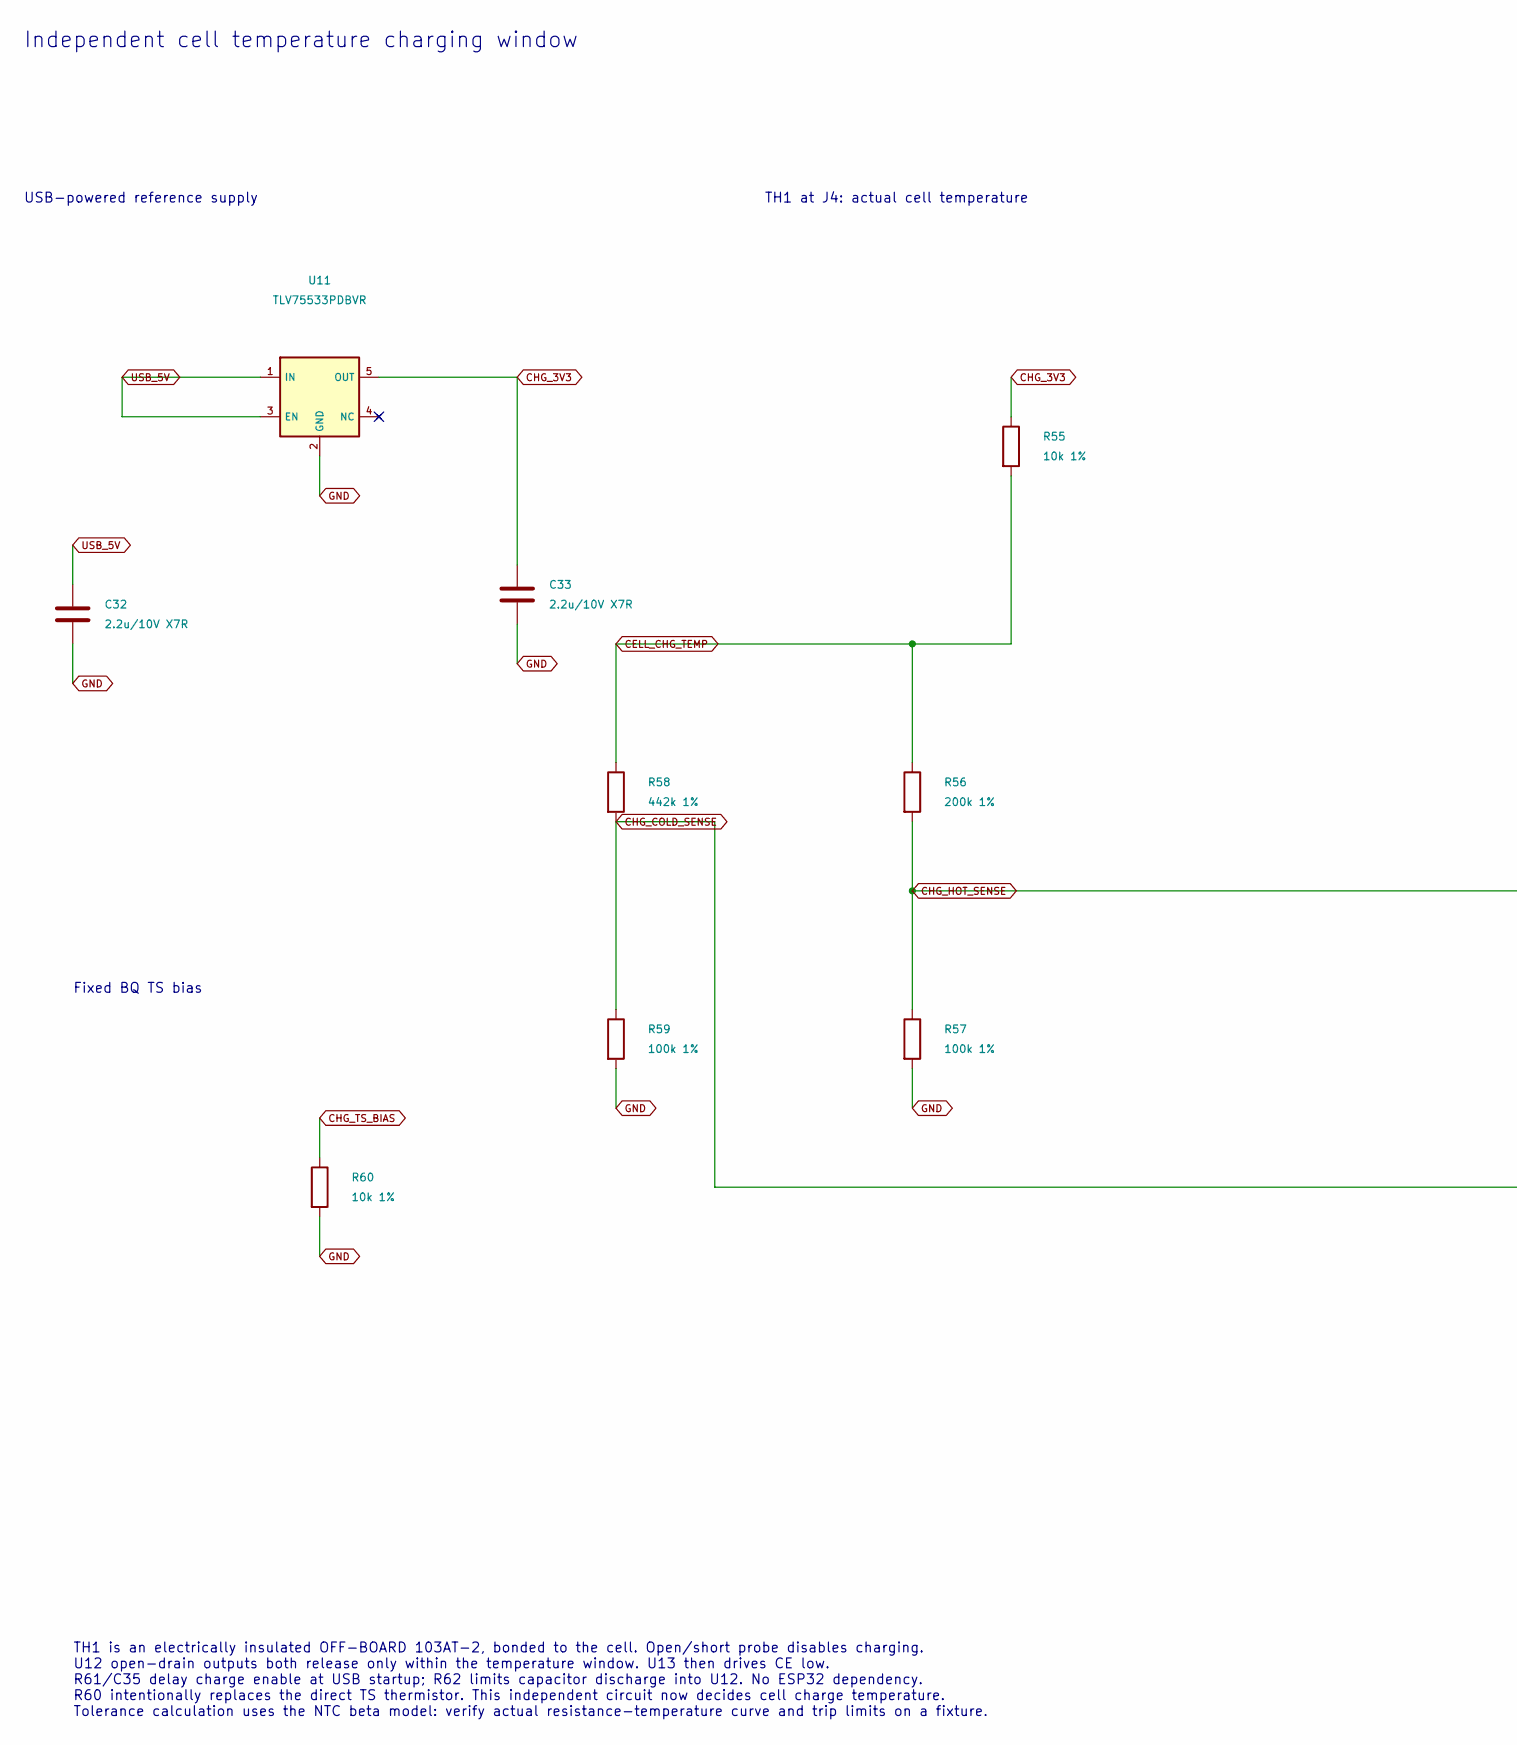
[picture p183: schematic charge_temperature.kicad_sch, Independent cell temperature charging window, part in row 1, column 1]

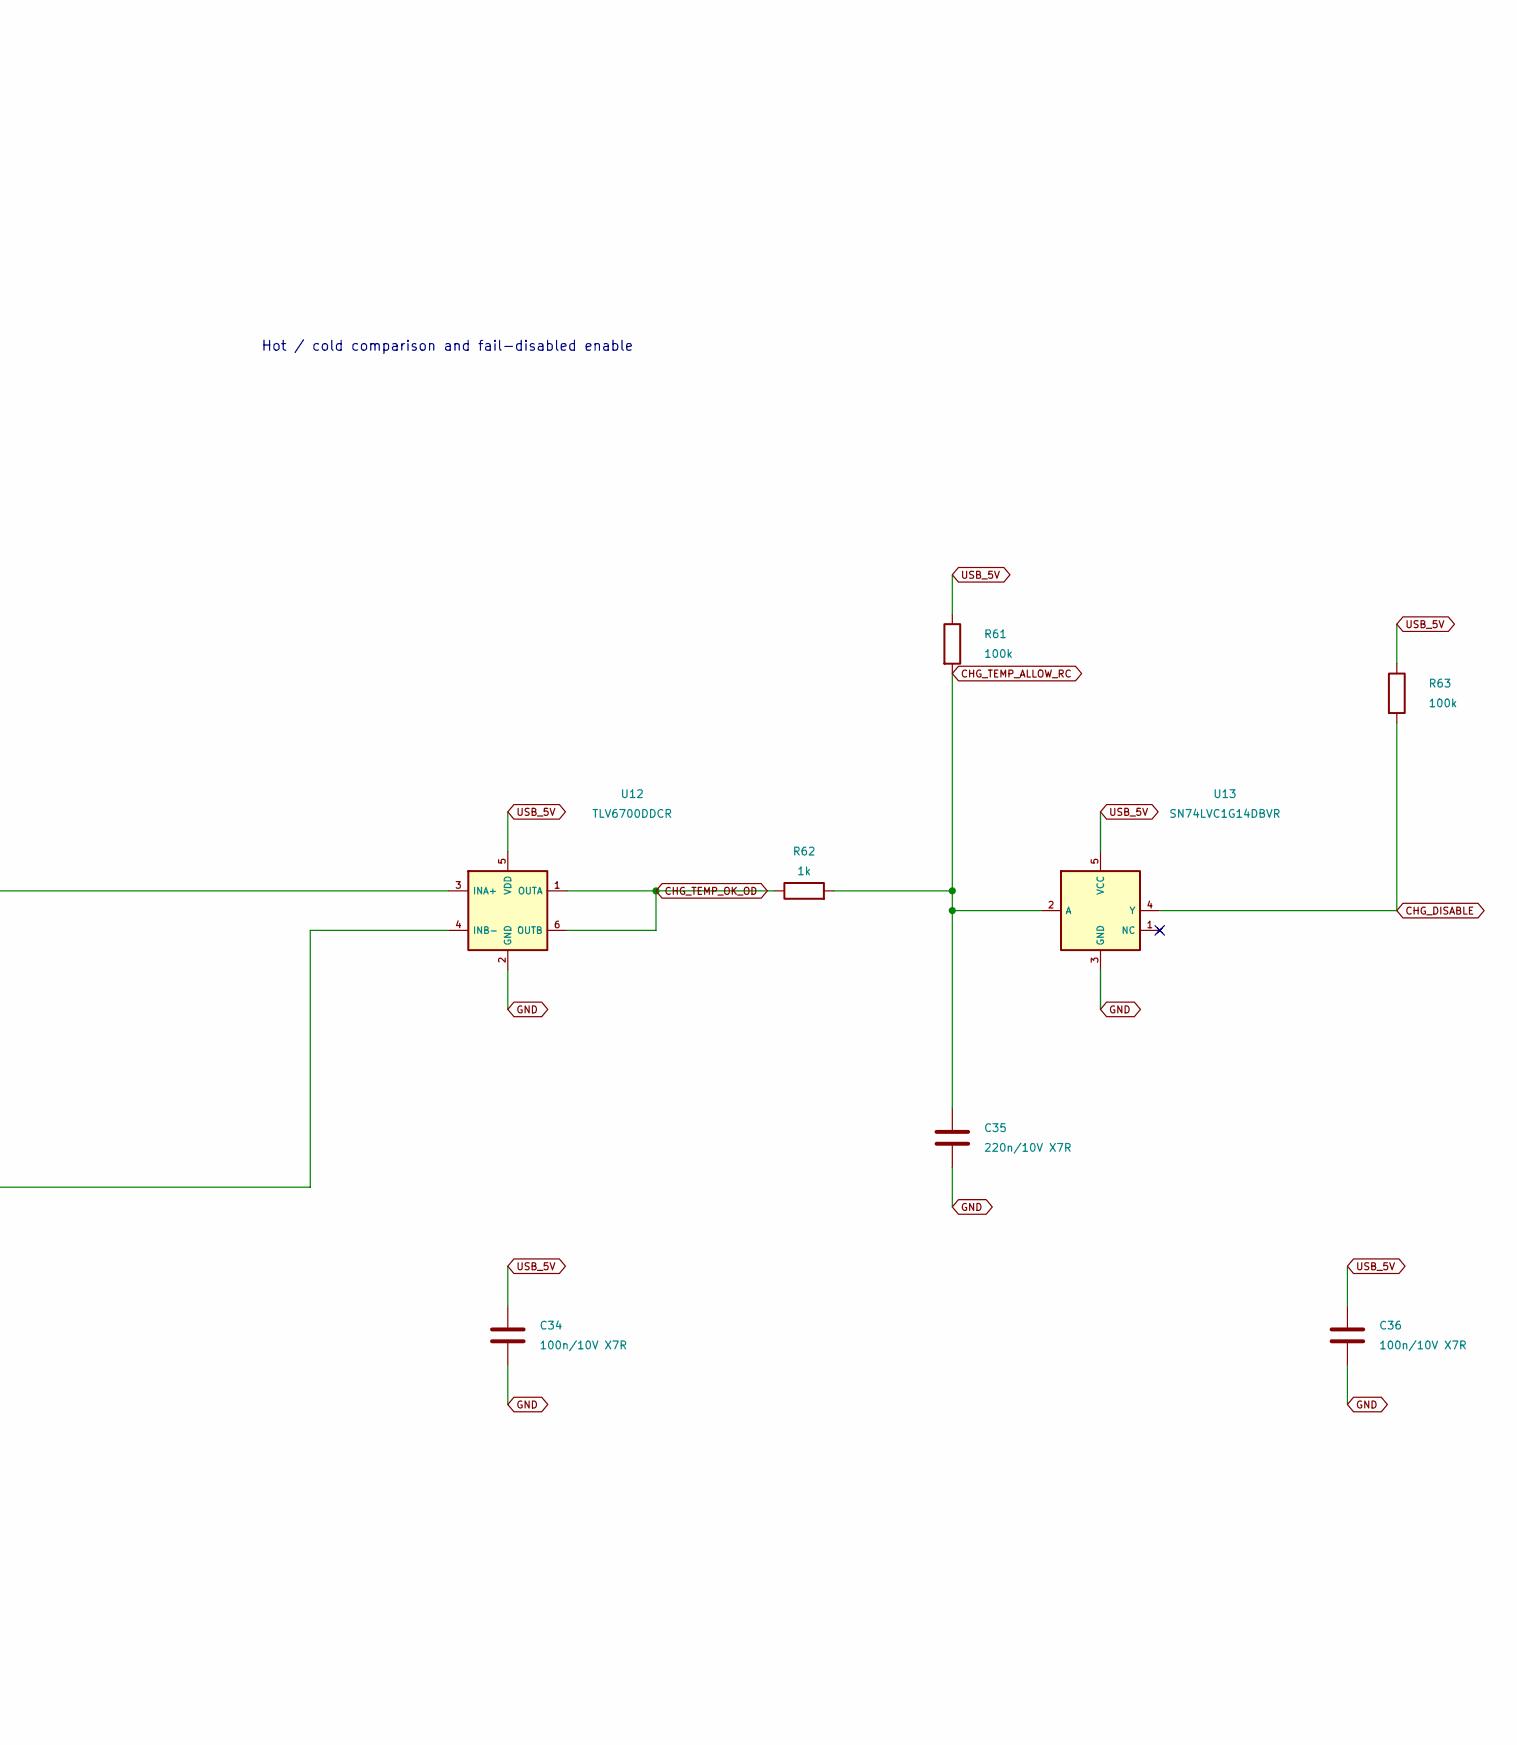
[picture p184: schematic charge_temperature.kicad_sch, Independent cell temperature charging window, part in row 1, column 2]

Parts:
C32, C33: 2.2u/10V X7R; Capacitor_SMD__C_0603_1608Metric
C34, C36: 100n/10V X7R; Capacitor_SMD__C_0603_1608Metric
C35: 220n/10V X7R; Capacitor_SMD__C_0603_1608Metric
R55, R60: 10k 1%; Resistor_SMD__R_0603_1608Metric
R56: 200k 1%; Resistor_SMD__R_0603_1608Metric
R57, R59: 100k 1%; Resistor_SMD__R_0603_1608Metric
R58: 442k 1%; Resistor_SMD__R_0603_1608Metric
R61, R63: 100k; Resistor_SMD__R_0603_1608Metric
R62: 1k; Resistor_SMD__R_0603_1608Metric
U11: TLV75533PDBVR; Camera_SOT23_5
U12: TLV6700DDCR; Power_SOT23_6
U13: SN74LVC1G14DBVR; Camera_SOT23_5

Connections:
CELL_CHG_TEMP: R55.2, R56.1, R58.1; also elsewhere on the board
CHG_3V3: C33.1, R55.1, U11.5 (OUT)
CHG_COLD_SENSE: R58.2, R59.1, U12.4 (INB-)
CHG_DISABLE: R63.2, U13.4 (Y); also elsewhere on the board
CHG_HOT_SENSE: R56.2, R57.1, U12.3 (INA+)
CHG_TEMP_ALLOW_RC: C35.1, R61.2, R62.2, U13.2 (A)
CHG_TEMP_OK_OD: R62.1, U12.1 (OUTA), U12.6 (OUTB)
CHG_TS_BIAS: R60.1; also elsewhere on the board
GND: C32.2, C33.2, C34.2, C35.2, C36.2, R57.2, R59.2, R60.2, U11.2 (GND), U12.2 (GND), U13.3 (GND); also elsewhere on the board
USB_5V: C32.1, C34.1, C36.1, R61.1, R63.1, U11.1 (IN), U11.3 (EN), U12.5 (VDD), U13.5 (VCC); also elsewhere on the board

Notes on the sheet:
USB-powered reference supply
TH1 at J4: actual cell temperature
Hot / cold comparison and fail-disabled enable
Fixed BQ TS bias
TH1 is an electrically insulated OFF-BOARD 103AT-2, bonded to the cell. Open/short probe disables charging. U12 open-drain outputs both release only within the temperature window. U13 then drives CE low. R61/C35 delay charge enable at USB startup; R62 limits capacitor discharge into U12. No ESP32 d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
Independent cell temperature charging window
