ncripted/DAMIEN/outputs/rover/Omni_UGV_Rev_E1_layout_candidate/omni_ugv.kicad_pcb

## KiCad design outputs/rover/Omni_UGV_Rev_E1_layout_candidate/omni_ugv.kicad_pcb (continued)

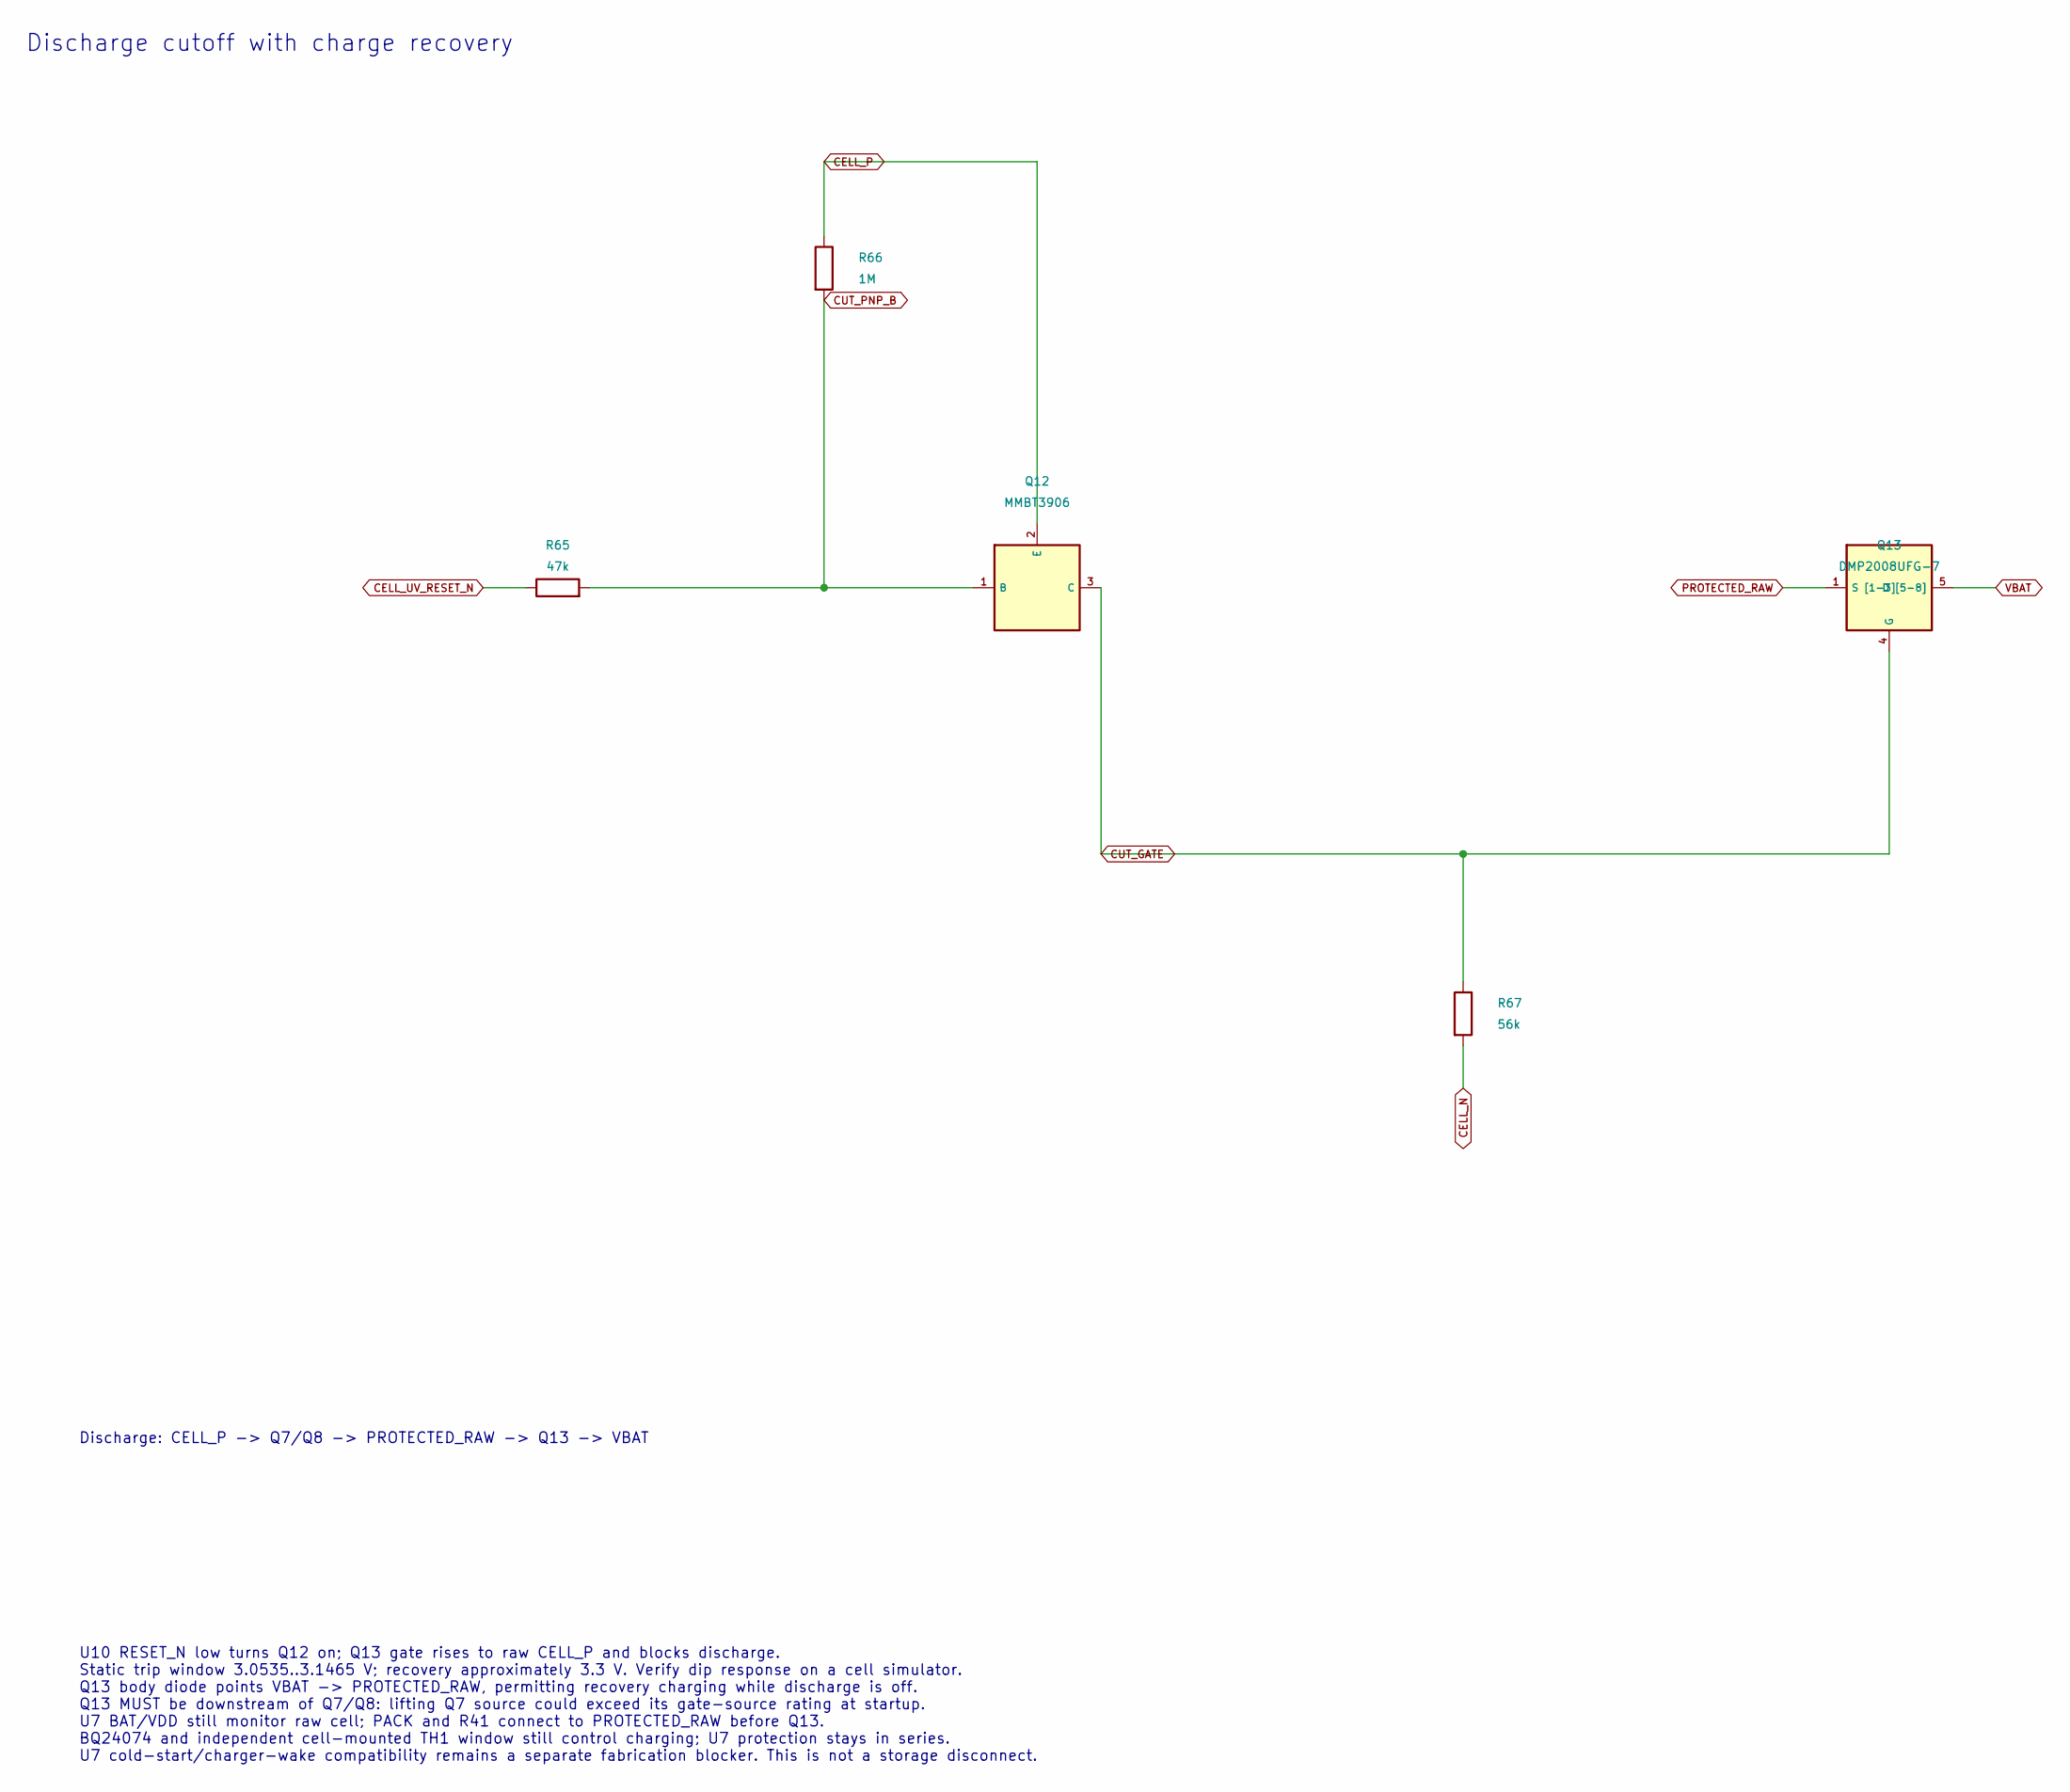
[picture p185: schematic discharge_cutoff.kicad_sch, Discharge cutoff with charge recovery]

Parts:
Q12: MMBT3906; Package_TO_SOT_SMD__SOT-23
Q13: DMP2008UFG-7; Discharge_PowerDI3333_8
R65: 47k; Resistor_SMD__R_0603_1608Metric
R66: 1M; Resistor_SMD__R_0603_1608Metric
R67: 56k; Resistor_SMD__R_0603_1608Metric

Connections:
CELL_N: R67.2; also elsewhere on the board
CELL_P: Q12.2 (E), R66.1; also elsewhere on the board
CELL_UV_RESET_N: R65.1; also elsewhere on the board
CUT_GATE: Q12.3 (C), Q13.4 (G), R67.1
CUT_PNP_B: Q12.1 (B), R65.2, R66.2
PROTECTED_RAW: Q13.1 (S [1-3]), Q13.2 (S), Q13.3 (S); also elsewhere on the board
VBAT: Q13.5 (D [5-8]); also elsewhere on the board

Notes on the sheet:
Discharge: CELL_P -> Q7/Q8 -> PROTECTED_RAW -> Q13 -> VBAT
U10 RESET_N low turns Q12 on; Q13 gate rises to raw CELL_P and blocks discharge. Static trip window 3.0535..3.1465 V; recovery approximately 3.3 V. Verify dip response on a cell simulator. Q13 body diode points VBAT -> PROTECTED_RAW, permitting recovery charging while discharge is off. Q13 MUST be 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
Discharge cutoff with charge recovery

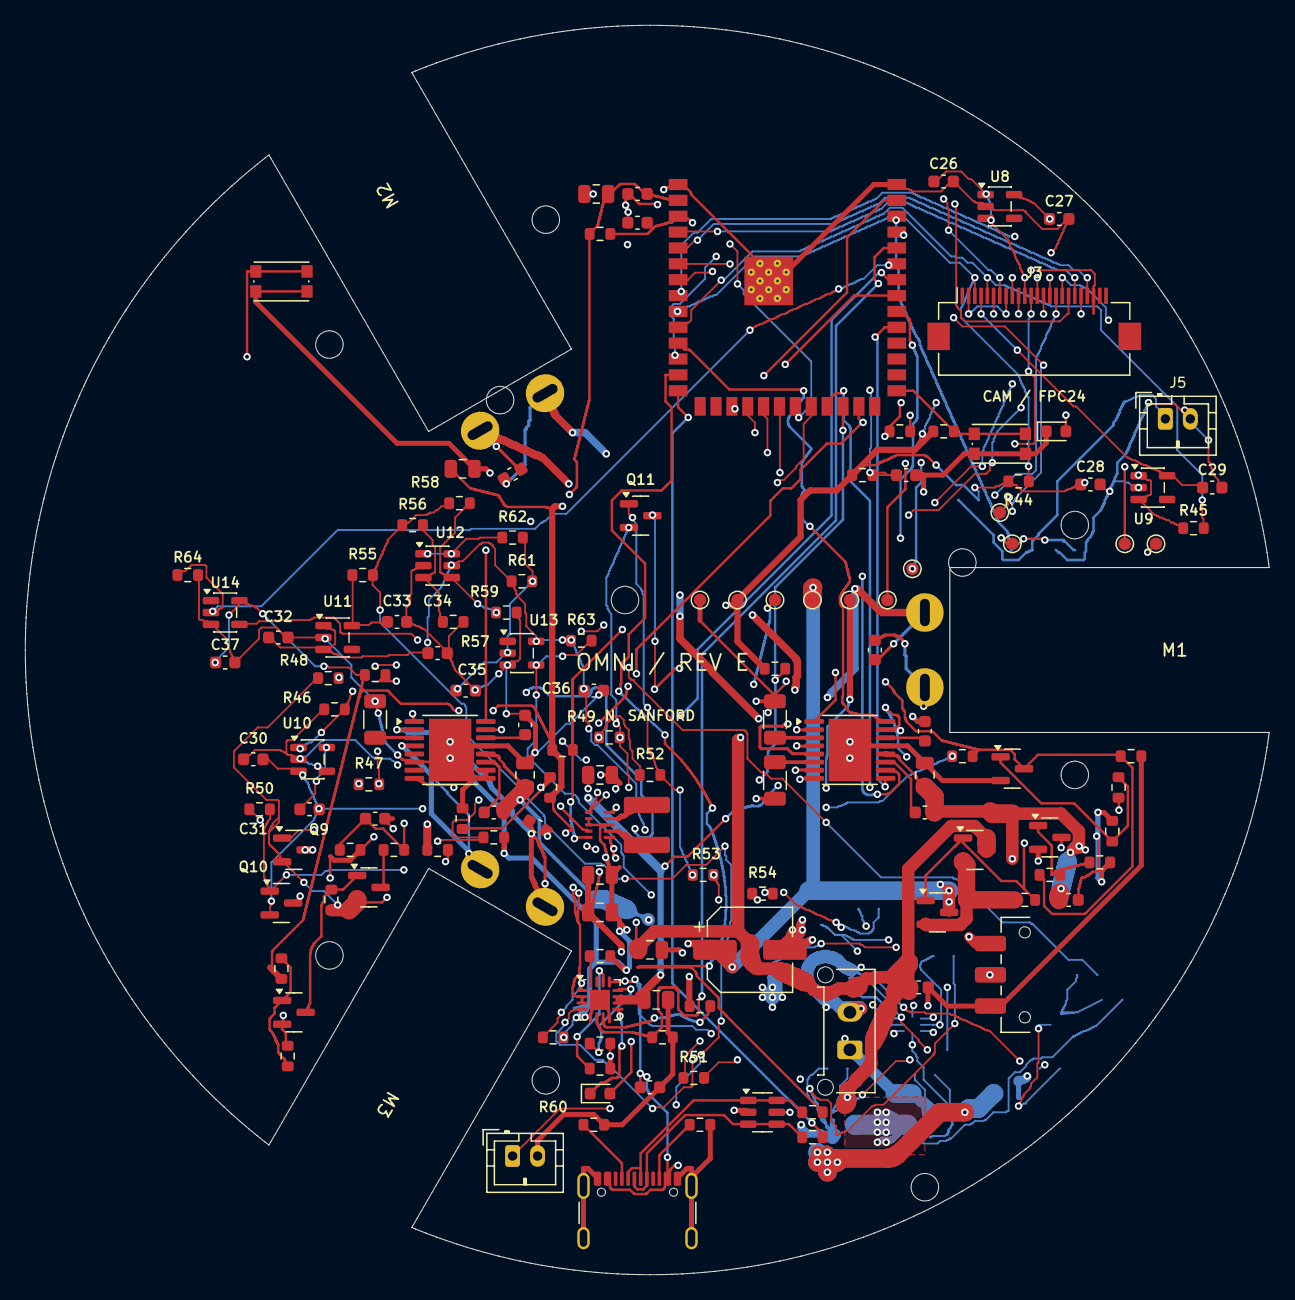
[picture p186: board omni_ugv.kicad_pcb from above]

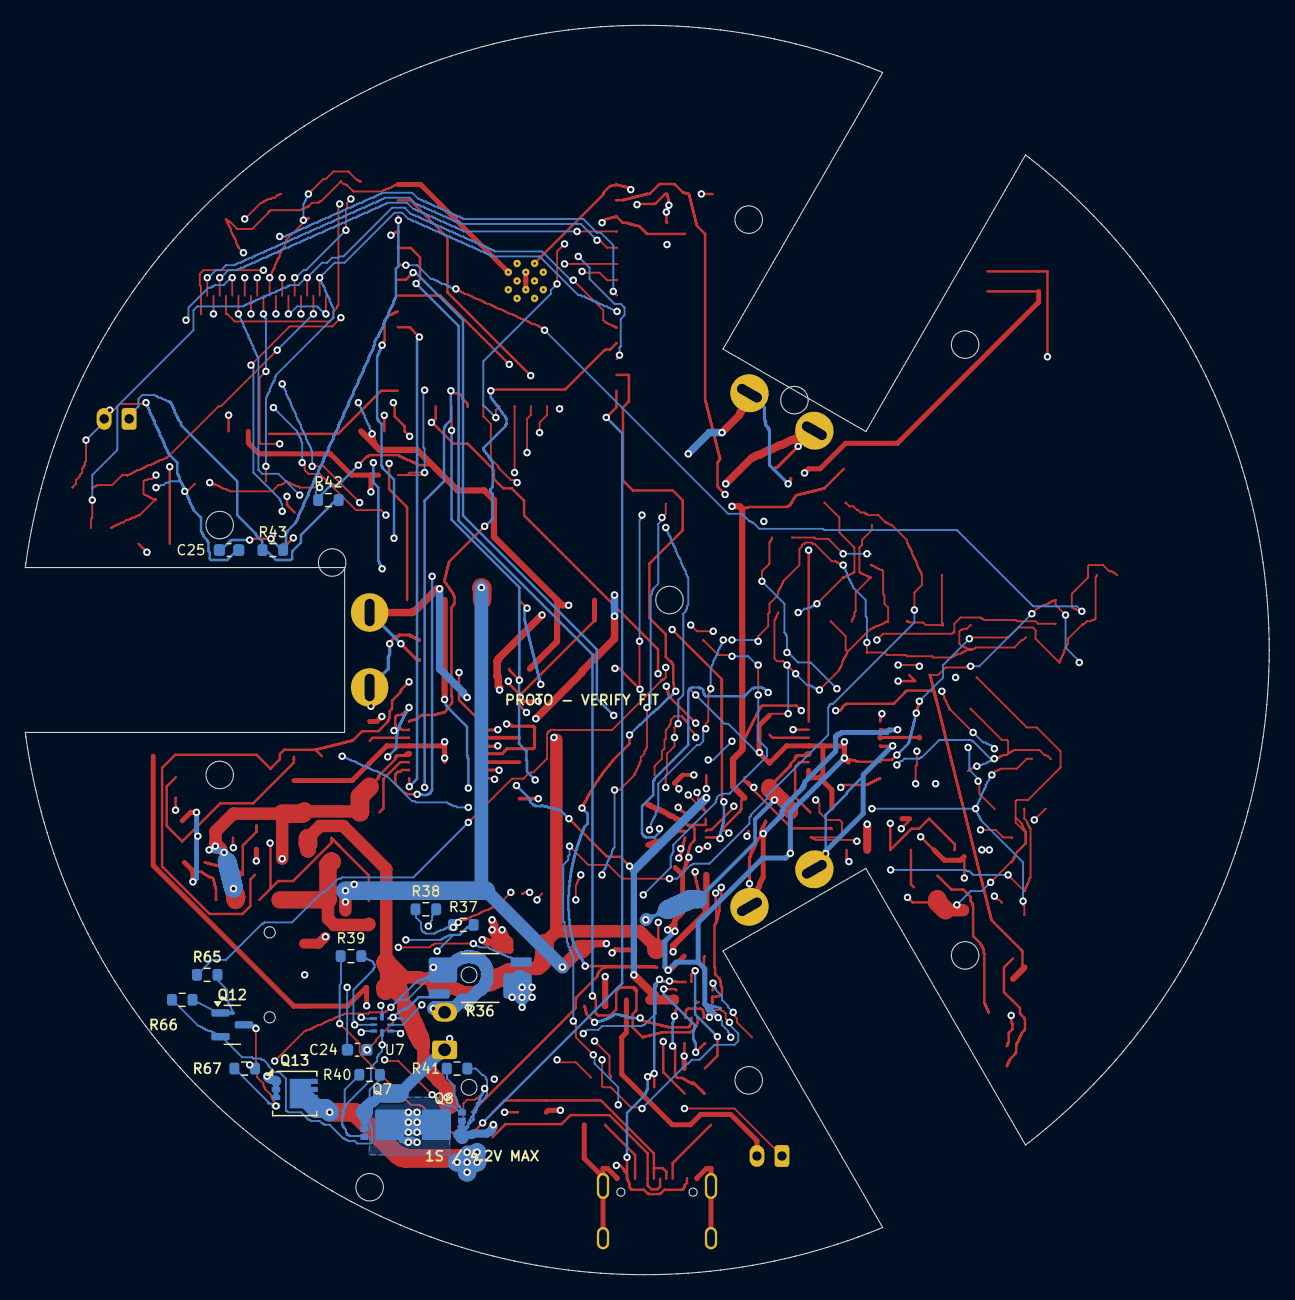
[picture p187: board omni_ugv.kicad_pcb from below]

Board: 4 copper layers, 99.6 x 100.0 mm, 167 parts (18 on the bottom side), 107 nets.

Other parts of the board:
H1, H2, H3, H4, H5, H6, H7, H8, H9, H10: M2; MountingHole_2.2mm_M2
