ncripted/DAMIEN/(commit log)

2026-11-09 Archive Omni UGV KiCad design and engineering work
    [BOM.csv, COMPONENT_FUNCTIONS.csv, PCB_chassis_fit.step, PIN_MAP.csv, PROTECTION_GATE_RESULTS.csv, Rev_A_original_board_fit.step, Rev_C_board_only.step, Rev_D_board_only.step]
2026-11-09 Document the DAMIEN rover project and prototype status
